cbshbalance/slackline-balacing1/work/학생보고서_공동집필_20260810/report_assets/fig20_robot_measurements.png

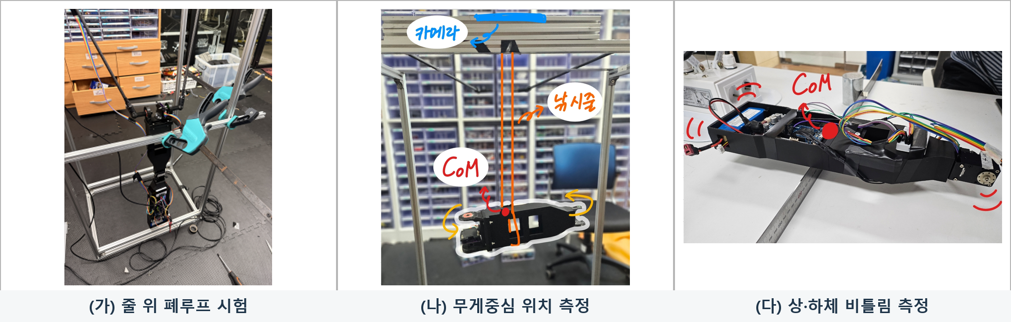
work/학생보고서_공동집필_20260810/report_assets/fig20_robot_measurements.png
