cbshbalance/slackline-balacing1/cad/발주목록_프레임v6_1.md

# 줄타기 로봇 프레임 v6 — 발주 목록

작성 2026-08-12 · 출처 `cad/frame_master_v6.scad` (OpenSCAD 2021.01, 경고 0)
모든 길이는 **5mm 단위 올림**, 소수점 없음. 올림은 항상 여유가 늘어나는 방향입니다.

---

## 1. 알루미늄 프로파일 — 전부 3060 한 종류

### 1-1. 기둥 (Z) — 로봇 크기별 교체용

| 부재 | 길이 | 수량 | A 빌드 (로봇 631) | B 빌드 (로봇 800) |
|---|---|---|---|---|
| **745** | 745 | 4 | 1단 다리 | 3단 갠트리 기둥 |
| **565** | 565 | 4 | 3단 갠트리 기둥 | — |
| **820** | 820 | 4 | — | 1단 다리 |
| **495** | 495 | 4 | 2단 중간 기둥 | 2단 중간 기둥 |

**745 한 종류가 두 역할을 겸합니다** — A 빌드에서는 다리, B 빌드에서는 갠트리 기둥.
동시에 두 빌드를 세우지 않으므로 4본이면 충분합니다.

기둥 소계 **16본**, 길이 합계 **10,500 mm**

### 1-2. 가로 부재 — 두 빌드 공용

| 부재 | 길이 | 수량 | 위치 |
|---|---|---|---|
| X보 (전폭 600) | 600 | 6 | 바닥 2 · 데크 2 · 피벗보 2 |
| X레일 (기둥 사이) | 540 | **2** | 갠트리 2 — 바닥은 전폭 X보로 대체됨 |
| Y레일 | 550 | **4** | 바닥(전시=데크) 2 · 갠트리 2 |

가로 부재 소계 **12본**, 길이 합계 **6,880 mm**

> 바닥은 짧은 X레일이 아니라 **전폭 600 X보 한 쌍**입니다 (다리가 그 위에 얹힘).
> Y레일은 바닥과 갠트리 **두 단** 모두에 들어갑니다.

### 1-3. 프로파일 합계

| 항목 | 값 |
|---|---|
| 규격 | **3060** (30×60, 30계열 T슬롯) 단일 |
| 절단 본수 | **28본** |
| 길이 합계 | **17,380 mm ≈ 17.4 m** |

> 4m 정척 기준 5본이면 절단 손실 포함해 충분합니다. 절단 의뢰 시 **±0.5mm 공차**로 지정하세요.
> **Y레일은 60mm 면을 Z(세로)로 세워 씁니다.** 발주는 같지만 조립 시 방향에 주의.

---

## 2. 다이캐스팅 브래킷

| 품목 | 규격 | 수량 |
|---|---|---|
| 다이캐스팅 앵글 브래킷 | **30계열** (약 30×30×30, 두께 7mm 내외, M6) | **64** |

3060용 대형 브래킷 대신 **30계열 두 개를 60mm 면에 나란히** 붙입니다.
빔 윗면 T슬롯 15 / 45 라인에 정확히 얹힙니다. 조달도 30계열이 훨씬 쉽습니다.

**배치 내역** (실험실 빌드, 갠트리 포함)

| 조인트 | 개수 |
|---|---|
| 다리 ↔ 바닥 X보 | 8 |
| 다리 ↔ 데크 (아래) | 8 |
| 중간 기둥 ↔ 데크 (위) | 8 |
| 중간 기둥 ↔ 피벗보 (아래) | 8 |
| 갠트리 기둥 ↔ 피벗보 (위) | 8 |
| 갠트리 기둥 ↔ 갠트리 X레일 | 8 |
| Y레일 끝 (상 4 + 하 4) × 2단 | 16 |
| **합계** | **64** |

> 전시 빌드는 1단이 빠져 **48개**만 사용합니다 (나머지 16개는 보관).

---

## 3. 볼트 · 너트

| 품목 | 규격 | 소요 | 여유 포함 발주 |
|---|---|---|---|
| 육각/렌치 볼트 | **M6 × 12** | 128 | **150** |
| T너트 (또는 스프링너트/사각너트) | **M6, 30계열 슬롯용** | 128 | **150** |
| 평와셔 | M6 | 128 | 150 |
| 볼트 (피벗 마운트 → 상단 X보) | **M5 × 12** | 4 | **10** |
| T너트 | **M5, 30계열 슬롯용** | 4 | **10** |

- 브래킷 1개당 볼트 2개 (다리마다 1개) → 64 × 2 = **128**
- 피벗 마운트는 전방 베어링 마운트 2개 + 후방 엔코더 브래킷 2개 = **M5 4개**
  (프레임 코드의 홀 지름 5.5mm, 볼트선은 레일 모서리에서 **45mm 안쪽 T슬롯**)

> **T너트 종류**: 조립 후 나중에 끼워야 하는 자리가 많으므로 **스프링너트(끼움식)** 를 권합니다.
> 사각너트는 프로파일 끝단으로만 삽입되어 재조립이 번거롭습니다.

---

## 4. 선택 품목

| 품목 | 규격 | 수량 | 비고 |
|---|---|---|---|
| 마감 캡 | 3060용 | 24 | 노출 단면 마감 |
| 레벨링 풋 / 고무발 | M8 | 4 | 바닥 X보 하단, 수평 조정 |
| 앵커볼트 (프로파일 끝단) | M8 | 8 | Y레일 끝 보강, 브래킷과 병행 시 |

---

## 5. 검증값 (참고)

| 항목 | A (로봇 631) | B (로봇 800) |
|---|---|---|
| 피벗축 높이 | 1355 | 1430 |
| 기둥 최상단 (갠트리 포함) | 1895 | 2150 |
| 쓰러졌을 때 바닥 여유 | 220.2 | 126.2 |
| Y레일 스윙 여유 | 158.5 | 62.9 |
| 전시 빌드, 서 있을 때 바닥 여유 | 54.2 | 54.2 |
| 베어링 센터 간격 (카본 파이프) | 580 | 580 |
| sag (R) | 503.825 | 503.825 |

> ⚠ **A 세트 다리(745)에 800mm 로봇을 올리면 Y레일 여유가 −10.5mm로 간섭합니다.**
> 로봇을 키울 때는 반드시 다리를 820으로 교체하세요.
