cbshbalance/slackline-balacing1/docs/cowork/45_헛트리거_늦은트리거_스윙원인_20260815.md

# 헛트리거 · 늦은 트리거 — 스윙의 원인 (2026-08-15)

> ## ⚠ 이 문서의 결론은 대부분 철회되었다 (같은 날 오후)
>
> 아래 "실기 펌웨어" 라고 적힌 조건은 **제어주기 500 Hz 에 25 ms 차분만 얹은 것**으로,
> 실기에도 시뮬에도 존재하지 않는 **잡종 조합**이었다.
> 실기 펌웨어는 200 Hz 이고, 200 Hz 에서는 여기 적힌 늦은트리거·과접기·95% 가동률이
> **나타나지 않는다.** 대책으로 제시한 디바운스도 제거했다.
>
> **정본은 문서 46.** 이 문서는 (a) 측정 주의사항, (b) 추정점 표시 도입,
> (c) "잡종 조합으로 실기를 흉내 내면 어떻게 되는가" 의 사례로만 읽을 것.

---

## 계기

v19_state 예측점 평면에 **추정점**(로봇이 실제로 보는 값)을 그리고 한 장씩 넘겨보다
나온 질문 — **접기가 실제로 위험해서 일어나는가, 아니면 추정점이 튀어서 일어나는가?**

## 측정 주의 (★이 부분은 유효)

A 는 반드시 **control_step 이전** 값을 봐야 한다.
접기가 시작되면 δ 가 곧바로 θ→β 를 바꾸므로 A 가 한 스텝만에 떨어진다.
스텝 이후 값으로 판정하면 **전부 헛트리거로 오판**된다 (실제로 1차 측정에서 이 실수를 했다).

## 결과 (조건 표기 정정)

30 s, γ=10, 실측 파라미터, 초기 0.5°.
'헛트리거' = 판정 순간 |A_참| < 문턱(0.6°) 인데 접은 경우.

| 설정 | 접기 | 헛트리거 | 판정시 \|A참\| 중앙 | \|Â\| 중앙 | φ스윙 rms | 힙 가동률 |
|---|---:|---:|---:|---:|---:|---:|
| 참값 추정기 (오차 0), 500 Hz | 107 | 0 (0%) | 0.60° | 0.60° | 0.90° | — |
| enc 2 ms, 500 Hz (시뮬 기본) | 181 | **103 (57%)** | 0.57° | 0.51° | 1.11° | 67% |
| ~~enc 25 ms (실기 펌웨어)~~ **잡종: 500 Hz + 25 ms** | 192 | 6 (3%) | 1.51° | 2.01° | 3.08° | 95% |

셋째 줄이 실기가 아니다. 실기 조건(200 Hz + 25 ms)은 문서 46 참조 —
같은 지표가 접기 92, |A참| 0.69°, φ스윙 1.11° 로 **1·2행과 비슷한 자리**에 온다.

⚠ '힙 가동률' 정의도 부정확했다. `phase != IDLE` 로 셌기 때문에 **REST 대기시간이 포함**된다.
모터가 실제로 움직인 시간이 아니다. 접기 횟수를 보는 편이 낫다.

## ~~대책: 트리거 디바운스~~ → **제거됨**

디바운스는 1샘플 스파이크는 막지만 이 문제(50 ms 짜리 추정 여행)는 못 막는다.
게다가 애초에 잡종 조건에서만 나타나는 문제였다. 코드에서 제거했다.

## ~~실기에 대한 예측~~ → **근거 상실**

"스윙 1.1 Hz / 접기 시점 Â 2° / 힙 가동률 90% 이상" 은 잡종 조건의 성질이므로
실기 예측으로 쓸 수 없다. 실물의 좌우 스윙은 **원인 미상**으로 되돌린다.

## 도구 상태 → 문서 46 참조

이 절에 적힌 체크박스 구성은 이후 변경되었다.
