cbshbalance/slackline-balacing1/docs/로컬작업_설정_작업기록_20260906.md

# 로컬 프로젝트 설정 및 작업 인계 — 2026-09-06

## 작업 기준

메인 경로: `C:\Users\user\.gemini\antigravity\scratch\slackline-balacing1`

Codex 앱에 이미 '줄타기' 로컬 프로젝트로 등록되어 있으며 현재 세션의 cwd와 일치한다. 프로젝트 파일 직접 읽기·쓰기와 저장 로그 읽기를 확인했다. 별도 복사본이나 ZIP 설치 방식 없이 이 폴더에서 작업한다. 기존 변경은 보존한다.

사용자 후속 정정(2026-09-06): Codex도 Git/GitHub 작업을 담당할 수 있다. 원하는 운영은 이 PC의 로컬 폴더를 주 작업본으로 삼고, GitHub를 백업·컴퓨터 간 전달 통로로 사용하는 것이다. 앞선 'GitHub는 다른 AI만 담당' 규칙은 이 정정으로 대체한다. 이번 정정에서 실제 동기화는 실행하지 않았다.

## 컴퓨터를 바꿀 때의 운영

1. 이 PC에서 작업·검증한 변경을 커밋하고 GitHub로 푸시한다.
2. 다른 PC에서 해당 변경을 받아 작업한다. 미커밋 변경은 자동 전송되지 않는다.
3. 다른 PC 작업을 끝내면 커밋·푸시하고, 이 PC로 돌아와 그 결과를 받아 메인 폴더에 통합한다.
4. 가능한 한 한 번에 한 PC에서 수정한다. 양쪽에 변경이 있으면 차이를 비교해 합친다. 로컬 기준이라는 말은 원격 변경의 강제 삭제를 뜻하지 않는다.

동기화 요청을 받으면 Codex가 상태 확인부터 필요한 Git 작업을 수행한다. Git에서 제외된 실험 로그·영상·외부 산출물은 GitHub 동기화만으로 전달되지 않으므로 작업에 필요한 자료를 별도로 전달한다.

이번 변경: AGENTS.md에 운영 기준과 작업기록 연결 추가, 이 설정 문서 작성, 이전 세션 인계 원본을 docs에 사본으로 보관. 앱 권한을 전역 완화하거나 원격 접속을 활성화한 것은 아니다.

## 확인한 현 상태

- 기존 수정: v22_logger/static/lab.html, logger.html, v22_logger/tests_v22.py.
- 기존 미추적: v22_logger/static/lg_twin_test.js 및 twin-test-backup 폴더 2개.
- 펌웨어 v22_logger/firmware/v22_raw/v22_raw.ino의 SPISettings는 여전히 1MHz 2곳. 앱 반복은 setInterval 사용. 이전 통합본 적용 완료로 취급하지 않는다.
- v22_logger/logs/20260906_151716_auto.raw.txt는 확인 시 약 93MB. events.csv 마지막 이벤트를 직접 읽었다. 기록 파일은 이후 커질 수 있다.
- 이전 인계에서 보고한 지연·영점 이동·500ms 주기 흔들림은 이번 설정 작업에서 재분석하지 않았다.
- 이론 정본 docx 4종의 존재를 확인했다. 이번에는 이론 변경이 없으며, 이론 작업 시 본문을 읽고 적용한다.
- 펌웨어 수정, 보드 빌드·업로드, 모터 구동, GitHub 동기화는 이번 작업에서 수행하지 않았다.

## 이전 자료

이 폴더의 `프로젝트_세션_인계_20260906.md`는 다음 원본의 보존 사본이다:

`C:\Users\user\Documents\Codex\2026-09-05\v23-v23-v22\outputs\프로젝트_세션_인계_20260906.md`

수정 후보 v22_zero_fix와 검증 스크립트 등은 여전히 이전 작업 폴더에 있다. 인계 사본만 복사했으며 통합 수정본을 설치하지 않았다. 다른 PC로 파일을 옮길 경우 이 외부 자료와 Git에서 제외된 로그는 별도 전달이 필요하다.

## 원격에서 같은 PC로 이어가기

2026-09-06에 확인한 [OpenAI 공식 Remote 안내](https://learn.chatgpt.com/docs/remote)에 따르면 휴대폰에서 연결된 Mac/Windows PC의 작업을 시작하거나 이어갈 수 있다. 제공 여부는 배포 상태와 워크스페이스 설정에 따른다.

1. 이 PC의 데스크톱 앱에서 Settings → Connections → Control this Mac or PC → Set up 또는 Add를 선택한다. 공식 문서는 앱을 ChatGPT desktop app으로 표기한다. 설치 버전에 따라 표시가 다를 수 있다.
2. 원격 접근 승인과 요청되는 인증을 진행한다.
3. 휴대폰으로 QR 코드를 스캔하고 같은 ChatGPT 계정·워크스페이스로 로그인하여 연결을 승인한다.
4. 휴대폰 ChatGPT 앱에서 Remote → 이 PC → 기존 작업을 연다. 새 작업이면 '줄타기' 프로젝트와 로컬 작업을 선택하고 이 메인 폴더를 사용하도록 지정한다.
5. PC가 켜져 있고 인터넷에 연결되어 있으며 절전 상태에 들어가지 않도록 유지한다.

이 방식은 연결된 PC에서 작업을 실행하므로 GitHub로 파일을 옮길 필요가 없다. 현재 세션에서 원격 페어링이나 휴대폰 접속 성공은 확인하지 않았다. 메뉴가 없으면 앱 업데이트 및 계정/워크스페이스의 기능 제공 여부를 확인한다.

## 새 세션 시작 문구

> 이 프로젝트의 로컬 폴더를 메인으로 사용해. AGENTS.md와 docs/로컬작업_설정_작업기록_20260906.md, docs/프로젝트_세션_인계_20260906.md를 읽고 현재 파일 상태를 확인해. 파일 수정과 로그 분석은 여기서 직접 해. GitHub는 백업과 다른 컴퓨터로 전달하는 통로로 사용하고, 동기화를 요청하면 네가 맡아 줘. 인계 문서의 미완료 작업은 내가 이번에 요청한 범위에 맞춰 진행해.
