cbshbalance/slackline-balacing1/v22_logger/README_v22.md

# v22_logger — 로거·측정 앱 (어름이 디지털 트윈 + 측정 과정 검토기) — 2026-09-02

`v21_pres` 를 통째로 복사해 얹었다. **v21 발표 시뮬레이터는 `/pres` 에 그대로 있다.** 물리(`sim_engine.py`)는 손대지 않았다.

```
cd v22_logger
pip install pyserial aiohttp numpy scipy        (mujoco 는 있으면 씀 — 없어도 앱은 돈다)
python server.py                                → http://localhost:8220/      (V22_PORT 로 변경)
python server.py --fake                         → 장치 없이 합성 신호로 (개발·리허설)
python server.py --fake "../lambda test/0822_lambda_test.csv" --speed 2
```

## 왜 만들었나 (사용자 의도, 9/2)

여러 사람이 펌웨어를 고쳐 오면서 **로봇이 무엇을 어떻게 재고, 무엇을 걸러서, 어떤 구간으로 어떤 적합을 해 값을 냈는지**
사람이 그래프로 확인한 적이 없다. 그래서 (1) 기본 기록·실시간 모니터링부터 세우고, (2) 측정값이 나오는 과정 전체를 화면에서
검토할 수 있게 하고, (3) 그 위에서 제어에 필요한 측정을 정확·체계·편리하게 하는 로거와 펌웨어를 새로 만든다. 이 앱은 그 (1)(2)다.

**설계 원칙 하나: 펌웨어 계산값을 믿고 그리지 않는다.** 원시 엔코더 열(phi, ank, del_now)에서 앱이 α·β·속도·Â·예측점을
**다시 계산**하고, 펌웨어 열(`_fw`)을 나란히 두어 Δ 를 보인다. 적합은 전부 **쓴 구간·쓴 점·식·잔차**를 되돌려준다.

## 화면

```
┌ 헤더: 서버 · 연결(포트/보드/Hz) · ●REC(파일·행·초) · 버퍼 · [포트▾ ↻ baud 연결 끊기 가짜:합성 가짜:파일 /pres H] ┐
│ 3D 디지털 트윈             │ 원위치 평면 (β, φ)        │ 데이터 | 명령 | 기록·파일 | 파이프라인 (탭)     │
│  자세 = 실기 엔코더        │ 예측점 평면 (β_pred,φ_pred)│  원본값(펌웨어 열 그대로) / 앱 파생값 + Δ      │
│  (φ, α=ank−φ, θ=α+δ)       │  금색=앱 인과 · 흰점선=평활│  시행표(R행)                                  │
│                            │  초록 모델선 · 주황 실측선 │  콘솔 (시리얼 모니터 대체) + 한 줄 입력        │
├ 스플리터(드래그) ──────────────────────────────────────────────────────────────────────────────────────┤
│ 트랜스포트: LIVE/REPLAY · 따라가기 · ⏮◀ ▶ ▶|⏭ · 속도 · 슬라이더 · t · 창 · 선택   │ 분석 패널            │
│ 스트립 차트 3레인(각도 / 속도·Â / phase·hold·err) + phase 음영 + 이벤트·마크 + 오버레이│  도구·구간·파라미터  │
│ 채널 체크박스                                                                          │  절차·숫자·표·곡선   │
└──────────────────────────────────────────────────────────────────────────────────────┴─────────────────────┘
```

- **라이브**: OpenCR 시리얼(115200)의 `D,…` 행을 30 Hz 프레임으로 브라우저에 보낸다. 3D·평면·표·차트가 같은 행을 본다.
- **재생**: 슬라이더·클릭·←→·Space. 차트 휠=줌, 드래그=이동, **Shift+드래그=분석 구간**, 더블클릭=라이브 복귀.
- **기록**: 연결하면 `logs/<시각>_auto` 로 자동 기록. 「새 파일」로 이름 지어 나눈다. hangcal_logger 와 같은 4파일 +
  `.folds.csv`. 마크(<kbd>M</kbd>, 콘솔에 `#메모`)는 E행으로 events.csv 와 차트에 남는다.
- **명령**: `commands.json` 의 프로파일(hangcal_fold / incremental_fold_min / p2r_test)이 버튼이 된다. δ 수동 이동, `이름 값`
  파라미터 설정/읽기, 자유 텍스트. 접속 직후 아무것도 보내지 않는다(문서 77 §6). 위험 명령(x, b)은 확인 창.
- **파일**: logs/ 와 기존 CSV(루트·lambda test·p2r test·r test)를 불러오거나(연결 끊은 뒤) 브라우저에서 업로드(+events.csv).
  p2r_logger 형식(`t_ms,phi_deg,…`)과 fold/hangcal 형식(`D,` 접두어, `# D,…` 헤더) 모두 읽는다.
- **파이프라인 탭**: P2R·r·c0·λ·wf·wb·vg·φ_eq·diff_ms·tau_ms·smooth_ms·alpha_mode·unwrap·snap·**phi_off/ank_off**(매달림 영점→직립 +180). 바꾸면 서버가
  파생열 전부를 다시 계산해 보낸다. 식은 탭 위에 그대로 적혀 있다.

## 앱 파생열 (dataset_v22.py)

| 열 | 식 | 비고 |
|---|---|---|
| `u_phi, u_ank` | ±180° 언랩 + 감김수 스냅 | 펌웨어 v8 규칙과 같다 (매달림 ±180 이 사는 자리) |
| `a_alpha` | `u_ank − u_phi` | 문서 70 §2 정정. `ank+phi`(옛), `fw`(펌웨어 열) 선택 가능 |
| `a_theta, a_beta` | `α+δ`, `α+P2R·δ` | |
| `a_dphi, a_dbeta` | diff_ms 기저차분 → EMA(tau_ms) | 실기 파이프라인 규약(25/28). ⚠펌웨어는 200 Hz 내부에서 계산하고 100 Hz 로 찍으므로 앱 재구성과 완전히 같을 수 없다 — 그 차이가 Δ 열이다 |
| `a_Ahat` | `(−1/r)φ + β + vg·wf·φ̇ + vg·wb·β̇ + c0/r` | finale8 방식 (문서 73) |
| `a_psi` | `φ − φ_eq` | |
| `a_fp, a_bp` | `q + P·q̇` | P 는 시뮬 (λI−D̂)⁻¹, MuJoCo 없으면 I/λ |
| `s_*` | 중심 이동평균(smooth_ms) + 중앙차분 | 비인과 준참값 (사후 분석용, 로봇은 못 본다) |

## 분석 도구 (analysis_v22.py) — 전부 "구간·점·식·잔차" 를 돌려준다

| 도구 | 하는 일 | 정본 |
|---|---|---|
| 구간 통계·잡음 | 평균·표준편차·드리프트·hp_rms(이동평균 뺀 잔차) | 문서 54 잡음 바닥 |
| 선형 적합 | 임의 두 열 y = a + b·x, SE, R², 원점강제 | |
| **P2R** | hold 평탄구간(또는 MOVE 이벤트)으로 나눠 구간 끝 avg_s 평균점 → α 대 δ. 상행/하행/원점/인접차분/히스테리시스 | 문서 64·70 §3 — 0822 데이터에서 **0.42855 ± 0.00105, R² 0.999958, 절편 +0.139°** (문서와 자릿수까지 일치) |
| **λ** | ψ = φ − φ_eq, 밴드 lo~hi 상승부만 ln\|ψ\| 직선적합 + 2/4/8° 통과시각(펌웨어 R행 방식 lam24·lam48) | 문서 70 §5 — 0822 데이터 12 유효시행 λ+ 5.42 / λ− 5.83 (문서 5.33/5.54) |
| 시행 나누기 | phase(4/5/6) 또는 \|ψ\| 문턱으로 놓기→발산→잡기 분할, 놓기점·방향·시행별 λ, 유효 판정(느림·진폭·R²) | 문서 70 §6-3 손 접촉 걸러내기 |
| **φ_eq 훑기** | φ_eq 격자마다 방향별 λ 곡선 → 만나는 점 | 문서 70 §5 (+낙하/−낙하 갈림 → 1.40°) |
| 감쇠 진동 | 영점교차→주기, 봉우리→대수감쇠율→ζ, 감쇠사인 비선형 정밀화, c_φ=2ζω_n·I_r | 문서 16 방식 |
| **놓기 경계 r·c₀** | 놓기점(φ₀,β₀)+낙하방향만 — r 고정 분리 문턱 c₀, r 격자 훑기 | 문서 70 §4-2 경로② |
| **★ 접기 성적표 (γ)** | 단일접기 시행마다 접기 직전 Â(A⁻)·실제 Δδ·관측창 뒤 Â(A⁺) → G=e^{λ·lock}, g=(G·A⁻−A⁺)/Δδ, γ=G/g (deadbeat 이득, ρ 없음). γ* 를 「펌웨어로 보내기」(gam). 합성 폐루프: γ=6/10 으로 접어도 γ* 동일, γ* 로 접으면 A⁺≈0 | 문서 46 접기-유지 맵 (9/3 정의 확정) |
| **★ 다음 놓기 추천** | 놓기마다 부호 있는 거리 s(발산 초기진폭 A', 놓기 순간은 진동 위상으로) → β 열별 영점(할선) → r̂·ĉ₀ → 다음 놓기점(관측 적은 열의 영점 ± 벗어남, 0.5°에서 추정 불확실성까지 자동 축소). 합성 폐루프: 8회에 r ±0.1 | 신규 (사용자 제안, 9/2) |
| 시스템 동정 | (φ̈,β̈)~(φ,β,φ̇,β̇,1) 회귀 → 4×4 고유값 λ, 좌고유벡터 → r, wf, wb, c₀ | 문서 70 §4-2 경로① — ⚠표본 적으면 흔들린다. R²·고유값을 같이 본다 |

결과 패널에는 **절차(번호 목록) → 숫자 → 표 → 보조 곡선**이 나오고, 차트에는 쓴 점·적합선·밴드·통과시각이, 평면에는
놓기점·경계선이 겹쳐진다. 「결과 기록」에 최근 30건이 남아 시행 간 비교가 된다 — 한 시행 보고 다음 시행 변인을 바꾸는 루프.

## 서버 (server.py)

- `/` 측정 앱, `/pres` v21 발표 시뮬(그대로), `/ws2` 앱 WS, `/ws` v21 WS, `/logs/` 기록 폴더, `/commands.json`.
- WS 명령: `hello ports connect fake disconnect send rec rec_stop autorec mark files load load_text clear pipe profile analyze sim`.
- 데이터는 바이너리 프레임 `[u32 헤더길이][JSON][float32 열우선]` — `ds_full`(교체) / `ds_append`(증분).
- `serial_bridge.py`: 포트 자동탐지·D/R/F/E/# 분류(`LineSink`)·4파일 기록기(`Recorder`)·`SerialSource`/`FakeSource`.

## 펌웨어 v22_raw v3 · 놓기 신호음 (2026-09-05, 실기 첫 연결에서)

- 실기 관찰: 트윈은 맞는데 `g` 직후 `E,FALL`(φ −0.59) → 펌웨어 α 가 180° 틀어짐(앱 ank_off 180 은 앱만 바꾼다) → **`fphi`/`fank` 직립 변환** 추가.
  `z` 에 "모터가 안 읽혔다", δ 0 고정 → DXL 읽기가 0 반환(버스). FOLD 는 찍히는데 로봇이 안 움직임 → v2 는 넘어진 뒤에만 토크를 켜서 **`g` 가 토크를 반드시 켜게** 고침(hangcal `torqueRestoreHere` 계승).
  hangcal 에서 "g 누르고 1 초 뒤 손 안에서 접힘" = 무장 유예(200 ms) 동안 `(유예) 문턱을 넘었지만…` 을 찍다가 유예 끝에 접은 것 — 손에 든 채 Â 가 이미 문턱 밖이었다.
- v3 는 **안전장치를 넣지 않았다**(사용자 방침): FALL 에 α 기록(`E,FALLA`), 5 s 마다 `# stat loop_max/dxl_max/dxl_fail/wr_fail` 계측만. 호스트 문법검사 `bash firmware/hostcheck/check.sh firmware/v22_raw/v22_raw.ino`.
- 앱 **놓기 신호음**(`lg_panels.js` cueTick, 로거·측정실): 목표 도달(십자선 ON) 또는 |Â| < A, 손 멎음(|φ̇|,|β̇| < v)이 0.3 s 유지되면 삐 두 번 + 「● 놓기!」, `E,GO` 뒤 한 번 더. 판단만, 로봇에 안 보낸다. 절차 `docs/v22_실물_브링업_절차_20260902.md` §4-5.

## 발표 창 셋 — 조종석 `/deck` · 무대 `/show` · 측정실 `/lab` (2026-09-03)

- **`/deck` 조종석** (노트북): 큐 8개(발표 시나리오 9/3 확정)·질의응답 버튼·옛 버전 갤러리(V1~V18, `/repo/` 마운트)·로봇 명령·상태 판독·트윈 미리보기.
  ←/→·PgUp/PgDn(발표 리모컨)·숫자키. 무대 좌우 반전, 1:1 축척(모니터 mm/px).
- **`/show` 무대** (큰 모니터, F 전체화면): 서버의 장면 상태(`{cmd:"scene", name, args}` → `type=scene` 방송)대로 한 창에서 전환.
  video(재생·휘청 반복+오버랩·정지·모델 변신) · twin(+pl1|pl2, HUD 유지시간·접기 횟수·접기량 번쩍) · plane(크게, `epsGeom` 라이브 ε* 기하) · frame(iframe) · card · black.
  **큐는 화면 선택일 뿐** — 로봇 조작(접기 시연·놓기·증분접기)은 발표자가 실기·마우스로 라이브로 한다.
  실사 영상은 **/pres 구도 그대로**(영상의 y 607~1407 띠를 레터박스 contain, 8/17 정합 카메라 az 140.61·el −5.42·dist 15.19·fov 30·roll −3.01) —
  바꾼 것은 둘뿐: 광대 추적 궤적(`static/media/jultagi_trace.json`, `tools/track_jultagi.py`)으로 휘청 구간을 반복하며 모델을 동기시키는 것,
  선·몸 굵기(thk 2.6 · body 1.35 · 줄 0.7·pr). 발 정렬·기둥 표류 보정 포함.
- **`/lab` 측정실** = **로거 앱 전체 기능(`lg_panels.js` 그대로: 명령 팔레트·측정 도구 11종·기록·파일·파이프라인·원본값·콘솔·트랜스포트·스트립 차트·트윈·평면·목표 십자선) + 엑셀식 표·차트**.
  오른쪽은 탭 없이 전부 펼쳐져 있다. 엑셀 영역: 원본 표(가상 스크롤, 열 고르기, 클릭 = 커서·Shift+클릭 = 구간) · 시간 차트(왼쪽 드래그 = 구간 선택 = 측정 도구의 분석 구간,
  우드래그 이동·휠 줌·더블클릭 따라가기, 스트립 차트와 같은 창 `LG.chart.win/view`, phase 띠·이벤트·도구 오버레이도 겹침) · XY 차트(현재점 마름모) ·
  추세선(선형 / 지수 ln|y−y₀|→λ / 감쇠사인→ω,ζ(서버 osc) / 놓기점→경계선 r·c₀ / 다음 놓기 추천 → 십자선) · 식·R²·n 표시 · 선택 구간 TSV 복사(엑셀 붙여넣기).
  리허설 영상 `video_lab_v22.py` → `video_out/v22_lab_rehearsal.mp4` (연결·영점 → λ: 드래그→지수 추세선 + 시행 나누기 → r 추천 루프 + XY 차트 → γ 성적표 → mode 2 → 복사).
- 운용 절차: `docs/v22_발표_무대_운용_20260903.md`. `lg_plane.js` 에 `LG.PLOPT.epsGeom`(무게중심 불변 직선과 안정모드선의 교점 = 접으면 가는 곳), `lg_3d.js` 에 `LG.cam.set/get`·좌우 반전.

## MuJoCo 가상 로봇 소스 · 리허설 영상 (2026-09-03)

- `mujoco_source.py` — v21 `SimEngine`(물리 무수정, 실측 프리셋)을 실시간 200 Hz 로 돌리고 그 위에 **v22_raw v2 펌웨어 로직을
  파이썬으로 그대로 얹은** 가상 로봇. D/F/E 행·Â·mode 0/1/2·파라미터 표·명령 문법이 펌웨어와 같다(엔진 자체 트리거는 잠그고
  위치 서보만 빌린다). 사람 동작은 `sim release β φ [T]` / `sim hold β φ` / `sim catch` / `sim free` 지시로 시킨다.
  연결: 헤더 「가짜: MuJoCo」 버튼, `python server.py --mujoco`, WS `{cmd:"mujoco"}` · `{cmd:"robot", text:"release 1 0"}`.
- `video_v22.py` — 리허설 영상 감독 스크립트. 서버를 띄우고 Playwright 로 앱을 **진짜 마우스로** 조작하며 녹화한다
  (커서·클릭 파문·자막·🤚 사람 동작 카드 오버레이). 시나리오 = 연결·영점 → λ 놓기 3회 → r 추천 루프 6회 → γ 단일접기 3회 +
  접기 성적표 + gam 보내기 → mode 2 증분접기. `python video_v22.py` → `video_out/v22_rehearsal.mp4` (+ `_small.mp4` 공유용 ~17 MB, webm 원본도 남김,
  H.264 변환은 `pip install imageio-ffmpeg`). 4차 녹화 결과: r̂ −1.63 ± 0.11 (9회, 모델 −1.645), γ* 9.11 (3회), 증분접기 유지.
- 추천 도구 정정(같은 날): **부호 규약** — 선 위(Â>0)에서 놓으면 φ 는 −로 넘어진다(s 는 φ 가 커질수록 줄어든다, k<0). 9/2 판의
  합성 세계(`sim_recommend.World`, r_u=+0.7)는 이 부호가 거꾸로였고 추천 도구도 같은 가정을 해 서로 맞아 보였다 → 둘 다 정정
  (r_u=−0.5). 열별 영점은 regula falsi(브래킷 안), 안정모드 진동수 ω 는 시행 전체 공통 적합(`_fit_omega`, 결과 `om_hat`).
  MuJoCo 폐루프(`python sim_recommend.py mujoco 10 2`): 12회 놓기로 r̂ −1.656 ± 0.024 (모델 −1.645), ω̂ 6.7 (7.03).
- 라이브 버퍼 위 분석의 경쟁 조건 수정(같은 날): `analysis_v22.run` 이 `_Snapshot` 으로 행 수를 고정한다 — 도구가 `ds.arr()` 를
  여러 번 부르는 사이 서버 루프가 행을 붙이면 배열 길이가 어긋나 IndexError 가 났다 (리허설 3차 「접기 성적표」에서 발생).
- 시행 나누기 개선(같은 날): 정지 판정을 φ **와 발목** 둘 다로(φ 는 두고 β 만 옮기는 손동작이 정지에 안 섞임), 놓기점은
  정지 구간 **꼬리 1 s** 의 중앙값, 손으로 옮기는 동작은 **끝속도**(잡히기 직전 100 ms 최대 φ̇ < 0.35·λ·|φ−φ_q|)로 방향 무효
  (`min_vend`, `quiet_ank` 인자). 0822 실측 18/18 시행 유지, 합성·가상 로봇 모두 손 이동 0건 오인.

## 시험

- `python tests_v22.py`(MuJoCo 가상 로봇 절 포함) — 행 분류·기록기 / Dataset(두 형식, 언랩, 라이브 append == rebuild 결정론) / 분석 정본 대조(P2R·λ·φ_eq·경계·진동) / FakeSource→허브→프레임. **ALL PASS (2026-09-02)**
- `python server.py --fake --port 8231 &  ;  python e2e_v22.py 8231` — Playwright: 로드·JS 오류 0·라이브·명령·마크·파일 로드·
  P2R/시행/λ/φ_eq/통계·스크럽·재생·구간 선택·파이프라인·숨김·재연결. 스크린샷 `e2e_shots/`. **ALL PASS**
- `python tests_v21.py` — v21 회귀 (물리 불변) **ALL PASS**

## 실물 브링업

순서는 `../docs/v22_실물_브링업_절차_20260902.md` — 가짜 소스로 화면 확인 → 기존 hangcal_fold 펌웨어로 연결(m 으로 CSV ON) →
손으로 움직여 부호·트윈 확인 → v22_raw 업로드 → 매달림 영점·자유흔들기·P2R·놓기 시행을 앱 버튼으로.

## 알아둘 것

- 시리얼 포트는 한 프로그램만 연다. 아두이노 시리얼 모니터·hangcal_logger 와 동시에 못 쓴다 → 업로드 때는 「끊기」.
- 실물 PC 는 pyserial 이 필요하다 (hangcal_logger 가 쓰므로 이미 있을 것). Windows 포트 이름(COM7)은 그대로 목록에 뜬다.
- 라이브 중 파일 불러오기는 막았다(버퍼 섞임 방지). 연결하면 파일 버퍼는 비운다. 기록 파일은 언제나 그대로.
- 헤더(열 구성)가 다른 D행이 오면 버퍼를 새로 시작한다 (다른 펌웨어). 같은 펌웨어 재시작(t_ms 되감김)은 `T_RESET` 이벤트로 이어 붙인다.
- 버퍼 상한 60만 행(200 Hz × 50 분). 넘으면 앞을 버린다 — 파일에는 남아 있다.
- USB 선의 장력이 균형에 주는 영향은 코드 밖 문제 (문서 60 §6). 벤치 측정용으로 자리매김.

## 다음 단계 — 새 펌웨어 요구사양 (이 앱이 기대하는 것)

`firmware/v22_raw/v22_raw.ino` **v2** (★미컴파일·실물검증 대기 — I/O 코드는 incremental_fold_min 에서 그대로): 원시값(+ 영점 전 14비트 원각·서보 tick)
200 Hz 읽기 → 100 Hz D행, `mode 0` 측정 / `mode 1` 단일접기(γ 실험: 첫 |Â|>trig 에서 한 번 접고 δ 고정, E행 FOLD·F행 요약) /
`mode 2` 증분접기(본 제어). **γ 하나, ρ 없음.** w 는 r·λ 닫힌형(kv 배율)이 기본, `wmode 1` 이면 수동 wf·wb.
명령: z u k <정수> m s p t w e swap hdr · mode N g h x y fold X · `이름 값`(gam trig rel vrel dead dstep dlim rest alim sgn fdeg lock r lam c0 kv wmode wf wb p2r loghz vel acc ilim).
명령 팔레트 프로파일 `v22_raw` 가 붙어 있다. 부호 확인은 `y`(dry-run) + `mode 2` + `g` 로 FOLD E행의 부호를 본다.

1. **원시값만 찍는다**: `D,t_ms,phi,ank,del_now,hold,phase,err[,cur_mA,volt]` — α·β·속도·Â 는 앱이 만든다.
   (있어도 된다 — `_fw` 열로 나란히 표시된다. 그러나 정본은 원시.) 열 이름은 `# D,…` 헤더 주석으로 알린다.
2. 고정 길이 한 줄, 블로킹 print 금지, 200 Hz 면 1 Mbps, 115200 이면 100 Hz(loghz).
3. 명령은 한 글자 + `이름 값`. 새 명령은 `commands.json` 프로파일 하나 추가로 버튼이 된다.
4. 시행 요약(R행)·이벤트(E행)는 지금처럼. 앱도 자동 분할하므로 없어도 된다.
5. 매달림 영점·직립 변환은 펌웨어가 하되 원각(zero 전 raw)도 찍으면 앱이 영점을 사후 검토할 수 있다 — 검토 대상.
