cbshbalance/slackline-balacing1/docs/v22_측정_조작_가이드_20260902.md

# v22 측정 앱 — 조작 가이드 (λ · r 중심, 2026-09-02 개정)

> 남은 측정은 넷: P2R(지난 값 0.4285 유지), **λ**, **r**, **γ**. 이 문서는 λ·r·γ 를 **어느 자세(φ, β)에서 놓고,
> 무엇을 누르고, 앱이 무엇을 계산해 어디에 보이는지**로 적는다. 펌웨어 `v22_raw`(제어 없음, δ 고정) 기준.
> 화면 읽는 법·기타 도구(자유흔들기·잡음·재분석)는 끝의 부록.

> ★ **리허설 영상 (2026-09-03)**: 이 가이드의 실험을 로봇만 MuJoCo 로 바꿔 앱을 실제로 조작하며 녹화한 영상이
> `v22_logger/video_out/v22_rehearsal.mp4` 다 (`python video_v22.py` 로 다시 만든다). 화면의 🤚 주황 카드가 사람이
> 로봇에 하는 동작, 파란 자막이 앱에서 보는 것. 장치 없이 연습하려면 헤더 「가짜: MuJoCo」 로 연결하고 콘솔에
> `sim release 1 0` (β=1°, φ=0° 로 잡았다 놓기) 를 친다.

## 공통 조건 (λ·r 둘 다)
- 매달림 영점을 마친 상태(부록 A). 세운 뒤 「파이프라인」탭 **phi_off = 180, phi_eq = 0, r = −1.506, c0 = 0** → 적용.
- 「명령」탭 **k 토크ON**: 힙을 곧게 편 자세에서 누른다 → δ = 0 으로 재정의. 이후 δ 는 고정이므로 **β = α = ank − φ**.
  즉 놓기 자세는 두 각으로 정해진다: 크랭크 각 **φ** 와 몸통 기울기 **ank = β + φ**.
- 「기록·파일」탭 → 이름 → **새 파일** (λ 는 `0903_lam`, r 은 `0903_r`).
- 평면 아래 옵션 **☑ 목표 β / φ** 에 목표를 넣으면 두 평면에 흰 십자선(반지름 0.3° 원)이 찍히고, 3D 판독 맨 아랫줄에
  `목표까지 Δβ Δφ` 와 두 값이 모두 ±0.2° 안이면 **● 놓아도 됨** 이 뜬다.

## 한 번 놓기 — 손과 클릭 (λ·r 공통)
| 순서 | 손 | 앱 |
|---|---|---|
| 1 | 두 손을 스토퍼처럼 **한쪽 면만** 댄다: 한 손은 크랭크(발 막대) 쪽, 한 손은 머리 쪽. 잡지 않는다 | 판독의 φ 와 β 를 본다 |
| 2 | 크랭크 쪽 손으로 **φ** 를 목표에, 머리 쪽 손으로 몸통을 기울여 **β** 를 목표에 맞춘다 | `Δφ`, `Δβ` 가 ±0.2 안 → **● 놓아도 됨** |
| 3 | 그 자세로 **1 초 정지** (앱은 0.5 s 동안 φ 가 0.35° 안에 머무는 것을 '정지' 로 본다) | 차트 φ 가 평평 |
| 4 | 두 손을 **y 축(줄 방향)으로** 동시에 뺀다. 머리쪽 손 먼저라도 된다 | φ 가 한쪽으로 지수적으로 커진다 |
| 5 | \|φ\| 가 8° 쯤 되면 잡는다 | 차트가 꺾인다 |
| 6 | 다시 세우는 동안 | <span></span>도구 **시행 나누기** → **실행** (또는 <kbd>Enter</kbd>) |
| 7 | | 표 **마지막 행**을 본다: `dir`(+/−), `dir_valid`, `phi0`·`beta0`(실제 놓기점 = 손 뗀 순간), `lam`, `lam_r2`, `why`. 원위치 평면에 그 점이 방향색으로 찍힌다 |

앱이 하는 일(시행 나누기): φ 가 0.5 s 동안 0.35° 안에 머문 구간을 "손에 잡혀 정지" 로 보고, 그 정지 평균 φ_q 에서 1° 벗어나는 순간을 놓기로 잡는다.
**놓기점은 문턱을 넘은 순간이 아니라 정지에서 벗어나기 시작한 표본**(손 뗀 순간)이다. φ_q 가 3° 여도 잡는다.
종료는 \|φ−φ_q\| ≥ 8.5° 또는 되돌아옴. `dir_valid` = 놓기 뒤 2 s 안에 4° 이상 벗어남(방향 확실), `valid` = 거기에 λ 적합 R² ≥ 0.9.

## λ 측정 — 평형 근처, 선에서 살짝 벗어나 놓기
목표점 (β, φ) 은 **선에서 A ≈ ±0.5° 만큼 벗어난 자리**. r = −1.5 면 A = φ/1.5 + β 이므로:

| 시행 | 목표 β | 목표 φ | ank = β+φ | 기대 |
|---|---|---|---|---|
| 1, 3, 5, 7, 9 | 0.0 | **+0.7** | +0.7 | 한쪽으로 발산 (앱 `dir` 이 알려준다) |
| 2, 4, 6, 8, 10 | 0.0 | **−0.7** | −0.7 | 반대쪽으로 발산 |

- 놓고 잡는 사이가 약 0.4~0.5 s (A₀ 0.47° → 8° 까지 ln(8/0.7)/5.5 ≈ 0.44 s). 손을 뗀 뒤 **아무것도 건드리지 않는다.**
- **첫 시행 뒤 바로 확인**: 「시행 나누기」 → 표 1행 `dir_valid` ✓, `why` 빈칸, `lam` 5 근처, `lam_r2` 0.99 근처면 제대로 된 것.
  그 다음 「시행…」에서 시행 1 선택 → 도구 **λ** → 실행: 보조 곡선 ln\|ψ\| vs t 의 점이 직선 위에 올라앉는지, 차트의 분홍 점(쓴 표본)이 2° 부터 봉우리 직전까지인지, 숫자 `lam`, `T2_ms`(≈125), `n`(≥15), `r2` 를 본다. <kbd>Space</kbd> 로 3D 재생.
  - `why` 에 "느림" → 손을 뗀 뒤 잡거나 스쳤다. "진폭" → 4° 전에 잡았다. `r2` 낮음 → 놓을 때 튕겼다(속도 0 이 아니었다).
- 10회 뒤 「시행 나누기」 결과의 `lam_plus`, `lam_minus`, **`dir_split_pct`**. 20 % 아래면 λ = 둘의 평균(정본 5.44 ± 0.59, 방향차 3.9 %).
  20 % 위면 φ_eq 가 0 이 아니다 → 도구 **φ_eq 훑기** → `phi_eq_best` 를 「파이프라인」phi_eq 에 넣고 적용 → 「시행 나누기」 다시. (정본 1.40°)
- 이 10 점은 그대로 r 실험의 **β = 0 열**이기도 하다.

## r 측정 — 앱이 다음 놓기점을 추천한다 (적응 탐색, 약 8~12회)
원리(문서 70 §4-2 경로②): 속도 0 으로 놓은 점이 안정모드선 **φ = r·β + c₀** 의 어느 쪽에 있느냐가 넘어지는 방향을 정하고,
**얼마나 멀리 있느냐**가 발산의 초기 진폭을 정한다. 앱은 놓기 한 번마다 이 부호 있는 거리 s 를 재고, β 열마다 s = 0 이 되는 φ(영점)를
할선법으로 추정한 뒤 열들의 영점을 직선으로 이어 r̂·ĉ₀ 를 낸다. 다음 놓기점은 **관측이 가장 적은 β 열의 영점에서 조금 벗어난 자리**다.
벗어남은 처음 0.5° 에서 시작해 추정선의 불확실성만큼(2·√((SE_r·β)²+SE_c0²), 최소 0.15°)으로 줄어든다 — 선 위에 정확히 놓아도 로봇은
결국 넘어지지만(비선형 씨딩, 1.5~2 s) 늦게 넘어질수록 s 가 작아 잡음에 묻히므로, 확실한 만큼만 선에 다가간다.
사람은 추천대로 놓고 실행만 누르면 된다. 이분법으로 훑을 때(약 20회)보다 절반이다.

### 루프 (놓기 한 번 = 4 클릭)
| 순서 | 앱 | 손 |
|---|---|---|
| 0 | 도구 **★ 다음 놓기 추천** 선택. 파라미터 기본값(처음 벗어남 0.5°, 최소 0.15°, β 열 2,−2,1,−1,0, 첫 시행 φ 0.7). **실행** | — |
| 1 | 분석 패널 맨 위 파란 상자: **다음 놓기 β ○ φ ○ (ank ○) 선 위쪽/아래쪽 ○°**(벗어남). 「추천→목표」가 켜져 있으면 평면 십자선에 자동 입력된다 | 판독 Δβ·Δφ 가 ±0.2 안에 오도록 잡는다 |
| 2 | — | 1 초 정지 → 줄 방향으로 손 빼기 → 8° 에서 잡기 |
| 3 | **실행**(<kbd>Enter</kbd>) — 시행을 다시 찾고 추천을 갱신 | 다시 세우는 동안 |
| 4 | 상자의 새 추천과 아래 숫자 `r`·`se_r`·`c0`·`n`·`n_cols`, 원위치 평면의 **하늘색 추정선**과 **하늘색 원(다음 점)**, 표의 `s` 열 | 1 로 |

- 앱이 하는 일(매 실행): ① 시행 나누기(정지→이탈, 놓기 자세 = 정지 구간 중앙값) ② 시행마다 φ−φ_q = A'(cosh λτ−1) + B'(cos ωτ−1) 적합 — 놓기 순간 τ=0 은 진동 위상으로 맞추고, **A' 이 s** ③ β 열마다 s(φ)=0 인 φ_c (관측 1개면 k̂ 로 한 걸음 ≤1°, 2개↑면 할선) ④ (β, φ_c) 직선 → r̂, ĉ₀, SE ⑤ 다음 점.
- 첫 4회는 β = 0, +2, −2, +1 순서로 한 점씩 깔리고(이때 r̂ 은 열들의 영점 회귀), 5회부터 열마다 두 번째 점이 들어가며 SE 가 내려간다.
- **멈추는 때**: 상자에 "충분 (SE_r < 0.05)" 이 뜨거나, 8~12회에서 `r` 이 안정되면. 정본 −1.506 ± 0.074 (문서 70).
- 보조 곡선 "s vs 추정선까지 거리" 의 점들이 원점을 지나는 직선 위에 있어야 한다. 크게 벗어난 점 = 튕겼거나 손이 스친 시행 → 「시행…」에서 열어 보고, 필요하면 그 시행을 무시하고 한 번 더.
- λ 시행 10회(β=0, φ±0.7)를 먼저 했다면 그 점들이 이미 β=0 열에 들어가 있어 시작이 빠르다.

### 수동 목표표 (추천 없이 할 때의 대안)
r = −1.5, c₀ = 0 가정, 선 위쪽 φ_L+1 과 아래쪽 φ_L−1 이 한 쌍. ank = β + φ.

| β | φ_L = −1.5β | 놓기 A: φ (ank) | 놓기 B: φ (ank) |
|---|---|---|---|
| +2 | −3.0 | −2.0 (0.0) | −4.0 (−2.0) |
| +1 | −1.5 | −0.5 (+0.5) | −2.5 (−1.5) |
| 0 | 0 | +1.0 (+1.0) | −1.0 (−1.0) |
| −1 | +1.5 | +2.5 (+1.5) | +0.5 (−0.5) |
| −2 | +3.0 | +4.0 (+2.0) | +2.0 (0.0) |

반대로 넘어지면 φ_L ± 0.5 로 한 쌍 더, 같은 방향이면 그 반대쪽으로 1° 더. 다섯 β 를 마치면 도구 **놓기 경계** 로 r·c₀.

### 확정·검증 (두 방법 공통)
「파이프라인」 r, c0 에 측정값 → 적용 → 주황 실측선이 옮겨진다. 십자선을 주황선 **위**에 두고 3회 놓는다: 2~3회 왕복하다 1.5 s 넘어서 넘어져야 한다.
선에서 ±1° 벗어난 점은 0.8 s 안에 넘어진다. 「시행 나누기」의 `dur` 열로 비교 (문서 46 실측② 합격: 3회 이상 진동). 30회를 넘으면 **시스템 동정** 으로 교차 확인.

> ★ **9/3 리허설에서 배운 것 (γ·증분접기 공통)**
> 1. **「g 시작」 직후 바로 놓는다.** 손에 든 채 무장 상태로 오래 있으면 손떨림으로 |Â| 가 문턱을 넘어 **손 안에서 접히고**,
>    손이 α 를 붙잡고 있으니 β = α + P2R·δ 가 접힌 만큼 같은 쪽으로 커져 **연쇄 접기 → 관절 한계** 까지 간다.
>    잡는 자세는 |Â| ≈ 0.3° (문턱 0.6° 의 절반) 로 여유를 두고, 성적표에 "무효 — 접기가 Â 를 키웠다" 가 뜨면 이 경우다.
> 2. **r 과 함께 c₀ 도 펌웨어에 넣는다** (`c0 값`). c₀ 를 빼면 Â 에 상수 편향이 남아 한쪽으로만 접고 hold 가 흘러가
>    결국 관절 한계에서 넘어진다 (가상 로봇: c₀ 없이 16 s, 넣으면 25 s+ 유지).
> 3. 「다음 놓기 추천」은 안정모드 진동수 ω 를 시행들에서 **함께 맞춘다** (결과의 ω̂). 파이프라인 om 이 틀려도 s 가
>    한쪽으로 치우치지 않는다 — 가상 로봇(ω 7.0)에서 12회 놓기로 r̂ = −1.66 ± 0.02 (모델 −1.645).

## γ 측정 — 접기 성적표 (단일접기, 약 5~8회)
정의(9/3 확정): γ 는 **위험도 Â 를 접기각으로 바꾸는 총이득** [°접기/°Â]. 접기-유지 맵 A⁺ = G·A⁻ − g·Δδ 에서 A⁺ = 0 이 되는
γ* = G/g. ρ 는 없다(접기량 = γ·Â). 펌웨어 `v22_raw v2` 가 직접 접고 기록한다.

준비: 파이프라인과 펌웨어 양쪽에 λ·r·c0 실측값. 펌웨어는 명령 탭 값 바꾸기로 `r -1.5`, `lam 5.4`, `c0 0.2` (w 는 닫힌형으로 자동, 상태 t 로 확인).
**부호 확인(한 번)**: `y`(dry-run) → `mode 2` → `g` → 손으로 기울여 콘솔의 `E,…,FOLD,Δδ` 부호가 기울인 반대쪽(복원 방향)인지 → 아니면 `sgn -1` → `h` → `y`.

| 순서 | 앱 | 손 |
|---|---|---|
| 0 | `mode 1` (단일접기), `gam 8`(초기 추정), `trig 0.6`, `lock 250`. 새 파일 `gamma` | — |
| 1 | <span class="btn acc">g 시작</span> (무장). 판독 phase 가 IDLE | 목표 (β 0, φ ±0.7) 로 잡고 1 초 정지 |
| 2 | — | 놓는다. |Â| 가 0.6 을 넘는 순간 로봇이 **한 번** 접고 δ 를 고정한다 (콘솔 `E,FOLD` → 250 ms 뒤 `F,…` 요약). 그 뒤 자유 발산 → 8° 에서 잡기 |
| 3 | 도구 **★ 접기 성적표** · 관측창 250 · <span class="btn acc">실행</span> | 다시 세우는 동안 |
| 4 | 표 마지막 행: `A_pre`, `dd_act`, `A_post`, **`ratio`**(A⁺/A⁻: 0 근처 = deadbeat, 같은 부호 = 부족, 반대 = 과대), `gamma`. 숫자 `gamma_star`. 분홍 상자 **펌웨어에 넣을 값 gam ○** → <span class="btn acc">펌웨어로 보내기</span> | — |
| 5 | `h` → 1 로 (5~8회). 회귀 절편 `G_fit` 이 e^{λ·0.25} 와 맞는지(검산), `gamma_se` 가 0.5 아래면 확정 | |
| 6 | `mode 2` → `g` → 놓기: 증분접기가 잡는지 (2 s 이상 생존, 접기 반복 횟수) | |

앱 계산: 접기 사건은 E행 FOLD(없으면 hold 계단). A⁻ = 접기 직전 40 ms 의 Â 평균, Δδ_act = 관측창 끝의 δ − 직전 δ, A⁺ = 접기 시작 250 ms 뒤 Â.
G = e^{λ·0.25}, g = (G·A⁻ − A⁺)/Δδ_act, γ = G/g. γ* = |A⁻| 가중 평균. 3회 이상이면 A⁺/A⁻ 대 Δδ/A⁻ 회귀(절편 G, 기울기 −g) 로 교차검산.
차트: 접기 세로선, 관측창 띠, Â 레인에 A⁻·A⁺ 점. 정본: 모델 7.385, 시뮬 7.06~8.4, 실기 캘리브 18.6 (문서 40·46).
고정 접기량으로 재고 싶으면 `fdeg 6` (Δδ = ±6° 고정) 또는 무장 중 콘솔에 `fold 6`.

## P2R 확인 (5분, 발목 엔코더 정상일 때)
발목축에 매달고 k 토크ON → δ 수동 이동 0→10→20→30→40→30→20→10→0 (각 2 s 정지) → 도구 **P2R** 실행 → `P2R` 0.4285 ± 0.002, `r2` > 0.9999, 절편 < 0.3°. 아니면 그때 다시 본다.

---
## 부록 A. 매달림 영점 (문서 66)
u 토크해제 → 늘어뜨림 → 왼쪽에서 멎으면 **z**(1차) → 오른쪽에서 멎으면 **z**(완성, 콘솔에 데드밴드) → 세움 → phi_off 180 적용 → 직립에서 u_phi·u_ank·α 가 ±1° 안.

## 부록 B. 화면 읽기
- 원위치 평면 (β, φ): 초록 점선 모델선 φ=r·β · 주황 점선 실측선 φ=r·β+c₀ · 회색 사선 무게중심 등고선 · 금색 = 앱 인과값 · 흰 점선 = 평활 · 흰 십자선 = 목표점.
- 예측점 평면: q + P·q̇. 초록 A=0, 노랑 트리거 띠 ±0.6°.
- 「데이터」탭: 원본값(펌웨어 열 그대로, 2 s 불변이면 빨강 ⚠고착) / 앱 파생값(Δ = 앱 − 펌웨어).
- 차트: 휠 줌 · 드래그 이동 · Shift+드래그 구간 · 클릭 커서 · 더블클릭 라이브 복귀. Space 재생, ←→ 한 칸, M 마크, Enter 분석 실행, H 패널 숨김.
- 분석 결과: 절차(번호) → 숫자 → 표 → 보조 곡선. 결과 기록에서 되살림.

## 부록 C. 그 밖의 도구 (연구 초중반용, 필요할 때만)
- **감쇠 진동**: 토크 해제 매달림 자유흔들기 구간 선택 → ω_n, ζ, c_φ (문서 16: 4.86 rad/s).
- **구간 통계**: 정지 20 s → hp_rms 로 Â 잡음 바닥 (문서 54).
- **재분석**: 끊기 → 파일 불러오기 → 같은 도구. 파이프라인 값을 바꾸면 파생열만 다시 계산.
