cbshbalance/slackline-balacing1/docs/65_부호브링업_정적체크_6단계_20260820.md

# 65. 부호 브링업 — 정적 체크 6단계 (2026-08-20)

> 원칙: 부호는 행동(접힘 방향)으로 추리하지 않는다. 정지 상태에서 채널 하나씩 손으로 돌려 확정한다.
> 행동 기반 −1 뒤집기는 금지 — 두 채널이 동시에 뒤집힌 경우와 하나만 뒤집힌 경우를 구별할 수 없다.
> 재조립·펌웨어 교체 때마다 이 표를 다시 통과시킨다 (5분).

## 0. 기준 고정
관찰자 위치를 정한다: 스윙 평면(x-z)을 정면에서, "로봇의 오른쪽 = 내 오른쪽".
프레임에 + 방향 화살표를 붙인다. 규약은 하나: **오른쪽 기울기 = +** (φ·α·θ 공통), δ = θ − α.

## 체크 표 (1~3, 5는 토크 OFF / 4는 지그에서 토크 ON)

| # | 채널 | 손 동작 | 기대 표시 | 틀리면 고칠 곳 (딱 한 곳) |
|---|---|---|---|---|
| 1 | φ 엔코더 | 줄(크랭크)을 발이 **오른쪽**으로 가게 천천히 | φ 증가(+) | φ 를 읽는 줄의 부호 상수만 |
| 2 | 발목 엔코더 | 크랭크 잡고 몸통을 머리가 **오른쪽**으로 | α 증가(+) | 발목을 읽는 줄만 |
| 3 | δ 엔코더 | 하체 잡고 상체만 머리가 **오른쪽**으로 | δ 증가(+) | δ 를 읽는 줄만 |
| 4 | 모터 방향 | δ 목표 +5° 명령 | 상체가 3번과 같은 방향으로 | MOTOR_DIR 만 |
| 5 | 속도 부호 | 3번 동작 중 δ̇ 표시 | δ 증가 중 δ̇ + | 속도를 읽는 줄만 |
| 6 | 종합 정합 | 로봇 통째로 오른쪽으로 기울이기 | φ·α·θ 전부 +, **A 도 +** | 어긋난 채널만 1~5 로 복귀 |

## 규칙

1. **부호 상수는 각 센서를 읽는 그 한 줄에만 존재한다.** 계산식 중간·A 계산·접기 로직에
   −1 이 흩어져 있으면 안 된다 (펌웨어 검토 1순위 항목).
2. **1~6 통과 후에는 어떤 상황에서도 행동을 보고 부호를 건드리지 않는다.** 접는 방향이 이상하면
   부호가 아니라 다른 곳(영점·문턱·γ 크기)이다. 부호를 다시 의심하려면 이 표 재통과 외에 방법이 없다.

## 펌웨어 검토 기준 (합의된 틀 — 이 밖의 코드는 삭제 후보)

- 루프: 엔코더 3개 읽기 → A 계산 → |A|>A_trig 면 접기 → 여유 조건에서 천천히 펴기
- 측정 3: 안정모드선 기울기 r (절편은 하드웨어 영점으로 0), P2R, λ
- 노브 4: γ(접는 양), T_rest(접기 후 대기), A_trig(문턱), 펴기 조건·속도
- w = [−1/r, 1, −1/(rλ), 1/λ] — r·λ 실측값만으로 계산 (감쇠는 실측 r·λ에 이미 포함, 문서 64·대화 8/20:
  감쇠 보정의 이론적 잔차는 속도 가중치에 O(감쇠/λ) — 실측 줄마찰 수준에서 1% 미만, 추가 측정 불요)
