cbshbalance/slackline-balacing1/docs/64_발목잡음_강건성_문턱_시뮬예측_20260820.md

# 64. 발목잡음 강건성 문턱 — 시뮬 예측 (2026-08-20)

> 사용자 질문: "실측 발목잡음을 주입해도 균형에 큰 차이가 없어 보이는데 잘 반영된 건가?"
> 답: 반영은 정상이고, **증분접기 모드에서는 차이가 커야 정상**이다(수 초 내 낙하).
> 차이가 없어 보였다면 그때 칼만(LQR·기본 부팅) 경로였을 것 — **칼만 측정 z=[θ_acc, θ̇_gyro, δ, δ̇]에는
> 발목 엔코더가 없어서** 발목잡음이 제어에 전혀 안 들어간다. 발목 엔코더는 enc 추정기(증분접기)만 쓴다.

## 1. 계측 (★★실측 프리셋, x0=0.5°, 8씨드 × 30 s, `enc_noise_ank_deg` 주입)

| σ_발목 [°] | 30 s 생존 | 접기수 중앙값 | 양상 |
|---|---|---|---|
| 0 | 생존 | 60 | 기준 |
| **0.05** (베어링 교체 목표) | **8/8** | 154 | 헛접기 ~3배지만 전부 자가수정 — 증분접기의 강건성 |
| **0.10** | **8/8** | 177 | 여전히 유계 |
| 0.15 | 2/8 | 66 | 경계 |
| 0.20 | 0/8 | 12 | 붕괴 |
| **0.223 (현재 실측, 문서 54)** | **0/8** (0.6~16 s) | 20 | 잡음이 문턱 0.6°를 상시 타격 → 헛접기 방향이 랜덤워크 → **유지각 ±55° 캡까지 표류 → 낙하**. |Â|<0.3° 저속복귀 조건이 잡음에 파묻혀 복귀도 죽는다 |

브라우저 경로(빨간 프리셋 → 잡음 체크)에서도 동일 재현: t=6.5 s 낙하. 전제: 이 주입 모델은
σ=0.223°에서 시뮬 Â 잡음 바닥 0.438° rms — 문서 54 실측 0.41~0.59° 재현 (README_v21 4단계).

## 2. 결론

1. **현재 잡음 바닥(0.223°)에서는 증분접기 장기 균형이 어렵다** — 문서 54의 "잡음이 문턱 자리를
   차지한다" 경고의 정량판. 실기에서 원인불명 낙하가 보이면 1순위 용의자.
2. **안전 문턱은 σ ≤ 0.10°, 베어링 교체 목표 0.05°는 여유 2배** — 문서 56의 교체 권고를 시뮬이 뒷받침.
   교체 후 재측정값을 UI 입력칸에 넣어 재검하면 된다.
3. 부수 관찰: 작은 잡음(0.05~0.10°)에서 접기 횟수가 ~3배로 늘어도 생존은 유지 — "매 사이클 다시
   재서 다시 잡는" 증분접기의 강건성이 그대로 보인다. 낙하 메커니즘은 접기 실패가 아니라
   **유지각(hold)의 잡음 랜덤워크 + 저속복귀 마비 → 관절한계 포화**다.

## 3. 모델 단서 (정직)

- 주입은 5 ms 샘플마다 독립 백색(=100 Hz까지 평탄). 실측 스펙트럼은 50 Hz까지 평탄(문서 54)이라
  속도 채널(25 ms 차분) 기여가 다소 과대(보수적) 방향일 수 있다. 문턱 숫자는 근사, 방향은 견고.
- 단일 초기조건(0.5°) 기준. 씨드는 8개( `e.rng` 교체 — 기본은 seed 0 고정이라 단발 재현엔 주의).
- 재현 코드: `analysis/spike_verify_20260819.py` 의 엔진 셋업 + `enc_noise_ank_deg` 스윕 (본 문서 §1 표).
