cbshbalance/slackline-balacing1/docs/63_발표시나리오_부스배치판_초안_20260820.md

# 63. 발표 시나리오 — 부스 배치판 초안 (2026-08-20) ⚠미확정 — 리허설·학생 토의로 수정

> 정본 관계: **문서 49(3단계 서사)가 서사의 정본**이고, 이 문서는 그 서사에 부스 실물
> (포스터 120×130 · 전시대 로봇 · 노트북+모니터(v21) · A4 보조차트 · 중간 산출물 · 탐구일지)의
> **배역을 나눠준 실행판**이다. v21 씬 체인(`v21_pres/scenes/chain.json`)이 이 문서 §1의 화면 큐를 구현한다.
> 씬 순서 교체 = chain.json 수정만 (코드 무변경) — 리허설하며 이 문서와 함께 고칠 것.

## 0. 매체 배역 원칙

| 매체 | 배역 | 원칙 |
|---|---|---|
| 포스터 (120×130) | 멈춰 있는 것 전부 — 서사 뼈대 + **낙차 카드(중앙 눈높이)** | 3분 내내 손가락이 가는 지도 |
| 전시대 로봇 | **증거** | 입장 순간부터 이미 균형 중 — 설명 없이 눈에 (49 §1-a) |
| 모니터 (v21) | **움직이는 것만** | 정지 그림은 화면에 안 띄움 (포스터 몫) |
| A4 보조차트 | 질의응답에서 **꺼내는 카드** | 3분엔 안 꺼냄 |
| 1차 로봇·중간 출력물·탐구일지 | 노력도의 **물증** | 말로 설명 안 함, Q16 때만 가리킴 |

## 1. 3분 (181s) — 씬 × 매체 × 조작 (화면 담당 큐 = 씬 체인 `[` `]`)

| # | s | 멘트 요지 (49 대본) | 매체·조작 | 체인 |
|---|---|---|---|---|
| 1-a | 15 | 역설: 장대 없이, 부채뿐, 줄은 일부러 느슨 | **▶영상 시퀀스 시작** + 손가락 로봇↔영상 왕복 | 씬① |
| 1-b | 12 | 얼음판: 내력으론 1mm도 못 옮긴다 | 포스터 좌상단 컷 | |
| 1-c | 13 | 선행연구도 장대의 몫, '어떻게'는 공백 | 포스터 논문 한 줄 | |
| 2-a | 15 | 역발상 — 발을 무게중심 **너머로** | 영상 시퀀스가 오버랩→60cm 모프 자동 진행 | (①이 커버) |
| 2-b | 22 | 허리의 발명 — 접으면 반작용으로 발이 밀린다 | **천천히 접기 시연**(CoM 등고선) + 포스터 1체→2체 | 씬② |
| 2-c | 18 | 균형의 재정의 — 후보 소거 | 포스터 소거 3컷 | |
| 2-d | 15 | 그게 안정모드 + 상태공간 | **원위치 평면 전체화면 + Shift 드래그**(왼쪽 로봇 미러가 엇갈림 자세) | 씬③ |
| 2-e | 18 | ★교점 ε\*=−h/(rR+h). 1차방정식 둘. 기운 크기가 식에 없다 | **포스터 낙차 카드, 3초 침묵** (화면 조작 없음) | 씬④(해제) |
| 2-f | 8 | 회수 — 흔들림 위에 몸을 올려놓는다 | 시선만 로봇으로 | |
| 3-a | 10 | 전물리 시뮬레이터를 직접 만들었다 | 표준 화면 복귀 | 씬⑤ |
| 3-b | 12 | 완전 사이클 붕괴 → 각주가 증분접기로 | **★★실측 프리셋 러닝** (예측점 평면 접기 반복) | 씬⑥ |
| 3-c | 13 | 잰 것은 세 개뿐 — 저울도 자도 없이 | 포스터 실측 카드 3장 | |
| 3-d | 10 | **저 직선이 저 로봇 안에 들어 있다** | 손가락: 화면 직선 → 전시대 로봇 | |

## 2. 10분 질의응답 — 질문 → 꺼내는 물건

| 질문 (49 카드) | 꺼내는 것 | 신규 재료 |
|---|---|---|
| 두 직선이 어떻게 나오나 (Q6) | A4① 메커니즘 그림 + 좌표 갈아타기 씬 | |
| 직선이 근사 아닌가 / 속도는 (Q7) | 예측점 평면: **선 위 클릭 → 실행** | **문서 62 활 시연** — "벗어난 수직거리가 A" |
| 왜 LQR 안 썼나 (Q2/Q14) | A4② LQR 카드 (게인 99% 상쇄·대조군) | |
| 실물 증거는 (Q15) | **실측선 오버레이** (초록 vs 주황 한 화면) + A4③ 실측 3종 | **잡음 재현**: σ_발목 0.223° → 시뮬 Â 바닥 0.438° = 실측 0.41~0.59° 안 |
| 이론 vs 실기 접기량 (Q4) | A4④ FWE 과접기 상태공간 ↔ A4⑤ 증분접기 실제 상태공간 나란히 | |
| 어디까지 직접 (Q16) | 1차 로봇·중간 출력물 가리키고 → **탐구일지 반전 목록** | |
| 얼마나 서나 (Q1) / 시연 요청 | 로봇 외란 회복 ("저 한 줄로 됩니다") + 분포 카드. 실패 시 49 §6 회수 멘트 | |
| (자유 시연) | **놓기 3단 대조**: Shift 클릭(선 위=오래 버팀) / 선 밖(즉시) / 제어 ON(다 잡음) | 통일 집기로 원클릭 |

**A4 보조차트 목록(안)**: ①메커니즘 인과 사슬 ②LQR 대조 ③실측 3종(P2R 0.417·λ 5.3·잡음 0.438)
④FWE 과접기 상태공간 ⑤증분접기 실제 상태공간 ⑥탐구일지 반전 목록 ⑦낙차 카드 A4 사본. 뒤판에 부호·색 규약 카드(49 §8-4).

**역할 3인**: 말(대본) / 화면(씬 체인 `[` `]` + 질의응답 자유 조작) / 손(로봇 놓기·받기 전담).

## 3. 씬 체인 사용법 (v21)

- `v21_pres/scenes/chain.json` 이 씬 배열. **`]` = 다음 씬, `[` = 이전 씬.** 좌하단 HUD 에 씬 번호·제목·발표자 노트 표시(5초 후 흐려짐).
- 액션 어휘: `click`(버튼) / `check`(체크박스) / `send`(서버 명령) / `dm`(키네마틱 시연) / `fs`(평면 전체화면/해제) / `presmode`(발표 모드).
- **순서 교체·씬 추가 = chain.json 수정 후 새로고침.** 코드는 건드리지 않는다 (문서 56 §3F 요구사항).
