cbshbalance/slackline-balacing1/docs/62_예측점평면_안정모드선_놓기의_실제궤적_20260820.md

# 62. 예측점 평면에서 "안정모드선 위 놓기"의 실제 궤적 — 미끄러짐·진폭배율·활 (2026-08-20)

> v21 집기 기능으로 놓기 시연을 하다 나온 사용자 질문 두 개를 전물리(MuJoCo, ★★실측 프리셋,
> 트리거 999°로 제어 봉쇄)로 계측해 답한 기록. 코드 `analysis/spike_verify_20260819.py` 의
> 엔진 셋업 재사용. 관련: 7/5 예측점평면 노트(직선이탈거리=2A/|u₂|), 문서 58 §2(놓기의 정직한 한계), 61.

## 1. 질문 ① — "선 위 놓기(속도 0)를 예측점 평면에서 보면 활처럼 휘나?"

**선형 이상화에서는 휘지 않는다 — 예측점도 정확히 그 직선 위를 미끄러진다.**
순수 안정모드는 q(t)=v₁·s(t) 로 위치·속도가 모두 모드선 방향 v₁이므로,
q_pred = q + q̇/λ = v₁·(s+ṡ/λ) 도 매 순간 v₁의 배수다. 속도항은 점을 직선 밖이 아니라
**직선을 따라** 밀어 놓는다. "A=0 ⟺ 예측점이 선 위"의 다른 표현.

단, 왕복의 **진폭과 위상은 다르다** (변위 cos + 속도 sin 의 합성):

> s_pred(t) = s₀√(1+(ω/λ)²)·cos(ωt+δ),  tanδ = ω/λ

실측 세트(ω_eff=7.03, λ=5.92): 진폭배율 1.55, 위상 앞섬 ≈50°.
전물리 실측(β₀=1° 선 위 놓기): 예측점 선따라 진폭 2.69° vs 원위치 1.93° → **배율 1.40**
(감쇠로 이론 1.55에서 약간 깎임). 원위치가 s≈0(중앙)을 지나는 순간 예측점은 선을 **따라**
−2.10° 지점에 가 있었고 선에서 수직 이탈은 0.06°뿐 — 활이 아니라 미끄러짐.

**따라서 마우스로 모드선 위를 드래그하는 시연은 '모양(경로·모드비율)' 면에서 물리적으로 옳다.**
실제와 다른 것은 박자(사인)와 예측점의 과주(×1.4~1.55, 위상 앞섬)뿐이다.
3D 로봇이 보여주는 엇갈림 자세 시퀀스도 매 순간 정확한 모드비율이다(Shift 스냅이 보장).

## 2. 질문 ② — "그런데 실제로 놓아 보니 살짝 벗어나 → 선 따라 가다 → 가로질러 발산한다 (활처럼)"

**관찰이 정확하다. 전물리에서는 §1의 미끄러짐 위에 '벗겨짐 = A(t)의 성장'이 얹힌다.**

| 놓기점 β₀ (선 위·속도 0) | 놓자마자 이탈 d₀ | 선 재교차 | 발산 방향 | 낙하 |
|---|---|---|---|---|
| ±0.5° | ∓0.001° | **0.36 s에 가로지름** | d₀ 반대쪽 | 1.98 s |
| ±1.0° | ±0.003° | 없음 | d₀ 쪽 | 1.70 s |
| ±2.0° | ±0.010° | 없음 | d₀ 쪽 | 1.49 s |
| ±3.0° | ±0.017° | 없음 | d₀ 쪽 | 1.39 s |

세 성분의 합성이다:

1. **초기 즉시 이탈 d₀ (진폭²에 비례)** — 화면의 초록 선은 선형(소각) 모델의 방향이고,
   유한 진폭에서 전물리의 실제 '흔들리기만 하는 방향'은 미세하게 다르다.
2. **선을 따라 가는 왕복** — §1의 안정모드 미끄러짐.
3. **이탈거리의 지수 성장 = A(t)** — 비선형 씨딩이 λ로 증폭 (β₀=1° 기준 0.05°(0.2s) →
   0.24°(0.6s) → 1.85°(0.95s)). 직선이탈거리=2A/|u₂| (7/5 노트) 이므로 **화면에서 선과의
   수직 거리가 곧 위험도 A 그 자체**다.

작은 진폭(±0.5°)에서는 씨딩의 성장 방향이 d₀와 **반대**라서 "벗어남 → 선에 도로 붙음 →
가로지름 → 반대편 발산"의 활 궤적이 되고, 1° 이상에서는 같은 방향이라 가로지르지 않고
같은 쪽으로 벗겨진다. 낙하 1.4~2.0 s 는 문서 58 §2의 "선 위 버팀 1.5~2.0 s"와 정합.

## 3. 시연·질의응답 활용

- **활은 결함이 아니라 판정선의 의미 그 자체다**: "직선에서 벗어난 수직 거리가 위험도 A이고,
  저 활이 휘어 나가는 것이 A가 자라는 것이다. 우리 제어는 저것이 0.6°가 되기 전에 접는다."
- 3단 대조의 자연스러운 연결: 선 위(활, 오래 버팀) / 선 밖(즉시 한쪽) / 제어 ON(전부 생존).
- 추정 링 주의: 부팅 직후 **칼만** 추정기는 v19 초기화 규약(β̂=0 시작, φ만 엔코더 즉시)이라
  링이 세로축 부근에서 시작한다 — 버그 아님. **enc 추정기(★★실측 프리셋)** 는 정지 놓기에서
  추정=참값으로 시작해 클릭 즉시 링이 점 위에 겹친다. **시연은 ★★프리셋 상태로.**
