cbshbalance/slackline-balacing1/docs/49_발표서사축_3단계_확정_20260816.md

# 발표 서사 — 3단계 확정본 (2026-08-16)

> **[8/19 사본 주의] 씬 순서·대본은 미확정 — 학생·AI 토의로 계속 수정 중이다 (사용자 확인 8/18).
> v21 씬 체인은 이 문서를 '참고 초안'으로만 쓰고, 순서 교체가 쉬운 배열 데이터로 만들 것.**

> **이 문서가 발표 서사의 정본이다.** 영상(문서 47·48), 학생 대본, 질의응답 카드는 전부 여기서 파생된다.
> 대상: 제72회 전국과학전람회 **2차 면담심사 (2026-09-15)** — 발표 3분 + 질의응답 10분, 총 13분.

---

## ★ 서술 방침 (이어받는 사람·AI가 먼저 읽을 것)

1. **로봇 '어름이'가 전시대 위에서 실제로 균형을 잡고 있는 것을 전제로 짠다.** 시연은 실시간이다.
2. **"아직 안 됐다 / 문서끼리 안 맞는다" 류의 서술을 발표 자료에 넣지 않는다.**
3. **【 】 는 실기 후 채워 넣을 자리.**
4. 연구의 성격(문서 46): 고등학생이 정성적 추론으로 역학 문제를 풀고 로봇을 제어한 연구다.
   대학원 수준의 제어이론·수식을 자랑하는 자리가 아니다.

---

## 0. 이 발표가 겨냥하는 것

### 심사 조건

| 항목 | 내용 |
|---|---|
| 형식 | 2차 면담심사. 심사위원 3인 — **물리 전공자·공학 전공자·변리사** 등 |
| 시간 | 발표 3분 + 질의 10분. **형식 자유, 총 13분 안이면 됨** |
| 참여 | **학생 3명 모두 입실.** 한 질문에 셋이 나눠 답하거나 서로 보충 가능 |
| 시연 | **전시대 위 실물 시연 포함.** 질의 중에도 가능 |
| 배점(70점) | 창의성·탐구성 **30** / 이론적 타당성 15 / 노력도 **15** / 실용성 10 |

### 목표 반응 — 컨설팅 교수 실제 반응을 재현한다

> "이게 **해석해**가 나왔다고요? 심지어 **1차방정식**으로?
>  **차원축소**도 했다고요?
>  듣고 보니 결과가 **동양철학과 서양철학의 차이**를 보여주는 것 같기도 하네요."

**문제: 컨설팅은 1시간이었고 우리는 13분이다.**

**그러나 진짜 차이는 시간이 아니라 화자다.** 컨설팅에서는 우리가 1시간을 끌고 갔지만,
심사에서는 **10분을 심사위원이 묻는다.** 남이 설명해 준 답은 "그렇군"이고, 자기가 캐물어서 나온 답은 "이야"다.

→ **3분은 설명이 아니라 낙차를 세우는 데 쓴다. 유도는 10분에 심사위원이 끌어내게 한다.**

### 감탄 포인트 4종 (정본)

**로봇이 선 것은 감탄이 아니라 증거다.** 비전공자에게는 "신기하다"로 작동하지만,
동역학·로봇공학 전공자에게 로봇이 서는 것 자체는 놀랍지 않다 (LQR도 세우고, 오히려 더 잘 돌아온다).
**전공자의 감탄은 아래 넷에서 나온다.**

| # | 감탄 포인트 | 무엇이 놀라운가 |
|---|---|---|
| **①** | **해석해** | 복잡하고 무질서해 보이는 현상을 단순화·모델링해서, **수치최적화도 시뮬레이션도 아닌 손으로 푼 닫힌형**으로 답을 냈다 |
| **②** | **1차방정식** | 그 해가 **직선 두 개의 연립**에서 나왔다. 분모 rR+h는 **두 직선이 평행해지는 조건** — 공식이 자기 유효범위를 품고 있다 |
| **③** | **차원축소** | 자유도 3·입력 1의 결합 비선형계가 평면 위 **직선 하나**, 다시 **숫자 하나**로 |
| **④** | **동서양 대비** | 서양의 장대 = **힘으로 무게중심을 밀어** 고정된 줄 위로 되돌린다.<br>한국 줄타기 = **줄이 이미 하고 있는 흔들림 위에, 몸을 올려놓는다.** |

⚠ **④의 취급:** 철학 어휘를 우리가 먼저 꺼내지 않는다. 물리적 사실만 정확히 말하면
**심사위원이 스스로 그 해석에 도달한다.** 교수님도 그렇게 도달하셨다.
우리가 말하면 유치해지고, 심사위원이 말하면 그 사람의 발견이 된다.

---

## 1. 압축의 원리 — 버리는 게 아니라 꿰는 것

7단계를 3단계로 **줄이려 하면** 막힌다. 버릴 것이 다 아깝기 때문이다.

**그런데 꿰면 줄일 필요가 없다.** 각 항목이 앞 항목이 낳은 질문의 답이 되면,
청중은 그것을 "단계"로 세지 않는다 — **질문은 단계로 느껴지지 않기 때문이다.**

아래 2단계 안에서 원래 7개 중 **네 개(가설·모델·균형정의·해석해)가 하나의 질문 사슬**로 이어진다.

---

# 2. 3단계 (181초)

| | 단계 | 담는 것 | 시간 |
|---|---|---|---:|
| **1** | **왜 이게 문제인가** | 역설 + 선행연구의 공백 | 40s |
| **2** | **답 하나** | 가설·모델·메커니즘·균형정의·해석해 — 전부 질문 사슬로 | 96s |
| **3** | **그리고 실제로 된다** | 현실 대응 → 증분 접기 → 실물 | 45s |

---

## 1단계 — 왜 이게 문제인가 (40s)

> **1-a.** *(어름이는 이미 줄 위에서 균형을 잡고 있다. 설명 없이 먼저 눈에 들어오게 둔다.)*
> "지금 저게 어떻게 서 있는 걸까요. 서양 줄타기는 **긴 장대**로 균형을 잡습니다.
> 한국 광대는 부채 하나뿐이고, 부채는 기운 몸을 세울 힘이 없습니다.
> 게다가 줄은 **일부러 느슨합니다.**"
>
> **1-b.** "마찰 없는 얼음판 위에서는 몸속에서 무엇을 해도 무게중심을 옮길 수 없습니다.
> 한 번 기울면 떨어져야 합니다. **그런데 광대는 떨어지지 않습니다.**"
>
> **1-c.** "이걸 다룬 연구가 딱 하나 있습니다. 하버드 연구진이 영국왕립학회지에 낸 논문인데 —
> **균형 토크를 팔이나 장대의 몫으로 두었습니다.** 그리고 '제어기로 잡을 수 있다'는 것까지만 보였지,
> **어떤 물리 과정으로 되돌아오는지는 답하지 않았습니다.**"

**설계 의도**
- 1-c가 1-a의 "장대"를 되받으며 역설이 두 번 강해진다. 권위 있는 연구도 장대를 썼다 = 장대 없이는 설명이 안 된다는 가장 강한 증거.
- "장대"는 **2-f에서 마지막으로 회수될 씨앗**이다.

---

## 2단계 — 답 하나 (96s) ★ 여기가 전부

**각 항목이 다음 질문을 낳는다. 화살표가 논리다.**

> ### 2-a. 역발상 — 발을 옮긴다 (15s)
> "저희는 거꾸로 봤습니다. 줄이 출렁이는 게 방해가 아니라 **자원** 아닐까.
> 얼음판에는 없고 처진 줄에는 있는 것 — **발이 움직이면 복원력이 생깁니다.**
> 무게중심을 못 옮기면 **발을 옮기면 됩니다.**
> 그것도 무게중심 바로 아래가 아니라 **너머로** 던져서, 반대로 쓰러지게 만드는 겁니다."
>
> ↓ **그런데 무엇으로 옮기나 — 외력도 없고 발목 토크도 없는데?**
>
> ### 2-b. 허리의 발명 — 1체에서 2체로 (22s)
> "선행연구의 모델은 **막대 하나**였습니다. 허리가 없어요.
> 그런데 저희에겐 발을 옮길 힘이 필요했습니다. 밖에서 미는 힘도 없고,
> 줄은 점접촉이라 발목으로 버틸 수도 없습니다.
> **몸 안에서 힘을 만들 수 있는 곳**을 찾다가 — **막대를 둘로 나누고 사이에 관절을 넣으면 되겠다.**
> 허리입니다. 허리를 접으면 **반작용으로 발이 밀립니다.** *(애니메이션 5초)*
> 선행연구는 자유도 2였는데 저희는 3이 됐습니다. **일부러 문제를 더 어렵게 만든 셈**입니다 —
> 그래야 힘이 **몸 안에서** 나오니까요."
>
> ↓ **그럼 얼마나 접나?**
>
> ### 2-c. 균형이 뭔지부터 — 스스로 정의 (18s)
> "얼마나 접을지 정하려면 **어디로 가야 하는지**를 먼저 알아야 했습니다.
> 그런데 줄 위의 균형이 뭔지부터가 분명하지 않았습니다. 가운데 멈춰 서는 걸까?
> 광대는 계속 흔들리는데요.
> 후보를 세우고 하나씩 따졌습니다 — 몸만 세우고 줄만 흔들리는 건 이 계에 존재하지 않고,
> 줄과 나란해지는 건 첫 순간만 버티고. 그렇게 좁혀 가니
> **줄과 몸이 일정한 비율로 엇갈려 흔들리며 되돌아오는 상태**가 남았습니다."
>
> ↓ **그런데 그건 이미 이름이 있는 것이었다**
>
> ### 2-d. 그게 안정 모드였다 + 상태공간 평면 (15s)
> "나중에 알았습니다. 저희가 추론으로 도달한 그 상태를 동역학에서는 **'안정 모드'**라고 부릅니다.
> **저희 추론이 멈춘 자리에, 물리학이 이미 이름을 붙여 둔 것이 서 있었던 겁니다.**
> 그리고 그걸 가장 간단하게 그릴 수 있는 게 **상태공간 평면**입니다 —
> 이 평면에서 안정 모드는 **직선 하나**가 됩니다.
> 그리고 접기는 **또 다른 직선을 따라서만** 미끄러집니다."
>
> ↓ **그럼 얼마나?**
>
> ### 2-e. 교점 (18s) — *낙차 카드로 전환, 3초 침묵*
> "**두 직선의 교점**입니다. 저희가 실제로 푼 건 **1차방정식 두 개**예요.
> **수치해석도 시뮬레이션도 쓰지 않았습니다.**
> 답이 이렇게 나옵니다 — ε\* = −h/(rR+h).
> 무게중심 높이, 줄 처짐, 엇갈림 비율. **기운 크기가 식에 없습니다.**
> 그래서 눈대중으로 탈 수 있습니다."
>
> ### 2-f. 회수 (8s)
> "서양의 장대는 **힘으로 무게중심을 밀어** 고정된 줄 위로 되돌립니다.
> 저희가 찾은 한국 줄타기는 다릅니다 —
> **줄이 이미 하고 있는 흔들림 위에, 몸을 올려놓는 것**이었습니다."

### 2단계 설계 노트

- **균형의 재정의(2-c)가 억지로 끼워넣은 게 아니라 논리 사슬의 필수 고리가 된다.**
  "얼마나?"에 답하려면 "어디로?"가 먼저이기 때문이다.
- **'모드'는 이름만 부르고 설명하지 않는다(0초).** 전공 심사위원은 한 단어로 다 알아듣고,
  동시에 **"모드분석은 표준 기법 아닌가"라는 지적을 우리가 먼저 인정하고 들어가는** 셈이 되어 방어선이 공짜로 생긴다.
- **대칭이 하나 생긴다** — 2-b는 선행연구에 **없던 허리를 만들었고**, 2-c/d는 교과서에 **있던 모드에 스스로 도달했다.**
  없던 걸 만든 것과 있는 걸 찾아낸 것. 창의성·탐구성을 보는 두 방식이 2단계 안에 다 들어간다.

---

## 3단계 — 그리고 실제로 된다 (45s)

> **3-a.** "여기까지는 이상적인 세계의 답입니다. 실물에는 마찰, 줄 자체의 관성, 신호 지연,
> 센서 눈금 한계가 있습니다. 그래서 그걸 전부 넣은 시뮬레이터를 **직접 만들었습니다.**"
>
> **3-b.** "돌려 보니 원래 메커니즘의 마지막 단계가 무너졌습니다. 그런데 이론 각주에
> '이론적 진기함'이라고 적어 뒀던 성질 하나 — **정확히 접으면 펴지 않아도 발산하지 않는다** —
> 만 살아남아서, **증분 접기**라는 최종형이 됐습니다."
>
> **3-c.** "그리고 로봇을 세우는 데 실제로 잰 것은 **세 개**입니다.
> 접으면 발목이 얼마나 도는지, 어디에 놓으면 안 흔들리는지, 얼마나 빨리 넘어지는지.
> **저울도 자도 쓰지 않았습니다.**"
>
> **3-d.** *(어름이를 가리킨다. 화면에는 예측점 평면이 실시간으로 돌고 있다.)*
> "**저 직선이 지금 저 로봇 안에 들어 있습니다 — 로봇은 매 순간 저 직선에서 얼마나 벗어났는지 재서, 벗어난 만큼만 접습니다.**"
>
> *(⚠ "저 식(ε\*)이 돌고 있다"고 말하지 말 것 — 펌웨어에 도는 것은 증분 접기와 A 계산이다.
> A = 안정모드선까지의 거리이므로 "직선이 안에 있다"는 문자 그대로 사실이고, 낙차 카드와 직결된다.)*

---

## 3. 원래 7단계가 어디로 갔는지

| 원래 | 어디로 | 형태 |
|---|---|---|
| 1 역설 | 1-a, 1-b | 그대로 |
| 2 선행연구 공백 | 1-c → **2-f에서 회수** | 두 번 씀 |
| 3 가설·역발상 | 2-a | 그대로 |
| 4 2체 모델·FWE | 2-b | **모델 제안 과정으로 승격** + 애니메이션 5초 |
| 5 균형의 재정의 | 2-c | **질문 사슬의 필수 고리로 승격** |
| 6 모드분석·해석해 | 2-d, 2-e | **과정은 빼고 결과만.** '모드'는 이름만 |
| 7 시뮬·로봇 | 3-a~d | 그대로 |

**버린 것은 없다.** 4번이 설명에서 그림으로 바뀌었고,
6번의 *과정*(좌표 갈아타기·고유벡터 계산)만 빠졌다.
→ 그건 심사위원이 **"그 두 직선이 어떻게 나옵니까?"**라고 물을 때 여는 카드다 (앱 씬 ④, 38초).

---

## 4. 낙차 카드 — 2-e에서 띄우는 한 장

**감탄 = 낙차.** 교수님이 1시간에 걸쳐 도달한 낙차를 심사위원은 **한 화면에서** 봐야 한다.

```
┌──────────────────────────┬──────────────────────────┐
│                          │                          │
│   M(q)q̈ + C(q,q̇)q̇       │        φ                 │
│      + G(q) = Bτ         │        │  ╲ 안정모드선    │
│                          │        │   ╲   (기울기 r) │
│   [3×3 결합 행렬 전체]    │   ─────┼────╳─────── β    │
│   [비선형 · 저구동]       │        │   ╱  ↖교점       │
│   [자유도 3, 입력 1]      │        │  ╱ 접기 등고선   │
│                          │        │ ╱  (기울기 −h/R) │
│                          │                          │
│                          │   ε* = −h / (rR + h)     │
│                          │    h: 무게중심 높이       │
│                          │    R: 줄 처짐            │
│                          │    r: 엇갈림 비율         │
└──────────────────────────┴──────────────────────────┘
              ⟶  이 사이에 수치해석은 없습니다  ⟵
```

- **왼쪽은 읽으라고 띄우는 게 아니라 벽으로 보이라고** 띄운다. 글씨는 작아도 된다.
- **오른쪽은 크게.** 직선 두 개가 교차하는 그림이 핵심 — "1차방정식"이 눈으로 보여야 한다.
- **기호마다 한글 라벨을 단다.** 속도도 힘도 질량도 기울기도 없고 **전부 몸 치수와 줄 모양뿐**이라는 것을 심사위원이 스스로 읽는다. 설명 한 문단보다 낫다.
- 이 한 장이 **3분의 절정이자 10분 내내 되돌아올 앵커**다. 질의 중 길을 잃으면 이 화면으로 돌아온다.

---

## 5. 시간 배분 — 러프컷 대비

|  | 러프컷(210s) | 3단계안(181s) |
|---|---:|---:|
| 문제 인식 | 16s (8%) | **40s (22%)** |
| 모델·메커니즘 | 34s | 37s |
| 모드분석·상태공간 | **114s (54%)** | **33s (18%)** |
| 실증 | 16s | 45s |

**러프컷이 길었던 건 단계가 8개라서가 아니라 모드분석 과정에 절반 이상을 썼기 때문이다.**
거기서 81초가 나오니 문제 인식과 실증을 둘 다 늘리고도 29초가 줄어든다.

---

## 6. 실물 시연 — 감탄이 아니라 증거

**프레이밍: "저 단순한 식 한 줄만으로 이게 됩니다."**
복원 성능 자랑으로 쓰지 않는다 — LQR이 더 잘 돌아오고, 전공 심사위원은 그것을 안다.

| 시점 | 쓰임 |
|---|---|
| **발표 전** | 이미 서 있다. 설명 없이 보이는 것이 1-a의 재료 |
| **2단계 중** | 화면을 보다가 실물로 눈이 갔다 오게 둔다. 식과 물체가 같은 것이라는 감각 |
| **3-d** | 명시적으로 가리킨다 |
| **질의 중** | 요청 시 외란 회복. **"저 한 줄로 됩니다"이지 "잘 돌아옵니다"가 아니다** |

### 안전과 역할 분담 (학생 3명)

| 역할 | 담당 | 하는 일 |
|---|---|---|
| **말하는 사람** | 【 】 | 3분 대본. 질의는 셋이 나눠 답함 |
| **화면** | 【 】 | 앱 조작 — 씬 점프·슬로우모션·자유 시점 |
| **손** | 【 】 | **넘어질 것 같으면 즉시 잡는다.** 전시대 위에는 하부 프레임이 없다 |

- 하부 프레임 없이 전시대 위에 올리므로 **낙하 대비 필수.** 안전 그물 또는 받침 【결정 필요】
- "손"은 숨기지 말고 서사에 넣는다: **"광대 옆에도 사람이 섭니다"** 한마디면 자연스럽다
- ⚠ 최악의 경우(꿈틀거리다 쓰러짐) 대비 한 줄:
  > "지금은 못 잡았네요. **버티는 시간이 분포라는 것 자체가 저희 결과 중 하나입니다** —
  > 위험도가 0.1초마다 두 배가 되는 계라서, 시작 조건이 조금만 달라도 결과가 갈립니다. 한 번 더 해보겠습니다."

  → 변명이 아니라 **결과로 회수**된다 (문서 11 발견③)

---

## 7. 10분 질의응답

3분이 낙차를 세워 놓으면 심사위원은 반드시 **"그게 어떻게 됩니까?"**를 묻는다.
그 순간부터가 본편이다. **묻는 대로 한 단계씩 열어 준다.**

### 7-1. 낙차가 부르는 질문 → 여는 것

| 질문 | 여는 것 | 도구 |
|---|---|---|
| "저 3×3에서 저 두 직선이 어떻게 나옵니까?" | **차원축소 전 과정** | 앱 씬 ④ (38s) |
| "왜 직선입니까? 근사 아닙니까?" | 정확한 모드 대수 | Q7 |
| "속도는 어디 갔습니까?" | 예측점 평면 | 앱 씬 ⑥ |
| "실제 로봇엔 뭐가 들어갑니까?" | δ_f\* = 6.144 β + 3.713 φ — **ε\*의 실기판, 이것도 1차식** | 앱 씬 ⑦ |
| "얼마나 섭니까?" | 분포로 답한다 | 실물 + Q1 |

### 7-2. ★ 탐구일지 「반전 목록」 한 장

**노력도 15점의 본체.** "시행착오가 있었습니까 / 가장 어려웠던 게 뭡니까"에
말로 답하면 시간만 간다. **목록 한 장을 펴서 보여준다.**

| 무엇을 믿었나 | 무엇이 틀렸나 | 무엇으로 바뀌었나 |
|---|---|---|
| 【 】 | 【 】 | 【 】 |

→ 열 줄 정도. 심사위원이 훑는 30초 동안 아무 말 안 해도 노력도가 전달되고,
그중 하나를 골라 물으면 그게 또 좋은 질문이 된다.

### 7-3. 답변 카드 — 심사위원 유형 3종

**카드마다 주답자를 미리 정한다.**

#### 유형 A — 물리 전공자

| # | 질문 | 답변 골자 |
|---|---|---|
| **Q6** | "모드 분석은 표준 기법 아닙니까?" | 맞습니다 — **저희 주장은 기법이 아니라 결과입니다.** 균형이 어떤 상태인지를 후보 소거로 좁혀 갔고, 도달한 뒤에 그게 안정 모드라는 걸 알았습니다. 그 앞의 추론도, 그 뒤에 r을 닫힌 형태로 구하고 ε\*를 유도하고 예측점 평면을 만든 것도 저희가 한 것입니다. → 씬 ④ |
| **Q7** | "예측점 평면이 근사입니까?" | 아닙니다. 정확한 모드 대수입니다 — `u₂ᵀq_pred = 2A`이고, 임의 4차원 상태 200개에서 접기 후 잔여 \|A\|가 **최대 7.8×10⁻¹⁷**입니다. |
| **Q3** | "기운 크기와 무관하다는 게 정말입니까?" | 유도에서 β₀가 양변에서 약분됩니다. MuJoCo 수치 최적과 **R ≥ 0.6 m에서 오차 2.4% 이하**. R=0.3 m에서 −10%로 벌어지는데 **소각 근사가 깨지기 때문**입니다 — 공식이 자기 유효 범위를 정직하게 보여 줍니다. |
| **Q18** | "공식이 안 되는 경우는 없습니까?" | 있습니다. **분모 rR+h가 0이 되면** 터집니다. **두 직선이 평행해진다**는 뜻이에요 — 접기가 아무리 미끄러져도 안정선에 닿지 못합니다. 유효 조건이 공식 안에 들어 있습니다. |
| **Q15** | "실물에서 이론이 맞은 증거는?" | 줄 자체의 물리를 따로 쟀습니다. 고유진동수 **4.86 rad/s** — 이론 4.76 대비 **+2%**. 등시성 깨짐까지 실측 1.10배 vs 이론 1.09배로 **1% 안에서** 맞았습니다. |

#### 유형 B — 공학 전공자

| # | 질문 | 답변 골자 |
|---|---|---|
| **Q2** | "왜 LQR을 안 썼습니까?" | **썼습니다 — 대조군으로.** PID가 발산해서 LQR로 갔고 균형은 잡혔습니다. **LQR이 더 잘 돌아오기도 합니다.** 그런데 게인 여섯 개는 **'왜' 균형이 잡히는지 말해 주지 않습니다.** 저희 목적은 성능이 아니라 원리 규명이었습니다. |
| **Q14** | "그래도 LQR로 충분한 것 아닙니까?" | **안 쓴 게 아니라 뜯어보고 한계까지 쟀습니다.** ① 게인 여섯 항의 기여도를 분해하니 **99.0%가 서로 상쇄**되고 **φ항이 가장 늦게 피크**를 칩니다 — "허리 → 발 → 중력토크"라는 저희 인과 사슬이 LQR 안에도 그대로 있었습니다. ② 중앙에서 설계한 고정 게인은 **걸어가다 처짐이 얕아지면 불안정해집니다.** ③ 게인 여섯 개를 운전 데이터로 온라인 조정하는 건 **원리적으로 불가능**합니다(공선성). |
| **Q8** | "실제로 뭘 재서 넣었습니까?" | 세 개입니다. 위험도의 가중치가 **r과 λ만으로 닫히기 때문**입니다: w = [−1/r, 1, −1/(rλ), 1/λ], 모델값과 **0.035% 일치**. 질량·관성·감쇠·기어효율·서보상수는 하나도 필요 없고, 남는 어긋남은 노브 하나가 흡수합니다. 그 노브 범위가 **γ = 4~12로 3배**라 줄 위에서 돌려 맞추면 됩니다. |
| **Q5** | "노브가 하나라는 건 편의 아닙니까?" | 수학적 필연입니다. 접기각을 항상 위험도에 비례해 처방하므로 학습 입력 둘이 **언제나 한 직선 위**에 놓입니다. 둘을 동시에 배우면 전 조건 3초 내 낙하, 하나만 배우게 하자 생존 중앙값 **32.6초 → 70.4초**. |
| **Q4** | "제목에서 '접고-기다리고-펴기'가 왜 빠졌습니까?" | 최종 제어기가 바뀌었습니다. 실측 마찰을 넣자 완전 사이클이 무너졌고, 각주의 성질 — **ε\*로 접으면 펴지 않아도 유계** — 만 살아남았습니다. 사이클이 절반 이하로 짧아지며 **허용 오차창이 ±6% → ±37%**. |

#### 유형 C — 변리사·비전공

| # | 질문 | 답변 골자 |
|---|---|---|
| **Q19** | "선행연구와 무엇이 다릅니까?" *(신규성)* | 그 논문은 몸을 **막대 하나**로 보고 균형 토크의 출처를 **팔이나 장대**로 두었습니다. **한국 광대에게는 장대가 없습니다.** 그리고 "제어기로 잡을 수 있다"까지만 보였고 **어떤 물리 과정으로 회복되는지**는 답하지 않았습니다. 저희는 **허리 관절을 넣은 2체 모델**을 새로 제안하고, 그 공백에 **닫힌 공식**으로 답했습니다. |
| **Q16** | "어디까지 직접 했습니까?" *(노력도)* | 이론·시뮬레이터·CAD·제작·펌웨어·실험 전부입니다. **전물리 시뮬레이터를 직접 만들었고**, 그것이 정해 준 설계 조건으로 로봇을 설계해 출력하고 조립했습니다. → **탐구일지 반전 목록을 편다** |
| **Q17** | "어디에 쓸 수 있습니까?" *(실용성)* | ① **저구동 균형** — 구동기를 최소로 줄여야 하는 재난·탐사 로봇. ② **교육** — 모드·혼돈·되먹임을 눈으로 보여 주는 교보재. ③ **전통 기예의 과학적 가설화**라는 접근 자체 — 널뛰기·그네로 확장 가능. |
| **Q1** | "얼마나 오래 섭니까?" | 【 】초까지 확인했습니다. 그리고 **한 판이 아니라 분포로** 봅니다 — 위험도가 0.1초마다 두 배가 되는 계라 시작 조건이 조금만 달라도 갈립니다. 【판수·중앙값·최장】 |
| **Q11** | "실제 광대도 이렇게 잡습니까?" | **모릅니다 — 그 점을 보고서에 명시했습니다.** 물리에서 유도된 가설이고, 광대 동작 측정으로 검증할 후속 과제로 남겼습니다. 다만 **"장대 없이 처진 줄 위에서 균형을 잡는, 물리적으로 가능하고 완결된 방법이 존재한다"**는 건 이제 사실입니다. |
| **Q12** | "AI를 썼습니까?" | **네, 처음부터 연구 조수로 썼고 역할 분담을 저희가 설계했습니다.** 질문·가설·기각·판단은 저희 몫이었습니다. AI가 준 것은 단 하나도 검증 없이 쓰지 않았습니다. |

---

## 8. 화면 운용 — mp4는 만들지 않는다

### 8-1. 완성 영상(mp4)이 필요 없어졌다

과정 설명을 뺐으므로 **연속 재생될 3분짜리 완성 영상이 필요 없다.**
문서 47의 작업 목록에서 아래가 통째로 빠진다 — 제작 난이도 1·2위가 사라진다.

- `render.mjs` (Playwright 프레임 캡처 → ffmpeg) · 4K 본렌더
- `scenario.json`의 프레임 단위 타이밍
- 씬 간 부드러운 전환 연출 (문서 47 §5가 "어려운 전환 2개"로 꼽은 S3·S6)

### 8-2. 대신 앱이 질의응답 도구로 승격된다

**면담에서는 재생되는 것보다 조작되는 것이 낫다.**
말이 늦어지면 영상은 안 기다려 주지만 앱은 기다리고, 심사위원이 끼어들어도 멈출 수 있으며,
질의로 넘어갈 때 도구가 이미 손에 있다.

- **3분:** 씬을 손으로 넘기며 말한다(슬라이드처럼). `[]` 씬 이동 · `Space` 정지
- **10분:** `4` 로 좌표 씬(38s) 열기 · `V` 자유 시점 · 슬로우모션으로 접기 순간 확대
- **필요한 변경:** `SCENES` 배열을 **3단계 순서**로 재배열하고 각 씬을 정지점으로. 타이밍 데이터는 버려도 된다

### 8-3. 실제로 필요한 시각 자산 — 아홉 개

| 단계 | 자산 | 상태 |
|---|---|---|
| 1-a | 실사 줄타기 (장대 vs 부채) | 영상 확보 + 라이선스 |
| 1-c | 논문 표지 | 쉬움 |
| 2-a | R 추출·축소 | **앱 씬② 있음** |
| 2-b | **1체 → 2체 애니메이션 5초** | ★신규 |
| 2-c | 후보 소거 3컷 | ★신규 (손그림) |
| 2-d | 상태공간 평면 + 직선 두 개 | **앱 씬③⑥ 있음** |
| 2-e | **낙차 카드** | ★신규 |
| 3-a·b | 시뮬레이터 화면 · 증분 접기 수렴 | **앱 씬⑦ 있음** |
| 3-c | 세 실측 카드 3장 | ★신규 (텍스트) |

**신규 넷 중 공들일 것은 낙차 카드와 1체→2체 둘뿐.** 나머지는 손그림과 텍스트다.
앱에 이미 있는 것은 **연출을 걷어내고 정지 상태로 띄우면** 된다.

### 8-4. 시각 규약 통일 — 별도 과제 【학생 회의 안건】

만든 사람과 시기가 달라 색감·부호 관례·로봇 모양이 화면마다 다르다.
**같은 내용을 보여 주는 화면인데 로봇 모양이 다르면 심사위원이 헷갈린다.**

**우선순위: 부호 > 로봇 모양 > 색.**
색·모양은 "다르네"지만 **부호는 "틀렸네"가 된다.** 전공 심사위원이 즉시 잡아낸다.
(AGENTS.md §9에 "MuJoCo φ 부호 반전(−Rφ), 엔코더↔δ 부호 펌웨어 불일치(미해결)"이 그대로 남아 있다.)

**순서: 규약 카드 한 장을 먼저 못 박고, 그다음 화면을 고친다.** 화면부터 고치면 또 갈린다.

**이미 절반은 되어 있다** — 문서 48의 presentation 앱이 `model_v19.py`를 하드코딩 없이 JS로 이식해
v19_state 평면 상수와 4자리까지 일치시켜 놓았다. **앱 안에서는 일관성이 보장된다.**
남은 문제는 질의응답에서 **앱 밖 화면**(v19_state, v20_pred_plane, 전시 체험용 시뮬)을 열 때다.

**규약 카드에 들어갈 항목**

- **부호**: φ, α, θ, β, δ의 + 방향(화면 기준 좌/우) · MuJoCo ↔ 해석모델 ↔ 펌웨어 대응표
- **색**: 각도 5색 / 구간 3색 / 평면 요소(안정선·등고선·예측점·트리거 띠)
  ⚠ **현재 충돌 1건** — 문서 47에서 **파랑**이 "줄 흔들림 φ"와 "대기 구간" 두 뜻으로 쓰인다.
  예측점 평면에서 φ가 세로축인데 그 위 궤적의 대기 구간도 파랑이면 겹친다
- **기하**: 로봇 비율 · 줄 V자 표현 · 카메라 기본 시점
- **평면**: 축 배치(β 가로 / φ 세로 고정) · 눈금 · 원점 표기
- **적용 대상**: 발표 앱 / v19_state / v20_pred_plane / **낙차 카드 / 1체→2체(신규도 반드시 따를 것)** / 보고서 그림

---

## 9. 실무 체크리스트 (면담 9/15, D-30)

| # | 항목 |
|---|---|
| ⓞ | **시각 규약 카드 한 장 확정** (§8-4) — 학생 회의에서. **이게 먼저여야 ①②가 두 번 일 안 된다** |
| ① | **낙차 카드 제작** — 이 발표의 심장. 규약 확정 직후 |
| ② | **1체→2체 애니메이션 5초** — 2-b의 유일한 시각 자산 |
| ③ | **새 프레임 + 증분 접기 → 균형 확보** 【이번 주】 |
| ④ | **전시대 시연 리허설** — 하부 프레임 없는 조건. 안전 그물/받침 결정, "손" 훈련 |
| ⑤ | **역할 분담 확정** (말하는 사람 / 화면 / 손) + 셋이 나눠 답하는 연습 |
| ⑥ | **탐구일지 「반전 목록」 한 장** 작성 (§7-2) |
| ⑦ | 3분 대본 낭독 — 2-b 22초, 2-c 18초가 가장 넘치기 쉽다. **2-e의 침묵 3초 포함해 재기** |
| ⑧ | 【 】 채우기 — 생존 시간·판수·중앙값 |
| ⑨ | 질의응답 카드 인쇄 + 유형별 주답자 지정 |
| ⑩ | 1차 서면심사(8/26~9/4) 작품설명서 30쪽·요약서 1매 — **3단계 구조와 용어·그림 통일** |
| ⑪ | 실사 줄타기 영상 라이선스 |
| ⑫ | 폰트 고정 (Malgun Gothic 의존 제거) |

---

## 10. 성공 판정

심사위원 입에서 아래 중 **하나라도** 나오면 성공이다.

- "이게 해석적으로 풀립니까?"
- "그 두 직선이 어떻게 나온 겁니까?"
- "차원을 어떻게 줄인 거죠?"
- "장대 쓰는 거랑 근본적으로 다른 거네요"

**질문이 나오면 이긴 것이다. 3분은 그 질문을 만들기 위해 존재한다.**
