cbshbalance/slackline-balacing1/docs/50_실기스타트_놓기프로토콜_v1_20260817.md

# 50. 실기 스타트 — 놓기 프로토콜 v1 (2026-08-17)

> 새 프레임 + 증분 접기 첫 주행 주간용. 로봇을 줄 위에서 출발시키는 표준 절차.
> 근거: 문서 46(실측 세 개·트리거·γ·펌웨어 방침) · 44(놓기 게이트·영점) · 40(회복 천장) · 16(줄 마찰) · 26(캡).

---

## 0. 문제의 재정의 — 0을 노리는 게 아니다

증분 접기는 매 사이클 다시 재서 다시 잡는 제어기다. 놓기의 요구조건은 완벽한 A=0이 아니라
**회복 천장 아래로 들어오는 것**이다.

| 구간 | \|Â\| | 그때 첫 접기 | 비고 |
|---|---|---|---|
| **목표** | ≤ 0.5° | ~5.7° | 선형영역 맨 윗줄(문서 46 g표), 가장 깨끗 |
| **허용** | ≤ 1.5° | ~14° | 캡 22° 아래, 오차창 ±37% 안 |
| **절벽** | ~3° | — | 회복 천장(문서 40: 현 설정 2.8°, 모터 풀사용 4.0°) — 어떤 접기로도 못 잡음 |

### 놓기 오차의 환율 (w = [0.61, 1, 0.103, 0.169], 실측정본)

| 놓기 오차 | A 기여 |
|---|---|
| 몸 기울기 β 1° | **1.00°** |
| 줄 각 φ 1° | 0.61° |
| 몸 각속도 β̇ 1°/s | 0.17° |
| 줄 각속도 φ̇ 1°/s | 0.10° |

**속도는 1/λ로 할인된다 — 각도 1° = 각속도 6°/s.** 손을 떼며 생기는 잔류 속도 1~2°/s는 A로 0.2~0.3°.
걱정의 순서: **① 영점 ② 각도 ③ 속도.**

⚠ 영점이 1순위인 이유: 줄 건마찰 데드밴드 0.34°(문서 16) 때문에 **"손 떼고 멈춘 자리"는 영점이 아니다**(문서 44).
눈대중 수직으로 놓으면 그 오염이 그대로 A에 들어간다.

---

## 1. 사전 준비 (세션당 1회)

| # | 항목 | 방법 |
|---|---|---|
| Z1 | **부호 확인** | 오른쪽으로 기울이면 φ·α·θ 전부 + / δ 명령 방향 / MOTOR_DIR (문서 44 실험3 S1~S3 축약판) |
| Z2 | **영점** | **자동트림(GO 순간 자세 기준)은 쓰지 않는다** — 문서 46 §8이 폐기 판정(측정 오프셋과 진짜 기울어짐을 구별 못함). 최소절차 = **좌우 양방향에서 접근해 멎은 두 자리의 중간**(데드밴드 상쇄). 정식절차 = **실측②의 절편**(여러 φ에서 흔들리는 β를 찾아 직선 적합 — 이 절편이 A 오프셋의 정본) |

---

## 2. 판당 절차 (목표 30초)

| # | 동작 | 왜 |
|---|---|---|
| 1 | **δ 확인 — 0일 필요는 없다.** 크게 접혀 있으면(\|δ\| > 15°, 특히 낙하 후 레일에서 받은 직후) 0 근처로 복귀 후 시작 (전원·토크온 상태로 줄에 올림) | **접힌 자세도 β·φ만 조용하면 평형이다** — 서보가 δ를 잡는 한, 발목 자유회전의 평형 조건은 "몸 CoM이 발 위" 하나뿐이고 δ 값과 무관. 0 근처를 권하는 건 평형이 아니라 ① **접기 여유**(캡 40°까지의 거리 대칭 — 레일에서 그대로 재시작하면 한쪽 여유 0) ② **저속 복귀 일감**(접힌 채 시작하면 배경 복귀가 초반에 돌며 불안정 성분을 주입 — 6°/s 상한 규칙) |
| 2 | **잡은 채 GO** — 제어를 먼저 살린다 | 놓고 나서 켜면 죽은 시간에 A가 e^{λt}로 큰다 (117 ms마다 2배). 손이 문턱(0.6°) 아래로 잡고 있는 한 **모터는 침묵한다** |
| 3 | 위쪽 한 점을 가볍게 잡고 **1초 정지** (문서 44 게이트) | **모터가 움찔하면 = 문턱을 넘었다는 신호** — 그 자체가 피드백. 움찔했으면 δ=0 재명령 → 줄이 멎게 **~2초 대기**(건마찰 0.34°/반주기가 잔진동을 먹음) → 재시도 |
| 4 | **로봇의 놓기 신호를 기다린다** (§3의 release cue) | 놓기 품질을 사람 눈이 아니라 **추정기가 판정** — 트리거를 판정하는 바로 그 숫자다 |
| 5 | **줄 축(y) 방향으로 미끄러뜨리며 뗀다** | 스윙 평면 밖으로 빠지는 접촉은 평면 안에 충격을 못 준다. 놓은 뒤 A가 0.3→0.6°까지 자라는 **~120 ms가 자연 유예** — 그 사이 손을 치운다 |

**실패 루프:** FALL 컷 → 손/받침으로 받음 → δ=0 복귀 → 2번으로. 연습장은 하부 프레임 있는 구성으로.

> ⚠ **문서 46 §9의 "접힌 자세 금지"를 여기에 규칙으로 옮기지 말 것 (2026-08-17 정정).**
> 그 경고는 시뮬에서 **몸(α)을 안 옮기고 δ만 던져 넣은 설정 실패**에 대한 것이다 —
> α를 매달림 평형으로 안 맞추면 β = P2R·δ가 딸려 들어온다 (δ=15°만 돼도 β 6.2°, 문서 46이 본 "A⁻ 5~9°"가 정확히 이것).
> 원문도 "설정 실패지 물리적 발견이 아니다"라고 적었다.
> **접힌 자세 + CoM 발 위 = 평형**이며, β̂의 접힘 비선형 오차도 δ=30°에서 ~0.06°(소각 세제곱)라
> **놓기 신호는 접힌 자세에서도 그대로 유효**하다.

### 놓기 기하 팁

- **잡는 위치 = 상체 꼭대기.** 발목에서 ~65 cm → **0.3°가 3.4 mm.** 맨손 허공이 아니라
  **팔꿈치·손목을 프레임에 괴면** 떨림이 한 자릿수 준다.
- **집는 면 = 몸통의 앞·뒤(줄 축 방향 양면).** 손가락 마찰도 법선력도 전부 평면 밖 →
  1차 근사에서 평면 내 충격 0.

---

## 3. 펌웨어 추가 1건 — 놓기 신호 (release cue)

```
|Â| < CUE_TH (0.3°) 가 CUE_MS (500 ms) 연속 유지 → 부저 짧게 / LED 점등. 벗어나면 해제.
```

- **GO는 트림을 잡지 않는다** (자동트림 폐기 — 문서 46 §8). 영점은 Z2에서 온다.
- 릴리즈 순간 Â를 로그에 남길 것. **A는 control_step 이전 값** (문서 46 §9).
- 같은 신호를 **실측 ②·③의 놓기 게이트로 겸용** — 별도 구현 불필요.
- ⚠ 정지 상태의 Â는 항상 깨끗하므로 이 신호가 **잡음 바닥 검증을 대신하지 못한다** (문서 46 §5 — 그건 가진 상태 로그로).

---

## 4. 발사대는? — 데이터로 정한다

**판정 절차:** 연습 세션에서 **20회 놓고 릴리즈 순간 Â 분포**를 뽑는다 (실측②③과 같은 로그라 공짜).

| 결과 | 판정 |
|---|---|
| 중앙값 ≤ 0.5° **그리고** 90% ≤ 1.5° | **손 + 놓기 신호로 충분.** 발사대 불필요 |
| 미달 | 1단계 대안 → **실 릴리즈** (아래) |
| 실 릴리즈도 미달 | 그때 강체 발사대 검토 |

**실 릴리즈 (0원짜리 발사대):** 프레임에서 실 한 가닥을 내려 로봇 머리에 걸고,
**일부러 실 쪽으로 살짝 기대게** 세운 뒤(실은 당길 수만 있으므로) 가위로 끊는다.
- 끊는 순간 충격 0. 물리실험실 고전 기법.
- **"정확히 0"이 아니라 "아는 작은 각"에서 시작** — 재현성은 오히려 더 좋다.
- 실측 ②③의 초기조건 부여 장치로도 그대로 쓸 수 있다.

**강체 발사대(로켓 스타일)가 최후 수단인 이유:**
접촉 해제 순간의 기구 접촉이 정확히 우리가 피하려는 충격원이고(손가락보다 지저분할 수 있음),
제작 시간이 들며, 전시대(120×90 cm) 자리를 차지한다.

---

## 5. δ₀(유지각) 의존성의 정체 — 가설 (2026-08-17, 검증 대상)

문서 46 §1이 미해결로 남긴 δ₀ 의존성을 채널별로 분해하면:

| 채널 | 물리 | 크기 (δ₀=15° / 30°) |
|---|---|---|
| h → λ → G | 접히면 CoM이 낮아져 λ가 살짝 커짐 | ~1% / ~2% — 조연 |
| **킥 커플링 cos δ** | 2링크 관성 커플링 m₂L₁ℓ₂**cos δ** — 접힌 자세에서 킥의 모멘트암이 깎임 | **−3% / −13% — 주범 후보** |
| 서보 정적 부하 | 유지각에서 힙이 중력토크(~0.2 N·m)를 지고 있어 접기/펴기 가속 비대칭 | 액추에이터 효과, γ에 흡수 |

**검산:** 순간 효력 ∝ cos δ이면 Δδ 스윕(0→Δ)의 평균은 sinΔ/Δ.
문서 46 실측과 대조 — Δ=55°: 예측 85.3% vs 실측 **84%** / 40°: 92.1% vs 90% (꼬리 일치).
12~22° 중간 구간은 cos만으로 부족 — 프로파일 포화(속도 상한 체류) 후보.

**함의:** Δδ 비선형(기측정)과 δ₀ 의존성(미측정)은 **같은 곡선의 적분과 미분**일 가능성.
맞다면 g(δ₀) ≈ g₀·cos δ₀가 공짜 예측이 되고, 문서 44 실험 4의 탐침 주입을
δ₀별로 돌리는 것(폐루프 안착 → 주입, 안착은 본 프로토콜이 지원)이 "측정"이 아니라 **"예측 검증"**이 된다.

**실용 결론:** 정상 운전(유지각 <10°)에서는 전 채널 합쳐 몇 % — γ 하나 결론 불변.
조심할 상황은 δ가 20~30°로 표류한 뒤 큰 외란이 올 때뿐(킥 효력 10%+ 깎인 상태).

---

## 6. 겸사겸사

- **이 절차 연습 = 실측②(안정모드선) 연습과 같은 동작이다.** 스타트 훈련이 곧 실험 훈련.
- 시연 서사로 승격 가능: **"로봇이 준비됐다고 알려줍니다" → (삑) → 놓기.** 절차 자체가 관객 순간이 된다.
- 첫 주행 주간의 판별 순서 제안: Z1·Z2 → 놓기 20회 분포 → (분포 합격 시) 증분 접기 본시험.
