cbshbalance/slackline-balacing1/docs/51_발표흐름_3분대본_v1_20260817.md

# 51. 발표 흐름 · 3분 대본 v1 — 걸어온 길 요약과 감탄·감동 최적화 (2026-08-17)

> **[8/19 사본 주의] 대본·씬 순서는 미확정 — 학생·AI 토의로 계속 수정 중 (사용자 확인 8/18). 참고 초안으로만 쓸 것.**

> **정본 관계**: 문서 49(발표 서사축 3단계 확정)가 서사의 정본이다. 이 문서는 그 정본을 ① 연구 전체 여정 요약, ② 문서 제목으로 읽는 유의미 포인트, ③ **낭독 가능한 3분 대본 완성본**, ④ 반전 목록 채움으로 실행 가능하게 만든 파생본이다.
> **내부 문서 주의**: "아직 안 됐다 / 미해결" 류 서술은 이 문서(내부)에만 있다. 발표 자료·화면에는 옮기지 않는다(문서 49 서술 방침 2). 【 】는 실기 후 채울 자리다.

---

## 0. 다시 못 박는 목표

제72회 전국과학전람회 **물리 부문**(출품번호 1167, 학생부). 제목은 "**한국 줄타기는 어떻게 장대 없이 균형을 잡는가? — 처진 줄 진자 위 이중 역진자가 허리 접기 하나로 서는 원리의 규명과 로봇 실증**". 1차 서면심사 8/26~9/4, **2차 면담심사 9/15 — 발표 3분 + 질의응답 10분**, 심사위원 3인(물리·공학·변리사), 배점 70 = 창의·탐구 **30** / 이론 15 / 노력 **15** / 실용 10.

목표 반응은 **이해 → 공감 → 감탄 → 감동**이고, 시간 구조상 역할이 갈린다.

- **3분은 설명이 아니라 낙차를 세우는 시간이다.** 이해와 공감을 3분 안에 끝내고, 감탄의 씨앗(낙차 카드)을 심고 멈춘다.
- **감탄과 감동의 본편은 10분에서 심사위원이 스스로 만든다.** 남이 설명해 준 답은 "그렇군"이고, 자기가 캐물어 얻은 답은 "이야"다(문서 49). 질문이 나오면 이긴 것이다.
- 성공 판정: "이게 해석적으로 풀립니까?" / "그 두 직선이 어떻게 나옵니까?" / "차원을 어떻게 줄인 거죠?" / "장대 쓰는 거랑 근본적으로 다르네요" 중 **하나라도** 나오면 성공.

---

# 1부 — 우리가 실제로 걸어온 길 (2026. 2.~8.)

발표에서 다 말할 수 없는 전체 여정이다. 질의응답에서 "어디까지 직접 했습니까 / 가장 어려웠던 게 뭡니까"가 나올 때 이 지도에서 꺼내 쓴다.

### 1장. 질문 (2~4월) — "떨어져야 하는데, 떨어지지 않는다"

한국 전통 줄타기 영상에서 시작했다. 서양 줄타기는 긴 장대(빌려온 평형추)로 균형을 잡는데, 한국 광대는 부채 하나뿐이고 줄은 일부러 느슨하다. 마찰 없는 얼음판 사고실험을 대입하자 사태가 심각해졌다 — 몸속 힘(내력)으로는 무게중심을 1mm도 못 옮기므로 한 번 기울면 떨어져야 한다. 그런데 광대는 수백 년째 떨어지지 않는다. **"불가능해 보이는 일이 실제로 일어나고 있다면, 그 안에 우리가 모르는 물리가 있다."** 문헌을 뒤졌지만 찾은 것은 답이 아니라 공백이었다 — 유일한 선행연구(Paoletti & Mahadevan 2012, 왕립학회지)조차 복원 토크를 팔·장대라는 외부 입력으로 두었고, "제어기로 잡을 수 있다"까지만 보였다. 초기 시뮬 v1(선행연구 재현)에서 이 한계를 직접 확인했고, 그것이 허리 관절을 단 2체 모델(v2)로 넘어간 계기가 됐다.

### 2장. 가설 (5월) — "줄은 받침이 아니라 변환기다" (`슬랙라인_균형제어_가설설정` 연작, `FWE_메커니즘_정교화`, `메인식_일반화`)

역발상: 출렁이는 줄이 방해가 아니라 자원이라면? 처진 줄은 발의 위치를 무게중심을 되돌리는 복원력으로 바꿔 주는 **변환기**였고, 무게중심의 수평 운동방정식이 한 줄로 떨어졌다(x_CoM = Rφ + hβ — "이 한 줄이 연구 전체의 뼈대"). 몸을 세우는 대신 발을 무게중심 **너머로** 던져 쓰러짐 방향을 뒤집는 **FWE(접기-기다리기-펴기) 메커니즘**을 제안했다.

### 3장. 이론 (6월) — 모드, ε\*, 일반화 (`모드분석_LQR게인구조`, `FWE_WaitPhase_모드분석_eps_star`, `FWE_일반화_eps_star_gen`, `형상최적화`)

"얼마나 접나"에 답하려면 "어디로 가야 하나(균형이 뭔가)"가 먼저였다. 후보 소거의 정성적 추론 끝에 도달한 상태가 알고 보니 동역학의 **안정 모드**였다. 상태공간에서 안정 모드는 직선 하나가 되고, 접기는 무게중심 등고선이라는 다른 직선을 따라서만 움직이므로, 필요한 접기량은 **두 직선의 교점** — 1차방정식 두 개로 닫힌형 **ε\* = −h/(rR+h)** 가 나왔다. 초기 기울기 β₀가 약분되어 사라지는 것(기운 크기와 무관)이 최대의 발견. MuJoCo 독립 검증으로 R≥0.6m 전 구간 오차 ±2%, R=0.3m에서 소각 근사가 깨지며 10% — 공식이 자기 유효범위를 스스로 알려줬다.

### 4장. 완결과 제작 (7월) — 예측점 평면, 어름이, 제목 (`예측점평면_FWE_상태공간_시나리오`, `08_시뮬레이션_전해설`, `09_수명분포_위치모드_노브하나`, `10_제목_결정`, `11_보고서_초안`, `16_예측점평면_인터랙티브시뮬`)

정지 상태의 ε\*를 움직이는 상태로 확장하며 속도를 위치로 환산해 더한 **예측점 평면**을 만들었다 — 4차원 상태 → 2차원 예측점 → 위험도 숫자 하나(A)로 줄이는 **차원축소**. 완전 FWE 사이클(과접기→대기→펴기)을 닫힌형으로 완성했고, 수명 분포·노브 하나(공선성) 같은 물리학자용 결과들이 쌓였다. 7/19 출품 부문(물리)과 제목을 확정, CAD·3D프린팅으로 로봇 **'어름이'**(하체 25.9cm + 상체 40cm, 허리 서보 하나, R=43.3cm)를 제작했다.

### 5장. 실측 주간 (7월말~8/1) — 실물이 이론을 고쳐 쓰다 (`23_M2_측정경과_진동발견`, `27_S1결과_실측줄마찰_생존재검`, `28_Sbc결과_펴기생략_신챔피언`, `29_펴기생략_검증과_해석정정`, `32_실물지저분함_흡수시험`)

질량·무게중심·관성모멘트·줄 마찰을 전부 실측해 되먹였다. 측정 중 결합부 탄성 진동을 발견했고(23), **실측 줄 마찰이 가정의 약 1/24**이라는 사실에 완전 사이클 계열의 성적이 반토막 났다(27). 그런데 해법은 가장 처음의 이론 각주에 있었다 — "정확히 접으면 펴지 않아도 유계". 펴기를 버린 **증분 접기**가 신챔피언이 됐고(28·29), 사이클이 절반으로 줄며 오차 허용폭이 ±6% → **±37%**로 여섯 배 넓어졌다. 실측 마찰 조건에서 20개 초기조건 전부 생존 상한 120초 도달, 이후 27,000초+ 균형 확인. 8/1 하루에 문서 25~33이 쏟아진, 연구 최대의 반전일.

### 6장. 브링업 (8/5~8/7) — "토크는 남고 속도가 병목" (`38_실험2_결과_람다u`, `39_FWE_실기브링업_1일차`, `40_토크속도수지_재계산`)

실물 로봇을 줄에 올렸다. 발산율 λ 실측(배가시간 ~0.1초), 토크·속도 수지 재계산으로 "더 센 모터는 소용없고 회복 천장을 정하는 건 속도"임을 확인. 최종 제어기가 바뀌었으므로 제목에서 "(접고-기다리고-펴기)"를 삭제(8/7) — **정확성이 구호보다 우선**.

### 7장. 지도와 자기 정정 (8/10~8/13) — 자기 오류를 스스로 잡다 (`41_최적접기지도_닫힌형`, `42_v20_시뮬신설과_이론정정`, `43_정정발견_4건`)

제어법칙 자체를 평면 위 지도로 그렸다 — 최적 접기는 예측점의 **1차식**(δ_f\* = c_β·β_pred + c_φ·φ_pred), 등고선은 안정모드선과 나란한 평행선. 8/12 작품설명서 제출. 같은 날 v20 시뮬을 새로 만들다 **우리 자신의 오류 4건**을 찾아 정정했다 — 특히 "이론 γ 28.9 vs 실측 18.6" 갭의 약 3/4이 장부(정의 구간) 오류였다는 발견은, 검증 시스템이 자기 자신에게도 작동한다는 증거.

### 8장. 수렴 (8/15~17) — 실측 세 개, 노브 하나, 놓기 프로토콜 (`45(철회)`, `46_실측_세개`, `47`·`48_발표앱`, `49_서사축_확정`, `50_놓기프로토콜`)

잘못된 조건(잡종 파이프라인)에서 나온 결론을 하루 만에 스스로 철회하고(45→46), 최종 원리에 도달했다: **로봇을 세우는 데 필요한 실측은 세 개뿐** — 접으면 발목이 얼마나 도는지(P2R), 어디에 놓으면 흔들리기만 하는지(안정모드선), 얼마나 빨리 넘어지는지(λ). 저울도 자도 필요 없다. 나머지 어긋남은 노브 하나(γ, 작동 고원 3배 폭)가 흡수한다. 발표 통합 앱(48)과 3단계 서사(49)를 확정하고, 오늘(8/17) 줄 위 출발 표준 절차(놓기 프로토콜, 50)까지. **이번 주가 새 프레임 + 증분 접기 첫 주행 주간이다.**

---

# 2부 — 유의미한 포인트: 문서 제목으로 읽는 연구

발표·질의에서 무기가 되는 순서로 골랐다. (괄호는 심사 목표와의 연결)

1. **`가설설정` 연작 → "처진 줄은 받침이 아니라 변환기다"** — 연구 전체의 첫 열쇠. 얼음판(불가능 증명)과 처진 줄(가능 조건)의 차이 하나로 문제가 물리 문제가 된다. (이해)
2. **"허리의 발명" — 1체 모델의 한계에서 2체 모델로** — 선행연구에 없던 것을 만든 창의. 자유도를 **일부러** 늘려 문제를 어렵게 만들어야 힘이 몸 안에서 나온다는 역설. (창의성 30점)
3. **"균형의 재정의" — 완전 정지가 아니라 유계 진동** — 도달 불가능한 목표(불안정 정적 평형)를 좇는 대신 균형 개념 자체를 시스템에 맞게 다시 정의. 질문 사슬("얼마나?→어디로?→균형이 뭔데?")의 필수 고리. (탐구성)
4. **`모드발견서사` — "저희 추론이 멈춘 자리에, 물리학이 이미 이름을 붙여 둔 것이 서 있었다"** — 정성적 추론으로 안정 모드에 도달한 뒤 교과서에서 이름을 발견. 없던 걸 만든 것(허리)과 있던 걸 찾아낸 것(모드)의 대칭. (공감+탐구성)
5. **ε\* = −h/(rR+h) — 해석해, 그것도 1차방정식** — 수치해석·시뮬레이션 없이 직선 두 개의 교점으로 얻은 닫힌형. β₀ 소거(기운 크기와 무관 → 눈대중으로 탈 수 있다), 분모 rR+h=0이 유효범위를 스스로 고지. **감탄 포인트 ①②의 본체.** (감탄)
6. **`예측점평면` — 4차원을 점 하나로 (차원축소)** — 위치+속도를 한 점에 담아 균형 판정을 "직선까지의 거리 하나"로. 감탄 포인트 ③이자 실기 펌웨어에 실제로 들어간 수학. (감탄)
7. **`27→28→29` (8/1) — "실측 줄마찰, 생존 재검 → 펴기 생략 신챔피언 → 해석정정"** — 실물이 이론을 이기고, 버려둔 각주가 최종 제어기로 승격되는 연구 최대의 반전. 실패가 아니라 발전 서사의 절정. (감동+노력도)
8. **`10_제목_결정` — 괄호 "(접고-기다리고-펴기)"를 스스로 삭제** — 최종 제어기와 어긋난 구호를 제목에서 뺀 결정. 과학적 정직성이 제목에까지 미친다는 증거. (감동)
9. **`40` — "토크는 남고 속도가 병목"** — 수지 재계산으로 "더 센 모터"라는 직관적 처방을 기각. 공학 심사위원용 정량 근거. (이론 타당성)
10. **`42·43` — 자기 정정 4건, "갭의 3/4은 장부 오류였다"** — 남의 오류가 아니라 **자신의** 서사("이론 무죄, 범인은 실행")를 데이터로 수정. 반전 목록의 백미. (감동+노력도)
11. **`46` — "증분접기에 필요한 실측은 세 개뿐"** — 복잡한 이론의 최종 출력이 "저울도 자도 없이 세 가지 관찰 + 노브 하나"라는 단순성. 이론→실기의 다리이자 3분 대본 3-c의 본체. (감탄)
12. **`50` — 놓기 프로토콜, "로봇이 준비됐다고 알려줍니다"** — |Â|<0.3°가 0.5초 유지되면 삑— 하고 놓는 절차. 시연 자체를 관객 순간으로 만드는 장치. (시연 서사)

---

# 3부 — 발표 흐름: 왜 이 순서인가

문서 49의 3단계(181초 목표)를 그대로 따르되, 감정 곡선을 명시해 둔다.

| 구간 | 시간 | 하는 일 | 심사위원의 상태 |
|---|---|---|---|
| **1단계 — 왜 이게 문제인가** | ~40s | 역설 두 번 세우기(부채·얼음판) + 선행연구의 공백 | **이해** — "정말 안 될 것 같은데?" |
| **2단계 — 답 하나 (전반)** | ~55s | 역발상→허리의 발명→균형의 재정의, 전부 질문 사슬로 | **공감** — 학생의 추론을 따라 걷는다 |
| **2단계 — 답 하나 (후반)** | ~45s | 안정 모드와의 조우 → **낙차 카드** → 3초 침묵 → 동서양 회수 | **감탄의 씨앗** — "저게 1차방정식으로?" |
| **3단계 — 그리고 실제로 된다** | ~45s | 시뮬레이터→증분 접기→실측 세 개→"저 직선이 저 로봇 안에 있다" | **감동의 예고** — 식과 실물이 같은 것 |
| **질의 10분** | 600s | 묻는 대로 한 단계씩 연다(앱 씬④·⑥·⑦, 반전 목록) | **감탄·감동의 완성** — 자기가 캐물어 얻은 답 |

**설계 원칙 (문서 49 요약 + 보강)**

1. **압축은 버리기가 아니라 꿰기다.** 각 항목이 앞 항목이 낳은 질문의 답이면 청중은 단계를 세지 않는다. 화살표(그런데 무엇으로? → 그럼 얼마나? → 균형이 뭔데?)가 논리다.
2. **감탄 4종은 전공자 기준이다** — 해석해 / 1차방정식 / 차원축소 / 동서양 대비. 로봇이 서는 것 자체는 전공자에게 감탄이 아니라 **증거**다("저 단순한 식 한 줄만으로 이게 됩니다"로 프레이밍, "잘 돌아옵니다" 금지 — LQR이 더 잘 돌아온다).
3. **철학(동서양)은 우리가 먼저 말하지 않는다.** 2-f에서 물리적 사실만 정확히 말하면 심사위원이 스스로 그 해석에 도달한다. 우리가 말하면 유치해지고, 심사위원이 말하면 그의 발견이 된다.
4. **감동은 두 곳에서 온다.** ① 3-d의 실물 회수(수식과 로봇이 같은 것임을 눈으로), ② 질의 중 반전 목록(6부) — 스스로 오류를 찾아 고쳐 온 기록. 노력도 15점의 본체이면서, "정직한 연구"라는 감동의 근거.
5. **어름이는 발표 시작 전부터 이미 줄 위에서 균형을 잡고 있다**(전제). 설명 없이 먼저 눈에 들어오게 두는 것이 1-a의 재료다. 낙하 시 대응 멘트는 4부 끝에.

---

# 4부 — 3분 대본 v1 (낭독 완성본)

- 기준 속도 **초당 5자 안팎**(또박또박하되 준비된 속도). 본문 약 950자 + 침묵 3초 + 전환 여유 ≈ **3분 10초 내외**. 리허설 실측 후 넘치면 §4-2 압축 규칙을 위에서부터 적용 — 그러면 3분 정각 안으로 들어온다.
- 역할: **말** 【 】 / **화면** 【 】 (앱 씬 조작: `[` `]` 씬 이동, `Space` 정지) / **손** 【 】 (전시대 옆, 낙하 대비).
- 표기: (지시문) / — 는 반 박자 쉼 / ⏸는 완전한 침묵.

### 1단계 — 왜 이게 문제인가 (약 40초)

**[1-a | ~15s | 화면: 실사 줄타기(장대 vs 부채) | 어름이는 이미 줄 위에서 균형 중]**

> (어름이 쪽을 한 번 바라보고, 청중으로 시선을 돌린다)
> 지금, 저 로봇이 어떻게 서 있는 걸까요.
> 서양 줄타기는 긴 장대로 균형을 잡습니다. 한국 광대는 부채 하나뿐인데 — 부채에는 기운 몸을 세울 힘이 없습니다. 게다가 줄은, 일부러 느슨합니다.

**[1-b | ~12s | 화면: 얼음판 사고실험 컷]**

> 마찰 없는 얼음판 위에서는 몸속에서 무엇을 해도 무게중심을 옮길 수 없습니다. 한 번 기울면, 떨어져야 합니다.
> 그런데 광대는 — 수백 년째 떨어지지 않습니다.

**[1-c | ~13s | 화면: 논문 표지]**

> 이걸 다룬 논문은 딱 하나였습니다. 하버드 팀이 왕립학회지에 낸 연구인데, 여기도 균형을 장대와 팔의 몫으로 두었습니다. 그리고 — 어떤 물리 과정으로 되돌아오는지는, 답하지 않았습니다.

### 2단계 — 답 하나 (약 100초) ★여기가 전부

**[2-a | ~17s | 화면: 앱 씬② (R 하나만 남기기)]**

> 저희는 거꾸로 봤습니다. 출렁이는 줄이 방해가 아니라 — 자원이라면?
> 처진 줄 위에서는, 발이 옆으로 가면 줄이 몸 전체를 가운데로 끌어당깁니다. 무게중심을 못 옮기면, 발을 옮기면 됩니다. 그것도 무게중심 **너머로** — 반대로 쓰러지게.

**[2-b | ~24s | 화면: 1체→2체 애니메이션 5초, 대사와 겹쳐 재생]**

> 그럼 무엇으로 발을 옮기나 — 미는 힘도 없고, 버틸 발목 힘도 없는데요.
> 선행연구의 모델은 막대 하나였습니다. 허리가 없어요. 그래서 저희는 막대를 둘로 나누고, 사이에 관절을 넣었습니다. 허리입니다.
> (애니메이션을 가리키며) 허리를 접으면, 반작용으로 발이 밀려납니다.
> 일부러 문제를 더 어렵게 만든 겁니다 — 힘이 몸 안에서 나오도록.

**[2-c | ~19s | 화면: 후보 소거 3컷(손그림)]**

> 얼마나 접어야 하나. 그 전에 — 어디로 가야 하는지, 균형이 뭔지부터 정해야 했습니다. 광대는 멈춰 서 있지 않으니까요.
> 후보를 세우고 하나씩 지웠습니다. 마지막까지 남은 것이 — 줄과 몸이 일정한 비율로 엇갈려 흔들리며, 되돌아오는 상태였습니다.

**[2-d | ~18s | 화면: 앱 씬⑥ 정지 — 상태공간 평면, 초록 직선]**

> 나중에 알았습니다. 그 상태에는 이미 이름이 있었습니다 — 동역학의 '안정 모드'.
> 저희 추론이 멈춘 자리에, 물리학이 서 있었던 겁니다.
> 이 평면에서 안정 모드는 직선 하나가 됩니다. 그리고 접기는 — 또 다른 직선을 따라서만 움직입니다.

**[2-e | ~19s + ⏸3s | 화면: ★낙차 카드(왼쪽 3×3 벽 / 오른쪽 교점 그림과 ε\*)]**

> 그럼, 얼마나 접나? — 두 직선의 **교점**입니다.
> 저희가 실제로 푼 것은 1차방정식 두 개입니다. 수치해석도, 시뮬레이션도 쓰지 않았습니다.
> ⏸ (3초 — 카드만 보이게 둔다. 움직이지 않는다)
> 이 식에는 처음에 얼마나 기울었는지가 — 없습니다. 그래서 광대는, 눈대중으로 탈 수 있습니다.

**[2-f | ~13s | 화면: 낙차 카드 유지]**

> 서양의 장대는 힘으로 무게중심을 밀어 세웁니다.
> 저희가 찾은 한국 줄타기는 다릅니다 — **줄이 이미 하고 있는 흔들림 위에, 몸을 올려놓는 것**이었습니다.

### 3단계 — 그리고 실제로 된다 (약 55초)

**[3-a | ~13s | 화면: 앱 씬⑦ 전반 — 전물리 시뮬]**

> 여기까지는, 이상적인 세계의 답입니다. 실물에는 마찰과 줄 자체의 관성, 신호 지연이 있습니다. 그래서 그걸 전부 넣은 시뮬레이터를 — 직접 만들었습니다.

**[3-b | ~15s | 화면: 증분 접기 수렴 나선]**

> 돌려 보니, 메커니즘의 마지막 단계가 무너졌습니다. 살아남은 건 이론 각주에 적어 뒀던 성질 하나 — "정확히 접으면, 펴지 않아도 발산하지 않는다."
> 그것이 '증분 접기'라는 최종형이 됐습니다.

**[3-c | ~13s | 화면: 세 실측 카드 3장]**

> 이 로봇을 세우는 데 실제로 잰 것은 세 개입니다. 접으면 발목이 얼마나 도는지. 어디에 놓으면 흔들리기만 하는지. 얼마나 빨리 넘어지는지. — 저울도, 자도 쓰지 않았습니다.

**[3-d | ~15s | 화면: 예측점 평면 실시간 | 동작: 어름이를 가리킨다]**

> 화면의 저 직선이, 지금 저 로봇 안에 들어 있습니다. 로봇은 매 순간 저 직선에서 얼마나 벗어났는지를 재서 — 벗어난 만큼만 접습니다.
> 【실기 후 한 문장: 생존 기록/판수·중앙값】
> 장대는 필요 없었습니다. **허리 접기 하나면 됩니다.** 감사합니다.

### 4-2. 3분 정각 압축 규칙 (넘칠 때 위에서부터 뺀다)

1. 2-b 마지막 문장 "일부러 문제를 더 어렵게 만든 겁니다 — 힘이 몸 안에서 나오도록." (−7s, 질의 Q19·Q16에서 회수)
2. 2-a 끝 "그것도 무게중심 너머로 — 반대로 쓰러지게." → "그것도, 무게중심 너머로." (−3s)
3. 2-c "광대는 멈춰 서 있지 않으니까요." (−3s)
4. 1-c "그리고 —" 이하를 "어떻게 되돌아오는지는 답하지 않았습니다."로 축약 (−2s)
5. 3-a "실물에는 …" 문장을 "실물에는 마찰도, 지연도 있습니다."로 축약 (−3s)

⚠ **절대 빼지 않는 것**: 2-e 침묵 3초, 2-f 전체(회수), 3-d의 "저 직선이 로봇 안에" 문장, 마지막 두 문장(제목 회수).

### 4-3. 대본의 금지선 (문서 49 준수 확인)

- "저 식(ε\*)이 로봇에서 돌고 있다"라고 말하지 않는다 — 펌웨어에 도는 것은 증분 접기와 A 계산이다. **"저 직선이 로봇 안에 들어 있다"는 문자 그대로 사실**이므로 이 표현만 쓴다.
- 동양철학·동서양 문명 비교 어휘를 먼저 꺼내지 않는다. 2-f는 물리 사실만.
- "실제 광대도 이렇게 잡는다"고 단정하지 않는다(Q11 — 후속 검증 과제로 명시했다고 답함). 구전 지혜 일치 주장은 대본에서 금지.
- 복원 성능 자랑("잘 돌아옵니다") 금지 — "저 한 줄로 됩니다"로만.
- 발표 자료에 "아직/미완/불일치" 서술 금지(내부 문서에만).

### 4-4. 낙하 시 대응 (그대로 암기)

> "지금은 못 잡았네요. 버티는 시간이 **분포**라는 것 자체가 저희 결과 중 하나입니다 — 위험도가 0.1초마다 두 배가 되는 계라서, 시작 조건이 조금만 달라도 결과가 갈립니다. 한 번 더 해보겠습니다."

(변명이 아니라 결과로 회수된다. "손" 담당은 서사에 미리 넣는다 — **"광대 옆에도 사람이 섭니다."**)

### 4-5. 시연 순간 하나 더 (질의 중 재시연 요청 시 — 문서 50)

> "로봇이 스스로 판정합니다. 준비가 되면 — 알려줍니다." (삑 소리) → 줄 축 방향으로 미끄러뜨리며 놓는다.

놓기 프로토콜 자체가 관객 순간이 된다. 릴리즈 신호(|Â|<0.3°, 0.5초 유지)가 "추정기가 이미 돌고 있다"는 증거이기도 하다.

---

# 5부 — 질의응답 10분 운용 요지 (상세는 문서 49 §7)

- **원칙**: 3분이 세운 낙차가 질문을 부른다. 묻는 대로 **한 단계씩만** 연다. 길을 잃으면 낙차 카드 화면으로 복귀.
- **도구**: 앱 씬④(3×3에서 두 직선이 나오는 과정, 38초) / 씬⑥(예측점 평면 — "속도는 어디 갔나") / 씬⑦(실기판 δ_f\* = 6.144β+3.713φ — "이것도 1차식") / `V` 자유 시점 / 슬로우모션.
- **역할**: 질문마다 주답자 미리 지정(물리형→【 】, 공학형→【 】, 변리사형→【 】), 나머지가 보충. 셋이 나눠 답하는 연습 필수.
- **노력도 질문**("가장 어려웠던 것/시행착오")이 오면 말 대신 **반전 목록 한 장(6부)을 편다.** 심사위원이 훑는 30초가 노력도 15점을 말없이 전달하고, 그중 하나를 고르면 그게 다음 질문이 된다.
- **AI 질문(Q12)**은 감동 포인트로 승격 가능: "질문·가설·기각·판단·검증은 양도하지 않았다"(작품설명서 Ⅳ장의 역할 분담 기록을 근거로).

---

# 6부 — 반전 목록 채움 v1 (문서 49 §7-2의 【 】 채우기 — 열두 줄)

| # | 무엇을 믿었나 | 무엇이 틀렸나 | 무엇으로 바뀌었나 (근거 문서) |
|---|---|---|---|
| 1 | 선행연구 모델(막대 하나)로 설명되겠지 | 복원 토크가 팔·장대라는 외부 입력이었다 | 허리 관절을 단 2체 모델을 신설 (v1→v2, 작품설명서 Ⅱ-9) |
| 2 | PID면 잡히겠지 | 다단계 인과의 지연을 못 기다리고 발산 | LQR을 대조군으로 채택 — 그러나 '왜'를 설명 못해 FWE 제안으로 (v4) |
| 3 | 균형 = 완전히 멈춰 서는 것 | 그 점은 불안정 정적 평형 — 도달해 머물 수 없다 | "유계 진동이면 균형"으로 재정의 (보고서 Ⅱ-4) |
| 4 | 몸만 세우면(β=0) 된다 | 발이 가속 중이라 관성력이 몸을 기울인다 | 후보 소거 끝에 엇갈림 비율 → 안정 모드 도달 (Ⅱ-5) |
| 5 | 접기량은 허리각으로 말하면 된다 | 같은 허리각도 초기 기울기 따라 효과가 다르다 | 과접기 비율 ε 정의 → ε\* 닫힌형, β₀ 소거 (Ⅱ-6) |
| 6 | 위치만 보면 균형을 판정할 수 있다 | 같은 위치라도 속도에 따라 운명이 갈린다 | 예측점 평면 — 4차원→2차원→숫자 하나 (Ⅱ-7) |
| 7 | 정확히 소거한 뒤 펴면 된다 | 펴기가 지웠던 발산 성분을 되살린다 | 안정선을 지나쳐 접는 과접기→대기→펴기 완전 사이클 (Ⅱ-8) |
| 8 | 완전 사이클이 최종형이다 | 실측 줄 마찰(가정의 1/24)에서 성적이 반토막 | 각주의 성질("펴지 않아도 유계")이 승격 → 증분 접기, 오차창 ±6%→±37% (문서 27·28·29) |
| 9 | 제목의 "(접고-기다리고-펴기)"를 유지한다 | 최종 제어기와 이름이 어긋난다 | 괄호 삭제 — 정확성 우선 (문서 10, 8/7) |
| 10 | 균형이 안 되면 모터가 약한 탓 | 토크는 스톨의 18%만 쓰는 중 — 병목은 속도, 그마저 우리 설정이 먼저 막고 있었다 | 프로파일 재설정, 회복 천장을 속도로 재정의 (문서 40) |
| 11 | "이론 γ 28.9 vs 실측 18.6"은 실행 오차 탓 | 갭의 약 3/4이 우리 장부(측정 구간 정의) 오류 | v20 제작 중 스스로 발견·정정 — 이론↔실측 갭 축소 (문서 42·43) |
| 12 | 실기 스윙 원인은 늦은 트리거 (+ 자동 영점 트림이면 충분) | 시뮬 조건이 실기에 없는 '잡종'이었다 / 정적 관측으론 오프셋과 진짜 기울기를 못 가른다 | 결론을 하루 만에 철회하고 원인 미상으로 되돌림 / 트림 폐기 → 동적 실측②의 절편으로 (문서 45→46, 50) |

> 이 표의 용도: 인쇄 한 장. "시행착오가 있었습니까"에 펼친다. **12줄 전부가 '남의 오류'가 아니라 '우리가 우리를 고친 기록'이라는 점**이 노력도이자 감동이다.

---

# 7부 — 대본 관점의 남은 일 (D-29, 문서 49 체크리스트와 연동)

1. **【 】 채우기** — 이번 주 첫 주행(문서 50 프로토콜)에서 생존 기록·판수·중앙값 확보 → 3-d 한 문장과 Q1 답 완성.
2. **낙차 카드 제작**(발표의 심장)과 **1체→2체 애니 5초** — 시각 규약 카드(부호>모양>색) 확정 후.
3. **낭독 리허설** — 블록별 스톱워치 실측(기준 초당 5자). 넘치면 §4-2 순서로 압축. 2-e 침묵 3초를 반드시 포함해서 잰다.
4. 역할 3인 확정(말/화면/손) + 질의 주답자 지정 + 반전 목록 인쇄.
5. 1차 서면(8/26~) 작품설명서·요약서를 3단계 구조·용어와 통일.

---

*근거: 작품설명서(1167, 8/12 제출본) · 프로젝트 문서 10, 27~29, 38~50 · docs/줄타기_연구_서사_초안_20260707 · docs/부호규약_한장정리_20260805. 서사 정본은 문서 49.*
