cbshbalance/slackline-balacing1/docs/53_람다실측_배가시간_4회_20260817.md

# 53. λ 실측 — 놓기 4회의 배가시간 (2026-08-17)

> 원본 로그: `0817_p2r_r2_3.csv` (100 Hz CSV 모드, `t_ms,phi,ank,alpha,del_cmd,del_now`,
> 5,154행 / 479.4 ~ 630.0 s, `del_cmd = 0` 고정).
> 문서 46 「실측 ③ — λ(발산율)」의 결과. 예측은 **λ = 5.92 /s, T₂ = 117 ms**.

---

## 1. 결론

| 회차 | 로그 시각 | λ [1/s] | **배가시간 T₂** | 창 바꿔본 범위 | R² | 받힌 최대 φ |
|---|---:|---:|---:|---:|---:|---:|
| **1회** | 518.1 s | 6.39 ± 0.09 | **108 ms** | 103–122 | 0.996 | 13.8° |
| **2회** | 615.2 s | 5.01 ± 0.03 | **138 ms** | 136–140 | 0.999 | 11.7° |
| **3회** | 621.2 s | 5.36 ± 0.03 | **129 ms** | 126–132 | 0.999 | 17.6° |
| **4회** | 628.5 s | 5.33 ± 0.02 | **130 ms** | 130–135 | 1.000 | 15.8° |

**평균 T₂ = 127 ± 13 ms (λ = 5.52 ± 0.60 /s).**
예측(117 ms / 5.92)보다 **T₂ 8% 길고 λ 7% 낮다.**
산포가 큰 1회를 빼면 T₂ = 132 ms (λ = 5.23) — **예측 대비 +13%.**

모델 없이 읽는 배가사다리(φ 가 2배 되는 데 걸린 실제 시간)도 같은 답이다:

| 회차 | 1→2° | 2→4° | 4→8° | 8→16° |
|---|---:|---:|---:|---:|
| 1회 | 131 | 108 | 128 | — |
| 2회 | 136 | 141 | 139 | — |
| 3회 | 98 | 128 | 126 | (156) |
| 4회 | (183) | 133 | 129 | — |

괄호는 오염된 칸 — 아래쪽은 **놓기 과도**(손이 아직 영향), 위쪽은 **받힘 감속**.
가운데 `2→4→8°` 칸들만 보면 **126~141 ms** 로 모두 모인다.

---

## 2. 방법

- **관측 채널은 φ(줄각) 하나.** β(= α + P2R·δ)는 같은 창에서 진폭이 2~3° 뿐인데
  α 잡음이 ±0.5° 라 λ 추정이 3.4~9.8 로 흩어진다 — **쓸 수 없다.**
  A(불안정모드)도 β 를 포함하므로 마찬가지. 발산 중에는 φ·β·A 가 모두 같은 율로 커지므로
  **가장 크고 깨끗한 φ 로 재는 것이 맞다.**
- **적합 구간 = |φ| 진폭 밴드 2~8°** (상승부만). ln|φ| 대 t 직선적합, 기울기 = λ.
  아래 1° 미만은 손·건마찰 잔류, 위 10° 이상은 받힘 감속이라 둘 다 잘라낸다.
- **창 민감도**를 밴드 5종((1.5,6)(2,8)(1.5,8)(2,6)(3,9))으로 돌려 표의 '범위' 칸에 적었다.
- 로그 끊김(>100 ms)으로 구간을 나누면 4덩어리(41.6 / 4.2 / 2.6 / 3.1 s)이고,
  놓기 이벤트는 각 덩어리에 하나씩 = **정확히 4회**. |φ|>4° 인 다른 덩어리 2개는
  ① 508.4 s 의 완만한 왕복 스윙(지수발산 아님, 손 흔들림) ② 617.1 s 의 받힌 뒤 반동이라 제외.

---

## 3. 읽을 거리

### λ 가 예측보다 낮게 나온 것은 **좋은 쪽 오차**다
발산이 느리면 회복 여유가 커진다. 문서 50 의 환율표에서 속도항은 1/λ 로 할인되므로,
**"각도 1° = 각속도 6°/s" 가 실측으로는 5.4~5.5°/s** 로 조금 더 후하다.
트리거 문턱 0.6° 에서 자연 유예(0.3→0.6°) 도 117 → **~127 ms** 로 늘어난다.

### 1회만 산포가 크다
1회는 밴드에 따라 103~122 ms 로 흔들린다(2·3·4회는 ±3 ms). 38 s 를 잡고 있다가 놓은
회차라 놓기 과도가 길게 남았고, 국소 기울기가 λ ≈ 6.8 까지 올랐다 4.8 로 내려온다 —
**감쇠 진동 성분이 지수 위에 얹힌 모양.** 2·3·4회는 국소 기울기가 평탄한 고원을 만든다.
**대표값으로는 2·3·4회의 129~138 ms 를 쓰는 편이 안전하다.**

### 불안정 고유벡터 방향 (덤)
발산 중 dβ/dφ = **−0.28 ~ −0.43** (φ/β ≈ −2.4 ~ −3.5). 안정모드선 r = −1.6445 와는
다른 방향이 맞다(전자는 발산방향, 후자는 A=0 선). 회차별 산포가 커서 이 값으로
r 을 검증하기엔 부족 — **실측 ②는 별도로 필요하다.**

### 이 로그로 못 잰 것
- **A 오프셋(문서 46 §5, 실측 ②의 절편)** — 여러 φ 에서 놓아야 나온다.
- **Â 잡음 바닥** — 로그에 Â 열이 없다. 다음 로그에 Â(control_step 이전 값)를 같이 남길 것.

---

## 4. 조치

1. 정본 λ 를 **5.3 /s (T₂ 130 ms)** 로 잠정 채택하고 시뮬 파라미터와 대조 —
   예측 5.92 와 −10% 차이가 어디서 오는지(h, I₂_cm, 줄 마찰 c_φ) 확인.
2. 다음 놓기 세션에서 **Â 열 추가** + 여러 φ 에서 놓아 실측 ② 동시 수행 (문서 46 §4: 같은 로그로 된다).
3. 놓기 과도를 줄이려면 문서 50 의 **실 릴리즈**(가위로 끊기) — 1회 같은 오염이 사라진다.
