cbshbalance/slackline-balacing1/docs/54_A와Ahat_차분EMA_잡음바닥_20260817.md

# 54. A와 Â — 그 사이에 있는 것 (차분·EMA), 그리고 Â 잡음 바닥 실측 (2026-08-17)

> 문서 46 §5가 "재는 게 아니라 확인할 것"으로 남긴 **Â 잡음 바닥**을, 문서 53과 같은 로그
> (`0817_p2r_r2_3.csv`)로 실제로 쟀다. 결론부터: **지금 상태면 로봇은 가만히 있어도 접는다.**
> 원인의 92%는 발목 엔코더이고, 기계가 아니라 센서/배선 쪽이다.

---

## 0. 한 문단 요약

**A는 참 위험도, Â는 로봇이 믿는 위험도.** 식은 같고 넣는 상태가 다르다.
그 사이를 벌리는 것은 세 층 — ① 엔코더 잡음 ② 속도 파이프라인(25 ms 차분 + 28 ms EMA)
③ 영점 오프셋. 이 문서는 특히 ②가 무엇인지 설명하고, ①②의 크기를 오늘 로그로 잰다.

| 잰 것 | 값 |
|---|---|
| 파이프라인이 보는 속도 | 참값의 **0.80~0.82배** (18~20% 과소, 등가지연 38 ms) — 4회 모두 확인 |
| 그래서 Â/A | **≈ 0.90** → 문턱 0.6°는 실제로 **참 A 0.66°**에서 걸린다 (늦게 접는다) |
| Â 잡음 바닥 | **0.41~0.59° rms** — 문턱 0.6°와 **같은 자리** |
| 그 중 발목 기여 | **92%** |
| 발목을 φ 수준으로 고치면 | **0.10°** (문턱의 17%) |

---

## 1. A — 참 위험도

4차원 상태 `x = (φ, β, φ̇, β̇)`를 **숫자 하나**로 접은 것이다.

$$A \;=\; w\cdot x \;=\; w_q\!\cdot\! q + w_v\!\cdot\!\dot q,
\qquad w = (0.6043,\; 1,\; 0.1040,\; 0.1686)$$

w는 불안정 고유값 λ_u의 **좌고유벡터**다. 왜 하필 이것인가 — 이 방향으로 사영하면
나머지 모드가 전부 죽고 **e^{λt}로 자라는 성분의 계수만** 남기 때문이다.
다른 세 모드는 진동하거나 잦아들 뿐 넘어뜨리지 못한다. **A는 "넘어지는 쪽 성분"의 크기**이고,
단위는 β환산 도(°) — β가 1° 기울어진 것과 같은 위험이라는 뜻이다.

**환율** (문서 50): β 1° → 1.00° / φ 1° → 0.60° / β̇ 1°/s → 0.17° / φ̇ 1°/s → 0.10°.
속도는 대략 **1/λ로 할인**된다 — 각도 1°가 각속도 5.5°/s와 맞먹는다.

동등한 형태 하나 (문서 42·43) — **예측점**:

$$A \;=\; w_q^{\mathsf T}\Big[\, q + (\lambda I - \hat D)^{-1}\dot q \,\Big]$$

즉 A는 "지금 상태를 **속도만큼 앞으로 밀어 본 자리**"를 불안정 방향으로 읽은 값이다.
감쇠가 없으면 `q + q̇/λ`로 환원된다. **A = 0인 자리가 안정선(초록선)**이고,
거기 있으면 흔들리다 잦아든다.

## 2. Â — 로봇이 믿는 값

$$\hat A \;=\; w\cdot \hat x$$

**w는 똑같다. 다른 것은 x̂ — 센서로 만든 상태다.** 그리고 실기에 존재하는 건 Â뿐이다.
A는 시뮬에만 있다(추정기를 '참값'으로 두면 볼 수 있다).

**트리거는 |Â| ≥ 0.6°로 걸린다.** A가 아니다. 그래서 Â − A가 그대로 오작동이 된다.

---

## 3. 그 사이 — 차분과 EMA

φ와 α는 엔코더가 직접 준다. **속도는 아무도 안 준다.** 만들어야 한다.

### 3-1. 차분 (finite difference)

```c
dphi_raw = (phi - phi_hist[old_i]) / (5*dt);   // dt = 0.005 s → 기저 25 ms
```

두 시점의 각도 차를 시간으로 나눈다. 끝. 문제는 **얼마나 떨어진 두 점을 쓰느냐**이고,
여기에 피할 수 없는 맞바꿈이 있다.

| | 짧은 차분 (5 ms) | 긴 차분 (25 ms) |
|---|---|---|
| 잡음 | **σ√2/Δt 로 폭발** | 1/Δt 로 줄어듦 |
| 지연 | Δt/2 = 2.5 ms | Δt/2 = **12.5 ms** |

각도 잡음 σ가 같아도 **Δt로 나누기 때문에** 짧을수록 잡음이 커진다.
반대로 길게 잡으면 그 값은 **구간 중앙의 속도**라서 Δt/2만큼 과거를 말한다.

양자화(0.022°, σ = 0.0064°)만 있을 때의 φ̇ 잡음:

| 기저차분 | σ(φ̇) | 지연 |
|---:|---:|---:|
| 5 ms | 1.80 °/s | 2.5 ms |
| **25 ms (현행)** | **0.36 °/s** | **12.5 ms** |
| 50 ms | 0.18 °/s | 25 ms |

⚠ 이건 **양자화만** 있을 때다. 실제 센서 잡음은 이보다 크고, 그게 5절의 이야기다.

### 3-2. EMA (지수이동평균, exponential moving average)

```c
dphi = 0.85*dphi + 0.15*dphi_raw;              // a = 0.15, 200 Hz
```

새 값을 15%만 섞고 과거를 85% 유지한다. **이름은 거창하지만 1차 저역통과 필터**이고,
과거 값을 지수적으로 잊는다 — 그래서 '지수'이동평균이다.

| | 값 |
|---|---|
| **시정수** τ = dt(1−a)/a | 0.005 × 0.85/0.15 = **28.3 ms** |
| **잡음 감소** √(a/(2−a)) (백색 입력) | 0.285배 (−71%) |
| **대가** | 출력이 τ만큼 늦다 |

**왜 이동평균(N점 평균)이 아니라 EMA인가** — 메모리가 **하나**면 된다.
N점 이동평균은 N개를 들고 있어야 하고 링버퍼가 필요하다. 임베디드에서 한 줄로
같은 효과를 내는 것이 EMA다. 대신 차단 특성이 완만해서(−20 dB/dec) 고주파가 조금 샌다.

### 3-3. 셋은 한 묶음이다 (★문서 45의 교훈)

| 항목 | 값 |
|---|---|
| 제어주기 | **200 Hz** (dt = 5 ms) |
| 기저차분 | **25 ms** = 5샘플 |
| EMA | **a = 0.15**, τ ≈ 28 ms |

**따로 바꾸면 안 된다.** 500 Hz에 25 ms 차분만 얹으면 13스텝 차분이라는 **잡종**이 되고,
거기서만 나타나는 늦은트리거·과접기를 실기 현상으로 오인한다. 문서 45가 그 사고의 기록이다.

---

## 4. 대가의 계산 — 발산에 이 파이프라인을 걸면

넘어지는 중에는 모든 신호가 e^{λt}로 자란다. 지수함수에 대한 두 단계의 이득은 닫힌형으로 나온다.

$$G_{\text{차분}}=\frac{1-e^{-\lambda \Delta}}{\lambda\Delta},
\qquad G_{\text{EMA}}=\frac{a}{1-(1-a)e^{-\lambda\,dt}}$$

| λ | 차분 이득 | EMA 이득 | 합 | 과소 | 등가지연 |
|---:|---:|---:|---:|---:|---:|
| 5.30 (오늘 실측) | 0.937 | 0.871 | **0.816** | 18.4% | 38.4 ms |
| 5.813 (모델 정본) | 0.931 | 0.860 | **0.801** | 19.9% | 38.2 ms |
| 5.92 (문서 46 예측) | 0.930 | 0.858 | **0.798** | 20.2% | 38.2 ms |

**오늘 로그로 확인** — 발산 구간(|φ| 2~8°)에서 파이프라인 φ̇를 참값 λφ와 나눈 값:

| 회차 | 1회 | 2회 | 3회 | 4회 |
|---|---:|---:|---:|---:|
| 파이프라인 / 참값 | 0.786 | 0.817 | 0.827 | 0.806 |

**17~21% 과소 — 계산과 일치한다.** (로그가 100 Hz라 30 ms 차분으로 근사)

### 그래서 Â는 A보다 작다

불안정 모드 위에서는 q̇ = λq이므로 A의 두 항 비중이 계산된다
(실측 방향 β/φ ≈ −0.30 기준):

| | 위치항 | 속도항 |
|---|---:|---:|
| A에서 차지하는 몫 | 49~52% | **48~51%** |

**속도가 A의 절반이다.** 그 절반이 18~20% 깎이므로

$$\hat A / A \;\approx\; 0.90$$

**문턱 0.6°는 실제로는 참 A ≈ 0.66°에서 걸린다.** 약 10% 늦게 접는다.
문서 45가 200 Hz에서 관측한 값(판정시 |A참| 0.69° vs |Â| 0.59°, 비 0.855)과
**방향이 같고 크기도 같은 자리**다.

> 늦게 접는 것 자체는 치명적이지 않다 — 회복 천장이 2.8~4.0°이므로 0.66°는 한참 아래다.
> 다만 **γ(접기량 노브)를 실측으로 맞출 때 이 10%가 노브 안에 흡수되어 있다**는 점은
> 기억해 둘 것. 파이프라인을 바꾸면 γ도 다시 잡아야 한다.

---

## 5. ★ Â 잡음 바닥 — 문서 46 §5의 답

### 방법

손으로 잡고 있는 25초 구간(로그 3~28 s)에서, 100 ms 이동평균을 뺀 **고주파 성분만**
남긴다 (= 실제 움직임을 빼고 센서 잡음만). 거기에 실기 파이프라인을 걸고 w로 사영한다.

### 결과 — 발목이 φ보다 6.5배 시끄럽다

| 채널 | 고주파 rms | 양자화(0.0064°) 대비 |
|---|---:|---:|
| φ (줄) | 0.034° | 5.3배 |
| **발목 (ank)** | **0.223°** | **35배** |
| δ (서보 내장) | 0.038° | 6.1배 |

**Â 잡음 분해** (β환산 °, rms):

| 항 | 기여 | 비고 |
|---|---:|---|
| 위치항 · φ | 0.020 | w_φ = 0.604 |
| **위치항 · 발목(β)** | **0.225** | w_β = 1 — 발목이 그대로 들어온다 |
| 속도항 · φ̇ | 0.051 | |
| **속도항 · 발목(β̇)** | **0.539** | 잡음 0.225°가 차분으로 3.2°/s가 되고 ×0.169 |
| **합계** | **0.587** | 실기 200 Hz 기준 0.41~0.59° |

**문턱 0.6°와 같은 자리다.** rms가 0.59°면 |Â| > 0.6°인 표본이 30%쯤 된다 —
**가만히 있어도 접는다.** 문서 46 §5가 걱정한 바로 그 상황이다.

**발목을 φ 수준(0.034°)까지 내리면 Â 잡음은 0.10° — 문턱의 17%로 떨어진다.**

### 발목 잡음의 정체 — 기계가 아니라 센서다

| 확인 | 결과 | 함의 |
|---|---|---|
| 25 s 내내 rms | 0.212~0.235° | **정상적**(stationary) — 특정 순간의 사고가 아님 |
| 주파수 분포 | 50 Hz까지 평탄 | **백색** — 공진·진동이 아님 |
| φ 고주파와 상관 | −0.004 | **줄 움직임과 무관** |
| 줄이 멎었을 때 vs 움직일 때 | 0.221° / 0.215° | **똑같다** → 기계적 흔들림 아님 |
| 3점 중앙값 필터 | 0.223 → 0.138° | **스파이크가 아니라 광대역** (SPI 오독이면 더 떨어졌을 것) |
| 원 카운트 연속차 | ±5 카운트에 고르게 | 비트 오류 패턴 없음 |

0.223°는 **±10카운트**에 해당한다. AS5047P가 정상이면 φ 채널처럼 ±1~2카운트여야 한다.
같은 칩·같은 SPI 버스에서 φ는 깨끗한데 발목만 시끄럽다면 후보는:

1. **자석 갭·정렬** — 발목축 자석이 멀거나 편심. 가장 흔하고 가장 먼저 볼 것.
2. **배선** — 발목 CS(D9) 라인이 길거나 모터 전력선과 나란히 감겨 있으면 유도.
3. **접지** — 발목 센서 GND가 모터 전류 경로를 공유.
4. **발목축 유격** — 다만 위 표의 '줄 움직임과 무관'이 이걸 약하게 반박한다.

### 한계 (정직하게)

- 로그가 **100 Hz**다. 실기는 200 Hz라 EMA 평활이 더 되어 속도항이 최대 √2배 작을 수 있다.
  그래서 합계를 0.41~0.59° 범위로 적었다. **어느 쪽이든 문턱과 같은 자리다.**
- **손으로 잡고 있는 상태**의 측정이다. 줄 위에서 자립 중일 때 발목 잡음이 같다는 보장은
  없지만, 위 표의 '움직임과 무관'이 같을 가능성을 높인다.
- **영점 오프셋(③)은 못 쟀다.** 이건 실측 ②의 절편에서만 나온다.

---

## 6. 세 번째 층 — 영점 오프셋

잡음은 흔들리지만 **오프셋은 계속 한쪽으로 민다.** 상수 오프셋은 속도항을 안 건드리고
위치항만 민다 (문서 46):

| 엔코더가 1° 틀어지면 | A가 |
|---|---:|
| **발목** | **+1.000°** |
| 힙 (δ) | +0.412° |
| φ | −0.392° |

여기서도 **발목이 지배적**이다. 그리고 이건 필터로 못 없앤다.

- **자동트림(GO 순간 자세 기준)은 폐기됐다** (문서 46 §8) — 정적 관측은 '측정 오프셋'과
  '진짜 기울어짐'을 구별하지 못한다.
- **정본은 실측 ②의 절편**이다. 여러 φ에서 놓아 보고 안정선을 그리면 절편이 곧 A 오프셋이고,
  거기에 엔코더 바이어스·장착 틀어짐·질량 비대칭이 **전부 합쳐서** 들어온다.

---

## 7. 실무 규칙 세 가지

1. **A는 control_step 이전 값을 본다.** 접기가 시작되면 δ가 곧바로 θ→β를 바꿔서 A가
   한 스텝 만에 떨어진다. 이후 값으로 판정하면 전부 헛트리거로 오판된다 (문서 45).
2. **로그에는 원시값만 남긴다.** A를 저장하면 그때 쓴 w에 갇힌다 (문서 34 블랙박스 원칙).
   — 단, **Â는 예외로 같이 남긴다.** 로봇이 그 순간 무엇을 믿었는지는 재구성이 안 된다.
3. **파이프라인 셋(200 Hz / 25 ms / 28 ms)은 함께 바꾼다.**

---

## 8. 조치

- [ ] **발목 센서 하드웨어 점검** — 자석 갭·정렬 → 배선 → 접지 순서. 목표: 고주파 rms
      0.223° → **0.05° 이하**. 이것 하나로 Â 잡음이 0.59 → 0.15° 아래로 간다.
- [ ] 하드웨어로 안 되면 **발목 채널만 별도 필터.** 단 대가가 있다 — EMA τ를 키우면
      지연이 늘어 4절의 "10% 늦게"가 더 커진다. **잡음 반으로 = 지연 두 배**가 대략의 환율.
- [ ] **다음 로그에 Â 열 추가** (control_step 이전). 그러면 이 문서의 추정이 직접 확인된다.
- [ ] **실측 ②** — 여러 φ에서 놓기. 안정선 기울기 r + 절편(A 오프셋)이 같이 나온다.
- [ ] λ = 5.3 실측(문서 53)을 반영하면 예측점의 (λI − D̂)⁻¹도 바뀐다. w 재계산 필요.

---

## 부록. 재현

`analysis` 스크립트 3개 (`pipeline.py`, `noise.py`, `noise2.py`, 그림 `fig_pipeline.py`).
입력은 `0817_p2r_r2_3.csv` 하나. 파이프라인 상수는 문서 46 §7의 실기 값을 그대로 썼다.
