cbshbalance/slackline-balacing1/docs/55_v21_개발인계_20260817.md

# v21 개발 인계 문서 (2026-08-17)

> **새 세션은 이 문서를 먼저 읽고, 아래 §2 의 파일만 읽는다.**
> 폴더 전체를 읽지 말 것 — 레포에 `tmp/`(1920 파일), `work/`(374 파일), `v1`~`v18`,
> `cad/`, `exp_data/` 가 있고 전부 v21 과 무관하다.

---

## 1. v21 이 무엇인가

**v19_state 를 확장한 종합 발표 시뮬레이터.** 세 가지를 더한다.

| # | 기능 | 왜 |
|---|---|---|
| **①** | **평면에서 마우스로 상태 집기** — 평면 위에서 마우스를 움직이면 로봇이 그 상태의 자세로 표시되고, **클릭하면 그 상태에서부터 v19 물리로 움직이기 시작** | 비전공자에게 안정모드/불안정모드를 **직접 보여주며** 설명. 실측 ②(안정모드선 찾기)를 화면에서 미리 시연 |
| **②** | **실사 영상/사진 오버랩** | 시뮬 자세와 실물 자세를 겹쳐 대조 |
| **③** | 발표용 화면 구성 정리 | 씬 이동, UI 숨김 등 |

**구조는 라이브 서버 유지** (v19_state 방식: Python + MuJoCo + WebSocket).
노브를 돌리면 즉시 반응하는 것이 이 도구의 값어치이므로, 미리 구운 궤적으로 가지 않는다.

> ⚠ **이름 충돌 주의.** 사용자가 말하는 "v20"은 **다른 컴퓨터에 있는 별개 시뮬**
> (평면 → 마우스 → 로봇 자세)이다. 레포의 `v20_sim/` 은 **전혀 다른 것**
> (2026-07-31 배치 비선형 시뮬)이고, 그 전략 판정은 이미 철회됐다(문서 26).
> **`v20_sim/` 은 읽을 필요 없다.**

---

## 2. 읽을 파일 — 이것만

### 반드시 (합계 약 75 KB)

| 파일 | 크기 | 무엇을 얻나 |
|---|---:|---|
| `v19_state/server.py` | 18 KB | WebSocket 명령 프로토콜, 프리셋, 프레임 송신 |
| `v19_state/static/index.html` | 39 KB | UI 전체, `drawPlane()`, 평면 좌표계 |
| `v19_state/README_v19_state.md` | 8 KB | 현재 상태 + **철회된 결론 목록** |
| `docs/46_증분접기에_필요한_실측_세개_20260815.md` | 12 KB | 제어의 뜻, 실측 세 개, 함정 목록 |

### 필요할 때만 (부분 읽기)

| 파일 | 읽을 범위 | 무엇 |
|---|---|---|
| `v19_state/sim_engine.py` (56 KB) | **138~330행** | 클래스·`build`·`reset`·`get_state`·`risk_A` |
| | **583~655행** | `_fwe_async` — **증분접기 제어 로직 전부** |
| | **944~968행** | `plane_pt`·`frame` — 평면 좌표 생성 |
| `presentation/match.html` | 전체 (27 KB) | **실사 오버랩 매칭 도구 — 이미 만들어져 있다.** ②의 출발점 |
| `presentation/README.md` | 전체 (7 KB) | 발표앱 설계(bake+scrub). 구조는 안 쓰지만 화면 구성·단축키 참고 |
| `v19_bringup/params_v19.py` | `MEASURED_SET` 부분 | 실측 파라미터 정본 |

### 절대 읽지 말 것

- `v19_state/static/three.min.js` (**603 KB**) — 순수 라이브러리
- `presentation/three.min.js` (603 KB), `presentation/media/*.mp4` (8 MB+)
- `tmp/`, `work/`, `cad/`, `exp_data/`, `v1_*`~`v18_*`, `v19_sim/`, `v20_sim/`
- `docs/` 의 나머지 116 파일 (46번만 읽으면 된다)

---

## 3. 읽지 않고도 알아야 할 것 — 여기 요약

### 3-1. 제어 로직 전체 (`_fwe_async`)

**상수** (빨간 버튼 `★★ 비동기 FWE — 실측 파라미터` 기준)

| | 값 |
|---|---|
| 제어주기 DT | **5 ms (200 Hz)** — 실기 펌웨어와 동일 |
| 트리거 문턱 A_TRIGGER | 0.6° |
| ρ | 0.95 |
| γ | 10 |
| T_REST | 60 ms |
| δ 한계 | ±55° |
| 힙 속도/가속 | 420 °/s, 8000 °/s² |
| 저속 복귀 | 3 °/s, 데드밴드 1.0° |

**매 5 ms 마다**: 엔코더 3개 → 추정 상태 x̂ → **Â** 계산 → 상태기계 → 사다리꼴 프로파일 → 서보 PD.
**판정은 언제나 추정값 Â.** 참값은 로봇이 볼 수 없다.

**상태기계**

```
IDLE ──|Â| > 0.6° ?──→ 예: hold += ρ·γ·Â  (누적, ±55° 클립) → FOLD
       │
       └─ 아니오 → |Â| < 0.3° 이고 |hold| > 1.0° 이면
                    hold 를 3°/s 로 중립쪽 감소 (= 천천히 펴기)

FOLD  ── 프로파일이 δ 를 hold 로 이동. |δ−hold| < 0.5° 도달 (또는 0.6 s) → REST
REST  ── 60 ms 대기, 아무 판정 없음 → IDLE (즉시 재판정 가능, 히스테리시스 없음)
```

**접는 양은 매번 같다** — 항상 |Â| = 0.6° 에서 발동하므로 ρ·γ·0.6 ≈ **5.7°**, 부호만 바뀐다.

### 3-2. 평면의 정의 — v21 의 핵심

| | |
|---|---|
| α | 하체 각 (연직 기준) |
| θ | 상체 각 = α + δ |
| δ | 힙 접힘각 (= θ − α) |
| φ | 줄(크랭크) 각 |
| **β** | **무게중심 각 = P1R·α + P2R·θ**, P1R = 0.5878, P2R = 0.4122 (합 1) |

**위험도** `A = w·[φ, β, φ̇, β̇]`, w = [0.6079, 1.0, 0.1027, 0.1689]

**예측점** = (β + β̇/λ, φ + φ̇/λ), λ = 5.9219 /s

두 평면:
- **원위치 평면** (β, φ) — 안정모드선 기울기 `r = −1.6445`
- **예측점 평면** (β_pred, φ_pred) — A=0 선 기울기 `slopeA0 = −1.6451`

**★ 둘은 같은 선이다** (0.04% 차이). 즉 **A = 0 ⟺ 예측점이 안정모드선 위에 있다.**
그리고 `w = [−1/r, 1, −1/(rλ), 1/λ]` — w 는 r 과 λ 만으로 결정된다 (0.035% 일치).

### 3-3. 실기 파이프라인은 한 묶음

| | 실기 펌웨어 | 시뮬 기본 |
|---|---|---|
| 제어주기 | **200 Hz** | 500 Hz |
| 속도 기저차분 | **25 ms (5샘플)** | 2 ms |
| 속도 EMA | **τ ≈ 28 ms** | τ = 10 ms |

**⚠ 셋을 따로 켜면 안 된다.** 500 Hz 에 25 ms 차분만 얹으면 **13스텝 차분**이라는
실기에도 시뮬에도 없는 잡종이 되고, 거기서만 나오는 늦은트리거·과접기를
실기 현상으로 오인한다. **이 실수로 하루를 썼다** (README 「철회된 결론」 참조).

UI 체크박스 **★ 실기 파이프라인** 이 셋을 함께 전환한다. 빨간 버튼은 켠 채로 시작.

### 3-4. 실측은 세 개뿐 (문서 46)

| # | 재는 것 | 방법 | 예측값 |
|---|---|---|---|
| ① | P2R | 매달고 δ 명령 → 발목각 직선 | 기울기 **−0.4122** |
| ② | 안정모드선 (r + 절편) | 여러 φ 에서 놓고 흔들리나 넘어지나 | **r = −1.6445** |
| ③ | λ | 선에서 벗어나게 놓고 배가시간 | **117 ms** |

\+ 노브 하나(접기량)를 줄 위에서 시행착오로. 질량·관성·감쇠는 **하나도 필요 없다.**

---

## 4. v21 신규 기능 — 설계 노트

### 4-1. 평면 → 상태 (마우스 집기)

**좌표 변환이 아주 간단하다.** 놓기 시험은 **속도 0, δ = 0** 이 자연스러운 설정이고,
δ = 0 이면 θ = α 이므로

```
β = P1R·α + P2R·θ = P1R·α + P2R·α = α        (P1R + P2R = 1)
```

**즉 β = α.** 평면 위의 점 (β, φ) 가 그대로 `alpha0 = theta0 = β`, `phi0 = φ` 가 된다.

**서버 명령이 이미 있다:**

```js
send({cmd:"x0", phi0: <φ>, alpha0: <β>, theta0: <β>});
send({cmd:"reset"});     // reset() 은 위치만 세팅, 속도는 0 — 놓기 시험 그대로
```

기존 슬라이더 `sA0`/`sP0` 가 이미 이 경로를 쓴다 (`index.html` 611~612행).

**구현 방향**
- `drawPlane()` 의 `X(b)`, `Y(f)` 가 상태→화면 변환. **역변환**을 만들면 마우스 좌표 → (β, φ)
- **hover**: `cmd:"x0"` + `cmd:"reset"` 을 보내고 3D 만 갱신 (물리 정지 상태)
- **click**: `cmd:"run"` 으로 물리 시작
- 마우스가 움직일 때마다 리셋을 보내면 트래픽이 많다 → **throttle**(예: 50 ms) 또는
  hover 전용 경량 명령(`cmd:"pose"` — 리셋 없이 qpos 만 세팅)을 새로 만드는 편이 낫다

**예측점 평면에서는 hover 가 부정확하다.** 예측점은 속도를 포함하는데 놓기 시험은 속도 0 이라
예측점 = 원위치가 된다. **원위치 평면에서만 hover 를 켜거나**, 예측점 평면에서는
"속도 0 가정" 을 화면에 명시할 것.

**교육적 시나리오** (이게 이 기능의 목적)
1. 초록 선(안정모드선) **위**를 따라 마우스를 움직이며 클릭 → 발산 없이 흔들리다 잦아든다
2. 선에서 **벗어난** 곳을 클릭 → 한쪽으로 넘어진다
3. → "이 선이 안정모드선이고, 실측 ②가 바로 이것을 실물에서 찾는 것"

### 4-2. 실사 오버랩

**`presentation/match.html` 이 이미 "실사 오버랩 매칭 도구" 다.**
비디오 위에 3D 를 겹치고 오른쪽 패널에서 카메라/스케일을 맞추는 구조.
**새로 만들지 말고 이걸 먼저 읽을 것.** v19_state 의 3D 뷰에 이식하는 것이 ②의 실체다.

### 4-3. 손대야 할 곳

| 파일 | 무엇 |
|---|---|
| `static/index.html` | `drawPlane()` 역변환, 마우스 핸들러, 오버랩 레이어 |
| `server.py` | (필요시) `cmd:"pose"` 신설 — 리셋 없이 자세만 |
| `sim_engine.py` | 대부분 손댈 필요 없음. 자세만 세팅하는 헬퍼 정도 |

---

## 5. 이미 있는 것 — 다시 만들지 말 것

| 기능 | 어디 |
|---|---|
| MuJoCo 전물리 + 증분접기 제어 | `v19_state/sim_engine.py` |
| 평면 2장 (원위치·예측점), 트리거 띠, CoM 등고선 | `index.html` `drawPlane()` |
| **추정점 표시** (참=점, 추정=하늘색 링) | 같은 곳. **판정은 링 기준**이라는 것을 보여주는 장치 |
| 실기 파이프라인 토글 (200 Hz + 25 ms + τ30 ms) | `index.html` `#cFwPipe` |
| 한 프레임 전진/뒤로 (스냅샷 되감기) | `cmd:"step"` / `cmd:"back"` |
| 교란 주입 (φ̇ 킥) | `cmd:"perturb"` |
| 초기조건 설정 | **`cmd:"x0"`** ← v21 ①의 기반 |
| 실사 오버랩 매칭 | `presentation/match.html` |
| 발표 씬 구성·단축키 | `presentation/index.html` + `README.md` |

**서버 명령 전체**: `hello reset run pause step back speed x0 perturb mode estimator pd gain
servo_aware real nominal mismatch fwe_preset fwe_async_preset fwe_async_preset_measured x`

---

## 6. 작업 규칙

1. **코드를 고치기 전에 반드시 묻는다.** 이해하지 못한 수정이 쌓이면 나중에 못 되돌린다.
2. **원본을 건드리지 않고 실험한다.** 파라미터 스윕은 `/tmp` 에 사본을 만들어 거기서.
3. **주장하기 전에 잰다.** 이 프로젝트는 "그럴듯한 설명"으로 여러 번 틀렸다.
4. **틀렸으면 문서에 철회를 남긴다.** README 「철회된 결론」 표가 그 형식이다.

### 이미 밟은 함정 (반복 금지)

- **A 는 `control_step` 이전 값으로 볼 것.** 접기가 시작되면 δ 가 곧바로 β 를 바꿔
  A 가 한 스텝만에 떨어진다. 이후 값으로 보면 전부 헛트리거로 오판된다.
- **실기 파이프라인 셋(200 Hz / 25 ms / τ30 ms)은 한 묶음.** 따로 켜면 잡종.
- **'힙 가동률'을 `phase != IDLE` 로 세지 말 것.** REST 대기가 포함된다.
- **단발 외란 시험으로 순위를 매기지 말 것.** 킥 위상에 좌우돼 비단조적 결과가 나온다.
- **σ_A 잡음 바닥은 가진이 있는 상태에서 잴 것.** 정지 상태에서는 항상 0 이 나온다.
- **접힌 자세를 초기조건으로 던지지 말 것.** 정적 평형이 아니라 놓자마자 가속한다.

### 연구의 성격

고등학생이 **정성적 추론**으로 AI 의 도움을 받아 역학 문제를 풀고 로봇을 제어하는 연구다.
대학원 수준의 제어이론·수식은 목표가 아니다. 모드분석까지는 필요해서 했고,
그 이후는 **상태공간과 예측점 평면**이라는 도구 위에서 정성적 추론으로 밀고 나간다.
**v21 은 그 도구를 남에게 보여줄 수 있게 만드는 작업이다.**

---

## 7. 현재 상태

- 레포: `github.com/cbshbalance/slackline-balacing1`, `main`, 최신 `23405a3`
- `v19_state` 는 200 Hz 실기 파이프라인 기본 ON, T_REST 60 ms 로 정리 완료
- 미해결: 실물의 좌우 스윙 원인, δ₀(유지각) 의존성, 펌웨어 w 의 출처
- 기존 펌웨어 `fwe_async_v19.ino` 는 **임시 테스트로 취급** — 거기에 맞추지 않는다

### ⚠ 실측은 이미 진행됐다 — 이 문서를 쓴 세션은 그것을 몰랐다

이 문서의 본문(특히 §3-4 의 예측값)은 **8/15 시점**의 것이다.
8/16~17 에 다른 세션에서 실측과 발표 준비가 진행됐고, **그 결과가 정본이다.**

| 문서 | 내용 |
|---|---|
| **52_P2R_실측_펌웨어_20260817** | 실측 ① — P2R (예측 −0.4122) |
| **53_람다실측_배가시간_4회_20260817** | 실측 ③ — λ (예측 배가 117 ms) |
| **54_A와Ahat_차분EMA_잡음바닥_20260817** | Â 잡음 바닥 (§5 의 '확인할 것') |
| 48_발표통합앱_v0.1_러프컷_20260815 | `presentation/` 앱 — v21 의 화면 구성 참고 |
| 49_발표서사축_3단계_확정_20260816 | 발표 서사 |
| 50_실기스타트_놓기프로토콜_v1_20260817 | 실측 ②(안정모드선) 관련 — **v21 ① 기능의 실물 대응** |
| 51_발표흐름_3분대본_v1_20260817 | 3분 대본 |

**새 세션은 §2 의 파일에 더해 52·53·54 를 먼저 읽고,
§3-4 의 예측값을 실측값으로 갈아끼운 뒤 시작할 것.**
특히 50번(놓기 프로토콜)은 v21 ①(평면에서 마우스로 상태 집기)이
화면에서 보여주려는 바로 그 절차이므로 반드시 읽는다.

---

> **[2026-08-19 추기 — Claude Code 사본]** 이 문서의 ①②③ 은 v21_pres/ 에 구현 완료 (문서 58·59).
> §3-4 예측값의 실측 정본: P2R 0.417 (57) · λ 5.3/s (53) · Â 잡음 0.41~0.59° (54).
> §4-1 교육 시나리오는 문서 58 §2 의 3단 대조로 정정됨. 최신 상태는 58→59 순으로 읽을 것.
