cbshbalance/slackline-balacing1/v22_logger/NIGHT_LOG.md

# 야간 자율 연구 로그 — "현실에서 로봇이 줄을 탈 수 있는가" (2026-07-17 밤)

전제: 전현실화(서보·마찰·센서) + 실센서 추정, 설계 추정치 파라미터. 코드 v19_sim.

## 확정된 발견 (시간순)

1. **발목 엔코더 구성(사용자 제안)이 LQR을 극적으로 강화** ★최대 성과
   - 절대각 3개(φ, α=φ+발목각, θ=α+δ)가 전부 엔코더 → IMU 가속도계(thAcc) 제거.
   - 순수 엔코더(자이로도 미사용) + 차분 LPF(10ms) 속도: 포획영역 0.5→**3° 이상**
     (칼만 0.5~1°), 스틱션 리밋사이클 ±13° → **~1° 수렴**, φ̇킥 내성 1.0 rad/s.
   - 자이로 혼합(α̇=θ̇−δ̇)은 오히려 해로움 — 빼기 연산이 서보 킥 스파이크 생성.
     절대각 직접 차분이 정답 (α는 느린 물리량이라 차분이 매끈).
   - 물리 대가: 발축 +15g → I_r +20% — 전부 파라미터로 흡수(재계산만 필요).
   - ⇒ **LQR 직립 기준으로는 "줄 탄다"에 도달한 구성.**

2. **FWE(반복 FEW)는 현 스케일에서 전 구성 실패** — 원인 규명의 연쇄:
   - 칼만: 접기 구간 오염이 다음 트리거 A에 잔류(±20~35% 오차). 정착대기·게인
     스케줄링·PD직접측정 모두 불충분.
   - enc 추정: 트리거 A 정확(±10%)해도 발산 → 추정 문제 아님.
   - γ 전물리 캘리브레이션(순수 성장상태 준비 후 사이클 실행):
     A=1~2°에서 γ_eff=30~32 = **이론값(30.0)과 일치!** 그러나 A≥4°에서 gc 붕괴
     (A=8°: γ_eff=67) — δf=55°를 80ms에 접으려면 1375°/s 필요 vs 서보 276°/s.
     회복 상한 A* = gc·δmax/(Gc−1) ≈ **2.3°**.
   - 반전: LQR(enc)은 A 점프 ~8°(킥 1.0rad/s)도 회복 → **FWE 권한(2.3°) < LQR
     흡인영역** — 사람 스케일에서의 FWE 우위가 로봇 스케일에서 역전.
   - 적응 접기시간(vmax 존중), 실제 W210 속도(462°/s), 가상 2000°/s, 형상목표
     80cm/3kg 로봇 — **전부 발산 지속** → 서보 속도만의 문제가 아님.
   - 잔여 용의자(이론 미완 과제와 일치): **잔여 안정모드 에너지** — γ 맵은 순수
     성장상태에서 이론과 맞지만, 엔진 트리거 상태는 안정모드(ω_eff=6.9) 진동이
     섞여 사이클별 실효 킥이 산포 → 얇은 수축 여유(ρ창)가 산포에 붕괴.
     (근거: ρ=0.9(이론 창 안)도 참상태에서 발산; ρ=0.7은 창 밖인데 유계 리밋사이클
      — 선형 맵으로 설명 불가한 비선형/모드혼합 거동)

3. 하이브리드(LQR+FWE사이클)는 현 눈금으로는 개악 — 접기 개입이 LQR이 회복할
   상황을 망침. FWE 트리거를 LQR 흡인영역 밖(>8°?)으로 올리면 의미가 생길 수
   있으나, 그 영역은 A*=2.3° 상한 때문에 접기로도 회복 불가 — **현 서보·현 스케일
   에서 FWE의 실용 창이 없다**는 잠정 결론.

## 추가 발견 (2회차)

4. **사이클 맵 오차의 원인 사슬 규명 (진행 중)**
   - 안정모드 η₁이 트리거 A의 3~14배로 섞여 있고 맵오차와 동행 — 그러나 선형계면
     중첩원리로 A 오염 불가 → 채널은 실행/비선형.
   - 서보 현실화는 무관(이상 토크원과 오차 동일). **PD 강성이 지배**: Kp 25→80 에서
     맵오차 14.4°→4.6°. 관성 피드포워드(τ_ff=I_δ·δ̈_ref) 추가로 절반 더 감소.
   - 적응 접기시간(자작 기능)이 γ 공칭 프로파일과 자기모순 → 정합 복구했으나
     맵오차 ~7-8° 잔존, 전 구성 낙하 지속.
   - **핵심 정량 결론(잠정)**: 접기 실행오차 바닥(~1-2°/사이클, A환산) ≥ FWE 운용창
     [트리거 0.4°, 회복상한 2.3°] → 현 스케일에서 신호가 오차에 잠긴다.
   - 미해결: 독립 γ 실험(순수 성장상태 준비)은 이론과 일치하는데 엔진 사이클은
     크게 어긋남 — 트리거 상태의 속도 성분/안정모드 위상이 유력.

## 추가 발견 (3회차) — ★결정 실험과 돌파구

5. **결정 실험 판정: 이론은 무죄, 범인은 '실행 프로파일 갭'**
   - 엔진 사이클의 실제 δ̈(t)를 선형 4D 모델에 그대로 입력 → MuJoCo와 A 궤적 차
     **0.16°**(사이클 전체). 비선형/모드결합 아님.
   - 공칭 삼각 프로파일 가정의 맵과는 1.03° 차 → 맵오차 전부가 "실제 δ(t) ≠ 공칭
     프로파일". PD+피드포워드로도 프로파일은 정확히 안 실린다(시작 스냅, 링잉).
6. **γ 실행 캘리브레이션 → FWE 참상태 완전 유계 달성**
   - 엔진 실행 45사이클 (A⁻,δf,A⁺) 최소제곱: Gc*=5.30, gc*=0.285(공칭+44%),
     γ*=18.6(공칭 28.9), 잔차 RMS 0.49°.
   - γ* 사용 시 참상태·실서보 FWE 모드3: **ρ 0.85~1.05 × 트리거 0.4~1.0° 전 구성
     15초 유계**(27~55사이클, |A|max 2.9~6.7°). ← 반복 FEW 전물리 성립 최초 확인.
   - 실센서(enc)에서는 20~31사이클(6~12초)까지 연장 후 낙하 — 센서 잡음+실행 잔차
     0.49°의 랜덤워크가 회복 천장(~3°)을 결국 넘음.
7. **하이브리드 무용 재확인**: LQR(enc) 흡인영역(A~8° 킥까지)이 접기 회복 천장(~3°)
   보다 훨씬 커서, 접기 개입이 유익한 영역이 존재하지 않음. 킥 회복은 LQR이 담당.
8. **LQR-enc 최종 강건성: 몬테카를로 8/8 생존** (m₂±10%, Kt±10%, f_hip×2, 복합
   최악 케이스 포함, 잔여 0.7~1.05°). 칼만의 m₂+5% 낙하 비대칭 소멸.
   마찰 피드포워드(f̂=0.045, tanh)로 잔여 0.84→0.65°.

## 다음 반복에서 할 일
- [x] 결정 실험 완료 (발견 5)
- [x] γ 실행 캘리브레이션 + FWE 재시험 완료 (발견 6)
- [x] LQR-enc 몬테카를로·마찰보상 완료 (발견 8)
- [ ] 아침 보고서: 종합 판정표 + 권고 → 프로젝트 문서(04)·README 반영, 커밋

## 최종 종합 (아침 보고서 골자)
1. **줄 탈 수 있는가?** — **발목 엔코더 구성이면 YES**(시뮬 기준): LQR만으로 직립
   유지(잔여 ~0.8°), 초기기울기 ~3°·φ̇킥 1.0 rad/s 회복, 파라미터 편차 8/8 강건.
   현 IMU 칼만 구성은 포획영역 ±0.5~1° + 스틱션 리밋사이클 ±13° — 실전 취약.
2. **FWE는?** — 이론 자체는 전물리에서 정확(결정 실험 0.16°). 실행 프로파일 갭을
   γ*로 재캘리브레이션하면 참상태 반복 FEW가 전물리 최초 성립(발견 6). 그러나
   이 스케일·이 서보에서는 (a)회복 천장 ~3° < LQR 흡인영역 ~8°, (b)실행+센서 잔차
   랜덤워크로 실센서 장기 유계 실패 → **실용 제어기가 아니라 이론 검증 시연**으로
   자리매김이 정직함. 사람 스케일(λ 작고 δ 실행이 상대적으로 빠름)에서 FWE가 왜
   성립하는지의 대비가 오히려 연구 서사를 강화.
3. **권고**: ①재설계에 발목 엔코더 추가(칩은 하체 쪽, 자석만 발축) ②펌웨어 추정기를
   '절대각 3-엔코더 + 각도 직접차분 LPF'로 교체(자이로 혼합 금지) ③compute_gains에
   armature 반영 ④FWE는 γ 실행 캘리브 절차(45사이클 적합)와 함께 시연 트랙으로.

## 추가 발견 (4회차, 2026-07-18) — ★서사 교정 + 줄 감쇠로 실센서 FWE 장기 성립

9. **판정 기준 교정(사용자 지적)**: 서사는 "FWE > LQR"이 아니라 "모델 오차 시 아마추어가
   노브 하나로 고칠 수 있는 제어 + 물리 직관"(docs/줄타기_연구_서사_초안_20260707.md).
   이 기준으로 재판정: LQR 성립에는 전문가 개입 3회(armature 모델수술·센서 교체·마찰FF),
   gain_scale 노브만으론 전패. FWE 성립에는 γ* 노브 하나(사이클 데이터 적합, 원인 불문).
   → **밤 실험 전체가 서사의 실험적 증명.** "FWE 시연 트랙" 권고는 철회.
10. **γ 공칭값의 이론 포함 범위 확인(사용자 질문)**: 밤새 쓴 ε*·γ·w는 전부 7/11 노트
    §3의 줄 관성 포함 확장식(model_v19: M[φφ]=MtR²+I_r, ε*=−s/(r+s), 4D w) 기준 —
    ι=0.107, ε*_damped=1.043(무질량 1.532, −32%) 매 빌드 출력으로 정합 확인.
    γ* 44% 갭은 줄 질량이 아니라 순수 실행 프로파일 갭. 단 c_φ 값은 실측 전 0이었음.
11. **★줄 감쇠 c_φ가 마지막 조각(노트 §3.2 '감쇠는 아군' 적중)**: c_φ를 공칭+플랜트에
    동일 반영(실측 후 시나리오)한 스윕 — c_φ=0: 6s 낙하 / 0.003: 16s / **0.008 이상:
    30초 98사이클 유계(|A|max 7.7°), 실센서·전현실화 반복 FEW 장기 성립 최초**.
    메커니즘: λ_u 거의 불변(6.45→6.42) — 잔여 안정모드 진동의 자동 소멸(이득②)이
    사이클 산포의 먹이를 제거. 3회차 미해결(잔여 안정모드 채널)의 답.
    실물 함의: c_φ 로그감쇠 실측 필수, 부족하면 미세 점성 댐퍼 추가도 설계 옵션.

## 완성된 서사 고리 (보고서용)
이론(줄 관성·감쇠를 행렬에 정확히) → 남는 실행 갭은 노브 하나(γ* 실행 캘리브, 원인
진단 불요) → 실센서 반복 FEW 장기 유계. LQR 대비: 성능 상한은 (전문가 튜닝) LQR이
높으나, 모델 오차 복구 비용이 근본적으로 다름(6게인 재설계 vs 노브 1개) — 아마추어·
극한환경 서사의 정량 증명.

## 추가 (5회차, 2026-07-18 새벽) — 사이클 시간표 스윕 (직관값 → 지도)

12. **타이밍 축스캔+격자 108점** (enc·전현실화·c_φ=0.008·점별 γ(T)×실행갭 보정+온라인 RLS):
    - 경향: T_fold 60ms 최적(40은 오히려 손해), **T_wait 짧을수록 단조 우세(20ms, 완주율
      72%)** — 감쇠가 잔여진동을 대신하므로 '기다림의 물리적 역할'이 소멸, 순수 비용만 남음
      (이론 후보 λT_w=ln2=107ms 는 이 조건에서 사망 — T_w 트레이드오프 미완과제의 답:
      감쇠 있는 소형에서는 최소 T_w 가 정답). T_extend 90ms(펴기 완료 가능한 최단),
      T_rest 60ms(δ 링잉 정착 시간 — 10ms 는 경계 오염으로 사망), 트리거 0.6°(SNR).
    - **권장 시간표 60/20/90/60ms, 트리거 0.6°** vs 직관값 80/60/80/50, 0.4°.
    - 장기 검증: 기본 56.5s/133사이클, a0=0.8° 59s, m2+10% 60s 완주. 단 Kt−10% 는 9.8s
      — 시간표·오차 유형 간 트레이드오프 존재. 순수 FWE = 유한 수명 확률과정(이제 ~1분
      스케일)이라는 본질 유지.
    - 축스캔에서 확인된 사망 기전 2종: 펴기 미완(te 부족 → δ 경계조건 붕괴), 휴지 부족
      (링잉 미정착 상태 트리거). ★δ 경계 가정(δ(0)=δ̇(0)=0)은 맵 성립의 숨은 전제 —
      마스터식 #7 경계항으로 보정 가능(미구현, 후보).
    - 코드: v19_sim/sweep_timing.py (axis/grid), 데이터 /tmp/sweep_grid.csv (108점).
