cbshbalance/slackline-balacing1/docs/실측_최종정리본_20260729.md

# 실측 최종 정리본 — "세우기까지" 필요한 모든 실측 (2026-07-29, v2)

> **이 문서 하나로**: 로봇을 실제로 줄 위에 세우기(LQR 브링업 → 반복 FEW)까지
> 필요한 실측이 ①물리적으로 왜 필요하고 ②무엇이며 ③어떻게 재고 ④어디에 입력하며
> ⑤어떤 순서·판정으로 진행하는지 총정리한다.
>
> 값의 단일 진실 소스는 여전히 **`v19_bringup/params_v19.py`** 다(값은 거기에만 입력,
> `MEASURED=True`로 바꿈). 이 문서는 그 지도를 겸한 실행 안내서다.
>
> 통합한 원본: `v19_bringup/README.md`(0~6단계) ·
> `docs/실측_캘리브레이션_절차_20260620.md`(측정 원리 상세) ·
> 프로젝트 문서 15(조립후 실험절차 v19, 자가측정 ①~④) · 문서 17(모터 프로파일 테스트).
> 원본과 어긋나면 **이 문서(최신)** 를 따르고, 세부 수식은 0620 문서를 본다.

---

## 0. 왜 이렇게 재는가 — 측정의 물리 (먼저 읽기)

제어기가 필요로 하는 것은 운동방정식의 계수들이다:
**"중력이 넘어뜨리는 세기(mgℓ)" · "돌기 싫어하는 정도(I)" · "운동을 잡아먹는 마찰(c)" ·
"모터가 실제로 내는 토크(Kt·i)"**. 이 중 직접 잴 수 있는 것은 얼마 없다.
그래서 원칙은 하나다 —

> **정지 상태에서 잴 수 있는 것(질량·길이·균형점)은 자·저울로 재고,
> 나머지는 전부 "알려진 조건에서 운동을 관찰해 방정식을 거꾸로 푼다."**

| 알고 싶은 물리량 | 그것이 지배하는 운동 | 그래서 측정하는 것 |
|---|---|---|
| 무게중심 위치 ℓ | 중력 토크가 0이 되는 점 | **균형이 잡히는 받침 위치** (칼날받침) |
| 관성모멘트 I | 매달아 흔들 때의 진동 주기: T = 2π√(I_pivot/mgd) | **미소진동 주기 T** (복합진자) |
| 줄 감쇠 c_φ | 자유진동에서 진폭이 주는 비율 (주기는 관성/복원력이, 감쇠는 진폭 감소가 정함) | **연속 피크의 진폭비** (로그감쇠) |
| 넘어짐 속도 λ_u | 직립 근처에서 기울기의 지수 성장 e^{λt} | **놓은 뒤 기울기 로그의 기울기** |
| 허리 유효관성 I_δ (armature 포함) | 회전 뉴턴 법칙 τ = I·α | **알려진 토크 대비 각가속도** (잔차 = 마찰) |
| 토크상수 Kt | τ = Kt·i | **알려진 토크(추×팔길이)에서의 전류** |
| 환산비율 γ (FWE 노브) | 접기각 δ_f 가 위험도 A를 줄이는 비례 | **(접기각, A 변화) 쌍들의 최소제곱 적합** |
| 부호·단위 (DIR 상수들) | 물리 방향과 센서 부호의 일치 | **알려진 방향으로 움직여 보고 부호 확인** |

같은 원리의 앞뒤 관계: 복합진자와 자유진동은 **주기→관성**, 기울여 놓기는 **성장률→불안정성**,
허리 흔들기는 **가속도→관성**, torque_cal은 **토크→전류(역방향)** 이다.
"덩어리로만 나타나는 양은 덩어리째 잰다"(자가측정 사상)의 이유도 여기 있다:
운동방정식에는 m·ℓ·I 가 따로가 아니라 조합(mgℓ, I_pivot, λ_u, γ)으로 들어가므로,
그 조합이 드러나는 운동을 재면 충분하다.

---

## 1. 전체 흐름 한눈에

```
[A] 저울·자·균형점 (조립 전·중)          → params BODY.*, ROPE.* 질량표
[B] 복합진자 (조립 후, 장비 매립 후)      → I1_cm, I2_cm
[C] 전장 방향·단위 확정 (스케치 4개)      → ENC_PHI_DIR / ENC_ANK_DIR / IMU_DIR / MOTOR_DIR / Kt
[D] 줄 시스템 자유진동 (로봇 없이)        → c_φ, ω 교차검증
[E] 게인 생성·검증 (PC)                  → params → compute_gains → sim_check 전부 PASS
[F] 조립 후 자가측정 실험 0·①~④ (로봇 스스로) → 백래시, ω_eff, λ_u·w, I_δ·가속도, γ(A)·σ_A·트리거
[G] LQR 브링업 → 반복 FEW → 버티기 분포
```

A~D는 부품·소조립 단계에서, F는 완전 조립 후 줄 위에서 한다. E는 A~D가 끝나면
언제든 PC에서. **F의 결과(λ_u, w, γ, 트리거, 가속도)는 펌웨어 상수/보간표로 반영**된다.

---

## 2. 실측 항목 총괄표 + 방법 상세

### A. 저울·자·균형점 — 중력 토크 mgℓ의 재료
(도구: 주방저울(1g), 줄자/철자, 칼날받침 또는 얇은 각재 모서리)

| # | 기호 | 무엇 | 입력 위치 |
|---|---|---|---|
| A1 | m₁ | 하체 질량(발축 베어링~힙, 발목 하우징 포함) | `BODY.m1` |
| A2 | m₂ | 상체 질량(힙~머리, **XM430+OpenCR+배터리 매립 후**) | `BODY.m2` |
| A3 | L₁ | 발축 중심 → 힙축 중심 (공칭 0.259 — v5.3 CAD +9mm 반영치) | `BODY.L1` |
| A4 | L₂ | 힙축 중심 → 상체 끝 (공칭 0.40 — ⚠상체 B +22mm(robot_l2 372) 이력, 실측으로 확정) | `BODY.L2` |
| A5 | ℓ₁ | 발축 → 하체 CoM | `BODY.ell1` |
| A6 | ℓ₂ | 힙축 → 상체 CoM (★기준점 주의: ℓ₁은 발축, ℓ₂는 힙축) | `BODY.ell2` |
| A7 | ELL_IMU | 힙축 → OpenCR IMU 칩 | `BODY.ELL_IMU` |
| A8~A11 | 줄 부품 | 빗변 1개 질량(20~25g 예상)·길이, 하단 하드웨어 합 질량, 상단 소켓 질량·CoM 거리 | `ROPE.*` |
| A12 | R | 상단 베어링축 → 발축 거리 (설계 예측 0.433) | `ROPE.R` |

**방법 상세**
- **질량**: 세그먼트를 완성 상태(볼트·배선 포함)로 통째 저울에. 상체는 반드시 장비 매립 후.
  ⚠v5.9~10에서 상단 소켓에 컵 클램프가 융합됨 — A11은 **신형 v5.2/v5.3 출력물 + M3 볼트·너트 포함**해 잴 것.
  ⚠**v5.11(7/29) 발목 L-브래킷 형상 결함 수정 → `encoder_ankle_bracket`(v5.2)·`lower_ankle_carrier`(v5.3) 둘 다 재출력 필요.**
  캐리어는 브리지 셀프탭 파일럿 위치가 이동해 기존 출력물은 나사가 안 맞음. **A1(하체 질량 m₁)은 이 신형 2점을
  장착한 상태로 잴 것** — 구형 출력물로 재면 질량표가 실물과 어긋난다.
- **길이**: "축 중심 ↔ 축 중심"이다. 축 중심은 베어링 구멍 중심 — 파트 면이 아니라
  샤프트/보어의 중앙을 자로 잡는다. 애매하면 샤프트 지름의 절반을 보정.
- **균형점(CoM)**: 세그먼트를 칼날받침(각재 모서리) 위에 가로로 얹고 좌우로 조금씩 옮겨
  **수평으로 정지하는 받침 위치**를 찾는다. 그 점이 CoM이다 — 균형 = 받침 양쪽 중력 토크가
  상쇄되는 유일한 점이기 때문. 기준축(발축/힙축)에서 그 점까지 거리가 ℓ. 3회 반복해 평균.
- R은 조립 후 실측이 정확하다(처짐 sag가 조립 공차에 민감).

### B. 복합진자법 — 주기를 재서 관성모멘트를 구한다
(도구: 스톱워치(또는 폰 영상 프레임), `calib/calib_analysis.py`)

**원리**: 물체를 축에 매달아 작은 각도로 흔들면 주기는
T = 2π√(I_pivot / m·g·d) (d = 축→CoM 거리). 주기가 길수록 "돌기 싫어하는 정도"가 크다.
따라서 **T를 재면 I_pivot = mgd(T/2π)² 이 나오고, 평행축 정리로 I_cm = I_pivot − md²**.
스크립트가 이 두 줄을 대신 계산한다.

**방법 상세**
1. 하체는 **발축**에, 상체는 **힙축**에 실제 베어링/축으로 매단다(마찰 최소인 실제 축이 최선).
2. **작게**(5~10° 이내) 기울였다 놓는다 — 공식이 미소진동 근사이기 때문.
3. **10회 왕복의 총 시간을 재서 10으로 나눈다**(한 주기 직접 측정은 반응시간 오차가 지배).
   3세트 반복해 평균.
4. `python calib/calib_analysis.py pendulum --m <질량> --d <ℓ> --T <주기>` → I_cm 을
   `BODY.I1_cm / I2_cm`에 입력.

| # | 대상 | 매다는 축 | 입력 |
|---|---|---|---|
| B1 | 하체 | 발축 | `BODY.I1_cm` |
| B2 | 상체(장비 매립 후) | 힙축 | `BODY.I2_cm` |

미입력(None)이면 균일막대 근사 mL²/12 가 자동 적용되지만, 모터·보드·배터리가 몰려 있는
실물은 근사가 크게 어긋난다 — 실측 필수.

### C. 전장 방향·단위 확정 — "알려진 방향으로 움직여 부호를 본다"
(1회성. 부호 규약은 사고 다발 구역 — 자이로 16.4배 오독 전례. 5분 투자로 하루를 아낀다.)

| # | 상수 | 알려진 입력 → 확인할 출력 | 도구 |
|---|---|---|---|
| C1 | ENC_PHI_DIR | 크랭크/로봇을 **+x로 밀 때** → φ 값이 **+** 인가 | `firmware/encoder_phi` |
| C2 | ENC_ANK_DIR + α식 | 스윙 +방향으로 살짝 기울일 때 → 분석 기준 **β>0** 이 되도록 펌웨어 부호와 `--alpha`(기본 `ank-phi`) 확정 | exp_selftest (→ 5장 갭) 또는 모터 테스트 스케치의 2엔코더 동시 스트리밍으로 대체 |
| C3 | IMU_DIR | 1초에 90° 돌릴 때 gy_dps≈**90**(단위 확인), 앞으로 기울일 때 thAcc **+** | `firmware/imu_axis_check` |
| C4 | MOTOR_DIR, Kt | +전류 명령 → δ가 **+(앞접기)** 로 움직이는가 / **추 매달기**: 팔길이 r에 질량 m 추 → 토크 mgr를 버티는 전류 i를 읽어 Kt = mgr/i (공칭 1.304와 대조) | `opencr_test/torque_cal` |
| C5 | W_NOLOAD | 무부하 자유회전 속도가 스펙 462°/s 근처인지 — FWE 시간표(스윕)가 이 값 전제 | 자유회전 + 로그 |

★확정한 방향 상수는 `lqr_balance_v19.ino`·`fwe_v19.ino` **양쪽에 동일하게** 반영.

### D. 줄 시스템 자유진동 — 주기로 질량표 검증, 진폭 감소로 감쇠
(로봇 없이 크랭크만. 도구: `firmware/free_swing_log` + `calib/serial_logger.py`)

**원리**: 자유진동에서 **주기(진동수 ω)는 복원력/관성의 비**(ω² ≈ S_r·g/I_r)가 정하고,
**진폭이 매 진동 몇 %씩 주는지**는 마찰이 정한다. 연속 피크비의 로그(로그감쇠)에서
감쇠비 ζ, 그리고 I_r을 알면 c_φ = 2ζωI_r 이 나온다. 즉 한 번의 진동 기록으로
**질량표 교차검증(주기)과 감쇠 실측(진폭)** 두 가지를 동시에 얻는다.

**방법 상세**
1. 로봇 없이 크랭크만 프레임에 건 상태에서, 살짝(5~15°) 밀었다 놓고 **10~20회 왕복**을
   기록한다. `python calib/serial_logger.py <포트> crank_free.csv`.
2. `python v19_bringup/params_v19.py` 출력에서 I_r 값을 읽어 둔다(질량표 기반 계산치).
3. `python calib/calib_analysis.py freeswing crank_free.csv --I_pivot <I_r>` → ω, ζ, **c_φ**.
4. 판정:

| 게이트 | 기준 | 미달 시 |
|---|---|---|
| ω²·I_r ≟ S_r·g | 10% 이내 | A8~A12 질량표 재점검 |
| c_φ | **≥ 0.008 N·m·s/rad** 면 확정 시간표(60/20/90/60ms) 유효 | **댐퍼 달지 말 것(연구 방침)** — 실측 c_φ로 `v19_sim/sweep_timing.py` 재실행해 시간표 갱신 |

(감쇠가 왜 중요한가: 잔여 안정모드 진동을 감쇠가 대신 지워 줘야 반복 FEW가 장기
유계가 된다 — c_φ≥0.008에서 실센서 30초 98사이클 성립, NIGHT_LOG 발견 11.)

### E. 게인 생성·검증 (PC, 실측값 입력 후)

1. `python v19_bringup/params_v19.py` — **미실측 항목 0개** 확인 (현재 18개 전부 미실측)
2. `python v19_bringup/compute_gains_v19.py` — `gains_v19.h` 자동 생성·복사 (직접 수정 금지)
3. `python v19_bringup/sim_check_v19.py` — **전부 PASS** (τ피크·서보속도 여유 포함)

### F. 조립 후 자가측정 실험 — 로봇 스스로 "덩어리"를 잰다
(줄 위. 문서 15 절차. 안전요원 1명 상시.)

| 실험 | 물리 원리 | 방법 요약 | 게이트 |
|---|---|---|---|
| 0 백래시 | 기어 유격 = 방향 반전 시 히스테리시스 폭 → **트리거 하한**을 정함 | δ 저속 스윕 0→+5→−5→+5→0° (`B`) | <0.10° 트리거 인하 검토 / 0.10~0.30° 유지 / >0.30° 체결부 재점검 |
| ① 자유 흔들기 | D와 동일 원리를 **조립 상태**에서 — 실측 ω vs 모델 ω_eff가 첫 실물-이론 대조 | 허리 잠금(`L`), 줄 밀었다 놓기; `calib_analysis.py verify` | **±5%** 이내면 진행 |
| ② 기울여 놓기 ★ | 직립 근처 불안정계는 기울기가 **e^{λt}로 성장** — 기울기 로그의 기울기가 λ_u. 좌고유벡터 적합으로 위험가중치 w도 동시 산출 (질량표 오차 중 γ가 못 흡수하는 유일한 부류 = w 회전을 정면 제거) | 직립 0.5° 이내 → `m`(마커) → 놓고 0.3~0.5s 뒤 잡고 `m`. 좌우 번갈아 **10회+** | λ_u vs 모델(~6.4/s) **±15%**, 시도 산포 ±10% |
| ③ 매달고 허리 흔들기 | τ = I·α: 발이 뜬 채(중력·줄 분리) 알려진 토크로 흔들면 **각가속도에서 I_δ** — 기어 너머 회전자 관성(armature ≈ ×45,200)이 자동 포함. 명령-응답 잔차가 마찰(점성 b, 쿨롱 c). **권장 Profile Acceleration = 가용토크 ÷ I_δ** | 몸통 지그 고정, `3`(계단 ±5/10/20° + 삼각 왕복 자동) | 권장 가속도 vs 설정 ±20% 밖이면 `a <새값>`; 적합 잔차 ≤ 토크의 ~10% |
| ④ 사이클 캘리브 ★ | γ = "접기각이 위험도 A를 줄이는 비율". (δ_f, ΔA) 쌍들의 **최소제곱 적합**. 진폭별 γ(A) 보간표로 잰다(소각 γ가 55° 포화에서 무너진 교훈). 부산물 σ_A(실행 산포) → **트리거 = 1.2~1.5×σ_A** | 다양하게 기울여 놓고 `f <접기각>` 1사이클. **접기각을 기울기와 무관하게 6/10/14° 섞기**(비례시키면 Gc·gc가 한 직선 위 = 공선성으로 분리 불가). 20사이클+ | 공선성 경고 시 재실험; Gc ≟ e^{λ_u·사이클시간} 구조 점검; γ(A) 구간차 5%+면 보간표 탑재 |

⚠ γ 관련: `fwe_preset`의 γ=22.7/Gc=15.8은 **L1=0.25 기준 캘리브 값** — 현행 L1=0.259에서
소폭 어긋남. 실험 ④가 어차피 γ를 재캘리브레이션하므로 **④를 생략하지 말 것**(1노브 RLS가
잔여를 흡수하지만 초기값은 ④ 결과로).

### G. 최종 (브링업·시연)

- LQR: 부팅 로그 1Mbps·RATE≈500Hz·GAINS_MEASURED 경고 없음 → 'd'→'z'→'c',
  gain 0.3→1.0 점진, CUR_SAFE 600→855
- FWE: 모드 3(반복 FEW)이 기본. 모드 1 조기 발산은 이론적으로 정상(대기가 오차를 e^{λT}배 증폭).
- **버티기 분포**: 시작 기울기 20개 × 시간 기록 — 한 판의 기록이 아니라 **분포**(중앙값·최장·
  아래꼬리)가 결과다. 보고서 Ⅳ-5 라의 【 】가 여기서 채워진다.

---

## 3. 권장 진행 순서 (하루 단위 예시)

| 시점 | 할 일 |
|---|---|
| 조립 전·중 | A8~A11(줄 부품 질량) → 소조립마다 A1~A7 (★상체는 장비 매립 완료 후) |
| 하체·상체 완성 직후 | B1·B2 복합진자 |
| 전장 연결 직후 | C1~C5 방향·단위 (30분) |
| 프레임에 크랭크만 | D 자유진동 (로봇 올리기 전) |
| PC | E 게인 생성·PASS |
| 로봇 장착 첫날 | ①(verify ±5% 게이트) → 0 → ② → ③ → ④ → 펌웨어 상수 반영 |
| 이후 | G. LQR → FEW → 버티기 분포 |

---

## 4. 주의 (전 원본 문서의 함정 모음)

1. **값은 params_v19.py 한 곳에만**, `gains_v19.h` 직접 수정 금지 (반드시 compute_gains 경로).
2. **CoM 기준점**: ℓ₁은 발축, ℓ₂는 힙축. 헷갈리면 K가 통째로 틀어진다.
3. **상체 실측은 장비 매립 후** (m₂·ℓ₂·I₂·ELL_IMU 전부).
4. 방향 상수(ENC_PHI_DIR/ENC_ANK_DIR/IMU_DIR/MOTOR_DIR)는 **두 제어 스케치에 동일하게**.
5. 실측 전 게인(GAINS_MEASURED=0 경고) 상태로 **로봇을 줄에 올리지 말 것**.
6. c_φ 미달 시 댐퍼가 아니라 **시간표 재스윕**이 연구 방침(문서 15).
7. 엔코더는 실물 AS5047P(14bit) — params의 "AS5048A 가정" 표기는 동일 14bit라 값 영향 없음.
   방향·영점은 C1·C2에서 어차피 실측 확정.
8. 실험 ④ 공선성: 접기각을 기울기에 비례시키면 Gc·gc가 분리 안 됨 — 반드시 3단 섞기.
9. L2 공칭 확인: params L2=0.40 vs CAD robot_l2=372mm 이력 — **실측으로 확정하고 시뮬/FW 동기**.
10. **v5.11 재출력 미반영 주의**: 발목 L-브래킷·캐리어를 구형 출력물로 둔 채 m₁·I1_cm을 재면
    그 값이 실물과 어긋난다. 신형(bracket v5.2 / carrier v5.3) 장착 후 측정할 것.
11. 복합진자·자유진동은 **작은 각도**에서만 공식이 성립 — 크게 흔들면 주기가 진폭에
    의존해(비선형) I·c가 왜곡된다.

---

## 5. 리포 현황과 갭 (2026-07-29 조사)

| 자산 | 상태 |
|---|---|
| `v19_bringup/params_v19.py` + calib 2종 + firmware 5종 + compute/sim_check | ✅ 리포에 있음 |
| `opencr_test/torque_cal` | ✅ 있음 (재사용) |
| **`exp_selftest_v19.ino` / `exp_analysis_v19.py`** (실험 0·②③④ 전용, 문서 15가 "배포"라 명시) | ❌ **리포에 없음** — 커밋 필요. 없으면 실험 ①·C1~C4만 기존 도구로 가능 |
| **`exp_logger.py`** (문서 15·17에서 참조) | ❌ 없음 — `calib/serial_logger.py`로 대체 가능(D행 프리픽스 처리 확인 필요) |
| **`motor_profile_test/` · `motor_triangle_test/`** (문서 17, 사다리꼴/삼각형) | ❌ 없음 — 문서 17 부록에 전문 수록, 리포 반영 필요 |
| `docs/실측_캘리브레이션_절차_20260620.md` | ✅ 있음 (원리 상세 — v11_small 기준이라 절차는 본 문서 우선) |

**다음 액션 제안**: 문서 15·17의 신규 코드 5종을 리포에 커밋(별 작업) →
그 전까지는 2장 C2의 대체 경로·serial_logger 대체를 사용.

---

## 6. 기록 시트 (측정하며 채우기)

| 항목 | 값 | 단위 | 날짜/서명 |
|---|---|---|---|
| m₁ / m₂ | 【 】/【 】 | kg | |
| L₁ / L₂ | 【 】/【 】 | m | |
| ℓ₁ / ℓ₂ | 【 】/【 】 | m | |
| I1_cm / I2_cm | 【 】/【 】 | kg·m² | |
| ELL_IMU | 【 】 | m | |
| R | 【 】 | m | |
| crank_m_each / crank_L | 【 】/【 】 | kg / m | |
| bottom_m / top_socket_m / top_socket_ell | 【 】/【 】/【 】 | kg / kg / m | |
| c_φ (크랭크 단독) | 【 】 | N·m·s/rad | |
| ENC_PHI_DIR / ENC_ANK_DIR / IMU_DIR / MOTOR_DIR | 【 】/【 】/【 】/【 】 | ± | |
| Kt (검증) / W_NOLOAD | 【 】/【 】 | N·m/A / °/s | |
| 백래시 | 【 】 | ° | |
| ω_eff (실측/모델) | 【 】/【 】 | rad/s | |
| λ_u (실측/모델) / w | 【 】±【 】/【 】 / 【 】 | 1/s | |
| I_δ / b / c / 권장가속도 | 【 】/【 】/【 】/【 】 | — | °/s² |
| Gc / gc / γ / γ(A) / σ_A / 새 트리거 | 【 】/【 】/【 】/【 / / 】/【 】/【 】 | — | |
| 버티기 분포 (중앙값/최장) | 【 】/【 】 | s | |
