cbshbalance/slackline-balacing1/docs/cowork/37_인수인계검토_오늘작업계획_20260805.md

# 인수인계 검토와 오늘 작업 계획 (2026-08-05)

> 전임자 인수인계(실험② 수행, 데이터 260805WED) 검토 결과와 확인사항·과제 정리.
> 근거: 문서 15·19·26·30·33·34, 리포 확인, 8/5 데이터 품질 검사·정합점검.

## 1. 현재 위치

- 실험①(자유 흔들기): 7/28 완료 (문서 16). 크랭크 단독 로그 `0729_crank_r1~r5.csv`.
- 실험③/M2(허리 관성): 7/31 진동 발견 → I_δ=0.045±0.008 **잠정**, 지그 보강 재측정 대기 (문서 23·33). 8/2 로그 `0802_exp3_r1~r4.csv`.
- 실험②(기울여 놓기): 8/5 1차 데이터 사용 불가(2절) → **배선 수리·점검 통과·정합점검 완료, 재실험(r4~) 직전 단계.**
- 실험④: 미실시 — 실험②의 λ_u·w가 입력.

## 2. 8/5 1차 실험② 데이터 — 전량 사용 불가 (wiring_check --selftest)

r1: 발목 고정(179.978°)+마커 1개 / r2: 0바이트 / r3(336s 본실험): φ·발목 전 구간 0, 마커 76개(절차는 완벽).
발목 배선 문제는 8/2 로그부터 지속. → 배선 수리 후 wiring_check 통과함(8/5 오후). 영상(mp4)은 보존.

## 3. ★부호 규약 — 정합점검 완료 (8/5 확정, 시각화: repo docs/부호규약_한장정리_20260805.html)

| 항목 | 확정값 | 근거 |
|---|---|---|
| φ+ 방향 | 정한 +방향으로 줄 밀면 화면 φ+ | (a) Δφ=+7.56°(1차)·+21.16°(2차) 일관 |
| 발목 부호 | s=+1, 즉 ank = α−φ 형 → **--alpha = ank+phi** | (b) 2차 Δank=+5.60° (일자 잠금·직립 영점). 1차 −178°는 영점 뒤집힘 폐기 |
| MOTOR_DIR | **+1 유지** | (c) 1차 Δδ=+58.10° + 펌웨어 torque_cal 확정값 일치. 2차 −81°는 동작 실수 폐기 |

⚠주의: exp_analysis 기본값은 ank-phi지만 **실측 확정은 ank+phi** — 분석 시 반드시 명시:
`python exp_analysis_v19.py exp2 <csv> --params v19_bringup --alpha ank+phi`
(b)는 φ≈0 조건이라 조합 구분 불가 — 조합은 기하(발목각=α−φ)+실측 부호로 결정했음. 선택 검증법:
몸 세운 채 줄만 +로 밀면 ank가 −로 가야 한다.

## 4. 오늘 과제 (갱신)

- A′. ~~배선 수리·점검~~ 완료 → **실험② 재실험 (0805_exp2_tilt_r4~)**: k·z·s → [m 놓기/잡고 m]×좌우 10회+ → s·quit.
- B. exp2 분석(--alpha ank+phi) → λ_u(모델 ~6.4/s ±15%, 산포 ±10%)·w → 완전판 절차서(docs/)·params 기입.
- C. 완료: params 줄감쇠 정정(`dfb62a8`) / exp_data 신설·인수(`7316df9`) / wiring_check(`7a49fe5`→`85edcab`) / phi_ank_monitor(`d2d6b73`) / 재실험 절차서(`bf6a082`) / 부호규약 문서·확정(`ff5ab74`→`a0b057c`).
- D. 남은 실험 (문서 33 순서): 엔코더-간극 판별 → 백래시 → 실험④ → M2 재측정(지그 보강) → Kt·무부하.
- 이후: params 전량 반영 → compute_gains → sim_check PASS → LQR → 비동기 FWE → 버티기 분포.

## 5. 메모

- push는 토큰 `http.extraheader`(Basic) 필요, author `Claude <noreply@anthropic.com>`.
- tilt_release_test 명령: k=허리잠금, u=토크해제, z=영점(★직립·정지에서만), s=스트리밍, m=마커, t=상태.
  D행=`D,t_ms,phi,ank,del,vel,cur`(vel·cur=0). 발목 간헐 드롭아웃(raw=0→±180°) 존재 — 분석에서 |점프|>90° 필터.
