cbshbalance/slackline-balacing1/docs/cowork/38_실험2_결과_람다u_w_20260806.md

# 실험② 결과 — 넘어짐 속도 λ_u · 위험가중치 w (2026-08-06)

> 데이터: `0806_exp2_tilt_r1.csv` (83,838 D행, 164Hz, 511s). 배선 수리 후 재실험.
> 부호: --alpha **ank+phi**, MOTOR_DIR=+1 (8/5 정합점검). 실측 질량표 p1=0.17510, p2=0.12280, h=0.3972.

## 결과

| 항목 | 값 | 게이트 | 판정 |
|---|---|---|---|
| **λ_u (전체 14시도)** | **6.68 ± 2.90 /s** (중앙값 **6.43**) | 모델 ~6.4 ±15% | **통과 (+4%)** |
| λ_u (코어 창 0.22~0.55s, 10시도) | 6.37 ± 1.45 /s | — | 모델과 사실상 일치 |
| 좌/우 분리 | 우 7.79±2.37 (8) / 좌 5.20±2.88 (6) | — | 우>좌 경향, 표본 내 유의성 낮음 |
| 시도 간 산포 | 43% (코어 23%) | ±10% | **미달** — 아래 원인 분석 |
| **w (φ,β,φ̇,β̇; β=1 정규화)** | **(−0.3655, 1, −0.0690, 0.1287)** | — | β̇계수 0.129 ≈ 1/7.8 ≈ 1/λ — 예측점 이론과 정합 |

**실험④용 인자: `--lam 6.679 --w -0.36547,1.00000,-0.06896,0.12867`** (보수적으로 λ=6.4~6.7 사용 권장)

## 해석

- **λ_u 중앙값 6.43/s = 모델 6.4/s와 0.5% 일치.** 배가시간 ~0.10초. 질량표(7/30-31 실측)가 옳다는 첫 실물 검증.
- w의 β̇ 성분이 1/λ에 근접 — "예측점 A=β+β̇/λ" 구조가 실물 데이터의 주성분에서 저절로 나옴(이론 정합). φ 성분 −0.37은 불안정모드의 φ-β 혼합 반영.
- 산포 게이트(±10%) 미달의 원인은 물리가 아니라 **측정 창 품질**: 짧은 창(<0.22s)은 적합 분산↑(10.98·13.43), 긴 창(>0.55s)은 놓기 전 손 흔들림 혼입(2.4~3.4). 코어 창만 보면 23%.

## 분석 방법 특이사항 (재현 시 필수)

1. **마커 60개 중 앞 26개는 스트리밍 OFF 상태에서 찍혀 D행 없음** → 데이터 범위 안 34개(17쌍)만 사용. 다음부터 s를 먼저 켜고 시도 시작.
2. **발목 영점이 드롭아웃 중에 잡힘**(z 순간 raw=0 → 이후 정상 판독이 +177° 부근) → 구간별 처리로 무해화. 다음부터 z 직전 t 명령으로 ank 판독 정상 확인.
3. 글리치: 구간별 롤링 중앙값(medfilt5, 편차>20° 교체, 총 41샘플). 전역 전방 채움은 비트리얼 구간의 실제 큰 각도 변화에 연쇄 오염 → 금지.
4. **적합 창**: |β| 5° 도달점에서 단조 성장 시작점까지 역추적(놓기 전 흔들림 배제), 소각 클리핑 |β|≤5~6°. 예측점 진폭 |β+β̇/λ| 2패스 적합(안정모드 진동 제거).
5. 잡기 각도는 10~30°까지 가도 무방(그 구간은 적합에 안 씀) — 8/6 완화 프로토콜 유효 확인.

## 남은 것

- (선택) 산포 게이트 정식 통과를 원하면: 코어 창 조건(놓기 전 1초 정지 유지)으로 10회 추가 — 30분.
- 실험④(사이클 캘리브레이션)로 진행 가능 — 위 인자 사용. 트리거·γ는 fwe_async_v19.ino 기본값에서 시작.
- w를 fwe_async_v19.ino의 W0~W3 상수에 반영: W0=-0.3655, W1=1, W2=-0.0690, W3=0.1287, LAMBDA_U=6.68.
