cbshbalance/slackline-balacing1/docs/cowork/39_FWE_실기브링업_1일차_로그_20260806.md

# 비동기 FWE 실기 브링업 1일차 로그 (2026-08-06)

> 줄태우기 첫날 r1~r11의 문제-수정 사슬. 펌웨어 `fwe_async_v19.ino` 커밋 이력과 1:1 대응.
> 다음 세션은 이 문서와 문서 38(실험② 결과)만 읽으면 이어받을 수 있음.

## 판별 이력 (각 판 로그로 확정)

| 판 | 증상 | 원인 | 수정 (커밋) |
|---|---|---|---|
| r1 | 첫 접기 후 모터 무력 | FALL 안전컷 후 재개(g) 안내 부재 + 손으로 잡은 채 폭주(정상) | 안내 출력·RAIL 경고·LOCK 150ms (`b12330b`) |
| r3 | "접는 동안 이미 넘어감" | 증분 12°/150ms 캐던스 → 유효 접기 80°/s (서보는 정상, 지연 0.1s) + 손 뗄 때 이미 A=−2.5 | STEP_CAP 22°·LOCK 120ms·프로파일↑·무장→자동 GO (`52facd4`) |
| r4 | 모터 정지(GO 불발) | 5ms 차분이 엔코더 양자화(0.022°) 증폭 → A 잡음 ±1~2°로 조용 판정 불가능 | 25ms 기저 미분+EMA·A 저역필터·게이트 완화 (`d915ab7`) — r4 재생 검증 |
| r5/r7 | GO 불발·r 무반응·가짜직립 추격 | A에 −5~−7° 상수 편향(z영점≠실균형+줄 데드밴드) + r이 무장 중 미전송(버그) | 자동 트림(GO 시 잡은 자세=기준)·정상범위 게이트·r 수정·실행완료 게이트 (`552c86d`) — r5 재생 GO+0.3s |
| r8 | A 무한 증가, g 재실행 불가 | ★발목 엔코더 재고장(30~90° 점프 744회/20s) — 하드웨어 | 각속도 물리클램프·A±60·SENSOR 자가진단 (`0fe82d4`) → **배선 수리 완료(r11 확인)** |
| r11 | 시소 운전(δ 상한↔반대상한) | 자세 되먹임: 접기→β가 δ 따라 증가(β 안에 θ=α+δ)→재트리거, 루프이득 K×P2R≈5 / 줄 정지마찰(0.34° 데드밴드)이 작은 킥 흡수 → 접기가 발을 못 던짐 | 접기방향 토글 `d` 추가 (`7291fcc`) — 아래 2레짐 시험 예정 |

## ★첫 폐루프 생존 기록 (r11, 8/6, 배선 수리 후)

| 판 | 생존 | 비고 | | 판 | 생존 | 비고 |
|---|---|---|---|---|---|---|
| 1 | **12.79s** | r 수동개입 포함 | | 5 | 0.54s | 센서 튐 낙하판정 |
| 2 | 0.66s | 자율 | | 6 | 0.97s | 자율 |
| 3 | **4.75s** | 자율 | | 7 | **9.79s** | r 수동개입 포함 |
| 4 | 2.52s | 자율 | | | | |

운전 형태는 시뮬과 다른 **δ±40° 시소(bang-bang)** — 그래도 버팀. 센서: 224초에 점프 27회(수리 전 20초에 744회).

## ★다음 시험 — 2레짐 비교 (각 5판+, 생존시간 기록)

**레짐 A (저이득 FWE):** `-` 연타로 K=2~3 (루프이득 K×0.41<1 → 시소 구조적으로 불가). 방향은 기본(FWE).
**레짐 B (역방향 가설):** `d`(역방향: CoM 되돌리기, 선 사람 방식) + K 6~8.
가설: 줄이 정지마찰로 붙어 있는 소진폭에서는 B가, 줄이 움직이는 대진폭에서는 A(FWE 방향)가 유리 —
"광대는 작은 기울기는 몸으로, 큰 기울기만 발던지기로"라는 서사와 연결될 수 있는 관찰(보고서감. 단 5판씩 데이터로 확정 후).

## 물리 메모

- 느린 접기는 킥이 아니라 자세 변화(§2.2). r11의 시소는 자세 되먹임의 필연 — 킥이 줄 정지마찰을 못 깨면
  측정 β가 δ를 따라가며 재트리거된다. 시뮬에 정지마찰 데드밴드가 없어서 이 레짐이 안 보였음(문서 27의
  건마찰 실측 0.34°/반주기가 바로 이 원인 — S1 재검 때 "위치모드는 둔감" 결론이었으나 트리거 상호작용은 남아 있었다).
- 시소 운전으로도 12.8s 버틴 것은 ±40° 대접기가 결국 줄을 움직인다는 뜻 — 대진폭에서는 FWE 킥이 실존.
