cbshbalance/slackline-balacing1/docs/cowork/43_v20제작중_정정발견_4건_조치목록_20260813.md

> 문서 42(v20 시뮬 신설 기록)에서 발견 부분만 뽑아 **검토·조치용으로 재정렬**한 판.
> 수치·근거는 42와 동일하고, ①에 v19 캘리브레이션 코드 근거와 서사 영향 정량이 추가됐다.

# v20 시뮬 제작 중 나온 정정·발견 4건 — 검토용 정리 (2026-08-13)

> 출처: `v20_pred_plane/` 를 만들며 `v19_bringup/model_v19.py` 를 이식·검증하는 과정.
> v19 폴더는 읽기만 했고 수정하지 않았다. 재현: `verify.py`(물리), `ref_calc.py`(기준값).

---

## 한눈에 보기

| # | 내용 | 판정 | 영향 받는 곳 | 급한 정도 |
|:--:|---|:--:|---|:--:|
| ① | `fwe_map_constants` 의 γ_cyc 이 e^{λT_rest} 배 과대 | **확정** | 보고서 Ⅹ-1 서사, `gains_v19.h`, `fwe_v19.ino` | 중 |
| ② | 감쇠 포함 예측점 일반형 — 문서 41 '남은 일 ②' 해소 | **확정** | 보고서 Ⅸ장, 문서 41 | 낮음 (긍정) |
| ③ | 실측정본 λ_u 가 문서 38과 10% 어긋남 | **미해결** | γ 전체, 실기 트리거·접기량 | **높음** |
| ④ | 실기 파라미터 δ_f\* 지도 산출 — 문서 41 '남은 일 ①' 해소 | **완료** | 펌웨어 상수 2개 | 중 (①③ 선행) |

**의존 관계: ③ → ① → ④.** λ_u 가 확정돼야 γ 가 확정되고, γ 가 확정돼야 펌웨어 상수를 박을 수 있다.

---

## ① γ_cyc 이 e^{λT_rest} 배 과대하다 — 확정

### 무엇이 문제인가

`model_v19.fwe_map_constants` 는 사이클 맵 `A⁺ = G_cyc·A⁻ − g_cyc·δ_f` 의 두 상수를
**서로 다른 구간에서** 잰다.

```python
A_end2, _ = _simulate_A(F, b, w, lu, sched, zero)   # sched = 접기+대기+펴기 (휴지 없음)
gc = -A_end2
Gc = float(np.exp(lu * (Tf + Tw + Te + Trest)))     # ★휴지 포함
```

휴지는 자유 전개이므로 그 사이 A 는 e^{λT_rest} 배가 된다. **g 에도 같은 배율이 붙어야**
짝이 맞는데 지금은 G 에만 붙어 있다. 따라서 γ = G/g 가 그만큼 부풀어 있다.

### 근거 — v19 자신의 캘리브레이션 코드

`v19_sim/sim_engine.py` 의 `fwe_autocal()`, 즉 실측 γ\*=18.6 을 만든 함수:

```python
if ph0 == PH_IDLE  and phase == PH_FOLD  and Ap is None:
    Ap, dfp = self.risk_A(xe), self.fwe["df"]     # A⁻ = 트리거 시점
if Ap is not None and ph0 == PH_REST and phase == PH_IDLE:
    rows.append((Ap, dfp, self.risk_A(xe)))        # A⁺ = ★휴지 끝
```

**실측 맵은 접기→대기→펴기→휴지 전체 구간**이고 G\*·g\* 짝이 같은 구간에서 나온다.
실측이 정합이고 이론이 부정합이다.

### 수치

| 세트 (시간표) | v19 γ_cyc | 정정 γ_cyc | 비 = e^{λT_rest} |
|---|---:|---:|---:|
| 로봇 · 설계추정 (60/20/90/**60**) | 39.382 | **26.875** | 1.465 |
| 로봇 · 실측정본 (150/20/90/**60**) | 24.693 | **17.423** | 1.417 |
| 문서 08 시간표 (80/60/80/**50**) | 30.03 | **21.86** | 1.372 |
| 사람 스케일 (T_rest = 0) | — | 동일 | 1.000 |

정정 후 δ_f = γ_cyc·A 가 사이클 끝에서 A 를 **1e-11°** 로 지운다(deadbeat 검증 통과).
정정 전 잔여는 −2.71° 였고, 이 알람이 문제를 드러낸 계기다.

### 서사에 미치는 영향

문서 08 시간표 기준, 실측 γ\* = 18.6 대비:

| | γ | 실측 대비 | g 로 보면 |
|---|---:|---:|---|
| v19 공칭 (부정합) | 30.0 | **1.61배** | 문서의 "실행 킥 +44%" |
| 정정 공칭 | **21.9** | **1.18배** | **약 +13%** |

**"이론 28.9 vs 실측 18.6" 갭의 대략 3/4 이 장부 오류이고, 실제 실행 갭은 나머지 1/4 정도**로 보인다.

### 왜 v19 때는 안 드러났나

1. **이론 γ 로는 원래 안 섰다.** NIGHT_LOG 기록대로 공칭 γ FWE 는 발산했고 γ\* 로 바꾼 뒤에야
   유계가 됐다. γ 가 1.46배 크면 과접기 → 유효 ρ 가 수축창 밖 → 발산. 증상이 정확히 그랬는데
   그 발산이 전부 "실행 프로파일 갭" 으로 해석됐다.
2. **가장 강한 검증(결정 실험)이 이 자리를 비껴간다.** "실제 δ(t) 를 이론식에 넣으면 0.16° 일치"는
   **마스터 전파법칙**을 한 궤적 위에서 검증한 것이다. 문제는 전파법칙이 아니라
   **(G, g) 를 어느 시점에서 재느냐**이므로 궤적 검증으로는 잡히지 않는다.
3. **model_v19 의 assert 3개가 전부 구조 검산이다** (φ행 δ열=0, G의 δ열=0, 무질량 극한 ε\* 복원).
   "δ_f = γ·A 를 넣고 실제로 돌리면 A⁺=0 인가" 라는 자기일관성 검사가 없다.

### 아직 확정 아닌 부분

문서 08 의 공칭 g = 0.197 과 v20 계산 0.184 가 **7% 어긋난다**(파라미터 세대 차로 추정).
45사이클 최소제곱을 재현한 것도 아니다. 위 "3/4" 는 **자릿수 추정**이다.

### 조치

- [ ] `v19_sim` 에서 `fwe_autocal()` 재실행 → (Gc\*, gc\*) 를 뽑아 정정 공칭과 대조 → 갭의 실제 분해 확정
- [ ] 보고서 **Ⅹ-1**("이론 무죄, 범인은 실행" / γ 28.9→18.6 / g +44%) 서술 재검토
- [ ] `compute_gains_v19.py` 가 `GAMMA_CYCLE` 을 `gains_v19.h` 로 내보내고 `fwe_v19.ino` 가
      `delta_target = RHO_GAIN * gamma * A` 로 그대로 쓴다 → **부팅 기본값이 1.46배 과접기**.
      (현행 브링업의 `fwe_async_v19.ino` 는 K 를 손으로 잡으므로 당장 위험은 없다.)

---

## ② 감쇠 포함 예측점 일반형 — 문서 41 '남은 일 ②' 해소 · 확정

### 문서 41 이 물었던 것

불안정 모드를 읽는 벡터가 프로젝트 안에 **두 개** 있다.

| | u₂ (문서 41 의 지도) | w (문서 16·38·실기) |
|---|---|---|
| 어디서 | **무감쇠** 2×2 `A₂ = M₂⁻¹G₂` | **감쇠 포함** 4×4 `F₄` |
| 차원 | 2 (위치만) | 4 (위치 2 + 속도 2) |

문서 41 의 닫힌형 `δ_f* = −u₂ᵀq_pred/(k·u₂ᵀe)` 는 u₂ 를 쓰는데 실기는 w 를 쓴다.
**바꿔 끼워도 형태가 살아남는가?** — 단순 계수 문제가 아닌 이유는, 무감쇠에서는
`u₂ᵀq_pred = 2A` 라는 **등식**이 성립해서 "예측점이 안정선 위 ⟺ A=0" 그림이 정확했기 때문이다.
이 등식이 깨지면 평면 위 직선이라는 그림 자체가 무너진다.

### 답 — 형태는 살아남는다, 단 예측점의 정의가 바뀐다

w = (w_q, w_v) 로 쪼개고 `wᵀF₄ = λwᵀ` 를 블록으로 쓰면

```
w_v A₂ = λ w_q
w_q + w_v D̂ = λ w_v      →   w_q = w_v (λI − D̂)
```

따라서

$$A \;=\; w_q\!\cdot\! q + w_v\!\cdot\!\dot q \;=\; w_q^{\mathsf T}\Big[\, q + (\lambda I - \hat D)^{-1}\dot q \,\Big]$$

D̂ = 0 이면 w_q = λw_v 이므로 **기존 q + q̇/λ 가 정확히 복원**된다.
u₂ 자리에 w_q(β성분=1 정규화)를 넣고 예측점을 위 형태로 일반화하면
`δ_f* = −A/(k·w_qᵀe)` 가 그대로 성립한다.

### 실제로 필요했다는 증거

로봇 실측정본의 w = (0.6043, 1, **0.1040**, **0.1686**), λ_u = 5.813:

| 성분 | 값 | w_q/λ | 일치? | 왜 |
|---|---:|---:|:--:|---|
| w_φ̇ | 0.1040 | 0.1040 | **일치** | c_φ ≈ 0 → φ행 감쇠 거의 없음 |
| w_β̇ | 0.1686 | 0.1720 | **불일치** | B_θ = 0.01 이 β행에 감쇠를 만듦 |

두 행이 다르게 어긋나는 것이 이 구조의 지문이다. 단순 `q + q̇/λ` 로 찍으면 A 와 어긋난다.

### 부수 효과

**안정선(A=0)의 기울기가 무감쇠 r 과 미묘하게 다르다.**
설계추정에서 r = −1.5347 인데 A=0 선은 φ = −1.5552·β 다.
판정선이 곧 그림이어야 하므로 v20 은 초록선으로 **A=0 선**을 그린다.

문서 41 의 예상("계수만 바뀔 것")은 **절반 맞았다** — 계수만이 아니라 예측점의 정의도 바뀐다.

### 조치

- [ ] 문서 41 §4-2 를 "해소" 로 기록
- [ ] 보고서 **Ⅸ-2** 의 예측점 정의에 감쇠 일반형 병기 (현재는 q + q̇/λ 만 적혀 있다)

---

## ③ 실측정본 λ_u 가 문서 38 과 10% 어긋난다 — 미해결 · 가장 급함

### 무엇이 어긋나나

| 출처 | λ_u | 배가시간 |
|---|---:|---:|
| v20 계산 (문서 40 §4-2 실측 정본 입력) | **5.813 /s** | 119 ms |
| 문서 26 (8/1) | 5.8 /s | 119 ms |
| **문서 38 (8/6) "모델 ~6.4"** | **6.4 /s** | 108 ms |
| 문서 38 실측 (실험②, 14시도) | 중앙값 **6.43** · 평균 6.68 | 108 ms |

문서 38 은 "λ_u 중앙값 6.43 = 모델 6.4 와 0.5% 일치 → 질량표가 옳다는 첫 실물 검증" 이라고
결론지었는데, 같은 질량표로 다시 계산하면 5.81 이 나온다.

### 질량표는 문제가 아니다

문서 38 이 명시한 파생값을 v20 이 **그대로 재현**한다:

```
p₁ = 0.17510   p₂ = 0.12280   h = 0.3972      ← 세 값 모두 일치
```

원인은 질량표가 아니라 **I_r(줄 관성) 또는 I₂_cm(상체 관성)의 세대**다.
v20 은 I_r = 4.50e-3(문서 21 정본), I₂_cm = 2.116e-2 를 썼다.

### 왜 급한가

**모델이 실측보다 10% 느리게 넘어진다**는 뜻이다. G = e^{λT} 가 작게 나오고
γ = G/g 를 낮게 잡아 **과소접기**가 된다. ①의 정정과 방향이 반대라 상쇄되지도 않는다 —
두 오차가 독립적으로 γ 를 흔든다.

### 조치

- [ ] 문서 38 의 "모델 6.4" 를 낸 계산에 쓰인 **I_r 과 I₂_cm 값** 확인
- [ ] 확정되면 v20 의 `robot_measured` 세트와 `params_v19.py` 양쪽에 반영
- [ ] 필요하면 실험①(줄만 흔들기, 로봇 장착 후 ω_eff)로 I_r 교차 검증

---

## ④ 실기 파라미터 δ_f\* 지도 — 문서 41 '남은 일 ①' 해소 · 완료

$$\delta_f^*[\deg] \;=\; c_\beta\,\beta_{\text{pred}} \;+\; c_\varphi\,\varphi_{\text{pred}}$$

| 세트 | c_β | c_φ | r (무감쇠) | k |
|---|---:|---:|---:|---:|
| 사람 스케일 R=0.7 (문서 41 재현) | 13.029 | 6.148 | −2.1194 | 0.21748 |
| 로봇 · 설계추정 | 9.533 | 6.130 | −1.5347 | 0.21424 |
| **로봇 · 실측정본** | **6.144** | **3.713** | −1.6344 | 0.35167 |

사람 스케일 값이 문서 41 과 **차이 ≤ 0.02%** 로 일치하는 것으로 이식이 검증됐다.

### 함께 나온 주의사항 — 문서 41 의 k 식을 로봇에 그대로 쓰면 안 된다

문서 41 은 `k = μ·M_t R²/det M₂` 로 적었는데 이는 **무질량 줄 전용**이다.
줄 관성이 있으면 M₂[φφ] = M_tR² + I_r 이므로 일반형은

```
Δq = k·δ_f·e ,   e = (s, −1),   s = M₂[φβ]/M₂[φφ] ,   k = μ·M₂[φφ]/det M₂
```

I_r = 0 이면 s = h/R, k = μM_tR²/detM₂ 로 문서 41 의 식이 정확히 복원된다.
**그대로 쓰면 설계추정 세트에서 10.7% 틀린다.**

### 조치

- [ ] 펌웨어 상수 2개로 박을 때 **실측 γ\*/이론 γ 비를 어디에 곱할지** 결정
      (k 를 실측 킥계수로 바꾸는 쪽이 물리적으로 정직하다)
- [ ] ⚠ 그 비를 계산하려면 **①의 정정과 ③의 λ_u 확정이 선행**돼야 한다 — 지금 박으면 틀린 눈금이 박힌다
- [ ] 보고서 Ⅸ장에 그림 9-5 로 삽입 검토 (문서 41 '남은 일 ③')

---

## 조치 우선순위

| 순서 | 할 일 | 걸리는 시간 | 왜 이 순서인가 |
|:--:|---|---|---|
| 1 | ③ 문서 38 의 I_r·I₂_cm 확인 | 짧음 (문서·코드 대조) | λ_u 는 γ 를 포함한 모든 것의 입력 |
| 2 | ① `fwe_autocal()` 재실행해 갭 분해 확정 | 중간 (시뮬 재실행) | 보고서 서사가 여기 걸려 있다 |
| 3 | ④ 펌웨어 상수 2개 확정 | 짧음 | 1·2 가 끝나야 눈금이 맞는다 |
| 4 | ② 보고서 Ⅸ-2·문서 41 에 반영 | 짧음 | 서술 정비 (수치 영향 없음) |

---

## 부록 — v20 안에서만 고친 것 (v19 와 무관)

| | 내용 |
|---|---|
| A | **적분 정확도**: 삼각 프로파일의 δ̈ 는 조각상수다. 좌단점 샘플 + `t<=0→0` 예외로 RK4 를 돌리면 접기 킥 g 가 최대 17% 깎인다(dt=0.5 ms). 스텝 수를 **짝수로 양자화하고 스텝 중점에서 샘플**하면 dt 를 2e-5~1e-3 로 바꿔도 g 가 소수점 8자리까지 같다. |
| B | **궤적 좌표 전치**: v20 초판에서 궤적만 (β,φ) 축이 뒤바뀌어 그려지고 있었다(현재 점 마커는 옳았다). 회귀 테스트 추가. |
| C | **줄 건마찰 미모델**: 문서 27 의 결론은 "감쇠는 건마찰 우세(반주기당 0.34°), 점성은 ζ=0.0076뿐" 인데 v19 모델에는 점성 c_φ 만 있다. v20 에 쿨롱 항 `τ = −τ_c·tanh(φ̇/ε)` 를 넣었다(γ 캘리브레이션에서는 끈다 — γ 는 선형 상수). v19 에 되먹일지는 별도 판단. |
| D | **B_θ 의 자리**: v19 모델은 힙 점성을 θ 절대회전의 감쇠로 두는데, 물리적으로는 δ̇ = θ̇ − α̇ 에 걸리는 게 맞다. v20 은 이식이라 그대로 뒀다 — 확인 대상. |
