cbshbalance/slackline-balacing1/docs/cowork/52_발표영상_광고컷_v1_20260817.md

# 52. 발표 영상 광고컷 — 러프컷 210 s → 87 s 재편집 (2026-08-17)

> 산출물: **`광고컷_v2_20260817.mp4`** (1280×720, 30 fps, **87.3 s**, 30컷, 무음)
> 소스: 문서 48의 `러프컷_v0.1.mp4` (210 s) + 실사 사진 1장. **발표 앱(`presentation/`) 소스 없이** 기존 mp4만 재편집·오버레이해서 만들었다.
> ⚠️ v1 은 **원호의 평면을 틀렸다**. §3-A 참조 — 정정본이 v2 다.

---

## 1. 왜 다시 잘랐나

러프컷은 설명 순서대로 흐르는 210 초짜리였다. 요구는 **"광고처럼 빠른 전환으로 사로잡을 것, 1분~1분30초"**.
바꾼 것은 세 가지다.

1. **속도와 컷** — 컷당 평균 2.9 초, 구간별 재생속도 1.2×~5.3× 가변. 자막이 긴 컷은 느리게, 움직임만 있는 컷은 빠르게.
2. **오프닝을 실사로** — 우리 모델이 아니라 **사람이 줄을 타는 사진**에서 시작해 3D 모델로 디졸브.
3. **R 이해 보강** — R이 무엇인지 모르는 심사위원/관객을 가정하고 **원의 중심을 찍고 반지름이 R임을 명시**.

## 2. 구조 (87.3 s)

| 구간 | 길이 | 내용 |
|---|---|---|
| 0.0–5.8 s | 5.8 | **실사 사진** 켄번즈 푸시인. 카드 ① "서양 줄타기는 긴 장대로 균형을 잡는다" ② "한국 광대는 — 부채 하나뿐이다" |
| 5.8–6.6 | 0.8 | 실사 → 3D 모델 **크로스디졸브** |
| 6.6–15.4 | 8.8 | 씬① 역설 + 씬② 처짐/R (원본 자막 유지) |
| **15.4–22.4** | **7.0** | ★ **R 설명 그래픽 (신규 제작, 시점 90° 회전)** |
| **22.4–25.8** | **3.4** | ★ 씬② V자 실사 화면에 **원 중심 · 반지름 R 오버레이** |
| 25.8–32.1 | 6.3 | "R 하나였다" + 씬③ 평면 |
| 32.1–47.1 | 15.0 | 씬④ 좌표 (φ·α·θ·x_CoM·β·δ) — ★ **CoM·허리 라벨** |
| 47.1–58.7 | 11.6 | 씬⑤ 접기·기다리기·펴기 (접기 컷에 라벨) |
| 58.7–67.2 | 8.5 | 씬⑥ 원위치 평면 → 예측점 → A = 0 |
| 67.2–81.2 | 14.0 | 씬⑦ δ_f\* · ε\* · 증분 접기 · 수렴 |
| 81.2–87.3 | 6.1 | 씬⑧ 제목 + **마무리 카드 "장대는 필요 없었다 / 허리 접기 하나면 된다"** |

## 3. R — 무엇을 틀렸고 어떻게 고쳤나

### 3-A. ★ v1 의 오류: **원호의 평면을 90° 틀리게 그렸다**

v1 의 설명 그래픽은 기둥 두 개를 좌우로 놓고 **발이 그 V 평면 안에서 좌우로** 흔들리게 그렸다. 실사 화면 오버레이의 점선 원호도 같은 평면이었다.

**이건 물리적으로 불가능하다.** 줄이 늘어나야만 가능한 운동이다. `AGENTS.md §2.0` 이 정확히 말하고 있다 —

> 기둥 사이 거리 D … **발은 이 V 꼭짓점에 고정되어 줄과 함께 반경 R로 흔들린다**(미끄러지지 않음).

즉 **D 는 두 기둥 사이 = 걷는 방향(줄 축)** 이고, V 전체가 **그 줄 축을 회전축으로** 통째로 돈다. 발이 그리는 원호는 **V 가 놓인 평면에 수직인 평면**(= 스윙 평면) 안에 있다. 회전축은 실물 어름이에서 문자 그대로 **베어링 축**(§6.2 의 "베어링축~발 거리 = R")이다.

이 오류가 위험한 이유: 그림만 보면 **D 와 R 이 같은 평면에 있는 두 길이**로 읽히고, 그러면 φ 가 무슨 각인지·스윙 평면이 왜 하나인지(씬③ "이 운동은 한 평면 안에서 끝난다")가 전부 어긋난다. 심사위원 앞에서 나오면 안 되는 종류의 그림이었다.

### 3-B. v2 의 해법: 시점을 90° 돌린다 (7 초, 1컷)

정지 2패널 대신 **카메라를 실제로 돌려서** 두 면을 하나의 컷으로 잇는다. 러프컷의 씬② → 씬③ 카메라 이동과 같은 동작이다.

| 시각 | 시점 | 보이는 것 |
|---|---|---|
| 0.0–3.1 s | **옆모습** (az 90°) | 기둥 2개 · D 점선 · 줄 L/2 두 토막 · **R = 처짐 길이**(직각 표시) · `R = √((L/2)²−(D/2)²)` |
| 2.6– | — | **회전축**(두 앵커를 잇는 선) 점선으로 등장 |
| 2.85– | — | 발이 흔들리기 시작 — 옆모습에서는 **거의 움직이지 않는다**(원호가 화면에 수직이므로) |
| 3.1–4.65 | **회전** az 90°→0° | 기둥이 흐려지며 두 앵커가 한 점으로 모이고, 납작하던 자취가 **원호로 열린다**. 캡션 "발은 이 평면 안이 아니라 — 줄 축을 회전축으로, 그 축에 수직인 평면에서 흔들린다" |
| 4.65–7.0 | **정면** (az 0°) | 반지름 R · 원호 · 라벨 **"원의 중심 = 회전축"** · 캡션 "중심은 줄 축, 원호는 줄 축에 수직" |

투영은 직교 orthographic (`sx = −X sin az + Y cos az`, `sy = −(X cos az + Y sin az) sin el + Z cos el`, el = 11°). 좌표는 **X = 줄 축, Y = 스윙 방향, Z = 위**, 발 = `(0, R sinφ, −R cosφ)`. 비율은 실측값 그대로 `D/2R = 0.600/(2×0.433) = 0.693`.

### 3-C. 실사 화면 오버레이 — 검산된 기하 위에만 그렸다

원 중심을 찍기 전에 러프컷 프레임에서 기하를 직접 재서 확인했다(t = 36 s).

| 확인 항목 | 화면 측정 | 환산 스케일 |
|---|---:|---:|
| D 점선 길이 (0.600 m) | 293 px | 488.3 px/m |
| 중점 → 발 거리 (R = 0.433 m) | 208.1 px | 480.6 px/m |

두 스케일이 **1.6 % 안에서 일치** → 그 프레임의 카메라는 **옆모습**(화면 좌우 = 줄 축)이고, **원의 중심 = D 점선의 중점**, **R = 그 중점에서 발까지**임이 확정됐다.

따라서 오버레이에는 **원의 중심 + 반지름 R("처짐 길이")만** 그린다. **원호는 그리지 않는다** — 그 시점에서 스윙 원호는 화면에 수직이라 보이지 않는 것이 맞다. (v1 이 여기에 좌우 원호를 그린 것이 3-A 오류의 두 번째 발현이었다.)

## 4. CoM · 허리 라벨

색 블롭 추적으로 매 프레임 위치를 잡아 라벨을 붙였다.

| 대상 | 화면 색 (BGR) | 판별식 | 라벨 |
|---|---|---|---|
| CoM | ≈ (167, 57, 249) 분홍 | `R>200 & G<150 & R−B>8 & R−G>90` | `CoM 무게중심` (분홍 박스, 왼쪽) |
| 허리 | ≈ (31, 252, 253) 노랑 | `R>200 & G>200 & B<130` | `허리` (노랑 박스, 오른쪽) |

`R−B>8` 이 **분홍 CoM 공과 보라 상체(B > R)를 가르는 판별선**이다. 흰 배경(씬④)·어두운 배경(씬⑤)·3분할 레이아웃(씬⑥⑦) 전 구간에서 검출 성공(30개 표본 100 %). 위치는 EMA로 평활해 떨림을 없앴다.

## 5. 부수적으로 정리한 것

- **제작 메모 박스 제거** — 씬①·⑧에 남아 있던 `🎬 실사 줄타기 영상이 들어갈 자리`, `🎬 실기 어름이 주행 영상이 들어갈 자리` 노란 박스를 지웠다. (자리 자체는 여전히 비어 있음 — 문서 48 §6-1 그대로 미해결)
- **HUD 제거** — 하단 `물리 시간 … · 재생 118× 느리게` 표시는 재생속도를 바꾼 이상 거짓이 되므로 전 구간 삭제(690–714 행).
- 시작 0.55 s 페이드인 / 끝 0.75 s 페이드아웃, 컷 도입부 3.5 % 푸시인.

## 6. 남은 일

1. **실사 영상 2개** — 오프닝은 지금 **정지 사진**이다. 움직이는 실사 줄타기 영상이 생기면 0–5.8 s를 교체한다(라이선스 확인 필수). 씬⑧ 어름이 주행도 마찬가지.
2. **음악·음향 없음** — 광고 리듬은 컷으로만 만들었다. BGM을 얹으면 컷 타이밍을 비트에 맞춰 재조정하는 편이 낫다.
3. **나머지 화면의 평면 표현 재점검** — 3-A 와 같은 오류가 러프컷 본체(씬②의 점선 호 등)에도 있는지 확인 필요. 앱 소스를 봐야 판정된다.
4. **마무리 카드 문구**는 문서 51 §4-1 의 3-d 대사를 그대로 썼다. 발표 대본과 어긋나면 여기부터 고친다.
5. 원본 앱(`presentation/`)이 GitHub에 없다 — 마지막 커밋이 문서 46 기준. **푸시해 두면** 다음부터는 3D를 다시 렌더해서 카메라·라벨을 근본적으로 손볼 수 있다(지금은 mp4 위 오버레이라 카메라·기하가 고정이고, 그래서 3-A 같은 오류를 그림으로 덮는 방식으로만 고칠 수 있었다).

---

*근거: `AGENTS.md §2.0`(D·L·R 피타고라스와 회전) · 문서 48(러프컷 v0.1) · 문서 51(3분 대본) · 러프컷 프레임 실측(D/R 스케일 교차검증) · 재편집 스크립트 `build.py` / `rdiagram2.py` / `gfx.py`*
