cbshbalance/slackline-balacing1/docs/cowork/60_증분접기_실기펌웨어_감마비례_20260820.md

# 60. 증분접기 실기 펌웨어 `incremental_fold.ino` — γ 비례판 (2026-08-20)

> 문서 46(실측 세 개)·53(λ)·54(Â 잡음)·57(P2R) 의 결과를 실기 코드로 옮긴 것.
> 문서 52 의 `p2r_test.ino` 와 **배선·부호 규약만 공유**하고 제어부는 새로 썼다.
> 산출물: `incremental_fold.ino` + g++ 스텁 단위시험 91개 + `sweep_v21.py`.
>
> ⚠ 이 문서는 같은 날의 초안 두 개(고정 증분판 / 축약모형판)를 대체한다.
> **제어법칙은 γ 비례** — 문서 46 정본 그대로. **검증은 레포의 v21 전물리로 했다.**

---

## 0. 제어의 한 문장

**예측점이 안정모드선에서 문턱 이상 벗어나면, 벗어난 만큼(γ배) 접어 다시 선 쪽으로 보낸다.
선 위에 있으면 아무것도 하지 않는다.**

(사용자가 처음 세운 알고리즘 서술에서 조건이 뒤집혀 있었다 — 선 **위**에서 접는 것이 아니라
선 위에서는 무개입이다. 그리고 제어변수는 비율 ε 가 아니라 각도다 — 문서 41 §3-2.)

---

## ⚠ 이 문서를 읽는 사람에게 — 폐기된 '축약모형'에 관하여

이 문서의 8/20 초안 두 판에는 **「스칼라 A 축약모형」** 이라는 것이 나왔다.
`Ȧ = λA − k_A·δ̇` 하나짜리 1차원 장난감 시뮬로, γ 고원·회복천장·잡음한계를
그것으로 뽑아 실었었다.

**그것은 우리 연구의 일부가 아니다.** 문서 어디에도 없고, 모델 위계
(문서 31 Ⅷ: ε\* ⊂ ε\*_gen ⊂ ε\*_ft ⊂ ε_FWE ⊂ 반복 FEW)에도 속하지 않는다.
펌웨어를 짠 세션이 v21 을 못 돌리는 줄 알고 그 자리에서 급조한 검산 도구였다.

**그리고 틀렸다.** 레포의 v21 전물리로 같은 스윕을 다시 돌린 결과:

| | 축약모형이 한 말 | **v21 전물리 (정본)** |
|---|---|---|
| γ 고원 | 8.9 ~ 15.7 | **5 ~ 12** |
| 회복 천장 (γ=10) | 4.9° | **6° 이상** |
| 발목 잡음 한계 | σ 0.15~0.20° | **σ 0.10°** |

**세 개 다 틀렸고, 방향도 일정하지 않다** (고원은 좁고 높게, 천장은 낮게, 잡음은 후하게).
안정 진동모드 2차원을 통째로 뺀 모형이었으니 당연한 일이다.

**교훈:** v21 은 이미 헤드리스로 돌아간다 (`tests_v21.py` ALL PASS 확인). 시뮬 단계는
끝났고 지금은 하드웨어로 내려오는 중이므로, **앞으로 새 시뮬을 만들지 말고 v21 을 돌린다.**
그 목적의 스크립트가 `sweep_v21.py` 이고, 이 문서 3절의 모든 숫자는 그것이 낸 것이다.

---

## 1. 실측값과 유도

| | 기본값 | 출처 |
|---|---|---|
| P2R | **0.417** | 문서 57 실측 |
| λ | **5.3 /s** (배가 131 ms) | 문서 53 실측 (2·3·4회 대표) |
| r | −1.6445 | ⚠ **모델 예측 — 실측 ② 미수행** |
| c₀ (절편) | 0 | ⚠ 같음 |

**유도는 코드가 한다** (하드코딩 없음):

```
w = [ −1/r , 1 , −1/(r·λ) , 1/λ ] = [0.60809, 1, 0.11473, 0.18868]
A = w·(φ, β, φ̇, β̇) + c₀/r
β = α + P2R·δ,   α = ank + phi
```

**실측값은 전부 시리얼에서 바꾼다** (§4-1). `lam 5.42` 나 `r -1.58` 한 줄이면
w 네 개와 A 오프셋이 그 자리에서 재계산되고 추정기가 리셋된다 — 재컴파일이 필요 없다.

파이프라인은 문서 46 §7 그대로 한 묶음: **200 Hz / 25 ms 기저차분 / τ≈28 ms EMA.**
⚠ 이 셋만은 일부러 런타임 대상에서 뺐다 — 따로 바꾸면 잡종이 되기 때문 (문서 45의 교훈).

---

## 2. 상태기계

```
IDLE ─ |Â| > trig(0.6°)  → hold += sgn · ρ·γ·Â   (ρ=0.95, γ=10, ±dlim 클립) → FOLD
     └ |Â| < rel(0.3°) 이고 |hold| > dead(1°) → hold 를 vrel(3°/s) 로 중립쪽 감소
FOLD ─ |δ−hold| < 0.5° (또는 0.6 s) → REST
REST ─ rest(60 ms), 판정 없음 → IDLE
```

`v21_pres/sim_engine.py` 의 `_fwe_async` 와 같은 법칙이다 — 그래서 v21 로 검증할 수 있다.

평시에는 늘 문턱에서 발동하므로 접기량은 `0.95·10·0.6 ≈ 5.7°` 로 거의 일정하고,
**큰 외란이 왔을 때만 한 번에 크게 접는다.** 그것이 γ 를 쓰는 이유다.

**Â 는 `control_step` 이전 값**이고 로그에 남는 것도 그 값이다 (문서 46 §9 / 54 §7-1).

---

## 3. ★ v21 전물리 스윕 결과 (`sweep_v21.py`)

엔진: `v21_pres/sim_engine.py`, 구성은 `tests_v21.make_engine` 그대로
(MEASURED_SET + ρ=0.95 + 실기 파이프라인 200 Hz/25 ms/τ30 ms + 위치모드 420 °/s·8000 °/s²).
놓기 4점 `(β,φ) = (1,0) (−1,0) (0.5,1.64) (2,−3.29)`, 20 s.

### 3-1. γ 고원 = **5 ~ 12**

| γ | 생존 | 접기/s | \|φ\|max | \|hold\|max |
|---:|---|---:|---:|---:|
| 4 | **0/4** (2.0 s) | | | |
| 5 | 4/4 | 4.3 | 3.78° | 40.2° |
| 6 | 4/4 | 3.4 | 4.10° | 37.0° |
| 7 | 4/4 | 2.4 | 4.89° | 28.9° |
| 8 | 4/4 | 1.9 | 6.34° | 23.0° |
| 9 | 4/4 | 2.2 | 6.36° | 19.7° |
| **10** | 4/4 | 3.1 | 5.14° | **16.1°** |
| 12 | 4/4 | 5.8 | 9.14° | 20.9° |
| 14 | **0/4** (2.0 s) | | | |
| 16~24 | 0/4 | | | |

- **문서 46 의 "작동 고원 γ=4~12" 와 거의 일치.** 하한만 4→5 로 한 칸 올라간다.
- 관절 포화(`n_sat`)는 전 구간 0 — 고원 안에서는 ±55° 에 안 붙는다.
- **γ 가 작을수록 유지각이 커진다** (γ=5 에서 40°). 작은 접기를 여러 번 하니 δ 가 쌓인다.
  γ=10 이 유지각 최소(16°)이고 접기 횟수도 3.1회/s 로 문서 46 의 실측(≈3회/s)과 같다.
- **기본 γ=10 은 고원의 위쪽 중앙**이고, 아래위로 각각 2배·1.2배의 여유가 있다.

### 3-2. 회복 천장 — γ=10 에서 A₀ **6° 이상**

φ=0, 속도 0 으로 놓으면 A₀ = β 다 (w_β = 1).

| β = A₀ | γ=8 | γ=10 | γ=12 | γ=15 |
|---:|---|---|---|---|
| 0.5 ~ 3.0 | O | O | O | X |
| 3.5 ~ 5.0 | O | O | **X** | X |
| 6.0 | **X** | O | **O** | X |

- **γ=10 은 시험한 전 범위(6°)에서 생존.** 천장을 못 찾았다 — 더 키워서 재야 한다.
- γ=12 가 5.0 에서 죽고 6.0 에서 사는 **비단조**가 나온다.
  이것은 물리가 아니라 **킥 위상 효과**다 — 문서 46 §9 가 "단발 외란 시험으로
  순위를 매기지 말 것" 이라고 한 그대로다. 순위를 매기려면 위상을 흩어 여러 번 돌려야 한다.

### 3-3. ★★ 발목 엔코더 잡음 — 하드웨어를 고치는 것 외에 길이 없다

`sim_engine` 의 `enc_noise_ank_deg` (백색잡음 σ). 문서 54 실측 = **0.223°**.
γ=10, 놓기 (1,0), 6 시드:

| σ [°] | 생존 | 접기/s | \|φ\|max | \|hold\|max |
|---:|---|---:|---:|---:|
| 0.00 | 6/6 | 3.2 | 3.24° | 10.6° |
| 0.05 | 6/6 | 5.2 | 5.03° | 17.1° |
| **0.10** | **6/6** | 6.2 | 5.99° | 25.1° |
| 0.15 | **0/6** (16.7 s) | | | |
| **0.223** (실측) | **0/6** (7.7 s) | | | |
| 0.30 | 0/6 (3.2 s) | | | |
| 0.45 | 0/6 (1.7 s) | | | |

**한계는 σ(발목) ≈ 0.10°.** 문서 54 가 잰 0.223° 는 그 두 배가 넘는다.

**γ 나 문턱으로 구제할 수 없다** (σ=0.223, 놓기 4점 × 4시드 = 16회):

| γ \ 문턱 | 0.6 | 1.0 | 1.2 | 1.4 | 1.6 |
|---:|---:|---:|---:|---:|---:|
| 7 | 0/16 | 0/16 | 0/16 | 0/16 | — |
| 8 | 0/16 | 0/16 | **4/16** | 0/16 | 0/16 |
| 9 | 0/16 | 0/16 | 0/16 | 0/16 | — |
| 10 | 0/16 | 0/16 | 0/16 | 0/16 | 0/16 |
| 12 | 0/16 | 0/16 | 0/16 | 0/16 | 0/16 |

> **(γ=8, 문턱 1.2) 가 처음에 6/6 으로 나왔던 것은 놓기 1점만 썼기 때문이다.**
> 4점으로 늘리니 4/16 으로 떨어졌고, 이웃 칸(γ 7·9, 문턱 1.0·1.4)은 전부 0/16 —
> **영역이 아니라 섬**이다. 문서 46 §9 의 경고를 그대로 밟았다가 잡아낸 사례.

**결론: 발목 센서 수리(자석 갭 → 배선 → 접지)가 줄 위 시험의 절대적 선행조건이다.**
목표는 문서 54 가 이미 적어 둔 그대로 — 고주파 rms **0.223 → 0.05° 이하**.
그러면 Â 잡음이 0.59 → 0.15° 아래로 가고, 위 표의 첫 세 줄 영역으로 들어온다.

### 3-4. 펴기의 자기주입

펴기가 스스로 A 에 넣는 양 = `W_βdot · P2R · vrel` = 0.189 × 0.417 × 3 =
**0.236° = 펴기게이트 0.3° 의 79%.** 게이트가 좁은 것이 아니라
**펴기 자체가 게이트를 거의 다 먹는다.** 문서 46 §7 의 정량값이고,
`sim_engine._fwe_async` 의 주석("복귀가 만든 위험도로 자기교란이 된다")과 같은 이야기다.

---

## 4. 코드에 들어간 실무 장치

### 4-1. ★ 값은 전부 이름으로 바꾼다 — 재컴파일 없이

실측이 나올 때마다 스케치를 고쳐 올리는 것은 줄 위에서 못 할 일이다.
그래서 **조정 대상을 전부 `float` 변수 + 이름표로** 만들었다.

```
lam 5.42      실측③ λ        → w 자동 재계산 + 추정기 리셋 + 배가시간 출력
r -1.58       실측② 기울기    → w 자동 재계산
c0 0.4        실측② 절편      → A 오프셋 = c0/r  (영점 자세의 A 가 그만큼 밀린다)
p2r 0.417     실측①
sgn -1        접기 방향 뒤집기 ← 부호가 틀렸을 때 재컴파일 불필요
trig 0.8      트리거 문턱
gam 11        ★줄 위 노브     → 문턱에서의 접기량·프로파일 시간을 즉시 되계산해 보여준다
```

| | |
|---|---|
| 전체 이름 (19개) | `p2r lam r c0 sgn` / `gam rho trig rel vrel dead dlim rest alim cue cuems` / `loghz vel acc` |
| 한 글자 별칭 | `f=gam c=trig e=rel o=rho l=loghz v=vel a=acc` |
| 값을 빼고 이름만 | 현재 값을 읽는다 |
| `w` | 전체 목록을 정렬해 출력 |
| `d` | **현재 값을 `.ino` 에 붙여넣을 수 있는 C 블록으로 출력** |

**세 가지 안전장치:**

1. **잠금** — 실측 상수(`p2r lam r c0 sgn`)와 `dlim` 은 **제어 정지 중에만** 바뀐다.
   달리는 중에 w 가 바뀌면 그 순간 판정이 튄다. `gam` 같은 노브는 달리면서도 된다.
2. **범위 클립 + 경고** — 값을 막지는 않고 잘라내고 말해 준다.
   `r` 이 양수면 "이론상 φ 와 β 는 반대부호" 라고 경고하되 **받아는 준다** —
   실측이 예측과 다를 수 있으므로 코드가 관측을 거부하면 안 된다.
3. **영속성은 `d` 로** — 전원을 끄면 파일의 기본값으로 돌아간다.
   확정된 값은 `d` 출력을 상수 블록에 붙여넣어 못 박는다.
   (EEPROM 저장은 넣지 않았다 — 보드별 지원이 불확실하고, 검증할 수 없는 것은 안 넣는다.)

### 4-2. 나머지

| | 무엇 | 왜 |
|---|---|---|
| **`y` dry-run** | 판정·로그는 다 하고 모터 명령만 안 나감 | **접기 방향 확인용.** 부호가 반대면 로봇이 넘어지는 쪽으로 스스로 접는다 |
| **`n` 잡음 측정** | 20 s, 채널별 고주파 rms + Â 잡음 바닥 + 판정문 | 문서 54 방법의 온보드판. **판정선은 3-3 의 v21 스윕값**(0.10 합격 / 0.15 경계) |
| **`j` 발목 중앙값** | 3점 중앙값 필터 (기본 OFF) | 문서 54 실측 0.223 → 0.138°. 임시방편이지 해법이 아님을 출력에 명시 |
| **놓기 신호** | \|Â\|<`cue` 가 `cuems` 유지 → D8 LED/부저 + 로그 열 | 문서 50 의 릴리즈 큐. 실측 ②③ 의 놓기 게이트로 겸용 |
| **로그 버리기** | `availableForWrite()` 부족하면 그 줄을 버린다 | 시리얼이 밀려 200 Hz 제어루프가 멈추는 것을 막는다 |
| **자동트림 없음** | | 문서 46 §8 — 정적 관측은 (가)측정오프셋과 (나)진짜기울어짐을 못 가른다 |
| 안전 정지 | \|φ\| 또는 \|α\| > `alim` → 토크 OFF | |

**A 자체 LPF 는 넣지 않았다** (기존 펌웨어의 `A_f = 0.85·A_f + 0.15·A`).
속도 파이프라인에 이미 EMA 가 있고, 그 위에 또 걸면 문서 54 의 "10% 늦게"가 커진다.

---

## 5. 검증 — 두 층

| | 무엇을 확인하나 | 도구 |
|---|---|---|
| **펌웨어 논리** | 식·상태기계·파서가 의도대로인가 | Arduino API 스텁 + g++, **91개 전부 통과** |
| **제어법칙** | 그 법칙이 물리에서 서는가 | **레포 v21 전물리**, `sweep_v21.py` (3절) |

단위시험 91개의 내역:

- **이론** — 유도상수(문서 55 w 재현), A=0 이 안정모드선, 환율 φ 1°=0.608°,
  파이프라인 이득 0.817 (문서 54 예측 0.816).
- **제어** — Δδ = ρ·γ·Â 비례성 (γ 2배 → 접기량 정확히 2배), 트리거 순간 Â ≈ 문턱,
  부호 반전, T_REST 간격, ±dlim 클립, 펴기 3°/s, 놓기신호 500 ms, 안전정지.
- **파라미터 층** — `lam` 을 바꾸면 `W_PHIDOT`·`W_BETADOT` 만 바뀌고 `W_PHI` 는 안 바뀐다,
  `c0` 를 넣으면 영점 자세의 Â 가 정확히 `c0/r` 만큼 밀린다, `sgn -1` 이 접기 방향을 뒤집는다,
  범위 클립, `r` 양수 경고, 제어 중 잠금(실측은 거부·`gam` 은 허용), 모르는 이름 안내,
  `rest`·`alim` 이 실제 동작에 반영, `w`·`d` 출력, 표 19개·별칭 7개 정합.
- **입출력** — 명령파서(줄바꿈 유/무·`x` 즉시성·제어중 수동이동 거부), dry-run,
  잡음모드, CSV 13열·버림, 중앙값 필터.

> **시험 설계 함정 (기록):** β 를 직접 지정하는 구동 헬퍼(`tickBeta`)와 완만한 램프를 써야 한다.
> α 에 계단을 넣으면 속도 과도 때문에 **트리거 순간 Â 가 문턱의 2~3배**가 된다.
> 실기 로그를 읽을 때도 같은 함정이 있다 — 손으로 툭 친 직후의 Â 는 문턱 근처가 아니다.

**실기 검증 미실시.** 배선·부호는 문서 17·37·52 확정값을 그대로 따랐다.

---

## 6. 다음

1. **발목 센서 하드웨어 — 절대적 1순위.** v21 이 σ 0.10° 를 한계로 못 박았고
   실측은 0.223° 다. γ·문턱 어느 조합으로도 안 살아난다 (3-3). 목표 0.05° 이하.
2. **실측 ②** — 나오면 `r`·`c0` 두 줄을 시리얼에 치면 끝난다. 확정되면 `d` 로 소스에 못 박는다.
   놓기당 관측창은 **~2 s** (문서 58 §2).
3. **접기 방향 바닥 확인** — 줄 위에 올리기 전, dry-run 으로. 틀렸으면 `sgn -1`.
4. **γ 노브** — 10 에서 시작 (v21 고원 5~12 의 위쪽 중앙, 유지각 최소).
   로그의 `hold` 가 단조증가하면 γ 부족, φ 스윙 rms 가 커지면 γ 과다.
5. **회복 천장을 다시 재기** — γ=10 이 6° 에서도 살아서 천장을 못 찾았다.
   `sweep_v21.py` 의 β 목록을 8·10·12° 까지 늘리고, **위상을 흩어 여러 번** 돌릴 것 (3-2).
6. 실측 ② 가 나오면 `sweep_v21.py` 를 그 r·c₀ 로 다시 돌려 3절 표를 갱신한다.
