cbshbalance/slackline-balacing1/docs/cowork/61_발표흐름_파트1_확정_20260821.md

# 61. 발표 흐름 — 파트1 확정본 (2026-08-21)

> **이 문서의 위치**: 3분 발표를 **백지에서 다시 짠** 흐름이다. 기존 발표 설계 문서들의 서사 구조·단계 구분·용어를 이어받지 않는다. 참고한 것은 **전람회 심사 형식**과 **발표 자료 금지선** 둘뿐이다.
> 파트1만 확정되었다. 파트2·3은 미확정이므로 이 문서에서 다루지 않는다.
> §8의 미결 항목은 **내부용**이며 화면·대본에 옮기지 않는다(§9 금지선).

---

## 1. 심사 형식 — 이 발표가 놓이는 조건

| 항목 | 내용 |
|---|---|
| 대상 | 제72회 전국과학전람회 **2차 면담심사 (2026-09-15)** |
| 부문 | 물리, 학생부 (출품번호 1167) |
| 시간 | **발표 3분 + 질의응답 10분**, 총 13분. 형식은 자유 |
| 심사위원 | **3인 — 물리 전공자 · 공학 전공자 · 변리사** |
| 참여 | 학생 3명 전원 입실. 한 질문에 나눠 답하거나 서로 보충 가능 |
| 시연 | **전시대 위 실물 시연 포함.** 질의 중에도 가능 |
| 배점 (70) | 창의성·탐구성 **30** / 이론적 타당성 15 / 노력도 **15** / 실용성 10 |

**설계에 직접 영향을 주는 조건 셋**

1. **3분은 짧고 10분은 길다.** 3분에 다 넣으려 하면 아무것도 남지 않는다. 3분은 **질문이 나오게 만드는 시간**이고, 본편은 10분이다.
2. **심사위원 셋 중 하나는 비전공자다.** 수식·기호·전문용어를 말로 소개하면 그 한 사람을 잃는다. → §3 원칙 ③.
3. **실물이 옆에 서 있다.** 화면과 실물이 같은 것을 말하고 있다는 감각이 발표 내내 유지되어야 한다.

---

## 2. 3파트 구조와 시간

| 파트 | 담는 것 | 시간 | 상태 |
|---|---|---:|---|
| **파트1** | 문제 인식 · 선행연구 · 모델링 | **46초** | **확정 (이 문서)** |
| **파트2** | 균형의 정의 · 좌표 · 해석해 ε\* | 미정 | 미확정 |
| **파트3** | 최종 메커니즘 · 현실 구현 · 결론 및 제언 | 미정 | 미확정 |

**당초 1분 균등 배분으로 출발했으나, 파트1이 47초로 굳으면서 균등 전제는 사실상 해제되었다.** 파트2가 내용 밀도상 더 요구할 가능성이 높다. 최종 배분은 파트2 확정 시 결정한다. 총합 상한은 **180초**.

---

## 3. 파트1 설계 원칙 — 파트2·3에도 계승할 것

### 원칙 ①. 질문은 한 번에 하나만 연다

**여러 질문을 쌓아 놓고 나중에 답하면 청중이 앞 질문을 잊는다.** 하나를 열고, 실마리를 주고, 그 하나를 닫는다. 다음 질문은 그 뒤에 연다.

초안이 이 원칙을 어겼던 지점: 모델링 비트 끝에서 *"얼마나 접나? 그 전에 어디로 가야 하나?"* 로 **두 질문을 동시에 열고** 두 번째부터 답하는 구조였다. 청중은 첫 질문을 들고 30초를 기다려야 했다.

### 원칙 ②. 파트는 질문으로 끝내고, 다음 파트가 그 답으로 연다

파트1은 *"안 떨어진다는 게, 뭘까요?"* 로 끝나고 파트2 첫 비트가 균형을 정의한다. 파트 경계가 단절이 아니라 이음매가 된다. 파트2→3도 같은 패턴으로 간다.

### 원칙 ③. 기호는 말하지 않고 화면 라벨로만 놓는다

**안 읽고 온 심사위원이 최우선 대상이다.** 좌표를 말로 소개하면 벽이 되고, 화면 라벨로 놓으면 전공자만 읽는다. 같은 화면이 두 청중에게 다르게 작동한다.

- **파트1**: φ(줄 각도) 라벨만 5번 비트 화면에 놓는다 — 말로 부르지 않는다
- **α·θ**: 파트2의 낙차 카드 왼쪽(벽)에서만 나타난다. **설명 대상이 아니라 벽의 재료다.** 가리키며 "셋이 얽혀 있습니다" 정도로 지나가고 다시 돌아오지 않는다
- 이렇게 하면 카드가 말 없이 차원축소를 보여준다: **좌표 셋(α, θ, φ) → 좌표 둘(β, φ) → 직선 하나 → 숫자 하나.** φ가 양쪽에 다 있어 다리 역할을 한다

### 원칙 ④. FWE 메커니즘은 파트1에 넣지 않는다

1. **FWE는 최종형이 아니다.** 실측 마찰 조건에서 완전 사이클이 무너졌고 최종 제어기는 증분 접기다. 제목에서도 "(접고-기다리고-펴기)"를 뺐다. 파트1에서 크게 세우면 **파트3에서 철회해야 하고**, 3분 발표에서 세웠다 무너뜨리는 것은 비싸다.
2. **층위가 다르다.** 역발상("발을 옮긴다")은 원리, FWE("접고-기다리고-펴기")는 시퀀스다. 시퀀스는 "얼마나"에 답한 뒤에 자리가 있다.
3. 부수 효과: 전공 심사위원의 *"왜 FWE가 맞다고 보는가"* 라는 질문은 **파트1에서 FWE를 세우지 않으면 발생하지 않는다.** 파트2의 "순간 접기 가정"에는 "허리를 접으면 발이 밀린다"만 있으면 충분하다.

### 원칙 ⑤. 서양 장대는 말에서 빼고 화면에 남긴다

대사로 동서양을 비교하면 청중이 두 대상을 동시에 머리에 올려야 해서 느려진다. 그러나 화면에서까지 빼면 파트3에서 장대를 다시 쓸 여지가 사라진다.

→ **한국 영상을 크게, 장대 사진을 구석에 작게.** 파트3에서 그 사진을 다시 크게 띄우면 회수가 성립한다.

---

## 4. 파트1 비트표 — 확정 (46초 / 232자)

기준 속도 **초당 5자**. "자"는 공백 제외 글자 수.

| # | 비트 | 초 | 자 | 대사 | 화면 · 동작 |
|---|---|---:|---:|---|---|
| **1** | **장대가 없다** | 8 | 37 | "한국 줄타기입니다. 장대는 토크를 만듭니다. 부채는 못 만듭니다. 그런데 — 떨어지지 않습니다." | 한국 줄타기 영상 크게 / 장대 사진 구석에 작게 |
| **2** | **얼음판 — 불가능** | 6 | 32 | "얼음판 위라면, 몸속에서 뭘 해도 무게중심은 안 움직입니다. 기울면 끝입니다." | ★**불가능 카드 왼쪽 칸** |
| **3** | **실마리 — 줄은 처져 있다** | 5 | 24 | "그런데 얼음판과 다른 게 하나 있습니다. 줄은 — **처져 있습니다.**" | 처진 줄 형태가 보이는 컷 (원호는 아직 아님) |
| **4** | **역발상 — 발을 옮긴다** | 10 | 51 | "무게중심을 못 옮기면, 발을 옮기면 됩니다. 처진 줄에서는, 발이 옆으로 가면 줄이 몸을 끌어옵니다. 발 위치가 힘으로 바뀌는 겁니다." | ★**추 시연** + 불가능 카드 **오른쪽 칸 채워짐** |
| **5** | **파올레티** | 10 | 52 | "이걸 다룬 논문 하나가, 줄의 처짐을 **원호**로 봤습니다. 위치가 **각도 하나**로 정리되죠. 그런데 균형은 — **장대와 팔의 몫**이었습니다." | 논문 표지 → 원호 R + φ 라벨 |
| **6** | **허리 + 넘기는 질문** | 7 | 36 | "우리에겐 둘 다 없습니다. 막대를 둘로 나누고, 허리를 넣었습니다. — 안 떨어진다는 게, 뭘까요?" | 1체→2체 애니 5초 |

**어름이 눈길 3초는 46초 밖에 둔다.** 입장·인사 구간에서 심사위원이 자연스럽게 보게 되므로 대사 예산에 포함하지 않는다. 로봇은 발표 시작 전부터 이미 줄 위에서 균형을 잡고 있는 것을 전제로 한다.

### 비트별 주석

**1번.** "부채는 힘이 없다"가 아니라 **"토크를 못 만든다"**로 간다. 물리적으로 정확하고 전공자에게 즉시 꽂힌다.

> ⚠ **여기서 "줄은 느슨하다"를 말하지 않는다.** 줄이 처져 있다는 것은 **3번의 재료**이고, 1번에서 흘리면 실마리를 답보다 먼저 줘 버리는 셈이 된다. 1번은 순수하게 **"토크를 낼 수단이 없다 — 그런데 안 떨어진다"** 하나만 세운다.
>
> "**일부러** 느슨하다"는 더 강한 금지다. 광대가 왜 줄을 느슨하게 매는지는 **우리 연구가 설명해 내는 결과**이지 전제로 던질 사실이 아니다. 전제로 던지면 답할 수 없는 질문("왜 일부러?")이 파트1 내내 떠 있게 된다. → §7 회수 후보.

**2번.** "얼음판"·"무게중심"·"기울면 끝" 셋만 남긴다. 나머지는 화면이 말한다.

**3번.** **실마리는 구체적인 사실이어야 한다.** "차이가 하나 있습니다"까지만 하면 그건 실마리가 아니라 티저이고, 원칙 ①의 "질문 → 실마리 → 답"에서 가운데가 비게 된다. → **"줄은 처져 있습니다"까지 말한다.** 화면도 처짐을 뒷받침하되, **원호는 아직 그리지 않는다** — 원호는 5번에서 논문이 주는 것이다.

**4번.** 추 시연이 이 비트의 본체다. **관절 없는 추는 저절로 돌아오는데 사람은 안 돌아온다** — 이 대비가 그대로 6번(허리)의 동기가 된다. 로봇을 쓰지 않으므로 낙하 위험이 없다.

**5번.** 논문이 **도구 제공자**로 위치한다 — 원호 처짐 모델과 좌표계를 빌려 왔고, 답(장대·팔)은 버렸다. "장대와 팔의 몫"으로 끝내면 **1번을 회수하면서 6번의 첫 문장을 부른다.** 신규성 근거가 이 한 문장에 선다.

**6번.** "접으면 반작용으로 발이 밀린다"는 **대사에서 뺀다.** 5초짜리 애니메이션이 정확히 그것을 보여주므로 중복이고, 7초에 허리 도입 + 작동 + 넘기는 질문 셋을 넣으면 55자가 되어 초과한다.

---

## 5. 질문 사슬 — 하나씩 열고 닫힌다

```
Q1  장대 없이 어떻게 서 있나?              [비트 1]
      ↓ 얼음판 — 몸속 힘으로는 불가능       [비트 2]
      ↓ 실마리 — 줄은 처져 있다             [비트 3]
A1  발을 옮기면 된다                       [비트 4]  ✔ 닫힘
      ↓
    (논문: 원호·좌표는 빌렸다 / 답은 장대와 팔이었다)   [비트 5]
      ↓
Q2  우리에겐 장대도 팔도 없는데?
A2  허리를 만들었다                         [비트 6]  ✔ 닫힘
      ↓
Q3  안 떨어진다는 게 뭔가?                  [비트 6 끝] → 파트2가 답한다
```

**처짐이 3층으로 쌓인다** — 3번 **사실**(줄은 처져 있다) → 4번 **의미**(그래서 발이 옆으로 가면 줄이 끌어온다) → 5번 **수학**(그 처짐을 원호로 보면 각도 하나로 정리된다). 중복이 아니라 해상도가 한 단계씩 올라가는 구조라 같은 소재를 세 번 써도 지루하지 않다.

**그래서 세 층 중 어느 것도 앞당겨 쓰면 안 된다.** 1번에서 "느슨하다"를 말하면 1층이 새고, 3번에서 원호를 그리면 3층이 샌다.

---

## 6. 시각 자산 — 파트1

| 비트 | 자산 | 상태 |
|---|---|---|
| 1 | 한국 줄타기 실사 영상 | 확보 + **라이선스 필요** |
| 1 | 서양 장대 사진 (구석용, 파트3에서 재사용) | 확보 필요 |
| 2·4 | ★**불가능 카드** — 2칸 (얼음판 \| 처진 줄) | **신규** |
| 3 | 처진 줄 형태 컷 — **원호는 그리지 않는다** | 신규 또는 실사 |
| 4 | ★**추 시연** — 줄 위 추, 손으로 밀면 복귀 | **신규 (실물)** |
| 5 | 논문 표지 | 쉬움 |
| 5 | 원호 R + φ 라벨 도해 | 신규 (손그림 가능) |
| 6 | 1체→2체 애니메이션 5초 | **신규** |

### 불가능 카드 — 파트1의 시각 앵커

**1번에서 왼쪽 칸만 띄우고, 4번에서 오른쪽 칸이 채워진다.** 파트1 전체가 카드 한 장이 완성되는 과정이 되어, 6비트가 시각적으로 하나로 읽힌다. 질의 중 *"왜 처진 줄이어야 하나"* 가 나오면 이 카드로 돌아온다.

```
┌────────────────────────┬────────────────────────┐
│   얼음판               │   처진 줄              │
│                        │                        │
│   내력으로는           │   발이 옆으로 가면     │
│   무게중심 불변        │   줄이 몸을 끌어온다   │
│                        │                        │
│   → 기울면 끝          │   → 발 위치가 힘이 된다│
└────────────────────────┴────────────────────────┘
     [비트 1에서 등장]         [비트 4에서 채워짐]
```

**파트2도 같은 문법을 쓸 것** — 카드 한쪽이 먼저 떠서 상주하고, 다른 쪽이 한 겹씩 채워진다. 청중이 파트1에서 이미 이 리듬을 익힌 상태로 들어간다.

---

## 7. 파트2로 넘긴 것

| 항목 | 이유 |
|---|---|
| **균형의 정의** | 파트1이 던진 Q3의 답. 파트 경계를 질문—답으로 물린다 |
| **β·φ 좌표 도입** | β는 허리가 생겨서 새로 필요해진 변수이므로 6번 뒤가 자리다 |
| **x_CoM = Rφ + hβ** | β·φ를 따라간다. **ε\*보다 앞이기만 하면 h·R 사전 소개 효과는 유지된다** |
| **"얼음판은 R = 0인 세계"** | 위 식의 정량판. 파트1 전체를 한 줄로 회수하는 문장이므로 파트2 초반에 배치 |
| **허리 접기의 작동 원리** | 파트1은 애니메이션에 맡기고, 말로 하는 설명은 "순간 접기 가정" 직전에 |

### 회수 후보 — "광대는 왜 줄을 느슨하게 매는가"

파트1에서 **의도적으로 던지지 않은** 사실이다(§4 1번 주석). 이건 전제가 아니라 **우리 결과가 설명해 내는 것**이므로, 파트3이나 질의응답에서 *"이제 광대가 왜 줄을 느슨하게 매는지 설명이 됩니다"* 로 꺼내면 회수가 성립한다. 파트1에서 미리 말해 버리면 이 카드가 사라진다.

---

## 8. 미결 사항 — 내부용 (화면·대본에 옮기지 않는다)

1. **5번의 "이상한 점"을 (a)"허리가 없다"로 되돌릴지.** 현재는 (b)"장대와 팔의 몫"이다. (b)는 1번을 회수하고 6번 첫 문장("우리에겐 둘 다 없습니다")을 부른다. (a)로 바꾸려면 6번 첫 문장을 함께 고쳐야 한다. 2체 모델의 신규성은 현재 6번의 "막대를 **둘로** 나누고"에 함축되어 있고, 정면 서술은 질의응답에서 한다.
2. **5번 화면의 φ 라벨을 실제로 달지.** 달면 파트2에서 β만 새로 도입하면 된다.
3. **시간 배분 최종 확정** — 파트2 확정 후. 총합 180초.
4. **부호·색·기하 규약을 자산 제작보다 먼저 못 박을 것.** 불가능 카드·추 시연 도해·1체→2체 애니를 만들기 전에 정한다. 순서가 뒤집히면 두 번 일한다. 우선순위는 **부호 > 로봇 모양 > 색** — 색과 모양이 다르면 "다르네"지만 부호가 다르면 "틀렸네"가 되고, 전공 심사위원이 즉시 잡아낸다.
5. **추 시연 실물 준비** — 추 사양, 줄 위 배치, 전시대에서의 안전.
6. **한국 줄타기 영상 라이선스.**

---

## 9. 발표 자료 금지선 — 준수 확인

발표 자료·화면·대본에 다음을 넣지 않는다. (§8 미결 항목은 내부 문서에만 존재한다.)

| 금지 | 파트1 확인 |
|---|---|
| "아직 안 됐다 / 미완 / 문서끼리 안 맞는다" 류 서술 | ✔ 없음 |
| "저 식(ε\*)이 로봇 안에서 돌고 있다"는 표현 | ✔ 해당 없음 (파트3 주의) |
| 동양철학·동서양 문명 비교 어휘를 **우리가 먼저** 꺼내기 | ✔ 장대는 화면에만, 대사는 물리 사실만 |
| "실제 광대도 이렇게 균형을 잡는다"는 단정 | ✔ 없음 |
| 복원 성능 자랑("잘 돌아옵니다") | ✔ 해당 없음 |

**실물 시연은 감탄이 아니라 증거로 쓴다.** 로봇이 서 있다는 사실 자체는 동역학·로봇공학 전공자에게 놀라운 일이 아니다. 프레이밍은 언제나 "이 단순한 결과만으로 이게 됩니다"이지 "잘 돌아옵니다"가 아니다.

---

*파트1 확정 시점의 기록. 파트2 확정 시 이 문서에 §2 시간 배분과 §7 인계 항목의 실제 반영 여부를 갱신할 것.*
