cbshbalance/slackline-balacing1/docs/cowork/62_발표흐름_파트2_구상_20260821.md

# 62. 발표 흐름 — 파트2 구상안 (2026-08-21)

> **문서 61(파트1 확정본)의 후속.** 파트1과 같은 방식으로, 기존 발표 설계 문서의 서사 구조·용어를 이어받지 않고 백지에서 짠다. 참고한 것은 **전람회 심사 형식**과 **발표 자료 금지선**뿐이다.
> **상태: 구상 단계.** 비트 구성과 시간 배분은 잡혔고, 대사는 일부만 초안이 있다. §7의 미결 항목이 남아 있다.
> §7·§8은 **내부용**이며 화면·대본에 옮기지 않는다.

---

## 1. 파트 경계와 시간 배분 — 확정

| 파트 | 담는 것 | 초 |
|---|---|---:|
| 파트1 | 문제 · 선행연구 · 모델링 | 46 |
| **파트2** | 상태공간 → 균형정의 → 접기 → 두 직선 → **ε\*** → 시뮬의 이상함 → 예측점·차원축소 | **72** |
| 파트3 | **증분 접기**(최종 메커니즘) · 현실 구현 · 결론 및 제언 | 62 |

**1분 균등 배분은 해제되었다.** 총합 180초.

**경계는 질문이자 반전이다.** 파트2 마지막 비트가 *"그럼 이걸, 진짜 로봇에 넣으면 될까요?"* 로 끝나고, **파트3 첫 비트(현실을 넣은 시뮬)가 "안 됩니다"로 답한다.** 질문에 답하면서 동시에 반전이 된다. (2026-08-21 파트3 설계 시 변경 — 문서 64 §3)

> **완전 사이클(FWE)은 발표에서 들어냈다** (2026-08-21 결정). ε\* → 완전 사이클은 논리적으로 자연스럽지만, 그 뒤에 다시 증분 접기로 갈아타야 해서 **3분 안에 전환이 두 번** 생긴다. 세웠다 무너뜨리는 비용이 얻는 것보다 크다 — 원칙 ④를 파트2까지 확장한 결과다. → §8.

---

## 2. 파트2 설계 원칙

### 원칙 ⑥. 말은 1분이면 잊힌다. 그림은 안 잊힌다

**파트2는 72초다. 1번 비트의 내용은 7번 비트에서 이미 청중의 머리에 없다.** 정보량이 많아서 기억이 아니라 소실이 일어난다.

그런데 **잊히는 것은 말이지 화면이 아니다.** 계속 떠 있는 것은 잊을 수가 없다. 그래서:

> **β·φ 평면은 파트2 내내 화면에서 사라지지 않는다. 하나의 평면이 계속 자란다.**
>
> 점 하나 → 궤적 → 안 커지는 직선 → 접기 직선 → 교점 → 곡선 → 예측점

**비트가 넘어갈 때 화면을 갈아끼우지 않는다. 한 겹씩 덧그린다.** 그러면 8번에서 1번을 되돌아볼 필요가 없다 — 아직 거기 있으니까. 파트1의 불가능 카드(왼쪽 → 오른쪽)와 같은 문법인데, 파트2는 두 배 길어서 이것이 선택이 아니라 **필수**가 된다.

**이 원칙의 직접적 귀결**: 정의를 말로 하지 않는다. 균형의 정의(2번)를 *"커지지 않으면 균형"*이라는 명제로 말하면 명제 하나가 남고 곧 사라진다. 평면 위에서 하면 **커지는 궤적 / 안 커지는 궤적**이라는 광경이 남는다.

### 원칙 ⑦. 이름은 늘리지 말고 정교하게 만든다

접기 계열의 이름을 셋 쓰되 **한 방향으로만** 간다.

**발표에 나오는 접기 계열의 이름은 딱 둘이다.**

| 순서 | 이름 | 위치 |
|---|---|---|
| ① | **접기** | 파트2 3번 — 허리를 접으면 발이 밀린다는 사실만 |
| ② | **증분 접기** | 파트3 — 최종형 |

**"FWE"도 "완전 사이클"도 발표 어디에서도 쓰지 않는다.**

**왜 셋에서 둘로 줄였나** (2026-08-21 결정)

처음에는 **접기 → 완전 사이클 → 증분 접기** 세 단계였다. ε\* 다음에 완전 사이클이 오는 것은 논리적으로 자연스럽다 — 접었으면 펴야 하고, 접기와 펴기가 크기는 같고 방향만 반대이므로 기다림이 강제된다. 그런데 그 뒤에 **다시 증분 접기로 갈아타야** 한다.

**3분 안에 전환이 두 번이면 청중은 세 이름의 차이를 찾느라 흐름을 놓친다.** 완전 사이클은 우리가 지나온 경로일 뿐 최종형이 아니므로, 세웠다 무너뜨리는 비용이 얻는 것보다 크다. **원칙 ④("최종형이 아닌 것을 크게 세우지 않는다")를 파트2까지 확장한 결과다.**

**"비동기 FWE"도 쓰지 않는다.** FWE는 발표에서 한 번도 정의되지 않으므로, 정의 없는 약어를 파트3에서 처음 꺼내면 "저게 뭐지"에 시간이 샌다. 그리고 **"증분"은 스스로 설명하지만**("한 번에 다"가 아니라 "조금씩") **"비동기"는 무엇과 무엇이 동기가 아닌지 추가 설명을 요구한다.**

**발표용 이름과 보고서용 이름은 달라도 된다.** 보고서·질의응답에서는 정확한 기술명(비동기 FWE)을 쓰고, 심사위원이 물으면 *"보고서에서는 비동기 FWE라고 부릅니다"* 로 답하면 정확성도 지켜진다.

### 원칙 ③(파트1에서 계승). 기호는 말하지 않고 화면 라벨로

파트1에서 φ를 화면 라벨로만 두고 말하지 않았다. **그때 아낀 시간을 파트2 1번에서 쓴다** — 여기서 β·φ를 처음으로 말로 소개한다. "상태공간"이라는 용어는 화면 제목으로만 놓는다.

---

## 3. 채택 경위 — 왜 상태공간이 앞인가

두 안을 놓고 비교했다.

- **1안**: 균형정의 → 접기 → (도구가 필요하다는 실마리) → 상태공간 → 두 직선 → ε\* → ε\*_gen → …
- **2안**: 상태공간 → 균형정의 → 접기 → 두 직선 → ε\* → …

**2안 채택.** 결정적인 이유는 **균형의 정의를 상태공간 위에서 할 수 있다**는 것이다.

1. 정의가 명제가 아니라 **광경**이 된다 (원칙 ⑥).
2. 그 광경이 그대로 두 직선의 실마리가 된다 — "안 커지는 상태들"을 평면에 찍으면 **직선 위에 놓인다.** 성분 분해를 한 마디도 하지 않고 직선이 나온다. 1안은 균형정의를 말로 끝내 버려서 이 연결이 생기지 않는다.

**2안의 우려("도구가 동기 없이 툭 나와 감탄 1개가 사라진다")는 대체로 상쇄된다.** 파트1이 *"안 떨어진다는 게 뭘까요?"* 로 끝나므로, 그 질문에 답하려면 상태를 봐야 하고 상태가 둘이면 평면이 필요하다. 파트1이 이미 동기를 만들어 두었다. 그리고 낙차 카드가 계속 떠 있어 이 화면은 잊힐 수 없다.

**ε\*_gen은 제거한다.** 절정 직후에 일반화를 붙이면 청중은 *"아까 그건 특수한 경우였나?"* 로 되돌아간다. 각주를 다는 셈이다. 일반화는 질의응답에서 *"이 조건에서만 되는 것 아닙니까?"* 가 나올 때 꺼내면 그 사람의 질문에 대한 답이 된다.

---

## 4. 파트2 비트표 (72초 / 7비트)

기준 속도 **초당 5자**. 대사는 초안이 있는 것만 적었다.

| # | 비트 | 초 | 대사 / 내용 | 평면에 더해지는 것 |
|---|---|---:|---|---|
| **1** | **상태공간** | 9 | "로봇의 상태는 두 좌표로 정해집니다 — 몸이 기운 각 β, 줄이 흔들린 각 φ. 둘을 축으로 잡으면, 점 하나가 됩니다." (45자) | 축 + 점. **"상태공간"은 화면 제목** |
| **2** | **균형의 정의** | 9 | 궤적이 커지나, 안 커지나 | 궤적 2개 (발산 / 유계) |
| **3** | **접기 + 질문** | 7 | "허리를 접으면, 반작용으로 발이 밀립니다. 점이 움직이죠. — **그럼, 얼마나 접어야 할까요?**" (37자) | 점의 이동 |
| **4** | **두 직선** | 11 | 안 커지는 상태들은 직선 위에 놓인다 / 접기는 다른 직선을 따라 미끄러진다 | ★**낙차 카드** + ★**시뮬레이션** — **둘 다 필수** |
| **5** | **ε\*** | 15 | 교점. 1차방정식 두 개. 기운 크기가 식에 없다. ⏸**3초** | 교점 + 식 |
| **6** | **시뮬의 이상함** | 4 | "그런데 — 돌려 보면, 뭔가 이상합니다." (15자) | 시뮬 재생 — **접기 경로가 직선이 아니라 곡선으로 휜다** |
| **7** | **예측점 · 차원축소 + 넘기는 질문** | 17 | 발은 줄에 붙어 있다 → 접는 **동안** 외력이 작용할 시간이 생긴다 → **무게중심 위치가 바뀐다** → **접기가 끝날 때**의 상태를 봐야 한다. ⏸**2초** — *"그럼 이걸, 진짜 로봇에 넣으면 될까요?"* | 예측점 |

### 비트별 의도 (원안의 괄호 주석을 옮긴 것)

| # | 의도 |
|---|---|
| 1 | 상태공간을 맨 앞에 두면 *"로봇 상태를 이렇게 나타낼 수도 있네!"* 라는 감탄 1개가 빠진다. 그러나 **낙차 카드가 계속 떠 있어 이 화면은 잊힐 수 없으므로** 그 손실을 감수한다. 파트1에서 φ를 말로 하지 않고 아낀 3초를 여기서 쓴다 |
| 2 | **모드에 대한 실마리.** 상태공간 위에서 정의함으로써 4번의 직선이 공짜로 나온다 |
| 3 | **접기만**(원칙 ⑦). 그리고 **비트 끝에서 "얼마나 접어야 하나"를 연다** — 4·5번이 그 하나에만 답한다 (원칙 ①) |
| 4 | 모드지만 **두 직선으로만** 말한다. "모드"라는 단어를 쓰지 않는다. 2번의 실마리와 연결된다 |
| 5 | 상태공간이 앞에 있으므로 1안보다 놀라움이 크다. **ε\*_gen은 과감히 제거** |
| 6 | **이유를 말하지 않는다.** 이상하다는 것만. 4초 동안 청중이 스스로 "왜지?"를 만든다 |
| 7 | **발이 줄에 붙어 있다는 것을 암시.** 2초 침묵으로 큰 흐름을 한 번 더 끊는다. 그리고 **파트3을 부르는 질문으로 닫는다** — 파트3 1번이 "안 됩니다"로 답하면서 반전이 열린다 |

---

## 5. 6→7번의 물리 — 파트2에서 유일한 예측-위반 장치

**5번까지 청중은 "ε\*대로 접으면 된다"고 믿게 된다. 6번이 그 믿음을 깬다.**

ε\*는 **순간 접기 가정**에서 나온 값이다. 접는 데 걸리는 시간이 0이면 **줄이 발에 주는 외력이 작용할 시간도 없다.** 무게중심은 제자리에 있고, 상태는 무게중심 등고선이라는 **직선**을 따라 미끄러져 교점에 정확히 닿는다.

그런데 실제 접기에는 시간이 걸린다. 그 시간 동안:

1. **외력이 작용할 시간이 생긴다** — 줄이 발을 통해 힘을 주고, 그만큼 **무게중심의 위치가 바뀐다.** 무게중심이 바뀌면 애초에 등고선 위에 있지 않게 된다
2. **관성** 때문에 몸도 계속 움직인다

그래서 **실제 경로는 직선이 아니라 곡선으로 휜다.** 교점을 겨냥해도 다른 데 도착한다.

> ⚠ **"상태가 흘러간다"는 식으로 뭉뚱그리지 않는다.** 원인은 **외력의 작용 시간**이고 결과는 **무게중심 위치 변화**다. 이걸 뭉개면 6번의 곡선이 왜 생기는지 설명할 수 없다.

**이것이 파트1의 회수다.** 파트1은 *"내력으로는 무게중심을 못 옮긴다 / 처진 줄이 외력을 준다"* 로 문제를 세웠다. 파트2 7번은 그 외력이 **시간을 두고** 작용한다는 사실로 되돌아온다. 같은 물리가 두 번, 다른 해상도로 쓰인다.

→ 해법은 **"지금 상태"가 아니라 "접기가 끝날 때의 상태"를 보는 것** = 예측점. 그리고 위치와 속도를 한 점에 담으면 균형 판정이 **직선까지의 거리 하나**로 줄어든다 = 차원축소.

**6번의 화면이 이 비트의 전부다.** 직선이어야 할 경로가 곡선으로 휘는 그림 하나면 말이 필요 없다. 6번을 4초로 줄일 수 있는 이유도 여기 있다 — **화면이 이미 말하고 있으므로 이유를 설명할 필요가 없다.**

---

## 6. 낙차 카드 한 장

**완전 사이클을 들어내면서 낙차 카드도 한 장이 됐다** — 4·5번(벽 ↔ 두 직선 ↔ ε\*)뿐이다.

이로써 **절정이 5번으로 확정된다.** 두 장이었을 때는 8번(19초)이 5번(15초)보다 길어 절정이 어디인지 흐려졌고, 두 번째 카드가 첫 번째의 충격을 나눠 가질 위험도 있었다. 둘 다 해소됐다. **T_w · F_fwe 식을 확정해야 하는 부담도 사라진다.**

**α·θ의 자리**: 카드 왼쪽(벽)에서만 나타난다. 설명 대상이 아니라 벽의 재료다. 가리키며 "셋이 얽혀 있습니다" 정도로 지나가고 다시 돌아오지 않는다. 이렇게 하면 카드가 말 없이 차원축소를 보여준다 — **좌표 셋(α, θ, φ) → 좌표 둘(β, φ) → 직선 하나 → 숫자 하나.** φ가 양쪽에 다 있어 다리 역할을 한다.

---

## 7. 미결 사항 — 내부용

1. **파트2에서 남은 시간(72초)과 파트3(62초)의 배분 확정** — 파트3 설계 시.
2. **4번의 낙차 카드와 시뮬레이션을 11초에 둘 다 소화할 수 있는지.** 시각 요소 둘이 한 비트에 들어간다. 리허설로 실측.
3. **2번의 대사 초안** 미작성.
4. **6번 시뮬 영상** — 곡선으로 휘는 것이 눈에 보이게 렌더링 조건을 잡아야 한다. 이 비트는 화면이 전부다.
5. **파트1 대사의 소소한 수정 사항**이 남아 있다(별건).
6. **완전 사이클을 뺀 대가 관리** — "실물이 이론을 고쳐 썼다"는 반전 서사가 3분에서 사라진다. 노력도(15점)의 재료였으므로 **질의응답에서 반드시 회수해야 한다**(§8).

> **해소된 미결**: 8번 낙차 카드의 T_w · F_fwe 식(비트 삭제로 불필요) / 절정이 5번인가 8번인가(5번으로 확정) / "완전 사이클"이라는 이름의 재검토(이름 자체가 사라짐).

---

## 8. 파트3으로 넘긴 것

| 항목 | 이유 |
|---|---|
| **증분 접기** | 최종 메커니즘. 파트3의 첫 비트이며, 파트2 7번의 질문에 직접 답한다 — *"매 순간 예측점을 재서, 벗어난 만큼만 접습니다"* |
| **현실 구현 · 로봇 시연** | |
| **결론 및 제언** | |

## 질의응답으로 넘긴 것

| 항목 | 언제 꺼내나 |
|---|---|
| **완전 사이클 · 실측 마찰 · 펴기 생략** | *"시행착오가 있었습니까 / 가장 어려웠던 게 뭡니까"* — **"실물이 이론을 고쳐 썼다"는 반전 서사 전체.** 3분에서 뺀 대신 여기서 반드시 회수한다. 노력도 15점의 재료다 |
| **ε\*_gen (일반화)** | *"이 조건에서만 되는 것 아닙니까?"* — 그 사람의 질문에 대한 답이 된다 |
| **"비동기 FWE"라는 기술명** | 명칭을 물을 때. 보고서에서는 계속 쓴다 |

---

## 9. 발표 자료 금지선 — 계승

문서 61 §9와 동일하게 적용한다. 파트2에서 특히 주의할 항목:

- **"저 식(ε\*)이 로봇 안에서 돌고 있다"고 말하지 않는다.** 실기 펌웨어에서 도는 것은 ε\* 자체가 아니다. 파트3에서도 같다
- **"아직 / 미완 / 불일치" 서술 금지** — §7 미결 항목은 이 문서에만 존재한다
- 복원 성능 자랑 금지. 실물은 감탄이 아니라 증거로 쓴다

---

*파트2 구상 시점의 기록. 대사 확정과 §7 미결 해소 후 "확정본"으로 갱신할 것.*
