cbshbalance/slackline-balacing1/docs/cowork/63_발표흐름_통합본_20260821.md

> ⚠ **이 문서는 문서 65(세 파트 통합 최종본)로 대체되었다.** 파트1·2만 있던 시점의 기록으로 남겨 둔다. 파트2 7번의 마무리 질문은 이후 변경되었다(문서 64 §3).

# 63. 발표 흐름 — 통합본 (파트1 확정 + 파트2 구상) · 2026-08-21

> **문서 61(파트1 확정본)과 62(파트2 구상안)를 합친 것.** 두 문서의 설계 원칙·자산·미결을 한 자리에 모아 중복을 없앴다. 개별 논의 경위는 61·62에 남아 있고, **이 문서가 작업용 정본이다.**
> 3분 발표를 **백지에서 짠** 흐름이다. 기존 발표 설계 문서의 서사 구조·단계 구분·용어를 이어받지 않는다. 참고한 것은 **전람회 심사 형식**과 **발표 자료 금지선**뿐이다.
> **상태**: 파트1 확정 / 파트2 구상 / 파트3 미착수.
> §11·§12는 **내부용**이며 화면·대본에 옮기지 않는다.

---

# Ⅰ. 조건과 구조

## 1. 심사 형식

| 항목 | 내용 |
|---|---|
| 대상 | 제72회 전국과학전람회 **2차 면담심사 (2026-09-15)** |
| 부문 | 물리, 학생부 (출품번호 1167) |
| 시간 | **발표 3분 + 질의응답 10분**, 총 13분. 형식은 자유 |
| 심사위원 | **3인 — 물리 전공자 · 공학 전공자 · 변리사** |
| 참여 | 학생 3명 전원 입실. 한 질문에 나눠 답하거나 서로 보충 가능 |
| 시연 | **전시대 위 실물 시연 포함.** 질의 중에도 가능 |
| 배점 (70) | 창의성·탐구성 **30** / 이론적 타당성 15 / 노력도 **15** / 실용성 10 |

**설계에 직접 영향을 주는 조건 셋**

1. **3분은 짧고 10분은 길다.** 3분에 다 넣으려 하면 아무것도 남지 않는다. 3분은 **질문이 나오게 만드는 시간**이고, 본편은 10분이다.
2. **심사위원 셋 중 하나는 비전공자다.** 수식·기호·전문용어를 말로 소개하면 그 한 사람을 잃는다. → 원칙 ③.
3. **실물이 옆에 서 있다.** 화면과 실물이 같은 것을 말하고 있다는 감각이 발표 내내 유지되어야 한다.

## 2. 전체 구조와 시간

| 파트 | 담는 것 | 초 | 상태 |
|---|---|---:|---|
| **파트1** | 문제 인식 · 선행연구 · 모델링 | **46** | **확정** |
| **파트2** | 상태공간 → 균형정의 → 접기 → 두 직선 → **ε\*** → 시뮬의 이상함 → 예측점·차원축소 | **72** | **구상** |
| **파트3** | **증분 접기**(최종 메커니즘) · 현실 구현 · 결론 및 제언 | **62** | 미착수 |

**당초 1분 균등 배분으로 출발했으나 해제되었다.** 46 / 72 / 62, 총합 **180초**. 파트3 배분은 착수 시 확정한다.

## 3. 파트 경계

| 경계 | 방식 | 문장 |
|---|---|---|
| **파트1 → 2** | **질문** | *"안 떨어진다는 게, 뭘까요?"* → 파트2 1·2번이 답한다 |
| **파트2 내부 (5→6)** | **예측 위반** | *"그런데 — 돌려 보면, 뭔가 이상합니다."* |
| **파트2 → 3** | **질문** | *"그럼, 로봇은 지금 뭘 하고 있을까요?"* → 파트3 증분 접기가 답한다 |

세 경계가 **모두 청중을 앞으로 당긴다** — 정리하고 넘어가는 경계가 하나도 없다.

파트2→3은 특히 **예측점이 곧 증분 접기가 재는 것**이라 두 파트가 물리적으로 직접 물린다. 중간에 다른 메커니즘을 거치지 않는다(원칙 ⑦).

---

# Ⅱ. 설계 원칙 (①~⑦)

### 원칙 ①. 질문은 한 번에 하나만 연다

**여러 질문을 쌓아 놓고 나중에 답하면 청중이 앞 질문을 잊는다.** 하나를 열고, 실마리를 주고, 그 하나를 닫는다. 다음 질문은 그 뒤에 연다.

초안이 이 원칙을 어겼던 지점: 모델링 비트 끝에서 *"얼마나 접나? 그 전에 어디로 가야 하나?"* 로 **두 질문을 동시에 열고** 두 번째부터 답하는 구조였다.

**실마리는 구체적인 사실이어야 한다.** "차이가 하나 있습니다"까지만 하면 그건 실마리가 아니라 티저이고, "질문 → 실마리 → 답"에서 가운데가 빈다.

### 원칙 ②. 파트는 질문으로 끝내고, 다음이 그 답으로 연다

→ §3.

### 원칙 ③. 기호는 말하지 않고 화면 라벨로만 놓는다

**안 읽고 온 심사위원이 최우선 대상이다.** 좌표를 말로 소개하면 벽이 되고, 화면 라벨로 놓으면 전공자만 읽는다. **같은 화면이 두 청중에게 다르게 작동한다.**

| 기호 | 취급 |
|---|---|
| **φ** | 파트1 5번 화면에 라벨만. 말하지 않는다. **파트2 1번에서 처음 말로 소개** — 파트1에서 아낀 3초를 여기서 쓴다 |
| **β** | 파트2 1번에서 φ와 함께 |
| **α · θ** | **낙차 카드 왼쪽(벽)에서만.** 설명 대상이 아니라 **벽의 재료**다. "셋이 얽혀 있습니다" 정도로 지나가고 다시 돌아오지 않는다 |
| **"상태공간"** | 용어는 화면 제목으로만 |

이렇게 하면 카드가 말 없이 차원축소를 보여준다 — **좌표 셋(α, θ, φ) → 좌표 둘(β, φ) → 직선 하나 → 숫자 하나.** φ가 양쪽에 다 있어 다리 역할을 한다.

### 원칙 ④. FWE 메커니즘을 파트1에 넣지 않는다

1. **최종형이 아니다.** 실측 마찰 조건에서 완전 사이클이 무너졌고 최종 제어기는 증분 접기다. 크게 세우면 **나중에 철회해야 한다.** (→ 이 논리를 끝까지 밀어 **파트2에서도 완전 사이클 비트를 들어냈다.** 원칙 ⑦)
2. **층위가 다르다.** 역발상("발을 옮긴다")은 원리, 접기 시퀀스는 실행이다. 시퀀스는 "얼마나"에 답한 뒤에 자리가 있다.
3. 부수 효과: 전공 심사위원의 *"왜 FWE가 맞다고 보는가"* 는 **파트1에서 세우지 않으면 발생하지 않는다.**

### 원칙 ⑤. 서양 장대는 말에서 빼고 화면에 남긴다

대사로 동서양을 비교하면 청중이 두 대상을 동시에 머리에 올려야 해서 느려진다. 그러나 화면에서까지 빼면 파트3에서 장대를 다시 쓸 여지가 사라진다.

→ **한국 영상을 크게, 장대 사진을 구석에 작게.** 파트3에서 다시 크게 띄우면 회수가 성립한다.

### 원칙 ⑥. 말은 1분이면 잊힌다. 그림은 안 잊힌다

**파트2는 72초다. 1번 비트의 내용은 7번 비트에서 이미 청중의 머리에 없다.** 정보량이 많아서 기억이 아니라 소실이 일어난다. 그런데 **잊히는 것은 말이지 화면이 아니다.**

> **β·φ 평면은 파트2 내내 화면에서 사라지지 않는다. 하나의 평면이 계속 자란다.**
>
> 점 하나 → 궤적 → 안 커지는 직선 → 접기 직선 → 교점 → 곡선 → 예측점

**비트가 넘어갈 때 화면을 갈아끼우지 않는다. 한 겹씩 덧그린다.** 그러면 8번에서 1번을 되돌아볼 필요가 없다 — 아직 거기 있으니까.

**파트1도 같은 문법이다** — 불가능 카드가 1번에서 왼쪽만 뜨고 4번에서 오른쪽이 채워진다. 파트1에서는 선택이지만 **파트2에서는 필수**다.

**직접적 귀결: 정의를 말로 하지 않는다.** 균형의 정의를 *"커지지 않으면 균형"* 이라는 명제로 말하면 명제 하나가 남고 곧 사라진다. 평면 위에서 하면 **커지는 궤적 / 안 커지는 궤적**이라는 광경이 남는다.

### 원칙 ⑦. 이름은 늘리지 말고 정교하게 만든다

**발표에 나오는 접기 계열의 이름은 딱 둘이다.**

| 순서 | 이름 | 위치 |
|---|---|---|
| ① | **접기** | 파트2 3번 — 허리를 접으면 발이 밀린다는 사실만 |
| ② | **증분 접기** | 파트3 — 최종형 |

**"FWE"도 "완전 사이클"도 발표 어디에서도 쓰지 않는다.**

### 왜 셋에서 둘로 줄였나 (2026-08-21 결정)

처음에는 **접기 → 완전 사이클 → 증분 접기** 세 단계였다. ε\* 다음에 완전 사이클이 오는 것은 논리적으로 자연스럽다 — 접었으면 펴야 하고, **접기와 펴기가 크기는 같고 방향만 반대**이므로 즉시 펴면 정확히 상쇄되어 기다림이 강제된다. 깔끔한 귀결이다.

**그런데 그 뒤에 다시 증분 접기로 갈아타야 한다. 3분 안에 전환이 두 번이면 청중은 세 이름의 차이를 찾느라 흐름을 놓친다.** 완전 사이클은 우리가 지나온 경로일 뿐 최종형이 아니므로, 세웠다 무너뜨리는 비용이 얻는 것보다 크다. **원칙 ④를 파트2까지 확장한 결과다.**

**"비동기 FWE"도 쓰지 않는다.** FWE는 발표에서 한 번도 정의되지 않으므로, 정의 없는 약어를 파트3에서 처음 꺼내면 "저게 뭐지"에 시간이 샌다. 그리고 **"증분"은 스스로 설명하지만**("한 번에 다"가 아니라 "조금씩") **"비동기"는 무엇과 무엇이 동기가 아닌지 추가 설명을 요구한다.**

**발표용 이름과 보고서용 이름은 달라도 된다.** 보고서·질의응답에서는 정확한 기술명(비동기 FWE)을 쓰고, 심사위원이 물으면 *"보고서에서는 비동기 FWE라고 부릅니다"* 로 답하면 정확성도 지켜진다.

**대가**: "실물이 이론을 고쳐 썼다"는 반전 서사가 3분에서 사라진다. 노력도(15점)의 재료였으므로 **질의응답에서 반드시 회수한다** → §10.

**같이 해소된 것 셋**: 낙차 카드가 한 장이 되어 **절정이 5번(ε\*)으로 확정**된다 / T_w · F_fwe 식을 확정할 부담이 사라진다 / "완전 사이클"이라는 이름의 계열 이탈 문제가 없어진다.

---

# Ⅲ. 파트1 — 확정 (46초 / 232자)

기준 속도 **초당 5자**. "자"는 공백 제외.

| # | 비트 | 초 | 자 | 대사 | 화면 · 동작 |
|---|---|---:|---:|---|---|
| **1** | **장대가 없다** | 8 | 37 | "한국 줄타기입니다. 장대는 토크를 만듭니다. 부채는 못 만듭니다. 그런데 — 떨어지지 않습니다." | 한국 줄타기 영상 크게 / 장대 사진 구석에 작게 |
| **2** | **얼음판 — 불가능** | 6 | 32 | "얼음판 위라면, 몸속에서 뭘 해도 무게중심은 안 움직입니다. 기울면 끝입니다." | ★**불가능 카드 왼쪽 칸** |
| **3** | **실마리 — 줄은 처져 있다** | 5 | 24 | "그런데 얼음판과 다른 게 하나 있습니다. 줄은 — **처져 있습니다.**" | 처진 줄 형태 (원호는 아직 아님) |
| **4** | **역발상 — 발을 옮긴다** | 10 | 51 | "무게중심을 못 옮기면, 발을 옮기면 됩니다. 처진 줄에서는, 발이 옆으로 가면 줄이 몸을 끌어옵니다. 발 위치가 힘으로 바뀌는 겁니다." | ★**추 시연** + 불가능 카드 **오른쪽 칸 채워짐** |
| **5** | **파올레티** | 10 | 52 | "이걸 다룬 논문 하나가, 줄의 처짐을 **원호**로 봤습니다. 위치가 **각도 하나**로 정리되죠. 그런데 균형은 — **장대와 팔의 몫**이었습니다." | 논문 표지 → 원호 R + φ 라벨 |
| **6** | **허리 + 넘기는 질문** | 7 | 36 | "우리에겐 둘 다 없습니다. 막대를 둘로 나누고, 허리를 넣었습니다. — **안 떨어진다는 게, 뭘까요?**" | 1체→2체 애니 5초 |

**어름이 눈길 3초는 46초 밖에 둔다.** 입장·인사 구간에서 심사위원이 자연스럽게 보게 된다. 로봇은 발표 시작 전부터 이미 줄 위에서 균형을 잡고 있는 것을 전제로 한다.

## 비트별 주석

**1번.** "부채는 힘이 없다"가 아니라 **"토크를 못 만든다"**로 간다. 물리적으로 정확하고 전공자에게 즉시 꽂힌다.

> ⚠ **여기서 "줄은 느슨하다"를 말하지 않는다.** 줄이 처져 있다는 것은 **3번의 재료**이고, 1번에서 흘리면 실마리를 답보다 먼저 줘 버린다. 1번은 순수하게 **"토크를 낼 수단이 없다 — 그런데 안 떨어진다"** 하나만 세운다.
>
> **"일부러 느슨하다"는 더 강한 금지다.** 광대가 왜 줄을 느슨하게 매는지는 **우리 연구가 설명해 내는 결과**이지 전제로 던질 사실이 아니다. 전제로 던지면 답할 수 없는 질문("왜 일부러?")이 파트1 내내 떠 있게 된다. → §10 회수 후보.

**2번.** "얼음판"·"무게중심"·"기울면 끝" 셋만 남긴다. 나머지는 화면이 말한다.

**3번.** **실마리는 구체적인 사실이어야 한다**(원칙 ①). 화면도 처짐을 뒷받침하되 **원호는 아직 그리지 않는다** — 원호는 5번에서 논문이 주는 것이다.

**4번.** 추 시연이 이 비트의 본체다. **관절 없는 추는 저절로 돌아오는데 사람은 안 돌아온다** — 이 대비가 그대로 6번(허리)의 동기가 된다. 로봇을 쓰지 않으므로 낙하 위험이 없다.

**5번.** 논문이 **도구 제공자**로 위치한다 — 원호 처짐 모델과 좌표계를 빌려 왔고, 답(장대·팔)은 버렸다. "장대와 팔의 몫"으로 끝내면 **1번을 회수하면서 6번의 첫 문장을 부른다.** 신규성 근거가 이 한 문장에 선다.

**6번.** "접으면 반작용으로 발이 밀린다"는 **대사에서 뺀다.** 애니메이션이 정확히 그것을 보여주므로 중복이고, 7초에 셋을 넣으면 초과한다.

## 파트1 질문 사슬

```
Q1  장대 없이 어떻게 서 있나?              [비트 1]
      ↓ 얼음판 — 몸속 힘으로는 불가능       [비트 2]
      ↓ 실마리 — 줄은 처져 있다             [비트 3]
A1  발을 옮기면 된다                       [비트 4]  ✔ 닫힘
      ↓
    (논문: 원호·좌표는 빌렸다 / 답은 장대와 팔이었다)   [비트 5]
      ↓
Q2  우리에겐 장대도 팔도 없는데?
A2  허리를 만들었다                         [비트 6]  ✔ 닫힘
      ↓
Q3  안 떨어진다는 게 뭔가?                  [비트 6 끝] → 파트2
```

---

# Ⅳ. 파트2 — 구상 (72초 / 7비트)

| # | 비트 | 초 | 대사 / 내용 | 평면에 더해지는 것 |
|---|---|---:|---|---|
| **1** | **상태공간** | 9 | "로봇의 상태는 두 좌표로 정해집니다 — 몸이 기운 각 β, 줄이 흔들린 각 φ. 둘을 축으로 잡으면, 점 하나가 됩니다." (45자) | 축 + 점. **"상태공간"은 화면 제목** |
| **2** | **균형의 정의** | 9 | 궤적이 커지나, 안 커지나 | 궤적 2개 (발산 / 유계) |
| **3** | **접기 + 질문** | 7 | "허리를 접으면, 반작용으로 발이 밀립니다. 점이 움직이죠. — **그럼, 얼마나 접어야 할까요?**" (37자) | 점의 이동 |
| **4** | **두 직선** | 11 | 안 커지는 상태들은 직선 위에 놓인다 / 접기는 다른 직선을 따라 미끄러진다 | ★**낙차 카드** + ★**시뮬레이션** — **둘 다 필수** |
| **5** | **ε\*** | 15 | 교점. 1차방정식 두 개. 기운 크기가 식에 없다. ⏸**3초** | 교점 + 식 |
| **6** | **시뮬의 이상함** | 4 | "그런데 — 돌려 보면, 뭔가 이상합니다." (15자) | 시뮬 재생 — **접기 경로가 직선이 아니라 곡선으로 휜다** |
| **7** | **예측점 · 차원축소 + 넘기는 질문** | 17 | 발은 줄에 붙어 있다 → 접는 **동안** 외력이 작용할 시간이 생긴다 → **무게중심 위치가 바뀐다** → **접기가 끝날 때**의 상태를 봐야 한다. ⏸**2초** — *"그럼, 로봇은 지금 뭘 하고 있을까요?"* | 예측점 |

## 비트별 의도

| # | 의도 |
|---|---|
| 1 | 상태공간을 맨 앞에 두면 *"로봇 상태를 이렇게 나타낼 수도 있네!"* 라는 감탄 1개가 빠진다. 그러나 **낙차 카드가 계속 떠 있어 이 화면은 잊힐 수 없으므로** 그 손실을 감수한다 |
| 2 | **모드에 대한 실마리.** 상태공간 위에서 정의함으로써 4번의 직선이 공짜로 나온다 |
| 3 | **접기만**(원칙 ⑦). 그리고 비트 끝에서 **"얼마나 접어야 하나"를 연다** — 4·5번이 그 하나에만 답한다(원칙 ①) |
| 4 | 모드지만 **두 직선으로만** 말한다. "모드"라는 단어를 쓰지 않는다. 2번의 실마리와 연결된다 |
| 5 | 상태공간이 앞에 있으므로 놀라움이 크다. **ε\*_gen은 과감히 제거** |
| 6 | **이유를 말하지 않는다.** 이상하다는 것만. 4초 동안 청중이 스스로 "왜지?"를 만든다 |
| 7 | **발이 줄에 붙어 있다는 것을 암시.** 2초 침묵으로 큰 흐름을 한 번 더 끊는다. 그리고 **파트3을 부르는 질문으로 닫는다** — 예측점이 곧 증분 접기가 재는 것이므로 두 파트가 직접 물린다 |

## 왜 상태공간이 앞인가 — 채택 경위

- **1안**: 균형정의 → 접기 → (도구가 필요하다는 실마리) → 상태공간 → 두 직선 → ε\* → ε\*_gen → …
- **2안 (채택)**: 상태공간 → 균형정의 → 접기 → 두 직선 → ε\* → …

결정적 이유는 **균형의 정의를 상태공간 위에서 할 수 있다**는 것이다.

1. 정의가 명제가 아니라 **광경**이 된다 (원칙 ⑥).
2. 그 광경이 그대로 두 직선의 실마리가 된다 — "안 커지는 상태들"을 평면에 찍으면 **직선 위에 놓인다.** 성분 분해를 한 마디도 하지 않고 직선이 나온다.

**2안의 우려("도구가 동기 없이 툭 나온다")는 대체로 상쇄된다.** 파트1이 Q3로 끝나므로, 답하려면 상태를 봐야 하고 상태가 둘이면 평면이 필요하다. **파트1이 이미 동기를 만들어 두었다.**

**ε\*_gen 제거**: 절정 직후에 일반화를 붙이면 청중은 *"아까 그건 특수한 경우였나?"* 로 되돌아간다. 일반화는 질의응답에서 *"이 조건에서만 되는 것 아닙니까?"* 가 나올 때 꺼내면 그 사람의 질문에 대한 답이 된다.

---

# Ⅴ. 물리 — 두 번 쓰이는 것들

## 6. 처짐이 3층으로 쌓인다 (파트1)

| 층 | 위치 | 내용 |
|---|---|---|
| **사실** | 파트1 3번 | 줄은 처져 있다 |
| **의미** | 파트1 4번 | 그래서 발이 옆으로 가면 줄이 끌어온다 |
| **수학** | 파트1 5번 | 그 처짐을 원호로 보면 각도 하나로 정리된다 |

중복이 아니라 **해상도가 한 단계씩 올라가는** 구조다. **어느 층도 앞당겨 쓰면 안 된다** — 1번에서 "느슨하다"를 말하면 1층이 새고, 3번에서 원호를 그리면 3층이 샌다.

## 7. 외력이 두 번 쓰인다 (파트1 → 파트2 7번)

**파트2 6→7번은 파트2에서 유일한 예측-위반 장치다.** 5번까지 청중은 "ε\*대로 접으면 된다"고 믿게 되고, 6번이 그 믿음을 깬다.

ε\*는 **순간 접기 가정**에서 나온 값이다. 접는 데 걸리는 시간이 0이면 **줄이 발에 주는 외력이 작용할 시간도 없다.** 무게중심은 제자리에 있고, 상태는 무게중심 등고선이라는 **직선**을 따라 미끄러져 교점에 정확히 닿는다.

그런데 실제 접기에는 시간이 걸린다. 그 시간 동안:

1. **외력이 작용할 시간이 생긴다** — 줄이 발을 통해 힘을 주고, 그만큼 **무게중심의 위치가 바뀐다.** 무게중심이 바뀌면 애초에 등고선 위에 있지 않게 된다
2. **관성** 때문에 몸도 계속 움직인다

그래서 **실제 경로는 직선이 아니라 곡선으로 휜다.** 교점을 겨냥해도 다른 데 도착한다.

> ⚠ **"상태가 흘러간다"는 식으로 뭉뚱그리지 않는다.** 원인은 **외력의 작용 시간**이고 결과는 **무게중심 위치 변화**다. 뭉개면 6번의 곡선이 왜 생기는지 설명할 수 없다.

**이것이 파트1의 회수다.** 파트1은 *"내력으로는 무게중심을 못 옮긴다 / 처진 줄이 외력을 준다"* 로 문제를 세웠다. 파트2 7번은 그 외력이 **시간을 두고** 작용한다는 사실로 되돌아온다. 같은 물리가 두 번, 다른 해상도로 쓰인다.

→ 해법은 **"지금 상태"가 아니라 "접기가 끝날 때의 상태"를 보는 것** = 예측점. 위치와 속도를 한 점에 담으면 균형 판정이 **직선까지의 거리 하나**로 줄어든다 = 차원축소.

**6번의 화면이 이 비트의 전부다.** 직선이어야 할 경로가 곡선으로 휘는 그림 하나면 말이 필요 없다. 6번을 4초로 줄일 수 있는 이유도 여기 있다.

---

# Ⅵ. 시각 자산

## 8. 파트1

| 비트 | 자산 | 상태 |
|---|---|---|
| 1 | 한국 줄타기 실사 영상 | 확보 + **라이선스 필요** |
| 1 | 서양 장대 사진 (구석용, 파트3 재사용) | 확보 필요 |
| 2·4 | ★**불가능 카드** — 2칸 (얼음판 \| 처진 줄) | **신규** |
| 3 | 처진 줄 형태 컷 — **원호는 그리지 않는다** | 신규 또는 실사 |
| 4 | ★**추 시연** — 줄 위 추, 손으로 밀면 복귀 | **신규 (실물)** |
| 5 | 논문 표지 | 쉬움 |
| 5 | 원호 R + φ 라벨 도해 | 신규 (손그림 가능) |
| 6 | 1체→2체 애니메이션 5초 | **신규** |

### 불가능 카드 — 파트1의 시각 앵커

```
┌────────────────────────┬────────────────────────┐
│   얼음판               │   처진 줄              │
│                        │                        │
│   내력으로는           │   발이 옆으로 가면     │
│   무게중심 불변        │   줄이 몸을 끌어온다   │
│                        │                        │
│   → 기울면 끝          │   → 발 위치가 힘이 된다│
└────────────────────────┴────────────────────────┘
     [비트 1에서 등장]         [비트 4에서 채워짐]
```

질의 중 *"왜 처진 줄이어야 하나"* 가 나오면 이 카드로 돌아온다.

## 9. 파트2

| 비트 | 자산 | 상태 |
|---|---|---|
| 1~7 | **β·φ 평면 — 한 장이 계속 자란다** (원칙 ⑥) | **신규, 최우선** |
| 2 | 발산 궤적 / 유계 궤적 | 신규 |
| 4 | ★**낙차 카드** (벽 ↔ 두 직선) | **신규** |
| 4 | 시뮬레이션 — 궤적이 직선을 드러냄 | 기존 시뮬 활용 |
| 5 | 교점 + ε\* 식 | 신규 |
| 6 | **곡선으로 휘는 시뮬** — 이 비트는 화면이 전부 | **신규, 렌더 조건 설계 필요** |
| 7 | 예측점 | 신규 |

### 낙차 카드는 한 장이다

완전 사이클을 들어내면서 두 번째 카드(T_w · F_fwe)가 사라졌다. 남은 한 장은 4·5번에서 **벽 ↔ 두 직선 ↔ ε\*** 를 담는다.

이로써 **절정이 5번으로 확정된다.** 두 장이었을 때는 두 번째 카드가 첫 번째의 충격을 나눠 가질 위험이 있었고, 8번(19초)이 5번(15초)보다 길어 절정이 어디인지도 흐려졌다. 둘 다 해소됐다.

---

# Ⅶ. 파트3과 미결

## 10. 파트3으로 넘긴 것

| 항목 | 이유 |
|---|---|
| **증분 접기** | 최종 메커니즘. 파트3의 첫 비트이며, 파트2 7번의 질문에 직접 답한다 — *"매 순간 예측점을 재서, 벗어난 만큼만 접습니다"* |
| **현실 구현 · 로봇 시연** | |
| **결론 및 제언** | |
| **서양 장대 사진 재등장** | 원칙 ⑤의 회수 |

## 10-1. 질의응답으로 넘긴 것

| 항목 | 언제 꺼내나 |
|---|---|
| **완전 사이클 · 실측 마찰 · 펴기 생략** | *"시행착오가 있었습니까 / 가장 어려웠던 게 뭡니까"* — **"실물이 이론을 고쳐 썼다"는 반전 서사 전체.** 3분에서 뺀 대신 여기서 반드시 회수한다. **노력도 15점의 재료다** |
| **ε\*_gen (일반화)** | *"이 조건에서만 되는 것 아닙니까?"* — 그 사람의 질문에 대한 답이 된다 |
| **"비동기 FWE"라는 기술명** | 명칭을 물을 때. 보고서에서는 계속 쓴다 |
| **T_w · F_fwe 식** | 완전 사이클을 물을 때 |

### 회수 후보 — "광대는 왜 줄을 느슨하게 매는가"

파트1에서 **의도적으로 던지지 않은** 사실이다. 전제가 아니라 **우리 결과가 설명해 내는 것**이므로, 파트3이나 질의응답에서 *"이제 광대가 왜 줄을 느슨하게 매는지 설명이 됩니다"* 로 꺼내면 회수가 성립한다. 파트1에서 미리 말해 버리면 이 카드가 사라진다.

## 11. 미결 사항 — 내부용

| # | 항목 | 관련 |
|---|---|---|
| 1 | **파트3 미착수.** 62초 배분도 함께 확정 | 파트3 |
| 2 | **완전 사이클을 뺀 대가 관리** — "실물이 이론을 고쳐 썼다"는 반전 서사가 3분에서 사라졌다. **질의응답에서 반드시 회수**(§10-1). 답변 카드로 준비할 것 | 전체 |
| 3 | **4번에 낙차 카드와 시뮬레이션을 11초에 둘 다 소화할 수 있는지** — 리허설 실측 | 파트2 4 |
| 4 | **파트2 2번 대사 초안** 미작성 | 파트2 2 |
| 5 | **6번 시뮬 렌더 조건** — 곡선으로 휘는 것이 눈에 보이게. 이 비트는 화면이 전부다 | 파트2 6 |
| 6 | **파트1 5번의 "이상한 점"을 (a)"허리가 없다"로 되돌릴지.** 현재는 (b)"장대와 팔의 몫". (a)로 바꾸면 6번 첫 문장도 함께 고쳐야 한다 | 파트1 5·6 |
| 7 | **파트1 5번 화면의 φ 라벨을 실제로 달지** | 파트1 5 |
| 8 | **부호·색·기하 규약을 자산 제작보다 먼저 못 박을 것.** 우선순위 **부호 > 로봇 모양 > 색** — 색·모양이 다르면 "다르네"지만 부호가 다르면 "틀렸네"가 되고 전공 심사위원이 즉시 잡아낸다 | 전체 |
| 9 | **추 시연 실물 준비** — 추 사양, 줄 위 배치, 전시대 안전 | 파트1 4 |
| 10 | **한국 줄타기 영상 라이선스** | 파트1 1 |
| 11 | **파트1 대사의 소소한 수정 사항** | 파트1 |

> **완전 사이클 삭제로 해소된 미결 넷**: T_w · F_fwe 식 확정 / 절정이 5번인가 8번인가 / "완전 사이클" 이름의 계열 이탈 / 파트3 최종형 명칭. **미결이 14건에서 11건으로 줄었다.**

## 12. 발표 자료 금지선

발표 자료·화면·대본에 다음을 넣지 않는다. **§11 미결 항목은 내부 문서에만 존재한다.**

| 금지 | 확인 |
|---|---|
| "아직 안 됐다 / 미완 / 문서끼리 안 맞는다" 류 서술 | ✔ 파트1·2 없음 |
| **"저 식(ε\*)이 로봇 안에서 돌고 있다"는 표현** | ✔ 파트1·2 해당 없음. **파트3 주의** |
| 동양철학·동서양 문명 비교 어휘를 **우리가 먼저** 꺼내기 | ✔ 장대는 화면에만, 대사는 물리 사실만 |
| "실제 광대도 이렇게 균형을 잡는다"는 단정 | ✔ 없음 |
| 복원 성능 자랑("잘 돌아옵니다") | ✔ 해당 없음 |

**실물 시연은 감탄이 아니라 증거로 쓴다.** 로봇이 서 있다는 사실 자체는 동역학·로봇공학 전공자에게 놀라운 일이 아니다. 프레이밍은 언제나 *"이 단순한 결과만으로 이게 됩니다"* 이지 *"잘 돌아옵니다"* 가 아니다.

---

*작업용 정본. 파트3 착수 시 Ⅳ와 같은 형식으로 Ⅴ장을 추가하고, §2 시간 배분과 §11 미결을 갱신할 것. 개별 논의 경위는 문서 61·62 참조.*
