cbshbalance/slackline-balacing1/docs/cowork/64_발표흐름_파트3_구상_20260821.md

# 64. 발표 흐름 — 파트3 구상안 (2026-08-21)

> 문서 61(파트1 확정) · 62(파트2 구상)의 후속. 같은 방식으로 백지에서 짠다. 참고한 것은 **전람회 심사 형식**과 **발표 자료 금지선**뿐이다.
> **상태: 구상 단계.** 비트 구성과 시간은 잡혔고 대사는 일부만 초안이 있다.
> 세 파트를 합친 정본은 **문서 65**다.
> §6은 **내부용**이며 화면·대본에 옮기지 않는다.

---

## 1. 파트3의 방향은 하나다 — 화면에서 실물로

파트1은 실물(추 시연)로 시작했고 파트2는 전부 화면이었다. **파트3은 화면을 실물에 갖다 붙이며 끝나야 한다.** 이 방향이 순서를 강제하므로, 파트3은 구성 선택지가 거의 없다.

| 파트 | 시간 | 종료 지점 |
|---|---:|---|
| 파트1 | 46 | 질문 |
| 파트2 | 72 | 질문 + 반전 예고 |
| **파트3** | **62** | **실물** |

---

## 2. 세 파트가 같은 리듬을 갖는다 — 벽 → 답

**파트3에서 답(증분 접기)을 먼저 보여주면 벽(시뮬)이 필요 없어진다.** 벽을 먼저 세워야 답이 감탄이 된다. 이 원칙이 세 파트에 모두 적용되면서 발표 전체가 하나의 리듬을 갖는다.

| 파트 | 벽 | 답 |
|---|---|---|
| **1** | 얼음판 — 기울면 끝이다 | 발을 옮긴다 |
| **2** | 돌려 보니 경로가 휜다 | 예측점 |
| **3** | 현실을 넣으니 안 된다 | 증분 접기 |

### 두 벽이 연속이어도 되는 이유 — 층이 다르다

파트2 6번과 파트3 1번이 연달아 "안 된다"를 말한다. 반복으로 들리지 않으려면 **층위 차이가 대사에 드러나야 한다.**

- **파트2의 벽은 우리 가정의 문제다** — 순간 접기라고 놓은 것이 우리 선택이었다
- **파트3의 벽은 세상의 문제다** — 마찰·감쇠는 우리가 놓은 것이 아니다

이 구분이 서면 반복이 아니라 **계단**이 된다.

### 되찾은 것

완전 사이클을 빼면서 **"실물이 이론을 고쳐 썼다"는 반전 서사를 통째로 질의응답에 넘겼다**(문서 62 §8). 시행착오 시뮬을 파트3 맨 앞에 두면 **그 서사가 3분에 절반쯤 돌아온다.** 노력도(15점) 재료가 다시 생긴다.

---

## 3. 파트2 마무리 질문 변경 — 필수

파트3 1번이 벽(시뮬)이 되면서, **파트2의 마무리 질문을 바꿔야 한다.**

| | 문장 | 파트3 1번이 |
|---|---|---|
| 이전 | *"그럼, 로봇은 지금 뭘 하고 있을까요?"* | 즉답하지 않는다 → 원칙 ② 위반 |
| **변경** | *"— 그럼 이걸, 진짜 로봇에 넣으면 될까요?"* (15자) | **"안 됩니다"로 답하면서 동시에 반전이 된다** |

시간은 그대로 3초. 파트2 7번은 17초 유지. **질문 경계와 반전 경계를 겸하게 된다.**

---

## 4. 파트3 비트표 (62초 / 4비트)

기준 속도 **초당 5자**.

| # | 비트 | 초 | 대사 / 내용 | 화면 · 동작 |
|---|---|---:|---|---|
| **1** | **현실을 넣은 시뮬 — 벽** | 20 | 마찰·감쇠·지연을 전부 넣은 시뮬레이터를 **직접 만들었다.** 넣어 보니 **안 된다.** 시행착오 | 시뮬 재생 (수준 미정 → §6) |
| **2** | **증분 접기 — 답** | 12 | "한 번에 정확히 접는 걸 **포기했습니다.** 대신 매 순간 다시 재서, 벗어난 만큼만 조금씩 접습니다. — 그것만으로 섭니다." (49자) | 수렴하는 궤적 |
| **3** | **어름이** | 20 | "이 로봇 안에서 도는 건 그것뿐입니다 — **매 순간 저 직선에서 얼마나 벗어났는지 재고, 그만큼 접는 것.**" ⏸**3초** | **평면 실시간 + 실물 나란히** |
| **4** | **결론 · 제언** | 10 | 마지막 두 문장 | **장대 사진 재등장 (크게)** |

### 비트별 주석

**1번 — "직접 만들었다"가 이 비트의 두 번째 일이다.** 벽을 세우는 것이 첫 번째지만, 전물리 시뮬레이터를 직접 만들었다는 사실 자체가 노력도 재료다. 두 가지를 한 비트에서 처리한다.

**2번 — 핵심 단어는 "포기했습니다"다.** 정확히 푼 것을 포기하고 조금씩 가는 쪽을 택했다는 게 정직하고, 앞의 벽과 정확히 맞물린다. 성능 자랑이 아니라 선택의 서술이다.

**3번 — 소프트웨어 설명이 곧 회수 문장이다.** 소프트웨어 얘기와 "화면과 실물이 같은 것"을 따로 하면 20초에 들어가지 않는다. 그런데 **한 문장이 둘 다 한다** — 로봇 안에서 도는 것을 말하는 순간, 그것이 파트2 내내 자란 평면을 가리키게 되기 때문이다.

> ⚠ **금지선**: *"저 식(ε\*)이 로봇 안에서 돌고 있다"* 고 말하지 않는다. *"저 직선에서 얼마나 벗어났는지 재고, 그만큼 접는다"* 는 **문자 그대로 사실**이므로 이 표현만 쓴다.

**침묵 3초는 여기다.** 화면에 평면이 실시간으로 돌고 옆에 실물이 서 있으면 말이 더 필요 없다. 발표 전체의 종점이다.

**4번 — 장대 사진 재등장.** 파트1 1번에서 구석에 작게 뒀던 그 사진을 크게 띄운다. 발표가 시작점으로 돌아오며 닫힌다(원칙 ⑤ 회수).

---

## 5. 발표에서 뺀 것과 그 이유

| 항목 | 왜 뺐나 | 어디서 회수하나 |
|---|---|---|
| **노브(γ)** | 2번을 단순하게 유지. "맞춘 건 접기량을 환산하는 비율 하나뿐"이면 충분하고, 이름을 붙이면 설명이 붙는다 | 질의응답 |
| **실측 세 개** | 노브를 빼면 겹친다. *"비율 **하나**만 조절하면 됩니다"* 와 *"실제로 잰 건 **세 개**입니다"* 가 나란히 오면 청중은 **"재는 게 셋이야, 조절이 하나야?"** 로 간다. 실제로는 실측 셋으로 계수를 정하고 남는 어긋남을 비율 하나가 흡수하는 2단계인데, 그 구분은 3분에서 너무 비싸다 | 질의응답 — **노브와 한 세트로.** *"실제로 뭘 재서 넣었습니까?"* 에 대한 답이 된다 |
| **로봇 사양** (키·무게·서보 수) | 심사위원이 눈으로 보고 있다. 말해야 하는 건 **"저게 지금 뭘 하고 있는가"**다 | 물으면 답한다 |
| **결론의 활용처·후속 과제 상술** | 10초에 안 들어간다 | 질의응답 (실용성 10점) |

---

## 6. 미결 사항 — 내부용

1. **1번의 "시행착오"를 어느 수준까지 보여줄지.** 여러 번 실패하는 장면인가, 한 장면인가. **20초의 대부분이 여기 걸린다.** 대사도 이게 정해져야 잡힌다.
2. **1번 대사 초안** 미작성.
3. **4번 결론 두 문장** 미작성.
4. **3번 실물 시연의 안전** — 전시대 위에서 화면과 나란히 두는 배치, 낙하 대비.
5. **평면 실시간 화면과 실물을 한 시야에 넣는 물리적 배치** — 심사위원이 고개를 돌리지 않고 둘 다 볼 수 있어야 한다. 리허설로 확인.

---

## 7. 발표 자료 금지선 — 계승

문서 61 §9 · 62 §9와 동일. **파트3에서 특히 주의할 항목:**

| 금지 | 파트3 확인 |
|---|---|
| **"저 식(ε\*)이 로봇 안에서 돌고 있다"** | ⚠ **3번에서 가장 위험하다.** §4 주석의 표현만 쓴다 |
| "아직 / 미완 / 불일치" 서술 | 1번의 시행착오는 **끝난 이야기**로만 서술한다 — 해결된 과거이지 진행 중인 문제가 아니다 |
| 복원 성능 자랑("잘 돌아옵니다") | 3번의 프레이밍은 *"이것만으로 이게 됩니다"* 이지 *"잘 돌아옵니다"* 가 아니다 |
| 동양철학·동서양 비교를 우리가 먼저 | 4번 장대 사진은 **화면으로만.** 대사는 물리 사실만 |
| "실제 광대도 이렇게 잡는다"는 단정 | 4번 결론에서 특히 주의 |

---

*파트3 구상 시점의 기록. 대사 확정과 §6 미결 해소 후 확정본으로 갱신할 것. 세 파트 통합 정본은 문서 65.*
