cbshbalance/slackline-balacing1/docs/cowork/66_3분대본_초안_v1_20260821.md

# 66. 3분 대본 — 초안 v1 (2026-08-21)

> 문서 65(발표 흐름 최종 통합본)의 비트 구성을 **낭독 가능한 대본**으로 채운 것. 구성·시간·의도는 65가 정본이고, 이 문서는 그 위의 대사층이다.
> **기준 속도 초당 5자**(공백 제외). 총 **847자 / 말 169초 + 침묵 8초 ≈ 177초**.
> 【 】는 실기 후 채울 자리. §5·§6은 내부용이며 화면·대본 자막에 옮기지 않는다.

---

## 0. 표기와 준비

| 기호 | 뜻 |
|---|---|
| — | 반 박자 쉼 |
| ⏸ | 완전한 침묵 (초 수 표기) |
| ( ) | 지시문 — 읽지 않는다 |
| 【 】 | 실기 후 채울 자리 |

**침묵은 세 곳뿐이다. 이 셋은 절대 빼지 않는다.**

| 위치 | 길이 | 왜 |
|---|---:|---|
| 파트2 5번 (ε\*) | 3초 | 낙차 카드가 완성된 순간. 청중이 스스로 읽게 둔다 |
| 파트2 7번 (예측점) | 2초 | 큰 흐름을 한 번 끊는다 |
| 파트3 3번 (어름이) | 3초 | 발표 전체의 종점. 화면과 실물을 번갈아 보게 둔다 |

**역할 3인** — 말 【 】 / 화면 【 】 / 손 【 】(전시대 옆, 낙하 대비)

**시작 전**: 어름이는 이미 줄 위에서 균형을 잡고 있다. 입장·인사 구간에서 심사위원이 자연스럽게 보게 두고, 3분 예산에는 넣지 않는다.

---

# 파트 1 — 46초 / 232자

### [1-1 | 8초 | 37자 | 화면: 한국 줄타기 영상 크게, 장대 사진 구석에 작게]

> 한국 줄타기입니다. 장대는 토크를 만듭니다. 부채는 못 만듭니다. 그런데 — 떨어지지 않습니다.

### [1-2 | 6초 | 32자 | 화면: **불가능 카드 왼쪽 칸**]

> 얼음판 위라면, 몸속에서 뭘 해도 무게중심은 안 움직입니다. 기울면 끝입니다.

### [1-3 | 5초 | 24자 | 화면: 처진 줄 형태 — 원호는 아직 그리지 않는다]

> 그런데 얼음판과 다른 게 하나 있습니다. 줄은 — 처져 있습니다.

### [1-4 | 10초 | 51자 | 화면: 불가능 카드 **오른쪽 칸 채워짐** | 동작: **추 시연**]

> 무게중심을 못 옮기면, 발을 옮기면 됩니다. 처진 줄에서는, 발이 옆으로 가면 줄이 몸을 끌어옵니다. 발 위치가 힘으로 바뀌는 겁니다.

*(추를 줄 위에 놓고 옆으로 민다. 저절로 돌아온다.)*

### [1-5 | 10초 | 52자 | 화면: 논문 표지 → 원호 R + φ 라벨]

> 이걸 다룬 논문 하나가, 줄의 처짐을 원호로 봤습니다. 위치가 각도 하나로 정리되죠. 그런데 균형은 — 장대와 팔의 몫이었습니다.

### [1-6 | 7초 | 36자 | 화면: 1체→2체 애니 5초]

> 우리에겐 둘 다 없습니다. 막대를 둘로 나누고, 허리를 넣었습니다. — 안 떨어진다는 게, 뭘까요?

---

# 파트 2 — 72초 / 335자

*(이 파트 내내 β·φ 평면은 화면에서 사라지지 않는다. 비트마다 한 겹씩 덧그린다.)*

### [2-1 | 9초 | 45자 | 평면: 축 + 점 | 화면 제목: "상태공간"]

> 로봇의 상태는 두 좌표로 정해집니다 — 몸이 기운 각 β, 줄이 흔들린 각 φ. 둘을 축으로 잡으면, 점 하나가 됩니다.

### [2-2 | 9초 | 47자 | 평면: 궤적 2개 — 발산 / 유계]

> 시간이 지나면 점이 궤적을 그립니다. 이렇게 커지면 떨어집니다. 안 커지면 — 균형입니다. 멈춰 설 필요는 없습니다.

### [2-3 | 7초 | 37자 | 평면: 점의 이동]

> 허리를 접으면, 반작용으로 발이 밀립니다. 점이 움직이죠. — 그럼, 얼마나 접어야 할까요?

### [2-4 | 11초 | 55자 | 화면: **낙차 카드** 등장(왼쪽 벽) + 시뮬레이션 궤적]

> 이게 이 로봇의 운동방정식입니다. 자유도 셋, 모터는 하나. — 안 커지는 상태만 모으면 직선 하나가 됩니다. 접기도 직선을 따라 갑니다.

*(왼쪽 벽을 가리키며 "셋이 얽혀 있습니다" 정도로 지나간다. α·θ는 설명하지 않는다.)*

### [2-5 | 15초 | 59자 + ⏸3초 | 평면: 교점 + ε\* 식]

> 두 직선의 교점입니다. 푼 건 1차방정식 두 개예요. 수치해석도 시뮬레이션도 쓰지 않았습니다.
>
> ⏸ **(3초 — 카드만 보이게 둔다. 움직이지 않는다.)**
>
> 이 식에는 — 처음에 얼마나 기울었는지가 없습니다.

### [2-6 | 4초 | 15자 | 화면: 시뮬 재생 — **경로가 직선이 아니라 곡선으로 휜다**]

> 그런데 — 돌려 보면, 뭔가 이상합니다.

*(이유를 말하지 않는다. 화면이 말한다.)*

### [2-7 | 17초 | 77자 + ⏸2초 | 평면: 예측점]

> 발은 줄에 붙어 있습니다. 접는 데 시간이 걸리니, 그동안 줄이 발을 밀어 무게중심이 움직입니다. 그래서 지금이 아니라, 접기가 끝날 때를 봐야 합니다.
>
> ⏸ **(2초)**
>
> 이걸 진짜 로봇에 넣으면, 될까요?

---

# 파트 3 — 62초 / 280자

### [3-1 | 20초 | 102자 | 화면: 현실 반영 시뮬 — 안 되는 장면]

> 이론은 마찰도 지연도 없는 세계의 답입니다. 그래서 마찰과 감쇠, 신호 지연까지 전부 넣은 시뮬레이터를 직접 만들었습니다. 넣어 봤더니 — 안 됐습니다. 접는 동안 조건이 바뀌어서, 정확히 계산한 값이 도착할 때쯤엔 이미 틀린 값이었습니다.

### [3-2 | 12초 | 63자 | 화면: 수렴하는 궤적]

> 그래서 한 번에 정확히 접는 걸 포기했습니다. 대신 매 순간 다시 재서, 벗어난 만큼만 조금씩 접습니다. 맞춘 건 접기량을 환산하는 비율 하나뿐입니다.

### [3-3 | 20초 | 61자 + ⏸3초 + 【4초】 | 화면: **평면 실시간 + 실물 어름이 나란히**]

> 이게 어름이입니다. 이 안에서 도는 건 그것 하나예요 — 매 순간 저 직선에서 얼마나 벗어났는지 재고, 그만큼 접는 것.
>
> ⏸ **(3초 — 화면과 실물을 번갈아 보게 둔다.)**
>
> 화면의 저 점이, 지금 저 로봇입니다.
>
> 【실기 후 한 문장 — 생존 기록·판수 등, 약 4초】

### [3-4 | 10초 | 54자 | 화면: **장대 사진 재등장, 크게**]

> 장대는 필요 없었습니다. 처진 줄 위에서는, 허리 하나면 됩니다. 줄이 왜 느슨해야 하는지도 — 이제 설명이 됩니다. 감사합니다.

---

## 5. 넘칠 때 빼는 순서 — 내부용

리허설에서 초과하면 **위에서부터** 뺀다.

| 순서 | 무엇 | 절약 |
|---:|---|---:|
| 1 | 2-2 "멈춰 설 필요는 없습니다." | −2초 |
| 2 | 3-1 "이론은 마찰도 지연도 없는 세계의 답입니다." → 삭제 (3-1 둘째 문장이 대신함) | −4초 |
| 3 | 2-4 "자유도 셋, 모터는 하나." → 화면 라벨로만 | −2초 |
| 4 | 3-2 "맞춘 건 접기량을 환산하는 비율 하나뿐입니다." | −4초 |
| 5 | 1-4 "발 위치가 힘으로 바뀌는 겁니다." | −3초 |

**절대 빼지 않는 것**

- 침묵 세 곳 (2-5의 3초 / 2-7의 2초 / 3-3의 3초)
- 1-3 "줄은 — 처져 있습니다" (실마리가 사라지면 1-4가 공중에 뜬다)
- 1-5 "장대와 팔의 몫이었습니다" (1-1 회수 + 1-6 발문)
- 2-5 "처음에 얼마나 기울었는지가 없습니다" (파트2 절정)
- 3-2 "포기했습니다"
- 3-3 "화면의 저 점이, 지금 저 로봇입니다"
- 3-4 마지막 세 문장

## 6. 금지선 확인 — 내부용

| 금지 | 이 대본에서 |
|---|---|
| "저 식(ε\*)이 로봇 안에서 돌고 있다" | ✔ 3-3은 *"저 직선에서 얼마나 벗어났는지 재고, 그만큼 접는 것"* — 문자 그대로 사실만 |
| "아직 / 미완 / 불일치" | ✔ 3-1은 **과거형**("안 됐습니다")으로 끝난 이야기. 진행 중인 문제로 들리지 않게 |
| 동양철학·동서양 비교를 우리가 먼저 | ✔ 3-4는 *"장대는 필요 없었습니다"* 까지만. 문명 대비 어휘 없음 |
| **"실제 광대도 이렇게 잡는다"는 단정** | ⚠ 3-4를 *"광대가 왜 줄을 느슨하게 매는지"* 가 아니라 **"줄이 왜 느슨해야 하는지"** 로 썼다. 물리적 필요를 말할 뿐 광대의 의도를 단정하지 않는다. **이 문장은 이 형태를 유지할 것** |
| 복원 성능 자랑 | ✔ "잘 돌아옵니다" 없음. 3-2는 선택의 서술 |
| 발표에서 쓰지 않는 이름 | ✔ FWE · 완전 사이클 · 모드 · 노브 — 한 번도 안 나옴 |

## 7. 남은 것

1. **3-1의 시뮬 화면 수준** — 여러 번 실패하는 장면인지 한 장면인지. 대사는 "조건이 바뀌어서 도착할 때쯤엔 틀린 값"이라는 **한 가지 원인**으로 썼다. 화면이 여러 실패를 보여줄 거라면 대사도 바꿔야 한다.
2. **3-3의 【 】** — 실기 후 생존 기록 한 문장(약 4초).
3. **낭독 리허설 실측** — 블록별 스톱워치. 침묵 8초를 포함해서 잰다.
4. 파트1 대사의 소소한 수정 사항(미반영).

---

*문서 65의 비트 구성 위에 얹은 대사층. 구성이 바뀌면 65를 먼저 고치고 이 문서를 따라 고친다.*
