cbshbalance/slackline-balacing1/docs/cowork/68_r_실측_첫결과_20260822.md

# 68. 실측 ② 첫 결과 — r ≈ +0.8 (모델과 부호 반대), 그리고 USB 케이블이 로그를 흔들었다 (2026-08-22)

> 원 파일: `0817_p2r_r2.raw.txt`, `0817_p2r_r2.csv` (**12,015행 / 447.6~721.2 s / 놓기 64회**).
> **측정일 2026-08-22 (사용자 확인). 노트북 USB 케이블을 로봇에 단 채로 측정.**
> 재현: `r_fit_0817.py`.
>
> ⚠ **파일명 주의** — 이름이 `0817_` 인데 실제 8/22 다. 문서 53·54 가 인용한 `0817_p2r_r2_3.csv`,
> 문서 67 의 로그와 이름이 겹친다. **파일명에 실제 측정일을 넣을 것.**
>
> **참고 범위:** 문서 46 「실측 세 개」 이후 문서만 근거로 쓴다.

---

## 0. ★ 이 문서의 정정 이력

이 문서의 첫 판(같은 날 오전)에서 두 가지를 잘못 적었다. **USB 케이블 제보를 받고
시행을 시간 블록으로 쪼개 다시 돌리자 둘 다 뒤집혔다.**

| 첫 판의 주장 | 정정 |
|---|---|
| "감쇠가 무시 못 할 크기다 — 모델의 `w = [−1/r, 1, −1/(rλ), 1/λ]` 형태가 안 맞는다" | **철회.** 가장 깨끗한 블록에서 그 형태가 **오차 4 % 로 성립**한다 (§5-2) |
| "R²(β̈) = 0.61 — 발목 마찰이 유력" | **철회.** 마찰이 아니라 **세션 중 시스템이 변한 것**이다. 40 초 블록으로 자르면 R² 가 0.95~0.98 로 오른다 (§5-1) |
| λ = 4.57 (문서 65 의 5.44 와 16 % 차) | **평균 artifact.** 블록별로는 5.08~5.70, 첫 블록은 **정확히 5.44** (§5-1) |

**살아남은 것: r 이 양수라는 것.** 어떻게 잘라도 +0.67 ~ +1.03 이고 −1.6445 근처는 없다.

---

## 1. 선형 영역은 \|φ\| < 5° — 앞선 세 번의 실패 원인

자유비행 구간에서 (φ̈, β̈) 를 (φ, β, φ̇, β̇, 1) 로 회귀해 4×4 시스템행렬을 만들고,
**\|φ\| 상한만 바꿔가며** 고유값을 본다:

| \|φ\| < | n | R²(φ̈) | 고유값 |
|---:|---:|---:|---|
| **3°** | 1682 | 0.85 | **+4.78**, −0.02±5.94j, −2.90 |
| **4°** | 2273 | 0.83 | **+4.57**, −0.02±5.84j, −2.29 |
| **5°** | 2954 | 0.77 | **+4.27**, ±5.38j, −1.71 |
| 8° | 4769 | 0.63 | +2.99, 0.00, ±4.93j |
| 전체 | 8820 | 0.48 | +0.74±3.13j, ±4.67j — **실수 불안정 고유값 없음** |

\|φ\| < 5° 에서만 아는 구조가 나온다 — 실수 불안정 1 + 안정 진동 2 + 안정 실수 1.
그 밖에서는 줄의 복원 토크가 이겨서 **로봇이 넘어지는 대신 흔들린다.**

> 문서 66 은 편위 50~78°, 문서 67 은 20~46°, 이 로그도 대부분 8~30°.
> **전부 선형 영역 밖에서 놀았다.** 문서 67 §5 가 "다른 모드" 라고 적은 것의 정체.

---

## 2. ★ USB 케이블이 데이터에 남긴 자국

시행 62 개를 **시간 순 6 블록**(블록당 약 10 시행 / 40 초)으로 잘라 각각 동정하면:

| 블록 | 시행 | 시각[s] | n | R²(φ̈) | R²(β̈) | λ | **r** | **φ̈ 상수항** | **β̈ 상수항** |
|---|---|---|---:|---:|---:|---:|---:|---:|---:|
| 0 | 0–10 | 449–497 | 288 | **0.981** | 0.857 | **5.44** | +0.674 | −2.1 | **+4.2** |
| 1 | 11–20 | 501–537 | 270 | **0.973** | 0.737 | 5.08 | +1.025 | **−54.7** | **−25.6** |
| 2 | 21–30 | 540–580 | 379 | **0.958** | 0.775 | 5.70 | +0.761 | −15.2 | **−38.4** |
| 3 | 31–40 | 584–622 | 347 | **0.954** | 0.828 | 5.61 | +0.724 | +2.3 | **−16.2** |
| 5 | 51–63 | 669–721 | 649 | 0.836 | 0.555 | 4.84 | +0.848 | +0.1 | **+3.4** |
| **전체** | 0–63 | 449–721 | 2273 | **0.831** | **0.608** | 4.57 | +0.871 | −9.3 | −16.3 |

**세 가지가 한꺼번에 보인다.**

**(1) 시스템이 세션 중에 변했다.**
40 초 블록으로 자르면 R²(φ̈) 가 0.95~0.98 로 오른다. 전체를 한 번에 맞추면 0.83.
**변하지 않는 계수 하나로 274 초를 설명하려 한 것이 무리였다.**
→ 첫 판이 "발목 마찰"로 의심했던 미설명 분산은 **마찰이 아니라 표류**다.

**(2) 가속도 방정식의 상수항이 요동친다.**
φ̈ 상수항 −54.7 ~ +2.3, β̈ 상수항 −38.4 ~ +4.2.
**가속도 식의 상수항 = 자세와 무관하게 걸리는 외력·외토크**다.
크기를 보면: β̈ 의 강성계수가 −11.7 (β 1° 당) 인데 상수항이 −38 이다 —
**몸이 3° 기울어진 것과 맞먹는 토크가 상시로 걸려 있고, 그 값이 블록마다 바뀐다.**

**케이블이 하는 일이 정확히 이것이다.** 로봇 상체에 매달린 선은
① 자세와 무관한 당김(상수 토크)을 걸고 ② 늘어진 모양이 조금씩 바뀌면 그 값이 변한다.

**(3) λ 는 원래 맞았다.**
블록별 λ = 5.08 / 5.44 / 5.61 / 5.70 / 4.84. **첫 블록이 정확히 5.44** — 문서 65 실측값이다.
전체 적합의 4.57 은 표류하는 시스템을 하나로 평균낸 결과였다.

---

## 3. 결과 — r 은 양수다

| 갈라보기 | λ | **r** |
|---|---:|---:|
| 시간 블록 0 / 1 / 2 / 3 / 5 | 5.44 / 5.08 / 5.70 / 5.61 / 4.84 | **+0.674 / +1.025 / +0.761 / +0.724 / +0.848** |
| 평활창 ±40 / ±70 / ±130 ms | 4.52 / 4.57 / 4.57 | +0.851 / +0.871 / +0.866 |
| \|φ\| < 3° / 4° / 5° | 4.78 / 4.57 / 4.27 | +0.856 / +0.871 / +0.888 |
| 홀수 / 짝수 시행 | 4.94 / 4.45 | +0.920 / +0.845 |
| 시행 62 잭나이프 | 4.57 ± 0.58 | **+0.871 ± 0.073** |

**모든 조합에서 +0.67 ~ +1.03. 모델 예측 −1.6445 는 어디에도 없다.**

**c₀ 는 여전히 미결정** — 블록별로 +15.9, +1.1, −0.4, −0.9, +0.2. 케이블 상수토크가
그대로 절편으로 들어가므로, **케이블을 떼기 전에는 c₀ 를 잴 수 없다.**

### 3-1. 독립 검증 — 발산 방향은 앞선 실측과 맞는다

불안정 **우**고유벡터의 dβ/dφ = **−0.587 / −0.591 / −0.507** (\|φ\|<3/4/5).
문서 53 실측 −0.28~−0.43, 문서 65 −0.37. **부호도 자릿수도 같다.**
→ φ 부호 규약이 뒤집혀서 생긴 착시가 아니다.

### 3-2. 파이프라인이 부호를 만들어내지 않는다

**모델이 맞다고 가정한 가짜 시스템**(λ = 5.44, r = −1.6445 를 정확히 갖는 4×4)을 만들어
이 로그와 같은 시행 길이·잡음으로 궤적을 생성하고 **똑같은 파이프라인**에 넣었다:

| 넣은 잡음 | 복원 λ | **복원 r** (진짜 −1.6445) |
|---|---:|---:|
| 0 | 5.40 | **−1.644** |
| 0.066° (실측) | 5.40 | **−1.601** |
| 0.150° (2 배) | 5.38 | **−1.341** |

**진짜가 −1.64 면 −1.6 을 돌려준다. +0.87 을 만들어낼 수 없다.**

---

## 4. 발목은 수리된 상태가 맞다 (확인)

시행 46 개의 홀드 구간(3,017 샘플) 고주파 rms, 문서 54·64 와 같은 방법:

| | 발목 | φ |
|---|---|---|
| 문서 54 (수리 전) | 0.223 | 0.034 |
| 문서 64 (수리 후, 매달림 정지) | 0.035 | 0.031 |
| **이 로그 (홀드 구간)** | **0.066** | **0.052** |

수리 전의 **1/3.4**. 두 채널이 비슷한 비율로 올라간 것은 줄 위에서 손으로 잡은
조건(잔떨림)의 차이지 센서 결함이 아니다.

---

## 5. 모델 w 식에 관하여 — 첫 판 철회

### 5-1. 무엇을 잘못 봤나

첫 판은 **전체 적합**의 w = [−1.148, 1, −0.535, +0.421] 을 무감쇠 형태
[−1.148, 1, −0.251, +0.219] 와 비교해 **"속도 성분이 2 배 = 감쇠가 크다"** 고 적었다.
그런데 그 전체 적합은 §2 가 보인 대로 **표류하는 시스템을 평균낸 것**이다.

### 5-2. 블록별로 보면 모델 형태가 성립한다

| 블록 | λ | w = [w_φ, 1, w_φ̇, w_β̇] | 무감쇠형 [w_φ, 1, w_φ/λ, 1/λ] | 속도성분 비 |
|---|---:|---|---|---|
| **2** | 5.70 | [−1.314, 1, **−0.230**, **+0.168**] | [−1.314, 1, −0.231, +0.175] | **1.00 / 0.96** |
| 3 | 5.61 | [−1.381, 1, −0.464, +0.347] | [−1.381, 1, −0.246, +0.178] | 1.88 / 1.95 |
| 5 | 4.84 | [−1.179, 1, −0.349, +0.283] | [−1.179, 1, −0.243, +0.206] | 1.43 / 1.37 |
| 0, 1 | — | (6~11 배 — 상수항이 가장 크게 튄 블록) | | |

**블록 2 에서 모델 형태가 오차 4 % 로 성립한다.**
`w = [−1/r, 1, −1/(rλ), 1/λ]` 라는 형태 자체는 **맞다** — 다만 그 안의 **r 값이 다르다.**

> 참고로 그 형태는 **감쇠 C = 0 일 때 정확히 성립**하는 식이다
> (§3-2 의 가짜 시스템을 만들 때 확인했다). 블록 2 가 그 형태를 만족한다는 것은
> **실기의 감쇠가 실제로 작다**는 뜻이고, 모델의 무감쇠 가정이 옳았다는 뜻이다.

---

## 6. 이게 사실이면 무엇이 바뀌나

r 이 −1.6445 → +0.8 이면 `w_φ = −1/r` 가 **+0.604 → −1.25** 로 **부호까지** 바뀐다.
문서 50 §0 의 환율표가 뒤집힌다:

| 놓기 오차 | 문서 50 (모델) | **이 로그 (r = +0.8 기준)** |
|---|---|---|
| 몸 기울기 β 1° | +1.00° | +1.00° (정규화 기준) |
| **줄 각 φ 1°** | **+0.61°** | **−1.25°** |

**φ 가 A 에 기여하는 방향이 반대다.** γ·트리거 문턱·놓기 게이트가 전부 이 w 위에 서 있다.

**그래도 아직 못 바꾼다** — 케이블이 걸린 채로 잰 값이기 때문이다.
케이블은 상수 토크만 거는 게 아니라 **자세에 따라 달라지는 당김(스프링 성분)** 도 걸 수 있고,
그건 강성 행렬 K 에 섞여 **r 을 직접 밀 수 있다.**
상수항이 블록마다 40 이나 흔들렸는데 r 은 +0.67~+1.03 에 머문 것은 좋은 징조지만, 증명은 아니다.

---

## 7. 다음 회차 — 두 줄

> ## ① **케이블을 로봇에서 떼거나, 힘이 안 걸리게 한다.**
> ## ② **놓기 편위를 \|φ\| < 4° 안으로.**

**케이블 처리 (좋은 순서대로)**

1. **온보드 로깅(SD 카드) 후 회수** — 케이블이 아예 없어진다. 가장 확실
2. **위에서 수직으로 늘어뜨리기** — 프레임에서 케이블을 매달아 로봇까지 **여유 있게 늘어뜨린다.**
   수직으로 처지면 수평 힘이 거의 0 이 된다. 오늘 당장 할 수 있는 방법
3. **발목축을 지나가게 배선** — 당겨도 회전축을 통과하면 토크가 0
4. 그래도 달아야 하면 **세션 내내 절대 건드리지 않는다** — 최소한 상수 편향으로 고정된다

**측정**

- 편위 **\|φ\| < 4°**, 실 릴리즈 (문서 50 §4)
- **세션을 10 시행 / 40 초 단위로 짧게 끊는다** — §2 가 보였듯 그 길이에서는 모델이 R² 0.95+ 로 맞는다
- 블록마다 상수항을 같이 보고, **상수항이 안정되면 케이블이 잡힌 것**

---

## 8. 조치

| # | 할 일 | 상태 |
|---|---|---|
| 1 | **케이블 처리** (§7) — 실측 ② 의 선행조건 | **최우선** |
| 2 | 로그 파일명에 실제 측정일 넣기 | **바로** |
| 3 | 실측 ② 재수행 — \|φ\| < 4°, 실 릴리즈, 40 초 블록 | 1번 이후 |
| 4 | ~~w 를 감쇠 포함해 재유도~~ → **불필요.** 무감쇠 형태가 블록 2 에서 확인됨 (§5-2) | **철회** |
| 5 | r 이 재현되면 모델의 r = −1.6445 폐기 + 환율표(문서 50 §0) 갱신 | 3번 이후 |
| 6 | 그때까지 펌웨어는 예측값 **r = −1.6445 유지** | 유지 |
| 7 | 문서 66·67 의 "±8~10° 이내" 권고를 **"±4° 이내"** 로 강화 | **완료** |
