cbshbalance/slackline-balacing1/docs/cowork/69_실측2_완료_r0.761_c0_0.435_20260822.md

# 69. (폐기) 실측 ② 1차 — α 공식 오류로 무효

> ## ✕ 이 문서는 폐기되었다. **`69_실측2_완료_r_최종_20260822.md` 를 볼 것.**
>
> **폐기 사유 (2026-08-22):** 이 문서의 모든 r·c₀·w·환율표 계산이
> **`α = ank + phi` (문서 52 규약)** 위에서 이루어졌다. 그 공식이 틀렸다 —
> 올바른 것은 **`α = ank − phi`** 다.
>
> | | 이 문서 (틀림) | 최종 문서 |
> |---|---|---|
> | r | +0.761 | **−1.506** |
> | w_φ | −1.314 | **+0.664** |
> | R²(β̈) | 0.571 | **0.804** |
>
> 부호가 반대이므로 **이 문서의 어떤 수치도 인용하면 안 된다.**
>
> ### 이 문서에서 살아남은 것 (α 정의와 무관한 사실)
>
> - **케이블을 발목 소켓에 고정하니 세션 표류가 사라졌다** — 재현 조건으로 확정
> - 로그 품질: 100 Hz, 10,538 행, 놓기 64 회, φ·발목 정상, δ ≈ 0
> - 발목 잡음 0.064° — 수리 상태 유지
> - **선형 영역은 \|φ\| < 5°** — α 정의와 무관하게 성립
> - λ = 5.6 — 좌표 정의에 불변
>
> ### 남긴 이유
>
> 이틀에 걸친 오진(발목 마찰 → 세션 표류 → 손 접촉 → 부호 규약)의 기록이고,
> 마지막에 사용자의 "φ=+4 에서 β≈−2 에서 놓았다" 는 기억이 원인을 짚었다.
> **문서에 적힌 규약을 검산 없이 받아쓰면 어떻게 되는지의 사례로 남긴다.**
