cbshbalance/slackline-balacing1/docs/cowork/71_증분접기펌웨어_실측반영_α정정_센서감시_20260822.md

# 71. 증분접기 펌웨어 개정 — 실측 3종 반영 · α 정정 · 센서 감시 (2026-08-22)

> 대상: `incremental_fold.ino` (문서 60 의 감마비례 펌웨어).
> 이 문서는 **무엇을 왜 바꿨고 무엇이 아직 안 닫혔는지**의 기록이다.
> 코드 자체의 설명은 파일 헤더 주석이 정본.

---

## 1. 바뀐 것 세 묶음

### 1-1. 실측 상수 (문서 64·65·69)

| 상수 | 이전 | **지금** | 출처 |
|---|---|---|---|
| P2R | 0.417 | **0.433** | 문서 64 재실측 (0.417 은 발목 센서 수리 **전** 값 — 폐기) |
| λ | 5.3 | **5.66** | 문서 69 교차검증 (문서 65 의 5.44 와 4 %) |
| r | −1.6445 *(모델 예측)* | **−1.506** | **문서 69 실측** ±0.074 |
| c₀ | 0 *(모델 예측)* | **−1.11** | 문서 69 §6 — ⚠ **±0.86, 미확정** |

유도값: `w = [+0.6640, 1, +0.11732, +0.17668]`, **A_offset = c₀/r = +0.737°**
배가시간 T₂ = 693.1/λ = **122 ms** (펌웨어가 자동 계산, 저장 상수 아님)

### 1-2. ★ α = ank − phi (문서 69 §2 조치 1)

**사용자가 8/22 육안으로 확정.** 문서 37·52 의 `α = ank + phi` 는 틀렸다.

r = −1.506 은 **− 규약에서 나온 값**이므로 둘은 반드시 함께 간다.
`+` 규약인 채로 r 만 −1.506 을 넣으면 w_φ 의 부호가 어긋난 상태로 돈다.
(같은 로그를 `+` 로 적합하면 r = +0.749, w_φ = −1.336 — 부호가 반대다.)

→ **문서 69 §7 조치 1 완료.** `p2r_test.ino` 등 다른 스케치에도 같은 정정이 필요하다.

### 1-3. 센서·통신 이상 감시 (문서 66 §6 · 문서 67 §6)

문서 67 이 "펌웨어 보강 1건 추가 제안" 으로 남긴 **부저 경보**까지 포함.

| 감시 대상 | 판정 |
|---|---|
| 엔코더 φ·발목 | raw 가 `ewarn`(300 ms) 동안 한 카운트도 안 바뀌면 `!`, `efail`(1.5 s) 이면 고장.<br>raw 가 0/16383 에 **멈춰** 있으면 300 ms 에 바로 고장 |
| 모터 | 응답이 20 ms 넘게 없으면 실패로 세고, **3 연속이면 폴링을 끊는다** (문서 66 §6 보강 1) |

알림 네 갈래:

```
화면:  값 뒤의 !            예:  f=+10.81!  k=-3.20  d=+0.00!
       << phi 고장 raw=16383 정지 7420 ms >>     1 Hz, 원 카운트까지
소리:  CUE 핀(D8)  READY = 계속 켜짐 / ★고장 = 5 Hz 점멸
로그:  err 열 (D 행 맨 뒤 신설) = phi등급 + 4·ank등급 + 16·dxl  (0/1/2)
```

**고장이면 제어를 멈춘다** — 토크 OFF, `g` 로 재시작 거부.
센서가 죽으면 Â 가 틀린 것이 아니라 **접을 근거가 없어진다.**

부수 변경 두 가지: 모니터 줄에 `k=`(발목각) 신설, CSV D 행에 `err` 열 추가(맨 뒤).

---

## 2. 컴파일 이슈 2 건 (OpenCR)

기록해 둔다 — 다시 밟기 쉬운 함정이다.

| 증상 | 원인 | 조치 |
|---|---|---|
| `'class USBSerial' has no member named 'availableForWrite'` | OpenCR 의 USBSerial 에는 그 함수가 없다 | 송신버퍼 여유 검사 **제거**. 대신 `loghz ≤ 50` 유지가 방어책 |
| `'s' was not declared in this scope` | 위를 템플릿 SFINAE 로 우회했더니, **Arduino IDE 의 자동 프로토타입 생성이 `template` 줄을 빠뜨린다** | 템플릿 사용 포기 |

⇒ **이 펌웨어에서 `t` 의 '로그버림' 은 항상 0(미지원)** 이다. 안 버린 것이 아니라 기능이 없는 것.

---

## 3. ⚠ 아직 안 닫힌 것 세 개

### 3-1. A_offset = +0.737° 가 트리거 문턱(0.6°)보다 크다

`z` 직후 똑바로 선 자세에서 Â = +0.737 이므로 **가만히 있어도 트리거가 걸리고**,
놓기신호(READY, `|Â|<0.3` 조건)는 **영원히 안 뜬다.**

문서 69 §6 이 c₀ 를 "미확정(±0.86)" 으로 남긴 것이 정확히 이 자릿수 문제다.

> **당면 권고: `c0 0` 으로 두고 브링업을 진행할 것.**
> 실측 c₀ 는 보완 측정(같은 φ 에서 발목 ±3° 흩어 30~40 회) 뒤에 넣는다.

### 3-2. FOLD_SIGN 미확인

8/22 매달기에서 **`+δ → 하체 − 방향 회전`** 을 육안 확인했다 (헤더의 [교차검산] 항목이
예측에서 측정으로 승격). **다만 이는 사슬의 절반이다.**

```
Â 부호  →  FOLD_SIGN  →  δ 명령  →  하체 회전  →  넘어짐이 되돌려지나
└─── 미확인 ───┘        └── 확인됨 ──┘   └─ 미확인 ─┘
```

확인된 것은 **모터→하체** 구간이고, dry-run 이 보는 것은 **센서→Â** 구간이다.
후자는 φ·발목 엔코더 방향, α 공식, r 의 부호가 곱해져 정해진다.
→ **`c0 0` → `z` → `y` → `g` → 손으로 기울여 A 부호 확인** 이 남아 있다.

### 3-3. w 의 속도항 — 감쇠 재유도 (문서 69 §5)

동정된 w 의 속도항이 무감쇠형의 **1.7 배**다 (β̇ 1°/s 가 0.18 이 아니라 0.30).
안정 실수 고유값이 −3.25 로 −λ 와 다르다 = 감쇠가 실재한다.
지금 펌웨어는 무감쇠형 `w = [−1/r, 1, −1/(rλ), 1/λ]` 를 쓰므로 **속도를 실제보다 가볍게 본다** —
어긋나는 방향은 스윙이 커지는 쪽. 재측정 없이 이론 쪽에서 할 수 있는 작업이다.

---

## 4. 브링업 현황

| 단계 | 상태 |
|---|---|
| `z` 영점 | 완료 |
| `n` Â 잡음 20 s | **수행함 — 수치 미기록** (0.15° 이하가 합격선) |
| `y`+`g` FOLD_SIGN 확인 | **다음 차례** — §3-2, `c0 0` 먼저 |
| `h`,`y` dry-run 해제 → `m` 로그 → `z`→`g` 줄 위 | 대기 |

---

## 5. 조치

| # | 할 일 | 상태 |
|---|---|---|
| 1 | `p2r_test.ino` 등 다른 스케치에도 **α = ank − phi** 반영 | 대기 |
| 2 | 문서 52 의 부호 규약 항목에 정정 주석 (문서 69 §7-2) | 대기 |
| 3 | **c₀ 보완 측정** — 같은 φ 에서 발목 ±3° 흩어 30~40 회 | 대기 |
| 4 | **w 감쇠 포함 재유도** (§3-3) — 이론 작업 | 착수 가능 |
| 5 | FOLD_SIGN dry-run 확인 (§3-2) | **다음 차례** |
| 6 | `n` 잡음 수치 기록 (문서 64 §4-4 의 0.106° 와 대조) | 대기 |
