cbshbalance/slackline-balacing1/docs/cowork/75_이론공부_제어기호사전_실측연계_20260823.md

# 75. 이론 공부 ② — 제어 기호 사전: λ, κ, w는 어떤 개념에서 나오는가 (2026-08-23)

> 전람회 질의응답 대비 학습 문서. 짝꿍 문서: 74(모드 해석의 기원).
> 이 문서의 수치 정본은 문서 70(실측 3종 최종정리)과 73(finale8)이다.
> 값이 여기와 다르게 기억되면 **항상 70·73이 이긴다.**

---

## 0. 한 장 지도 — 기호는 다섯 층에서 나온다

우리 연구의 기호들은 아무렇게나 붙인 게 아니라, 이론이 쌓인 **층**마다 태어났다.
어떤 기호가 낯설면 "몇 층 기호인가"부터 찾으면 된다.

```
[1층: 모델링]    φ α θ δ β ψ q / R h p₁ p₂ M_t μ / M G E        ← 라그랑주 역학
[2층: 모드]      ω_eff λ T₂ r c₀ v u₂ w / 안정모드선            ← 고유값 문제 (문서 74)
[3층: 판정]      A Â q_pred(예측점) / e(등고선 방향) / 잡음바닥   ← 좌고유벡터 사영
[4층: 제어]      ε* ε*_gen δ_f* k γ ρ / trig rel T_REST sgn vg   ← 임펄스 제어 + 비례 제어
[5층: 실측]      P2R P1R κ φ_eq / α = ank − φ                    ← 시스템 동정
```

핵심 줄기 한 문장: **라그랑주로 방정식을 세우고(1층), 고유값 문제로 불안정
방향을 찾고(2층), 그 방향 성분 하나(A)만 감시해서(3층), 문턱을 넘으면 비례해서
접는다(4층). 그 계산에 들어가는 상수는 전부 실측 세 개에서 온다(5층).**

---

## 1. 1층 — 상태와 모델 기호 (라그랑주 역학에서)

### 1-1. 상태 변수

| 기호 | 이름 | 정의 | 어디서 오나 |
|---|---|---|---|
| φ | 줄 각 | 줄+발이 함께 흔들리는 각 (발 위치 x_foot = R·φ) | 일반좌표 (라그랑주) |
| α | 하체 각 | 하체의 절대 연직 기울기 | 일반좌표 |
| θ | 상체 각 | 상체의 절대 연직 기울기 | 일반좌표 |
| δ | 접힘각 | θ − α. **유일한 제어 입력이 작용하는 좌표** | 좌표 변환 |
| β | 무게중심 각 | (p₁α + p₂θ)/(M_t h) = "쓰러짐"을 대표하는 가중 평균 | 좌표 변환 |
| ψ | 평형 편차 | φ − φ_eq. 실측 ③에서 실제로 발산하는 양 | 실측(문서 70 §5) |
| q | 위치 묶음 | (φ, β) — Wait 단계의 2자유도 상태 | 벡터 표기 |
| x | 전체 상태 | (φ, β, φ̇, β̇) — 속도까지 4차원 | 상태공간 이론 |

왜 (φ, α, θ)를 (φ, β, δ)로 바꾸는가 — **물리가 단순해지는 축**이기 때문이다.
β는 쓰러짐만, δ는 자세만 담당하고, 토크는 δ에만 작용한다. 이 좌표 선택 자체가
"문제가 단순해지는 축으로 갈아타라"는 모드 분석의 정신이다(문서 05 §6.2).

### 1-2. 모델 상수 (사람 스케일 정본, 문서 01 표 1)

| 기호 | 값(사람 스케일) | 뜻 |
|---|---|---|
| R | 0.3~2.0 m (기준 0.7) | 줄 처짐 반경 = 발이 그리는 원호의 반지름 |
| h | 0.96 m | 직립 무게중심 높이 |
| M_t | 75 kg | 총 질량 (M₁=30 하체, m₂=45 상체) |
| p₁, p₂ | 51.0, 21.0 kg·m | 하체·상체의 정적 모멘트 (질량×팔길이) |
| μ | 4.33 kg·m² | 접기 가속이 β로 들어오는 유일한 문 (관성 커플링) |
| M, G, E | 행렬 | M q̈ = G q + E τ의 질량·중력·입력 분포 행렬 |

**로봇 실물에서는 이 상수들을 하나도 직접 재지 않았다**는 것이 이 연구의 자랑이다.
전부 P2R·λ·r 세 실측값 안에 뭉쳐 들어가고(문서 46 §6), 남는 어긋남은 노브
하나(γ)가 흡수한다.

### 1-3. 보존법칙과 등고선 방향 e

접는 도중에도 정확히 성립하는 식(기호 검증 완료): **ẍ_CoM = −g·φ**, 여기서
x_CoM = R·φ + h·β. 순간 접기는 무게중심을 못 옮기므로 상태 점프는 기울기
−h/R의 **등고선 방향 e = (h/R, −1)ᵀ** 을 따라서만 미끄러진다. ε*·δ_f* 공식의
분모가 전부 이 e에서 나온다.

---

## 2. 2층 — 모드 기호: λ, r, w는 전부 한 고유값 문제의 조각들

Wait 중(δ 고정) 방정식 q̈ = A₂q, A₂ = M₂₂⁻¹G₂₂의 고유분해에서 태어난 기호들.
**λ, r, w를 따로 외우지 말 것 — 셋은 같은 불안정 모드의 세 단면이다.**

| 기호 | 이름 | 개념적 출처 | 사람 스케일 (R=0.7) | 로봇 실측 (정본) |
|---|---|---|---|---|
| ω_eff | 안정모드 진동수 | 음의 고유값 √(−λ₁) | 6.30 rad/s (주기 1.0 s) | 동정 고유값 −0.19±5.32j |
| λ (λ_eff, λ_u) | 불안정모드 발산율 | 양의 고유값 √(+λ₂) | 3.54 /s | **5.44±0.59 (배가시간) / 5.66±0.09 (동정)** |
| T₂ | 배가시간 | ln2/λ = 0.693/λ | ≈0.20 s | **122~127 ms** |
| r | 안정모드선 기울기 | 안정 우고유벡터의 φ/β 비 | −2.12 | **−1.506±0.074** (모델 −1.6445) |
| c₀ | 안정모드선 절편 | 실물의 오프셋 합 (엔코더 바이어스+비대칭) | 0 (이론) | −1.11±0.86 ⚠미확정 |
| v | 우고유벡터 | A₂v = λv — 모드의 "모양" | | |
| u₂, w | 좌고유벡터 | wA = λw — 모드 좌표를 재는 "잣대" | | w = [0.664, 1, 0.1945, 0.3049] |

### 2-1. λ — "얼마나 빨리 넘어지는가"

**개념의 족보:** 선형계 ẋ = Ax에서 양수 고유값. 해에 e^{λt}가 들어가므로
λ는 **지수 성장률**이고, 시간상수 1/λ, 배가시간 ln2/λ로 환산된다. 동역학계
이론의 랴푸노프 지수(Lyapunov exponent), 제어이론의 우반평면 극점과 같은 자리의
개념이다. 원자핵의 반감기와 정확히 같은 수학(부호만 반대)이라는 것도 발표에서
쓰기 좋은 비유다.

**실측 경험:** 놓기 18회, ln|ψ| 대 t 직선적합(밴드 2~9°, 상승부만)으로
λ = 5.44 ± 0.59. 이때의 발견 두 가지 — ① 실제로 발산하는 것은 φ가 아니라
ψ = φ − φ_eq (평형이 φ = +1.40°에 있었다), ② 회차를 늘리는 것보다 **놓는
방향을 섞는 것**이 더 중요했다(문서 53은 4회를 같은 방향으로 놓아 이걸 못 봤다).
동정(실측 ②)에서는 5.66 ± 0.09 — 4% 차이로 서로를 확인해 준다.

**λ가 5.44와 5.66 두 개인 이유(질문 대비):** 서로 다른 두 방법이 준 값이다.
5.44는 모델 없이 배가시간만 잰 것, 5.66은 4×4 시스템 동정의 고유값. finale8부터
A 계산에는 λ가 아예 안 들어가므로(§4-4) 이 선택은 배가시간 표시에만 영향 있고,
펌웨어는 w와 같은 동정에서 나온 5.66을 쓴다(한 묶음 원칙).

### 2-2. r — "안전한 자세들의 직선"

**개념의 족보:** 안정 모드 우고유벡터의 성분비. (β, φ) 평면에서 φ = r·β 직선이
**안정 부분공간의 단면** — 이 위의 상태는 불안정 성분이 0이라 흔들리기만 하고
넘어지지 않는다. 균형 제어의 목표 지점 그 자체.

**실측 경험:** 독립 3경로가 같은 답 — ① 4×4 동정의 좌고유벡터(−1.506),
② 놓기점의 넘어짐/흔들림 경계 직선(−1.494, 미분도 모델도 안 씀),
③ Ȧ = λA 직접 검사(−1.5~−2.0에서 R² 최대). 모델 예측 −1.6445와 8.4% 차이.
**위치항 r은 세 경로가 서로 받쳐 줘서 "단단한" 값이다**(문서 73 §4) —
속도항(w_v)이 동정 하나뿐인 "무른" 값인 것과 대비된다.

### 2-3. w — "위험만 골라 재는 잣대" (좌고유벡터)

**개념의 족보:** wA = λw를 만족하는 행벡터. 우고유벡터 v가 모드의 **모양**이라면
좌고유벡터 w는 상태에서 그 모드의 **좌표를 뽑아내는 사영**이다(문서 05 §6.3의
V⁻¹의 행). w 방향으로 사영하면 다른 모든 모드가 죽고 e^{λt}로 자라는 성분의
계수만 남는다 — 그래서 A = w·x가 "넘어지는 쪽 성분의 크기"가 된다.

**구조 (외우지 말고 유도할 것):**

```
무감쇠:  w = [ −1/r,  1,  −1/(rλ),  1/λ ]        ← 속도는 1/λ로 할인
감쇠 일반형:  w_q 는 그대로, w_v = w_q(λI − C)⁻¹   ← 문서 70 §7
finale8:  w = [ −1/r, 1, wf, wb ] = [0.664, 1, 0.1945, 0.3049]  ← 동정값 직접
```

검산 포인트: 동정된 w_φ = +0.6641과 −1/r = 0.66401이 일치 — **r과 w가 같은
고유벡터의 성분이라는 증거**다(문서 73 §3).

---

## 3. 3층 — 판정 기호: A, Â, 예측점

### 3-1. A — 참 위험도

**A = w·x.** 4차원 상태를 숫자 하나로 접은 것. 단위는 β환산 도(°) — "몸이
β 1° 기울어진 것과 같은 위험"이라는 뜻. A = 0인 상태 집합이 안정모드선이다.

**동등한 두 표현** (같은 식의 두 얼굴, 문서 46 §1):

```
A = w_q·q + w_v·q̇                    (좌고유벡터 사영)
A = w_q·[ q + q̇/λ ]  (무감쇠)        (예측점을 안정선에서 읽기)
```

**예측점 q_pred = q + q̇/λ** — "지금 속도가 밀고 가는 만큼을 미리 위치로 환산해
더한 점". 속도를 발산 시정수 1/λ로 할인해 위치에 얹는다.

**개념의 족보(질문 대비 강력 카드):** 이 구조는 휴머노이드 보행 제어의
**캡처 포인트(capture point) / 발산성분 DCM(Divergent Component of Motion)**
과 수학적으로 같은 아이디어다. 걷는 로봇들은 x + ẋ/ω (ω = √(g/z))라는 점이
발 디딤 범위를 벗어나면 넘어진다고 판정하는데, 그것이 바로 "불안정 모드
성분만 보라"는 좌고유벡터 사영이다. 우리는 같은 원리를 2모드 결합계(줄+몸)에
유도해서 썼다 — "저희 A는 줄타기 판 캡처 포인트입니다"라고 말할 수 있다.

**환율표(실측, 문서 70 §7-3):** A에 1을 넣으려면 — β 1° / φ 1.5° /
β̇ 3.1°/s / φ̇ 4.6°/s. **속도가 A의 65%를 차지한다** — 놓을 때 잔류 속도
1~2°/s가 이미 문턱(0.6°)의 절반을 먹는다는 실전 감각.

### 3-2. Â — 로봇이 믿는 위험도

**Â = w·x̂.** 식은 A와 같고 들어가는 상태가 다르다 — 센서와 속도 파이프라인
(25 ms 차분 + τ28 ms EMA)이 만든 추정 상태 x̂. 실기에 존재하는 것은 Â뿐이고
트리거도 Â로 걸린다.

**실측 경험 3종 세트(문서 54):** ① 파이프라인은 발산 신호를 18~20% 과소평가
→ Â/A ≈ 0.90, 문턱 0.6°는 실제로는 참 A 0.66°에서 걸린다(10% 늦게 접는다).
② Â 잡음 바닥 0.59° rms — 문턱과 같은 자리, 원인의 92%가 발목 엔코더(0.223°).
③ 발목 센서 수리 후 0.035°로 개선(문서 70 §6-1), Â 잡음 0.106° = 문턱의 18%.
"γ나 문턱으로는 잡음을 구제할 수 없고 하드웨어를 고쳐야 한다"(문서 60 §3-3)는
v21 스윕이 이 서사의 결론이다.

---

## 4. 4층 — 제어 기호: ε*, γ, ρ, 그리고 κ의 은퇴

### 4-1. ε* 와 ε*_gen — 해설용 정답 (역사적 층위)

```
ε* = −h/(rR + h)              정지 출발 최적 접기 비율 (β₀에 무관!)
ε*_gen = −u₂ᵀq_pred / (β_i·u₂ᵀe)   속도 있는 일반화 (정지 대입 시 ε*로 환원)
```

접기 점프(등고선 방향)로 착지점을 안정모드선 위에 올려놓는 조건에서 나오는
닫힌형. β₀가 약분되어 사라지는 것이 "비율 제어 가능"의 근거다. MuJoCo 검증
±2%(R≥0.6). **단, 실기 제어변수는 ε가 아니다** — β_pred → 0에서 발산하는
비선형 량이라(문서 41 §3-2) "정지·단발을 설명하는 해설용"으로 남고, 실기는
각도 δ_f*로 간다.

### 4-2. δ_f* 와 k — 접기의 효력

```
δ_f* = −2A / (k·u₂ᵀe)     k = μM_tR²/det M₂₂ = 0.2175 (접기 1°당 β 되돌림량)
```

최적 접기각은 **예측점 평면 위의 1차식**(평면)이고, δ_f* = 0 등고선이
안정모드선 자신이다. 여기서 "접기량 ∝ A"라는 증분접기의 뼈대가 나온다.

### 4-3. γ, ρ — 증분접기의 노브

```
IDLE: |Â| > trig(0.6°) → hold += sgn·ρ·γ·Â → FOLD → REST(60ms) → IDLE
```

- **γ (감마):** 접기 게인. "벗어난 만큼의 몇 배를 접는가". 이론 유도값
  GAMMA_FOLD ≈ 7.4, 시뮬 측정 7~8, **작동 고원 5~12 (v21 전물리)**, 기본값 10
  (고원 위쪽 중앙, 유지각 최소). 유한시간 접기·서보 지연·비선형이 전부 이 안에
  뭉쳐 있는 **"줄 위에서 돌리는 노브 하나"**다(문서 46의 철학).
- **ρ (로):** 부분 보정 계수 0.95 — 100%를 다 접지 않고 5%를 남긴다(과보정 방지).
- **trig/rel/dead/vrel/rest:** 트리거 문턱 0.6° / 펴기 게이트 0.3° / 펴기
  데드밴드 1° / 펴기 속도 3°/s / 접기 후 휴지 60 ms. "펴기 자체가 불안정 성분을
  주입"(자기주입 0.236° = 게이트의 79%)하므로 안전할 때만 편다는 것이 검증 결론.
- **sgn, vg:** 접기 방향 부호(±1, 바닥 dry-run으로 확정 예정 — 미결),
  속도항 배율(1.0 = 실측 그대로, 0.88~1.45 밖은 실측이 아니라 튜닝).

### 4-4. κ (카파) — 태어나고, 일하고, 은퇴한 기호

전람회에서 κ를 물어보면 이 서사 그대로 답하면 된다. **κ의 일생:**

1. **탄생 (문서 70 §7):** 무감쇠 이론은 w의 속도항을 w_q/λ로 예측하는데, 동정된
   속도항이 그보다 컸다. 그 배수가 κ = w_v ÷ (w_q/λ) = **1.83 ± 0.35**.
   "속도가 이론보다 1.8배 위험하다"는 실측 보정 계수.
2. **정체 논쟁:** κ > 1을 감쇠로 해석하면 C ≈ +2.5·I — 속도가 가속을 **키우는**
   에너지 유입이라 수동 감쇠로는 설명 불가(동정 C의 고유값 −0.42, **+2.45**).
   후보는 측정 안 하는 자유도(줄 자체의 동역학)가 4상태 사영에 속도항으로 새어
   나온다는 것. **보정값은 단단하지만 "감쇠"라는 이름은 틀렸다** — 미해결로 명시.
3. **은퇴 (문서 73, finale8):** κ의 정의 자체에 w_v가 들어 있으므로
   (κ를 알려면 w_v를 알아야 한다), κ를 거쳐 되돌아오는 대신 **동정된 w_v를
   직접 대입**하는 것이 정확하다(두 성분 1.66/1.73을 스칼라 하나로 뭉개던
   3.9% 손해도 사라진다). 덤으로 λ가 A 계산에서 완전히 빠져 5.44 vs 5.66
   선택 문제도 소멸했다.

**교훈 문장(발표용):** "κ는 이론과 실측의 틈을 재는 온도계였습니다. 틈의 크기는
확정했지만 원인은 확정하지 못했고, 최종 제어기는 κ라는 중간 표현을 걷어내고
실측값을 직접 씁니다. 다만 위치항은 3경로 교차검증으로 단단하고 속도항은 동정
하나뿐이라 무르다는 사실은 표현을 바꿔도 남습니다 — 그래서 속도항에만 배율
노브(vg)를 달았습니다."

### 4-5. ★ FWE와 증분접기 — 메커니즘인가 알고리즘인가

전람회에서 나올 법한 정의 질문이다. 답은 "둘 다"이지만, **서로 다른 것을 가리키는
'둘 다'** 라서 층위를 나눠야 정확하다.

#### 두 낱말의 차이 (일반론)

| | 메커니즘 (mechanism) | 알고리즘 (algorithm) |
|---|---|---|
| 무엇에 대한 것인가 | **자연에서 실제로 일어나는 인과 사슬**에 대한 주장 | **목표 달성을 위해 설계된 절차** |
| 발견/설계 | **발견**된다 (이미 거기 있다) | **설계**된다 (여러 대안 중 하나를 고른다) |
| 검증 방법 | 참/거짓 — 관측과 대조 | 성능 — 잘 되는가/안 되는가 |
| 예 | "왜 넘어지면 원래대로 돌아오는가" | "그 원리를 컴퓨터로 어떻게 매 5 ms마다 실행할 것인가" |

#### 우리 연구에 대응시키면 — 메커니즘은 FWE가 아니라 **그 아래**에 있다

★ 초안에서는 "FWE = 메커니즘"이라고 적었으나 한 단계 더 내려가는 것이 정확하다.
**메커니즘은 물리적 인과 사슬이고, FWE는 그 사슬을 작동시키는 절차의 이름이다.**

```
[메커니즘]  처진 줄이 발에 원호 자유도를 준다              ← 자원 (얼음판엔 없다)
              ↓
            허리를 접으면 그 반작용으로 발이 던져진다      ← 수단 (장대가 없으니까)
              ↓
            발을 넘어지는 쪽으로 더 던져 중력 토크의 부호를 뒤집는다  ← 반전
              ↓
            뒤집힌 중력이 몸을 되돌린다                    ← 회복
              ↓  "그래서 정확히 얼마나 더 던져야 하는가?"
[법칙]      불안정 모드 성분을 0으로 → 안정모드선 → ε*, ε*_gen, δ_f*
              ↓  "잡음 있는 실기에서 매 5 ms 어떻게 실행하는가?"
[알고리즘]  ① FWE 완전사이클   ② 반복 FEW   ③ 증분접기
            — 서로 다른 절차, 같은 메커니즘
```

#### ★ 왜 FWE가 메커니즘이 아닌가 — 결정적 증거는 'E'다

문서 02 §4가 못 박았다. ε*로 접으면 불안정 모드가 사라져 **발산이 없고 기다림의
상한도 없다.** 한 번 접으면 **펴지 않아도** 반진동이 영원히 유지된다 —
> **"펴기는 균형 유지가 아니라 직립 자세 회복을 위한 동작일 뿐이다."**

즉 **E는 균형의 인과 사슬에 아예 들어 있지 않다.** 인과에 필요 없는 단계를 포함한
3단계 묶음은 정의상 **절차**이지 메커니즘이 아니다.

증분접기가 이를 확인해 준다 — 거기엔 FWE의 W도 E도 없다. IDLE/FOLD/**REST**가 있는데
REST(60 ms)는 물리적 기다림이 아니라 **재판정 잠금**이고, 펴기는 안전할 때만
(|Â|<0.3°) 도는 별도 동작이다. **같은 메커니즘, 완전히 다른 절차.**

#### 세 층이 각각 어떻게 검증되었나 (검증 방식이 신분을 드러낸다)

| 층 | 검증 질문 | 우리가 한 것 |
|---|---|---|
| **메커니즘** | **참인가?** | MuJoCo 전물리와 교차시간 **±1% 일치** — 성능 튜닝이 아니라 **가설 검증** |
| **법칙** | 수식이 맞는가? | ε* 공식 vs MuJoCo 수치최적 **오차 2.4% 이하**(R≥0.6), 정지 대입 시 자기환원 10⁻¹⁵ |
| **알고리즘** | **잘 되는가?** | γ 고원 5~12, 생존율, φ스윙 rms — 참/거짓이 아니라 **성능 스윕** |

메커니즘을 찾아낸 도구가 모드 분석(문서 74)이다 — 고유값 문제를 풀어
"상태를 안정 모드에 올려놓는 것이 균형이다"라는 인과 구조 **자체를 발견**했다.
법칙(ε* = −h/(rR+h))은 알고리즘이라기보다 **법칙(law)**에 가깝다 — 대입하면 답이
나오는 대수식이지 조건문·루프·상태를 가진 절차가 아니다.

#### ⚠ 정밀화 두 가지 (심사위원이 파고들 지점)

**(1) "발이 무게중심을 넘어간다"와 "안정모드선 위"는 서로 다른 직선이다.**

| 직선 | 기울기 (사람 스케일, R=0.7) |
|---|---|
| 무게중심이 발 바로 위 (Rφ + hβ = 0) | −h/R = **−1.37** |
| **안정모드선** (φ = r·β) | r = **−2.12** |

두 선은 평행하지 않다. 정성적 설명은 "발을 CoM 너머로"이지만 **정확한 목표는
안정모드선**이다. 그리고 **ε* = 1.83이라는 값 자체가 '더'의 정량**이다 — 발을 CoM
바로 아래에 세우는 데서(ε=0) 멈추지 않고, 접기 후 β가 **반대쪽으로 원래의 1.83배**가
되도록 던진다. 광대의 말 "기운 만큼보다 조금 더 접어 반대로 살짝 넘어지게 해 놓고"가
이 초과분이다.

두 선이 **다르다는 사실 자체**가 결정적이다 — 평행했다면 무게중심 등고선을 따라
아무리 점프해도 안정선에 영영 닿지 못한다. 실제로 두 기울기가 같아지는 조건
rR + h = 0이 정확히 **ε* 공식의 분모가 0이 되는(공식이 터지는) 조건**이다.

**(2) 정확히 접으면 '반전'이 아니라 '소거'다.**
ε*로 접으면 반대쪽으로 넘어가는 것이 아니라 **불안정 성분이 0이 되고 안정 진동만
남는다.** 눈에 보이는 "되돌아옴"은 그 안정 진동(진폭 hβ₀ ≈ 33.5 mm)이다.
과하게 접으면 그때는 진짜로 반대 방향 불안정 성분이 생긴다 — ε 축에서 안정의 띠
폭이 **±0.1로 좁은** 이유다. "너무 많이 접으면 반대로 넘어지지 않나요?"의 답이 이것.

#### 용어 정합 — 기존 문서와 충돌하지 않게

문서 02 §1은 "FWE 3단계 **메커니즘**의 제안"이라고 쓴다. 이 구분을 채택하면 FWE가
두 뜻으로 쓰이는 셈이므로, **발표에서만** 규약을 지키면 된다 (문서는 안 고쳐도 된다):

- **메커니즘을 부를 때** — "접기 반작용으로 발을 던져 중력 토크를 반전시키는 메커니즘".
  짧은 이름이 필요하면 **'발 던지기 반전'** 또는 **'접기-반전 메커니즘'**
- **알고리즘을 부를 때** — "FWE 사이클", "반복 FEW", "증분접기"

#### 이 구분이 왜 이 연구의 핵심 서사인가

문서 01의 LQR 대 FWE 비교가 정확히 이 구분이다. **LQR은 순수 알고리즘이다** —
2차 비용을 최소화하는 게인을 DARE로 풀어내는 절차이고, "왜 작동하는가"는
알고리즘 자체가 답하지 않는다(가제어성은 "가능하다"만 말해 줄 뿐). **FWE는 메커니즘을
먼저 세우고, 그 위에 알고리즘을 얹었다** — 그래서 "어떻게"에 답할 수 있다. 흥미롭게도
LQR 게인을 모드 좌표로 분해해 보면 LQR도 결국 같은 메커니즘(두 모드를 같은 방식으로
누르기)을 하고 있었다는 것이 드러난다(문서 01 Ⅱ-3) — **다른 알고리즘이 같은
메커니즘으로 수렴한 사례**다.

**한 줄 답변(발표용):** "저희 **메커니즘**은 — 처진 줄이 발에 원호 자유도를 주고,
장대가 없으니 허리 접기의 반작용으로 그 발을 넘어지는 쪽으로 **더** 던져서, 중력
토크의 부호를 뒤집어 몸이 되돌아오게 하는 것입니다. '정확히 얼마나 더 던지나'의
답이 모드 분석이 준 ε*이고, 그것을 잡음 있는 실기에서 매 5 ms 실행하는 절차가
FWE 사이클과 증분접기라는 **알고리즘**들입니다. 메커니즘은 발견해서 참인지
검증했고, 알고리즘은 설계해서 성능으로 튜닝했습니다."

---

## 5. 5층 — 실측 기호와 세 실측의 서사

### 5-1. P2R, P1R — 질량 배분비

**정의:** β = P1R·α + P2R·θ = α + P2R·δ. 상체가 무게중심에 기여하는 비율.
**어디서 오나:** p₂/(p₁+p₂) — 정적 모멘트의 비. 엔코더 값(α, δ)에서 β를
합성하는 데 필요한 **유일한 체형 상수**다. 이것이 없으면 A를 계산할 수 없다.

**측정의 아이디어(발표에서 빛나는 부분):** 로봇을 발목축에 매달면 평형에서
무게중심이 축 바로 아래 = **β = 0**. 그러면 β = 0 = α + P2R·δ에서
**α = −P2R·δ** — δ를 명령하고 발목각을 읽으면 기울기가 −P2R이다.
저울도 자도 없이 비율이 나온다. 실측: **P2R = 0.4285 ± 0.0011** (R² 0.999958,
히스테리시스 0.021° — 발목 마찰 사실상 0). 주의: 서보 처짐 때문에 명령각이
아니라 **실제 δ**로 적합해야 한다(명령각이면 −6.8% 틀린다).

### 5-2. 왜 세 개면 되는가 — 깔때기 논증 (★전람회 단골 질문)

| 실측 | 값 (정본) | 주는 것 |
|---|---|---|
| ① P2R | 0.4285 | β를 만드는 법 (관측식) |
| ② r, w_v (+c₀) | −1.506, [0.1945, 0.3049] | 위험 방향 = 목표 |
| ③ λ | 5.44 (T₂ 127 ms) | 시간 예산 + 교차검증 |

#### (1) 제어법칙이 요구하는 것은 딱 세 종류다

```
Â = w_q·q̂ + w_v·q̂̇ + A_offset        ← 판정
Δhold = sgn · ρ·γ · Â                  ← 동작
```

이 두 줄이 제어의 전부다. 물리 상수가 들어올 수 있는 자리는 셋뿐이다:

| 필요한 것 | 무엇이 채우나 |
|---|---|
| **① 상태를 만드는 법** (센서 → x̂) | **P2R** — β = α + P2R·δ |
| **② 위험 방향** (w) | **r** (위치항 −1/r) + **w_v** (속도항) — 둘 다 실측 ② |
| **③ 접기 효력의 크기** (γ) | **노브 하나** — 줄 위에서 돌린다 |

이 바깥에 상수가 들어올 자리가 **구조적으로 없다.** 그래서 세 개면 되는 것이다.

#### (2) 상류를 안 재는 이유 — 모든 물리 상수는 한 개의 병목을 지난다

```
질량 M₁ m₂ M_t · 관성 J μ · 기하 R h p₁ p₂ · 줄 장력 · 감쇠
                         ↓         A₂ = M₂₂⁻¹ G₂₂
                    시스템 행렬 A₂
                         ↓         고유분해
                    ★ λ  와  w  ★   ← 제어기가 만지는 것은 여기서부터
                         ↓
                    Â = w·x̂
```

**제어기는 M도 G도 한 번도 만지지 않는다.** 오직 (λ, w)만 쓴다. 그러므로
**하류에서 (λ, w)를 직접 재면 상류의 모든 상수가 자동으로 포함된다** — 우리가
값을 틀리게 알고 있던 것까지, 애초에 모델에 없던 것(줄 자체의 질량·처짐 형상·
베어링 마찰)까지 전부. 이것이 시스템 동정(system identification)의 핵심 발상이다.

**구체적 예 — R을 왜 안 재는가.** R(줄 처짐 반경)의 유일한 역할은 λ와 r을 바꾸는
것이다(문서 02 표 2: R 0.3→2.0에서 r이 −4.39→−1.23으로 이동). 그러니 **실제 줄 위에서
λ와 r을 재면 그 줄의 R이 이미 답 안에 들어와 있다.** 게다가 이상화된 R이 표현하지
못하는 것(줄의 질량, 실제 처짐 곡선, 매듭)까지 함께 들어온다 — 재는 쪽이 **더 정확하다.**

같은 논리로: p₁·p₂는 비율 P2R로만 들어오고, μ·M_t·det M₂₂는 접기 효력
k = μM_tR²/det M₂₂ 하나로 뭉쳐 γ 안에 들어간다.

#### (3) ★ 핵심 비대칭 — 방향은 재야 하고, 크기는 돌리면 된다

"왜 γ만 노브로 두는가"에 대한 답이자, 이 설계의 급소다.

| | r (방향) | γ (크기) |
|---|---|---|
| 틀리면 | **엉뚱한 목표를 겨눈다** | 너무 세게/약하게 접는다 |
| 게인으로 고칠 수 있나 | **불가능** — 어떤 γ도 잘못된 조준을 못 고친다 | 그 자체가 게인이다 |
| 허용 폭 | 좁다 (안정의 띠 폭 ±0.1) | **넓다 — 고원 5~12(3배)** |
| 그래서 | **반드시 실측** | 줄 위에서 돌려 찾음 |

γ가 흡수하는 것들을 세어 보면 왜 노브로 충분한지 보인다 — 접기 효력 k, 서보 지연,
유한시간 접기(γ_ft), 기어 효율, 마찰, 큰 접기의 비선형(84~100%), 파이프라인 감쇠
(Â/A≈0.90). **전부 접기량에 곱해지는 인자**라서, 모르는 수의 곱은 결국 모르는 수
하나다. 그것 하나를 돌려서 맞추면 된다.

#### (4) 세 실측이 주는 상수는 실제로 여섯 개

"세 개"는 **실험의 개수**이지 상수의 개수가 아니다. 펌웨어가 받는 것은:

| 상수 | 어느 실측에서 | 검증 경로 |
|---|---|---|
| P2R = 0.4285 | ① | R² 0.999958 |
| r = −1.506 | ② | **3경로** (동정·경계·Ȧ=λA) |
| w_φ̇ = 0.1945 | ② | 1경로 (동정) ⚠ |
| w_β̇ = 0.3049 | ② | 1경로 (동정) ⚠ |
| c₀ | ② | ⚠ **미확정** |
| λ = 5.44 / 5.66 | ③ + ② | **2경로** (4% 일치) |

교차검증 하나가 특히 예쁘다 — 동정된 w_φ = +0.6641과 −1/r = 0.66401이 일치한다.
**r과 w가 같은 고유벡터의 성분이라는 직접 증거**다(문서 73 §3).

⚠ **finale8 이후 λ의 신분이 바뀌었다.** A 계산에서 λ가 빠졌으므로(문서 73 §2),
실측 ③은 이제 **제어 상수 공급자가 아니라 ① 시간 예산 판정자 ② 실측 ②의 교차검증자**다.
"세 실측" 중 제어를 실제로 굴리는 무게는 실측 ②에 몰려 있다.

### 5-2b. ⚠ 세 실측이 커버하지 **못하는** 것 — 넷

세 실측은 **"무엇을 향해 얼마나"** 를 준다. 주지 못하는 것은 넷이고,
**전부 γ로도 흡수되지 않는다.**

| # | 밖에 있는 것 | 왜 세 실측에 없나 | 상태 |
|---|---|---|---|
| **부호** | `sgn` (접기 방향) | γ는 k의 **크기**를 흡수하지만 **부호는 못 흡수한다.** 틀리면 넘어지는 쪽으로 접는다 | ❌ **미결** — 논증 A(+1)/B(−1) 상충. 바닥 dry-run으로 확정 |
| **원점** | `c₀` → A_offset | 실측 ②가 줘야 하는데 같은 φ에서 ank가 0.6°밖에 안 흩어져 절편이 안 잡혔다 | ❌ **미확정** — +0.73±0.6°, **문턱 0.6°와 동급** |
| **잡음** | σ(발목) | 상수가 아니라 하드웨어 품질. 세 실측이 다 맞아도 σ>0.10°면 못 선다 | ✅ 해결 — 0.223→**0.035°** |
| **시간** | 사이클 vs T₂ | 상수가 아니라 예산. 접기가 배가시간보다 느리면 어떤 상수도 못 구한다 | ⚠ **빠듯** — 146 ms = **1.19·T₂**. `rest 30`으로 0.95배 |

여기에 유효 범위 단서 하나: **세 실측은 |φ| < 5°에서만 성립한다.** 6°로 넓히면
λ가 0.58로 무너진다 — 그 밖에서는 줄의 복원이 이겨서 넘어지는 대신 흔들린다.
즉 세 실측이 커버하는 것은 **"작은 기울기에서 서 있기"** 이고, 큰 외란 회복은
회복 천장(γ=10에서 6° 이상, 천장 미탐색)의 문제로 따로 다룬다.

**한 문장 정리:** 세 실측은 **조준(어디를 향해)과 눈금(얼마나)** 을 준다.
밖에 남는 것은 **어느 쪽으로 트는가(부호), 어디가 0인가(원점), 신호가 보이는가(잡음),
늦지 않는가(시간)** 다.

### 5-3. 실측이 가르쳐 준 사건들 (질문받으면 자랑할 것)

- **α = ank − φ 정정(문서 70 §2):** 문서에 적힌 부호 규약을 검산 없이 받아쓴
  것이 원인. 사용자의 물리적 기억("φ=+4에서 β≈−2로 놓았다")과 로그(+5.3)의
  충돌에서 발견. 정정하자 r의 부호가 뒤집혀 모델과 8.4%로 들어왔고 P2R
  히스테리시스가 0.139→0.021°로 줄었다 — "마찰"이라 해석했던 것의 대부분이
  부호 오류였다. **교훈: 이론값과의 비교가 버그 검출기다.**
- **φ_eq = +1.40°:** 발산의 기준점이 φ = 0이 아니었다. 놓는 방향을 섞자
  드러났다. 엔코더 영점인지 실제 기울어짐인지는 미해결(반대로 매달아 재현 예정).
- **케이블 표류(문서 70 §6-2):** USB 케이블을 상체에 매달면 65 cm 모멘트암으로
  토크가 걸려 세션 중 동정값이 흘렀다(λ 5.72→3.64). 발목 회전축을 지나게
  배선하면 모멘트암 = 0. **측정 조건도 이론의 일부다.**
- **선형 영역 |φ| < 5°:** 상한을 6°로 넓히면 λ가 0.58로 무너진다 — 줄의 복원이
  이겨서 로봇이 넘어지는 대신 흔들리기 때문. 모델의 유효 범위를 데이터가 그었다.

---

## 6. 개념 연결 지도 — "이 기호는 어느 이론에서 왔나요?"에 대한 즉답표

| 기호 | 한 줄 답 |
|---|---|
| φ, α, θ | 라그랑주 역학의 일반좌표입니다 |
| β, δ | 물리가 단순해지도록 고른 좌표 변환입니다 (쓰러짐/자세의 분리) |
| M, G | 라그랑주 방정식을 소각 선형화한 질량·중력 행렬입니다 |
| ω_eff, λ | 결합계 고유값 문제의 두 근입니다 — 진동수와 발산율 |
| T₂ | 반감기와 같은 수학입니다 — ln2/λ |
| r, 안정모드선 | 안정 모드 고유벡터의 방향 = 안정 부분공간의 단면입니다 |
| v / u₂(w) | 우고유벡터(모드의 모양) / 좌고유벡터(모드 좌표를 재는 사영)입니다 |
| A | 불안정 모드 좌표입니다 — 보행 로봇의 캡처 포인트와 같은 아이디어 |
| q_pred | 속도를 1/λ로 할인해 위치에 얹은 예측 상태입니다 |
| ε* | 접기 점프를 안정모드선에 착지시키는 닫힌형 해입니다 |
| δ_f*, k | 임펄스 제어의 선형 지도입니다 — 접기 1°의 효력이 k |
| γ, ρ | 비례 제어 게인과 부분 보정 계수입니다 — 현실의 뭉침을 흡수하는 노브 |
| κ | 무감쇠 이론 대비 속도항의 실측 배율이었고, 최종판에서는 동정값 직접 대입으로 대체했습니다 |
| P2R | 정적 모멘트 비 — 매달기 평형(β=0)으로 잰 체형 상수입니다 |
| LQR | 2차 비용 최소화의 최적 제어입니다 — 균형은 잡지만 '어떻게'는 설명하지 않아 FWE를 만들었습니다 |

---

## 7. 전람회 예상 질문 & 모범 답변

**Q1. "λ가 뭔가요?"**
A. 불안정 모드의 지수 성장률입니다. 저희 로봇은 λ ≈ 5.4/s로, 기울기가 약
0.13초마다 두 배가 됩니다. 놓기 실험 18회에서 기울기의 로그를 시간에 대해
직선적합해 쟀고, 독립적인 시스템 동정값 5.66과 4% 안에서 일치합니다.

**Q2. "w는 왜 필요한가요? 그냥 기울기 β를 보면 안 되나요?"**
A. β가 커도 속도가 되돌아오는 중이면 안전하고, β가 0이어도 속도가 밖으로
향하면 위험합니다. 넘어짐을 정확히 예고하는 조합은 불안정 고유값의
좌고유벡터 w로 사영한 A = w·x 하나뿐입니다 — 이 방향으로 보면 진동 성분이
전부 사라지고 e^{λt}로 자라는 성분만 남기 때문입니다.

**Q3. "속도를 왜 λ로 나눠서 더하나요?"**
A. 발산의 시간 단위가 1/λ이기 때문입니다. 지금 속도로 1/λ초쯤 가면 도달할
위치를 미리 반영하는 것이고, 휴머노이드 보행 제어의 캡처 포인트(x + ẋ/ω)와
같은 구조입니다.

**Q4. "κ는 뭔가요?" (핵심 질문 — §4-4의 서사로)**
A. 무감쇠 이론은 속도항을 위치항의 1/λ배로 예측하는데, 실측은 1.8배 더
컸습니다. 그 배율이 κ입니다. 수동 감쇠로는 설명이 안 되고(동정된 계수 행렬에
에너지 유입 방향 고유값이 있습니다), 측정하지 않는 줄 자체의 자유도가 새어
나오는 것으로 추정합니다. 최종 제어기에서는 κ라는 중간 단계를 없애고 동정된
속도항을 직접 씁니다 — 다만 속도항은 검증 경로가 하나뿐인 무른 값이라 별도
배율 노브를 달아 두었습니다.

**Q5. "r이 왜 음수인가요?"**
A. 안정한 흔들림에서는 줄과 몸이 서로 **반대쪽**으로 엇갈리기 때문입니다
(광대가 엇박으로 타는 그 리듬입니다). 같은 쪽으로 기울면 협력해서 넘어지는
불안정 모드가 됩니다. 실측 −1.506, 모델 −1.6445로 8% 일치합니다.

**Q6. "P2R을 왜 매달아서 재나요?"**
A. 매달린 평형은 무게중심이 축 바로 아래, 즉 정확히 β = 0인 상태라서입니다.
그 조건에서 허리를 δ만큼 접으면 발목이 −P2R·δ만큼 반대로 돌아가므로, 저울
없이 각도 두 개만으로 질량 배분비가 나옵니다. R² 0.99996으로 잡혔습니다.

**Q6-1. "실측 세 개로 정말 충분한가요?"** (★ §5-2)
A. 제어법칙이 상수를 요구하는 자리가 구조적으로 셋뿐입니다 — 상태를 만드는 법,
위험 방향, 접기 크기. 앞의 둘을 실측 ①②가 주고, 셋째는 노브입니다. 질량이나 관성,
줄 처짐 R을 따로 재지 않는 이유는 그것들이 **오직 시스템 행렬을 거쳐서만** 제어에
들어오기 때문입니다. 그 행렬의 고유값과 고유벡터를 실물에서 직접 재면 상류 상수가
전부 포함됩니다 — 저희가 잘못 알고 있던 값이나 애초에 모델에 없던 줄의 질량까지요.
다만 정직하게 덧붙이면, 세 실측 밖에 네 가지가 남습니다: 접기 **부호**,
안정선의 **절편**, 센서 **잡음**, 그리고 사이클이 배가시간 안에 드는가 하는 **시간 예산**입니다.
앞의 둘은 현재 미결이고, 잡음은 발목 센서 수리로 해결했습니다.

**Q6-2. "왜 γ만 튜닝으로 두나요? 그것도 재야 하지 않나요?"**
A. 방향과 크기의 성격이 다르기 때문입니다. r이 틀리면 엉뚱한 목표를 겨누는 것이라
어떤 게인으로도 고칠 수 없습니다 — 그래서 반드시 재야 합니다. 반면 γ는 게인 자체라
안정한 구간이 5~12로 3배나 넓고, 서보 지연·기어 효율·마찰처럼 접기량에 곱해지는
미지수들이 전부 그 하나로 뭉쳐집니다. 모르는 수의 곱은 결국 모르는 수 하나라서,
그것 하나를 줄 위에서 돌려 맞추는 것이 정확하고 정직한 방법입니다.

**Q7. "γ = 10은 어떻게 정했나요?"**
A. 이론 유도값이 약 7.4이고, 전물리 시뮬레이션 스윕에서 생존하는 구간이
5~12로 나왔습니다. 10은 그 고원의 위쪽 중앙이면서 유지각이 최소가 되는
값입니다. γ 하나에 유한시간 접기·서보 지연·비선형이 전부 뭉쳐 있어서, 최종
미세조정은 줄 위에서 노브로 합니다.

**Q8. "LQR이 있는데 왜 FWE를 만들었나요?"**
A. LQR은 균형을 잡지만 '어떻게'를 설명하지 않습니다. FWE는 같은 기하 —
상태를 안정 모드에 정렬 — 를 닫힌형 공식으로 드러내서, 광대의 "기운 만큼보다
조금 더 접고 줄 박자에 편다"는 몸의 지혜를 물리 법칙으로 번역합니다. 실제로
LQR 게인을 모드 좌표로 분해하면 FWE와 같은 사영을 하고 있음이 확인됩니다.

**Q9. "ε*가 초기 기울기와 무관하다는 게 왜 중요한가요?"**
A. 기울기를 정확히 재지 않아도 '비율'만 지키면 되므로 비례 제어가 가능해지고,
그것이 증분접기(벗어난 만큼 γ배 접기)라는 실기 제어법칙의 근거가 됩니다.

**Q10. "감쇠를 무시했는데 괜찮나요?"**
A. 이론은 무감쇠로 세웠지만, 실물 상수는 전부 실측(동정)에서 가져오므로
감쇠의 효과가 λ·r·w 안에 이미 반영되어 있습니다. 명시적 감쇠 행렬이 필요한
속도항은 일반형 w_v = w_q(λI − C)⁻¹로 처리했고, 수치로 1e-16까지 검증했습니다.

**Q11. "측정의 가장 큰 교훈은요?"**
A. 부호 하나였습니다. α = ank + φ로 적힌 규약을 검산 없이 썼다가 r의 부호가
모델과 반대로 나왔고, 물리적 기억과 로그가 충돌하는 지점에서 잘못을 찾아
α = ank − φ로 고치자 두 실측이 동시에 좋아졌습니다. 이론 예측값이 있었기에
버그를 잡을 수 있었습니다 — 이론과 실측은 서로의 검산기라는 것을 배웠습니다.

**Q11-1. "FWE나 증분접기는 알고리즘인가요, 메커니즘인가요?"** (★ §4-5)
A. **둘 다 알고리즘이고, 메커니즘은 그 아래에 따로 있습니다.** 저희 메커니즘은
"처진 줄이 발에 원호 자유도를 주고, 장대가 없으니 허리 접기의 반작용으로 그 발을
넘어지는 쪽으로 더 던져서 중력 토크를 뒤집는다"는 물리적 인과 사슬입니다. FWE
사이클과 증분접기는 그 메커니즘을 실기에서 실행하는 **서로 다른 절차**고요.
FWE가 메커니즘이 아니라는 증거는 'E'입니다 — 최적으로 접으면 펴지 않아도 균형이
유지되므로, 펴기는 자세 회복용이지 균형의 인과에 들어 있지 않습니다. 실제로
증분접기에는 FWE의 W도 E도 없습니다.

**Q11-2. "그럼 무게중심 바로 위에 발을 두면 되는 것 아닌가요?"**
A. 아닙니다. 그 조건(무게중심이 발 바로 위)과 저희 목표(안정모드선 위)는 기울기가
−1.37과 −2.12로 **다른 직선**입니다. 발을 CoM 아래에 세우는 데서 멈추면 아직 불안정
성분이 남아 다시 넘어집니다. 최적 접기 비율이 1.83이라는 것은 거기서 멈추지 않고
반대쪽으로 원래 기울기의 1.8배만큼 넘어가게 던진다는 뜻입니다. 재미있는 건 두 직선이
평행하지 않다는 사실 자체가 이 방법을 가능하게 한다는 점입니다 — 평행했다면 아무리
접어도 안정선에 닿지 못하고, 실제로 두 기울기가 같아지는 조건이 ε* 공식의 분모가
0이 되는 조건입니다.

**Q11-3. "너무 많이 접으면 반대로 넘어지지 않나요?"**
A. 넘어집니다. 그래서 최적값이 있습니다. 정확히 ε*로 접으면 반대로 넘어가는 게
아니라 **불안정 성분이 0이 되고 안정 진동만 남습니다** — 되돌아오는 것처럼 보이는
움직임이 그 진동입니다. 그보다 더 접으면 반대 방향 불안정 성분이 생기고, ε 축에서
안정한 구간의 폭은 ±0.1로 좁습니다. 그 좁은 길을 공식이 정확히 짚는다는 것이
저희 검증의 핵심이었습니다.

---

## 8. 자기 점검 문제 (연필로)

1. w = [0.664, 1, 0.1945, 0.3049]일 때, 상태 (φ, β, φ̇, β̇) = (1°, −1°, 0, 3°/s)의
   A를 계산하라. 트리거(0.6°)가 걸리는가? (답: A = 0.664 − 1 + 0.915 = +0.579° → 아직 안 걸린다)
2. λ = 5.66일 때 배가시간을 구하라. 접기+휴지 사이클 146 ms는 배가시간의 몇 배인가?
   (답: T₂ = 693.1/5.66 ≈ 122 ms, 1.19배 — 그래서 rest 30 ms 단축이 검토 목록에 있다)
3. r = −1.506일 때 β = 2°인 로봇이 안정모드선 위에 있으려면 φ는 몇 도여야 하는가?
   (답: φ = r·β ≈ −3.0° — 몸과 반대쪽)
4. P2R = 0.4285, δ = 20°를 접으면 매달린 로봇의 발목각은? (답: α = −8.57°)
5. ε* = −h/(rR+h)에 사람 스케일 h=0.96, R=0.7, r=−2.12를 넣어 1.83을 재현하라.
6. Â/A ≈ 0.90인 이유를 두 단어로 답하라. (답: 차분·EMA의 지연이 발산 신호를 18~20% 깎고, 속도가 A의 절반 이상이므로)

---

## 9. 값 정본 요약 (2026-08-23 기준 — 문서 70·73)

| 상수 | 값 | 단단함 |
|---|---|---|
| P2R | 0.4285 ± 0.0011 | ●●● (R² 0.99996) |
| λ | 5.44 ± 0.59 (배가) / 5.66 ± 0.09 (동정) | ●●● (2경로 일치) |
| r | −1.506 ± 0.074 | ●●● (3경로 일치) |
| w_v (wf, wb) | 0.1945, 0.3049 | ● (동정 1경로 — vg 노브로 감쌈) |
| c₀ | −1.11 ± 0.86 | ○ 미확정 (보완 측정 계획 있음) |
| γ | 10 (고원 5~12) | 줄 위 노브 |
| trig / rel / rest | 0.6° / 0.3° / 60 ms | 시뮬 검증 |
| 미결 | FOLD_SIGN(sgn), κ의 물리적 정체, φ_eq의 정체 | 발표 때 "열린 문제"로 정직하게 |
