cbshbalance/slackline-balacing1/docs/cowork/64_P2R_재실측_0.433_20260822.md

# 64. P2R 재실측 — 0.433 (2026-08-22)

> 문서 52 `p2r_test.ino` 절차를 그대로 수행한 **원 로그 기반 정식 측정**.
> 문서 57(8/17, 0.417)이 남기지 못했던 원 로그·적합표·절편·히스테리시스를 이 문서가 채운다.
> 원 파일: `0822_p2r_test.raw.txt` (3085줄), `0822_p2r_test.csv` (3013행, 100 Hz D행),
> `0822_p2r_test.events.csv` (MOVE 10건).
>
> **참고 범위 (8/22 방침):** 문서 46 「실측 세 개」 **이후** 문서만 근거로 쓴다.
> 그 이전 문서에서는 **측정 방법만** 가져오고, 거기서 유도된 예측값(질량표 계열)은
> 실측의 비교 기준으로 쓰지 않는다. 이 문서에 예측 −0.4122 가 없는 이유다.

---

## 1. 결과 한 줄

**P2R = 0.4328 ± 0.0027**  (α–δ 직선 기울기 −0.4328, R² = 0.99972, 9점)
→ **P1R = 0.5672**

| P2R 실측 | 값 | 지위 |
|---|---|---|
| 8/17 (문서 57) | 0.417 | ✕ **폐기** — 발목 센서 수리 **이전**에 잰 값 (§7) |
| **8/22 (이 문서)** | **0.4328** | **★ 실기 정본 — 믿을 수 있는 P2R 실측은 이것 하나뿐** |

8/17 값은 발목 센서 수리 전에 측정됐고(사용자 확인, 8/22), P2R 은 **발목각 α 의 기울기**이므로
그 채널의 결함이 답에 그대로 실린다. 두 값의 차 3.8 % 는 이번 측정의 불확실도(0.003)의 5 배다.

---

## 2. 측정 조건

- 발목축 매달기, δ=0 정지 후 `z` (→ **참영점 절차**, 문서 52 §4 표의 위쪽 경로).
- 명령열: `0 → 10 → 20 → 30 → 40 → 30 → 20 → 10 → 0` (상행·하행 각 1회).
- 각 점에서 살짝 흔든 뒤 멎는 자리를, `m` 으로 전환한 **100 Hz CSV** 로 통째 기록.
  → 8/17 의 "화면 한 줄 받아적기" 와 달리 **각 점 200 샘플 평균**을 쓴다.
- 유효 표본: 각 구간 **마지막 2 s = 201 샘플**의 평균 (창 0.5~3 s 로 바꿔도 기울기 변화 ≤0.001, §5).

---

## 3. 실측 표

| 점 | 명령 δ | **실제 δ** | α | α 표준편차 | 잔차 |
|---|---|---|---|---|---|
| 시작 | 0 | −0.178 | −0.069 | 0.057 | −0.052 |
| 상행 | 10 | 8.877 | −4.060 | 0.240 | −0.125 |
| 상행 | 20 | 18.264 | −8.072 | 0.074 | −0.075 |
| 상행 | 30 | 27.487 | −12.069 | 0.056 | −0.080 |
| 정점 | 40 | 36.643 | −15.999 | 0.047 | −0.048 |
| 하행 | 30 | 28.821 | −12.449 | 0.046 | **+0.118** |
| 하행 | 20 | 19.161 | −8.272 | 0.055 | **+0.114** |
| 하행 | 10 | 9.491 | −4.109 | 0.049 | **+0.092** |
| 복귀 | 0 | −0.182 | +0.042 | 0.059 | +0.057 |

(단위 °. 잔차는 전체 9점 적합 기준.)

### 적합 변형 — 어떻게 잘라도 0.432~0.435

| 방법 | P2R | 절편 | R² |
|---|---|---|---|
| 전체 9점 | **0.4328** | −0.093 | 0.99972 |
| δ≠0 인 7점 | 0.4326 | −0.097 | 0.99945 |
| 상행 5점만 | 0.4322 | −0.180 | 0.99998 |
| 하행 5점만 | 0.4346 | +0.007 | 0.99990 |
| 상·하행 평균 5점 (문서 52 권장) | 0.4334 | −0.086 | 0.99998 |
| 원점 강제 | 0.4364 | 0 (강제) | — |
| 인접차분 Δα/Δδ 평균 (오프셋 면역) | 0.4318~0.4346 | — | — |

---

## 4. 읽히는 것 네 가지

### 4-1. 절편 −0.093° → 참영점 절차가 제대로 먹었다
매달아 `z` 를 눌렀으므로 절편은 **구조적으로 0** 이어야 하고, 실제로 0.09° 이내다
(α 잡음 표준편차 0.057° 의 1.6배). 문서 57 의 미결 항목 "어느 영점 절차였나" 는
이 측정에 한해 **참영점 취득 경로**로 확정. 따라서 이 로그로는 발목 엔코더의
기존 영점 오차는 잴 수 없다 — 그것을 원하면 별도 회차(기계 기준면 `z` → 매단 뒤 `z` 금지)가 필요.

### 4-2. 잔차는 곡률이 아니라 **히스테리시스**다
잔차 부호가 상행 전부 −, 하행 전부 + 로 깨끗이 갈린다. 2차항이 아니라 마찰 데드밴드다.

- 상행선 − 하행선 = **0.139°** (δ=20 기준, α 환산)
- 기울기 차는 0.4322 vs 0.4346 = **0.6 %** — 기울기에는 거의 안 실린다.
- → 문서 52 가 권한 **상·하행 평균(0.4334)** 이 데드밴드를 상쇄한 값이고,
  전체 적합 0.4328 과 0.0006 밖에 안 난다. 어느 쪽을 써도 같다.

### 4-3. 처짐(droop) — 명령각으로 나누면 6.8 % 틀린다
| 명령 δ | 10↑ | 20↑ | 30↑ | 40 | 30↓ | 20↓ | 10↓ |
|---|---|---|---|---|---|---|---|
| 명령−실제 | +1.12 | +1.74 | +2.51 | **+3.36** | +1.18 | +0.84 | +0.51 |

상체 무게가 허리를 처지게 하고, 그 양이 상행·하행에서 다르다(서보 데드밴드).
**명령각 기준으로 적합하면 기울기 −0.4034 — 실제각 기준 대비 −6.8 %.**
문서 52 가 굵게 써 둔 경고("dcmd 가 아니라 d 로 나눠라")가 실측으로 확인됐다.
40° 에서 3.36° 처지므로, **증분접기 펌웨어의 접기량도 명령이 아니라 실제 δ 로 확인해야 한다.**

### 4-4. ★ 정적 매달림에서 발목 잡음이 **깨끗하다** — 0.035°

정지 구간 4곳(δ=0 시작 / δ=40 / δ=20↓ / δ=0 복귀)의 마지막 2 s, 100 Hz 201샘플:

| 구간 | φ sd | 발목 sd | α sd | **발목 고주파 rms** | α 고주파 rms |
|---|---|---|---|---|---|
| δ=0 시작 | 0.046 | 0.037 | 0.057 | **0.035** | 0.045 |
| δ=40 | 0.032 | 0.037 | 0.047 | **0.037** | 0.046 |
| δ=20↓ | 0.047 | 0.033 | 0.055 | **0.033** | 0.047 |
| δ=0 복귀 | 0.049 | 0.039 | 0.059 | **0.037** | 0.044 |

(고주파 rms = ±50 ms 이동평균을 뺀 잔차의 rms. 양자화 0.022°/LSB.)

- 네 구간이 서로 0.004° 안에 들어온다 — 접힘 각도와 무관한 **진짜 잡음 바닥**.

### 문서 54 와의 대조 — 방법·조건이 맞물린다

| | 문서 54 (8/17, `0817_p2r_r2_3.csv`) | **이 로그 (8/22)** |
|---|---|---|
| 로그 속도 | 100 Hz | 100 Hz |
| 고주파 추출 | 100 ms 이동평균 제거 | 동일 (±50 ms) |
| **φ 고주파 rms** | **0.034°** | **0.030~0.033°** ← 일치 |
| δ (서보) | 0.038° | 0.009~0.022° |
| **발목 고주파 rms** | **0.223°** | **0.033~0.040°** ← **1/6** |

**φ 채널이 두 로그에서 같은 값**이라는 것이 대조의 근거다 — 방법도 표본율도 같고,
같은 SPI 버스·같은 스케치 계열이다. 그런데 **발목만** 6배 떨어졌다.

**★ 필터는 전혀 안 걸린 값이다.** `p2r_test.ino` 는 `rawToDeg()` 가 SPI 원값을 바로
도로 바꿀 뿐 EMA 도 중앙값도 없다 (중앙값 `j` 는 문서 60 `incremental_fold.ino` 에만 있다).
0.035° 는 **날것**이다.

### ★ 원인 확정 — 발목 센서를 실제로 수리했다 (사용자 확인, 8/22)

문서 54 §5 는 **"줄이 멎었을 때 0.221 / 움직일 때 0.215 — 똑같다"** 고 이미 확인했으므로
정지·운동 차이로는 6배가 설명되지 않는다. 원인은 **8/17 이후 수행된 발목 센서 수리**다.

**문서 54 의 진단이 맞았고, 처방이 들었다.** 문서 54 §5 는 잡음이 정상적·백색·줄 움직임과
무관하다는 네 가지 근거로 "기계가 아니라 센서다" 라고 짚었고, 수리 후 그 채널만 6배 떨어졌다.
목표였던 **"0.223 → 0.05° 이하"** 를 실제로 달성했다 (0.035°).

남은 확인은 하나뿐 — 이 측정이 **줄에서 내려 매달린** 상태였으므로, 줄 위에서도
0.035° 가 유지되는지. 수리로 주원인이 제거됐으니 유지될 공산이 크지만,
케이블 배치·접지 경로가 다르므로 §8 조치 5 로 한 번 확인한다.

### Â 잡음으로 환산하면

문서 54 §5 의 분해를 발목 잡음에 선형 스케일하면 (발목 0.035° 기준):

| 항 | 문서 54 (발목 0.223) | **이 로그 (발목 0.035)** |
|---|---:|---:|
| 위치항 · φ | 0.020 | 0.020 |
| 위치항 · 발목 | 0.225 | **0.035** |
| 속도항 · φ̇ | 0.051 | 0.051 |
| 속도항 · 발목 β̇ | 0.539 | **0.084** |
| **합계** | **0.587°** | **0.106°** |

문턱 0.6° 대비 98 % → **18 %.** 문서 54 가 예측한 "발목을 φ 수준으로 고치면 0.10°" 와 일치하고,
문서 60 의 v21 판정선 **0.10 합격 / 0.15 경계** 에서 **합격 쪽**이다.

→ **수리로 해결됐으므로 발목 채널 별도 필터(문서 54 조치 2)는 넣지 않는다** (줄 위 확인 후 확정).
필터는 대가가 있다 — "잡음 반으로 = 지연 두 배", 그리고 그 지연은 문서 54 §4 의
"10 % 늦게 접는다" 를 키운다. **넣지 않아도 되면 넣지 않는 것이 낫다.**

(참고: 각 점 정착시간 2~3 s. 상행 10° 점만 스윙 잔여로 sd 0.240 — 잔차 최대 −0.125° 의 원인이며,
이 점을 빼도 기울기는 0.4336 으로 사실상 불변.)

---

## 5. 강건성 확인

| 평균창 | P2R | 절편 | R² |
|---|---|---|---|
| 0.5 s | 0.4337 | −0.073 | 0.99974 |
| 1.0 s | 0.4329 | −0.085 | 0.99975 |
| 2.0 s | 0.4328 | −0.093 | 0.99972 |
| 3.0 s | 0.4327 | −0.090 | 0.99974 |

창 선택 민감도 ±0.001, 방법 간 산포 ±0.002, 적합 SE 0.0027.
→ **불확실도는 0.003 수준** (0.7 %). 8/17 값과의 3.8 % 차이는 이것으로 설명되지 않는다.

(원 로그 앞머리의 4 Hz 예열 구간 2회 이동은 스윙이 남아 α/δ 가 −0.36~−0.57 로 산포가 커
본 적합에서 제외했다. 한 점 비율이 얼마나 못 믿을 값인지 보여주는 사례.)

---

## 6. 아래로 미치는 영향

P2R 은 **w 재계산과 무관**하다 — w = [−1/r, 1, −1/(r·λ), 1/λ] 에 P2R 이 들어가지 않는다.
들어가는 곳은 β 합성 한 군데뿐:

```
β = α + P2R·δ      →      Δβ = δ · ΔP2R
```

즉 **A(β환산 °) 오차 = 접힌 각도 × P2R 오차.** 정본을 0.417 로 두었을 때의 오차:

| 상황 | δ | Δβ = δ·0.0158 | 문턱 0.6° 대비 |
|---|---|---|---|
| 평시 접기량 (0.95·10·0.6) | 5.7° | 0.09° | 15 % |
| 중간 | 20° | 0.32° | 53 % |
| 큰 외란 | 38° | **0.60°** | **100 %** |

- **평시(δ≈6°)는 무차별**, 큰 접기에서만 문제.
- 문서 60 §3-4 **펴기 자기주입** 재계산: `W_βdot·P2R·vrel` = 0.189×0.4328×3 = **0.245°**
  (0.417 기준 0.236° → 펴기게이트 0.3° 의 79 % → **82 %**). 결론은 그대로 — 게이트를 펴기가 다 먹는다.
- 실기 반영은 재컴파일 불필요: 시리얼에서 **`p2r 0.433`** 한 줄 (문서 60 §4-1, 제어 정지 중).

---

## 7. ★ 0.417 은 폐기한다 — 고장난 발목 센서로 잰 값이다

**사용자 확인 (8/22): 8/17 이후 발목 센서를 실제로 수리했다.**
이것으로 0.417 과 0.433 의 차이가 설명된다.

**8/17 의 P2R 측정은 발목 채널이 고장난 상태에서 이루어졌다.**
그리고 P2R 은 **발목각 α 를 δ 로 나눈 기울기**이므로, 발목 채널의 오차가 그대로 답에 실린다.
문서 57 이 그때 예측값과의 일치를 근거로 판정을 내릴 수 있었던 것은 우연이다.

한 가지 구분이 필요하다:

| 고장의 성분 | 기울기에 미치는 영향 |
|---|---|
| **백색 잡음** (문서 54 가 잰 0.223°) | 평균이 0 이라 **기울기를 체계적으로 밀지 않는다.** 산포만 키운다 |
| **각도의존 오차** (자석 갭·편심·기울기가 만드는 1차 고조파) | **기울기를 그대로 민다.** 그리고 이건 문서 54 의 고주파 분석에 **안 잡힌다** |

문서 54 가 지목한 원인 후보 1번이 "자석 갭·정렬" 이었고 수리가 그것을 고쳤다면,
**같은 결함이 잡음과 각도의존 오차를 동시에 만들고 있었다**고 보는 것이 자연스럽다.
잡음만으로 3.8 % 를 설명하려면 δ=20 에서 0.33° 의 **한쪽으로 치우친** 오차가 필요한데,
백색 잡음은 그런 일을 하지 않는다.

**지금 채널이 깨끗하다는 증거** — 이번 적합의 잔차에 **곡률이 없다**.
자석 편심이 남아 있으면 α 가 0→−16° 로 도는 동안 사인꼴 잔차가 나타나야 하는데,
잔차는 상행 −/하행 + 로 깨끗이 갈리는 **순수 히스테리시스**다 (§4-2). R² = 0.99972.

### 그래서 바뀌는 것

| | 이전 | **지금** |
|---|---|---|
| 실기 정본 P2R | 0.417 (문서 57) | **0.4328** |
| 0.417 의 지위 | 실측 정본 | **폐기** — 수리 전 센서로 잰 값 |
| 문서 57 의 판정문 | "예측과 1.2 % 일치 → 교차검증됨" | **무효** — 근거가 된 실측이 폐기됐다 |

문서 57 이 남긴 "보강할 것" 세 줄(원 로그·적합표 / 절편 / 영점 절차)은 이 문서가 전부 채웠고,
그 결론은 뒤집혔다. **문서 57 은 이 문서로 대체된다.**

### 남은 자체검증 하나 — 배선 복원 토크

매달림 측정의 전제는 "평형에서 무게중심이 발목축 바로 아래" 다.
발목축을 **케이블이 가로지르면** δ 에 따라 복원 토크가 생겨 평형점을 밀 수 있고,
그건 기울기에 그대로 실린다. 이번 로그로는 못 가른다 (히스테리시스 0.139° 는 쟀지만
그 안의 배선 성분은 분리 안 됨).

**확인 방법:** 매단 상태에서 **발목 배선을 느슨하게 늘어뜨리고 같은 측정을 반복.**
기울기가 안 움직이면 0.4328 이 확정되고, 움직이면 그 차이가 배선 토크의 크기다.
10 분이면 되는 측정이고, 정본을 못 박기 전에 한 번 해 두면 이 값은 더 건드릴 일이 없다.

---

## 8. 조치

| # | 할 일 | 상태 |
|---|---|---|
| # | 할 일 | 상태 |
|---|---|---|
| 1 | 실기 정본 **P2R = 0.433** 으로 교체 (`p2r 0.433`, 제어 정지 중) | **바로 가능** |
| 2 | 문서 57 에 "**0.417 폐기 — 수리 전 센서로 잰 값. 문서 64 로 대체**" 주석 | 대기 |
| 3 | 문서 54 §8 "발목 센서 하드웨어 점검" 체크박스 **완료 표시** (0.223 → 0.035, 목표 0.05 달성) | 대기 |
| 4 | **배선 늘어뜨리고 재측정** — 0.4328 자체검증 (§7). 10 분 | 권장, 정본 확정 전 |
| 5 | 줄 위(또는 손으로 잡은) 조건에서 발목 잡음 확인 — 문서 60 펌웨어의 `n` 20 s 측정.<br>수리로 주원인은 제거됐고, 케이블 배치·접지가 다른 조건에서 0.035° 가 유지되는지만 본다 | 권장 |
| 6 | **발목 채널 필터(문서 54 조치 2) 폐기** — 지연 대가를 안 치른다 | 5번 확인 후 확정 |
| 7 | 발목 엔코더 영점 오차 별도 측정 (기계 기준면 `z` → 매단 뒤 `z` 금지) | 미수행 |
| 8 | 최종보고서 이론부에 α–δ 산점도 + 히스테리시스 잔차 그림 삽입 | 대기 |

**남은 실측:** 실측 ②(여러 φ 에서 놓기 → 안정선 기울기 r + 절편 c₀)가 아직 미수행이다.
문서 60 펌웨어는 r 을 **모델 예측 −1.6445** 로 쓰고 있다 — 이제 그것이 유일하게 남은
미실측 상수다 (λ 는 문서 53, P2R 은 이 문서, 잡음은 §4-4 로 닫혔다).

---

## 부록. 재현 절차 — `p2r_fit_0822.py`

```
python3 p2r_fit_0822.py 0822_p2r_test.csv 0822_p2r_test.events.csv
```

1. **구간 자르기** — `events.csv` 의 MOVE 시각을 경계로 100 Hz D행을 9구간으로 나눈다.
   로그 시작(313684 ms) 이전의 MOVE 2건은 4 Hz 예열 구간이라 CSV 에 없으므로 버린다.
2. **점 만들기** — 각 구간 **마지막 2 s = 201 샘플**의 `del_now_deg`·`alpha_deg` 평균.
   ★나누는 것은 **명령각이 아니라 실제 δ** (문서 52 의 경고, §4-3 에서 6.8% 로 확인).
3. **최소제곱** — α = a₀ + b·δ, `b = Sxy/Sxx`, `a₀ = ȳ − b·x̄`, **P2R = −b**.
   기울기 표준오차 `SE = √(SSE/(n−2)/Sxx)`.
4. **교차검산** — 상행만/하행만/상하행평균/원점강제/인접차분/평균창 0.5~3 s (§3, §5).

표준 라이브러리만 쓴다 (numpy 없음) — 수식이 코드에 그대로 보이도록.
