cbshbalance/slackline-balacing1/work/학생보고서_공동집필_20260810/그림_배치_판단표.md

# 그림 배치 판단표

이 표는 `학생보고서_직선서술판.md`의 문장은 유지하면서, 최신 학생 HWPX와 기존 정본 DOCX의 그림을 배치하기 위한 작업 기준이다.

| 번호 | 배치 위치 | 그림 내용 | 출처·수정 판단 |
| --- | --- | --- | --- |
| 1 | Ⅰ-1-가 서양·한국 줄타기 비교 뒤 | 서양 장대 줄타기와 한국 부채 줄타기 | 최신 학생 HWPX image1·2를 나란히 배치 |
| 2 | Ⅱ-1 Paoletti 선행연구 설명 뒤 | 원호 카트–단일 역진자 모델과 제어입력 관계 | 최신 학생 HWPX image3·4 |
| 3 | Ⅱ-2-1 발의 원호 궤적 설명 뒤 | V자 줄의 꼭짓점에 발이 고정되어 줄과 함께 움직이는 실제 기하 | 최신 학생 HWPX image6. ‘줄을 따라 미끄러짐’으로 읽히지 않도록 본문 직후 배치 |
| 4 | Ⅱ-2-4 좌표·행렬 설명 뒤 | 처진 줄 위 상·하체 2링크 모델과 결합 질량·중력 행렬 | 기존 좌표 부호 오류가 있던 image7 대신 새 모식도 작성. φ·α·θ는 모두 연직 기준 오른쪽 +, 발은 줄 꼭짓점에 고정임을 표시. 행렬은 image8 재사용 |
| 5 | Ⅱ-3 FWE 메커니즘 설명 뒤 | 접기–발 넘겨 보내기–기다리기–펴기의 인과 사슬 | 최신 학생 HWPX image9~12를 4단 배열 |
| 6 | Ⅱ-4 후보 소거 사고실험 뒤 | β=0, β=−φ, 그 사이의 일정한 비율 후보 | 최신 학생 HWPX image17~19를 3단 배열 |
| 7 | Ⅱ-5 모드 설명 뒤 | 안정모드와 불안정모드의 시간 변화 | 최신 학생 HWPX image20 |
| 8 | Ⅱ-5 모드 설명 뒤 | 정진자와 역진자의 안정성 대조 | 최신 학생 HWPX image22. 모드 개념의 직관 보조 |
| 9 | Ⅱ-6 ε* 닫힌해 설명 뒤 | 무게중심 등고선과 안정모드선의 교점으로 보는 ε* | 최신 학생 HWPX image29 |
| 10 | Ⅱ-6 ε* 설명 뒤 | 초기 기울기–접기 계산–안정모드 착지–이동의 시뮬레이터 화면 | 최신 학생 HWPX image25~28을 2×2 배열 |
| 11 | Ⅱ-7 예측점 평면 정의 뒤 | 원위치 평면과 예측점 평면 비교 | 종합 41 DOCX rId35 고해상도 원본 |
| 12 | Ⅱ-7 S1 설명 뒤 | 순간 단일접기 뒤 펴지 않아도 유계인 시나리오 | 종합 41 DOCX rId39 고해상도 원본 |
| 13 | Ⅱ-8 완전 사이클 설명 뒤 | S2 순간 완전 사이클 예측점 평면 | `docs/예측점평면_S2_순간완전사이클.png` 원본 |
| 14 | Ⅱ-9-가 유한시간 접기 뒤 | S3 유한시간 접기의 곡선 궤적 | `docs/예측점평면_S3_유한시간접기.png` 원본 |
| 15 | Ⅱ-9-나 실행오차 설명 뒤 | S5 반복에서 짧은 대기와 한 주기 대기의 오차 증폭 비교 | `docs/예측점평면_S5_반복.png` 원본 |
| 16 | Ⅱ-9-라 시뮬레이션 진화 설명 뒤 | LQR–MuJoCo–유한시간 FWE–증분 접기 진화 | 최신 학생 HWPX image37~40을 2×2 배열 |
| 17 | Ⅱ-9-라 생존 결과 뒤 | 기존 FWE와 증분 접기의 전물리 시뮬레이션 생존 결과 | 수치가 서로 다른 층위임을 한 그림에 구분해 새로 제작 |
| 18 | Ⅱ-10 실물 로봇 설명 뒤 | CAD 설계와 실물 로봇 | 최신 학생 HWPX image41·42 |
| 19 | Ⅱ-10 실물 로봇 설명 뒤 | 상·하체·연결부 구성 | 최신 학생 HWPX image43~45 |
| 20 | Ⅱ-10 실물 로봇 설명 뒤 | 질량중심·관성 등 실측 과정 | 최신 학생 HWPX image46~48 |

## 제외 판단

- image5: 초창기 발목토크 모델이어서 현재 1입력 허리 모델의 설명을 흐린다.
- image7: 상체 각도 부호가 현재 좌표 규약과 달라 새 모식도로 대체한다.
- image13~16: 폐기된 분리가정과 옛 메인식을 현재 이론처럼 보이게 하므로 제외한다.
- image21: 예측점 축 단위에 물음표가 남아 있고 고해상도 정본 그림이 따로 있어 제외한다.
- image23·24: 같은 시뮬레이터 화면의 도입 장면이며 image25~28과 중복되어 제외한다.
- image30~36: 더 높은 해상도의 정본 그림 또는 새 배치 그림으로 대체한다.
- image49~52: 현재 본문에서 직접 설명하지 않는 타 연구 그림이므로 참고문헌의 해당 서술이 보강되기 전에는 넣지 않는다.
- 종합 41의 rId43 `(s,n)` 회전좌표 그림: 현재 직선 서술판에서 이 우회 좌표를 제거했으므로 넣지 않는다.
