cbshbalance/slackline-balacing1/work/학생보고서_공동집필_20260810/학생보고서_1-7쪽_출처지도.md

# 학생보고서 공동 집필 1차 원고 — 출처 지도

## 원고 파일

- `학생보고서_공동집필_마스터.md`
- 현재 작성 범위: 본문 1–7쪽

## 정본의 우선순위

1. 수식·좌표·기하·모드 관련 사실: `줄타기연구_종합_41_균형재정의_모드_예측점평면_FWE진화_20260806.docx` 및 프로젝트 `AGENTS.md`
2. 서사와 핵심 표현: `줄타기_이론부_초안_v3_20260801.docx`
3. 보고서의 압축 구조: `보고서_3차수정안.docx`
4. 학생의 문제의식과 실제 탐구 목적: `균형의대가_보고서_0810_혜원(2).hwpx`, `KakaoTalk_Longtxt_20260810_2129_46_507_Group.txt`
5. Paoletti 모델의 입력 정의: 프로젝트에 보존된 논문 원문 `docs/slackline_biomech_refs/Paoletti_Mahadevan_2012_본문.txt`

## 쪽별 출처와 편집 내용

| 쪽 | 중심 내용 | 주로 보존한 원문 | 이번에 한 편집 |
|---|---|---|---|
| 1 | 서양과 한국 줄타기의 대비, 역동적 동작에 대한 역발상 | 학생 최신본 문단 122–132, 이론부 초안 12–15, 보고서 3차안 15 | ‘줄타기 장면 → 방해가 아니라 자원인가?’의 질문 순서로 재배열. 부채의 역할을 ‘주 복원 토크에는 부족’으로 제한 |
| 2 | 얼음판 사고실험, 몸 대신 줄–발을 옮긴다는 가설 | 이론부 초안 17–22, 사용자 동기 메모, 보고서 3차안 45 | ‘줄을 끌어온다’가 발의 미끄러짐이 아님을 즉시 명시. 허리 내력과 줄 장력 외력의 역할을 분리 |
| 3 | 탐구 목적과 범위 | 학생 최신본 133–139, 보고서 3차안 16 | 이론 규명을 최우선으로 배치. 시뮬레이션과 로봇은 성립 범위와 한계를 확인하는 검증 도구로 낮춤 |
| 4 | 선행연구와 공백 | 이론부 초안 23–30, 학생 최신본 155–174, Paoletti 논문 §2.1–2.2 | Paoletti 원문을 다시 확인하여 `Fα`는 팔·장대를 이용한 역진자 토크, `Fφ=0`은 카트 좌표를 직접 제어하지 않음으로 정확히 기술. 발목토크라는 표현 삭제 |
| 5 | V자 줄과 원호, 처진 줄의 복원력 | 이론부 초안 33–43, 학생 최신본 175–184, AGENTS.md §2.0·§3.2 | 발이 V 꼭짓점에 고정되어 줄과 함께 움직인다고 고정. `x_foot=R sinφ≈Rφ`로 정확화. `ẍ_CoM=-gφ`에 소각·무질량 줄 조건 명시 |
| 6 | 허리관절이 있는 2링크 모델과 인과 경로 | 이론부 초안 44–54, 학생 최신본 185–206, 보고서 3차안 53 | 모델 명칭을 ‘처진 줄 정진자 위 이중 역진자’로 통일. `φ,α,θ` 모두 연직 기준 오른쪽 양으로 통일. 내력 → 형상·φ 변화 → 줄 장력 외력의 순서를 명시 |
| 7 | 라그랑주 운동방정식, 관성 커플링, β·δ 좌표 | 이론부 초안 51–69, 학생 최신본 204–217, AGENTS.md §3.1–3.3 | 질량행렬의 비대각 구조를 본문에 복원. `β=(p₁α+p₂θ)/(M_th)`, `δ=θ−α`, `x_CoM=Rφ+hβ`를 권위 규약대로 정정 |

## 원문에서 의도적으로 고친 표현

### 1. 장대와 부채

- 삭제·완화: “부채는 아무 역할도 하지 못한다.”
- 채택: “부채는 몸을 되세우는 주 복원 토크를 만들 정도의 관성은 없다.”
- 이유: 부채와 팔이 자세 조절에 보조적으로 기여할 가능성까지 부정하지 않기 위함.

### 2. ‘줄을 끌어온다’

- 삭제: 발이 정지한 줄을 따라 이동하거나 줄을 손으로 끌어오는 듯한 표현.
- 채택: “발은 V자 꼭짓점에 고정되어 줄과 함께 움직이며, 허리 반작용이 줄–발 각 `φ`를 바꾼다.”
- 이유: 프로젝트의 핵심 기하 규약.

### 3. Paoletti 모델의 입력

- 삭제: “발목토크를 가정했다.”
- 채택: “논문은 팔이나 장대를 사용해 만드는 단일 역진자 토크 `Fα`를 두고, 카트 좌표는 `Fφ=0`으로 직접 제어하지 않았다.”
- 이유: Paoletti 논문 원문의 일반화 힘 정의와 일치.

### 4. 모델 명칭

- 삭제: 맥락 없이 쓰인 “단일 진자 위 이중 역진자”.
- 채택: “처진 줄 정진자 위 이중 역진자”.
- 이유: 타이트로프나 발이 원호 레일을 미끄러지는 모델로 오해하지 않게 하기 위함.

### 5. 이론과 실증의 위계

- 이론적 규명과 닫힌형 해의 도출을 연구의 중심 성과로 둠.
- 시뮬레이션은 가설 기각과 이론 검증, 로봇은 부분 실증과 모델–실물 간격 확인으로 한정.

## 다음 집필 구간에서 이어질 질문

7쪽은 다음 질문으로 끝난다.

> 허리를 어떻게 접어야 발을 무게중심 너머로 보내고, 상태를 떨어지지 않는 운동에 올려놓을 수 있는가?

8–11쪽에서는 이 질문에 대해 다음 순서로 이어 간다.

1. 접기의 직접 효과와 물리적 효과
2. FWE 가설: 발을 무게중심 아래에서 멈추지 않고 너머로 보내기
3. “얼마나 접을까, 얼마나 기다릴까?”라는 정량 질문
4. 분리가정과 옛 메인식의 기각
5. 결합을 정면으로 보면서 균형 자체를 다시 정의해야 했던 이유
