cbshbalance/slackline-balacing1/work/학생보고서_공동집필_20260810/학생보고서_공동집필_마스터.md

# 한국 줄타기는 어떻게 장대 없이 균형을 잡는가?

## 처진 줄 진자 위 이중 역진자가 허리 접기 하나로 서는 원리의 규명과 로봇 실증

> 공동 집필 1차 원고: 본문 1–7쪽
>
> 이 파일은 문장과 논리의 검토를 위한 원고이다. 쪽 구분은 최종 30쪽 배분을 위한 임시 기준이며, 그림의 크기와 표 배치에 따라 Word 편집 단계에서 미세 조정한다.

---

## Ⅰ. 탐구 동기 및 목적

### 1. 탐구 동기

#### 가. 더 어려워 보이는 줄타기가 더 자유로운 까닭은 무엇일까?

서양의 줄타기 곡예사는 팽팽한 줄 위에서 긴 장대를 들고 천천히 걷는다. 장대의 큰 관성모멘트는 몸의 회전을 느리게 하고, 몸과 장대 사이의 각운동량 교환을 통해 자세를 고칠 시간을 준다. 장대는 말하자면 빌려온 평형추다. 물리적으로 정직한 장치이고, 원리도 비교적 분명하다.

그런데 한국의 줄타기 광대에게는 그 장대가 없다. 손에는 가벼운 부채 한 자루뿐이고, 줄마저 일부러 느슨하게 맨다. 사람이 올라서면 줄은 V자로 깊이 처진다. 더 불안정해 보이는 조건인데도 광대는 조심스럽게 서 있기만 하지 않는다. 걷고, 뛰고, 앉았다 일어서며, 몸을 크게 접고 펴는 역동적인 동작을 이어 간다.

처음에는 그 요란한 몸동작을 균형을 방해하는 묘기라고 생각했다. 그러나 영상을 반복해서 볼수록 반대의 의문이 생겼다.

> 저 역동적인 동작과 크게 흔들리는 줄은 정말 극복해야 할 방해 요소일까? 오히려 그것들이 장대 없이 균형을 되찾게 하는 방법은 아닐까?

부채는 몸을 되세우는 주 복원 토크를 만들 만큼 무겁거나 길지 않다. 그렇다면 광대는 대체 무엇으로 균형을 되찾는가? 너무도 자유롭고 활기찬 한국 줄타기의 모습은 단순한 감탄의 대상에서, 물리적으로 설명해야 할 역설로 바뀌었다.

> **그림 배치 예정:** 서양 줄타기와 한국 전통 줄타기의 대비. 학생 보고서의 기존 사진만 사용하고 새 설명 그림은 만들지 않는다.

<!-- PAGE 1 END -->

#### 나. 몸을 줄 위로 되돌릴 수 없다면

이 질문을 더 분명히 하기 위해 마찰이 전혀 없는 얼음판 위에 사람이 서 있는 상황을 생각했다. 외부의 수평력이 없다면 사람이 팔을 휘두르고 몸을 비틀고 허리를 접더라도, 사람 전체의 무게중심은 수평 방향으로 이동하지 않는다. 몸속에서 만들어지는 힘은 내력이며, 내력은 몸의 각 부분을 재배치할 수는 있어도 계 전체의 무게중심을 직접 옆으로 밀 수 없기 때문이다.

좁은 줄 위에서도 몸 안의 동작만으로 이미 벗어난 무게중심을 다시 줄 위로 옮길 수 없다면, 한 번 기운 몸은 돌아오지 못하고 떨어져야 한다. 그런데 광대는 떨어지지 않는다.

수백 년째 눈앞에서 벌어지는 일이 물리와 충돌한다면 답은 둘 중 하나다. 물리가 틀렸거나, 우리가 문제를 바라보는 전제를 빠뜨렸거나. 물리가 틀린 것이 아니라면, 우리가 놓친 힘의 경로가 있어야 했다.

여기서 질문을 뒤집었다. 균형을 잡으려면 반드시 **몸을 줄 위로 되돌려야 하는가?** 몸의 무게중심을 직접 옮길 수 없다면, 반대로 **줄과 발을 몸 아래로 가져오면 되지 않을까?** 발을 무게중심 바로 아래에서 멈추지 않고 그 너머까지 보내면, 중력 토크의 방향까지 반대로 바꿀 수 있지 않을까?

이때 ‘줄을 가져온다’는 말은 발이 줄을 따라 미끄러지거나 손으로 줄을 당긴다는 뜻이 아니다. 발은 처진 줄의 V자 꼭짓점에 고정되어 있고, 줄과 발이 한 몸처럼 좌우로 흔들린다. 우리가 움직이고자 한 것은 줄 위에서의 발 위치가 아니라, **줄–발 전체가 흔들리는 각도와 그에 따른 공간 속 발의 위치**였다.

그러자 처음의 관찰이 다시 살아났다. 발과 줄을 옮겨야 한다면 줄은 팽팽해서는 안 된다. 처진 줄이어야 발이 줄과 함께 크게 흔들릴 수 있다. 광대의 큰 몸동작도 방해가 아니라, 그 줄–발 운동을 만들어 내는 수단일 수 있다.

> **첫 가설:** 한국 줄타기는 몸을 억지로 세우는 대신, 허리 동작의 반작용으로 줄과 발을 무게중심 아래로 옮기고, 처진 줄의 복원력을 이용해 균형을 되찾는 것일 수 있다.

이 가설은 아직 설명에 불과했다. 이제 세 가지 질문에 답해야 했다. 허리만으로 줄과 발을 어떻게 움직이는가? 발을 무게중심 너머로 보내려면 얼마나 접어야 하는가? 그리고 언제까지 기다렸다가 다시 펴야 하는가?

<!-- PAGE 2 END -->

### 2. 탐구 목적

이 탐구의 중심은 로봇을 오래 세우는 것이 아니라, 장대 없는 한국 줄타기가 가능해지는 물리적 경로를 설명하는 데 있다. 이를 위해 다음과 같이 탐구 목적을 정하였다.

#### 가. 장대 없는 한국 줄타기의 균형 회복 원리를 물리 법칙으로 규명한다

처진 줄과 허리관절만을 사용하여 `허리 접기 → 하체의 반작용 → 줄–발의 이동 → 중력 토크의 반전 → 균형 회복`으로 이어지는 인과 사슬을 밝힌다. 이를 위해 선행연구의 단일 강체 모델을 허리관절이 있는 상·하체 2링크 모델로 확장하고, 한국 줄타기에 맞는 ‘균형’의 뜻부터 다시 정의한다.

#### 나. 필요한 접기량과 동작 시점을 해석적으로 구한다

가설이 설명에 머물지 않으려면 “얼마나 접는가”와 “얼마나 기다렸다 펴는가”가 수식으로 결정되어야 한다. 라그랑주 역학으로 결합 운동방정식을 세우고, 줄과 몸의 모드 운동을 분석하여 필요한 접기 비율을 닫힌형 해로 유도한다. 정지 상태에서 출발한 결과를 속도가 있는 상태, 유한시간 접기, 펴기까지 포함한 완전 사이클로 차례로 확장한다.

#### 다. 이론의 성립 범위와 현실에서의 한계를 검증한다

유도한 결과를 독립적인 물리 엔진과 전물리 시뮬레이션에서 검증하고, 모델과 같은 3자유도·1입력 구조를 가진 로봇을 제작하여 실물에서 가능한 범위를 확인한다. 시뮬레이션과 로봇은 연구의 주인공이 아니라, 이론이 어디까지 맞고 어디서부터 현실과 달라지는지를 확인하는 검증 도구로 사용한다.

본 탐구가 답하고자 하는 질문은 다음과 같이 정리된다.

1. 처진 줄은 왜 균형을 어렵게 만드는 방해물이 아니라 복원력을 만드는 자원이 될 수 있는가?
2. 몸속의 허리 토크 하나가 어떤 관성 경로를 거쳐 줄–발의 운동까지 만들어 내는가?
3. 발을 무게중심 너머로 보내기 위해 얼마나 접어야 하며, 그 양은 초기 기울기에 따라 달라지는가?
4. 움직이는 상태와 실제로 시간이 걸리는 동작에서도 같은 원리를 사용할 수 있는가?

실제 광대가 이 연구에서 유도한 공식을 의식적으로 사용한다고 주장하는 것은 본 탐구의 범위를 벗어난다. 본 탐구의 목표는 한국 줄타기를 설명할 수 있는 물리적 메커니즘을 제안하고, 그 메커니즘의 성립 조건을 수식과 검증을 통해 밝히는 것이다.

<!-- PAGE 3 END -->

## Ⅱ. 탐구 과정

### 1. 역설을 선행연구에 묻다 — 찾은 것은 답이 아니라 공백이었다

한국 줄타기의 역사와 공연 구성, 기술의 이름과 형태를 정리한 자료는 풍부했다. 그러나 기울어진 몸이 어떤 힘의 경로를 거쳐 다시 균형으로 돌아오는지는 설명하지 않았다. 부채와 팔을 펼쳐 관성모멘트를 키우면 넘어지는 속도를 늦추고 대응할 시간을 벌 수 있다는 설명도 찾을 수 있었다. 하지만 그것은 **천천히 넘어지는 법**이지, 이미 기울어진 몸이 **되돌아오는 법**은 아니었다.

슬랙라인 생체역학 연구에서는 숙련자가 초보자보다 몸의 각운동량과 무게중심 가속도를 작게 유지하며, 숙련될수록 균형 협응에서 엉덩관절과 몸통의 역할이 커진다는 측정 결과를 얻었다. 이는 사람이 허리와 몸통을 균형에 사용한다는 중요한 단서였지만, 허리 동작이 줄–발의 운동을 거쳐 복원력을 만드는 인과 과정까지 설명하지는 않았다.

가장 중요한 출발점은 Paoletti와 Mahadevan의 연구였다. 이들은 줄과 사람을 `반지름 R인 원호 위를 움직이는 카트(줄–발) + 그 위에 선 단일 강체 역진자`로 단순화하였다. 그리고 LQG 최적제어를 적용하여 제어기가 있으면 균형이 가능하며, 균형에 필요한 노력이 최소가 되는 적절한 줄 처짐이 존재함을 보였다. 처진 줄의 횡방향 운동을 원호 위 카트로 나타내는 기하학적 뼈대는 우리 연구가 이 논문에서 배운 것이다.

그러나 두 모델이 묻는 질문은 달랐다. Paoletti 모델의 일반화 힘은 카트 좌표 `φ`에 작용하는 `Fφ`와 단일 역진자에 작용하는 토크 `Fα`로 나뉜다. 논문에서는 사람이 팔이나 장대를 사용해 만드는 토크를 `Fα`로 두고, 카트의 각도는 직접 제어하지 않는다고 하여 `Fφ=0`으로 놓았다. 즉 제어입력은 단일 강체인 몸을 세우는 토크로 작용하며, 실제 허리관절이 어떻게 하체와 발을 움직이는지는 모델에 들어 있지 않다.

| 비교 항목 | Paoletti와 Mahadevan의 모델 | 본 탐구의 모델 |
|---|---|---|
| 몸 | 단일 강체 역진자 | 허리로 연결된 상·하체 2링크 |
| 직접 입력 | 단일 역진자에 가하는 제한 토크 `Fα` | 상·하체에 반대 방향으로 작용하는 허리 토크 `τ` |
| 줄–발 좌표 | 원호 위 카트, `Fφ=0` | 직접 구동하지 않지만 허리 반작용과 관성 커플링으로 `φ`가 변함 |
| 중심 질문 | 제어기로 균형을 잡을 수 있는가, 최적 처짐은 무엇인가 | 허리 하나가 어떤 물리 과정으로 발과 줄을 움직여 균형을 회복하는가 |

선행연구는 처진 줄 위에서도 균형이 **가능하다**는 사실과 원호 모델을 주었다. 그러나 장대 없는 한국 광대가 실제로 가진 허리관절 하나가 어떤 경로로 줄–발을 움직이고, 그 뒤 어떤 힘이 몸을 되돌리는지는 여전히 비어 있었다.

> 문헌에서 찾은 것은 답이 아니라 공백이었다. 천천히 넘어지는 법과 제어 가능성은 알려져 있었지만, 허리에서 시작해 발과 줄을 거쳐 몸이 되돌아오는 과정은 설명되지 않았다.

<!-- PAGE 4 END -->

### 2. 첫 번째 열쇠 — 처진 줄은 받침이 아니라 변환기다

#### 가. 발이 줄과 함께 그리는 원호

사람이 줄의 가운데에 올라서면 줄은 발 위치에서 꺾여 두 개의 직선 토막으로 이루어진 V자가 된다. 발은 이 V자의 꼭짓점에 고정되어 줄과 함께 좌우로 흔들린다. 발이 정지한 줄 위를 미끄러지는 것이 아니다.

기둥 사이 거리를 `D`, 줄 전체 길이를 `L`이라 하자. 사람이 정확히 가운데에 서 있고 줄을 무질량인 두 직선 토막으로 근사하면, 반쪽 줄 `L/2`가 빗변, 기둥 사이 거리의 절반 `D/2`가 수평변이 된다. 이때 중앙의 처짐 깊이 `R`은

$$
R=\sqrt{\left(\frac{L}{2}\right)^2-\left(\frac{D}{2}\right)^2}
=\frac{1}{2}\sqrt{L^2-D^2}
$$

로 정해진다. 발이 줄과 함께 횡방향으로 흔들리면 V자 꼭짓점의 자취는 반지름 `R`인 원호가 된다. 원호인 것은 **줄의 모양**이 아니라 **줄과 함께 움직이는 발의 궤적**이다. 실물 장치에서는 변형을 고려하여 `R`을 회전축에서 발까지의 거리로 직접 측정하지만, 위 식은 처진 줄이 왜 원호 운동을 만드는지를 보여 주는 기하학적 출발점이다.

줄–발이 연직 아래에서 오른쪽으로 기운 각을 `φ`라 하면 발의 수평 위치는 정확히는 `x_foot=R sinφ`이고, 작은 각도에서는

$$
x_{foot}\simeq R\phi
$$

로 쓸 수 있다. 원호 위에서 중력은 발을 중앙으로 되돌리려 하므로, 처진 줄–발은 불안정한 요소가 아니라 가운데로 돌아오는 **안정한 정진자**다.

> **그림 배치 예정:** V자 줄과 발의 원호 궤적. 발이 줄을 따라 움직이는 그림은 사용하지 않고, 기존 DOCX의 권위 그림만 사용한다.

#### 나. 얼음판에는 없고 처진 줄에는 있는 것

얼음판 사고실험에서 몸 안의 힘은 전체 무게중심을 직접 옆으로 밀지 못했다. 이 사실은 줄 위에서도 바뀌지 않는다. 달라지는 것은 발이 놓인 공간적 위치에 따라 줄 장력의 방향이 달라진다는 점이다. 허리 동작으로 줄–발의 각 `φ`를 바꾸어 놓으면, 줄 장력의 수평성분이 외력으로 작용하여 몸 전체의 무게중심 운동을 바꾼다.

소각·무질량 줄 모델에서는 이 관계가 다음 한 줄로 정리된다.

$$
\ddot{x}_{CoM}=-g\phi
$$

허리를 어떻게 접든 몸 안의 힘이 무게중심을 직접 미는 것은 아니다. 그러나 허리 접기의 반작용으로 발의 위치를 바꾸면, 줄이 그 위치를 몸 전체에 작용하는 복원력으로 바꾸어 준다.

> 처진 줄은 단순한 받침이 아니라, 발의 위치를 무게중심을 되돌리는 힘으로 바꾸어 주는 변환기였다.

<!-- PAGE 5 END -->

### 3. 그렇다면 발은 무엇으로 움직이는가 — 허리관절이 있는 2체 모델

#### 가. 단일 강체에서 상·하체 2링크로

처진 줄이 발의 위치를 복원력으로 바꾸어 준다는 사실만으로는 균형을 설명할 수 없다. 여전히 “발을 무엇으로 움직이는가?”라는 문제가 남는다. 선행연구의 몸은 하나의 강체이므로, 몸 안에서 일어나는 접기 동작 자체가 존재하지 않는다.

사람 몸에서 실제로 크게 움직일 수 있는 관절을 생각하다가 몸을 허리에서 두 부분으로 나누었다. 막대 두 개를 가운데 관절로 연결하고 접으면 상체와 하체는 서로 반대 방향으로 회전한다. 이때 하체의 회전반작용은 발에 전달되고, 발은 줄의 V자 꼭짓점에 고정되어 있으므로 줄–발 전체의 각 `φ`가 변한다.

따라서 우리 모델은 다음 세 부분으로 이루어진다.

1. V자 줄의 꼭짓점에 고정되어 줄과 함께 원호 운동하는 발
2. 발에서 허리까지 이어지는 하체 링크
3. 허리관절로 하체와 연결된 상체 링크

발목은 자유롭게 회전하며 별도의 발목토크를 가하지 않는다. 직접 구동하는 것은 허리관절 하나뿐이다. 이 구조는 **처진 줄 정진자 위에 선 이중 역진자**이며, 세 개의 일반화 좌표를 갖는다.

| 기호 | 정의 |
|---|---|
| `φ` | 줄과 발이 함께 흔들리는 각도. 연직 기준 오른쪽이 양(+) |
| `α` | 하체의 절대 기울기. 연직 기준 오른쪽이 양(+) |
| `θ` | 상체의 절대 기울기. 연직 기준 오른쪽이 양(+) |
| `δ=θ−α` | 허리 접힘각 |
| `τ` | 상체와 하체에 크기가 같고 방향이 반대인 허리 토크 |

자유도는 `φ, α, θ` 세 개지만 입력은 허리 토크 `τ` 하나다. 따라서 이 모델은 3자유도·1입력의 저구동계다. 허리 토크는 줄 좌표 `φ`에 직접 작용하지 않는다. 그런데도 허리로 줄까지 움직일 수 있다면, 그 연결은 운동방정식 안의 관성 커플링에서 나타나야 한다.

#### 나. 허리 토크가 줄의 복원력으로 이어지는 경로

허리를 접으면 상체와 하체가 반대 방향으로 회전한다. 이것이 허리 토크의 직접적인 효과다. 그러나 균형에서 더 중요한 효과는 하체의 반작용이 발을 움직인다는 데 있다.

$$
\text{허리 토크}
\rightarrow \text{상·하체의 반대 회전}
\rightarrow \text{발과 줄의 }\phi\text{ 변화}
\rightarrow \text{줄 장력의 수평성분 변화}
\rightarrow \text{무게중심 운동의 변화}
$$

이 과정은 내력만으로 전체 무게중심을 직접 옮긴다는 뜻이 아니다. 허리의 내력은 먼저 몸의 형상과 줄–발의 위치를 바꾸고, 그 결과 방향이 달라진 줄 장력이 외력으로 작용한다.

> 허리 토크의 직접 효과는 몸을 접는 것이지만, 물리적으로 중요한 효과는 발을 옮기는 것이다.

> **그림 배치 예정:** 기존 DOCX의 V자 줄–발–하체–상체 좌표 그림. `φ, α, θ`를 모두 연직 기준 같은 부호로 표시한 그림만 사용한다.

<!-- PAGE 6 END -->

#### 다. 라그랑주 운동방정식과 관성 커플링

세 좌표로 각 물체의 운동에너지와 위치에너지를 구하고 라그랑주 방정식을 적용한 뒤, 직립점 부근에서 소각 선형화하였다. 일반화 좌표를

$$
q=(\phi,\alpha,\theta)^T
$$

로 두면 운동방정식은

$$
M\ddot q=Gq+E\tau, \qquad E=(0,-1,+1)^T
$$

의 형태가 된다. 질량행렬과 중력행렬은 다음과 같다.

$$
M=
\begin{bmatrix}
M_tR^2 & Rp_1 & Rp_2\\
Rp_1 & J_{\alpha\alpha} & J_{\alpha\theta}\\
Rp_2 & J_{\alpha\theta} & J_{\theta\theta}
\end{bmatrix},
\qquad
G=\operatorname{diag}(-M_tgR,\ p_1g,\ p_2g).
$$

여기서 `M_t`는 전체 질량이고, `p₁`과 `p₂`는 하체와 상체 질량분포에서 정해지는 중력의 정적 모멘트다. `Jαα`, `Jθθ`, `Jαθ`는 두 링크의 관성모멘트와 상호 관성항을 모은 값이다. 세부 정의와 실측값은 뒤의 파라미터 표에서 제시한다.

중력행렬 `G`는 대각행렬이다. 반면 질량행렬 `M`에는 `Rp₁`, `Rp₂`, `Jαθ`와 같은 큰 비대각 성분이 있다. 즉 `φ`, `α`, `θ`는 서로 독립적으로 움직이지 않는다. 하체를 가속하면 그 반작용이 발과 줄의 가속에 영향을 주고, 발의 가속은 다시 몸에 관성력으로 작용한다.

> 이 시스템에서 변수들을 얽는 것은 힘이 아니라 관성이다.

원래 좌표 `(φ,α,θ)`는 각 부분의 움직임을 나타내기에는 좋지만, 몸 전체가 얼마나 쓰러졌는지와 허리를 얼마나 접었는지를 바로 읽기 어렵다. 그래서 다음 두 좌표를 정의하였다.

$$
\beta=\frac{p_1\alpha+p_2\theta}{M_th},
\qquad
\delta=\theta-\alpha,
\qquad
h=\frac{p_1+p_2}{M_t}.
$$

`β`는 상·하체 기울기를 중력에 기여하는 정도로 가중평균한 쓰러짐 각이고, `δ`는 우리가 직접 명령하는 접힘각이다. 이 좌표를 사용하면 무게중심의 수평 위치가

$$
x_{CoM}=R\phi+h\beta
$$

로 정리된다. 첫째 항은 줄–발이 움직인 효과이고, 둘째 항은 몸이 기운 효과다. 이 식을 운동방정식과 결합하면 소각·무질량 줄 조건에서 앞서 얻은 `\ddot{x}_{CoM}=-g\phi`가 다시 나온다.

이 좌표변환에서 중요한 사실은 허리 토크가 직접 구동하는 변수가 `δ`라는 점이다. 균형을 나타내는 `(φ,β)`에는 허리 토크가 직접 들어오지 않고, 접는 동안의 `\ddot\delta`가 관성 커플링을 통해 영향을 준다. 따라서 허리는 상태를 다른 곳으로 옮기는 역할을 하고, 그 뒤의 복원은 줄과 중력의 자연운동이 담당할 가능성이 생긴다.

균형의 첫 번째 열쇠는 찾았다. 처진 줄은 발의 위치를 복원력으로 바꾸는 변환기이며, 허리는 관성 커플링을 통해 그 발을 움직일 수 있다. 이제 남은 질문은 하나다.

> **허리를 어떻게 접어야 발을 무게중심 너머로 보내고, 상태를 떨어지지 않는 운동에 올려놓을 수 있는가?**

<!-- PAGE 7 END -->
