cbshbalance/slackline-balacing1/work/학생보고서_공동집필_20260810/학생보고서_문단병합표.md

# 학생보고서 문단 병합표

## 편집 원칙

- 세 DOCX의 문장은 고쳐 쓰지 않고 그대로 사용한다.
- 같은 내용을 설명하는 문단이 여러 문서에 있으면 표현이 가장 좋은 한 문서의 문단만 선택한다.
- 최종 목차에 맞게 문단의 위치와 제목만 바꾼다.
- 탐구 동기는 학생 최신본과 이론부 초안의 얼음판 사고실험을 이어 붙인다.
- 시뮬레이션은 발전 과정을 한 문단으로, 로봇은 실물 검증 경과 한 문단으로 줄인다.
- 줄어든 분량에는 모드·ε*·공식의 위계·예측점 평면·FWE 진화 원문을 넣는다.

## 최종 단원별 원문 배치

| 최종 단원 | 원문 문서 | 가져올 문단 | 처리 |
|---|---|---:|---|
| Ⅰ-1가 문제 의식 | 학생 최신 보고서 | 122–128 | 원문 유지 |
| Ⅰ-1나 얼음판 사고실험 | 이론부 초안 v3 | 17–22 | 원문 유지 |
| Ⅰ-1다 역발상 | 학생 최신 보고서 | 130–132 | 원문 유지 |
| Ⅰ-1다 가설의 착지 | 선생님 동기 메모 | “몸을 세우는 대신 줄을 끌어오면 된다” | 빠져 있던 연결 한 단락만 보충 |
| Ⅰ-2 탐구 목적 | 학생 최신 보고서 | 134–139 | 원문 유지 |
| Ⅱ-1 문헌 조사 | 이론부 초안 v3 | 24–30 | 학생 보고서의 같은 설명은 제외 |
| Ⅱ-2 처진 줄과 모델 | 이론부 초안 v3 | 33–69 | 원호·변환기·2체 모델·좌표변환을 한 덩어리로 유지 |
| Ⅱ-3 이론 도구 | 이론부 초안 v3 | 73–83 | 정진자·저구동·모드 설명 유지 |
| Ⅱ-4 FWE 제안 | 이론부 초안 v3 | 88–116 | 접기의 직접 효과, 자기 기각, 반대쪽으로 쓰러뜨리기 유지 |
| Ⅱ-5 균형 재정의·후보 소거 | 이론부 초안 v3 | 118–135 | 후보 소거와 LQR 우회까지 유지 |
| Ⅱ-5 모드의 발견·정식화 | 종합 41 | 38–58 | 이론부 초안의 중복 모드 설명 대신 최신 종합 문단 사용 |
| Ⅱ-6 분리가정 기각·ε* | 이론부 초안 v3 | 153–216 | 이론의 핵심이므로 축약하지 않음 |
| Ⅱ-7 ε 공식의 위계 | 이론부 초안 v3 | 220–285 | ε*gen·γ·완전 사이클·반복 확장을 유지 |
| Ⅱ-8 예측점 평면 | 종합 41 | 89–126 | 원위치 평면, 예측점, 회전 좌표, 다섯 장면 유지 |
| Ⅱ-9 FWE 진화 | 종합 41 | 130–197 | FWE→FWEW→FEFE→FFFF의 원문 유지 |
| Ⅱ-10 시뮬레이션 | 보고서 3차수정안 | 128–129 | 한 문단과 그림 자리만 유지 |
| Ⅱ-11 로봇 | 보고서 3차수정안 | 137 | 실물 검증 경과 한 문단만 유지 |
| Ⅲ 결론·향후 계획 | 보고서 3차수정안 | 144–150 | 원문 유지 |
| Ⅳ 참고문헌 | 보고서 3차수정안 | 155–158 | 원문 유지, 서지사항은 추후 확정 |

## 중복으로 제외한 주요 문단

| 제외 문서·문단 | 제외 이유 | 대신 사용한 문단 |
|---|---|---|
| 학생 최신본의 선행연구 설명 | 이론부 초안과 내용 중복 | 이론부 초안 v3 24–30 |
| 학생 최신본의 처진 줄·2체 모델 설명 | 수식과 문장이 빠지거나 중복됨 | 이론부 초안 v3 34–69 |
| 이론부 초안 v3 136–150의 모드 후반부 | 종합 41에 더 완성된 같은 설명이 있음 | 종합 41 38–58 |
| 보고서 3차수정안의 균형·ε*·예측점 요약 | 이론부 초안과 종합 41의 상세 설명과 중복 | 이론부 초안 153–285, 종합 41 89–126 |
| 이론부 초안의 긴 전물리·하드웨어 장 | 보고서 분량에서 이론의 흐름을 끊음 | 보고서 3차수정안 128–129, 137 |
| 학생 최신본의 로봇 설계·제원 여러 쪽 | 로봇 비중을 줄이기 위함 | 보고서 3차수정안 137 한 문단 |

## 새로 써야 하는 부분

현재 병합본에서는 별도의 새 설명을 쓰지 않았다. 다음 항목만 최종 편집 때 최소한으로 보충하면 된다.

1. 탐구 동기에서 ‘몸을 줄 위로 옮기는 대신 줄과 발을 몸 아래로 가져온다’는 선생님의 질문 한 단락
2. 서로 다른 DOCX 문단 사이에서 시제가 끊기는 곳의 연결문장
3. 그림 번호와 표 번호
4. 참고문헌의 미확정 서지사항
5. 30쪽 편집 후 단원 사이의 짧은 요약문
