cbshbalance/slackline-balacing1/work/학생보고서_공동집필_20260810/학생보고서_원문병합본.md

# 한국 줄타기는 어떻게 장대 없이 균형을 잡는가?

## 처진 줄 진자 위 이중 역진자가 허리 접기 하나로 서는 원리의 규명과 로봇 실증

> 세 DOCX와 학생 최신본의 원문 문단을 새 목차에 맞춰 배열한 병합 초안이다. 문장 재작성 없이 중복되는 설명만 선택하여 제외하였다.

## Ⅰ. 탐구 동기 및 목적

### 1. 탐구 동기

#### 가. 문제 의식 — 서양 줄타기와 한국 줄타기

한국의 전통 줄타기 영상을 관찰하면서 가장 먼저 직관적인 의문이 들었다.

“장대도 없이 느슨한 줄 위에서 어찌 저렇게 이리저리 움직이며 균형을 잘 잡을 수 있을까?”

서양의 줄타기와 한국의 전통 줄타기는 겉보기에서부터 역학적 차이가 뚜렷하다. 서양 줄타기는 양끝을 팽팽하게 당긴 줄 위에서 길고 무거운 장대를 들고 천천히 이동한다. 몸이 기울어질 때 장대를 반대 방향으로 기울이거나 회전시켜 발생하는 외부 토크를 이용해 균형을 유지한다. 반면 한국 줄타기는 줄을 느슨하게 매어 V자로 크게 처지도록 만든다. 광대는 줄 위에서 걷고, 뛰며, 온갖 역동적인 장기와 묘기를 선보인다. 그들의 손에는 기다란 장대는커녕, 부채 한 자루가 전부이다. 서양의 줄타기는 장대를 기울여 토크를 만들고 무게중심을 정렬하지만, 부채는 그 역할을 할 수 없다.

역학적으로 부채는 가벼운 종이와 대나무 구조물에 불과하므로, 기울어진 광대의 몸을 바로 세울 만큼의 회전관성이나 복원 토크를 만들어 낼 수 없다. 그렇다면 외부에서 토크를 가할 도구가 전혀 없는 상황에서, 광대는 어떻게 넘어지지 않고 지속해서 균형을 잡을 수 있는가에 대한 본질적인 문제 의식이 형성되었다.

그림  서양 줄타기: 긴 장대를 활용하여 외력을 생성하고 무게중심을 제어하는 구조

그림  한국 전통 줄타기: 장대 없이 부채만을 들고 느슨한 줄 위에서 역동적인 동작을 수행하는 모습

#### 나. 얼음판 위의 사고실험 — 이건 불가능한 일이다

질문이 소박한 데 비해, 물리 수업에서 배운 것을 대입하자 사태는 훨씬 심각해졌다.

마찰이 전혀 없는 얼음판 위에 사람이 서 있다고 하자. 이 사람이 팔을 휘두르든 몸을 비틀든 허리를 접든, 자기 무게중심의 수평 위치는 단 1 mm도 옮기지 못한다. 몸속에서 만들어지는 힘은 전부 내력이고, 내력은 무게중심을 움직이지 못하기 때문이다(운동량 보존). 몸속 동작으로 할 수 있는 일은 무게중심을 중심으로 부분들을 재배치하는 것뿐이다.

줄 위의 광대도 마찬가지 아닌가? 줄은 점처럼 좁아서 발목으로 바닥을 밀 수도 없다. 그렇다면 한 번 기운 몸은 영영 돌아오지 못하고 떨어져야 한다.

그런데 광대는 떨어지지 않는다.

수백 년째 눈앞에서 벌어지고 있는 이 일이 우리가 아는 물리와 충돌한다면, 답은 둘 중 하나다. 물리가 틀렸거나, 우리가 무언가를 빠뜨렸거나. 물리는 틀리지 않았을 것이다. 그러니 우리가 빠뜨린 것이 있다.

> “불가능해 보이는 일이 실제로 일어나고 있다면, 그 안에 우리가 아직 모르는 물리가 있다는 뜻이다.”

#### 다. 역발상

그러나 우리는 이 관점을 완전히 뒤집는 역발상에서 탐구를 시작하였다.

“어려워 보이는 한국 줄타기의 요란한 몸동작들이, 방해 요소가 아니라 오히려 균형잡기를 더욱 쉽게 만드는 움직임이 아닐까?”

위와 같은 질문을 시작으로, 한국 줄타기가 장대 없이 균형을 잡는 메커니즘 규명을 위한 탐구를 시작하였다.

무게중심을 줄 위에 있게 하는 것이 균형이라면, 꼭 무게중심을 움직여야 할까? 몸을 세우는 대신 느슨한 줄을 내 밑으로 끌어오면 되지 않을까? 그렇다면 한국 줄타기의 줄은 균형을 어렵게 하면서도, 동시에 줄과 발을 움직일 수 있게 하려고 느슨해야 했던 것은 아닐까?

> “몸을 세우는 대신 줄을 끌어오면 된다.”

### 2. 탐구 목적

#### 가. 장대 없는 한국 줄타기의 균형 회복 원리를 물리 법칙으로 규명

선행 연구는 균형에 필요한 복원 토크를 장대나 팔의 회전이라는 외부 입력으로 다루었으나, 장대가 없는 한국 줄타기에는 이를 적용할 수 없다. 따라서 본 탐구는 광대가 실제로 가진 수단만으로 — 즉 처진 줄과 허리 관절만으로 — 기울어진 몸이 어떻게 균형을 되찾는지를 설명하는 인과 사슬을 세우는 것을 첫 번째 목적으로 한다. 여기에는 "균형이란 무엇인가"를 이 시스템에 맞게 다시 정의하는 일이 함께 포함된다.

#### 나. 원리를 수학적으로 유도하고 물리 엔진 시뮬레이션으로 검증

원리가 설명에 그치지 않으려면, 얼마나 접어야 하는지가 수식으로 결정되어야 한다. 따라서 라그랑주 역학으로 운동방정식을 세우고 모드 해석을 거쳐 최적 접기량을 닫힌 형태의 해로 유도하는 것, 그리고 그 결과를 로봇 물리 엔진(MuJoCo) 기반의 독립적인 시뮬레이션에서 수치적으로 대조하여 오차를 정량화하는 것을 두 번째 목적으로 한다.

#### 다. 자체 제작한 줄타기 로봇으로 실물 실증

후술로 다루겠지만, 시뮬레이션은 우리가 세운 가정 안에서 옳다. 그러므로 이론이 실제 물체에서도 성립하는지를 확인하기 위해, 모델과 같은 구조(허리 관절 하나로 구동되는 이중 역진자)의 로봇을 직접 설계·제작하여 실제 줄 위에 올린다. 로봇의 무게중심·관성모멘트·줄 마찰을 실측하여 시뮬레이션에 되먹임하고, 센서로 기울기를 측정해 스스로 접는 폐루프 균형을 실증하는 것을 세 번째 목적으로 한다.

## Ⅱ. 탐구 과정

### 1. 문헌 조사 — 찾은 것은 답이 아니라 공백이었다

답을 찾으러 자료부터 뒤졌다. 조사할수록 이상했다.

한국 줄타기 자료(국가무형문화재 제58호 기록물, 기술 분류 연구, 명인 인터뷰와 방송)는 풍부했다. 줄타기의 역사, 공연의 구성, 43가지【기술 가짓수 확정 필요 — 35 vs 43】 기술의 이름과 형태까지 상세히 기록되어 있었다. 그러나 ‘기울어진 몸이 어떻게 균형으로 돌아오는가’를 설명한 대목은 어디에도 없었다. 대중적 과학 기사(서울신문, 2006)의 설명도 “부채와 팔을 펼쳐 회전관성을 키워 넘어지는 것을 느리게 하고 시간을 번다”까지였다. 그것은 천천히 넘어지는 법이지, 되돌아오는 법이 아니다.

역학 논문으로 넘어가자 사정이 조금 나았다. Paoletti & Mahadevan(2012, J. R. Soc. Interface)이 줄 위 균형을 정면으로 다룬 사실상 유일한 연구였다. 이들은 줄 위의 사람을 “원호 트랙 위를 움직이는 카트(각 φ) + 그 위에 선 단일 강체 역진자(각 α)”로 모델링하고, LQG 제어기로 안정화에 성공했다. 두 가지 결과가 중요하다. (i) 제어기가 있으면 균형이 가능하다. (ii) 제어 노력이 최소가 되는 최적의 줄 처짐(sag)이 존재한다.

그러나 이 모델은 몸을 막대 하나로 보았고, 몸을 되세우는 복원 토크가 발목에서 나온다고 가정했다. 좁은 줄 위에서 발목은 그런 토크를 낼 수 없다. 그리고 결정적으로, 이 논문은 “제어기가 잡을 수 있다”는 가능성까지만 보였을 뿐 “어떤 물리 과정을 거쳐 몸이 되돌아오는가”라는 인과는 다루지 않았다.

슬랙라인 생체역학 연구들(Kimmerle 2022, Serrien 2017, Mombaur 2020 등)은 측정 결과를 준다. 숙련자는 초보자보다 각운동량과 무게중심 가속도를 낮게 유지하고, 훈련될수록 균형 협응이 엉덩관절 쪽으로 이동한다. “사람이 몸통과 엉덩이를 균형에 쓴다”는 정황 증거는 되지만, 대부분 발을 고정한 조건의 실험이라 회복의 인과 과정 자체는 비어 있다.

> “우리가 문헌 조사에서 찾은 것은 답이 아니라 공백이었다. 천천히 넘어지는 법은 알려져 있어도, 되돌아오는 법은 아무도 설명하지 않았다. 광대는 몸으로 알지만 말로 알려주지 않는다 — 그렇다면 우리가 물리로 지어내는 수밖에 없다.”

Ⅰ장의 결론: 우리가 풀어야 할 것은 제어 문제가 아니라 역설의 해명이다. 그리고 그 해명은 인용할 곳이 없으므로 직접 지어내야 한다.

### 2. 첫 번째 열쇠 — 처진 줄은 받침이 아니라 변환기다

#### 1. 결정적 관찰 — 발이 줄과 함께 흔들린다

줄타기 영상을 느린 속도로 반복 재생하며 우리가 들여다본 것은 발 밑의 줄이었다. 사람이 올라서면 줄은 발 위치에서 꺾여 V자가 되고, 그 꼭짓점이 발과 함께 좌우로 오간다.

여기서 발이 지나가는 자취의 모양이 정해진다. V자의 두 토막은 길이가 각각 L/2로 고정되어 있으므로, 꼭짓점이 놓일 수 있는 자리는 두 기둥을 잇는 선의 한가운데에서 일정한 거리만큼 떨어진 점들뿐이다. 즉 발은 그 한가운데를 중심으로 하는 원호 위를 움직인다 — 줄이 곧아도 그네가 원호를 그리는 것과 같다(원호를 그리는 것은 발의 자취이지 줄의 모양이 아니다). 반지름은 처짐의 깊이 R이고, 무질량 줄(직선 두 토막) 가정에서는 기둥 간격 D와 줄 길이 L로부터 피타고라스로 곧장 나온다.

R=L/22−D/22

원호 위를 흔들리는 물체 — 그것은 정진자다. 가운데로 되돌아오려는, 안정한 진자.

#### 2. 얼음판과 줄의 차이

여기서 Ⅰ-2의 역설이 풀리기 시작한다. 얼음판에는 무게중심을 옆으로 밀어 줄 바깥 힘이 없다. 그런데 처진 줄에는 있다. 줄은 발을 통해 몸 전체를 가운데로 끌어당기고, 그 힘의 방향과 크기는 오직 발의 위치가 정한다.

이것을 무게중심에 대한 운동방정식으로 쓰면 놀랍도록 깨끗한 한 줄이 된다. 무질량 줄은 줄 방향의 힘만 전달하므로,

xCoM=−g φt  (무게중심 보존법칙)

무게중심은 “발이 놓인 각 φ에 비례한 옆밀침을 받는 자유입자”다. 이 식의 무서운 점은, 허리를 어떻게 접든 토크를 얼마나 주든 정확히 성립한다는 것이다(기호 연산으로 검증 완료). 몸속에서 무슨 짓을 하든 무게중심을 직접 밀 수는 없다 — 얼음판의 교훈은 여전히 유효하다. 그러나 발의 위치는 바꿀 수 있고, 발의 위치만 바꿔 놓으면 나머지는 줄이 해 준다.

> “처진 줄은 단순한 받침이 아니라, 발의 위치를 무게중심을 되돌리는 힘으로 바꿔 주는 변환기였다. 무게중심을 직접 밀 수는 없어도 발의 위치는 바꿀 수 있다 — 여기에 균형의 열쇠가 있을 것이다.”

#### 3. 그렇다면 발은 무엇으로 옮기는가 — 모델의 정의

열쇠를 찾았지만 아직 쓸 수가 없었다. 선행연구의 ‘막대 하나’ 모델에는 발을 옮길 몸속 동작이 없기 때문이다. 몸을 하나의 강체로 보면 몸속에서 아무리 움직여도 그 강체 안에서 끝난다.

사람 몸에서 힘을 만들 수 있는 곳을 찾다가, 막대 중간에 관절을 달아 접었다 펴면 두 토막이 서로 반대로 회전한다는 데 생각이 닿았다 — 허리다. 그래서 모델을 이렇게 세웠다.

원호 위의 발(발목은 자유 회전) + 하체 막대 + 허리 관절(모터 1개) + 상체 막대

각도는 셋: φ(줄+발이 함께 흔들리는 각, 발 위치 xfoot=Rφ), α(하체 절대 기울기), θ(상체 절대 기울기)

우리가 직접 명령할 수 있는 것은 하나: 허리 접힘각 δ = θ − α, 입력은 힙 토크 τ

자유도 3, 입력 1. 제어가 어렵기로 유명한 저구동(underactuated) 시스템이다.

소각 선형화한 운동방정식은 다음과 같다(라그랑주 역학, 기호 검증 완료).

Mq=Gq+Eτ,  q=φ,α,θT, E=0, −1, +1T

M=MtR2Rp1Rp2Rp1JααJαθRp2JαθJθθ,  G=diag−MtgR, p1g, p2g

여기서 이 연구 전체를 지배하는 구조 하나를 지목해 둔다. 중력 행렬 G는 대각인데, 질량 행렬 M은 비대각 항(Rp₁, Rp₂, J_αθ)을 갖는다. 즉 이 시스템에서 변수들을 얽는 것은 힘이 아니라 관성이다. 앞으로 벌어지는 모든 흥미로운 일 — 3배 틀린 공식도, 두 개의 모드도, 허리 하나로 줄까지 제어되는 신비도 — 전부 이 비대각 관성항에서 나온다.

#### 4. 좌표를 물리가 단순해지는 축으로 갈아타기

(φ, α, θ)는 측정하기는 좋지만 의미를 읽기에는 나쁘다. 그래서 물리적 의미가 분명한 좌표로 바꿨다.

쓰러짐 각 β=p1α+p2θ/Mth — 상·하체 기울기를 질량 배분으로 가중평균한 것. “몸 전체가 실질적으로 얼마나 기울었나”

접힘각 δ=θ−α — 우리가 명령하는 자세 변수

이 좌표에서 무게중심의 수평 위치가 한 줄로 정리된다.

xCoM=Rφ+hβ  (h=직립 무게중심 높이)

줄이 발을 옮긴 거리 + 몸이 기운 효과. 이 한 줄이 이 연구 전체의 뼈대다.

이 좌표는 세 가지 좋은 성질을 갖는다(전부 기호 검증 완료).

① 토크는 δ에만 작용한다 — 서보가 δ를 추종하는 한, τ의 세부는 (φ, β) 동역학에 들어오지 않는다.

② 접기 각가속도 δ̈가 (φ, β)로 들어오는 문은 단 하나 — β행의 관성항 μ 하나뿐이다.

③ 접힌 자세의 중력 효과는 φ, β에 전혀 들어오지 않는다 — β를 중력 가중평균으로 정의한 대가로 얻은 선물이다.

[그림] 그림 2-1. 시스템 모식도 — V자 줄, 원호 위의 발, 상·하체 막대와 각도 정의 (손그림 자유물체도 스타일) 《도대회 그림 10·11 재사용 + 보완》

표 2-1. 사람 스케일 형상 파라미터 (이론·MuJoCo 검증 기준)

| 기호 | 값 | 설명 |
| --- | --- | --- |
| M₁ / m₂ / M_t | 30 / 45 / 75 kg | 하체 / 상체(유효) / 총 질량 |
| L₁, LC₁, LC₂ | 0.85, 0.30, ≈0.40~0.467 m | 하체 길이, 하체·상체 질량중심 위치 |
| p₁ / p₂ (유효값) | 51.0 / 21.0 kg·m | 정적 모멘트 |
| h | 0.96 m | 직립 무게중심 높이 |
| J_β / μ / J_δ | 89.03 / 4.33 / 2.03 kg·m² | 모드 좌표 관성 상수 |
| R | 0.3~2.0 m (가변) | 줄 처짐 반경 |

Ⅱ장의 결론: 균형의 열쇠는 발의 위치이고, 발을 옮기는 유일한 수단은 허리다. 이제 허리를 어떻게 써야 하는가만 남았다.

### 3. 이야기에 필요한 세 개의 도구

#### 1. 정진자와 역진자 — 그리고 두 개의 시계

정진자는 매달린 추가 기울면 중력이 가운데로 되돌리는, 기울수록 되돌아오려는 안정한 진자다. 역진자는 그 반대 — 손바닥 위에 세운 막대처럼, 기울수록 더 기우는 불안정한 진자다.

두 진자는 각자의 시계를 갖는다.

정진자의 시계는 주기다. 그리고 갈릴레오가 발견한 성질이 있다: 작은 진폭에서 주기는 진폭과 무관하다(등시성). 이 성질이 나중에 “기다리는 박자”를 진폭과 무관하게 일정하게 만들어 준다.

역진자의 시계는 배가시간이다. 기울기가 지수함수로 자라므로, “2배가 되는 데 걸리는 시간”이 그 시스템의 급한 정도를 나타낸다. 사람 스케일에서 이 값은 0.2~0.3초다.

줄 위의 모든 균형 동작은 이 0.2초 안에서 승부를 봐야 한다. 이 문장은 앞으로 여러 번 돌아온다.

#### 2. 저구동 — 문이 하나뿐인 방

자유도가 입력보다 많은 시스템을 저구동이라 한다. 우리 시스템은 자유도 3에 입력 1이다. 직관적으로는 절망적으로 보인다. 허리 토크는 α와 θ에만 직접 작용하고 줄(φ)에는 닿지도 않는데, 어떻게 줄까지 제어하는가?

답은 Ⅱ-3에서 지목한 비대각 관성항이다. 하체가 회전하면 그 반작용이 발을 옆으로 밀고, 발이 밀리면 줄이 흔들린다. 즉 입력은 관성 커플링을 통해 간접적으로 줄에 도달한다. Spong(1995)의 아크로봇이 같은 계열이고, Tedrake의 Underactuated Robotics가 이 분야의 표준 교재다.

#### 3. 연립 진동과 모드 — 씨앗 하나

추 두 개를 용수철로 이으면 둘은 서로 밀고 당기며 복잡하게 움직이는 듯 보인다. 그런데 이 운동은 언제나 두 가지 기본 패턴의 합으로 나뉜다 — 함께 흔들리는 패턴과 엇갈려 흔들리는 패턴. 이런 기본 패턴을 모드라 부른다. 각 모드는 자기만의 시간 규칙(진동수 또는 성장률)을 갖기 때문에, 복잡한 연립 운동도 모드로 나누면 한 개짜리 문제 여러 개가 된다.

### 4. 답을 지어내다 — FWE 메커니즘의 제안

#### 1. 접기의 직접 효과와 진짜 효과 (5월 8일)

허리 토크의 구조를 뜯어 보다가 첫 통찰이 나왔다.

허리를 접으면 상체와 하체가 서로 반대로 회전한다 — 이것이 접기의 직접 효과다. 그런데 하체가 회전하면 그 반작용이 발을 옆으로 민다. 발은 줄 위 원호에 올라앉아 있으므로, 발이 밀리면 줄이 흔들리고(φ가 변하고) 무게중심 보존법칙 xCoM=−gφ의 우변이 바뀐다.

> “허리 토크의 직접적 효과는 ’몸을 접는 것’이지만, 물리적으로 의미 있는 효과는 ’발을 옮기는 것’이다.”

간접 경로의 정체가 드러났다: 허리 → 하체 반작용 → 발 이동 → 줄의 복원력 변화 → 몸 전체.

이 경로를 쓰는 동작 규칙을, 광대의 동작 관찰(기울면 접고, 잠시 멈췄다가, 편다)에 맞춰 세 단계로 이름 붙였다. 접기(Fold) — 기다리기(Wait) — 펴기(Extend), 줄여서 FWE.

#### 2. 첫 가설 — 접어서 세운다

첫 가설은 소박했다. 접어서 발을 무게중심 바로 아래로 가져다 놓으면, 중력이 기운 몸을 부드럽게 세워 줄 것이다. 용수철이 원래 자리로 돌아오는 그림이었다. 직관적이고, 안전해 보이고, 그림도 예뻤다.

#### 3. 자기 기각 — 세우는 게 아니라 반대로 쓰러뜨린다 (5월 11일) ★

사흘 뒤 토론에서 우리는 이 그림을 우리 손으로 뒤집었다.

발을 무게중심 바로 아래로 보내면 중력 토크가 0이 될 뿐이다. 토크가 0이라는 것은 “더 이상 나빠지지 않는다”는 뜻이지 “좋아진다”는 뜻이 아니다. 이미 기울어 움직이고 있는 몸을 되돌릴 힘은 어디에도 없다. 그 상태로 두면 몸은 기운 채로 계속 나아간다.

되돌리려면 중력 토크의 방향을 반전시켜야 하고, 그러려면 발을 무게중심 너머까지 보내야 한다. 그 순간 몸은 ‘세워지는’ 것이 아니라 반대 방향으로 쓰러지기 시작한다.

역진자의 “빨리 쓰러지려는” 성질 — Ⅲ-1에서 시스템의 적으로 소개했던 바로 그 성질 — 을 역이용해서, 쓰러짐으로 쓰러짐을 지우는 것이다.

> “복원은 부드러운 되돌아옴이 아니다. 기울어진 몸을 ‘세우는’ 것이 아니라, 발을 너머로 던져 ‘반대로 쓰러지게’ 만드는 것이다 — 넘어지려는 성질 그 자체가 복원의 엔진이 된다.”

일부러 반대로 넘어지게 만들어 놓고 기다리는 이 그림은 처음엔 불안해 보였다. 그러나 수식은 이쪽이 옳다고 말했다.

[그림] 그림 4-1. 메커니즘 발명의 두 그림 — (좌) 기각된 첫 가설: 발을 아래로, 부드러운 복원 (우) 채택된 가설: 발을 너머로, 반대로 쓰러뜨리기. 연구 노트의 손그림 재현 《손그림 제작》

#### 4. 뒤집기에서 따라 나온 세 가지

이 전환 하나에서 세 가지가 자동으로 따라 나왔다.

① 접기량에는 ‘넘어야 하는 양’(과접기)이 반드시 있다. 정확히 아래까지만 보내는 접기는 아무 일도 하지 않는 빈 동작이다. 그러므로 “얼마나 접나”는 취향이 아니라 답이 정해진 물리량이다.

② 기다림은 게으름이 아니라 반전된 중력이 일하는 시간이다. FWE의 W는 아무것도 안 하는 구간이 아니라, 중력에게 일을 맡기고 손을 떼는 구간이다.

③ 펴는 박자는 줄의 진동 주기가 정한다. 그리고 정진자의 등시성(Ⅲ-1) 덕분에 그 박자는 기울기의 크기와 무관하게 일정하다.

접기량·기다림·펴기 박자가 모두 물리량으로 정의되는, 검증 가능한 가설이 완성되었다.

#### 5. 이 가설의 신분 — 약점이자 강점

분명히 해 둘 것이 있다. 이 메커니즘은 광대에게 배운 것이 아니다.

광대는 수년의 수련으로 몸이 익힌 균형을 본능적으로 잡을 뿐이며, 우리의 설명을 들려드리면 “아닌데, 난 그렇게 안 잡는데”라고 하실 가능성도 충분하다. 그래서 이것은 실제 광대의 동작에 대한 설명으로서는 틀릴 수도 있는 가설이다 — 이것이 약점이다.

그러나 거꾸로, 물리 법칙만으로 지어낸 이 가설이 수식으로 닫히고(Ⅶ장), 시뮬레이션에서 작동하고(Ⅹ장), 로봇에서 재현된다면, ’장대 없이 처진 줄 위에서 균형을 잡는, 물리적으로 가능한 방법’을 최초로 보인 것이 된다 — 이것이 강점이다.

사람이 정말 이렇게 타는지는 광대의 동작 측정으로 확인해야 할 후속 과제로 정직하게 남긴다. 생체역학 연구들이 보고한 “숙련자일수록 균형 협응이 엉덩관절로 이동한다”는 결과는 이 가설에 유리한 정황 증거다.

Ⅳ장의 결론: 답을 지어냈다. 이제 그 답을 숫자로 만들어야 한다 — 얼마나 접고, 얼마나 기다리는가.

### 5. 균형이란 무엇인가 — 후보 소거와 모드의 발견

#### 1. 수식화 이전의 질문

접기량을 계산하려면 그보다 먼저 답해야 할 것이 있었다. 줄 위에서 ’균형이 잡혔다’는 것은 정확히 어떤 상태를 말하는가?

처음에는 당연히 완전 정지라고 생각했다 — 줄도 멈추고(φ=0) 몸도 수직인(β=0) 상태. 그러나 곧 이 목표가 필요 이상으로 강하다는 것을 깨달았다. 광대는 정지해 있지 않다. 줄과 함께 끊임없이 흔들리면서도 떨어지지 않는다. 균형의 목표는 ’멈춤’이 아니라 ’떨어지지 않음’이다.

그렇다면 흔들리면서도 떨어지지 않는 운동이란 어떤 것인가? 후보를 세우고 하나씩 검토했다.

#### 2. 후보 소거

후보 ① — 몸은 수직으로 세운 채(β=0) 줄만 흔들리는 상태. 기각했다. 흔들리는 발은 가속하고 있고, 가속하는 받침 위에서 몸이 수직으로 남아 있으려면 발목에서 몸을 붙잡아 줄 힘이 필요하다. 점접촉인 줄 위에 그런 힘은 없다. 발의 가속은 관성력이 되어 반드시 몸을 기울인다 — 발만 흔들리고 몸은 가만히 있는 운동은 이 시스템에 존재하지 않는다. 【기각 당시의 실제 논거·날짜를 연구 노트와 대조하여 확정】

후보 ② — 줄과 몸이 나란해지는 상태(β = −φ). 몸이 줄의 연장선과 한 직선을 이루며 통째로 흔들리는 그림이다. 이때 무게중심은 발보다 안쪽에 놓인다. 발을 회전축으로 하는 돌림힘으로 분석해 보았다. 접기 직후의 정지 상태(진폭 최대)라면 발의 가속도도 최대이므로, 무게중심을 안쪽으로 당기는 중력 토크와 바깥으로 미는 관성력 토크가 맞설 수 있다. 그러나 시간이 조금 지나면 문제가 생긴다. 진자의 가속도는 진폭이 최대일 때 최대이므로, 발이 중앙으로 돌아갈수록 가속도가 줄고 관성력이 약해진다. 그러면 평형이 깨지고 몸은 중력 쪽으로 쓰러지기 시작한다. 나란한 상태는 첫 순간에만 평형이고, 유지되지 않는다.

후보 ③ — 나란함보다 조금 덜 기운 어딘가. 접은 직후에도, 시간이 지난 뒤에도 돌림힘 평형이 유지되려면 몸의 기울기가 나란한 상태보다 조금 작아야 한다 — 계산은 β ≈ −0.9φ 부근까지 갔다. 【0.9 산출 과정·날짜를 연구 노트와 대조】

방향(줄과 엇갈리는 쪽)도 옳았고, ’1보다 조금 작은 비율’이라는 형태도 여기서 나왔다.

#### 3. 물러섬 — 그리고 우회로

그런데 우리는 그 문 앞에서 물러섰다.

0.9라는 계수가 늘 일정하리라고는 전혀 생각하지 못했기 때문이다. 상황마다 달라질 것 같았고, 정확한 값을 찾아내는 것도 쉽지 않아 보였다. 일정한 비율이 없다면, 상황마다 비율을 실시간으로 바꿔 가며 제어하는 수밖에 없다 — 그래서 이 시기에 우리는 현대 제어이론을 공부했고, 그 표준 도구인 LQR(선형 2차 조절기)을 시뮬레이션에 붙여 균형이 잡히는지부터 확인했다. (분명히 해 두면, LQR은 이 탐구의 연구 대상이라기보다 공부해서 빌려 쓴 도구였다. FWE가 완성된 뒤로는 비교 기준의 역할로 남는다.)

이 우회로에서 확인한 세 가지는 값졌다.

① 가제어성. 토크가 줄(φ)에 직접 닿지 않는데도 가제어성 행렬의 rank는 6(전체 상태 수)이었다. 허리 토크 하나로 6차원 상태 전체가 제어 가능하다 — 관성 커플링이 단일 입력을 φ까지 전달한다는 Ⅲ-2의 직관이 수학적으로 확인된 셈이다.

② 단일 오차 기반 PID는 발산했다. 슬랙라인 균형은 “허리 토크 → 발 이동 → 중력 토크 반전 → 기울기 복원”의 다단계 인과로 작동하고 각 단계에 시간 지연이 있는데, PID는 이 지연을 기다리지 못하고 과조작한다. 6개 상태를 동시에 되먹이는 LQR은 성공했다 — 속도 항이 자동으로 ’기다림의 지혜’를 만든다.

③ 게인의 구조. LQR 게인을 모드 좌표로 변환하면 접힘 게인은 줄 처짐과 무관한 상수(R=0.3~3.0에서 변동 0.1%)였고, 두 모드에 거의 같은 감쇠비가 적용되고 있었다. 즉 LQR은 두 모드를 같은 방식으로 동시에 누르고 있었다.

그러나 LQR은 끝내 답하지 않았다. “몸이 기울었을 때 광대가 무엇을 어떤 순서로 하는가.” 게인 숫자들은 균형을 만들어 내지만 인과를 말해 주지 않는다.

> “LQR은 균형을 잡는다. 그러나 균형을 설명하지 않는다. 우리가 원한 것은 잡는 법이 아니라 설명이었다.”

#### 1. 추론이 멈춘 자리에 정리(定理)가 서 있었다

나중에 배웠다. 선형 연립 진동계에는 두 변수가 정확히 일정한 비율을 유지한 채 함께 움직이는 특별한 해가 언제나 존재한다. 물리학이 이미 이름까지 붙여 둔 개념 — 모드(mode)였다.

발견의 경위는 정직하게 기록한다. 모드에 대한 지식 없이 사고실험과 추론으로 “일정 비율의 엇갈린 진동”까지 갔고, 그 후보를 AI에 검토시키자 “그것이 모드”라는 이름이 돌아왔다. 우리가 놓친 것은 한 가지였다 — 관성력이 약해질 때 중력 토크도 정확히 같은 박자로 약해지고 있었다. 안정 모드에서는 φ와 β가 같은 cos(ωt)를 공유하므로 관성력 토크(∝ φ)와 중력 토크(∝ β)가 함께 작아진다. 평형은 깨지지 않고, 비율은 처음부터 끝까지 상수다.

#### 2. 두 개의 모드

결합된 (φ, β) 연립계 M₂₂q̈ = G₂₂q 의 고유값 문제를 풀면 부호가 반대인 두 모드가 나온다.

안정 모드 (고유값 −ω² < 0): 줄과 몸이 일정 비율 r = φ/β 로 엇갈려 흔들리며 가운데로 되돌아오는 반진동. R = 0.7에서 r = −2.12.

불안정 모드 (고유값 +λ² > 0): 줄과 몸이 같은 쪽으로 협력하며 지수적으로 발산하는 운동. 배가시간 0.2~0.3초.

주의할 점 하나 — 불안정 모드도 비율은 일정하다. 그러므로 “비율이 일정한 상태”만으로는 균형이 정의되지 않는다. 균형이란 불안정 모드 성분이 0인 상태다.

#### 3. 안정모드선 — eigenspace, 그리고 컨설팅의 명명

(β, φ) 평면에 상태를 찍으면 안정 모드는 하나의 직선(안정모드선 φ = r·β)이 된다. 되돌아오는 운동은 전부 이 직선 위에 있고, 이 직선 위의 초기조건에서 출발한 상태는 영원히 직선 위에 머문다.

컨설팅에서 이 직선의 수학적 신분이 명명되었다. 이 직선은 안정 고유벡터가 펼치는 고유공간(eigenspace)이며, 동역학이 그 안에 상태를 가두는 선형 불변 다양체(linearly invariant manifold)다. 우리가 “안정모드선”이라 부르며 사용해 온 대상이 표준 용어로는 불변 부분공간이라는 확인 — 보고서 이론부에서 이 대응을 한 문장으로 밝혀 두면 전공 독자에게 좌표가 잡힌다.

#### 4. 균형의 한 문장 정의

Ⅰ장의 재정의와 Ⅱ장의 언어가 만나 균형이 마침내 한 문장이 된다.

> “균형 잡기란, 상태를 불안정 모드 성분 없이 안정 모드 위에만 올려놓는 일이다. 그리고 FWE란, 그 일을 접기 한 번으로 해내는 방법이다.”

경계선 선언(정직의 원칙). 우리 것: 균형의 정의를 물은 것, 후보 소거, 엇갈림 비율까지의 추론. 배운 것: 그런 해가 존재한다는 정리의 이름(모드). 다시 우리 것: 이 시스템의 r를 닫힌 형태로 구한 것, 거기서 ε*를 유도한 것, 안정모드선을 속도까지 포함하도록 확장한 것(Ⅳ장). 교과서는 그 직선이 존재한다는 것까지 안다 — 허리 접기 하나로 그 직선 위에 올라서는 방법은 이 탐구가 처음 썼다.

### 6. 분리가정의 실패와 닫힌 공식 ε*

#### 1. 손으로 풀기 위한 가정

모드라는 언어를 얻었지만, 처음에는 그 언어를 쓰지 않고 손으로 풀려고 했다. 그래서 가정을 하나 세웠다.

분리 가정: 줄의 흔들림(정진자)과 몸의 쓰러짐(역진자)은 서로 영향을 주지 않는다.

이 위에서 ’한 사이클로 완전 복원’의 조건식을 유도했다. 좌변은 정진자가 줄을 되돌리는 양, 우변은 역진자가 반대로 쓰러진 양, 등호가 복원 완료다.

1+εcosωT=ε⋅coshλT

이 식에는 백미가 있었다. 초기 기울기가 양변에서 소거된다 — 최적의 접기는 기운 크기와 무관한 비율이라는 뜻이다. 충북과학전람회(5월)에서는 이 식까지 발표했다.

#### 2. MuJoCo의 판정 — 충격

전국대회를 준비하며 물리 엔진 MuJoCo로 정밀 검증했다. 결과는 충격이었다.

복원 시간을 3~4배나 과대예측했다. 그리고 줄이 길수록 오차가 커졌다.

#### 3. 범인 — 비대각 관성항 81%

원인을 행렬에서 추적했다. (φ, β) 2자유도 부분계를 행렬 그대로 풀면 다음 구조가 나온다.

φ=−ωdiag2φ+cφβ,  β=cβφ+λdiag2β

커플링 계수 cφ가 대각항의 81%에 달했다. 그리고 이 비율은 줄 길이와 무관한 체형 상수였다.

생각해 보면 당연했다. 접기로 발을 보내는 행위 자체가 발의 가속이고, 그 가속이 몸에 관성력을 만든다. 분리 가정은 FWE의 작동 원리 그 자체와 모순되는 가정이었던 것이다. 우리는 “발을 던져서 균형을 잡는다”고 주장하면서 동시에 “발을 던져도 몸에는 영향이 없다”고 가정하고 있었다.

#### 4. 폐기, 그리고 살아남은 것

분리 모델과 그 위에서 유도한 옛 메인식은 폐기했다.

다만 하나가 살아남았다. “β₀가 약분되어 최적 접기가 진폭과 무관하다”는 정성적 통찰은 결합 모델에서도 그대로 성립했고, 이것이 나중에 “비례제어가 가능하다”는 결론의 물리적 근거가 된다.

> “분리 모델은 축척이 틀린 지도였다. 방향은 맞았지만 거리가 틀렸다. 그리고 지도가 틀렸다는 것을 알려준 것은 우리의 직관이 아니라 독립적인 검증 수단이었다.”

Ⅵ장의 결론: 손으로 풀기 위한 편의는 물리를 이길 수 없다. 결합계를 정면으로 다뤄야 한다 — 그리고 그 도구는 이미 Ⅴ장에서 손에 들어와 있었다.

#### 1. 결합 모드 분석 — 시스템의 진짜 얼굴

기다리기(Wait) 중에는 δ가 고정되어 있으므로 시스템은 (φ, β) 2자유도 결합계로 줄어든다.

M22q=G22q,  A2=M22−1G22

A2를 고유분해하면 부호가 반대인 두 실모드가 나온다 — Ⅴ-4에서 소개한 그 둘이다. 사람 스케일의 수치는 다음과 같다.

표 7-1. 결합 모델의 모드 수치 (사람 스케일)

| R [m] | ω_eff [rad/s] | λ_eff [rad/s] | 안정주기 2π/ω [s] | r = v₁φ/v₁β | ε* |
| --- | --- | --- | --- | --- | --- |
| 0.3 | 10.97 | 3.10 | 0.57 | −4.39 | 2.68 |
| 0.5 | 7.95 | 3.32 | 0.79 | −2.78 | 2.22 |
| 0.7 | 6.30 | 3.54 | 1.00 | −2.12 | 1.83 |
| 1.0 | 4.83 | 3.86 | 1.30 | −1.66 | 1.38 |
| 2.0 | 2.84 | 4.65 | 2.21 | −1.23 | 0.64 |

수정한 결합 모델을 MuJoCo와 비교하자, x_CoM의 첫 영점 교차 시간 T_cross가 모든 (R, ε) 조합에서 ±1% 이내로 일치했다. Ⅵ장에서 3~4배 틀렸던 그 양이다.

> “모델이 마침내 현실을 붙잡았다.”

[그림] 그림 7-1. 결합 모델(해석) vs MuJoCo의 Wait 단계 x_CoM 궤적 비교 — 6개 (R, ε) 조합 모두 초기 시간 구조 ±1% 일치.

#### 2. 접기는 등고선 위의 점프다

이제 접기량을 풀 수 있다. 먼저 접기라는 동작의 기하를 정확히 이해해야 한다.

순간 접기는 무게중심의 위치와 속도를 보존하고, 발의 위치만 옮긴다. 무게중심 보존법칙 xCoM=Rφ+hβ에서, 접기 전후로 xCoM이 변하지 않으므로 상태 점프는 아무 방향으로나 갈 수 없다.

RΔφ+hΔβ=0  ⇒  기울기 −h/R인 등고선을 따라서만 미끄러진다

접기란 (φ, β) 평면에서 정해진 방향의 직선을 따라 상태를 미끄러뜨리는 동작이다. 방향은 물리가 정해 놓았고, 우리가 고를 수 있는 것은 얼마나 미끄러뜨릴 것인가 하나뿐이다.

#### 3. 유도 — 안정모드선 위에 착지시켜라

접기량을 무차원 비율 ε로 정의한다. 접기 직후의 쓰러짐 각이 βnew=−εβ0가 되도록 접는다고 하자.

ε = 0 → 발이 무게중심 바로 아래까지만 (Ⅳ-3에서 기각한 첫 가설)

ε > 0 → 발이 무게중심을 지나쳐 감 (과접기)

무게중심 보존으로부터 φnew=φi+h1+εβ0/R.

최적의 접기란 무엇인가? Ⅴ-5에서 이미 정의했다 — 착지점이 안정모드선 위여야 한다. 즉 접기 직후 상태가 안정 모드 고유벡터에 정확히 나란해야 한다(불안정 성분 소거).

φi+h1+εβ0/R−εβ0=r

정지 출발(φi=0)이면 이것은 ε에 대한 1차방정식일 뿐이다. 정리하면 h1+ε=−εrR, 즉 h=−εrR+h이므로:

ε*=−hr R+h

【손계산 확인】R = 0.7, h = 0.96, r = −2.12 → ε* = −0.96/(−2.12×0.7 + 0.96) = −0.96/(−0.524) = 1.83 — 표 7-1의 값과 일치한다.

#### 4. β₀가 사라졌다 — 눈대중의 물리적 근거

이 공식에서 가장 중요한 것은 거기에 없는 것이다.

필요한 것은 체형(h), 줄 처짐(R), 모드 구조(r)뿐 — 초기 기울기 β₀가 식에 없다. 분리 모델에서 얻었다가 폐기 위기를 넘긴 그 통찰(Ⅵ-4)이 결합 모델에서 정확한 형태로 부활한 것이다.

이것이 뜻하는 바는 크다. 기울기가 크든 작든 같은 비율로 접으면 된다. 광대는 자신이 몇 도 기울었는지 잴 필요가 없다 — 눈대중으로 “기운 만큼보다 조금 더” 접으면 된다. 로봇 제어의 언어로 옮기면 비례제어가 가능하다는 뜻이고, 이것이 나중에 반복 FEW(Ⅷ-5)의 구조적 근거가 된다.

> 광대의 말로 옮기면: “기운 만큼보다 조금만 더 접어 반대로 살짝 넘어지게 해 놓고, 줄이 한 번 갔다 오는 박자에 편다.” 우리가 수식에서 찾아낸 최적의 접기 비율이 이 오래된 몸의 지혜와 똑같은 말을 하고 있었다.

#### 5. 검증 — 그리고 공식이 스스로 밝히는 유효 범위

표 7-2. ε*: 해석 공식 vs MuJoCo 수치 최적

| R [m] | 0.3 | 0.5 | 0.6 | 0.7 | 0.8 | 0.9 | 1.0 |
| --- | --- | --- | --- | --- | --- | --- | --- |
| 공식 | 2.679 | 2.222 | 2.019 | 1.832 | 1.663 | 1.511 | 1.376 |
| MuJoCo | 2.410 | 2.150 | 1.970 | 1.810 | 1.650 | 1.490 | 1.370 |
| 오차 | −10.0% | −3.3% | −2.4% | −1.2% | −0.8% | −1.4% | −0.4% |

R ≥ 0.6에서 오차 2.4% 이하다. 그리고 R = 0.3의 10% 오차는 결함이 아니라 정보다. 이 조건에서는 진동 진폭이 φ_max = 23.5°까지 커져 소각 근사가 깨진다 — 공식이 자기 유효 범위를 정직하게 알려주고 있는 것이다.

여기서 예상하지 못한 일치가 하나 나왔다. 이 결과가 가리키는 적정 R은 0.6~0.8 m(사람 스케일)인데, 이는 실제 줄타기 줄의 처짐 스케일과 맞고, Paoletti가 보인 “최적 sag가 존재한다”는 결과와도 서로를 보강한다. 전혀 다른 경로로 접근한 두 연구가 같은 곳을 가리켰다.

[그림] 그림 7-2. ε 격자 스캔(행: R=0.3~1.0 m, 열: ε*와 ε=0.5~3.0, 2초). 첫 열(해석 ε*)만 전 구간 생존, 나머지는 발산.

#### 6. 뜻밖의 함의 — 펴지 않아도 된다

공식을 얻고 나서 그 뜻을 따져보다가, 우리 스스로도 놀란 결론에 도달했다.

ε*로 접으면 불안정 모드 성분이 사라진다. 불안정 성분이 0이면 발산하는 항이 없다. 발산하는 항이 없으면 기다림의 상한도 없다.

즉, 한 번 ε*로 접으면 펴지 않아도 영원히 떨어지지 않는다. 줄과 무게중심이 엇갈려 흔들리는 반진동(진폭 hβ₀ ≈ 33.5 mm)이 그대로 유지될 뿐이다.

그렇다면 FWE의 E(펴기)는 무엇인가? 균형 유지를 위한 동작이 아니라, 직립 자세를 회복하기 위한 동작이다. 광대가 접은 채로 계속 있어도 떨어지지는 않는다. 다만 그러면 공연이 안 될 뿐이다.

이 시점의 우리에게 이것은 흥미로운 여담이었다. 이 성질이 무엇으로 자라는지는 Ⅻ장에서 보게 된다.

Ⅶ장의 결론: “얼마나 접나”에 대한 답이 닫힌 공식 한 줄로 나왔고, 물리 엔진이 ±2%로 확인했다. 그러나 이 공식은 정지 상태에서, 순간적으로, 한 번만 접는 이상적인 세계의 답이다. 현실은 그 셋 모두를 허락하지 않는다.

### 7. 공식의 위계 — 현실을 향한 네 번의 확장

#### 1. 확장 ① — 움직이는 중이라면 (ε*_gen)

정지 공식은 접기 직전이 완전 정지일 때만 성립한다. 속도가 있는 상태에 정지 공식을 쓰면 MuJoCo에서 1.1~1.6초 만에 낙하했다.

왜인가? 속도가 있으면 불안정 모드의 해가 Ae+λt+Be−λt 꼴이 되고, 이 중 발산을 일으키는 것은 성장계수 A뿐이다.

A=12η2+η2/λ

그러므로 소거해야 할 조건은 “모드 정렬”이 아니라 A = 0이다. 이것을 상태로 쓰면 놀랍도록 해석하기 좋은 형태가 된다.

u2T q0+q0/λeff ≡u2Tqpred=0

εgen*=−u2Tqpred,baseβi⋅u2Te,  e=h/R, −1T

qpred=q+q/λeff는 “현재 속도를 불안정 모드의 시정수로 나눠 유효 거리로 환산해 더한 점” — 예측 상태다.

> “일반화의 본질은 위치를 정렬시키는 것이 아니라, 예측 상태를 정렬시키는 것이었다.”

이 공식은 스스로를 검사한다. 정지 조건을 대입하면 ε*로 정확히 환원되고(차이 10⁻¹⁵), 이미 순수 안정 모드로 진동 중인 상태를 넣으면 어느 시점에서든 εgen*=−1, 즉 “아무것도 하지 말라”가 나온다. 이미 균형 잡힌 광대에게 공식이 “가만히 있으라”고 답하는 자기일관성이다.

수치 스캔 대비 공식 오차는 ±2% 이내다(예: R=0.7, φ̇=2°/s, β̇=1°/s에서 공식 2.869 vs MuJoCo 2.819).

*[그림] 그림 8-1. 비정지 초기조건 6케이스 MuJoCo 검증 — ε*_gen(빨강)은 전 케이스 생존, 정지 ε*(파랑 파선)는 모두 발산.*

*[그림] 그림 8-2. x_CoM(t) 히트맵(세로 ε, 가로 시간). 안정 거동은 폭 ±0.1의 좁은 흰 띠이며 ε*_gen 선이 그 정중앙을 관통한다.*

ε 축 위에서 안정의 띠는 폭 ±0.1밖에 되지 않는다. 균형이 얼마나 좁은 길인지, 그리고 공식이 그 길을 얼마나 정확히 짚는지를 이 그림 한 장이 보여 준다.

#### 2. 확장 ② — 접는 데 시간이 걸린다면 (γ)

실제 서보는 순간 접기를 하지 못한다. 접는 시간 T_f 동안에도 불안정 모드는 자란다. 그러므로 항상 더 접어야 한다.

εft*=1+εgen*⋅γx−1,  x=λeffTf,  γ=exBx>1

삼각 가감속 프로파일에서 Bx=4ex/2−12/x2이고, 근사식은 γ≈1+x/2+5x2/48이다.

사람 스케일의 T_f ≈ 0.25초에서 +53%의 과접기가 필요하다. 이것이 “빠른 서보가 필수”라는 요구의 정량적 근거다. 그리고 T_f → 0이면 γ → 1이 되어 순간접기 정리를 정확히 복원한다.

여기서 실물 설계에 결정적인 성질 하나가 나온다. 요구 관절각은 δf*=1+εft*βiJβ−Mth2/μ인데, 관성 상수 μ의 불확실성은 δ_f*에만 들어가고 ε*·γ에는 약분되어 들어가지 않는다. 즉 관성을 정확히 몰라도 접기 비율은 정확하다.

#### 3. 확장 ③ — 펴기를 붙이면 (ε_FWE), 그리고 함정

여기서 우리는 함정을 하나 만났다.

펴기는 접기의 정확한 역벡터다. 그러므로 ε*로 불안정 성분을 정확히 0으로 만든 뒤 펴면, 펴기의 고정 킥이 지웠던 발산 성분을 원래 크기로 되살린다. “정확히 소거하고 나서 편다”는 가장 자연스러운 전략이 정확히 그 이유로 실패한다.

올바른 순서는 과접기 – 대기 – 펴기다. ε*보다 더 접어 불안정 성분을 반대 부호의 잔여로 남기고, 대기 동안 자란 그 잔여가 펴기 킥과 정확히 상쇄되도록 만든다. 조건을 정리하면:

1+εFWE=1+εgen*1−e−λeffTw

이 식에서 대기 시간 Tw는 자유 변수다. 어떤 Tw를 골라도 이 비율로 접으면 불안정 성분은 사이클 끝에서 정확히 0이 된다 — 얼마나 기다릴지를 먼저 정하면, 얼마나 접을지가 따라 나온다. 수치 감각 하나: R = 0.7, Tw=1⋅Tosc면 과접기 잔여는 A0의 겨우 −3%다. “조금 넘어가게 접는다”의 ’조금’이 정량적으로 3%라는 뜻이다.

> “기다림은 빈 시간이 아니라, 일부러 만들어 둔 빚을 갚을 만큼 키우는 시간이었다.”

그렇다면 남은 자유도 Tw는 무엇에 쓰는가 — 안정 성분이다. 접기 킥은 불안정 성분만 심는 것이 아니라 안정 모드 성분도 함께 심는다. 안정 성분은 대기 동안 위상 공간을 회전만 하므로, 한 바퀴 돌아 제자리에 온 순간(Tw=nTosc)에 펴면 펴기 킥이 그것까지 정확히 지운다. 접기·펴기 킥 쌍은 이 대기에서 안정 모드에 대해 ’투명’해진다 — 지수 성장(eλTw≠1)과 원회전(한 바퀴 = 제자리)의 차이를 이용한 모드 선택적 임펄스 쌍이다. 수치로도 사이클 후 진폭의 최솟값이 정확히 Tw=0.995, 1.995 s(Tosc=0.997 s)에서 나타났고, 그때 잔여 진폭은 8 mm — 단일 ε* 접기의 33.5 mm보다도 작다.

FWE의 세 질문에 대한 답이 여기서 모두 닫힌다.

| 질문 | 답 |
| --- | --- |
| 얼마나 접나 | 1+εgen*⋅γλTf / 1−e−λTw |
| 얼마나 기다리나 | 설계자의 선택 — 잔여 진동 최소는 nTosc, 오차 강건성은 짧은 대기 (Ⅸ-4) |
| 어떻게 펴나 | 빠르게 (같은 프로파일의 역재생이면 충분) |

[그림] 그림 8-3. 사이클 장부. 할인 좌표 Ã = A·e^{−λt}로 보면 접기·펴기는 명목이 같고 부호가 반대인 두 지불 — 순현재가치 마진 (1−e^{−λT_w})이 초기 부채 −A₀를 갚는다.

[그림] 그림 8-4. T_w에 따른 사이클 후 x_CoM 진폭(파랑)과 요구 접기각 δ_f(빨강 파선). 진폭 최솟값이 안정주기의 정수배에서 나타난다.

#### 4. 통일 — 마스터 전파법칙

확장 ②와 ③을 각각 따로 다루다 보니 접기와 펴기를 서로 다른 식으로 취급하고 있었다. 이를 하나로 묶었다. 순간동작 가정을 완전히 걷어내고, 접기와 펴기를 모두 임의 상태·유한시간으로 다루는 단일 법칙이다.

AT=eλTA0−12κ2μδT+δTλ+λ0TeλT−sδs ds−eλTδ0+δ0λ

접기(δ: 0→δ_f)와 펴기(δ: δ_f→0)는 이 한 식의 두 사례다.

이 통일에서 접기/펴기의 비대칭이 깨끗이 분해된다. 동작 킥은 부호가 반대(−B vs +B, 역학적 대칭)이지만, 시간 이자 eλT와 B(x) > 1의 성장은 둘 다 같은 방향이다. 즉 “시간이 걸리는 손해”는 접기와 펴기가 공유한다 — 그래서 펴기는 접기의 단순한 역(−γ)이 아니다. “펴기는 빠르게”라는 처방이 여기서 정량적으로 정당화된다.

유한시간 완전 사이클의 요구 접기각도 닫힌형으로 나온다.

δf*=exf+xw+xeA0kexe+xwBxf−Bxe

검증: 단일모드 ODE 정밀적분과 ~10⁻⁸ 일치, 결합 (φ, β) 수치적분의 root-find와 0.000% 일치(R=0.7, T_f=T_e=0.15 s, T_w=1·T_osc에서 δ_f* = 34.37°).

[그림] 그림 8-5. (β, φ) 상태공간의 유한시간 완전 사이클: 접기(빨강)–대기(파랑)–펴기(주황), 순간접기 텔레포트(회색 화살표), 사이클 후 유계 진동(보라).

#### 5. 확장 ④ — 오차가 있다면 (반복 FEW)

여기까지의 이론은 한 번의 완벽한 동작을 전제한다. 그런데 단발 FWE에는 치명적 취약점이 있다.

대기 구간이 접기 오차를 eλTw배로 증폭한다. 사람 스케일에서 대기가 안정주기 한 박자면 최대 34배, R = 1.0이면 151배다. 접기가 1% 틀리면 사이클 끝에서 34% 틀린다.

해법은 구조를 바꾸는 것이었다. 대기를 접기–펴기 사이(증폭 구간)에서 빼서 사이클 바깥(재측정 구간)으로 옮기고, 매 사이클 끝에서 위험도를 다시 재서 비례로 접는다. 한 번에 완벽하게 하려 하지 말고, 매번 다시 재고 다시 접는 것이다.

한 사이클의 A 변환은 마스터 전파법칙에서 아핀 맵으로 닫힌다(ODE와 0.00% 일치).

A+=G A−−g δf,  G=e2λTh, g=k BλTheλTh−1

처방은 δf=ρ γ A, γ≡G/g이고, 그 결과 A+=G1−ρA−가 된다. 수렴 조건은 G1−ρ<1이다.

> ⚠표기 통일 규약(보고서 전체). 원자료 문서들이 γ를 두 가지로 쓰고 있다(03번 문서는 γ=ρG/g, 09번 문서는 γ=G/g). 이 보고서는 후자로 통일한다 — γ는 시스템이 정하는 순수 환율이고, ρ는 그 위에 곱하는 설계자의 선택이다(Ⅹ-7). 그래야 “γ는 측정, ρ는 튜닝”이라는 구분이 성립한다.

여기서 두 항의 물리적 의미가 분명하다.

G = “기다림의 비용” — 사이클을 도는 동안 위험이 불어나는 배수

g = “접기의 효력” — 1라디안 접을 때 위험이 깎이는 양

γ = G/g = “환율” — 위험 1도를 지우려면 몇 도를 접어야 하는가

ρ = “공격성” — 매 사이클 위험의 몇 %를 지우려 시도하는가

로버스트니스 분석은 흥미로운 갈림을 보여 준다. 계통 오차(모터 상수·질량 편향)에는 정확 deadbeat ρ = 1이 최적이고(대칭 ±37% 마진), 랜덤 오차(서보 노이즈)에는 ρ ≈ 0.8이 최적이다. 결론은 ρ ∈ [0.8, 1.0]이며, 과대접기(ρ > 1.1)는 두 기준 모두에서 손해다.

그리고 이 구조는 이전 이론을 버리지 않는다. deadbeat 게인 γdead=G/g는 곧 유한시간 완전 사이클의 εFWE다.

> “반복 FEW는 ε* 이론의 대체가 아니라 폐루프적 완성이다.”

포획영역도 계산된다. 유한한 접기량으로 회복 가능한 범위는 gδf,max/G−1이며, 사람 스케일·δ_max 55°에서 β ≈ 3°다. 그보다 큰 외란은 큰 단발 캐치가 먼저 필요하다(하이브리드 전략 — 미완 과제).

덧붙여 둘 것이 하나 있다. 큰 외란을 나눠 잡을 때 ’조금씩 여러 번’은 선택지가 아니다 — 수렴 조건 ρ>1−1/G가 매 사이클의 최소 소거량을 강제하기 때문이다. 올바른 분할은 접기량에 캡을 걸고 매번 거의-완전소거로 반복하는 것이고, 그 캡의 기준은 관절 한계가 아니라 γ의 유효범위(캘리브레이션한 접기량 근처)다. 범위 밖의 큰 접기는 γ가 틀린 줄 모르고 내는 큰 명령이 된다.

[그림] 그림 8-6. 반복 FEW의 (β, φ) 궤적·시계열·강건성 비교. 접기 +20% 오차에도 반복은 수렴, 단발 FWE는 발산.

[그림] 그림 8-7. 로버스트니스 vs ρ. (좌) 계통 오차 견딤 — ρ=1 최대. (우) 랜덤 오차 생존율 — ρ≈0.8 최대.

#### 6. 위계는 스스로를 검사한다

이 다섯 층의 공식은 서로 독립된 다섯 개가 아니다. 각 단계가 상위 단계의 극한으로 정확히 환원된다.

| 극한 | 환원 결과 | 확인 |
| --- | --- | --- |
| T_f → 0 | γ → 1, ε*_ft → ε*_gen | 기계정밀도 |
| 속도 → 0 | ε*_gen → ε* | 차이 10⁻¹⁵ |
| T_w → ∞ | ε_FWE → ε*_ft | 수치 확인 |
| ρ = 1 | 반복 FEW의 deadbeat = ε_FWE | 해석적 일치 |
| 순수 안정모드 입력 | ε*_gen = −1 (“무개입”) | 자기일관성 |

> “우리가 공식을 믿게 된 것은 그것이 맞아떨어져서가 아니라, 틀릴 기회를 여러 번 주었는데도 틀리지 않았기 때문이다.”

Ⅷ장의 결론: 이상적인 조건 넷을 모두 걷어냈다. 이제 이론은 움직이는 상태에서, 유한한 시간에, 펴기까지 포함해서, 오차가 있어도 작동한다. 선형·무질량 줄 가정 안에서 이론은 완결이다.

### 8. 그림자와 실체 — 예측점 평면

#### 1. (β, φ) 평면은 4차원의 그림자다

(β, φ) 평면 위의 점이 안정모드선 위에 있다고 해서 균형인 것은 아니다. 진짜 상태는 4차원 — 위치 (φ, β)와 속도 (φ̇, β̇) — 이고, (β, φ) 평면은 그 사영(그림자)이라 속도가 숨는다. 원위치 점이 직선 위에 있어도 속도가 어긋나 있으면 곧 발산한다. 실제로 속도를 무시한 대조군은 MuJoCo에서 0.7~1.1초 만에 낙하했다.

#### 2. 예측점 — 속도를 위치로 환산해 더한다

해법은 같은 평면에 원위치 대신 예측점을 찍는 것이다.

> q_pred = q + q̇ / λ_eff

속도를 불안정 모드의 시정수 λ로 나눠 “유효 거리”로 환산해 더한 점이다. 처음의 직관은 “속도가 있으면 일정 시간 뒤 위치를 예측해 그만큼 더 접자”였는데, 모드 대수로 정리하면 이 직관이 근사가 아니라 정확해진다. 불안정 좌고유벡터 u₂에 대해

> u₂ᵀ · q_pred = 2A ⟹ 「예측점이 안정선 위 ⇔ A = 0」

이고, 직선에서 벗어난 수직 거리가 곧 2A/‖u₂‖ — “지금 얼마나 넘어지는 중인가”가 그림 위의 길이가 된다. 임의의 4차원 상태에서 ε*_gen 접기 후 |A| ~ 10⁻¹⁷ 이 확인되어, 이것이 근사가 아닌 정확한 모드 대수임이 증명되었다.

그림 4-1. 원위치 평면(왼쪽)과 예측점 평면(오른쪽) — 같은 유한시간 완전 사이클. 왼쪽에서는 궤적이 직선을 넘나들어도 안정 판정이 아니지만, 오른쪽에서는 Extend(금색)가 직선 위에 착지하고 post-cycle(보라)이 직선을 따라 미끄러진다. 회색 사선이 무게중심 등고선.

#### 3. S1 — 접기 한 번으로 영원히 유계 (뒤에 올 이야기의 복선)

예측점 평면 위에서 가장 단순한 장면이 S1이다. 정지 상태(β = 2°)에서 ε* = 1.834 만큼 한 번 접고 그대로 두면, 상태는 등고선을 따라 점프해 안정모드선 위에 착지하고(|A| = 7×10⁻¹⁸), 이후 펴지 않아도 그 직선을 따라 영원히 유계 진동한다.

이 정리는 유도 당시에는 “펴기는 균형이 아니라 자세 회복용”이라는 각주 취급이었다. 그러나 Ⅴ장에서 이 정리가 실전 제어기의 이론적 뿌리로 승격된다 — 접기만으로 균형이 닫힌다면, 펴기를 생략한 제어가 가능하다는 뜻이기 때문이다.

그림 4-2. S1 순간 단일접기 — (좌) 예측점 평면에서 접기 한 번(빨강, 등고선을 따라)으로 안정모드선에 착지, 이후 직선 위를 영원히 미끄러진다(보라). (우) 시계열 — δ는 접힌 채 유지(파선), β·φ는 유계 진동.

#### 4. 회전 좌표 (s, n) — 이탈거리를 축으로 만들기

예측점 평면의 궤적은 안정모드선 방향으로 눌려 겹쳐 보이는 약점이 있다. 그래서 좌표를 안정모드선 기준으로 회전하고 수직 방향을 확대한 (s, n) 좌표를 도입했다.

n축 (수직·불안정): 안정선과의 수직 이탈거리 2A/‖u₂‖. n = 0이면 포획. 4상태의 선형결합 n = +0.427φ +0.904β +0.121φ̇ +0.256β̇ (deg, deg/s 단위).

s축 (수평·안정): 안정모드선 방향 좌표 — 유계 진동의 진폭.

이 좌표에서 완전 사이클이 문자 그대로 읽힌다. Fold(빨강)가 라인을 넘어가고(과접기), Wait(파랑) 동안 n = 2A·e^(λt) 로 라인에서 이탈하고, Extend(금색)가 라인으로 복귀시키고, post-cycle(보라)은 n ≈ 0 위에 머문다.

그림 4-3. (좌) 기존 예측점 평면 — 곡선들이 안정라인 방향으로 눌려 겹쳐 보임. (우) 안정라인 기준 회전 + 수직 확대(약 7배) — Fold의 과접기, Wait의 지수 이탈, Extend의 복귀, 점선(단발 ε* 접기)의 ’항상 라인 위’가 분리되어 보인다.

#### 5. 다섯 장면 — 이론 전체가 한 평면 위에

이 평면 위에 FWE의 다섯 시나리오를 그리면 공식 위계 전체가 그림으로 읽힌다. Ⅴ장의 진화사가 참조할 기준표다.

표 4-1. 예측점 평면 시나리오 수치 요약 (R = 0.7, β_i = 2°)

| 시나리오 | 접기각 δ_f | 접기비율 | 착지 |A| | 비고 |
| --- | --- | --- | --- | --- |
| S1 순간 단일접기 | 26.1° | ε* = 1.834 | 7×10⁻¹⁸ | 펴지 않아도 유계 (그림 4-2) |
| S2 순간 완전사이클 | 26.8° | ε_FWE = 1.919 | 7×10⁻¹⁵ | 닫힌형과 0.00% 일치 |
| S3 유한시간 접기 | 39.9° | γ = 1.531 | 9×10⁻¹¹ | T_f = 0.25 s, 순간 대비 +53% |
| S4 유한시간 완전사이클 | 34.4° | — | 6×10⁻⁸ | T_f = T_e = 0.15 s, T_w = 1·T_osc |
| S5 반복 (+5% 오차) | 사이클마다 재계산 | — | 재포획 | 루프이득 0.24 유계 vs 58 발산 |

### 9. 메커니즘의 진화 — FWE에서 FFFF까지

#### 0. 한눈 연표

| 세대 | 박자 | 시기 | 전환을 강제한 문제 | 핵심 산출물 |
| --- | --- | --- | --- | --- |
| v1 FWE | 접–대기–펴 | ~6/12 | “정확소거 후 펴기”의 실패 | 과접기 공식 ε_FWE, T_w = nT_osc |
| v1.5 FWEW | 접–대기–펴–대기₂ | 6/21 | 유한시간에서 T_f 고정 시 자유도 부족 | 마스터 전파법칙, δ_f* 닫힌형 |
| v2 FEFE (반복 FEW) | (접–펴)–재측정–(접–펴)–… | 7/01 | 대기가 오차를 최대 34배 증폭 | 사이클 지도 A⁺ = G·A⁻ − g·δf |
| v3 FFFF (비동기 FWE) | 접–접–접–접 (+배경 복귀) | 8/01 | 실측 줄 마찰에서 완전 사이클 계열 붕괴 | 증분 접기 + 저속 복귀, 120초 만점 |

#### 1. v1 FWE — 완전 사이클과 첫 번째 함정

메커니즘의 출발형은 접고–기다리고–편다였다. 그런데 사이클을 수식으로 닫는 과정에서 함정을 만났다.

펴기는 접기의 정확한 역벡터다. 그러므로 ε*로 불안정 성분을 정확히 0으로 만든 뒤 펴면, 펴기의 고정 킥이 지웠던 발산 성분을 원래 크기로 되살린다. “정확히 소거하고 나서 편다”는 가장 자연스러운 전략이 정확히 그 이유로 실패한다.

올바른 순서는 과접기–대기–펴기다. ① ε*보다 더 접어 A를 반대 부호의 잔여로 남기고, ② 그 잔여가 e^(λT_w)로 자라기를 기다렸다가, ③ 잔여가 펴기 킥과 정확히 같아지는 순간 편다. 닫힌형은

> **1 + ε_FWE = (1 + ε*_gen) / (1 − e^(−λT_w))**

이고, 대기 T_w를 안정주기의 정수배(nT_osc)로 두면 접기 킥이 심은 안정 모드 성분까지 펴기가 함께 지운다(수치로도 사이클 후 진폭 최솟값이 정확히 T_w = 0.995, 1.995 s에서 나타남 — 잔여 8 mm, 단일 접기의 33.5 mm보다 작다). 예측점 평면의 S2가 이 장면이다.

주의 — 인과의 방향(8/1 정정). “잔여가 킥과 같아지는 순간 편다”는 서술은 인과가 뒤집혀 있다. 불안정 소거 조건은 어떤 T_w에서도 성립한다 — T_w는 자유 변수이고, 정하면 접기량이 따라온다. nT_osc는 그 자유도를 안정 성분 소거에 쓰는 선택일 뿐이다. 이 자유도의 재해석이 뒤의 진화를 예고한다.

#### 2. v1.5 FWEW — 유한시간이 요구한 네 번째 박자

실제 서보는 순간 동작을 못 한다. 접는 시간 T_f 동안에도 불안정 모드가 자라므로 항상 더 접어야 하고(γ 보정, T_f = 0.25 s에서 +53%), 접기·펴기를 임의 상태·유한시간으로 통일하는 마스터 전파법칙이 세워졌다(수치적분과 0.000% 일치, S4의 δ_f* = 34.37°).

이 유한시간 세계에서 하드웨어 사정상 T_f를 상수로 고정하면 수학적 자유도가 하나 부족해진다. 이를 보완한 것이 네 번째 박자 Wait₂를 추가한 4단계 확장 — 접고–기다리고–펴고–다시 기다리는 FWEW다. 컨설팅에서 언급된 “접고 기다리고 펴고 기다리고”가 이 세대다. FWEW는 독립 세대라기보다 유한시간 완전 사이클의 자유도 보완형이며, 마스터 전파법칙 안에서 한 사례로 흡수된다.

#### 3. v2 FEFE — 대기의 배신과 반복 피드백

여기까지의 이론은 한 번의 완벽한 동작을 전제한다. 그런데 단발 완전 사이클에는 치명적 약점이 있었다.

대기 구간이 접기 오차를 e^(λT_w)배로 증폭한다. 사람 스케일에서 대기가 안정주기 한 박자면 최대 34배(R = 1.0이면 151배). 접기가 1% 틀리면 사이클 끝에서 34% 틀린다. T_w = nT_osc의 아름다움(잔여 진동 최소)과 오차 강건성(짧은 대기 요구)이 서로 다른 답을 가리킨 것이다 — S5의 두 스케줄 비교(루프이득 0.24 유계 vs 58 발산)가 이 긴장의 실증이다.

해법은 박자의 재배열이었다. 대기를 접기–펴기 사이(증폭 구간)에서 빼서 사이클 바깥(재측정 구간)으로 옮긴다. 그러면 동작은 접고–펴고, 밖에서 기다리며 위험도 A를 다시 재고, 다시 접고–펴고 — 즉 F–E–F–E의 반복이 된다. 컨설팅의 “접고 펴고 기다린다”가 이 세대다. 한 사이클의 A 변환은 아핀 맵으로 닫히고(ODE와 0.00% 일치),

> A⁺ = G·A⁻ − g·δf, δf = ρ·γ·A, γ = G/g ⇒ A⁺ = G(1−ρ)·A⁻

수렴 조건은 |G(1−ρ)| < 1이다. G는 기다림의 비용, g는 접기의 효력, γ는 환율(위험 1도당 접기 몇 도), ρ는 공격성(매 사이클 몇 %를 지울 것인가). 로버스트니스 분석의 결론은 ρ ∈ [0.8, 1.0] — 계통 오차에는 deadbeat ρ = 1(±37% 마진), 랜덤 오차에는 ρ ≈ 0.8이 최적이고 과대접기(ρ > 1.1)는 양쪽 모두 손해다. 그리고 deadbeat 게인 γ_dead = G/g는 곧 완전 사이클의 ε_FWE — 반복 FEW는 ε* 이론의 대체가 아니라 폐루프적 완성이다. 접기 +20% 오차에도 반복은 수렴하고 단발은 발산한다.

#### 4. v3 FFFF — 실측이 부수고, 여담이 답이 되다

##### 4.1 전환을 강제한 실측 (8/1)

실물 조립 후 줄 마찰을 실측해(점성 3.3×10⁻⁴, 쿨롱 3.1×10⁻⁴ N·m·s/rad) 시뮬레이션에 반영하자, 전류모드 계열의 생존 중앙값이 26.8 → 10.4초로 붕괴했다. 옛 가정의 줄 소산이 “사이클 후 잔여 진동의 청소부” 역할을 맡고 있었는데 실제 줄은 그만큼 소산하지 않았던 것이다. (위치모드 챔피언은 둔감했다 — 49.3 vs 44.7초. 뻣뻣한 유지 강성이 청소를 대신한다.)

동시에 산술 하나가 눈에 들어왔다. 사이클이 길수록 기다림의 비용 G가 지수로 커지고, ρ의 허용창 (1−1/G, 1+1/G)이 좁아진다. 위치모드 완전 사이클의 G ≈ 15.8은 허용창 ±6% — 환산비가 6%만 어긋나도 발산하는 좁은 길이다. 사이클을 줄이는 것 자체가 오차 관대함을 넓힌다.

##### 4.2 펴기를 생략하다 — 증분 접기 + 저속 복귀

그래서 펴기 자체를 제거한 제어를 시험했다. 규칙은 두 줄뿐이다.

위험도가 문턱(0.6°)을 넘으면, 현재 유지각에서 증분 접기 Δδ = ρ·γ_h·A 만 수행한다. 펴지 않는다.

위험도가 문턱의 절반 아래이고 유지각이 1° 이상이면, 3°/s로 천천히 0을 향해 복귀한다.

동작만 보면 접고–접고–접고–접고 — 컨설팅의 FFFF다. 사이클(이동+휴지 ≈ 0.17초)이 절반 이하로 줄어 기다림 비용이 G ≈ 15.8 → 2.7로 떨어지고, 허용창이 ±6% → ±37%로 6배 넓어진다. 그래서 노브 학습 없이 고정 환산비로도 산다.

결과 (v19_sim, 초기 0.5°±0.03° 20케이스, 상한 120초):

| 조건 | 제어 | 중앙값 | 최소 | 10초 미만 |
| --- | --- | --- | --- | --- |
| 위치모드 챔피언 (완전 사이클, 노브 학습) | 접–대기–펴 | 49.3 s | 34.6 | 0/20 |
| 펴기 생략, γ_h = 8 | 증분 접기 + 복귀 3°/s | 120 s (상한) | 80.1 | 0/20 |
| 펴기 생략, γ_h = 15 | 〃 | 120 s (상한) | 120 | 0/20 (전 케이스 만점) |
| 펴기 생략, γ_h = 22 | 〃 | 55.2 s | 5.7 | 1/20 |

γ_h = 15에서 20케이스 전원 만점, γ_h = 8도 최악 케이스가 완전 사이클 챔피언의 최고 기록(77.5초)보다 길다. γ_h가 2배 가까이 어긋나도(고원 8~15) 산다. 상한을 올린 후속 실험에서는 2400초 균형까지 확인되었다(8/4 컨설팅 보고 기준).

##### 4.3 이론적 뿌리 — S1의 승격

이 설계는 임기응변이 아니다. 뿌리는 Ⅳ-3의 S1 정리 — “ε*로 접으면 펴지 않아도 영원히 유계” — 다. 유도 당시 관상용 각주였던 이 정리가 실전 제어기의 이론적 근거로 승격되었다. “펴기(E)는 균형이 아니라 자세 회복용”이라는 문장이 제어 구조 그 자체가 된 것이다.

##### 4.4 새 설계 규칙 — 복귀에는 속도 상한이 있다

저속 복귀는 아주 느린 펴기이므로 그 자체가 불안정 성분을 연속 주입한다. 주입이 트리거 재발동을 일으키지 않을 상한이 물리로 정해진다.

> v_복귀 < λ·A_여유 / 킥계수 ≈ 6°/s (이 로봇 눈금)

실제로 45°/s로 되돌리면 복귀가 만든 위험도만으로 초당 수 회 재트리거되는 자기교란이 되었고(실측), 3°/s에서는 유지각이 33~41° 안에 머물며 포화가 없었다. 광대가 큰 회복 뒤 벌떡 일어서지 않고 천천히 몸을 세우는 것이 미학이 아니라 물리적 강제일 가능성 — 광대 영상에서 회복 각속도를 측정하면 검증할 수 있는 예측으로 남긴다.

##### 4.5 검증과 지위 — “이론 검증”이 아니라 “시뮬 발견”

세 가지 대조 검증을 수행했다. ① 접기를 끄면 0.84초 낙하(제어가 실제로 일하고 있음), ② 120초 동안 581회 연속 발동(문턱 사건 구동임의 확인), ③ ρ 3단의 수축률 실측 0.23·0.52·0.92가 수렴 조건과 대응.

다만 정직하게 기록할 것 — 이 레짐의 실체는 소각 근사 밖이다(몸 기울기가 시간의 49%에서 5° 초과, 최대 18.8°, 유지각 ±33°). 전물리 엔진 안의 정당한 물리이지만, 선형 이론의 검증이 아니라 시뮬레이션 발견으로 분류한다. 실물 관문은 셋 — 결합부 7 Hz 탄성 × 초당 5회 듀티, 기구 가동범위, 트리거 문턱 대 추정 잡음.

#### 5. 최종 해석 — 순서가 사라지고 세 역할이 남았다

이 제어에는 접기와 펴기의 구분이 없다. 증분의 부호가 그때그때 위험도를 따를 뿐이다. 그러면 FWE는 폐기되었는가? 아니다 — 순차가 사라지고 세 역할이 남았다.

|  | 원래 (순차) | 지금 (동시) |
| --- | --- | --- |
| F 접기 | 사이클의 1단계, 크게 한 번 | 사건 — 문턱을 넘을 때마다 증분으로 |
| W 기다리기 | 접은 채 정해진 시간 대기 | 기본 상태 — 문턱 아래에서는 개입하지 않음 |
| E 펴기 | 사이클의 3단계, 빠르게 | 배경 과정 — 한가할 때 저속 복귀 (속도 상한은 물리가 결정) |

이것을 비동기 FWE라 부른다. 이 관점은 FWE와 LQR의 관계도 다시 정리한다 — 둘은 별개 제어기가 아니라 ‘개입 간격’ 축의 양 끝이다. 간격을 늘리면 이산적인 접기–대기–펴기가 되고, 줄이면 연속 상태 피드백(LQR)에 수렴한다. 비동기 FWE의 간격 ~0.2초는 공교롭게도 사람의 반응 지연 눈금이다.

마지막으로, 관찰과의 수렴. 외란을 맞은 광대는 크게 한 번 접고, 미세조정을 거듭하며, 천천히 몸을 세운다 — 큰 첫 캐치(문턱 밖), 증분 재포획(문턱 사건), 저속 복귀(배경 과정).

> “물리로 지어낸 가설이 몸의 지혜를 두 번째로 재발견했다 — 이번에는 접기량이 아니라, 회복의 방식에서.”

### 10. 시뮬레이션의 발전

파올레티 논문을 재현한 모델(v1), LQR 적용 모델(v10), 물리 엔진(MuJoCo) 검증(v14), 초기 FWE 구현(v15)부터 실측 기반 전물리 시뮬레이션(v19)까지 순차적으로 제작하며 각 단계의 이론을 검증하였다. v19는 실제 로봇의 무게중심·관성모멘트·줄 마찰과 서보·센서의 한계까지 반영한 전물리 시뮬레이션으로, 그 실측 반영이 Ⅳ-7의 최종 진화를 이끌었다.

시각자료 (4.8 시뮬레이션 발전 과정 — v1, v10, v14, v15, v19 화면 / 생존 시간 분포 그래프)

### 11. 줄타기 로봇 ‘어름이’ — 실물 부분 검증

실물 검증 경과 (2026. 8. 7 기준) 세 엔코더로 넘어짐의 방향과 각도를 인지하고 접기 반응이 정상적으로 나오는 것을 확인한 뒤, 증분 접기 제어기를 이식하여 줄 위 폐루프 시험에 들어갔다. 첫날의 시험은 문제의 판별과 수정의 연속이었다 — 센서 잡음으로 인한 판정 불가, 엔코더 영점 편향, 발목 엔코더 배선 고장 등을 판마다 하나씩 잡아냈고, 배선 수리 후 첫 폐루프 생존 기록을 얻었다: 최고 12.8초(수동 개입 포함), 자율 최고 4.75초. 아직 시뮬레이션과는 다른 운전 형태(큰 각도의 시소 운전)가 나타나는 등 개선할 지점이 남아 있으며, 균형 시작 시 로봇을 수직으로 잡아 줄 거치 장치의 필요성도 확인하였다. 실물 검증은 현재 진행 중이다.

## Ⅲ. 결론 및 향후 탐구 계획

우리 연구의 핵심은 다음 두 가지로 정리할 수 있다.

한국 줄타기의 균형 원리를 검증 가능한 물리 가설로 최초 제시하였다. 광대를 처진 줄 진자 위의 이중 역진자로 모델링하고, 처진 줄이 발의 위치를 무게중심을 되돌리는 복원력으로 바꿔 주는 변환기임을 밝혔다. 이로부터 “허리 접기의 반작용으로 발을 무게중심 너머로 던져 중력 토크를 반전시킨다”는 균형의 인과 사슬을 규명하고, 필요한 접기량을 미적분 없는 1차식의 해석해 ε* = −h/(r·R + h)로 유도하였다. 이 공식이 초기 기울기와 무관하다는 사실은 광대가 눈대중으로 줄을 탈 수 있는 이유를, “접으면 펴지 않아도 유계”라는 함의는 최종 제어기인 증분 접기를 설명한다. 서양의 줄타기가 외부 토크(장대)로 몸을 세운다면, 한국의 줄타기는 시스템의 안정 모드로 상태를 찾아 들어가게 한다 — 모터는 상태를 옮길 뿐, 복원은 자연의 진동에 맡기는 것이다. 기존 연구가 “제어기로 잡을 수 있다”는 가능성까지만 보였다면, 본 탐구는 어떤 물리 과정으로 균형이 회복되는지를 처음으로 답하였다.

가설의 수립과 기각, 층위를 구분한 검증으로 탐구의 전 과정을 스스로 수행하였다. 선행 연구가 없는 문제에서 분리 가설을 스스로 세우고, 질량 행렬의 비대각 성분을 근거로 스스로 기각하며 결합 모델에 도달하였다. LQR로 균형을 잡고도 “이것은 설명이 아니다”라며 스스로 기각하고 우리만의 메커니즘을 세웠으며, 균형의 정의를 후보 소거로 직접 재정의하는 과정에서 모드 해석이라는 도구의 필요성을 추론으로부터 이끌어냈다. 메커니즘은 네 번 모습을 바꾸었지만 매 전환은 문제가 강제한 것이었다. 유도한 공식은 수식과 전물리 시뮬레이션으로 ±2% 이내까지 검증하였고, 실물 로봇으로는 폐루프 접기 반응과 초 단위 생존까지의 부분 실증을 확인하였으며, 이론 검증과 시뮬레이션 발견, 실물 실증의 층위를 구분하여 정직하게 서술하였다. 답뿐 아니라 질문과 판단과 검증의 책임까지 스스로 감당한 것에 이 탐구의 방법론적 의의가 있다.

#### 2. 한계 및 향후 계획

본 탐구의 이론은 선형·소각 근사 안에서 완결되었으나, 실측 마찰 세계의 균형은 그 근사 밖의 거친 형태로 나타났고, 실물 로봇의 폐루프 생존은 아직 초 단위이다. 향후 과제는 다음과 같다. 첫째, 실물 로봇의 증분 접기 제어를 개선하여 시뮬레이션 수준의 생존을 재현한다. 둘째, 본 탐구의 메커니즘은 광대에게 배운 것이 아니라 물리에서 유도된 것이므로, 실제 광대의 동작 영상을 분석하여 검증하는 일이 남아 있다 — 특히 “회복 후 몸을 세우는 속도에는 물리적 상한이 있다”는 본 이론의 예측은 영상 측정으로 확인 가능하다.

## Ⅳ. 참고 문헌

Paoletti, P. & Mahadevan, L. (2012). Balancing on tightropes and slacklines. Journal of the Royal Society Interface, 【권·호·쪽 확정】.

【고려대 한국 줄타기 동작 35가지 분류 연구 — 저자·연도·서지 확정】

【국가무형문화재 제58호 줄타기 기록물 — 서지 확정】

【그 외 인용 자료 — 확정 후 기입】
