cbshbalance/slackline-balacing1/work/학생보고서_공동집필_20260810/학생보고서_원문병합본_출처표시.md

# 한국 줄타기는 어떻게 장대 없이 균형을 잡는가?

## 처진 줄 진자 위 이중 역진자가 허리 접기 하나로 서는 원리의 규명과 로봇 실증

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

## Ⅰ. 탐구 동기 및 목적

### 1. 탐구 동기

#### 가. 문제 의식 — 서양 줄타기와 한국 줄타기

<!-- 원문 출처: 학생 최신 보고서, 문단 122–128 -->

한국의 전통 줄타기 영상을 관찰하면서 가장 먼저 직관적인 의문이 들었다.

“장대도 없이 느슨한 줄 위에서 어찌 저렇게 이리저리 움직이며 균형을 잘 잡을 수 있을까?”

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

그림  서양 줄타기: 긴 장대를 활용하여 외력을 생성하고 무게중심을 제어하는 구조

그림  한국 전통 줄타기: 장대 없이 부채만을 들고 느슨한 줄 위에서 역동적인 동작을 수행하는 모습

#### 나. 얼음판 위의 사고실험 — 이건 불가능한 일이다

<!-- 원문 출처: 이론부 초안 v3, 문단 17–22 -->

질문이 소박한 데 비해, 물리 수업에서 배운 것을 대입하자 사태는 훨씬 심각해졌다.

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

그런데 광대는 떨어지지 않는다.

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

> “불가능해 보이는 일이 실제로 일어나고 있다면, 그 안에 우리가 아직 모르는 물리가 있다는 뜻이다.”

#### 다. 역발상

<!-- 원문 출처: 학생 최신 보고서, 문단 130–132 -->

그러나 우리는 이 관점을 완전히 뒤집는 역발상에서 탐구를 시작하였다.

“어려워 보이는 한국 줄타기의 요란한 몸동작들이, 방해 요소가 아니라 오히려 균형잡기를 더욱 쉽게 만드는 움직임이 아닐까?”

위와 같은 질문을 시작으로, 한국 줄타기가 장대 없이 균형을 잡는 메커니즘 규명을 위한 탐구를 시작하였다.

<!-- 원문 출처: 선생님 동기 메모, ‘몸을 세우는 대신 줄을 끌어오면 된다’ -->

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

> “몸을 세우는 대신 줄을 끌어오면 된다.”

### 2. 탐구 목적

#### 가. 장대 없는 한국 줄타기의 균형 회복 원리를 물리 법칙으로 규명

<!-- 원문 출처: 학생 최신 보고서, 문단 135 -->

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

#### 나. 원리를 수학적으로 유도하고 물리 엔진 시뮬레이션으로 검증

<!-- 원문 출처: 학생 최신 보고서, 문단 137 -->

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

#### 다. 자체 제작한 줄타기 로봇으로 실물 실증

<!-- 원문 출처: 학생 최신 보고서, 문단 139 -->

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

## Ⅱ. 탐구 과정

### 1. 문헌 조사 — 찾은 것은 답이 아니라 공백이었다

<!-- 원문 출처: 이론부 초안 v3, 문단 24–30 -->

답을 찾으러 자료부터 뒤졌다. 조사할수록 이상했다.

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

### 2. 첫 번째 열쇠 — 처진 줄은 받침이 아니라 변환기다

<!-- 원문 출처: 이론부 초안 v3, 문단 33–69 -->

#### 1. 결정적 관찰 — 발이 줄과 함께 흔들린다

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

R=L/22−D/22

원호 위를 흔들리는 물체 — 그것은 정진자다. 가운데로 되돌아오려는, 안정한 진자.

#### 2. 얼음판과 줄의 차이

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

이것을 무게중심에 대한 운동방정식으로 쓰면 놀랍도록 깨끗한 한 줄이 된다. 무질량 줄은 줄 방향의 힘만 전달하므로,

xCoM=−g φt  (무게중심 보존법칙)

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

#### 3. 그렇다면 발은 무엇으로 옮기는가 — 모델의 정의

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

원호 위의 발(발목은 자유 회전) + 하체 막대 + 허리 관절(모터 1개) + 상체 막대

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

우리가 직접 명령할 수 있는 것은 하나: 허리 접힘각 δ = θ − α, 입력은 힙 토크 τ

자유도 3, 입력 1. 제어가 어렵기로 유명한 저구동(underactuated) 시스템이다.

소각 선형화한 운동방정식은 다음과 같다(라그랑주 역학, 기호 검증 완료).

Mq=Gq+Eτ,  q=φ,α,θT, E=0, −1, +1T

M=MtR2Rp1Rp2Rp1JααJαθRp2JαθJθθ,  G=diag−MtgR, p1g, p2g

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

#### 4. 좌표를 물리가 단순해지는 축으로 갈아타기

(φ, α, θ)는 측정하기는 좋지만 의미를 읽기에는 나쁘다. 그래서 물리적 의미가 분명한 좌표로 바꿨다.

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

접힘각 δ=θ−α — 우리가 명령하는 자세 변수

이 좌표에서 무게중심의 수평 위치가 한 줄로 정리된다.

xCoM=Rφ+hβ  (h=직립 무게중심 높이)

줄이 발을 옮긴 거리 + 몸이 기운 효과. 이 한 줄이 이 연구 전체의 뼈대다.

이 좌표는 세 가지 좋은 성질을 갖는다(전부 기호 검증 완료).

① 토크는 δ에만 작용한다 — 서보가 δ를 추종하는 한, τ의 세부는 (φ, β) 동역학에 들어오지 않는다.

② 접기 각가속도 δ̈가 (φ, β)로 들어오는 문은 단 하나 — β행의 관성항 μ 하나뿐이다.

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

표 2-1. 사람 스케일 형상 파라미터 (이론·MuJoCo 검증 기준)

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

### 3. 이야기에 필요한 세 개의 도구

<!-- 원문 출처: 이론부 초안 v3, 문단 73–83 -->

#### 1. 정진자와 역진자 — 그리고 두 개의 시계

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

두 진자는 각자의 시계를 갖는다.

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

#### 2. 저구동 — 문이 하나뿐인 방

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

#### 3. 연립 진동과 모드 — 씨앗 하나

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

### 4. 답을 지어내다 — FWE 메커니즘의 제안

<!-- 원문 출처: 이론부 초안 v3, 문단 88–116 -->

#### 1. 접기의 직접 효과와 진짜 효과 (5월 8일)

허리 토크의 구조를 뜯어 보다가 첫 통찰이 나왔다.

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

> “허리 토크의 직접적 효과는 ’몸을 접는 것’이지만, 물리적으로 의미 있는 효과는 ’발을 옮기는 것’이다.”

간접 경로의 정체가 드러났다: 허리 → 하체 반작용 → 발 이동 → 줄의 복원력 변화 → 몸 전체.

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

#### 2. 첫 가설 — 접어서 세운다

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

#### 3. 자기 기각 — 세우는 게 아니라 반대로 쓰러뜨린다 (5월 11일) ★

사흘 뒤 토론에서 우리는 이 그림을 우리 손으로 뒤집었다.

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

일부러 반대로 넘어지게 만들어 놓고 기다리는 이 그림은 처음엔 불안해 보였다. 그러나 수식은 이쪽이 옳다고 말했다.

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

#### 4. 뒤집기에서 따라 나온 세 가지

이 전환 하나에서 세 가지가 자동으로 따라 나왔다.

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

접기량·기다림·펴기 박자가 모두 물리량으로 정의되는, 검증 가능한 가설이 완성되었다.

#### 5. 이 가설의 신분 — 약점이자 강점

분명히 해 둘 것이 있다. 이 메커니즘은 광대에게 배운 것이 아니다.

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

Ⅳ장의 결론: 답을 지어냈다. 이제 그 답을 숫자로 만들어야 한다 — 얼마나 접고, 얼마나 기다리는가.

### 5. 균형이란 무엇인가 — 후보 소거와 모드의 발견

<!-- 원문 출처: 이론부 초안 v3, 문단 118–135 -->

#### 1. 수식화 이전의 질문

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

그렇다면 흔들리면서도 떨어지지 않는 운동이란 어떤 것인가? 후보를 세우고 하나씩 검토했다.

#### 2. 후보 소거

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

방향(줄과 엇갈리는 쪽)도 옳았고, ’1보다 조금 작은 비율’이라는 형태도 여기서 나왔다.

#### 3. 물러섬 — 그리고 우회로

그런데 우리는 그 문 앞에서 물러섰다.

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

이 우회로에서 확인한 세 가지는 값졌다.

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

> “LQR은 균형을 잡는다. 그러나 균형을 설명하지 않는다. 우리가 원한 것은 잡는 법이 아니라 설명이었다.”

<!-- 원문 출처: 종합 41, 문단 38–58 -->

#### 1. 추론이 멈춘 자리에 정리(定理)가 서 있었다

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

#### 2. 두 개의 모드

결합된 (φ, β) 연립계 M₂₂q̈ = G₂₂q 의 고유값 문제를 풀면 부호가 반대인 두 모드가 나온다.

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

#### 3. 안정모드선 — eigenspace, 그리고 컨설팅의 명명

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

#### 4. 균형의 한 문장 정의

Ⅰ장의 재정의와 Ⅱ장의 언어가 만나 균형이 마침내 한 문장이 된다.

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

### 6. 분리가정의 실패와 닫힌 공식 ε*

<!-- 원문 출처: 이론부 초안 v3, 문단 153–216 -->

#### 1. 손으로 풀기 위한 가정

모드라는 언어를 얻었지만, 처음에는 그 언어를 쓰지 않고 손으로 풀려고 했다. 그래서 가정을 하나 세웠다.

분리 가정: 줄의 흔들림(정진자)과 몸의 쓰러짐(역진자)은 서로 영향을 주지 않는다.

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

1+εcosωT=ε⋅coshλT

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

#### 2. MuJoCo의 판정 — 충격

전국대회를 준비하며 물리 엔진 MuJoCo로 정밀 검증했다. 결과는 충격이었다.

복원 시간을 3~4배나 과대예측했다. 그리고 줄이 길수록 오차가 커졌다.

#### 3. 범인 — 비대각 관성항 81%

원인을 행렬에서 추적했다. (φ, β) 2자유도 부분계를 행렬 그대로 풀면 다음 구조가 나온다.

φ=−ωdiag2φ+cφβ,  β=cβφ+λdiag2β

커플링 계수 cφ가 대각항의 81%에 달했다. 그리고 이 비율은 줄 길이와 무관한 체형 상수였다.

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

#### 4. 폐기, 그리고 살아남은 것

분리 모델과 그 위에서 유도한 옛 메인식은 폐기했다.

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

#### 1. 결합 모드 분석 — 시스템의 진짜 얼굴

기다리기(Wait) 중에는 δ가 고정되어 있으므로 시스템은 (φ, β) 2자유도 결합계로 줄어든다.

M22q=G22q,  A2=M22−1G22

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

표 7-1. 결합 모델의 모드 수치 (사람 스케일)

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

> “모델이 마침내 현실을 붙잡았다.”

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

#### 2. 접기는 등고선 위의 점프다

이제 접기량을 풀 수 있다. 먼저 접기라는 동작의 기하를 정확히 이해해야 한다.

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

RΔφ+hΔβ=0  ⇒  기울기 −h/R인 등고선을 따라서만 미끄러진다

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

#### 3. 유도 — 안정모드선 위에 착지시켜라

접기량을 무차원 비율 ε로 정의한다. 접기 직후의 쓰러짐 각이 βnew=−εβ0가 되도록 접는다고 하자.

ε = 0 → 발이 무게중심 바로 아래까지만 (Ⅳ-3에서 기각한 첫 가설)

ε > 0 → 발이 무게중심을 지나쳐 감 (과접기)

무게중심 보존으로부터 φnew=φi+h1+εβ0/R.

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

φi+h1+εβ0/R−εβ0=r

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

ε*=−hr R+h

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

#### 4. β₀가 사라졌다 — 눈대중의 물리적 근거

이 공식에서 가장 중요한 것은 거기에 없는 것이다.

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

#### 5. 검증 — 그리고 공식이 스스로 밝히는 유효 범위

표 7-2. ε*: 해석 공식 vs MuJoCo 수치 최적

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

#### 6. 뜻밖의 함의 — 펴지 않아도 된다

공식을 얻고 나서 그 뜻을 따져보다가, 우리 스스로도 놀란 결론에 도달했다.

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

이 시점의 우리에게 이것은 흥미로운 여담이었다. 이 성질이 무엇으로 자라는지는 Ⅻ장에서 보게 된다.

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

### 7. 공식의 위계 — 현실을 향한 네 번의 확장

<!-- 원문 출처: 이론부 초안 v3, 문단 220–285 -->

#### 1. 확장 ① — 움직이는 중이라면 (ε*_gen)

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

A=12η2+η2/λ

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

u2T q0+q0/λeff ≡u2Tqpred=0

εgen*=−u2Tqpred,baseβi⋅u2Te,  e=h/R, −1T

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

> “일반화의 본질은 위치를 정렬시키는 것이 아니라, 예측 상태를 정렬시키는 것이었다.”

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

#### 2. 확장 ② — 접는 데 시간이 걸린다면 (γ)

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

εft*=1+εgen*⋅γx−1,  x=λeffTf,  γ=exBx>1

삼각 가감속 프로파일에서 Bx=4ex/2−12/x2이고, 근사식은 γ≈1+x/2+5x2/48이다.

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

#### 3. 확장 ③ — 펴기를 붙이면 (ε_FWE), 그리고 함정

여기서 우리는 함정을 하나 만났다.

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

1+εFWE=1+εgen*1−e−λeffTw

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

> “기다림은 빈 시간이 아니라, 일부러 만들어 둔 빚을 갚을 만큼 키우는 시간이었다.”

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

FWE의 세 질문에 대한 답이 여기서 모두 닫힌다.

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

#### 4. 통일 — 마스터 전파법칙

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

AT=eλTA0−12κ2μδT+δTλ+λ0TeλT−sδs ds−eλTδ0+δ0λ

접기(δ: 0→δ_f)와 펴기(δ: δ_f→0)는 이 한 식의 두 사례다.

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

유한시간 완전 사이클의 요구 접기각도 닫힌형으로 나온다.

δf*=exf+xw+xeA0kexe+xwBxf−Bxe

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

#### 5. 확장 ④ — 오차가 있다면 (반복 FEW)

여기까지의 이론은 한 번의 완벽한 동작을 전제한다. 그런데 단발 FWE에는 치명적 취약점이 있다.

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

한 사이클의 A 변환은 마스터 전파법칙에서 아핀 맵으로 닫힌다(ODE와 0.00% 일치).

A+=G A−−g δf,  G=e2λTh, g=k BλTheλTh−1

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

여기서 두 항의 물리적 의미가 분명하다.

G = “기다림의 비용” — 사이클을 도는 동안 위험이 불어나는 배수

g = “접기의 효력” — 1라디안 접을 때 위험이 깎이는 양

γ = G/g = “환율” — 위험 1도를 지우려면 몇 도를 접어야 하는가

ρ = “공격성” — 매 사이클 위험의 몇 %를 지우려 시도하는가

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

> “반복 FEW는 ε* 이론의 대체가 아니라 폐루프적 완성이다.”

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

#### 6. 위계는 스스로를 검사한다

이 다섯 층의 공식은 서로 독립된 다섯 개가 아니다. 각 단계가 상위 단계의 극한으로 정확히 환원된다.

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

> “우리가 공식을 믿게 된 것은 그것이 맞아떨어져서가 아니라, 틀릴 기회를 여러 번 주었는데도 틀리지 않았기 때문이다.”

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

### 8. 그림자와 실체 — 예측점 평면

<!-- 원문 출처: 종합 41, 문단 89–126 -->

#### 1. (β, φ) 평면은 4차원의 그림자다

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

#### 2. 예측점 — 속도를 위치로 환산해 더한다

해법은 같은 평면에 원위치 대신 예측점을 찍는 것이다.

> q_pred = q + q̇ / λ_eff

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

> u₂ᵀ · q_pred = 2A ⟹ 「예측점이 안정선 위 ⇔ A = 0」

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

#### 3. S1 — 접기 한 번으로 영원히 유계 (뒤에 올 이야기의 복선)

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

#### 4. 회전 좌표 (s, n) — 이탈거리를 축으로 만들기

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

s축 (수평·안정): 안정모드선 방향 좌표 — 유계 진동의 진폭.

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

#### 5. 다섯 장면 — 이론 전체가 한 평면 위에

이 평면 위에 FWE의 다섯 시나리오를 그리면 공식 위계 전체가 그림으로 읽힌다. Ⅴ장의 진화사가 참조할 기준표다.

표 4-1. 예측점 평면 시나리오 수치 요약 (R = 0.7, β_i = 2°)

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

### 9. 메커니즘의 진화 — FWE에서 FFFF까지

<!-- 원문 출처: 종합 41, 문단 130–197 -->

#### 0. 한눈 연표

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

#### 1. v1 FWE — 완전 사이클과 첫 번째 함정

메커니즘의 출발형은 접고–기다리고–편다였다. 그런데 사이클을 수식으로 닫는 과정에서 함정을 만났다.

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

> **1 + ε_FWE = (1 + ε*_gen) / (1 − e^(−λT_w))**

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

#### 2. v1.5 FWEW — 유한시간이 요구한 네 번째 박자

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

#### 3. v2 FEFE — 대기의 배신과 반복 피드백

여기까지의 이론은 한 번의 완벽한 동작을 전제한다. 그런데 단발 완전 사이클에는 치명적 약점이 있었다.

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

#### 4. v3 FFFF — 실측이 부수고, 여담이 답이 되다

##### 4.1 전환을 강제한 실측 (8/1)

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

##### 4.2 펴기를 생략하다 — 증분 접기 + 저속 복귀

그래서 펴기 자체를 제거한 제어를 시험했다. 규칙은 두 줄뿐이다.

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

위험도가 문턱의 절반 아래이고 유지각이 1° 이상이면, 3°/s로 천천히 0을 향해 복귀한다.

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

결과 (v19_sim, 초기 0.5°±0.03° 20케이스, 상한 120초):

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

##### 4.3 이론적 뿌리 — S1의 승격

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

##### 4.4 새 설계 규칙 — 복귀에는 속도 상한이 있다

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

> v_복귀 < λ·A_여유 / 킥계수 ≈ 6°/s (이 로봇 눈금)

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

##### 4.5 검증과 지위 — “이론 검증”이 아니라 “시뮬 발견”

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

#### 5. 최종 해석 — 순서가 사라지고 세 역할이 남았다

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

> “물리로 지어낸 가설이 몸의 지혜를 두 번째로 재발견했다 — 이번에는 접기량이 아니라, 회복의 방식에서.”

### 10. 시뮬레이션의 발전

<!-- 원문 출처: 보고서 3차수정안, 문단 128–129 -->

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

시각자료 (4.8 시뮬레이션 발전 과정 — v1, v10, v14, v15, v19 화면 / 생존 시간 분포 그래프)

### 11. 줄타기 로봇 ‘어름이’ — 실물 부분 검증

<!-- 원문 출처: 보고서 3차수정안, 문단 137–137 -->

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

## Ⅲ. 결론 및 향후 탐구 계획

<!-- 원문 출처: 보고서 3차수정안, 문단 144–150 -->

우리 연구의 핵심은 다음 두 가지로 정리할 수 있다.

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

#### 2. 한계 및 향후 계획

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

## Ⅳ. 참고 문헌

<!-- 원문 출처: 보고서 3차수정안, 문단 155–158 -->

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

【고려대 한국 줄타기 동작 35가지 분류 연구 — 저자·연도·서지 확정】

【국가무형문화재 제58호 줄타기 기록물 — 서지 확정】

【그 외 인용 자료 — 확정 후 기입】
