cbshbalance/slackline-balacing1/work/학생보고서_공동집필_20260810/학생보고서_직선서술판_출처표시.md

# 한국 줄타기는 어떻게 장대 없이 균형을 잡는가?

## 처진 줄 진자 위 이중 역진자가 허리 접기 하나로 서는 원리의 규명과 로봇 실증

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

## Ⅰ. 탐구 동기 및 목적

### 1. 탐구 동기

#### 가. 문제 의식 — 서양 줄타기와 한국 줄타기

한국의 전통 줄타기 영상을 관찰하면서 가장 먼저 직관적인 의문이 들었다.

“장대도 없이 느슨한 줄 위에서 어찌 저렇게 이리저리 움직이며 균형을 잘 잡을 수 있을까?”

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

그림  서양 줄타기: 긴 장대를 활용하여 외력을 생성하고 무게중심을 제어하는 구조

그림  한국 전통 줄타기: 장대 없이 부채만을 들고 느슨한 줄 위에서 역동적인 동작을 수행하는 모습

#### 나. 얼음판 위의 사고실험 — 이건 불가능한 일이다

질문이 소박한 데 비해, 물리 수업에서 배운 것을 대입하자 사태는 훨씬 심각해졌다.

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

그런데 광대는 떨어지지 않는다.

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

> “불가능해 보이는 일이 실제로 일어나고 있다면, 그 안에 우리가 아직 모르는 물리가 있다는 뜻이다.”

#### 다. 역발상

그러나 우리는 이 관점을 완전히 뒤집는 역발상에서 탐구를 시작하였다.

“어려워 보이는 한국 줄타기의 요란한 몸동작들이, 방해 요소가 아니라 오히려 균형잡기를 더욱 쉽게 만드는 움직임이 아닐까?”

위와 같은 질문을 시작으로, 한국 줄타기가 장대 없이 균형을 잡는 메커니즘 규명을 위한 탐구를 시작하였다.

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

> “몸을 세우는 대신 줄을 끌어오면 된다.”

### 2. 탐구 목적

#### 가. 장대 없는 한국 줄타기의 균형 회복 원리를 물리 법칙으로 규명

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

#### 나. 원리를 수학적으로 유도하고 물리 엔진 시뮬레이션으로 검증

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

#### 다. 자체 제작한 줄타기 로봇으로 실물 실증

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

## Ⅱ. 탐구 과정

### 1. 문헌 조사 — 찾은 것은 답이 아니라 공백이었다

답을 찾으러 자료부터 뒤졌다. 조사할수록 이상했다.

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

### 2. 첫 번째 열쇠 — 처진 줄은 받침이 아니라 변환기다

#### 1. 결정적 관찰 — 발이 줄과 함께 흔들린다

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

R=L/22−D/22

원호 위를 흔들리는 물체 — 그것은 정진자다. 가운데로 되돌아오려는, 안정한 진자.

#### 2. 얼음판과 줄의 차이

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

이것을 무게중심에 대한 운동방정식으로 쓰면 놀랍도록 깨끗한 한 줄이 된다. 무질량 줄은 줄 방향의 힘만 전달하므로,

xCoM=−g φt  (무게중심 보존법칙)

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

#### 3. 그렇다면 발은 무엇으로 옮기는가 — 모델의 정의

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

원호 위의 발(발목은 자유 회전) + 하체 막대 + 허리 관절(모터 1개) + 상체 막대

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

우리가 직접 명령할 수 있는 것은 하나: 허리 접힘각 δ = θ − α, 입력은 힙 토크 τ

자유도 3, 입력 1. 제어가 어렵기로 유명한 저구동(underactuated) 시스템이다.

소각 선형화한 운동방정식은 다음과 같다(라그랑주 역학, 기호 검증 완료).

Mq=Gq+Eτ,  q=φ,α,θT, E=0, −1, +1T

M=MtR2Rp1Rp2Rp1JααJαθRp2JαθJθθ,  G=diag−MtgR, p1g, p2g

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

#### 4. 좌표를 물리가 단순해지는 축으로 갈아타기

(φ, α, θ)는 측정하기는 좋지만 의미를 읽기에는 나쁘다. 그래서 물리적 의미가 분명한 좌표로 바꿨다.

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

접힘각 δ=θ−α — 우리가 명령하는 자세 변수

이 좌표에서 무게중심의 수평 위치가 한 줄로 정리된다.

xCoM=Rφ+hβ  (h=직립 무게중심 높이)

줄이 발을 옮긴 거리 + 몸이 기운 효과. 이 한 줄이 이 연구 전체의 뼈대다.

이 좌표는 세 가지 좋은 성질을 갖는다(전부 기호 검증 완료).

① 토크는 δ에만 작용한다 — 서보가 δ를 추종하는 한, τ의 세부는 (φ, β) 동역학에 들어오지 않는다.

② 접기 각가속도 δ̈가 (φ, β)로 들어오는 문은 단 하나 — β행의 관성항 μ 하나뿐이다.

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

표 2-1. 사람 스케일 형상 파라미터 (이론·MuJoCo 검증 기준)

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

### 3. 발을 무게중심 너머로 보내 쓰러짐 방향을 바꾼다 — FWE 메커니즘

<!-- 원문 출처: 보고서 3차수정안, 문단 60–60 -->

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

### 4. 완전히 정지할 필요 없이 떨어지지만 않으면 된다 — 한국 줄타기에 맞는 균형의 정의

<!-- 원문 출처: 종합 41, 문단 14–23 -->

우리 시스템에는 성질이 반대인 두 진자가 겹쳐 있다.

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

#### 가. 입력 없이도 떨어지지 않고 흔들리는 상태가 가능한가

<!-- 원문 출처: 종합 41, 문단 27–30 -->

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

### 5. 흔들림 속에서 균형의 길을 찾다 — 결합 모드와 안정모드선

<!-- 원문 출처: 종합 41, 문단 39–39 -->

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

<!-- 원문 출처: 종합 41, 문단 44–57 -->

결합된 (φ, β) 연립계 M₂₂q̈ = G₂₂q 의 고유값 문제를 풀면 부호가 반대인 두 모드가 나온다.

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

### 6. 기운 크기가 달라도 같은 비율로 — 상태공간의 기하와 최적 접기 비율 ε*

<!-- 원문 출처: 종합 41, 문단 66–82 -->

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

> R·Δφ + h·Δβ = 0

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

여기서 기하가 닫힌다. R = 0.7 기준으로

안정모드선의 기울기: r = −2.12

무게중심 등고선의 기울기: −h/R = −1.37

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

> ε* = −h / (rR + h) (R = 0.7에서 ε* = 1.834, δ_f = 26.1°)

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

<!-- 원문 출처: 보고서 3차수정안, 문단 94–96 -->

표 4-1. ε*: 해석 공식 vs 물리 엔진 수치 최적

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

### 7. 위치와 속도를 하나의 점에 담다 — 예측점 평면과 차원 축소

<!-- 원문 출처: 종합 41, 문단 90–104 -->

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

해법은 같은 평면에 원위치 대신 예측점을 찍는 것이다.

> q_pred = q + q̇ / λ_eff

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

> u₂ᵀ · q_pred = 2A ⟹ 「예측점이 안정선 위 ⇔ A = 0」

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

<!-- 원문 출처: 종합 41, 문단 120–122 -->

이 평면 위에 FWE의 다섯 시나리오를 그리면 공식 위계 전체가 그림으로 읽힌다. Ⅴ장의 진화사가 참조할 기준표다.

표 4-1. 예측점 평면 시나리오 수치 요약 (R = 0.7, β_i = 2°)

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

### 8. 접고, 기다리고, 펴는 박자를 닫다 — 순간동작 가정의 완전 FWE 사이클

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

<!-- 원문 출처: 종합 41, 문단 137–139 -->

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

> **1 + ε_FWE = (1 + ε*_gen) / (1 − e^(−λT_w))**

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

### 9. 완벽한 한 번보다 불완전한 여러 번 — 유한시간 접기와 증분 접기의 시뮬레이션

#### 가. 실제 동작은 순간적이지 않다 — 유한시간 접기

<!-- 원문 출처: 최신 학생 보고서, 문단 356을 간결하게 정리 -->

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

#### 나. 완전 사이클의 약점 — 기다리는 동안 오차도 자란다

<!-- 원문 출처: 종합 41, 문단 149–150 -->

여기까지의 이론은 한 번의 완벽한 동작을 전제한다. 그런데 단발 완전 사이클에는 치명적 약점이 있었다.

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

#### 다. 펴기를 균형의 필수 동작에서 제외하다 — 증분 접기

<!-- 원문 출처: 최신 학생 보고서, 문단 363·365와 종합 41 문단 190–193을 정리 -->

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

#### 라. 물리 엔진 시뮬레이션을 통한 적용 가능성 검증

<!-- 원문 출처: 보고서 3차수정안, 문단 128–129 -->

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

시각자료 (4.8 시뮬레이션 발전 과정 — v1, v10, v14, v15, v19 화면 / 생존 시간 분포 그래프)

<!-- 원문 출처: 최신 학생 보고서, 문단 367 — 시뮬레이션 결과의 층위를 명시 -->

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

### 10. 이론을 현실의 줄 위에 세우다 — 줄타기 로봇 ‘어름이’

<!-- 원문 출처: 보고서 3차수정안, 문단 137–137 -->

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

## Ⅲ. 탐구 결론 및 의의

### 1. 탐구 결론

#### 가. 처진 줄과 허리 접기가 만드는 균형 회복 원리

<!-- 원문 출처: 최신 학생 보고서 결론, 문단 400–401 -->

서양의 줄타기는 균형을 만들고, 한국의 줄타기는 균형을 찾아 들어간다.

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

#### 나. 자연이 가진 균형의 리듬을 찾아 들어가는 기술

<!-- 원문 출처: 최신 학생 보고서 결론, 문단 402–402 -->

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

### 2. 탐구 의의

#### 가. 한국 줄타기의 균형 원리를 검증 가능한 물리 가설로 제시하였다

<!-- 원문 출처: 최신 학생 보고서 결론, 문단 405–405 -->

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

#### 나. 답뿐 아니라 질문과 판단과 검증의 책임까지 감당하였다

<!-- 원문 출처: 최신 학생 보고서 결론, 문단 407 — 검증 수치 표현은 본문과 일치하도록 정리 -->

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

### 3. 한계 및 향후 탐구 계획

<!-- 원문 출처: 보고서 3차수정안, 문단 150–150 -->

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

## Ⅳ. 참고 문헌

<!-- 원문 출처: 보고서 3차수정안, 문단 155–158 -->

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

【고려대 한국 줄타기 동작 35가지 분류 연구 — 저자·연도·서지 확정】

【국가무형문화재 제58호 줄타기 기록물 — 서지 확정】

【그 외 인용 자료 — 확정 후 기입】
