cbshbalance/slackline-balacing1/work/학생보고서_공동집필_20260810/줄타기_작품설명서_그림포함_초안.docx

제72회 전국과학전람회 작품설명서

한국 줄타기는 어떻게
장대 없이 균형을 잡는가?

처진 줄 진자 위 이중 역진자가 허리 접기 하나로 서는 원리의 규명과 로봇 실증

출품 부문 | 학생부 · 물리
출품 학생 | 김지훈 · 송주호 · 이혜원
지도 교사 | 정도일
작성 시점 | 2026년 8월

# 차례

Ⅰ. 탐구 동기 및 목적

Ⅱ. 탐구 과정

1. 문헌 조사 — 찾은 것은 답이 아니라 공백이었다

2. 첫 번째 열쇠 — 처진 줄은 받침이 아니라 변환기다

3. 발을 무게중심 너머로 보내 쓰러짐 방향을 바꾼다 — FWE 메커니즘

4. 완전히 정지할 필요 없이 떨어지지만 않으면 된다 — 한국 줄타기에 맞는 균형의 정의

5. 흔들림 속에서 균형의 길을 찾다 — 결합 모드와 안정모드선

6. 기운 크기가 달라도 같은 비율로 — 상태공간의 기하와 최적 접기 비율 ε*

7. 위치와 속도를 하나의 점에 담다 — 예측점 평면과 차원 축소
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
