cbshbalance/slackline-balacing1/v22_logger/e2e_shots/deck1.png

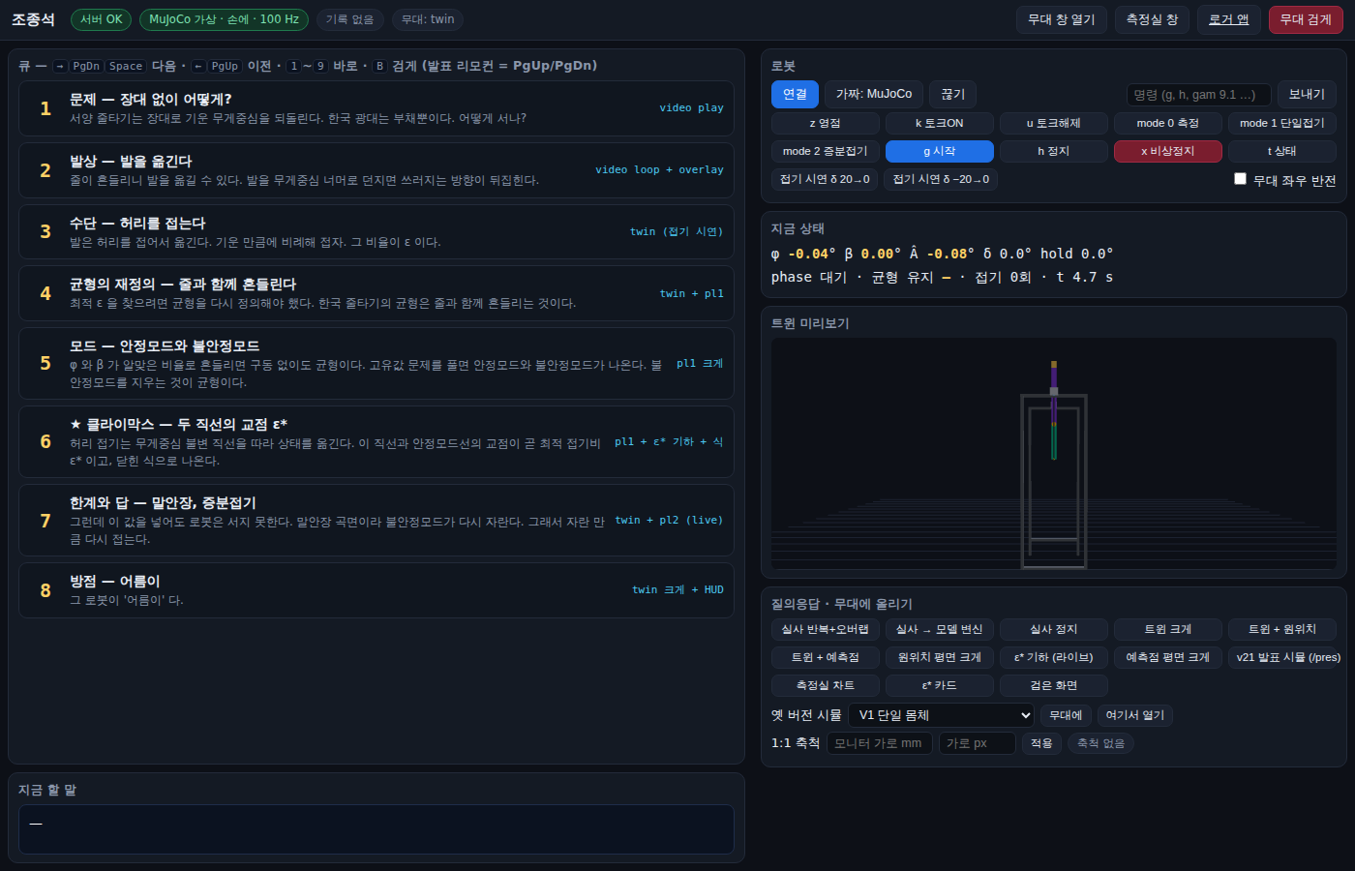
v22_logger/e2e_shots/deck1.png
