cbshbalance/slackline-balacing1/v22_logger/e2e_shots/loop_strip.png

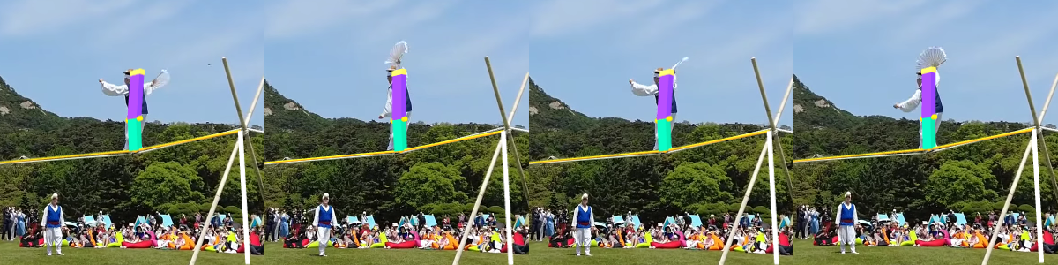
v22_logger/e2e_shots/loop_strip.png
