cbshbalance/slackline-balacing1/v22_logger/e2e_shots/s1_live.png

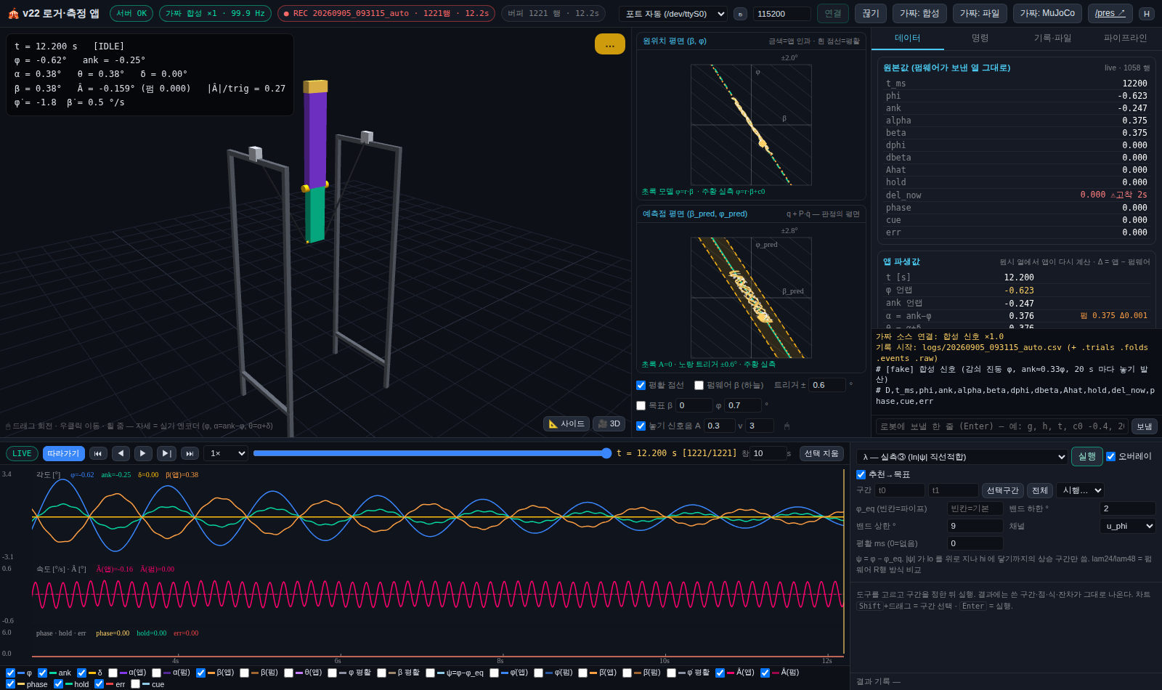
v22_logger/e2e_shots/s1_live.png
