cbshbalance/slackline-balacing1/v22_logger/e2e_shots/s3_p2r.png

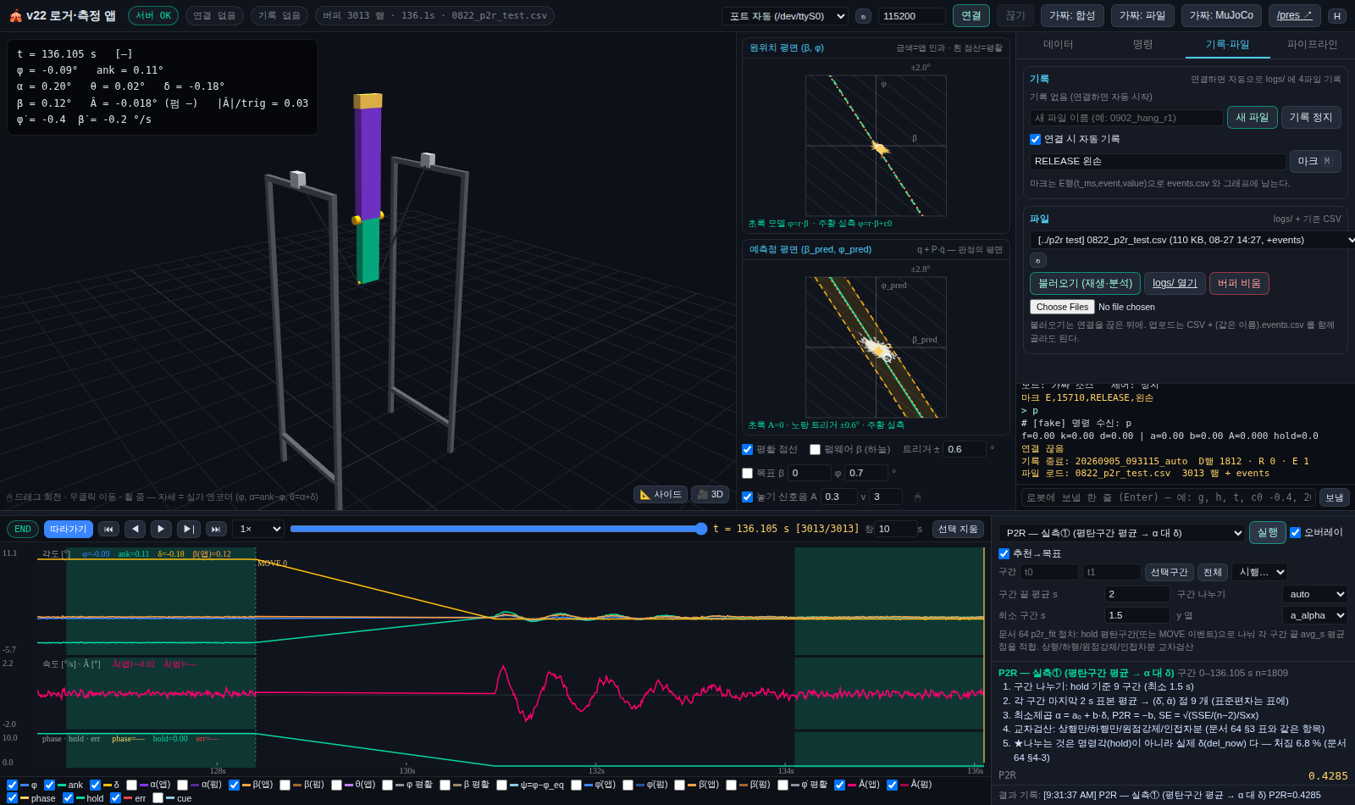
v22_logger/e2e_shots/s3_p2r.png
