cbshbalance/slackline-balacing1/v22_logger/e2e_shots/s4_lambda.png

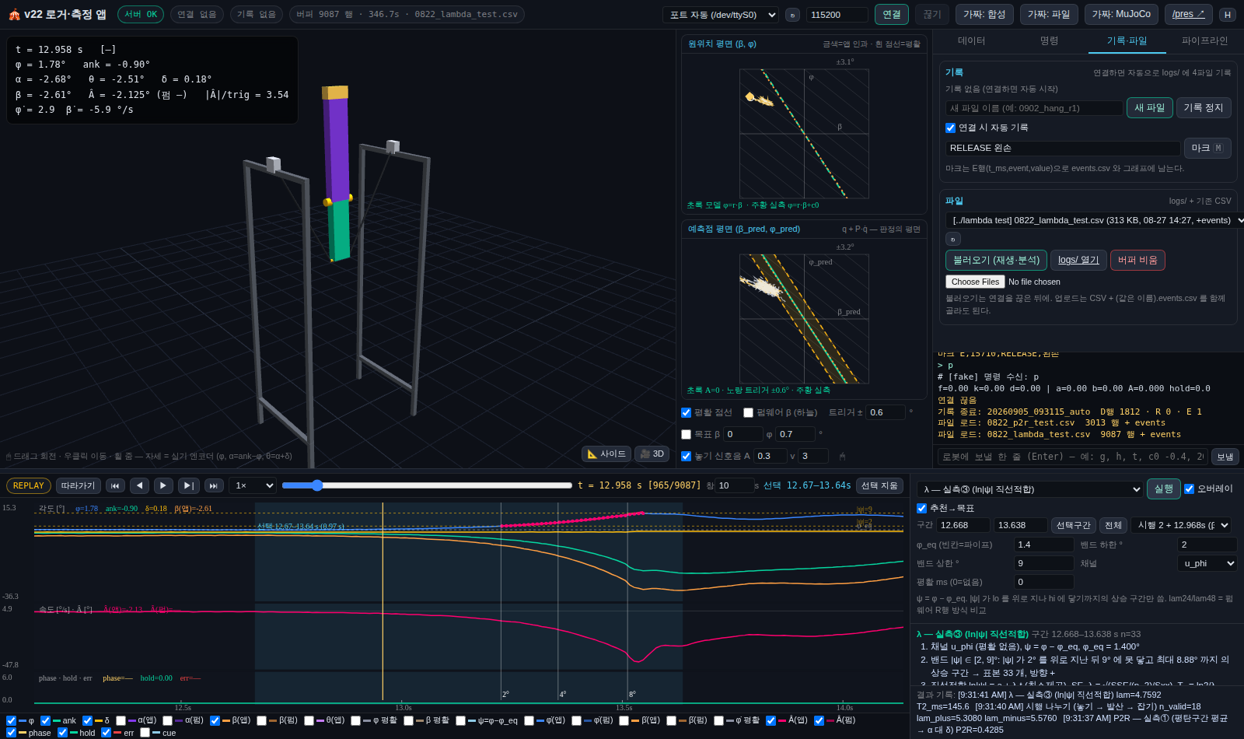
v22_logger/e2e_shots/s4_lambda.png
