cbshbalance/slackline-balacing1/v22_logger/e2e_shots/s7_mujoco.png

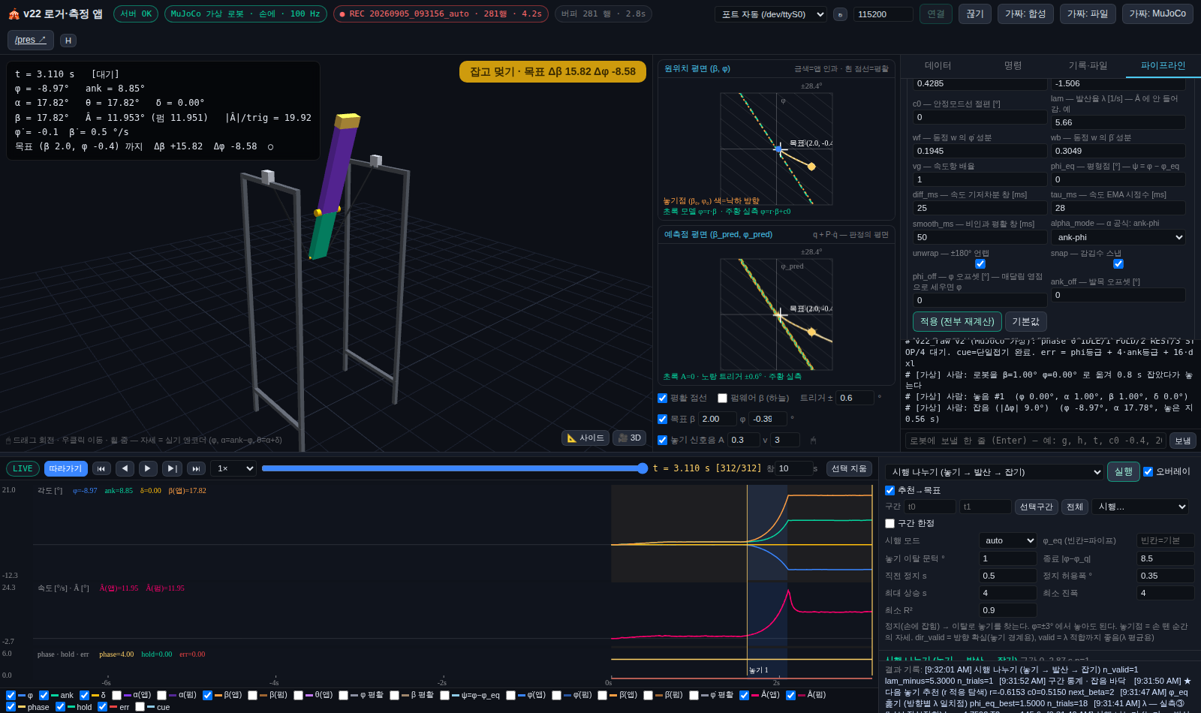
v22_logger/e2e_shots/s7_mujoco.png
