cbshbalance/slackline-balacing1/v22_logger/e2e_shots/s8_lab.png

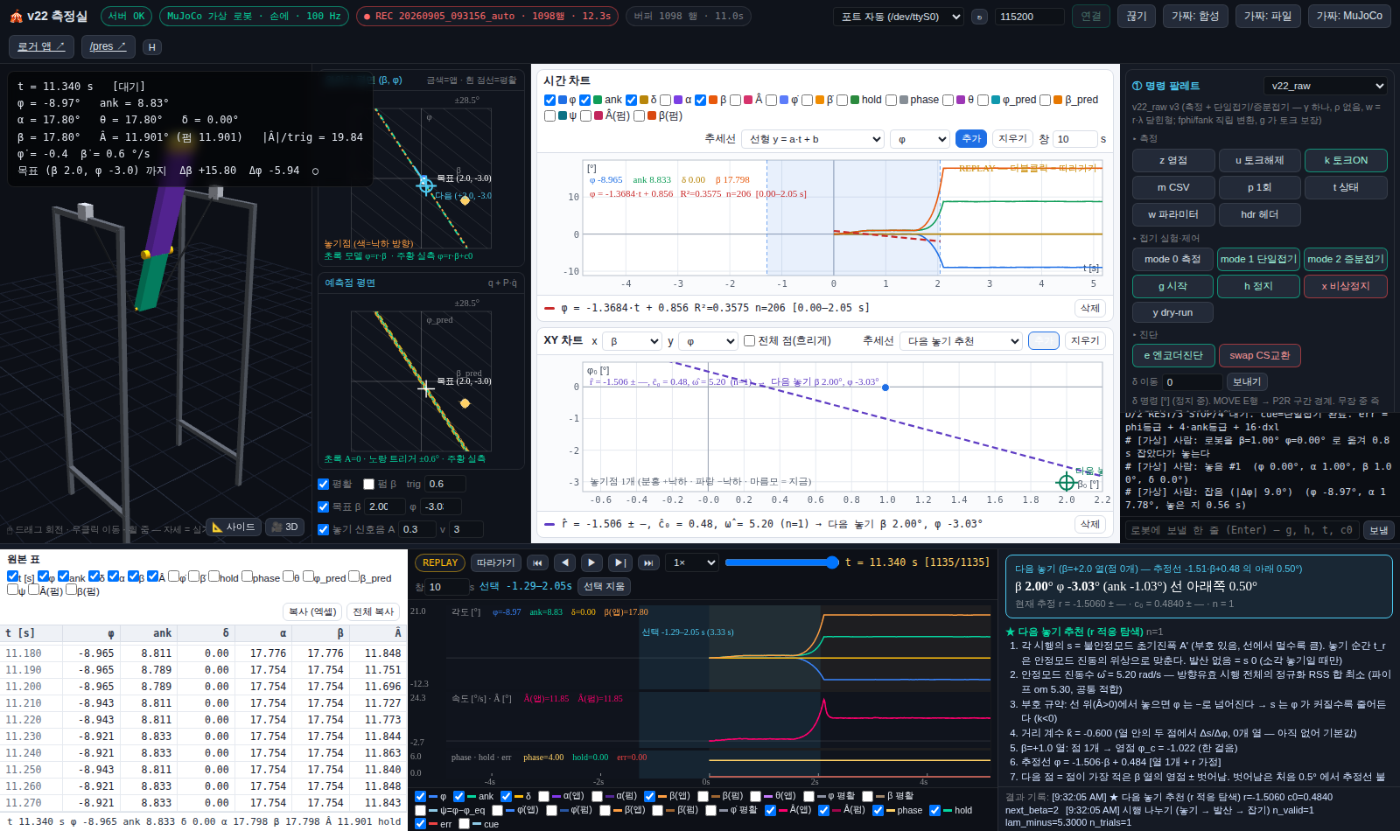
v22_logger/e2e_shots/s8_lab.png
