cbshbalance/slackline-balacing1/v22_logger/e2e_shots/s9_show.png

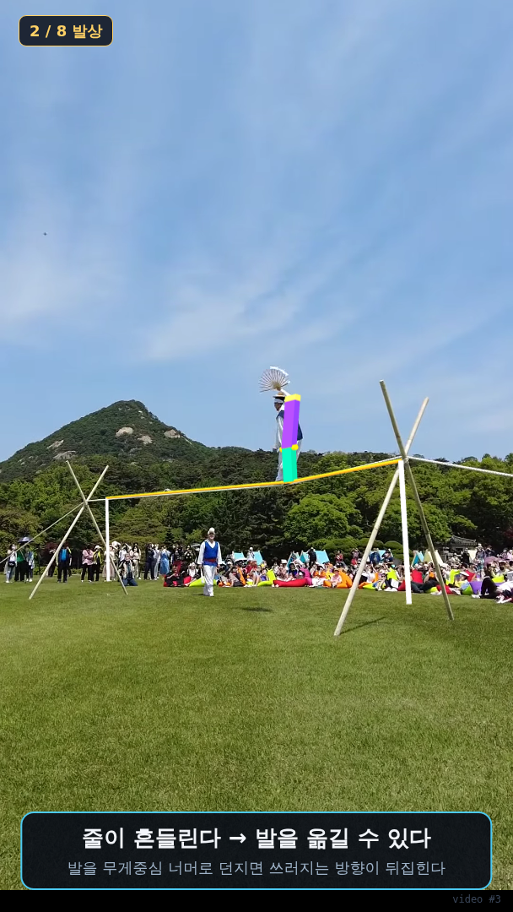
v22_logger/e2e_shots/s9_show.png
