cbshbalance/slackline-balacing1/v22_logger/e2e_shots/s10_deck.png

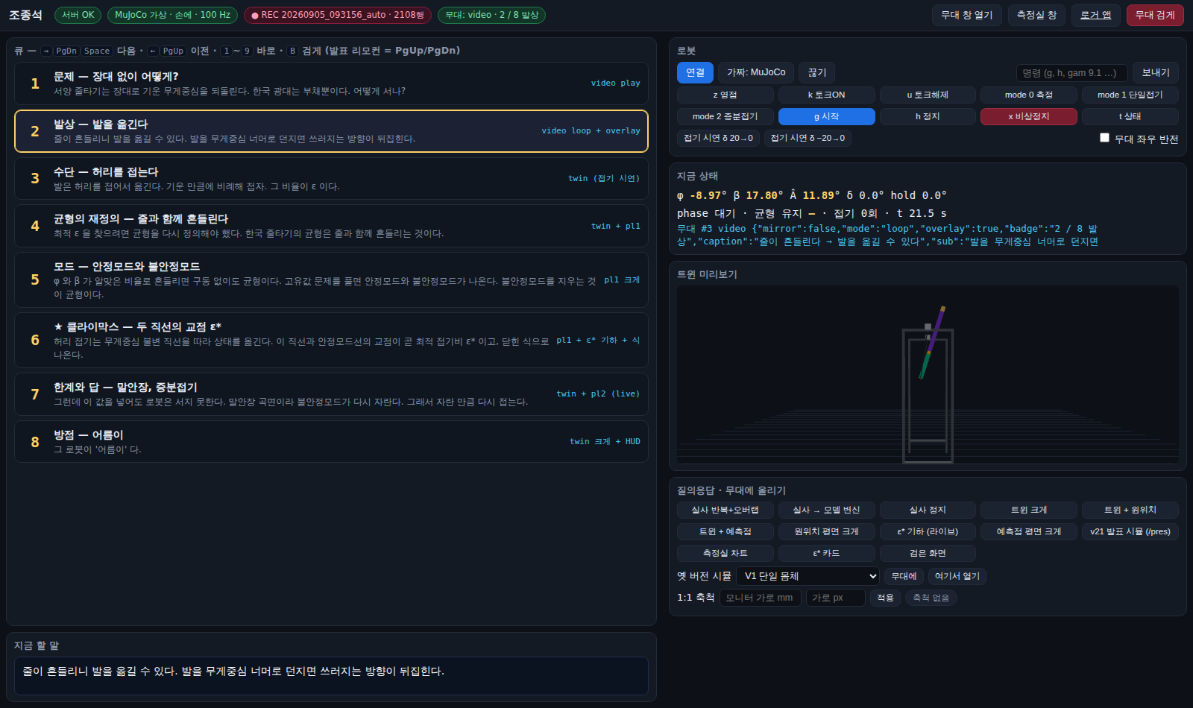
v22_logger/e2e_shots/s10_deck.png
