cbshbalance/slackline-balacing1/v22_logger/e2e_shots/show_c4.png

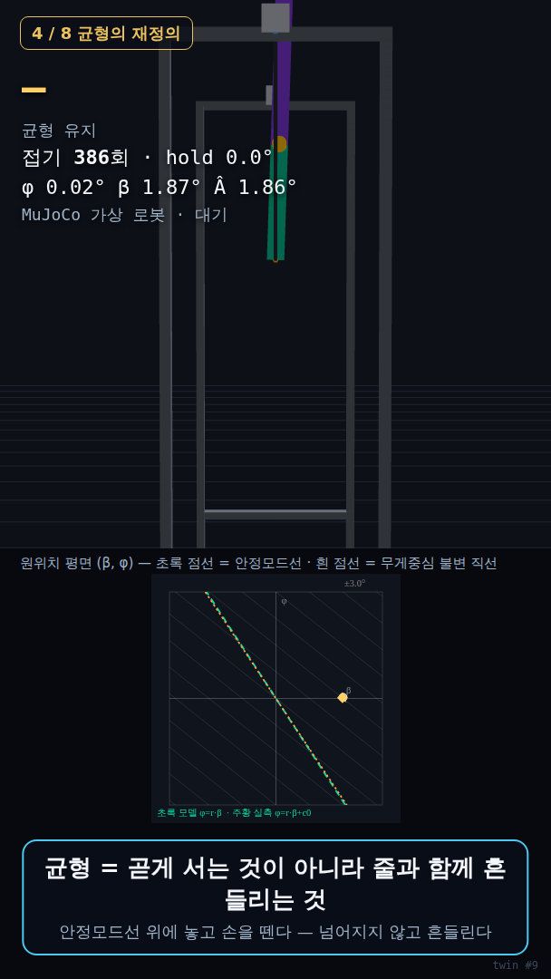
v22_logger/e2e_shots/show_c4.png
