cbshbalance/slackline-balacing1/work/hwp_caption_1167_20260811/final_page_sheets/pages_09_12.jpg

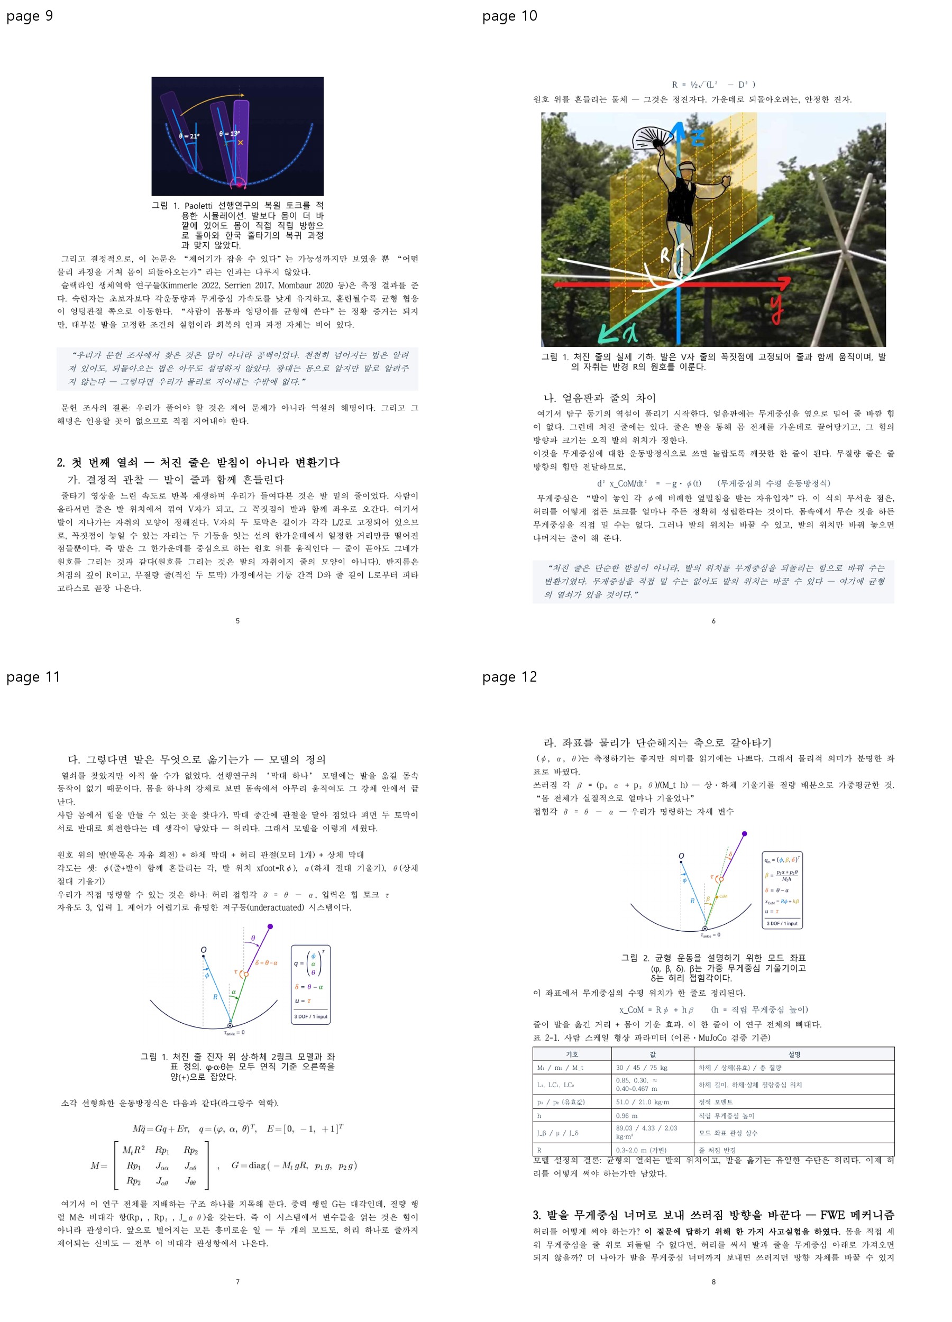
work/hwp_caption_1167_20260811/final_page_sheets/pages_09_12.jpg
