cbshbalance/slackline-balacing1/work/hwp_caption_1167_20260811/final_page_sheets/pages_25_28.jpg

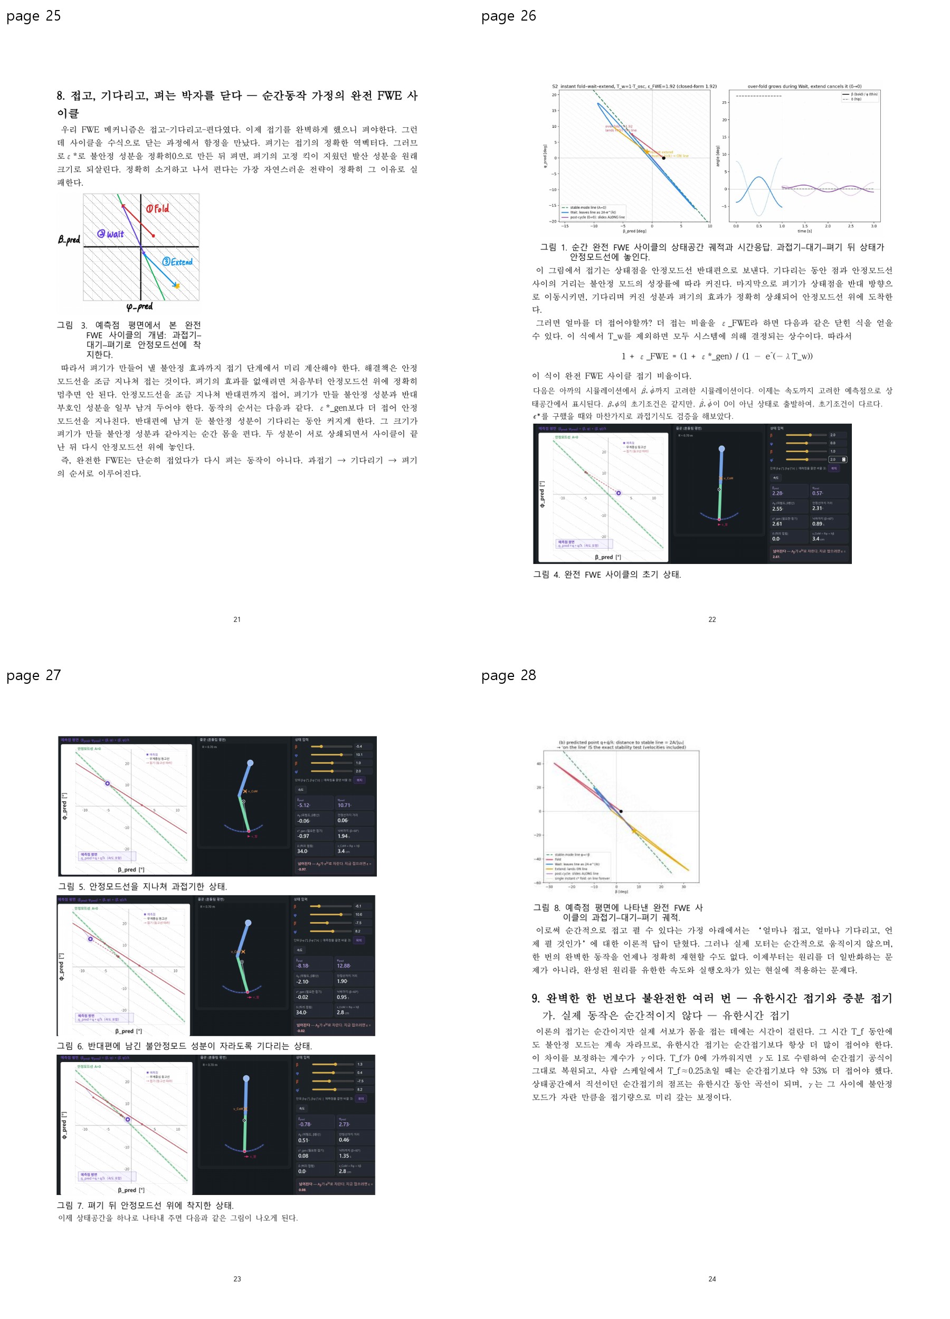
work/hwp_caption_1167_20260811/final_page_sheets/pages_25_28.jpg
