cbshbalance/slackline-balacing1/work/hwp_caption_1167_20260811/hwpx_unpacked/BinData/image10.PNG

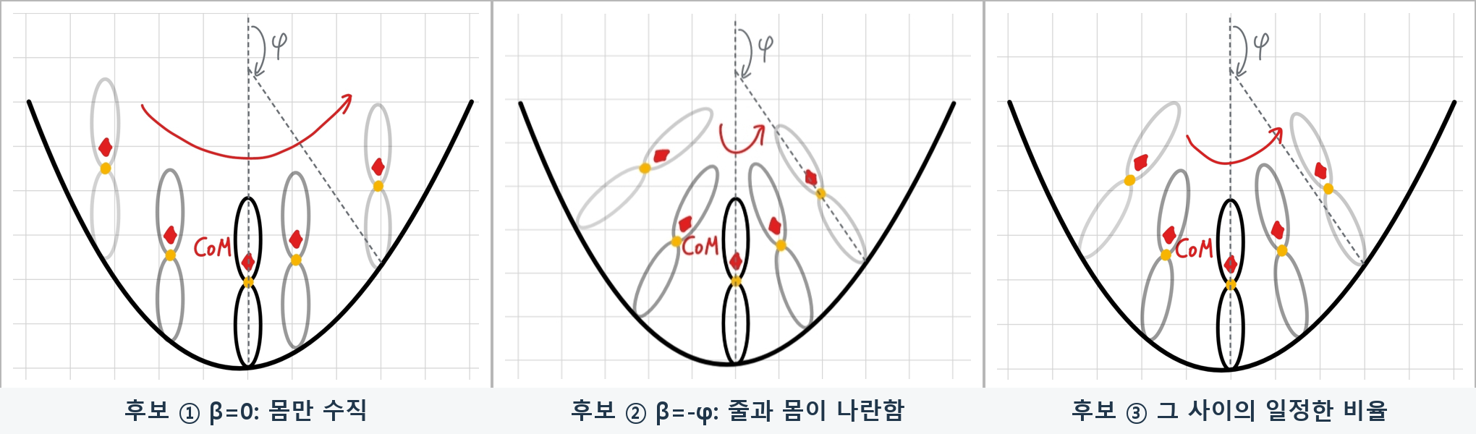
work/hwp_caption_1167_20260811/hwpx_unpacked/BinData/image10.PNG
