cbshbalance/slackline-balacing1/work/hwp_caption_1167_20260811/hwpx_unpacked/Preview/PrvImage.png

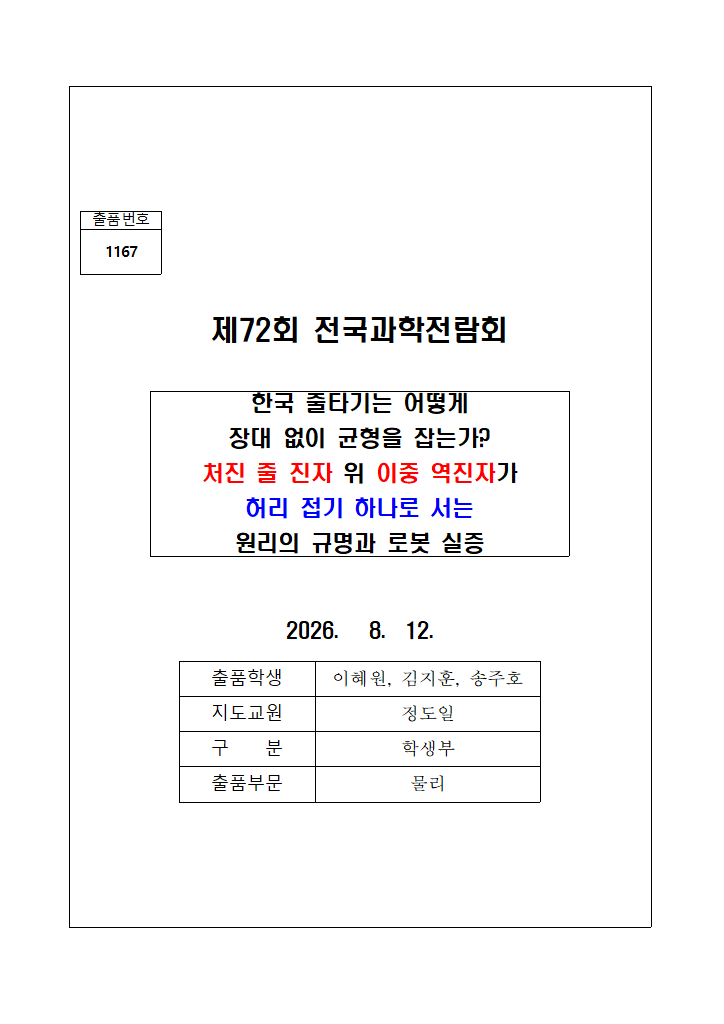
work/hwp_caption_1167_20260811/hwpx_unpacked/Preview/PrvImage.png
