cbshbalance/slackline-balacing1/work/hwp_caption_1167_20260811/hwpxcheck-05.png

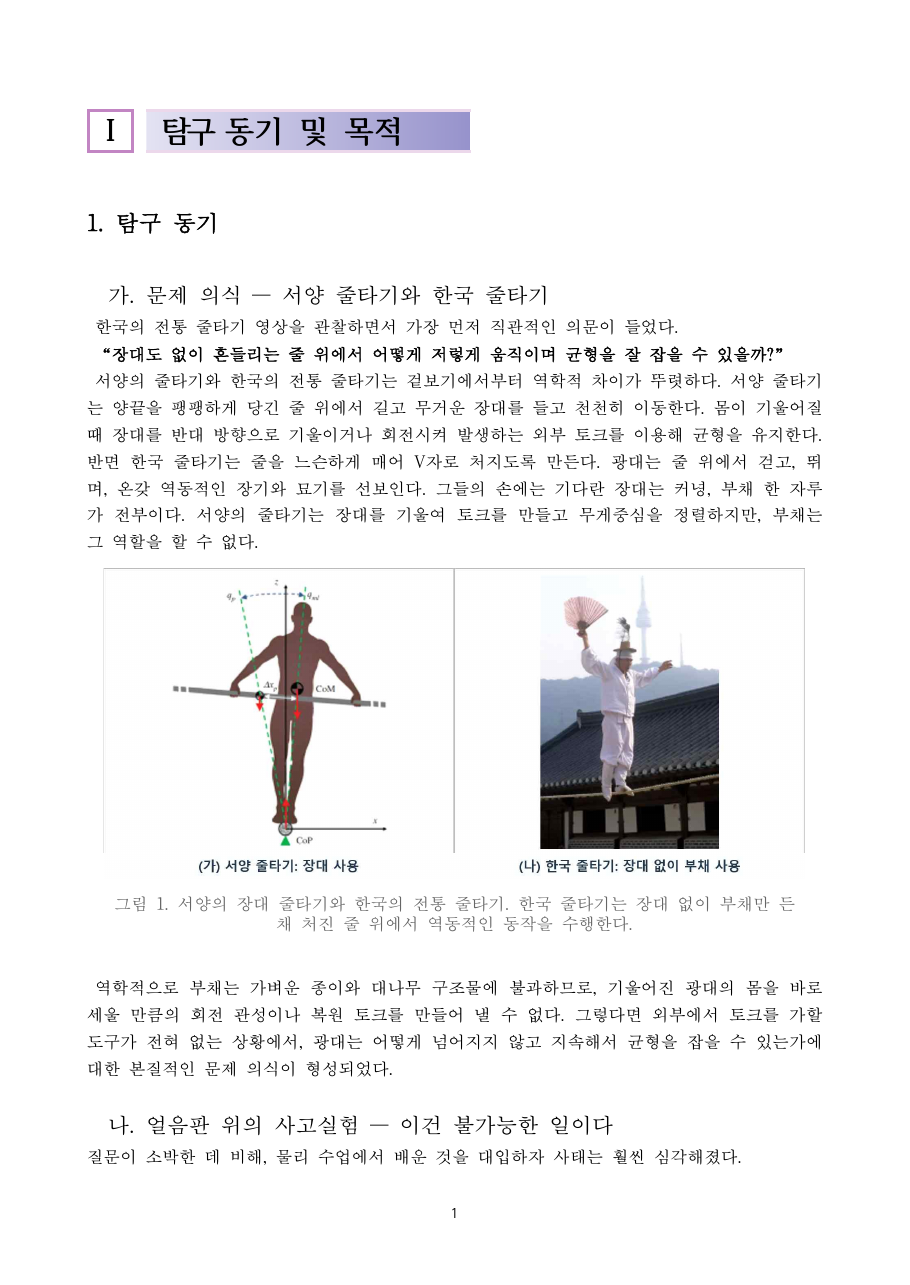
work/hwp_caption_1167_20260811/hwpxcheck-05.png
