cbshbalance/slackline-balacing1/work/hwp_caption_1167_20260811/media_sheets/media_01.jpg

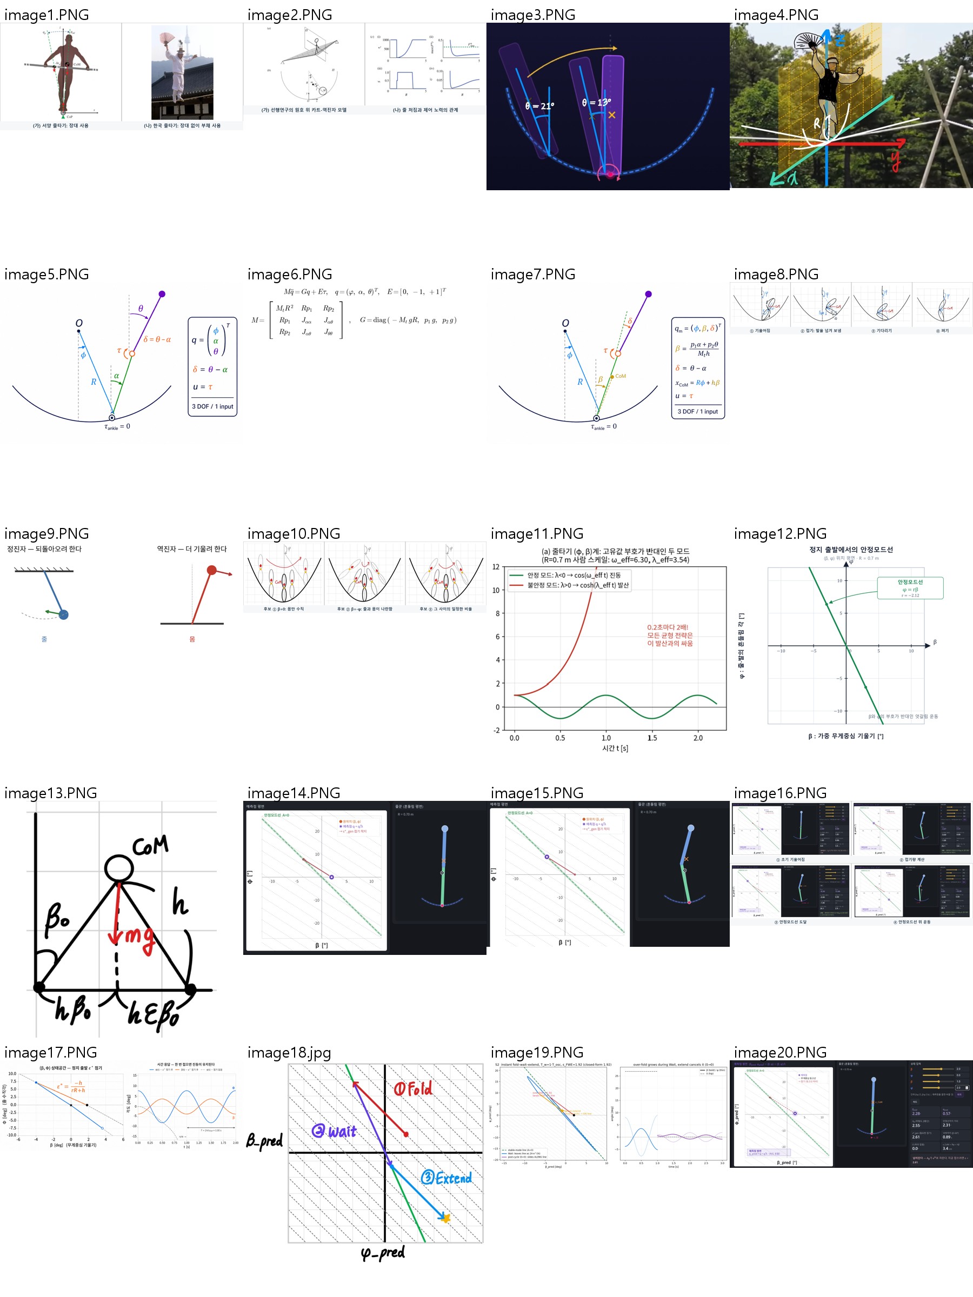
work/hwp_caption_1167_20260811/media_sheets/media_01.jpg
