cbshbalance/slackline-balacing1/work/hwp_caption_1167_20260811/normalized_unpacked/BinData/image9.PNG

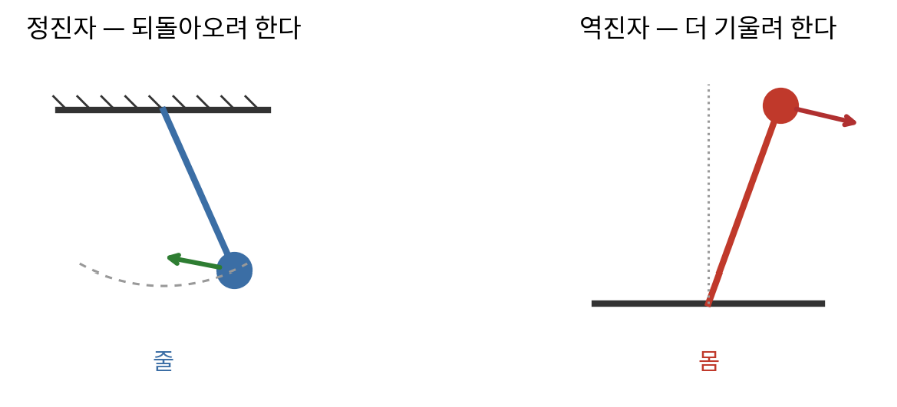
work/hwp_caption_1167_20260811/normalized_unpacked/BinData/image9.PNG
