cbshbalance/slackline-balacing1/work/hwp_caption_1167_20260811/normalized_unpacked/BinData/image24.BMP

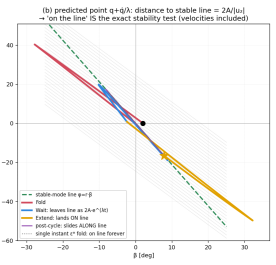
work/hwp_caption_1167_20260811/normalized_unpacked/BinData/image24.BMP
