cbshbalance/slackline-balacing1/work/hwp_caption_1167_20260811/page_sheets/pages_21_24.jpg

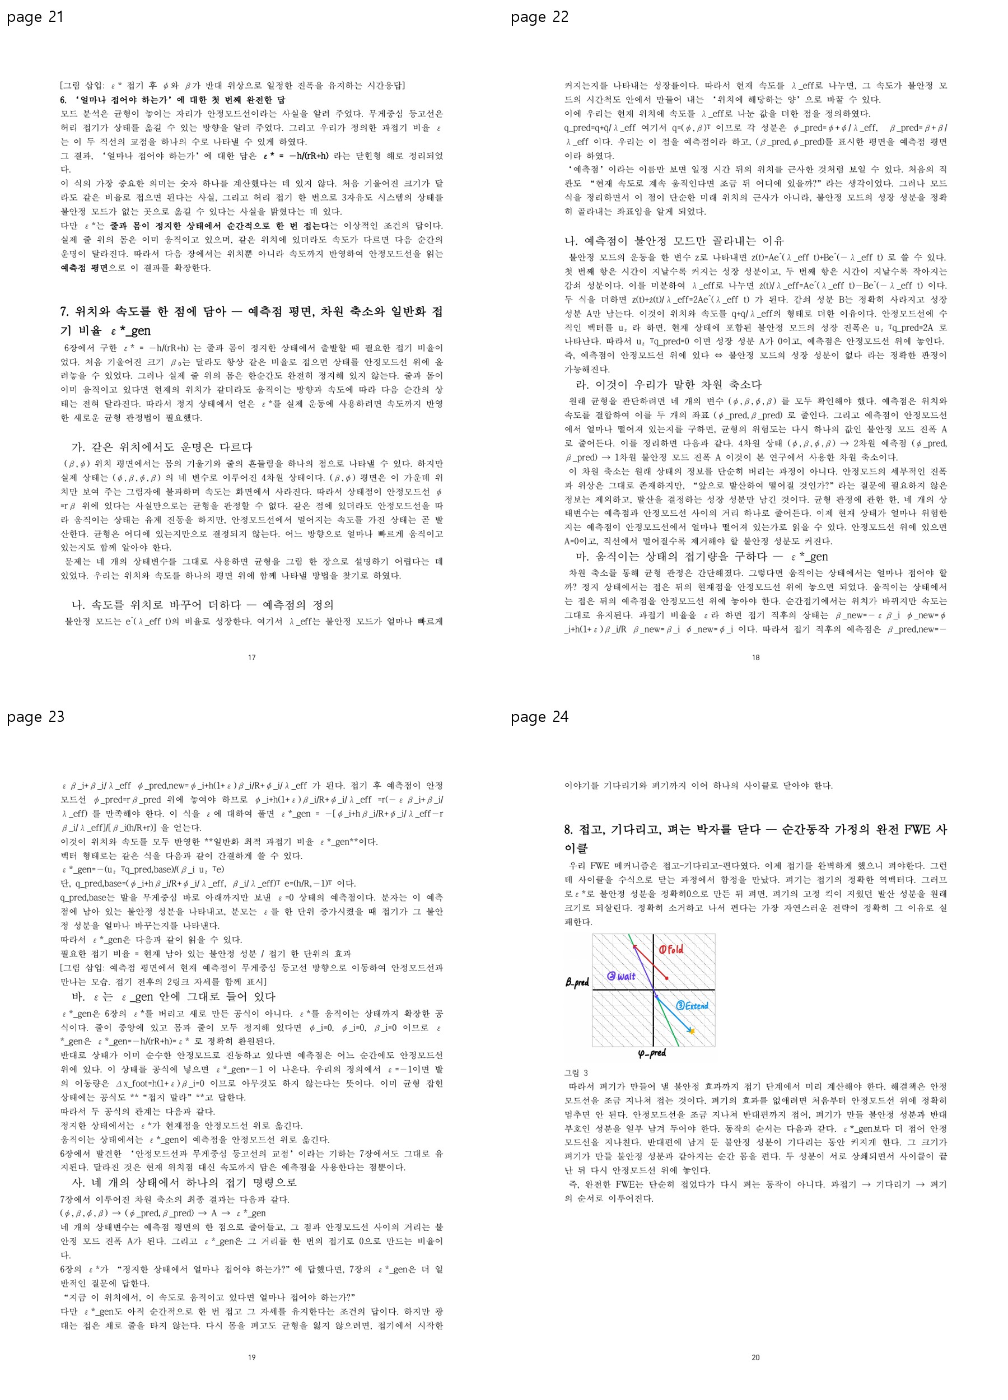
work/hwp_caption_1167_20260811/page_sheets/pages_21_24.jpg
