cbshbalance/slackline-balacing1/work/hwp_caption_1167_20260811/page_sheets/pages_37_39.jpg

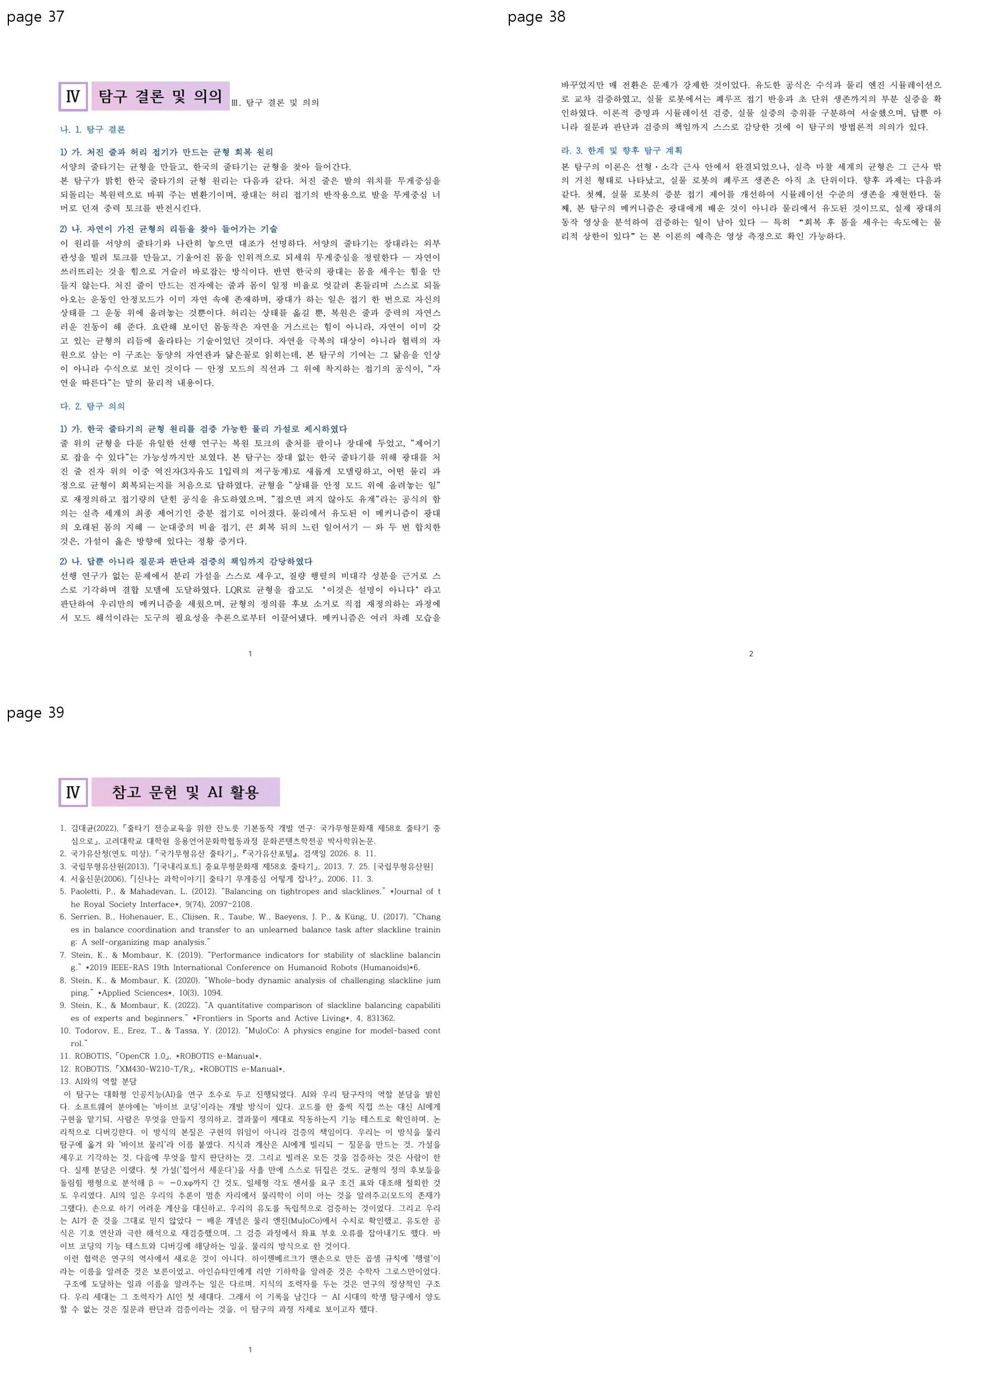
work/hwp_caption_1167_20260811/page_sheets/pages_37_39.jpg
