cbshbalance/slackline-balacing1/work/hwp_caption_1167_20260811/render_final/page-34.png

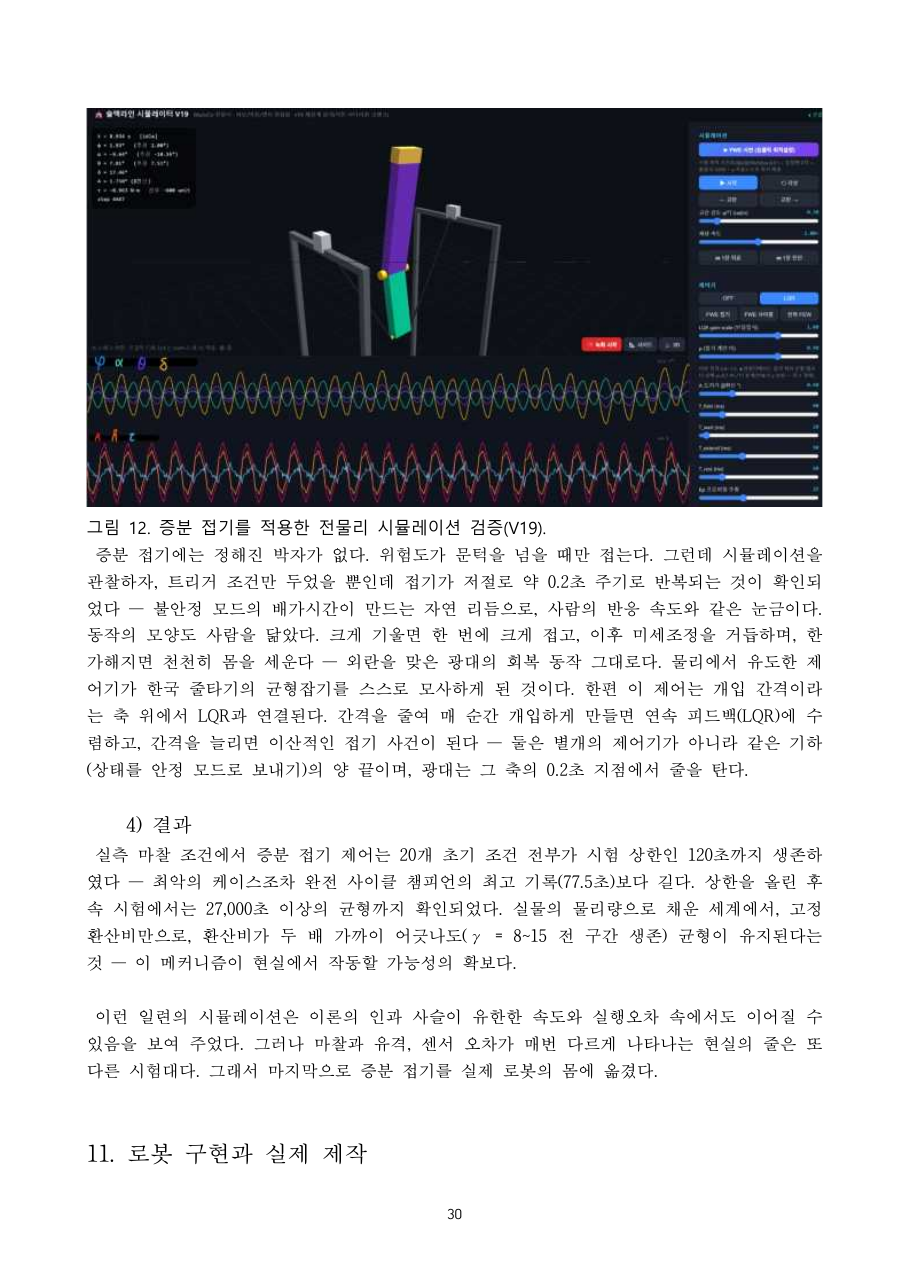
work/hwp_caption_1167_20260811/render_final/page-34.png
