cbshbalance/slackline-balacing1/work/hwp_caption_1167_20260811/render_original/page-17.png

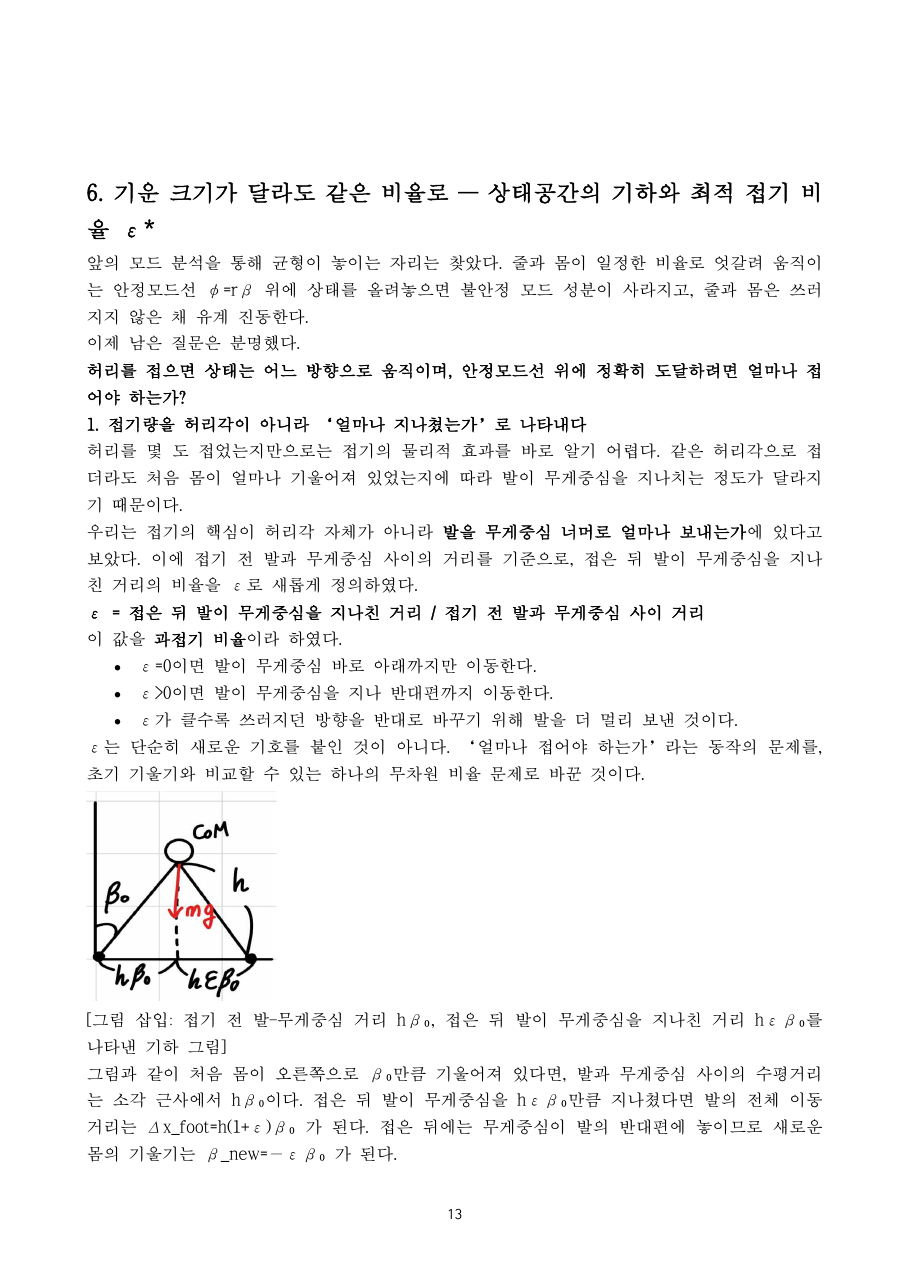
work/hwp_caption_1167_20260811/render_original/page-17.png
