cbshbalance/slackline-balacing1/work/학생보고서_공동집필_20260810/docx_source_figures/word/media/rId43.png

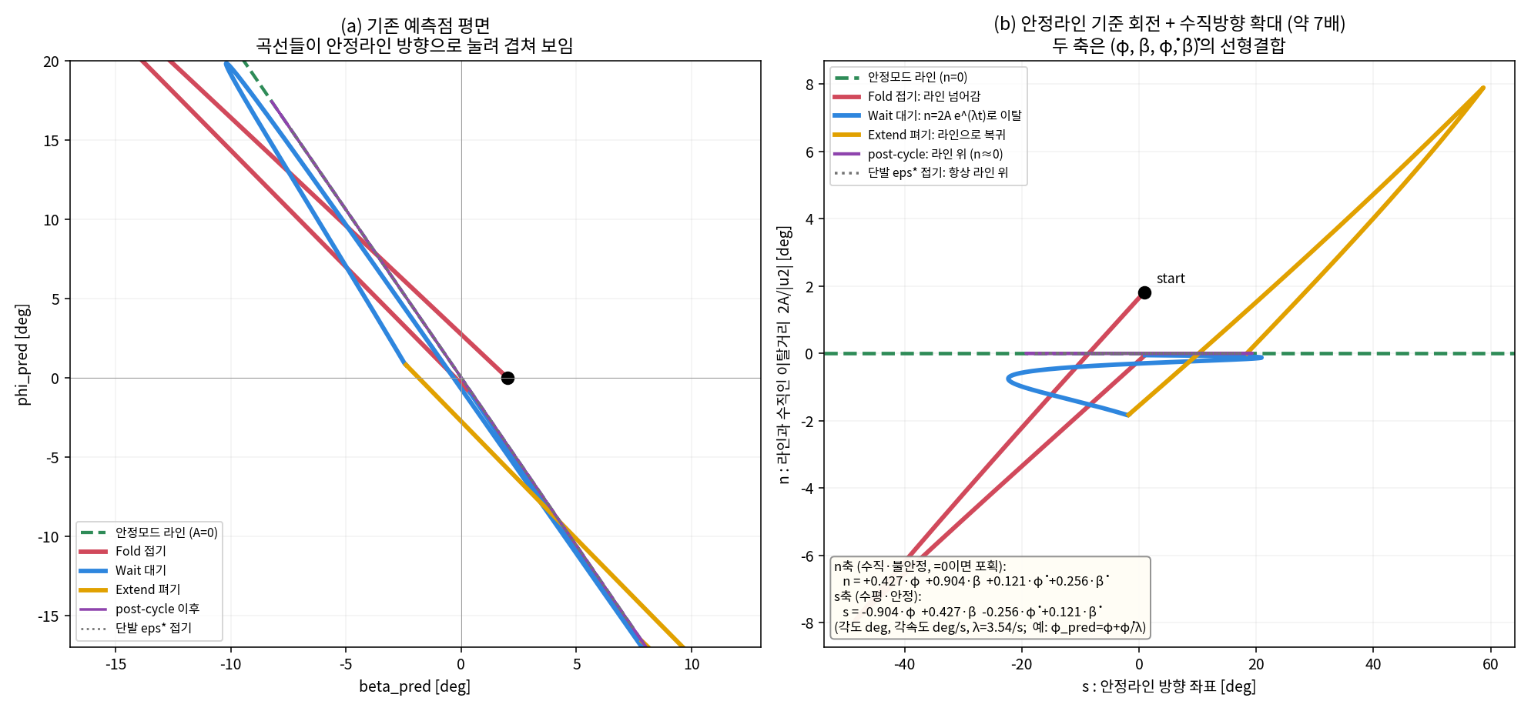
work/학생보고서_공동집필_20260810/docx_source_figures/word/media/rId43.png
