cbshbalance/slackline-balacing1/work/학생보고서_공동집필_20260810/latest_hwpx_0810_modified/extracted/BinData/image7.BMP

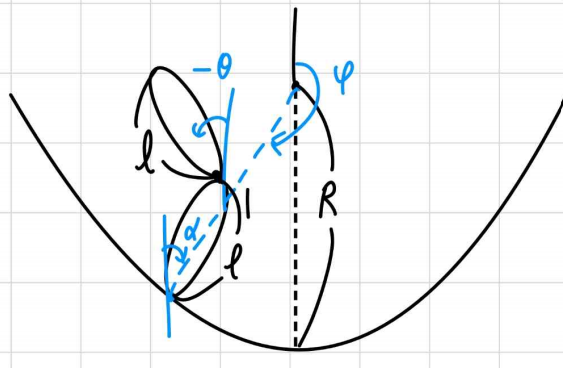
work/학생보고서_공동집필_20260810/latest_hwpx_0810_modified/extracted/BinData/image7.BMP
