cbshbalance/slackline-balacing1/work/학생보고서_공동집필_20260810/rendered_report/contacts/contact-005-008.jpg

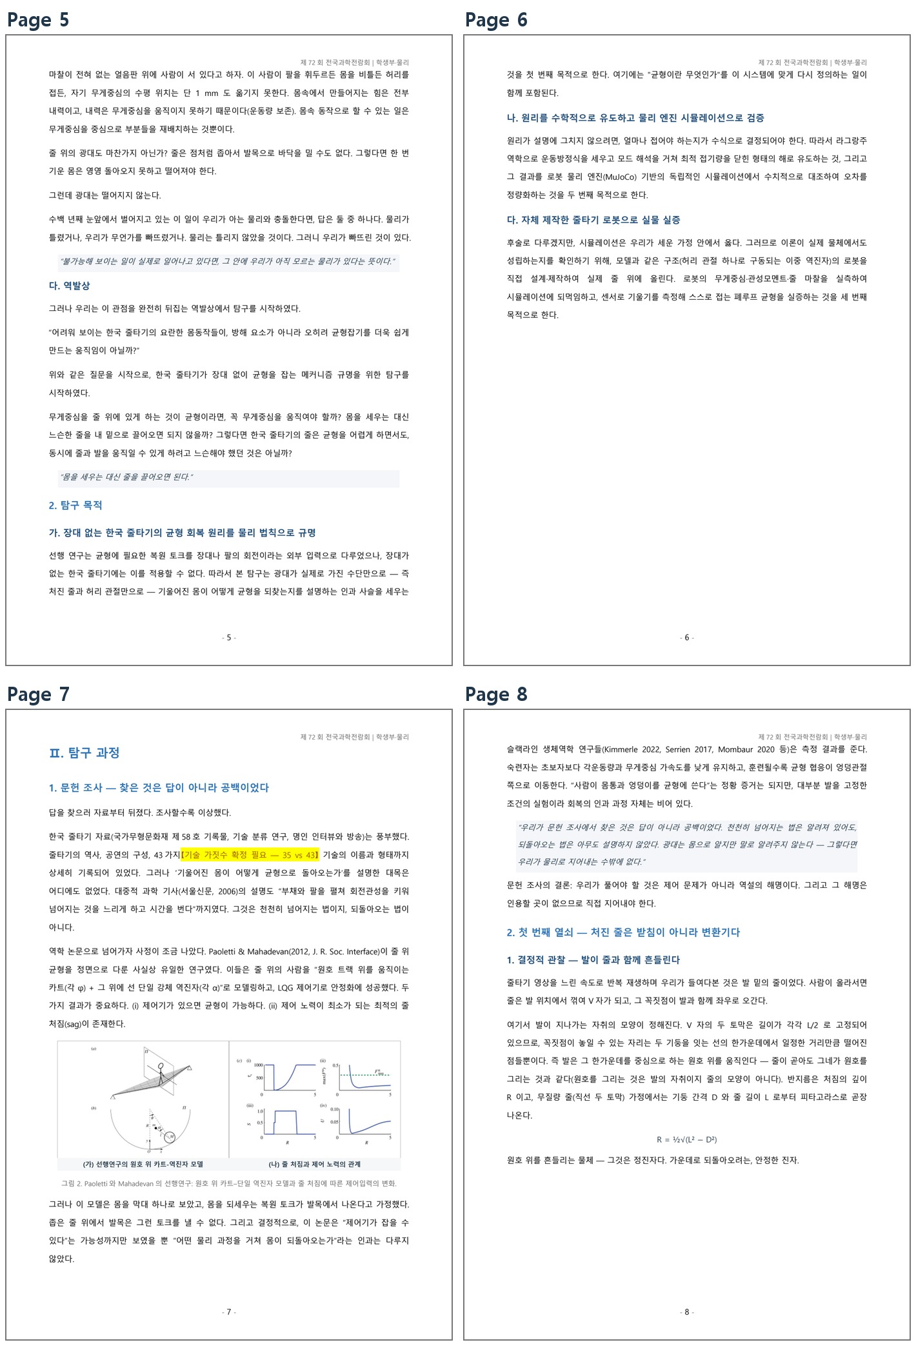
work/학생보고서_공동집필_20260810/rendered_report/contacts/contact-005-008.jpg
