cbshbalance/slackline-balacing1/work/학생보고서_공동집필_20260810/rendered_report/pages/page-011.png

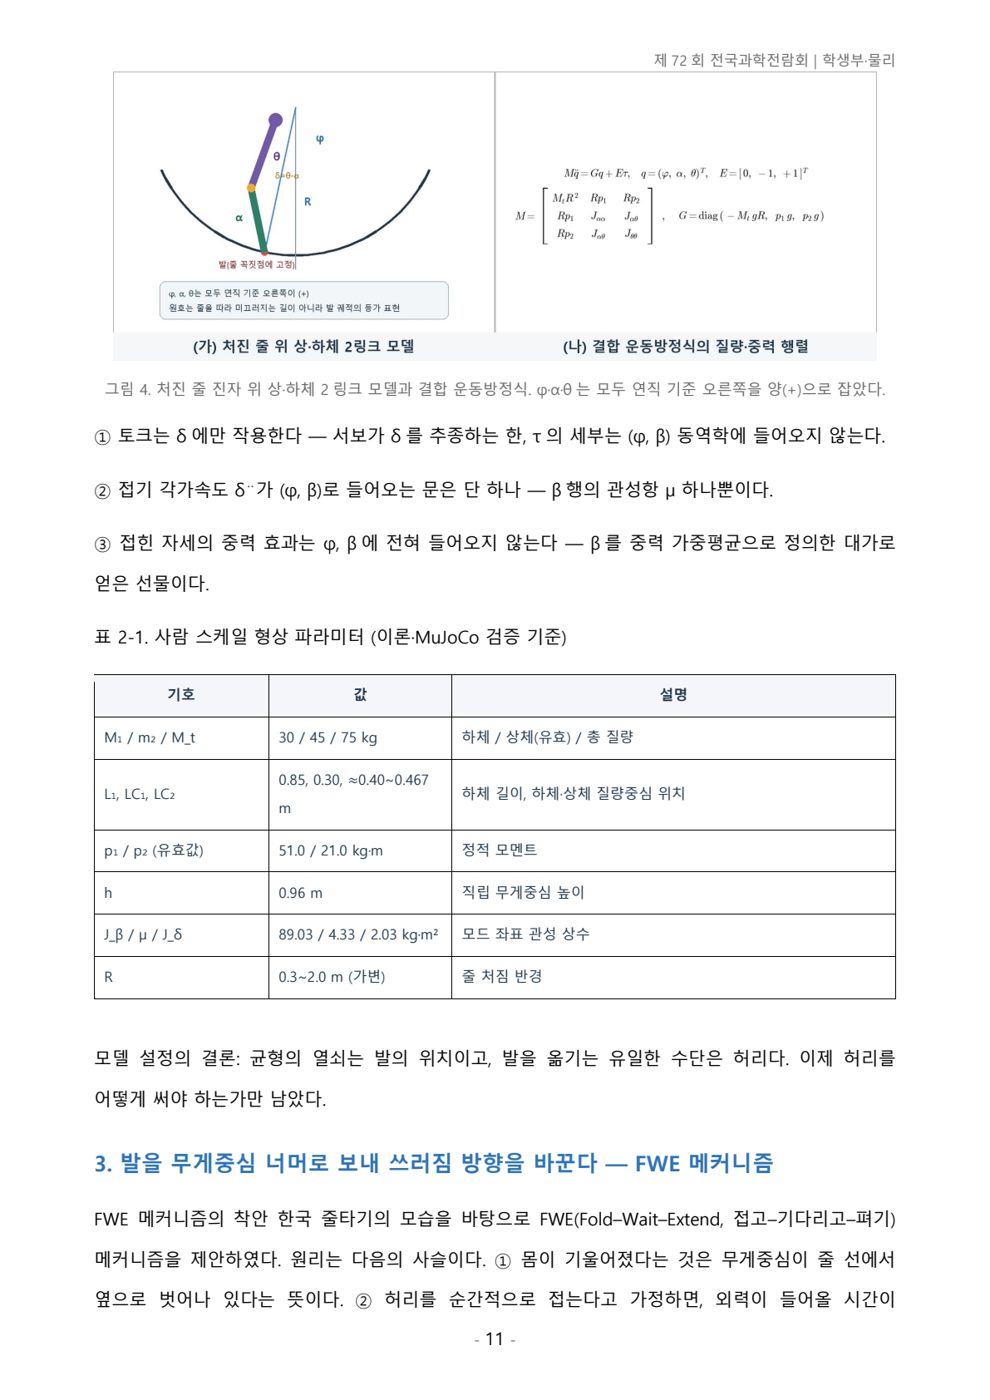
work/학생보고서_공동집필_20260810/rendered_report/pages/page-011.png
