cbshbalance/slackline-balacing1/work/학생보고서_공동집필_20260810/report_assets/fig03b_sagging_rope_pendulum_3d.png

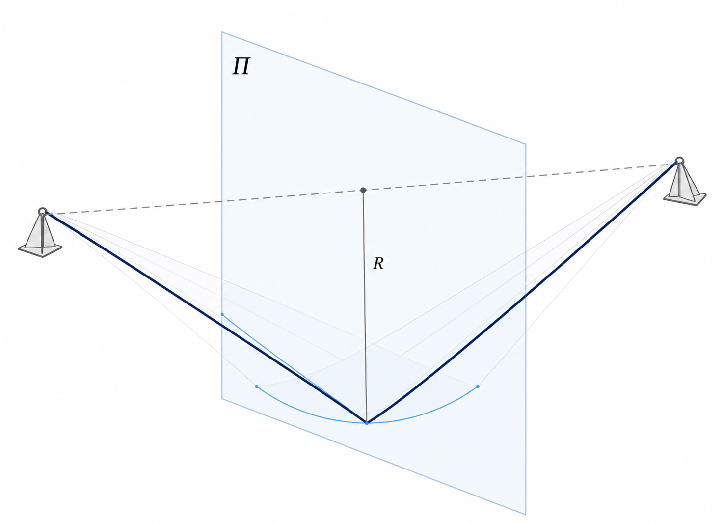
work/학생보고서_공동집필_20260810/report_assets/fig03b_sagging_rope_pendulum_3d.png
