cbshbalance/slackline-balacing1/work/학생보고서_공동집필_20260810/report_assets/fig17_survival_comparison.png

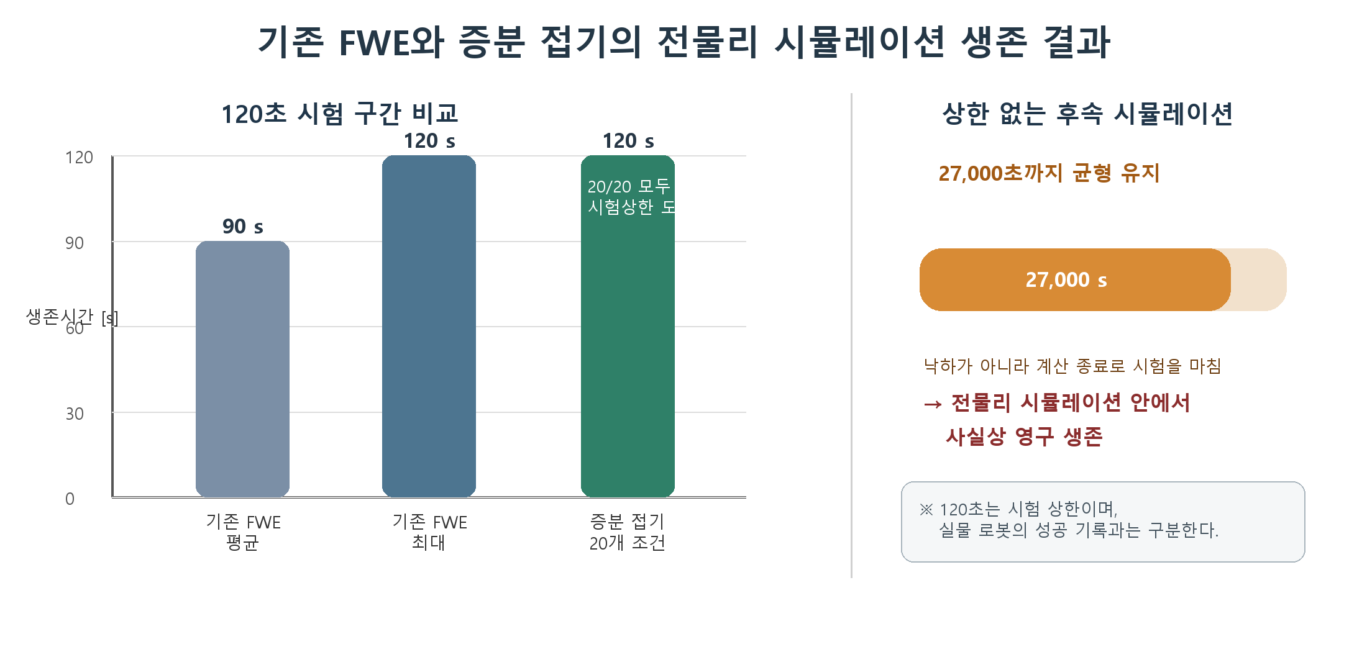
work/학생보고서_공동집필_20260810/report_assets/fig17_survival_comparison.png
