cbshbalance/slackline-balacing1/cad/exports/bearing_mount_part.3mf

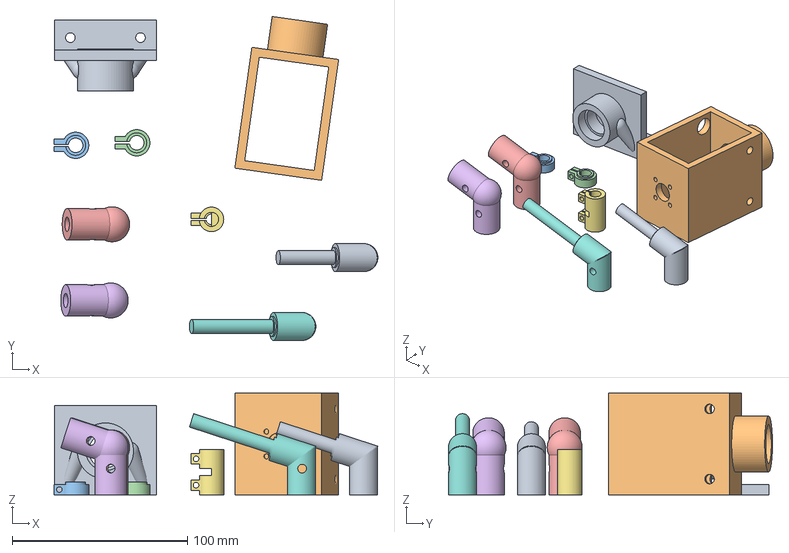
[picture p204: CAD file, 2026-07-24]
cad/exports/bearing_mount_part.3mf
184.7 x 184.8 x 58.0 mm
bearing_mount_part.stl
encoder_bracket_part.stl
lock_collar_part.stl x 2
lower_socket_part.stl x 2
solid_coupler_part.stl
upper_socket_encoder_part.stl
upper_socket_part.stl
