cbshbalance/slackline-balacing1/cad/exports/stl_v5.5_20260823/axle_ankle_socket_v5.5_front.stl

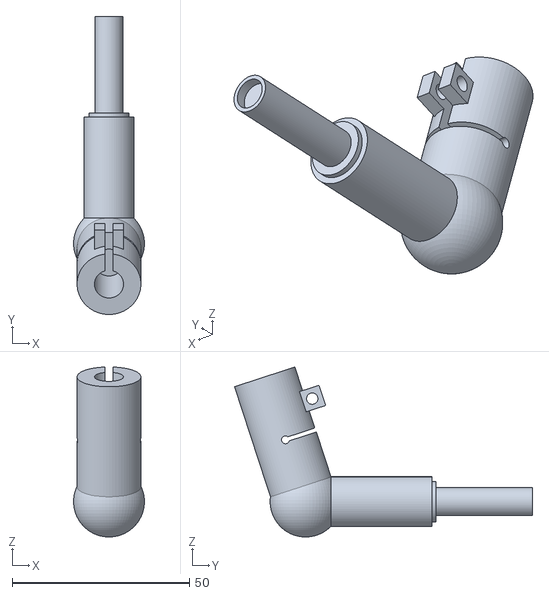
[picture p205: CAD file, 2026-09-04]
cad/exports/stl_v5.5_20260823/axle_ankle_socket_v5.5_front.stl
20.0 x 84.0 x 47.9
