cbshbalance/slackline-balacing1/cad/exports/ankle_carrier_part.3mf

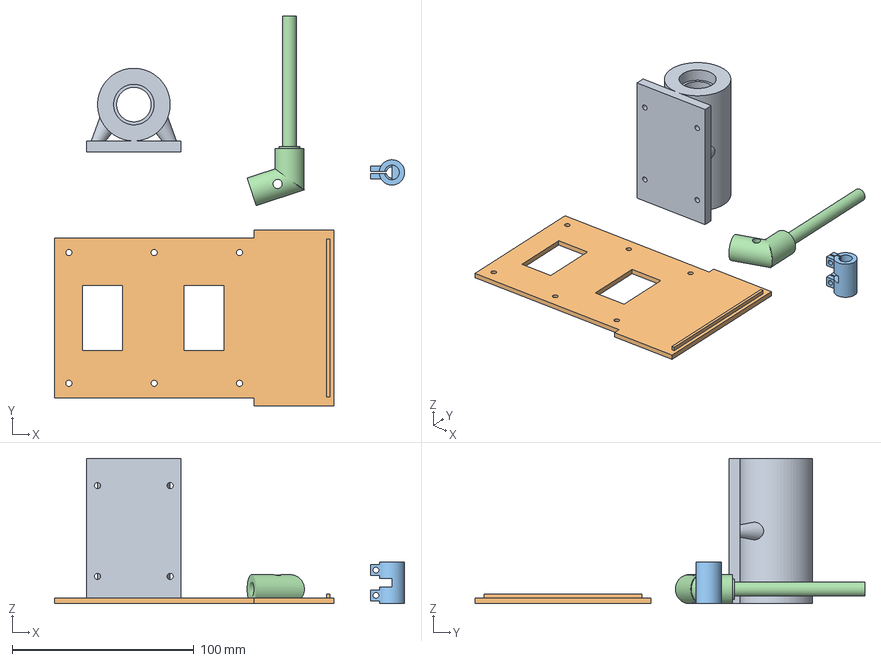
[picture p206: CAD file, 2026-07-24]
cad/exports/ankle_carrier_part.3mf
192.9 x 214.8 x 80.0 mm
ankle_carrier_part.stl
upper_body_door_part.stl
solid_coupler_part.stl
upper_socket_encoder_part.stl
