cbshbalance/slackline-balacing1/cad/exports/stl_v5.5_20260823/axle_pivot_rear_v5.6.stl

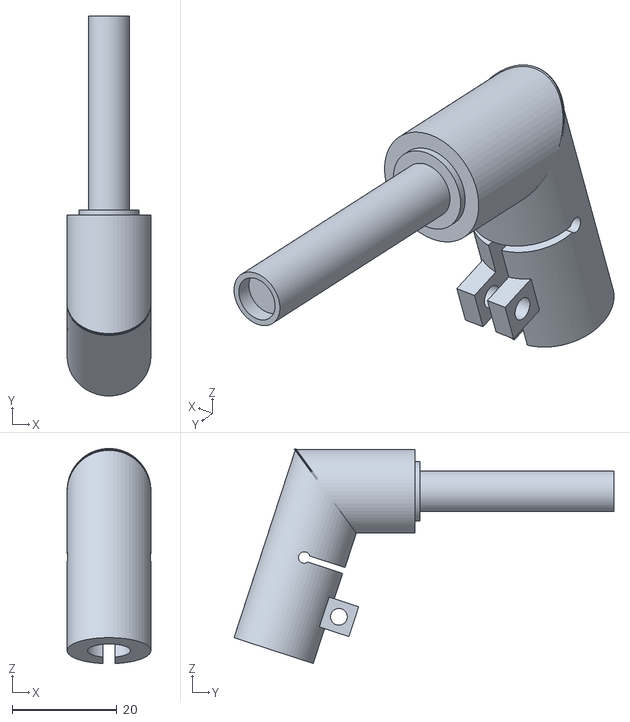
[picture p207: CAD file, 2026-09-04]
cad/exports/stl_v5.5_20260823/axle_pivot_rear_v5.6.stl
16.0 x 72.5 x 41.1
