cbshbalance/slackline-balacing1/cad/exports/stl_v5.5_20260823/axle_pivot_front_v5.5.stl

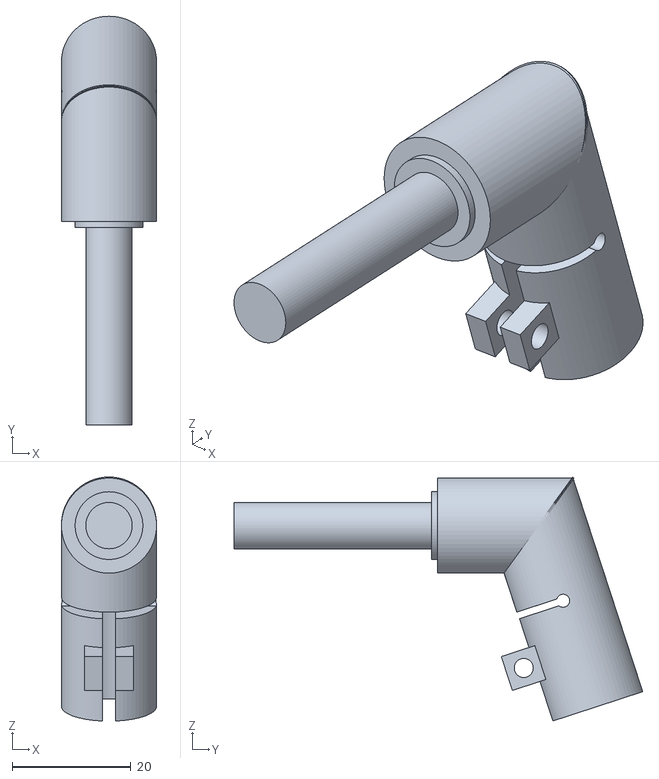
[picture p208: CAD file, 2026-09-04]
cad/exports/stl_v5.5_20260823/axle_pivot_front_v5.5.stl
16.0 x 68.7 x 41.1
