cbshbalance/slackline-balacing1/cad/exports/upper_body_a_part.3mf

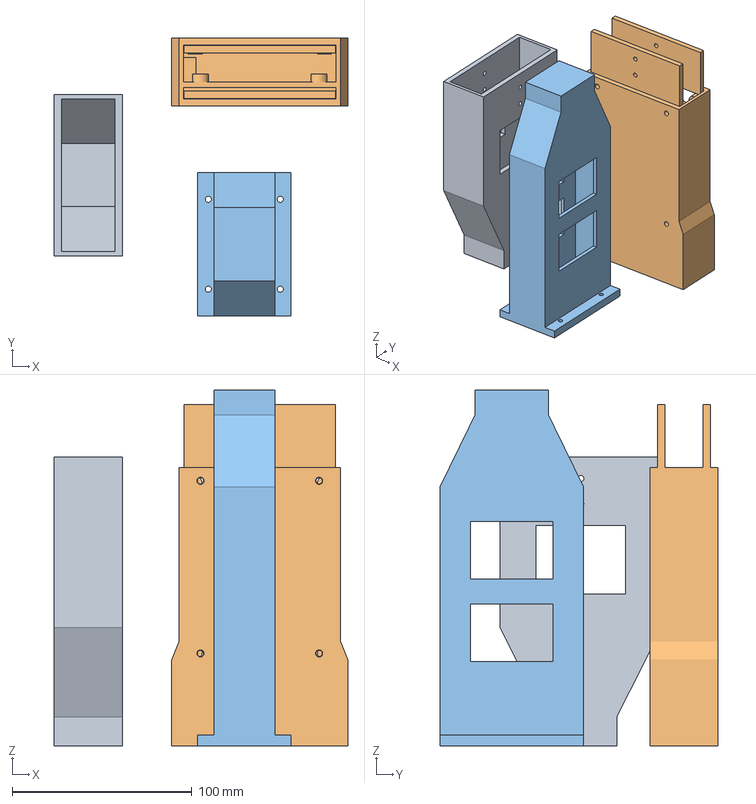
[picture p209: CAD file, 2026-07-24]
cad/exports/upper_body_a_part.3mf
163.4 x 154.8 x 198.0 mm
upper_body_a_part.stl
upper_body_b_part.stl
lower_spine_part.stl
