cbshbalance/slackline-balacing1/cad/encoder_pivot_bearing_v5.1.scad

// Standalone front bearing mount part.
// Edit shared dimensions in frame_master.scad so the assembly and this part stay linked.

part_mode = "bearing_mount";
part_cutaway = false;     // true shows the two 608 pockets and center land
print_export = true;      // use high quality $fn for STL export

include <frame_master.scad>
