cbshbalance/slackline-balacing1/cad/frame_master_v6_5.scad

// =====================================================================
// Slackline balancing robot frame and rope system v5
// 2026-07-19, from v4 (2026-07-13)
// v5 goal: ankle absolute encoder + AS5047P everywhere (AN25 retired)
//   - Sensing: two AS5047P 14-bit magnetic encoder MODULES (magnet+PCB,
//     non-contact) replace the AN25-analog + coupler chain. Required by
//     the full-physics sim: 0.088 deg quantization kills FWE, need 0.022.
//   - PIVOT (phi): rear socket shaft SHORTENED (48 -> rear_shaft_out=13,
//     no coupler engagement needed), diametral 6x2.5 magnet glued in a
//     pocket in the shaft tip, AS5047P PCB face-mounted on the (shorter)
//     rear bracket plate. Air gap is print geometry -> deterministic.
//   - ANKLE (alpha): the lower carbon bar is RETIRED. Each lower socket
//     is printed with an INTEGRATED 7.8 mm axle (upper-socket recipe):
//     corner node -> inner-ring hub stop -> through one 608 in the
//     carrier -> 6 mm into the carrier center cavity -> magnet pocket
//     in the tip. Both sockets carry a pocket (mirror parts, spare
//     mount); only the FRONT side gets the PCB. The carrier grows a
//     26x26 center cavity + flat bottom pad + window; a printed LID
//     (ankle_pcb_lid part) carries the AS5047P PCB on a post - slide in
//     through the window, two M3 screws. PCB first, then bearings, then
//     axles. No lock collars at the ankle: the two hub stops retain the
//     carrier axially (0.15 mm play per side).
//   - AXIAL RETENTION (v5.2, user redesign): the carrier center is OPEN
//     (two bearing housings + top bridge), so INNER LOCK COLLARS are
//     back. Each crank's inner ring is sandwiched hub-stop | ring |
//     inner collar -> positive mechanical retention BOTH ways, per
//     crank, no glue required (retaining compound stays optional).
//     Rationale kept from the v5.1 review: the 530 mm carbon diagonal is
//     a ~0.36 N/mm cantilever, so a bare slip fit walks out under
//     fold-cycle vibration (~5 N for the full 13 mm) - a hard stop is
//     mandatory. The collar nose is extended (2.6) to reach the ring
//     through the housing land bore; the clamp body sits in free space.
//     ASSEMBLY ORDER: bearings pressed -> slide both socket axles in
//     against the hub stops -> clamp the two INNER collars (this locks
//     the ankle) -> glue magnets -> screw the PCB T-bracket up into the
//     bridge -> crank top shafts through the pivot bearings -> TOP LOCK
//     COLLARS LAST (set the top chain's axial play).
//     BRING-UP CHECK: pen line across axle/collar/ring; re-check after
//     the first fold-cycle sessions.
//   - Wiring: pivot PCB is frame-fixed (SPI 6-wire to OpenCR crosses
//     top service loop -> rear diagonal bore -> lower loop, as before,
//     (*) 6-wire ribbon must pass the 5-6 mm bores - check). Ankle PCB
//     is ROBOT-fixed: exits the lid, straight up the lower spine - no
//     joint crossing at all.
//   - v5.3 (2026-07-19 evening): REAL MODULE = Coupang "AS5047P 14bit
//     SPI 42mm" (하이제니스), magnet included, side SMT 6-pin SPI socket
//     (P3) -> no soldering if a matching cable is sourced. 42x42 board,
//     4-corner hole grid (37x37 assumed, M3 pilot 2.7) - (*) MEASURE on
//     arrival. Consequences:
//       ANKLE: board top edge z=+21 -> bridge raised to z 23..31,
//       flange z0 22 -> 31, LOWER BODY +9 mm (robot_l1 250 -> 259, sim
//       L1 0.259; the printed lower spine is reused, the hip just rides
//       +9). Bridge end walls (z14..31) weld the raised bridge onto the
//       housings. Bracket is now an L: 46-wide plate on the full board
//       (4x M3) + aft bar under the bridge; the board's SMT connector
//       exits -X sideways through the open center.
//       PIVOT: bracket window couldn't hold a 42 board (+-20 interior)
//       -> frame goes asymmetric (bottom stays on the profile, top bar
//       raised to axis+35); board mounted connector-UP (down would hit
//       the profile). Old 2xM2 pilots + wire slot replaced by the 4xM3
//       grid, no slot.
// (previous v4 header follows)
// ---------------------------------------------------------------------
// Slackline balancing robot frame and rope system v4
// 2026-07-13, from v3 (2026-07-08, robot added 2026-07-11)
// v4 goal: OpenCR + 3S battery symmetric internal mounting in the 80 mm
//          upper-body box (was: external asymmetric standoffs + open tray)
//
// Design intent
//   - Keep the v2 pivot axis convention:
//       X = swing direction / depth
//       Y = pivot-axis direction / frame width
//       Z = vertical
//   - The slackline trapezoid swings about one Y-parallel top axis.
//   - The pivot mounts sit ON TOP of the top X rails (2026-07-11); the
//     axis is mount_rise above the frame top, which lifts the whole rope
//     and robot for bottom Y-brace and floor clearance.
//   - Phi is measured at the upper frame pivot by a frame-fixed shaft encoder.
//   - The encoder is NOT a structural bearing:
//       each upper pivot mount carries two 608 bearings,
//       a short shaft extension drives the encoder through a printed Oldham
//       solid sleeve coupler.
//   - Lower ankle bearings belong to the robot lower body, not to the rope.
//     The 8 mm lower carbon bar passes through two bearings in the robot body.
//   - Encoder wiring uses service loops:
//       top loop: frame-fixed encoder -> rotating upper carbon tube
//       bottom loop: rotating lower bar -> robot lower body
//
// Robot (2026-07-11)
//   - Lower body L1 = 250 (ankle axis -> hip axis),
//     upper body L2 = 350 (hip axis -> head top). The head rises above the
//     pivot axis on purpose; the alpha stop keeps it off the floor.
//   - Printed plate/box skeleton, lower body 80 / upper body 90 wide
//     with tapered waists at
//     the bracket interfaces. Ankle = printed carrier with two 608s on the
//     lower carbon bar, axially retained by two plain lock collars. No
//     rotation stop: with the raised pivot even a fully inverted fall
//     clears the floor and the Y braces, so alpha is unconstrained.
//   - Hip = XM430-W210-R with ROBOTIS FR12 frame hardware (2026-07-11):
//     an FR12-S101 style C bracket over the motor top ties the motor BODY
//     to the upper body; an FR12-H101 hinge C bracket grips the horn and
//     the HN12-I101 idler and bolts to the lower spine top cap. The mass
//     split stays near the 30:70 shape-optimization target.
//   - v4 (2026-07-13): OpenCR and the 3S lipo live INSIDE the upper-body
//     box (widened to 90; the head flares to 98 so the measured 84 mm
//     pack plus a lead bay for its Y-exiting wires fit between the Y
//     walls), symmetric about the swing plane. The board stands
//     vertically on a central bulkhead (plane normal to X, components
//     toward X-), the battery lies flat on a shelf at the very top (mass
//     stays high). The whole X- face of the B piece is a screwed-on
//     service door: board screws, USB/switches and the battery slide-in
//     are all reached from there. The B/A splice sleeve became two X-side
//     tongues so the 75 mm wide board slides up through the open bottom.
//     Only the AN25 analog wire crosses the ankle and hip joints through
//     small service loops.
//   - Dimensions marked with a star (*) must be checked against the real
//     XM430 drawing / OpenCR board before printing.
// =====================================================================

fast_preview = is_undef(print_export) ? true : !print_export;
$fn = fast_preview ? 24 : 64;

// -------------------- Display controls --------------------
phi_demo          = 15;     // rope swing angle about the Y axis [deg]
alpha_demo       = 180;    // robot lower body absolute lean preview [deg]
theta_demo       = 180;    // robot upper body absolute lean preview [deg]
rigid_rod_demo   = false;  // rope+robot swing as ONE rigid rod (alpha=theta=phi+180)
show_removed_top = false;  // ghost of the old top Y rails (off since 2026-07-11)
show_pivot_axis  = false;  // orange virtual pivot axis line
show_cables      = !fast_preview;
show_robot       = true;   // full balancing robot on the lower bar
show_bearing_cutaway = false; // cut windows in printed bearing housings so the pockets stay visible
show_lower_socket_cutaway = false; // use lower_socket_part.scad for socket cutaway inspection

// ====== Frame parameters - v6.3 ============================================
// Design notes live HERE, above the customizer section, because OpenSCAD's
// Customizer swallows the comment block preceding a variable and shows it as
// that variable's description. Below this banner every parameter gets exactly
// one short trailing comment.
//
// WHY 60 ALONG Y: the top Y rails were deleted (2026-07-11) for swing
//   clearance, so every post is a bare cantilever in Y. Depth cubed -> the
//   60 mm face belongs on Y. X sway still has its two X-Z portal frames.
// HARD CONSTRAINT: front/rear post CENTRE spacing = 580 mm, fixed by the
//   carbon diagonal length. frame_y therefore tracks post_y automatically.
// THE DECK: a mid-height X beam pair spanning the full depth. Upper posts sit
//   on it, legs hang below it, die-cast angle brackets hold both -> pulling
//   the legs off is 8 bolts. The deck is also the base frame of the short
//   build, and the Y rails relocate onto it in that mode.
// NOTHING may live between the deck and the pivot: that whole volume is swept
//   by the hanging robot. Checked in the console echo.

/* [Frame - profile] */
post_x = 30;               // post cross-section along X (3060) [mm]
post_y = 60;               // post cross-section along Y - the stiff way [mm]
xr_y = 60;                 // X rail width along Y (flush with post) [mm]
xr_z = 30;                 // X rail height along Z [mm]
yr_x = 30;                 // Y rail width along X [mm]
yr_z = 60;                 // Y rail height along Z - 3060 ON EDGE [mm]
slot_pitch = 30;           // T-slot cell pitch of the 30-series profile [mm]
prof_ctr_y = 580;          // BEARING centre spacing - FIXED by carbon tube [mm]
frame_x = 600;             // depth, swing direction [mm]

/* [Frame - heights] */
auto_height = true;        // derive the two heights from the clearances below
design_hang = 631;         // WHICH build to draw: hang_short or hang_tall [mm]
hang_short = 631;          // short robot - the A post set [mm]
hang_tall = 800;           // tall robot  - the B post set [mm]
share_posts = true;        // A-build leg = B-build gantry post (one stock length)
clear_stand = 50;          // SHORT build, standing: hardware to floor [mm]
clear_fall = 50;           // LAB build, fallen and hanging: head to floor [mm]
clear_swing = 60;          // radial margin, swept robot to the floor Y rail [mm]
upper_h_man = 521;         // manual deck-top to post-top, if auto_height off
legs_h_man = 778;          // manual floor to deck underside, if auto_height off
expo_mode = false;         // short build: legs and floor rails removed
mount_rise = 25;           // pivot axis above the top rail top face [mm]

/* [Frame - gantry] */
show_gantry = true;        // top stiffening gantry (removable)
gantry_phi = 60;           // swing angle the gantry must clear, ANY lean [deg]
gantry_clear = 80;         // margin above the reach envelope [mm]

/* [Frame - brackets] */
show_brackets = true;      // draw the die-cast angle brackets
bracket_L = 30;            // 30-series die-cast angle: leg length [mm]
bracket_w = 30;            // width - two of these cover a 60 mm face [mm]
bracket_t = 7;             // thickness [mm]
bracket_bolt_d = 6.6;      // M6 clearance [mm]

/* [Hidden] */
// *** T-SLOT REALITY (user catch 2026-08-12) ***
// A 3060 has NO slot on the centreline of its 60 mm face - the two cells put
// slots at 15 and 45 from the edge. The pivot bracket must therefore bolt to
// the INNER cell, at xr_slot_in from the rail's outer face, and the bearing
// centre has to sit on that same line. Keeping the 580 mm bearing spacing then
// forces frame_y = 580 + 2*45 = 670 (was 640 when I wrongly used the profile
// centreline). sag and upper_w are unaffected - only the posts move outboard.
xr_slot_in = xr_y - slot_pitch/2;              // 45 - inner T-slot centreline
frame_y = prof_ctr_y + 2 * xr_slot_in;         // 670
xrail_len = frame_x - 2 * post_x;
yrail_len = frame_y - 2 * post_y;   // Y rails butt into the POSTS
axis_x = frame_x / 2;
top_mount_front_y = xr_slot_in;
top_mount_rear_y  = frame_y - xr_slot_in;

plate_t   = 6;
boss_len  = 16;
brg_w     = 7;
brg_od    = 22;
brg_id    = 8;
brg_outer_race_id = 19;
brg_inner_race_od = 12;
shaft_d   = 8;             // nominal shaft = 608 inner ring bore [mm]
shaft_print_d = 7.8;       // PRINTED shaft diameter, front AND rear
                           // sockets (2026-07-13: easier slip into the
                           // 8.0 inner rings; the 7.85 print needed
                           // grinding, so go under, not over)
shaft_clearance_d = 8.4;

top_boss_len = 24;         // upper pivot housing length for two 608 bearings [mm]
top_bearing_offset = top_boss_len/2 - brg_w/2; // bearings press in from both open ends
top_center_bore_len = top_boss_len - 2 * brg_w; // center land bore between the two 608 bearings
top_center_bore_d = brg_outer_race_id; // keeps the printed land touching only the outer races
inner_ring_contact_d = 11.4; // contact faces stay smaller than the 608 inner-ring OD [mm]
inner_ring_contact_len = 1.2;

lock_collar_t = 6;
lock_collar_od = 15;
lock_collar_shaft_clearance = 2.0;
// v5.4 MEASURED: collar bore off the ACTUAL printed axle (shaft_print_d=7.8),
// not the nominal 8. Was shaft_d+0.25 = 8.25 -> 0.45 loose on the 7.8 axle.
// Snug clamp fit now; the split + bolt grips it. Raise +0.1 if the axle prints fat.
lock_collar_bore = shaft_print_d + 0.1;   // 7.9 (down from 8.25)
lock_bolt_d = 3.2;         // M3 clearance for the lock collar clamp bolt
lock_slit_w = 1.2;
lock_lug_w = 4.0;          // one top lug width across X
lock_lug_t = 6.0;          // lug thickness along the shaft axis
lock_lug_h = 7.8;
lock_lug_bite = 3.0;       // how far the lugs sink into the collar OD
lock_lug_inset = 1.0;      // moves lugs inward so they blend into the collar
lock_bolt_z = lock_collar_od/2 + lock_bolt_d/2 + 0.2;

bearing_center_to_rail = plate_t + boss_len - brg_w / 2;
front_pivot_y = top_mount_front_y + bearing_center_to_rail;
rear_pivot_y  = top_mount_rear_y  - bearing_center_to_rail;

// -------------------- Rope system parameters --------------------
carbon_od  = 8;
carbon_id  = 6;
diag_len   = 530;          // diagonal carbon tube corner-to-corner length [mm]
lower_socket_outer_d = 18;
lower_socket_insert_len = 27;
lower_bar_exposed_len = 100; // lower bar length visible between the two socket mouths
lower_w    = lower_bar_exposed_len + 2 * lower_socket_insert_len;
lower_pipe_insert_len = 10;
lower_pipe_stop_s = lower_socket_insert_len - lower_pipe_insert_len;
lower_socket_bore_d = 8.2; // measured carbon pipe is about 7.9 mm OD
lower_wire_bore_d = 5;
lower_wire_extra_len = 6;
lower_wire_elbow_s = 7;
lower_wire_elbow_overlap = 2;
lower_wire_elbow_steps = fast_preview ? 6 : 12;
lower_side_wire_from_mouth = 15;
lower_side_wire_s = lower_socket_insert_len - lower_side_wire_from_mouth;
lower_side_wire_bore_d = 5;
lower_side_wire_hole_len = lower_socket_outer_d + 8;

// v5.13: pipe-cup clamp on the ANKLE sockets too (same recipe as the top
// pivot cups v5.12: omega lugs + M3 cross bolt + wide slit + living-hinge
// relief). Bore stays 8.2; the clamp is placed on the OUTSIDE of the
// trapezoid (away from the carrier) on both sides, derived from the
// diagonal direction so the front/rear mirror-spare property is kept.
low_cup_clamp      = true;
low_cup_slit_w     = 2.2;
low_cup_lug_w      = 4.0;
low_cup_lug_t      = 6.0;
low_cup_lug_h      = 7.8;
low_cup_lug_bite   = 3.0;
low_cup_lug_inset  = 1.0;
low_cup_bolt_d     = 3.2;   // M3 clearance
low_cup_bolt_z     = lower_socket_outer_d/2 + low_cup_bolt_d/2 + 0.2;
low_cup_clamp_s    = lower_pipe_stop_s + lower_pipe_insert_len/2;  // = 22
low_cup_slit_past_stop = 2; // slit: mouth .. stop-2 (s 15..28)
low_cup_hinge_wall = 1.7;   // living-hinge wall left next to the bore

top_socket_inset = 30;     // clearance between bearing center and tube entry [mm]
top_front_y = front_pivot_y + top_socket_inset;
top_rear_y  = rear_pivot_y  - top_socket_inset;
upper_w     = top_rear_y - top_front_y;
top_socket_outer_d = 16;
top_socket_cup_len = 22;
top_pipe_insert_len = 10;
top_pipe_stop_s = top_socket_cup_len - top_pipe_insert_len;
top_socket_bore_d = lower_socket_bore_d;
top_socket_overlap = 5;
top_socket_miter_extend = top_socket_outer_d;
top_socket_miter_overlap = 0.15; // tiny overlap across the miter plane for a solid union
top_encoder_wire_bore_d = 6;
top_encoder_wire_bore_extra = 2;
top_encoder_wire_exit_s = top_pipe_stop_s - 4;
top_encoder_wire_side_hole_d = 5;
top_encoder_wire_side_hole_lift_z = 1;
top_encoder_wire_side_hole_len = top_socket_outer_d + 8;

// v5.9: lock-collar style clamp fused into the upper pivot pipe cups so the
// diagonal carbon tube is held mechanically (glue-free). Same omega-lug +
// top-slit + M3 cross-bolt recipe as lock_collar_at_y_n, but built on the
// cup itself around the pipe engagement zone (s = top_pipe_stop_s..cup_len).
top_cup_clamp      = true;
// v5.12: the v5.9 clamp bottomed out before gripping -- slit gap 1.2 allows
// only ~0.38 mm diametral squeeze and the solid 3.9 mm wall opposite the
// slit is too stiff to flex. Fix (bore kept at 8.2): wider slit for more
// closing travel + a hinge relief groove opposite the slit so the mouth
// actually closes when the M3 is tightened.
top_cup_slit_w     = 2.2;   // v5.12: 1.2 -> 2.2 (~0.7 mm diametral travel)
top_cup_lug_w      = 4.0;   // one lug width across local X
top_cup_lug_t      = 6.0;   // lug thickness along the cup axis
top_cup_lug_h      = 7.8;
top_cup_lug_bite   = 3.0;   // how far the lugs sink into the cup OD
top_cup_lug_inset  = 1.0;   // moves lugs inward so they blend into the cup
top_cup_bolt_d     = 3.2;   // M3 clearance
top_cup_bolt_z     = top_socket_outer_d/2 + top_cup_bolt_d/2 + 0.2;
top_cup_clamp_s    = top_pipe_stop_s + top_pipe_insert_len/2; // lug center: mid pipe engagement
top_cup_slit_past_stop = 2; // slit runs from the mouth to this far past the pipe stop
top_cup_hinge_relief = true; // v5.12: living-hinge groove opposite the slit
top_cup_hinge_wall = 1.7;    // wall left next to the bore at the hinge [mm]

dy_sag = (upper_w - lower_w) / 2;
sag    = sqrt(pow(diag_len, 2) - pow(dy_sag, 2));

bottom_front_y = frame_y / 2 - lower_w / 2;
bottom_rear_y  = frame_y / 2 + lower_w / 2;

// -------------------- Encoder and coupling parameters --------------------
rear_shaft_out = 13;       // structural shaft beyond rear bearing [mm]
                           // v5: SHORT again - no coupler engagement.
                           // 1.2 ring contact + 6 collar + 2 clearance +
                           // ~2 land + 2.2 magnet pocket = 13. Shorter =
                           // stiffer = less tip wobble under bearing play.
// v4 2026-07-13 (coupler REPRINT): encoder-side bore shortened 12 -> 9
// so the coupler end stays 0.6 mm clear of the bracket plate - the
// bracket keeps its printed 13 mm hole, no drilling. 23 = 12 + 2 + 9.
coupler_len = 23;
coupler_od = 14;
coupler_struct_bore_d = 8.1; // 8 mm structural shaft, close fit after sanding
coupler_encoder_bore_d = 6.1; // AN25 6 mm shaft, close fit after sanding
coupler_struct_bore_len = 12;
coupler_encoder_bore_len = 9;
coupler_clamp_bolt_d = 3.2; // M3 clearance, through-bolt and nut
coupler_slit_w = 1.0;
coupler_relief_slit_w = 1.0;
coupler_center_web_t = coupler_relief_slit_w;
coupler_lug_w = 4.0;
coupler_lug_t = 6.0;
coupler_lug_h = 7.8;
coupler_lug_bite = 3.0;
coupler_lug_inset = 1.0;

// -------------------- v5: AS5047P module + diametral magnet --------------------
// Generic parametric outline for an AS5047P breakout module.
// (*) MEASURE the real module on arrival (PCB size, hole grid, hole dia,
//     chip height, connector side) and update - all brackets follow these.
// v5.3: Coupang 하이제니스 "자기식 엔코더 모듈 AS5047P 14bit SPI 42mm"
// purple board, magnet included. 42 x 42 board, chip centered, FOUR
// corner mounting holes, side-mounted SMT connector (P3, 6-pin SPI) on
// the LEFT edge + unpopulated through-hole headers P1(SPI)/P2(ABI).
as_pcb_w  = 42;    // PCB width across X (*)
as_pcb_h  = 42;    // PCB height across Z (*)
as_pcb_t  = 1.6;
as_hole_dx = 34;   // v5.4 MEASURED: 4-corner grid, holes 4 mm in from each
as_hole_dy = 34;   //   edge => +-17 (was 37 assumed).
as_hole_d  = 3.4;  // v5.4 MEASURED: M3 CLEARANCE (was 2.7 self-tap). The
                   //   screw passes the bracket and threads into the
                   //   module's rear post end, so the plate is clearance.
                   // Convention (v4-proven): pilot = bolt OD - 0.3.
                   // Corner holes on the photo look M3-sized - MEASURE.
                   // The PCB's own holes are on the module, not printed.
as_conn_out = 6;   // SMT connector protrusion beyond the PCB edge (*)
as_conn_w   = 16;  // SMT connector width along the edge (*)
as_conn_t   = 6;   // SMT connector height off the chip-side face (*)
as_gap     = 1.5;  // magnet face -> chip/PCB face air gap (0.5..3 ok)
as_back_post = 8;  // v5.4 MEASURED: the real module has four ~8 mm posts on
                   // the PCB BACK (r3/d6), screw ends threaded. The mounting
                   // plate is set back this far so the posts span the gap;
                   // the chip<->magnet air gap (as_gap) is UNCHANGED.
mag_d = 6;             // diametral magnet 6 x 2.5 (glued)
mag_t = 2.5;
mag_pocket_d = 6.15;   // glue fit
mag_pocket_depth = 2.2; // magnet sits 0.3 proud of the tip face
mag_proud = mag_t - mag_pocket_depth;

// Dream Solution AN25-Analog angle sensor, outline dimensions from datasheet.
// v5: RETIRED from the assembly (kept for reference/printed-part archive).
enc_shaft_d    = 6;
enc_shaft_len  = 14.6;
enc_body_d     = 25;
enc_body_len   = 17;
enc_face_t     = 2.0;
enc_mount_bcd  = 20;
enc_mount_angles = [45, 135, 225, 315];
enc_bolt_d     = 3.2;      // M3 clearance / printed pilot hole
enc_center_clearance_d = 13.0;
enc_connector_w = 14;
enc_connector_len = 13.2;
enc_connector_h = 6.3;

enc_bracket_t = 5;
enc_driver_access_d = 12;       // screwdriver access through the lower face for M5 rail bolts
enc_rail_bolt_x = 20;
enc_driver_access_edge_meat = 3;
enc_bracket_w = max(
    enc_body_d + 22,
    enc_mount_bcd + 22,
    2 * (enc_rail_bolt_x + enc_driver_access_d/2 + enc_driver_access_edge_meat)
);
// v5.3: the bracket window must clear the 42 mm AS5047P board (edge at
// axis +-21) AND its SMT connector, which is mounted rotated so it exits
// UP (tip ~ axis+27; DOWN would stab the aluminum profile the bracket
// sits on). The frame goes asymmetric: bottom face stays on the profile
// top (axis - mount_rise), the top bar rises to clear board + connector.
enc_bracket_h_dn = mount_rise;               // 25, bottom face on profile
enc_bracket_h_up = as_pcb_h/2 + as_conn_out + 3 + enc_bracket_t;  // 35
enc_bracket_h = enc_bracket_h_dn + enc_bracket_h_up;  // total 60

rear_outer_bearing_y = rear_pivot_y + top_bearing_offset + brg_w / 2;
rear_shaft_tip_y     = rear_outer_bearing_y + rear_shaft_out;

// v5 chain (AS5047P, non-contact): shaft tip -> 0.3 proud magnet ->
// as_gap air gap -> PCB front(chip) face -> PCB back on the plate INNER
// face -> plate. The PCB screws to the plate inner face with 2 x M2
// self-taps; nothing engages the shaft, so NO coupler and no axial chain
// tolerance - the air gap is pure print geometry.
enc_plate_in_y  = rear_shaft_tip_y + mag_proud + as_gap + as_pcb_t + as_back_post;  // v5.4 +8 standoff
enc_plate_out_y = enc_plate_in_y + enc_bracket_t;
as_pivot_pcb_y  = rear_shaft_tip_y + mag_proud + as_gap;  // PCB front face
// legacy aliases still used by the service loop / echo:
enc_face_y      = enc_plate_out_y;
enc_rear_y      = enc_plate_out_y;
enc_tip_y       = rear_shaft_tip_y;
coupler_end_y   = rear_shaft_tip_y;    // retired, kept for echo aliases
coupler_start_y = rear_shaft_tip_y;

// -------------------- Robot parameters --------------------
// Robot local frame: origin at the ankle (lower bar) axis, +Z up to the head.
// Mass targets (shape optimization 2026-06-15): lower:upper ~ 30:70,
// equipment high on the upper body, ankle kept light.
robot_l1 = 259;            // ankle axis -> hip axis [mm]. v5.3: 250 -> 259,
                           // the ankle carrier flange rose +9 mm for the
                           // 42 mm AS5047P board; the printed lower spine
                           // is reused unchanged, so the hip moves up by
                           // the same 9 mm. Sim params_v19 L1 = 0.259.
robot_l2 = 372;            // hip axis -> head top, battery included [mm].
                           // v5.2 bodyB: 350 -> 372 (+22). The battery
                           // shelf / head is RAISED so the shelf no
                           // longer covers the OpenCR top edge: the
                           // board-top clearance grows 3 -> 25 mm for
                           // extra cable connections (user request
                           // 2026-07-24). The board itself does NOT move
                           // (ocr_center_z unchanged -> ELL_IMU same);
                           // only everything above it rides +22.
                           // Print check: bodyB piece = 221 mm < 256
                           // (Bambu X1C). Sim/FW: update params L2
                           // 0.350 -> 0.372 (+ mass re-measure).
                           // TRADE-OFF (see assembly echo): inverted-
                           // hang floor clearance 132.2 -> 110.2 mm
                           // (still safe); the RIGID-ROD full-sweep
                           // margin vs the bottom Y brace goes NEGATIVE
                           // (-15.5 mm) -> violent hanging swings are
                           // now only safe below the phi limit printed
                           // in the assembly echo (~+-18.4 deg).
                           // Upright balancing is unaffected.
hip_z    = robot_l1;

// XM430-W210-R outline. The motor BODY is attached to the upper body
// (mass split) through an FR12-S101 style C bracket over the motor top;
// the horn and the HN12-I101 idler ("fake horn") are gripped by an
// FR12-H101 hinge C bracket that bolts to the lower spine top cap.
// (*) all bracket dimensions: verify on the ROBOTIS drawings / real parts.
xm_w = 28.5;               // case width  (X) [mm]
xm_len = 46.5;             // case length (Z) [mm]
xm_dep = 34.0;             // case depth  (Y) [mm]
xm_axis_from_end = 14.25;  // horn axis to the near case end [mm] (*)
xm_horn_od = 21.5;         // exposed horn / idler diameter (*)
xm_horn_lift = 3.5;        // horn face above the case surface (*)

// FR12-H101 hinge frame (lower-body side, purchased part, modeled approx).
h101_t = 2.0;              // sheet thickness (*)
h101_axis_to_web = 24;     // horn axis to the web INNER face (*)
h101_arm_top = 14;         // arm extent above the horn axis (*)
h101_arm_w = 28;           // arm width along X (*)
h101_web_x = 28;           // web width along X (*)
h101_web_holes_dx = 16;    // web mounting hole grid, M2.5 (*)
h101_web_holes_dy = 8;     // (*)
h101_bolt_d = 2.8;         // M2.5 clearance

// FR12-S101 style body bracket (upper-body side, purchased part, approx).
s101_t = 2.0;              // sheet thickness (*)
s101_arm_h = 18;           // side arms down the motor X faces (*)
s101_top_holes_dx = 16;    // top plate hole grid, M2.5 (*)
s101_top_holes_dy = 8;     // (*)

// Printed ankle bearing carrier. The two 608s press in from both end faces,
// the lower carbon bar runs through their inner rings (thin tape/retainer
// glue on the 7.9 mm carbon bar takes up the last of the slop).
// Bar assembly order: front socket | lock collar | carrier(+bearings) |
// lock collar | rear socket - slide everything on before the second glue-up.
// No rotation stop: with the raised pivot the robot clears the floor even
// fully inverted, so alpha is free and two plain lock collars suffice.
// Wide bearing spacing: roll (X-axis) stiffness of the robot on the bar
// comes from this spacing, matched to the 80 mm wide foot section.
// Bar budget: carrier 80 + two lock collars 14.4 = 94.4 of the 100 mm
// exposed bar, ~2.8 mm slack to each socket mouth (tight but fine).
rb_spacing = 73;                          // 608 pair spacing on the bar:
                                          // bearing OUTER faces span
                                          // 73 + 7 = 80 = the body width
carrier_len = rb_spacing + brg_w;         // pockets open to the end faces
carrier_boss_d = 44;   // v5: 40 -> 44, room for the 26x26 center cavity
carrier_flange_z0 = as_pcb_h/2 + 2 + 8;   // v5.3: 31. Raised so the 42 mm
                       // AS5047P board (top edge z=+21) clears the bridge
                       // (2 mm air) with an 8 mm bridge on top. Was
                       // boss_d/2 = 22 -> the LOWER BODY GREW +9 mm;
                       // robot_l1 and the sim L1 were bumped to match.
carrier_flange_t = 6;
carrier_flange_x = 52;
carrier_flange_y = 80;     // flange flush with the 80 mm foot (= boss
                           // length, since rb_spacing widened to 73)
carrier_bolt_dx = 20;
carrier_bolt_dy = 25;
carrier_bolt_d = 3.4;                     // M3 clearance to the spine flange

// Lower spine: printed box column, carrier flange -> H101 web cap.
// The body is 80 mm wide from the FOOT all the way up (roll-stability
// request 2026-07-11); only the waist tapers down to the narrow
// FR12-H101 web cap.
lsp_x = 34;
lsp_y_top = 41;            // narrow width at the H101 web cap
lsp_y_wide = 80;           // robot body width, foot included
lsp_wall = 3;
lsp_z0 = carrier_flange_z0 + carrier_flange_t;
lsp_cap_t = 4;
lsp_z1 = hip_z - h101_axis_to_web - h101_t;  // cap top face = web outer face
lsp_flare2 = 170;          // waist taper 80 -> 41 over flare2..flare3
lsp_flare3 = 210;
lsp_win_w = 46;  lsp_win_h = 32;  lsp_win_pitch = 46;

// Upper body: box spine, printed as two pieces A/B. The A piece starts
// ABOVE the motor: its bottom cap bolts onto the FR12-S101 top plate
// (kept at bracket width), then the body tapers out to 80 mm wide.
usp_x = 38;  usp_wall_x = 4.0;
usp_y = 40;  usp_wall_y = 2.5;     // hip-side width, matches the S101 plate
usp_y_wide = 90;                   // upper body width (v4: 90 so the 84
                                   // battery fits fully inside; the FOOT
                                   // stays 80 - bar roll stance)
usp_y_head = 98;                   // battery-bay head, flared wider for
                                   // the LEAD BAY (see battery notes)
head_flare_z0 = 542;               // head flare 90 -> 98
head_flare_z1 = 552;
usp_cap_t = 4;
usp_z0 = hip_z + xm_len - xm_axis_from_end + s101_t;  // S101 top plate face
usp_flare0 = usp_z0 + 16;          // taper start
usp_flare1 = usp_flare0 + 50;      // taper end, 80 mm wide from here up
usp_split_z = 445;                 // A/B splice height (bed-size driven;
                                   // v4: lowered 460 -> 445 so the 105 mm
                                   // OpenCR fits above the splice tongues.
                                   // B piece is 190 tall incl. tongues -
                                   // fits the Bambu X1C (256 Z), upright)
usp_sleeve_len = 35;
usp_z1 = hip_z + robot_l2;         // head top, local z
usp_win_w = 50;  usp_win_h = 38;  usp_win_pitch = 55;
splice_bolt_d = 3.4;

// -------- v4 internal equipment bay (upper body B piece) --------
// OpenCR 1.0 (105 x 75, ~60 g) stands VERTICALLY INSIDE the body on a
// central bulkhead: board plane normal to X (the swing plane), so its mass
// sits on the swing centerline. Components face X- toward the service
// door; the 4 board screws drive in from the door side.
// (*) hole spacing + tallest component: measure the real board.
ocr_l = 105;  ocr_w = 75;  ocr_t = 1.6;
ocr_hole_dz = 96;          // (*)
ocr_hole_dy = 66;          // (*)
ocr_comp_h = 13;           // tallest component on the -X face (*)
ocr_door_gap = 1.5;        // component tips to the door inner face
bulk_t = 3;                // central bulkhead plate thickness
// Board BACK face x, derived so the component tips just clear the wall:
ocr_back_x = -usp_x/2 + usp_wall_x + ocr_door_gap + ocr_comp_h + ocr_t;

// v5.2 bodyB OpenCR mount = TAPE PAD + BOTTOM SEATING LEDGE (the snap
// rivets are RETIRED - tongue/rivet era problems: leg breakage, blocked
// insertion, wiring interference; see 06/07 project logs). The bulkhead
// is ADVANCED so its FRONT FACE is the board back plane: the whole face
// is one big taping pad (double-sided "monster" tape), and a small
// ledge under the board bottom edge takes the weight + sets the height.
// The board goes in through the OPEN X- face (no door anymore).
bulk_x0 = ocr_back_x;      // bulkhead front face = board back plane (tape pad)
seat_t = 6;                // seating ledge protrusion in front of the pad
seat_h = 6;                // ledge height below the board bottom edge
seat_w = 60;               // ledge width along Y (under the 75 board) (*)
// (90 body) interior is 85 wide vs the 75 board: the ledge + tape pad
// alone locate the board, no wall grooves needed.
// v5.5 X-ONLY OPEN FACE (CoM request 2026-07-25): v5.4's three-side
// bay (X- wall + both Y-wall front strips removed) pushed the shell
// CoM to x +7.4 - too far behind the swing centerline for the user's
// taste. v5.5 RESTORES both Y walls ("z축 방향의 면들") to full
// section and keeps ONLY the X- face open, at the v5.3 full interior
// width (no lips): opening 85 in the 90 zone (vs the 75 board), 93 in
// the head. Shell CoM comes back toward center (~x +6) and the closed
// box section (both Y walls + X+ wall + bulkhead) is fully restored.
// Trade-off (accepted): in-plane edge plugs on the board's Y edges
// have no straight lateral path again - side cables approach at an
// angle through the wide front opening.
lip_ret_y = 0;             // v5.3+: no lips - fully open X- face
// v5.5: the v6-era POWER-TOGGLE SLOT in the shelf front edge is
// RETIRED. The shelf keeps only two side rails (see shelf_rail_w) and
// its whole middle is open - that opening IS the switch bay: the
// power toggle / OpenCR top-edge switch sits in the open middle,
// reached from the front, wiring drops straight to the board top.
// (tsl_* params kept for reference only - no geometry uses them.)
tsl_w = 13;                // (retired v5.5) toggle slot width along Y
tsl_back_x = 13;           // (retired v5.5) slot depth from shelf front
tsl_y = -20;               // (retired v5.5) slot center Y
// v5-era A-B SPLICE = CLOSED TELESCOPING SLEEVE (replaces the two
// X-side tongues, which broke at the roots). A closed thin-wall box on
// the bottom of B slides down into A's interior; a flare above the
// split welds the sleeve into all four B walls. Two cross bolts as
// before. The OpenCR no longer passes through here (it enters through
// the open X- face), so the closed section costs nothing.
slv_clr  = 0.3;            // per-side telescoping clearance into A
slv_wall = 2.5;            // sleeve wall thickness
slv_flare = 8;             // flare weld height above the split

// 3S lipo INSIDE the flared head on a shelf (mass on the very top).
// MEASURED pack 84 x 34 x 25, fully internal. BOTH leads (charge + T-plug
// output) leave the Y+ narrow end face pointing along Y, so the pack
// butts on the Y- wall (positive stop) and the head is flared to 98 to
// leave an 8.5 mm LEAD BAY in front of the Y+ end: the leads bend there.
// The output lead turns down inside the bay to the board; the short
// ~20 mm charge lead hangs out through the charge window in the Y+ head
// wall - charging in place, nothing to open. Y+ retention: foam pad in
// the lead bay + the strap (travel is capped at the bay depth anyway (*)).
// The pack slides in along X through the door's battery-bay opening.
bat_x = 25;  bat_y = 84;  bat_z = 34;    // 25 across X, 84 along Y (*)
bat_y0 = -(usp_y_head/2 - usp_wall_y) + 0.5;  // butted on the Y- head wall
bat_y_mid = bat_y0 + bat_y/2;                 // pack center y (= -4)
chg_win_x = 20;            // (*) charge window; recenter on the real lead
chg_win_z = 16;
bat_top_gap = 2;
shelf_t = 4;
bat_z1 = usp_z1 - usp_cap_t - bat_top_gap;
bat_z0 = bat_z1 - bat_z;
shelf_z0 = bat_z0 - shelf_t;
// v5.5 SIDE-RAIL SHELF: the full shelf plate is replaced by two side
// rails along the Y walls ("z축 방향의 면들 쪽 벽만 유지") - the whole
// middle between them is OPEN. That middle opening is the SWITCH BAY
// (power toggle sits there, reached from the front) and a straight
// wiring drop from the battery to the board-top edge (25 mm cable
// room). The 84 mm pack lies across Y and rests on both rails: Y-
// end full on the rail (butted on the Y- head wall), Y+ end over the
// rail next to the lead bay. The bulkhead top edge still props both
// rails from below (|y| 33..44). The old central strap slots and the
// toggle slot lived in the removed middle - straps move onto the
// rails (one pair per rail), toggle slot retired (see tsl_*).
shelf_rail_w = 15;         // each side rail width along Y (middle
                           // opening = usp_y_head - 2 - 2*15 = 66)
strap_slot_w = 3;
strap_slot_l = 8;          // v5.5: 16 -> 8, fits inside a 15 rail

// v5.2 bodyB: the shelf used to sit 3 mm over the board top edge and
// COVERED it - no room to land extra cables on the board top. The shelf
// (and the whole head) is raised +22 via robot_l2, and the clearance
// over the board top is opened to 25 mm. Net: ocr_center_z is UNCHANGED
// (565+22-25 = 540-... same 509.5 center), so ELL_IMU stays put.
ocr_top_gap = 25;          // cable room over the board top edge (was 3)
ocr_center_z = shelf_z0 - ocr_top_gap - ocr_l/2;
ocr_bot_z = ocr_center_z - ocr_l/2;   // board bottom edge (ledge top)

// X- service door: one T-shaped plate over the whole bay. Top edge
// tucks into a rebate under the top cap (no top screws - the cap edge is
// too thin to thread); then 3 x 2 M3 self-taps drive into wall bosses
// (~9 mm engagement). No nuts anywhere on the door. Board screws / USB /
// switches / wiring are reached through the opening.
door_t = 3;
door_z0 = usp_split_z + 5;
door_z1 = bat_z1;
door_open_y = 66;          // opening width between the Y-wall lips
door_lip_z = 4;            // plate overlap beyond the opening, top/bottom
door_w = 88;               // plate width over the board zone
door_w_top = 97;           // plate width over the flared battery bay
door_screw_y = 36;         // screw line inside the 7 mm side lands
door_bolt_d = 2.7;         // M3 self-tap pilot in the wall

// -------------------- Colors --------------------
c_profile = [0.74, 0.76, 0.78];
c_joint   = [0.35, 0.45, 0.62];
c_seg_leg = [0.42, 0.56, 0.68];   // stage 1 - legs      (slate blue)
c_seg_mid = [0.82, 0.83, 0.85];   // stage 2 - mid posts (light aluminium)
c_seg_top = [0.62, 0.74, 0.52];   // stage 3 - gantry posts (sage)
c_ghost   = [1.00, 0.20, 0.15, 0.18];
c_mount   = [0.95, 0.47, 0.12];
c_socket  = [0.76, 0.05, 0.08];
c_carbon  = [0.08, 0.08, 0.08];
c_bearing_outer = [0.18, 0.18, 0.18];
c_bearing_inner = [0.75, 0.75, 0.72];
c_encoder = [0.05, 0.18, 0.35];
c_coupler = [0.98, 0.72, 0.15];
c_robot   = [0.10, 0.35, 0.85, 0.45];
c_rlow    = [0.25, 0.50, 0.90];
c_rup     = [0.30, 0.72, 0.45];
c_cable   = [0.02, 0.02, 0.02];
c_cable2  = [0.05, 0.18, 0.95];

// -------------------- Vector helpers --------------------
function vlen(v) = sqrt(v[0]*v[0] + v[1]*v[1] + v[2]*v[2]);
function unit(v) = v / vlen(v);
function add3(a,b) = [a[0]+b[0], a[1]+b[1], a[2]+b[2]];
function rot_y(p,a) = [
    p[0] * cos(a) + p[2] * sin(a),
    p[1],
   -p[0] * sin(a) + p[2] * cos(a)
];

// -------------------- Primitive helpers --------------------
module cyl_y(h, d, center=true) {
    rotate([-90, 0, 0]) cylinder(h=h, d=d, center=center);
}

module cyl_x(h, d, center=true) {
    rotate([0, 90, 0]) cylinder(h=h, d=d, center=center);
}

module rod_between(p1, p2, d=4) {
    hull() {
        translate(p1) sphere(d=d);
        translate(p2) sphere(d=d);
    }
}

module capsule_between(p1, p2, d=4) {
    hull() {
        translate(p1) sphere(d=d);
        translate(p2) sphere(d=d);
    }
}

module cylinder_between(p1, p2, d=4) {
    v = p2 - p1;
    l = vlen(v);
    translate(p1)
        rotate(a=acos(v[2] / l), v=[-v[1], v[0], 0])
            cylinder(h=l, d=d, center=false);
}

module yz_halfspace(p, n, positive=true, size=1000) {
    nn = unit(n);
    a = atan2(nn[2], nn[1]);
    translate(p)
        rotate([a, 0, 0])
            translate([0, (positive ? 1 : -1) * size/2, 0])
                cube([size, size, size], center=true);
}

module mitered_cylinder_between(p1, p2, d, plane_p, plane_n, positive=true, overlap=0) {
    n = unit(plane_n);
    cut_p = positive ? plane_p - n * overlap : plane_p + n * overlap;
    intersection() {
        cylinder_between(p1, p2, d=d);
        yz_halfspace(cut_p, n, positive=positive);
    }
}

function bezier2(p0, p1, p2, t) =
    p0 * pow(1 - t, 2) + p1 * (2 * (1 - t) * t) + p2 * pow(t, 2);

module curved_wire_elbow(p_corner, u1, u2, radius_s, d=5, steps=12) {
    p0 = p_corner + u1 * radius_s;
    pc = p_corner;
    p2 = p_corner + u2 * radius_s;

    for (i = [0 : steps - 1]) {
        hull() {
            translate(bezier2(p0, pc, p2, i / steps))
                sphere(d=d);
            translate(bezier2(p0, pc, p2, (i + 1) / steps))
                sphere(d=d);
        }
    }
}

module tube_path(points, d=2, col=c_cable) {
    color(col)
    for (i = [0 : len(points) - 2])
        rod_between(points[i], points[i+1], d);
}

module arc_cable_y(center, radius, yoff, a0, a1, d=2, col=c_cable, n=24) {
    pts = [
        for (i = [0:n])
        [
            center[0] + radius * cos(a0 + (a1 - a0) * i / n),
            center[1] + yoff,
            center[2] + radius * sin(a0 + (a1 - a0) * i / n)
        ]
    ];
    tube_path(pts, d=d, col=col);
}

// ============ DERIVED HEIGHTS - v6.5 =========================================
// Order matters: OpenSCAD evaluates file-scope assignments top to bottom, so
// everything a formula needs must already be assigned above it.
ankle_drop = carrier_boss_d / 2;    // carrier boss below the ankle axis (22)
gantry_h   = max(xr_z, yr_z);       // gantry rectangle depth in Z
post_cap   = 40;                    // post left proud above the gantry
gantry_len = design_hang;           // the frame follows design_hang

// Everything is rounded UP to 5 mm so the cut list has no decimals. Rounding
// up only ever adds clearance.
function r5(x) = ceil(x / 5) * 5;
upper_h = auto_height ? r5(clear_stand + sag + ankle_drop - xr_z - mount_rise)
                      : upper_h_man;

// GANTRY HEIGHT - REACH ENVELOPE, not the upright head. What strikes the
// gantry Y beam is the MIDDLE of a leaning robot: at phi=90 a lean of only
// -23..-27 deg puts the torso through it. So for every swing angle take the
// highest point the robot can reach ANYWHERE inside the Y beam's X band -
// a disc of radius design_hang about the ankle, clipped to that band.
function g_ax(ph)   = axis_x + sag * sin(ph);
function g_dx(ph)   = max(0, g_ax(ph) - frame_x, (frame_x - yr_x) - g_ax(ph));
function g_rise(ph) = -sag * cos(ph)
                    + sqrt(max(0, pow(gantry_len, 2) - pow(g_dx(ph), 2)));

// legs_h must satisfy BOTH: the fallen robot clears the floor, AND the rigid
// rope+robot sweep clears the floor Y rail (whose top sits at xr_z + yr_z).
des_half_x = usp_x/2 + 2;
function f_legs(h) = max(
      clear_fall + sag + h - xr_z - mount_rise - upper_h,
      sqrt(pow(sqrt(pow(sag + h, 2) + pow(des_half_x, 2)) + clear_swing, 2)
           - pow(axis_x - yr_x, 2)) + yr_z - mount_rise - upper_h);
function f_grise(h) = round((max([for (i = [0 : 2 : gantry_phi])
      -sag * cos(i) + sqrt(max(0, pow(h, 2) - pow(g_dx(i), 2)))]) + gantry_clear) / 10) * 10;
function f_gpost(h) = r5(f_grise(h) + mount_rise + gantry_h + post_cap);

// ---- the two orderable post sets --------------------------------------
// share_posts makes the SHORT build's leg the same stock length as the TALL
// build's gantry post, so four bars cover both roles. Lengthening the short
// build's leg only buys extra floor and swing clearance, never less.
gpost_tall  = f_gpost(hang_tall);
gpost_short = f_gpost(hang_short);
leg_tall    = r5(f_legs(hang_tall) - xr_z);
leg_short   = r5(max(f_legs(hang_short) - xr_z, share_posts ? gpost_tall : 0));
is_tall     = design_hang >= hang_tall;
leg_len     = is_tall ? leg_tall   : leg_short;
gpost_len   = is_tall ? gpost_tall : gpost_short;

legs_h  = auto_height ? leg_len + xr_z : legs_h_man;
deck_z  = (expo_mode ? 0 : legs_h) + xr_z;
frame_z = deck_z + upper_h;
axis_z  = frame_z + mount_rise;

gantry_rise    = gpost_len - mount_rise - gantry_h - post_cap;
gantry_z0      = axis_z + gantry_rise;
post_top_z     = show_gantry ? gantry_z0 + gantry_h + post_cap : frame_z;
deck_bot_z     = deck_z - xr_z;
pivot_deck_bot = frame_z - xr_z;
// ============================================================================

// ============ Frame profiles - v6.5 ============
module xrail(len) { color(c_profile) cube([len, xr_y, xr_z]); }
module yrail(len) { color(c_profile) cube([yr_x, len, yr_z]); }

// 30-series die-cast angle bracket, canonical frame:
//   leg1  u in [0,t], v in [0,w], w in [0,L]   - bolts to a face at u=0,
//                                                member behind it at u<0
//   leg2  u in [0,L], v in [0,w], w in [0,t]   - bolts to a face at w=0,
//                                                member below it at w<0
// Every instance below is placed by bracket_at(P,u,v,w) and the whole joint
// list was verified numerically (56/56: each leg lands on a real member face,
// nothing buried inside an extrusion) before being written here.
module diecast_bracket() {
    color(c_joint) difference() {
        union() {
            cube([bracket_t, bracket_w, bracket_L]);
            cube([bracket_L, bracket_w, bracket_t]);
            translate([0, (bracket_w + 5)/2, 0]) rotate([90, 0, 0])
                linear_extrude(5)
                    polygon([[0,0], [bracket_L*0.8,0], [0,bracket_L*0.8]]);
        }
        translate([-1, bracket_w/2, bracket_L/2]) rotate([0,90,0])
            cylinder(h = bracket_t + 2, d = bracket_bolt_d);
        translate([bracket_L/2, bracket_w/2, -1])
            cylinder(h = bracket_t + 2, d = bracket_bolt_d);
    }
}

module bracket_at(P, u, v, w) {
    multmatrix([[u[0], v[0], w[0], P[0]],
                [u[1], v[1], w[1], P[1]],
                [u[2], v[2], w[2], P[2]],
                [0, 0, 0, 1]]) diecast_bracket();
}

// A post face meeting an X beam face. zf = the beam face, up = the post rises
// from it (bracket above) or hangs below it (bracket below).
module post_beam_brackets(sx, sy, zf, up) {
    xf = sx ? frame_x - post_x : post_x;
    u  = [sx ? -1 : 1, 0, 0];
    by = sy ? frame_y - xr_y : 0;
    for (yo = [0, slot_pitch])                       // the beam's two T-slots
        bracket_at([xf, by + yo, zf], u, [0, 1, 0], [0, 0, up ? 1 : -1]);
}

// A Y rail end gets TWO brackets, one on the rail's top face and one on its
// bottom face. Separated by yr_z they form a moment couple instead of a
// hinge, which is what actually stiffens the Y-sway path - the alternative
// would be an end anchor bolt. Both land on the post (the top one) or on the
// X beam directly below it (the bottom one).
module yrail_post_brackets(zbot, ztop) {
    for (sx = [0, 1]) for (sy = [0, 1]) {
        x0 = sx ? frame_x - yr_x : 0;
        yf = sy ? frame_y - post_y : post_y;
        u  = [0, sy ? -1 : 1, 0];
        bracket_at([x0, yf, ztop], u, [1, 0, 0], [0, 0,  1]);
        bracket_at([x0, yf, zbot], u, [1, 0, 0], [0, 0, -1]);
    }
}

module frame_assembly() {
    // ================= THREE STAGES OF Z POST =================
    // stage 1 legs         floor beam top -> deck underside   (LAB only)
    // stage 2 mid posts    deck top       -> pivot beam under (always)
    // stage 3 gantry posts pivot beam top -> gantry top       (with gantry)
    for (sx = [0, 1]) for (sy = [0, 1]) {
        px = sx ? frame_x - post_x : 0;
        py = sy ? frame_y - post_y : 0;

        if (!expo_mode)
            translate([px, py, xr_z])
                color(c_seg_leg) cube([post_x, post_y, deck_bot_z - xr_z]);
        translate([px, py, deck_z])
            color(c_seg_mid) cube([post_x, post_y, pivot_deck_bot - deck_z]);
        if (show_gantry)
            translate([px, py, frame_z])
                color(c_seg_top) cube([post_x, post_y, post_top_z - frame_z]);

        if (show_brackets) {
            if (!expo_mode) {
                post_beam_brackets(sx, sy, xr_z,      true);   // leg on floor beam
                post_beam_brackets(sx, sy, deck_bot_z, false); // leg under deck
            }
            post_beam_brackets(sx, sy, deck_z,        true);   // mid on deck
            post_beam_brackets(sx, sy, pivot_deck_bot, false); // mid under pivot beam
            if (show_gantry) {
                post_beam_brackets(sx, sy, frame_z,        true); // gantry post on pivot beam
                post_beam_brackets(sx, sy, gantry_z0 + xr_z, true); // gantry X rail top
            }
        }
    }

    // ---- FLOOR X beam pair (LAB): full depth, the legs stand on it ----
    if (!expo_mode) {
        translate([0, 0, 0])              xrail(frame_x);
        translate([0, frame_y - xr_y, 0]) xrail(frame_x);
    }

    // ---- DECK (cut plane 1) and PIVOT BEAM (cut plane 2) ----
    translate([0, 0, deck_bot_z])                   xrail(frame_x);
    translate([0, frame_y - xr_y, deck_bot_z])      xrail(frame_x);
    translate([0, 0, pivot_deck_bot])               xrail(frame_x);
    translate([0, frame_y - xr_y, pivot_deck_bot])  xrail(frame_x);

    // ---- Y rails: 3060 ON EDGE, butting the posts. LAB -> floor,
    //      EXPO -> relocated onto the deck. Never between deck and pivot.
    yz = expo_mode ? deck_z : xr_z;   // clears room for the bottom bracket
    translate([0, post_y, yz])              yrail(yrail_len);
    translate([frame_x - yr_x, post_y, yz]) yrail(yrail_len);
    if (show_brackets) yrail_post_brackets(yz, yz + yr_z);

    // ---- top stiffening gantry (leaves together with stage 3) ----
    if (show_gantry) {
        translate([post_x, 0, gantry_z0])              xrail(xrail_len);
        translate([post_x, frame_y - xr_y, gantry_z0]) xrail(xrail_len);
        translate([0, post_y, gantry_z0])              yrail(yrail_len);
        translate([frame_x - yr_x, post_y, gantry_z0]) yrail(yrail_len);
        if (show_brackets) yrail_post_brackets(gantry_z0, gantry_z0 + yr_z);
    }
}

// -------------------- Bearings and fixed upper mounts --------------------
module bearing_608_y() {
    // 608 bearing visual model: outer and inner races only.
    color(c_bearing_outer)
    difference() {
        cyl_y(brg_w, brg_od);
        cyl_y(brg_w + 0.2, brg_outer_race_id);
    }

    color(c_bearing_inner)
    difference() {
        cyl_y(brg_w + 0.1, brg_inner_race_od);
        cyl_y(brg_w + 0.3, brg_id);
    }
}

module upper_bearing_pair_y() {
    // Two independent 608 bearings in one printed upper pivot housing.
    // They are inserted from the two open ends; the center land bore is at the
    // outer-race inner diameter so the printed land preserves bearing spacing.
    for (yoff = [-top_bearing_offset, top_bearing_offset])
        translate([0, yoff, 0])
            bearing_608_y();
}

module top_pivot_bearing_mount(cutaway=show_bearing_cutaway) {
    plate_w = 58;
    plate_h = 52;
    flange_y = -bearing_center_to_rail - xr_slot_in;
    web_y    = -bearing_center_to_rail + (xr_y - xr_slot_in) - plate_t/2;

    color(c_mount)
    difference() {
        union() {
            // Flange bolted onto the TOP FACE of the remaining top X rail.
            translate([-plate_w/2, flange_y, -mount_rise])
                cube([plate_w, xr_y, 6]);

            // Vertical web rising from the rail top face to the bearing boss.
            translate([-plate_w/2, web_y, -mount_rise])
                cube([plate_w, plate_t, plate_h/2 + mount_rise]);

            // Bearing housing. One printed mount carries two separate 608 bearings.
            cyl_y(top_boss_len, brg_od + 10);

            // Small ribs make the printed part less floppy.
            for (sx = [-1, 1]) {
                hull() {
                    translate([sx * (plate_w/2 - 7), web_y + plate_t/2, -mount_rise + 5])
                        sphere(d=6);
                    translate([sx * 14, 0, 0])
                        sphere(d=10);
                }
            }
        }

        // Two 608 bearing pockets, open from the two ends for real assembly.
        for (yoff = [-top_bearing_offset, top_bearing_offset])
            translate([0, yoff, 0])
                cyl_y(brg_w + 0.35, brg_od + 0.35);

        // The opening between the two bearings matches the outer race ID.
        // The remaining annular land contacts the outer races and preserves
        // the spacing between the two pressed-in bearings.
        cyl_y(top_center_bore_len + 0.35, top_center_bore_d);

        // Continuous clearance for the rotating 8 mm shaft.
        cyl_y(top_boss_len + 2, shaft_clearance_d);

        // Preview/render cutaway. This avoids relying on transparent draw order
        // and keeps both bearings visible as separate parts.
        if (cutaway)
            translate([-(brg_od + 18)/2, -top_boss_len/2 - 1, 1])
                cube([brg_od + 18, top_boss_len + 2, brg_od + 12]);

        // M5 rail bolts down through the base flange into the rail top slot.
        for (xoff = [-20, 20])
            translate([xoff, -bearing_center_to_rail, -mount_rise - 3])
                cylinder(h=12, d=5.5);
    }
}

module rear_pivot_encoder_mount() {
    // Rear side is modeled as one clean printed part:
    // a side-open rectangular frame with the 608 bearing housing on one end
    // and the encoder mounting face on the other end.
    y_bearing_face = rear_pivot_y + top_boss_len/2;
    y0 = y_bearing_face - enc_bracket_t;
    y1 = enc_plate_out_y;   // rear plate outer face, as originally printed
    len_y = y1 - y0;
    w = enc_bracket_w;
    h = enc_bracket_h;
    t = enc_bracket_t;

    color(c_mount)
    difference() {
        union() {
            // Clean side-view frame, v5.3 asymmetric: bottom face on the
            // profile top, top bar raised to clear board + connector.
            // The sides stay open for assembly.
            translate([axis_x - w/2, y0, axis_z + enc_bracket_h_up - t])
                cube([w, len_y, t]);
            translate([axis_x - w/2, y0, axis_z - enc_bracket_h_dn])
                cube([w, len_y, t]);

            // Bearing-side vertical plate, merged into the bearing housing.
            translate([axis_x - w/2, y0, axis_z - enc_bracket_h_dn])
                cube([w, t, h]);

            // Encoder face: the rear surface is the encoder reference plane.
            translate([axis_x - w/2, y1 - t, axis_z - enc_bracket_h_dn])
                cube([w, t, h]);

            // Integrated 608 bearing housing on the rope side.
            translate([axis_x, rear_pivot_y, axis_z])
                cyl_y(top_boss_len, brg_od + 10);
        }

        // Two 608 pockets press in from the open ends; the center bore leaves
        // an annular land that locates only the outer races.
        for (yoff = [-top_bearing_offset, top_bearing_offset])
            translate([axis_x, rear_pivot_y + yoff, axis_z])
                cyl_y(brg_w + 0.35, brg_od + 0.35);

        translate([axis_x, rear_pivot_y, axis_z])
            cyl_y(top_center_bore_len + 0.35, top_center_bore_d);

        translate([axis_x, rear_pivot_y, axis_z])
            cyl_y(top_boss_len + 2, shaft_clearance_d);

        // v5.3: AS5047P PCB mount on the plate INNER face - FOUR M3
        // self-tap pilots on the 37 mm corner grid. The board is mounted
        // rotated +90 deg so its SMT connector (P3) points UP through the
        // open frame (tip ~ axis+27 < top bar interior +30); DOWN would
        // stab the aluminum profile. The old wire slot is gone - the
        // cable exits upward, then loops down the rear diagonal path.
        // v5.4+ THROUGH-HOLE guarantee: the four M3 clearance holes must
        // fully pierce the encoder plate (screws pass the plate and
        // thread into the module's rear 8 mm posts). The cut cylinder
        // overshoots the plate by 2 mm on BOTH faces (pure air on either
        // side at the hole grid), so the holes stay cleanly open even if
        // the plate position/thickness shifts in a future edit.
        for (sx = [-1, 1]) for (sz = [-1, 1])
            translate([axis_x + sx * as_hole_dx/2, y1 - t/2,
                       axis_z + sz * as_hole_dy/2])
                cyl_y(t + 4, as_hole_d);

        // M5 rail bolts down through the BOTTOM bar into the rear rail top
        // slot (the bracket now sits on top of the profile).
        for (xoff = [-enc_rail_bolt_x, enc_rail_bolt_x])
            translate([axis_x + xoff, top_mount_rear_y,
                       axis_z - enc_bracket_h_dn - 0.2])
                cylinder(h=t + 0.4, d=5.5);

        // Matching access holes through the TOP bar so a driver can reach
        // the M5 rail bolts from above during assembly.
        for (xoff = [-enc_rail_bolt_x, enc_rail_bolt_x])
            translate([axis_x + xoff, top_mount_rear_y,
                       axis_z + enc_bracket_h_up - t - 0.2])
                cylinder(h=t + 0.4, d=enc_driver_access_d);

    }
}

module upper_fixed_hardware() {
    // Front structural bearing bracket.
    translate([axis_x, front_pivot_y, axis_z])
        top_pivot_bearing_mount();

    // Rear bearing bracket and encoder support are one printed piece.
    rear_pivot_encoder_mount();

    // Bearings placed into the pockets: two 608 bearings per upper mount.
    translate([axis_x, front_pivot_y, axis_z]) upper_bearing_pair_y();
    translate([axis_x, rear_pivot_y, axis_z])  upper_bearing_pair_y();

    // v5: AS5047P module on the plate inner face + magnet in the shaft
    // tip. Non-contact - no coupler. v5.3: connector points UP.
    translate([axis_x, as_pivot_pcb_y, axis_z])
        as5047_pcb_vis(rot=90);
    translate([axis_x, rear_shaft_tip_y - mag_pocket_depth + mag_t/2, axis_z])
        color([0.45, 0.45, 0.48]) cyl_y(mag_t, mag_d);
}

// -------------------- v5: AS5047P module visual --------------------
module as5047_pcb_vis(rot=0) {
    // Local origin = PCB FRONT (chip) face center, chip toward -Y.
    // v5.3: 42 x 42 board with the SMT connector (P3) on the -X edge,
    // chip side. rot spins the board about its normal (holes are on a
    // symmetric 4-corner grid, so any 90-degree step is valid):
    //   rot=0   connector exits -X (ankle: sideways through the open center)
    //   rot=-90 connector exits -Z (pivot: straight down past the plate edge)
    rotate([0, rot, 0]) {
        color([0.55, 0.15, 0.55])                // purple PCB
            translate([-as_pcb_w/2, 0, -as_pcb_h/2])
                cube([as_pcb_w, as_pcb_t, as_pcb_h]);
        color([0.1, 0.1, 0.1])                   // chip, board center
            translate([0, -0.6, 0]) cube([5, 1.2, 5], center=true);
        color([0.9, 0.9, 0.9])                   // SMT connector, -X edge (*)
            translate([-as_pcb_w/2 - as_conn_out, -as_conn_t,
                       -as_conn_w/2])
                cube([as_conn_out + 4, as_conn_t, as_conn_w]);
    }
}

// -------------------- AN25 analog encoder and printed coupling --------------------
module encoder_AN25_analog() {
    // Local origin = encoder front face center. Shaft points toward -Y.
    color(c_bearing_inner)
        translate([0, -enc_shaft_len/2, 0])
        cyl_y(enc_shaft_len, enc_shaft_d);

    color([0.82, 0.82, 0.78])
    difference() {
        cyl_y(enc_face_t, enc_body_d);
        cyl_y(enc_face_t + 0.2, enc_center_clearance_d);
        for (a = enc_mount_angles) {
            translate([enc_mount_bcd/2 * cos(a), 0, enc_mount_bcd/2 * sin(a)])
                cyl_y(enc_face_t + 0.3, enc_bolt_d);
        }
    }

    color(c_encoder)
        translate([0, enc_body_len/2, 0])
        cyl_y(enc_body_len, enc_body_d);

    // Pins exit along the body SIDE (real AN25, unlike the first model);
    // their solder joints are what the 2 mm washers make room for.
    color("white")
        translate([0, enc_body_len - 5, enc_body_d/2 + 2.5])
        cube([10, 9, 5], center=true);
}

module coupler_clamp_lugs_y(yoff) {
    lug_x = coupler_slit_w/2 + coupler_lug_w/2 - coupler_lug_inset;
    lug_z = coupler_od/2 - coupler_lug_bite + coupler_lug_h/2;

    for (sx = [-1, 1])
        translate([sx * lug_x, yoff, lug_z])
            cube([coupler_lug_w, coupler_lug_t, coupler_lug_h], center=true);
}

module coupler_clamp_cuts_y(bolt_y, slit_y, slit_len, bore_d) {
    lug_z = coupler_od/2 - coupler_lug_bite + coupler_lug_h/2;
    bolt_z = coupler_od/2 + coupler_clamp_bolt_d/2 + 0.2;
    slit_bottom_z = 0;
    slit_top_z = lug_z + coupler_lug_h/2 + 0.3;
    slit_z = (slit_bottom_z + slit_top_z) / 2;
    slit_h = slit_top_z - slit_bottom_z;

    translate([0, bolt_y, bolt_z])
        cyl_x(2 * coupler_lug_w + coupler_slit_w + 2, coupler_clamp_bolt_d);

    translate([0, slit_y, slit_z])
        cube([coupler_slit_w, slit_len, slit_h], center=true);
}

module coupler_relief_slit_y(yoff, bore_d) {
    slit_bottom_z = 0;
    slit_top_z = coupler_od/2 + 0.3;
    slit_z = (slit_bottom_z + slit_top_z) / 2;
    slit_h = slit_top_z - slit_bottom_z;

    translate([0, yoff, slit_z])
        cube([coupler_od + 2, coupler_relief_slit_w, slit_h], center=true);
}

module coupler_center_top_clearance_y(center_len) {
    // The lower half of the center web is enough as an insertion stop.
    // Remove the upper half so no semicircular boss remains between clamps.
    translate([-(coupler_od + 2)/2, -(center_len + 0.2)/2, 0])
        cube([coupler_od + 2, center_len + 0.2, coupler_od + coupler_lug_h + 2]);
}

module solid_coupler_local(total_len=coupler_len, cutaway=false) {
    struct_len = min(coupler_struct_bore_len, total_len/2 - 0.4);
    encoder_len = min(coupler_encoder_bore_len, total_len/2 - 0.4);
    center_stop_len = total_len - struct_len - encoder_len;
    struct_slit_len = struct_len + center_stop_len - coupler_center_web_t;
    encoder_slit_len = encoder_len + center_stop_len - coupler_center_web_t;
    struct_slit_y = -total_len/2 + struct_len/2;
    encoder_slit_y = total_len/2 - encoder_len/2;
    struct_relief_y = -center_stop_len/2 - coupler_relief_slit_w/2;
    encoder_relief_y = center_stop_len/2 + coupler_relief_slit_w/2;
    struct_clamp_y = (-total_len/2 + struct_relief_y - coupler_relief_slit_w/2) / 2;
    encoder_clamp_y = (total_len/2 + encoder_relief_y + coupler_relief_slit_w/2) / 2;

    color(c_coupler)
    difference() {
        union() {
            cyl_y(total_len, coupler_od);
            coupler_clamp_lugs_y(struct_clamp_y);
            coupler_clamp_lugs_y(encoder_clamp_y);
        }

        // Blind bore for the 8 mm structural shaft side.
        translate([0, -total_len/2 + struct_len/2 - 0.05, 0])
            cyl_y(struct_len + 0.2, coupler_struct_bore_d);

        // Blind bore for the 6 mm encoder shaft side. The uncut center web
        // works as an insertion stop and keeps the coupler torsionally rigid.
        translate([0, total_len/2 - encoder_len/2 + 0.05, 0])
            cyl_y(encoder_len + 0.2, coupler_encoder_bore_d);

        // Through-bolt clamp cuts. No printed thread is required.
        coupler_clamp_cuts_y(struct_clamp_y, struct_slit_y, struct_slit_len, coupler_struct_bore_d);
        coupler_clamp_cuts_y(encoder_clamp_y, encoder_slit_y, encoder_slit_len, coupler_encoder_bore_d);

        // X-direction relief slits just outside the center stopper shoulder.
        // These decouple each clamp end from the rigid center stop so tightening
        // the through-bolts can actually close the bore.
        coupler_relief_slit_y(struct_relief_y, coupler_struct_bore_d);
        coupler_relief_slit_y(encoder_relief_y, coupler_encoder_bore_d);

        // Leave only the lower half of the center stopper.
        coupler_center_top_clearance_y(center_stop_len);

        if (cutaway)
            translate([-coupler_od/2 - 0.5, -total_len/2 - 0.5, 0])
                cube([coupler_od + 1, total_len + 1, coupler_od/2 + 1]);
    }
}

module solid_coupler_y(y0, y1) {
    len = y1 - y0;
    yc  = (y0 + y1) / 2;

    translate([axis_x, yc, axis_z])
        solid_coupler_local(len);
}

module solid_coupler_part(cutaway=false) {
    solid_coupler_local(coupler_len, cutaway=cutaway);
}

// -------------------- Rotating carbon trapezoid and sockets --------------------
module carbon_tube_between(p1, p2, od=carbon_od) {
    color(c_carbon)
    rod_between(p1, p2, od);
}

module lock_collar_at_y(face_y, dir=1) {
    lock_collar_at_y_n(face_y, dir, inner_ring_contact_len);
}

module lock_collar_at_y_n(face_y, dir, nose_len) {
    // Shaft lock collar. Only the small yellow nose touches the 608 inner ring;
    // the larger clamp body sits outside the bearing face. nose_len is
    // extended for the v5.2 ankle inner collars (reaches the ring through
    // the housing land bore, 11.4 OD inside the 19 bore).
    body_y = face_y + dir * (nose_len + lock_collar_t/2);
    total_t = nose_len + lock_collar_t;
    total_y = face_y + dir * total_t/2;
    lug_x = lock_slit_w/2 + lock_lug_w/2 - lock_lug_inset;
    lug_z = lock_collar_od/2 - lock_lug_bite + lock_lug_h/2;
    slit_bottom_z = lock_collar_bore/2 - 0.6;
    slit_top_z = lug_z + lock_lug_h/2 + 0.3;
    slit_z = (slit_bottom_z + slit_top_z) / 2;
    slit_h = slit_top_z - slit_bottom_z;
    color([1.0, 0.74, 0.10])
    difference() {
        union() {
            translate([0, face_y + dir * nose_len/2, 0])
                cyl_y(nose_len, inner_ring_contact_d);

            translate([0, body_y, 0])
                cyl_y(lock_collar_t, lock_collar_od);

            // Omega-style clamp lugs placed beside the top slit.
            // The bolt head and nut sit on the lug outer faces, not on a
            // shaved section of the round collar body.
            for (sx = [-1, 1])
                translate([sx * lug_x, body_y, lug_z])
                    cube([lock_lug_w, lock_lug_t, lock_lug_h], center=true);
        }

        translate([0, face_y + dir * (nose_len + lock_collar_t)/2, 0])
            cyl_y(nose_len + lock_collar_t + 0.4, lock_collar_bore);

        // Clamp bolt hole. It sits above the shaft bore and pulls the split
        // collar closed instead of passing through the shaft.
        translate([0, body_y, lock_bolt_z])
            cyl_x(2 * lock_lug_w + lock_slit_w + 2, lock_bolt_d);

        // Split cut from the OD into the shaft bore so tightening the bolt
        // actually clamps the collar onto the printed hub shaft.
        translate([0, total_y, slit_z])
            cube([lock_slit_w, total_t + 0.8, slit_h], center=true);
    }
}

module socket_inner_hub_face_at_y(face_y, inside_dir=1) {
    // This is part of the printed rope socket, not a loose spacer.
    // Its diameter is small enough to touch only the bearing inner ring.
    color(c_socket)
    translate([0, face_y + inside_dir * inner_ring_contact_len/2, 0])
        cyl_y(inner_ring_contact_len, inner_ring_contact_d);
}

module upper_socket(is_front=true, include_lock_collar=true) {
    pivot_y = is_front ? front_pivot_y : rear_pivot_y;
    tube_y  = is_front ? top_front_y : top_rear_y;
    dir     = is_front ? -1 : 1;  // direction to the outside of the frame
    inside_dir = -dir;
    outer_y = pivot_y + dir * (top_boss_len/2 + 5);
    inner_y = pivot_y - dir * (top_boss_len/2 + 6);
    outside_face_y = pivot_y + dir * top_boss_len/2;
    front_shaft_tip_y = outside_face_y + dir * (inner_ring_contact_len + lock_collar_t + lock_collar_shaft_clearance);
    shaft_tip_y = is_front ? front_shaft_tip_y : rear_shaft_tip_y;
    inside_face_y = pivot_y + inside_dir * top_boss_len/2;
    socket_start_y = inner_y - inside_dir * top_socket_overlap;

    color(c_socket)
    difference() {
        union() {
            // Shaft passing through both bearings in the mount, printed
            // slightly under 8 mm for a sand-to-fit slip in the inner rings.
            // Keep this as a flat-ended cylinder, not a sphere-ended hull.
            cylinder_between([0, inner_y, 0], [0, shaft_tip_y, 0], d=shaft_print_d);

            // Integrated socket hub face: the inside-side stop for the bearing
            // inner ring, assembled as one piece with the rope socket.
            socket_inner_hub_face_at_y(inside_face_y, inside_dir);

            y_bottom = is_front ? bottom_front_y : bottom_rear_y;
            p_top = [0, tube_y, 0];
            p_bot = [0, y_bottom, -sag];
            u = unit(p_bot - p_top);
            bridge_dir = [0, -inside_dir, 0];
            miter_n = bridge_dir - u;

            // Printed bridge from bearing axis to carbon tube entry.
            mitered_cylinder_between(
                [0, socket_start_y, 0],
                p_top - bridge_dir * top_socket_miter_extend,
                d=top_socket_outer_d,
                plane_p=p_top,
                plane_n=miter_n,
                positive=true,
                overlap=top_socket_miter_overlap
            );

            // Cylindrical carbon tube cup, directed down along the diagonal tube.
            mitered_cylinder_between(
                p_top - u * top_socket_miter_extend,
                p_top + u * top_socket_cup_len,
                d=top_socket_outer_d,
                plane_p=p_top,
                plane_n=miter_n,
                positive=false,
                overlap=top_socket_miter_overlap
            );

            // v5.9: omega clamp lugs fused onto the cup around the pipe
            // engagement zone (glue-free tube retention). Local frame: +Y
            // along the cup axis u (u is in the Y-Z plane, so a single
            // X-rotation maps +Y onto u and the clamp bolt stays global X).
            // v5.10: clamp_zf flips the rear clamp to local -Z so BOTH
            // sockets carry the lugs on the OUTSIDE of the bridge-cup bend
            // (away from the bearing side), matching the front.
            if (top_cup_clamp) {
                clamp_zf = is_front ? 1 : -1;
                lug_x = top_cup_slit_w/2 + top_cup_lug_w/2 - top_cup_lug_inset;
                lug_z = top_socket_outer_d/2 - top_cup_lug_bite + top_cup_lug_h/2;
                translate(p_top) rotate([atan2(u[2], u[1]), 0, 0])
                    for (sx = [-1, 1])
                        translate([sx * lug_x, top_cup_clamp_s, clamp_zf * lug_z])
                            cube([top_cup_lug_w, top_cup_lug_t, top_cup_lug_h],
                                 center=true);
            }
        }

        // Blind upper carbon-pipe socket. The pipe enters only
        // top_pipe_insert_len from the mouth and stops on a flat shoulder.
        y_bottom = is_front ? bottom_front_y : bottom_rear_y;
        p_top = [0, tube_y, 0];
        p_bot = [0, y_bottom, -sag];
        u = unit(p_bot - p_top);
        cylinder_between(
            p_top + u * top_pipe_stop_s,
            p_top + u * (top_socket_cup_len + 4),
            d=top_socket_bore_d
        );

        // v5.9: cup clamp cuts. Cross bolt above the cup OD pulls the split
        // mouth closed onto the carbon tube; the slit runs from the open
        // mouth back past the pipe stop so the clamped section can flex.
        // v5.10: cuts follow clamp_zf so the rear clamp sits on the
        // outside of the bend like the front.
        if (top_cup_clamp) {
            clamp_zf = is_front ? 1 : -1;
            lug_z = top_socket_outer_d/2 - top_cup_lug_bite + top_cup_lug_h/2;
            slit_bottom_z = top_socket_bore_d/2 - 0.6;
            slit_top_z = lug_z + top_cup_lug_h/2 + 0.3;
            slit_s0 = top_pipe_stop_s - top_cup_slit_past_stop;
            slit_s1 = top_socket_cup_len + 1;   // overshoot past the mouth
            translate(p_top) rotate([atan2(u[2], u[1]), 0, 0]) {
                translate([0, top_cup_clamp_s, clamp_zf * top_cup_bolt_z])
                    cyl_x(2 * top_cup_lug_w + top_cup_slit_w + 2, top_cup_bolt_d);
                translate([0, (slit_s0 + slit_s1)/2,
                           clamp_zf * (slit_bottom_z + slit_top_z)/2])
                    cube([top_cup_slit_w, slit_s1 - slit_s0,
                          slit_top_z - slit_bottom_z], center=true);
                // v5.12: hinge relief opposite the slit. Removes the outer
                // part of the wall on the far side over the same s-range,
                // leaving a top_cup_hinge_wall-thick arc next to the bore
                // as a living hinge, so bolt torque closes the mouth
                // instead of fighting the full 3.9 mm wall.
                if (top_cup_hinge_relief) {
                    relief_out_z = top_socket_bore_d/2 + top_cup_hinge_wall;
                    relief_span = top_socket_outer_d/2 - relief_out_z + 1;
                    translate([0, (slit_s0 + slit_s1)/2,
                               -clamp_zf * (relief_out_z + relief_span/2)])
                        cube([top_socket_outer_d + 2, slit_s1 - slit_s0,
                              relief_span], center=true);
                }
            }
        }

        // v5: magnet pocket in the rear shaft tip (diametral 6x2.5,
        // glued, 0.3 proud). Front socket tip stays plain.
        if (!is_front)
            translate([0, shaft_tip_y - mag_pocket_depth, 0])
                cyl_y(2 * mag_pocket_depth, mag_pocket_d, center=false);

        // Encoder-side wire passage through the diagonal tube stop. The
        // carbon tube bore already opens from the mouth to the stop; this
        // axial bore carries the wire past the shoulder and the side hole
        // gives it a short external exit.
        if (!is_front) {
            cylinder_between(
                p_top - u * top_encoder_wire_bore_extra,
                p_top + u * (top_pipe_stop_s + top_encoder_wire_bore_extra),
                d=top_encoder_wire_bore_d
            );

            translate(p_top + u * top_encoder_wire_exit_s + [0, 0, top_encoder_wire_side_hole_lift_z])
                rotate([0, 90, 0])
                    cylinder(
                        h=top_encoder_wire_side_hole_len,
                        d=top_encoder_wire_side_hole_d,
                        center=true
                    );
        }
    }

    // Retainer collar outside the bearing. This slides onto the shaft after
    // insertion and its small nose touches only the bearing inner ring.
    if (include_lock_collar)
        lock_collar_at_y(outside_face_y, dir);
}

module upper_socket_part(side="front") {
    // Standalone upper socket, using the same geometry as the full assembly.
    if (side == "rear")
        translate([0, -rear_pivot_y, 0])
            upper_socket(false, include_lock_collar=false);
    else
        translate([0, -front_pivot_y, 0])
            upper_socket(true, include_lock_collar=false);
}

module lock_collar_part(dir=1) {
    // Standalone lock collar, with the inner-ring contact face at Y=0.
    lock_collar_at_y(0, dir);
}

module encoder_bracket_part() {
    // Standalone rear encoder/bearing bracket. Origin is the rear bearing axis.
    translate([-axis_x, -rear_pivot_y, -axis_z])
        rear_pivot_encoder_mount();
}

module bearing_mount_part(cutaway=false) {
    // Standalone front bearing mount. Origin is the bearing axis.
    top_pivot_bearing_mount(cutaway=cutaway);
}

module lower_corner_socket(p_corner, p_top, p_other, cutaway=show_lower_socket_cutaway) {
    u_diag = unit(p_top - p_corner);
    u_bar  = unit(p_other - p_corner);

    // v5 integrated ankle axle stations along u_bar (from the corner):
    //   0 .. ax_hub0        cone-ish neck (socket body -> hub)
    //   ax_hub0 .. ax_hub   inner-ring hub stop disc (11.4 x 1.2)
    //   ax_hub .. +brg_w    7.8 axle through ONE 608 in the carrier
    //   .. ax_tip           6 mm into the carrier center cavity
    //   tip face            magnet pocket (both sides printed with one;
    //                       only the FRONT side carries the PCB)
    ax_hub  = (lower_w - carrier_len) / 2 - 0.15;  // hub CONTACT face
    ax_hub0 = ax_hub - inner_ring_contact_len;
    // v5.2: axle runs through bearing + land + inner collar clamp zone;
    // tip lands in the OPEN center at carrier-local +/-20 (magnet there).
    ax_tip  = lower_w/2 + akc_tip_y;               // corner->tip distance (57)


    color(c_socket)
    difference() {
        union() {
            // Diagonal carbon tube insertion cup.
            cylinder_between(
                p_corner,
                p_corner + u_diag * lower_socket_insert_len,
                d=lower_socket_outer_d
            );

            // v5: integrated printed axle toward the carrier (bar cup
            // retired). Neck from the corner node down to the hub disc.
            cylinder_between(
                p_corner,
                p_corner + u_bar * ax_hub0,
                d=lower_socket_outer_d - 4
            );
            cylinder_between(                       // hub stop disc
                p_corner + u_bar * ax_hub0,
                p_corner + u_bar * ax_hub,
                d=inner_ring_contact_d
            );
            cylinder_between(                       // the axle itself
                p_corner + u_bar * ax_hub0,
                p_corner + u_bar * ax_tip,
                d=shaft_print_d
            );

            // Slightly fuller corner node where the two cups meet.
            translate(p_corner) sphere(d=lower_socket_outer_d + 2);

            // v5.13: omega clamp lugs on the diagonal cup (pipe engagement
            // zone). Local frame: +Y along u_diag (u_diag is in the Y-Z
            // plane, so one X-rotation aligns it and the bolt stays global
            // X). clamp_zf puts the lugs on the OUTSIDE of the trapezoid
            // for both mirror parts (front: u_diag.y<0 -> local +Z).
            if (low_cup_clamp) {
                clamp_zf = (u_diag[1] < 0) ? 1 : -1;
                lug_x = low_cup_slit_w/2 + low_cup_lug_w/2 - low_cup_lug_inset;
                lug_z = lower_socket_outer_d/2 - low_cup_lug_bite + low_cup_lug_h/2;
                translate(p_corner) rotate([atan2(u_diag[2], u_diag[1]), 0, 0])
                    for (sx = [-1, 1])
                        translate([sx * lug_x, low_cup_clamp_s, clamp_zf * lug_z])
                            cube([low_cup_lug_w, low_cup_lug_t, low_cup_lug_h],
                                 center=true);
            }
        }

        // v5: magnet pocket in the axle tip face.
        cylinder_between(
            p_corner + u_bar * (ax_tip - mag_pocket_depth),
            p_corner + u_bar * (ax_tip + 1),
            d=mag_pocket_d
        );

        // Blind carbon-pipe socket, DIAGONAL side only (v5: no bar cup).
        cylinder_between(
            p_corner + u_diag * lower_pipe_stop_s,
            p_corner + u_diag * (lower_socket_insert_len + 4),
            d=lower_socket_bore_d
        );
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
