cbshbalance/slackline-balacing1/(list of files, cad)

Other CAD files:
cad/exports/bearing_mount_part.gcode.3mf
cad/exports/ankle_carrier_part.gcode.3mf
cad/exports/stl_v5.5_20260823/axle_ankle_socket_v5.5_rear.stl
cad/exports/upper_body_a_part.gcode.3mf
cad/axle_pivot_rear_v5.4.scad
cad/archive/frame_v1.scad
cad/archive/frame_v2.scad
cad/archive/frame_v3.scad
cad/archive/frame_v4.scad
cad/axle_ankle_socket_v5.1.scad
cad/axle_pivot_front_v5.2.scad
cad/axle_pivot_rear_v5.1.scad
cad/axle_pivot_rear_v5.2.scad
cad/axle_pivot_rear_v5.3.scad
cad/deprecated/ankle_pcb_lid_DEPRECATED.scad
cad/deprecated/oldham_coupler_DEPRECATED.scad
cad/deprecated/solid_coupler_DEPRECATED.scad
cad/deprecated/upper_body_door_DEPRECATED.scad
cad/encoder_ankle_bracket_v5.1.scad
cad/frame_master.scad
cad/lower_ankle_carrier_v5.2.scad
