cbshbalance/slackline-balacing1/exp_data/260805WED/ereumi/motor_profile_test/wiring_diagram (2).html

# motor_profile_test.ino 배선도 — 엔코더 2개 + OpenCR + 모터 + 전원

코드 상수와 1:1 대응: PHI_CS=10 → φ CS는 D10, ANK_CS=9 → 발목 CS는 D9, SPI 공유선은 보드 기본 핀(SCLK=D13, MISO=D12, MOSI=D11), 모터는 Serial3+RS-485(ID 1), 전원은 12V 배터리. motor_triangle_test.ino도 배선이 동일하다.

연결 | 어디서 | 어디로 | 비고
φ 엔코더 VCC / 발목 VCC | 모듈 VCC | OpenCR 3.3V | 한 핀을 둘로 나눔 (공유)
φ 엔코더 GND / 발목 GND | 모듈 GND | OpenCR GND | 각자 다른 GND 핀에 직결
φ CSn | 모듈 CSn | D10 | φ 전용, 직결
발목 CSn | 모듈 CSn | D9 | 발목 전용, 직결 — D10과 바뀌면 안 됨!
SCLK (둘 다) | 모듈 SCLK | D13 | 공유
MISO (둘 다) | 모듈 MISO | D12 | 공유
MOSI (둘 다) | 모듈 MOSI | D11 | 공유
모터 XM430-W210-R | 모터 커넥터 | RS-485 4핀 포트 | TTL 3핀 아님!
12V 배터리 | 배터리 커넥터 | OpenCR 전원 입력 | 모터 전원의 유일한 공급원
USB | PC | micro USB | 보드 전원·통신용, 모터엔 전원 안 감

배선 변경은 항상 전원 스위치 OFF + USB·배터리 분리 상태에서. 완료 후 exp_selftest_v19 부팅 메시지로 phi enc: OK / ank enc: OK / DXL 확인.
