cbshbalance/slackline-balacing1/lambda test/0822_lambda_test.raw.txt

# D,t_ms,phi_deg,ank_deg,alpha_deg,del_cmd_deg,del_now_deg
# 형식: 100Hz CSV (로거용)
# 형식: 읽기용 4Hz
# 출력 재개 (s 로 다시 정지)
dcmd=+0  d=-0.18 | phi=-0.09  ank=+0.11  alpha=+0.02
dcmd=+0  d=-0.18 | phi=-0.04  ank=+0.09  alpha=+0.04
dcmd=+0  d=-0.18 | phi=-0.07  ank=+0.02  alpha=-0.04
dcmd=+0  d=-0.18 | phi=-0.07  ank=+0.13  alpha=+0.07
dcmd=+0  d=-0.26 | phi=-0.11  ank=+0.13  alpha=+0.02
dcmd=+0  d=-0.18 | phi=-0.13  ank=+0.18  alpha=+0.04
dcmd=+0  d=-0.18 | phi=-0.07  ank=+0.09  alpha=+0.02
# 출력 정지 — s 로 재개 (명령은 계속 먹음)
E,703531,MOVE,0
# 출력 재개 (s 로 다시 정지)
dcmd=+0  d=-0.18 | phi=-0.07  ank=+0.11  alpha=+0.04
dcmd=+0  d=-0.18 | phi=-0.09  ank=+0.18  alpha=+0.09
dcmd=+0  d=-0.18 | phi=+0.00  ank=+0.09  alpha=+0.09
dcmd=+0  d=-0.18 | phi=-0.11  ank=+0.09  alpha=-0.02
dcmd=+0  d=-0.18 | phi=-0.04  ank=+0.04  alpha=+0.00
dcmd=+0  d=-0.18 | phi=-0.09  ank=+0.11  alpha=+0.02
# 출력 정지 — s 로 재개 (명령은 계속 먹음)
# D,t_ms,phi_deg,ank_deg,alpha_deg,del_cmd_deg,del_now_deg
# 형식: 100Hz CSV (로거용)
# 형식: 읽기용 4Hz
# 출력 재개 (s 로 다시 정지)
dcmd=+0  d=-0.18 | phi=-0.07  ank=+0.11  alpha=+0.04
dcmd=+0  d=-0.18 | phi=-0.13  ank=+0.11  alpha=-0.02
dcmd=+0  d=-0.18 | phi=-0.13  ank=+0.11  alpha=-0.02
dcmd=+0  d=-0.18 | phi=-0.07  ank=+0.11  alpha=+0.04
dcmd=+0  d=-0.18 | phi=-0.11  ank=+0.11  alpha=+0.00
dcmd=+0  d=-0.18 | phi=-0.07  ank=+0.13  alpha=+0.07
dcmd=+0  d=-0.18 | phi=-0.13  ank=+0.09  alpha=-0.04
dcmd=+0  d=-0.18 | phi=-0.04  ank=+0.15  alpha=+0.11
dcmd=+0  d=-0.18 | phi=-0.09  ank=+0.04  alpha=-0.04
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
D,3254153,0.154,-177.561,-177.407,0,-0.439
D,3254163,0.154,-177.583,-177.429,0,-0.439
D,3254173,0.154,-177.605,-177.451,0,-0.439
D,3254183,0.110,-177.605,-177.495,0,-0.439
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
dcmd=+0  d=-0.44 | phi=+0.15  ank=-177.58  alpha=-177.43
# 출력 정지 — s 로 재개 (명령은 계속 먹음)
