cbshbalance/slackline-balacing1/p2r test/0822_p2r_test.raw.txt

# D,t_ms,phi_deg,ank_deg,alpha_deg,del_cmd_deg,del_now_deg
# 형식: 100Hz CSV (로거용)
# 형식: 읽기용 4Hz
# 출력 재개 (s 로 다시 정지)
dcmd=+0  d=-0.18 | phi=-0.18  ank=+0.04  alpha=-0.13
dcmd=+0  d=-0.18 | phi=-0.18  ank=+0.11  alpha=-0.07
dcmd=+0  d=-0.18 | phi=-0.15  ank=+0.09  alpha=-0.07
dcmd=+0  d=-0.18 | phi=-0.20  ank=+0.07  alpha=-0.13
dcmd=+0  d=-0.18 | phi=-0.04  ank=+0.07  alpha=+0.02
dcmd=+0  d=-0.18 | phi=-0.22  ank=+0.13  alpha=-0.09
dcmd=+0  d=-0.18 | phi=-0.24  ank=+0.15  alpha=-0.09
dcmd=+0  d=-0.26 | phi=-0.09  ank=+0.13  alpha=+0.04
dcmd=+0  d=-0.18 | phi=-0.13  ank=+0.09  alpha=-0.04
dcmd=+0  d=-0.18 | phi=-0.09  ank=+0.11  alpha=+0.02
dcmd=+0  d=-0.18 | phi=-0.15  ank=+0.07  alpha=-0.09
dcmd=+0  d=-0.26 | phi=-0.22  ank=+0.11  alpha=-0.11
# 출력 정지 — s 로 재개 (명령은 계속 먹음)
E,302997,MOVE,10
# 출력 재개 (s 로 다시 정지)
dcmd=+10  d=+8.88 | phi=-0.44  ank=-4.66  alpha=-5.10 | alpha/d=-0.574
dcmd=+10  d=+8.88 | phi=+0.11  ank=-3.32  alpha=-3.21 | alpha/d=-0.361
dcmd=+10  d=+8.88 | phi=-0.40  ank=-4.35  alpha=-4.75 | alpha/d=-0.535
dcmd=+10  d=+8.88 | phi=-0.13  ank=-3.63  alpha=-3.76 | alpha/d=-0.423
dcmd=+10  d=+8.88 | phi=-0.20  ank=-3.85  alpha=-4.04 | alpha/d=-0.455
dcmd=+10  d=+8.88 | phi=-0.24  ank=-4.02  alpha=-4.26 | alpha/d=-0.480
dcmd=+10  d=+8.88 | phi=-0.02  ank=-3.71  alpha=-3.74 | alpha/d=-0.421
dcmd=+10  d=+8.88 | phi=-0.29  ank=-4.15  alpha=-4.44 | alpha/d=-0.500
dcmd=+10  d=+8.88 | phi=-0.02  ank=-3.67  alpha=-3.69 | alpha/d=-0.416
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
D,444969,-0.286,-0.417,-0.703,0,-0.176
D,444979,-0.330,-0.417,-0.747,0,-0.176
D,444989,-0.330,-0.527,-0.857,0,-0.176
D,444999,-0.330,-0.483,-0.813,0,-0.176
D,445009,-0.396,-0.593,-0.989,0,-0.264
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
dcmd=+0  d=-0.18 | phi=-0.13  ank=+0.11  alpha=-0.02
# 출력 정지 — s 로 재개 (명령은 계속 먹음)
# 형식: 읽기용 4Hz
