cbshbalance/slackline-balacing1/v20_sim/RESULT_v20.md

# v20 결과 — 실측 모델 비선형 시뮬 (2026-07-31)

공칭: I_δ=0.0323 kg·m² (링크 0.0293 + armature 0.003) / 힙 쿨롱 0.045 N·m / λ_u=6.33 /s

## 전류상한 600u (τ_lim=2.10 N·m)

| I_ARM | I_δ | LQR 1° (마찰O) | LQR 1.5° (마찰X) | Tf* | gc_eff/gc | FWE 1.5° (마찰O) |
|---|---|---|---|---|---|---|
| 0.0 | 0.0293 | FAIL | FAIL | 111 ms | 1.45 | FAIL (접기 7회 후 낙하/잔류) |
| 0.003 | 0.0323 | FAIL | FAIL | 116 ms | 1.44 | PASS (접기 5회, 꼬리|A| 0.36°) |
| 0.01 | 0.0393 | FAIL | FAIL | 127 ms | 1.44 | FAIL (접기 5회 후 낙하/잔류) |

## 전류상한 855u (τ_lim=3.00 N·m)

| I_ARM | I_δ | LQR 1° (마찰O) | LQR 1.5° (마찰X) | Tf* | gc_eff/gc | FWE 1.5° (마찰O) |
|---|---|---|---|---|---|---|
| 0.0 | 0.0293 | FAIL | FAIL | 94 ms | 1.45 | PASS (접기 6회, 꼬리|A| 0.33°) |
| 0.003 | 0.0323 | FAIL | FAIL | 99 ms | 1.45 | FAIL (접기 11회 후 낙하/잔류) |
| 0.01 | 0.0393 | FAIL | FAIL | 108 ms | 1.45 | FAIL (접기 6회 후 낙하/잔류) |

**결론 1 — FWE 로는 설 수 있다 (일부 조건)** — 표 참조.
단, 세 가지 재설계가 전제다: ① T_fold 60 ms → 전류상한 기반 자기일관값(600u에서 ~110 ms), ② 트리거 0.6° → 0.3°(접기각을 줄여 실행 가능하게), ③ 킥 계수 gc 를 브링업에서 시험 접기 1회로 자가 캘리브레이션(서보 지연 탓 이론 대비 ~1.4배 — 이걸 안 하면 deadbeat 이 부호까지 뒤집혀 낙하).
**결론 2 — LQR 단독은 실측 마찰에서 취약**: 힙 쿨롱(0.045 N·m)이 평형 근방 LQR 토크와 같은 자릿수라 스틱슬립으로 낙하(마찰 없으면 ~1.5° 수렴역). 실물에선 마찰보상 설계가 필요하고, 균형 유지의 주력은 FWE 가 되는 것이 자연스럽다.

- 게인·FF 는 공칭(I_ARM=0.003) 고정, 플랜트만 스윕 — 실물과 동일 조건의 강건성 검사
- Tf* 는 γ_cycle(Tf) 자기일관 고정점, δf·속도·가속 한계(마진 0.8) 동시 만족
- FWE 검사는 상태피드백 완전 가정 (관측 강건성은 LQR 검사의 칼만+노이즈가 담당)
- 지그 진동으로 남은 I_δ ±20% 불확실성이 이 스윕의 근거 (프로젝트 문서 23)
