cbshbalance/slackline-balacing1/docs/cowork/66_r_test_실패진단_20260822.md

# 66. 실측 ② (안정선) 시도 — 로그 실패, 원인은 모터 통신 (2026-08-22)

> 원 파일: `0822_r_test.raw.txt` (546줄), `0822_r_test.csv` (183행), `0822_r_test.events.csv` (**비어 있음**).
>
> **결론부터: 이 로그로는 안정선을 구할 수 없다.** 데이터 처리 문제가 아니라
> 로그가 물리적으로 필요한 정보를 담고 있지 않다. 아래는 무엇이 어긋났고
> 다음 회차에 무엇을 고쳐야 하는지다.
>
> **참고 범위:** 문서 46 「실측 세 개」 이후 문서만 근거로 쓴다 (문서 64·65 와 같은 방침).

---

## 1. 한 줄 진단

**모터(Dynamixel)가 응답하지 않았고, 그것 하나가 로그 전체를 무너뜨렸다.**

원인과 결과가 한 줄로 이어진다:

```
모터 무응답  →  deltaNow() 가 매 샘플 타임아웃
             →  제어루프가 300 ms 에 한 번밖에 안 돔 (100 Hz → 3.3 Hz)
             →  게다가 타임아웃이 print 중간에 걸려 D 행이 통째로 잘림
```

로그의 `<< dxl 통신실패 >>` 99 줄, `d=-0.18!` 의 `!` 가 그 표시다.

---

## 2. 어긋난 것 다섯 가지

| # | 무엇 | 증거 | 결과 |
|---|---|---|---|
| **1** | **모터 무응답** | `<< dxl 통신실패 >>` 99 줄 | 아래 넷의 원인.<br>⚠ 무응답 자체보다 **펌웨어가 계속 물어본 것**이 문제다 (§6 보강 1) |
| **2** | **샘플이 3.3 Hz** (설정 100 Hz) | 간격 중앙값·최빈값 **300 ms** | **치명적** — §3 |
| **3** | **모든 D 행이 잘림** | 183 행 전부 `...,0,` 로 끝나고 `del_now` 가 다음 줄로 넘어감.<br>숫자만 있는 꼬리 줄 183 개 | `del_now` 열 **183/183 비어 있음** |
| **4** | **영점을 안 잡았다** | `z` 실행 흔적 **0 건**.<br>홀드 자세가 φ = −124.9°, α = −7.3° | 절대 기준이 없다 — 절편 c₀ 를 못 낸다 |
| **5** | **발목 엔코더가 ±180° 감김 경계** | ank 가 +177.6 ↔ −177.1 을 오감.<br>α = ank + phi 가 **−300°** 로 튄 행 8 개 | β 를 못 만든다 |

`events.csv` 가 빈 것은 문제가 아니다 — 이 시험은 δ 명령을 안 쓰므로 MOVE 이벤트가 없는 게 맞다.

---

## 3. 왜 3.3 Hz 가 치명적인가

문서 65 의 실측값 **λ = 5.44 /s (T₂ = 127 ms)** 를 그대로 대입하면:

| | |
|---|---|
| 샘플 간격 | **300 ms** |
| 그 사이에 지나가는 배가시간 | **2.36 회** |
| 그 사이에 φ 가 자라는 배수 | **5.1 배** |
| 놓기 한 번당 샘플 | 중앙값 **5 점** (상승부는 실질 2~3 점) |

**한 점과 다음 점 사이에 로봇이 이미 다섯 배 넘어져 있다.** 문서 65 가 λ 를 낼 때
회차당 23~38 점을 썼던 것과 비교하면 열 배 이상 성글다. 궤적이라고 부를 수 없다.

---

## 4. 그리고 움직임이 선형 영역 밖이다

| | 값 |
|---|---|
| 홀드 φ (33 회) | −124.9° ± 1.8° |
| 시행별 최대 φ 편위 | 중앙값 **50°**, 최대 **78°** |

문서 65 의 놓기는 편위 **12~15°** 였다. 여기는 그 **4 배**다.
안정선은 A = 0 **근처의 작은 섭동**에서 회복과 낙하가 갈리는 경계인데,
이 로그는 33 회가 전부 크게 넘어간다 — **경계를 그릴 대조군이 없다.**

---

## 5. ★ 실측 ② 가 실제로 요구하는 것

이번 실패에서 얻은 것이 하나 있다 — **무엇을 재야 하는지가 분명해졌다.**

정지 상태(φ̇ = β̇ = 0)에서 놓으면

```
A = −φ/r + β + c₀/r
```

이고 **A 의 부호가 넘어지는 방향을 정한다.** 그러니:

> **여러 (φ, β) 에서 놓고 낙하 방향을 기록하면, 그 경계선이 곧 A = 0 선이다.
> 기울기에서 r 이, 절편에서 c₀ 가 나온다.**

여기에 필요한 조건이 넷:

1. **영점** — c₀ 는 절편이므로 절대 기준 없이는 의미가 없다. 줄 위 균형 자세에서 `z`.
2. **100 Hz 유효 로깅** — 낙하 방향 판정과 놓기 순간 상태를 함께 뽑으려면 필요하다.
3. **작은 섭동** — |φ| 편위 10° 이내. 선형 영역을 벗어나면 A 자체가 정의를 잃는다.
4. **★ 놓기 자세를 벌려야 한다** — 이것이 이번 회차에 빠진 설계다.
   (φ, β) 가 좁은 덩어리에 뭉치면 **기울기가 안 나온다.** 일부러 흩어 놓아야 한다.

### ⚠ 정정 — δ 를 움직일 필요는 없다 (2026-08-22)

이 문서의 첫 판은 4번을 "**β 를 벌리려면 δ 를 여러 값으로 두어야 하므로 모터가 반드시
살아 있어야 한다**" 라고 적었다. **틀렸다.**

**문서 50 §2 가 이미 정리해 둔 그대로다** — "발목 자유회전의 평형 조건은 **'몸 CoM이 발 위'
하나뿐이고 δ 값과 무관**하다." δ 는 평형을 정하지 않는다.

그리고 δ = 0 으로 고정되면 **β = α** 이고, 발목은 무구동 자유관절이므로
**(φ, β) 평면은 손으로 그대로 열려 있다.** δ 는 β 를 옮기는 여러 방법 중 하나일 뿐이다.

**오히려 δ = 0 이 맞는 자리다.** 모델은 δ ≈ 0 에서 선형화돼 있고, 문서 50 §5 는
δ₀ 의존성(킥 커플링 cos δ)을 **δ₀ = 15° 에서 −3 %, 30° 에서 −13 %** 로 잡는다.
δ 를 크게 벌려 재면 그 오염이 r 안으로 들어온다.

### 단, 갈림길이 하나 있다 — "고정"이 무슨 뜻인가

| δ = 0 의 상태 | β 를 만들 수 있나 | 실측 ② |
|---|---|---|
| **기구적 고정**(핀·클램프) 또는 **토크 ON 유지** | β = α + P2R·0 = **α** — 만들 수 있다 | **가능** |
| **토크 OFF (모터가 죽어 자유)** | δ 가 제멋대로 흔들리는데 **읽을 수가 없다** | **불가능** |

이 로그는 후자인지 전자인지 모른다 — 부팅 때 ping 은 성공해 `torqueOn` 이 나갔지만
그 뒤 통신이 끊겼다. 서보가 마지막 목표를 붙들고 있었다면 δ ≈ 0 이겠지만 **확인할 방법이 없다.**
다음 회차에는 **δ 를 기구적으로 고정하거나, 토크가 살아 있음을 확인하고** 시작할 것.

### ★ 절차는 문서 50 이 이미 써 두었다

문서 50 §2 **Z2** — 영점의 "정식절차" 항목이 그대로 실측 ② 다:

> **여러 φ 에서 흔들리는 β 를 찾아 직선 적합 — 이 절편이 A 오프셋의 정본**

"흔들리는 β" = 발산하지 않고 흔들리다 잦아드는 β = **그 φ 에서의 균형 β.**
그 점들이 A = 0 선 위에 있다.

> ⚠ **정정 (문서 67, 2026-08-22): "흔들리는" 을 달성 조건으로 읽지 말 것.**
> 한 주기를 흔들리려면 놓는 순간 \|A\| < 0.012° 여야 하는데 Â 잡음 바닥이 0.106° 다 —
> **불가능하고, 필요도 없다.** 실제로 기록할 것은 **놓은 자리 (φ, β) 와 넘어진 방향**이고,
> **넘어진 시행도 전부 데이터다.** 자세한 계산은 문서 67 §3·§4.

```
β_bal = (1/r)·φ − c₀/r        →  기울기에서 r,  절편에서 c₀
모델 예측: 기울기 −0.608, 절편 0
```

문서 50 §6 도 같은 말을 한다 — **"이 절차 연습 = 실측②(안정모드선) 연습과 같은 동작이다."**
즉 놓기 프로토콜을 연습하는 것이 곧 실측 ② 이고, **모터 없이 하는 동작이다.**

**초기조건 장치는 문서 50 §4 의 실 릴리즈** — 프레임에서 실을 내려 로봇 머리에 걸고
일부러 실 쪽으로 기대게 세운 뒤 가위로 끊는다. 충격 0, 재현성 좋음.
문서 50 이 "실측 ②③의 초기조건 부여 장치로도 그대로 쓸 수 있다"고 적어 둔 그것이다.

### 참고 — 문서 65 로그에 재료가 조금 있다

λ 로그 19 회의 놓기 순간 (φ, α) 가 낙하 방향으로 갈린다
(+ 낙하 φ 1.45±0.34 / α 0.45±0.70, − 낙하 φ 0.74±0.46 / α 1.25±0.56).
**다만 놓기 자세를 일부러 벌리지 않아서 (φ, β) 가 1.5° 폭의 덩어리에 뭉쳐 있다** —
기울기를 내기엔 부족하고, 거칠게 그은 경계의 부호가 모델 예측 −0.608 과 반대로 나온다.
**원인은 δ 를 안 움직인 것이 아니라 자세를 안 흩은 것이다.**

문서 65 가 낸 **φ_eq = 1.40°** 는 그 덩어리 안에서 발산 부호가 뒤집히는 자리이므로,
**A = 0 선 위의 점 하나**에 가깝다. 그때 α ≈ 0.9° 였다. 예측선(c₀ = 0)이라면 그 φ 에서
β_bal = −0.608 × 1.4 = **−0.85°** 여야 하는데 관측은 **+0.9°** — 1.7° 어긋난다.
**c₀ ≠ 0, 즉 A 오프셋이 실재한다는 신호**일 수 있다. 점 하나라 단정할 수 없으니
**다음 측정의 예측 검증 항목으로 걸어 둔다.**

---

## 6. 다음 회차 체크리스트

**모터를 살릴 수 있으면 — 그 편이 낫다**

- [ ] **배터리 연결** — 문서 52 가 굵게 써 둔 그대로. USB 전원만으로는 모터가 안 돈다
- [ ] RS-485 4핀 결선, ID 1, 보레이트 (1 M / 57600)
- [ ] `t` 를 쳐서 **"모터: OK"** 확인. `!` 나 `dxl 통신실패` 가 보이면 거기서 멈춘다

**모터가 계속 죽어 있다면 — 그래도 된다. 대신 이 둘을 반드시**

- [ ] **δ 를 0 에 기구적으로 고정** (핀·클램프·케이블타이 무엇이든). 자유롭게 흔들리면
      β 를 못 만들어 실측 ② 자체가 불가능하다 (§5 갈림길 표)
- [ ] **펌웨어에서 `deltaNow()` 폴링을 끈다** — 아래 보강 1번. 이것 없이는 3.3 Hz 그대로다

**공통 — 시작 전**

- [ ] 줄 위 균형 자세에서 **`z`** — 발목 ±180° 감김도 같이 해소된다 (영점이 현재 자리가 되므로)
- [ ] `m` 으로 CSV 전환 후 **간격이 10 ms 인지** 몇 줄 눈으로 확인
- [ ] D 행 끝에 `del_now` 값이 **같은 줄에** 붙어 나오는지 확인

**측정 — 핵심은 "자세를 흩는 것"**

- [ ] **놓기 자세를 일부러 벌린다.** 몸을 앞으로 기울여도 놓고, 뒤로도 놓고, 줄을 한쪽으로
      비틀어서도 놓는다. 목표는 (φ, β) 가 **좌우로 ±5° 이상 흩어지는 것** —
      문서 65 로그의 1.5° 덩어리로는 기울기가 안 나온다
- [ ] 정밀하게 **조준할 필요는 없다.** 놓기 순간 상태를 **기록**하고 낙하 방향만 남으면 된다.
      경계선은 흩어진 점들로 적합한다
- [ ] 편위는 **10° 이내**로 작게. 문서 66 이 진단한 50~78° 는 선형 영역 밖이다
- [ ] 낙하 방향이 확정될 때까지 충분히 길게 로깅
- [ ] 30~40 회. 문서 50 §4 의 "20회 놓고 릴리즈 순간 Â 분포" 도 **같은 로그에서 공짜로** 나온다
- [ ] 가능하면 **실 릴리즈**(문서 50 §4) — 충격 0, 재현성 좋고, 아는 작은 각에서 시작

**펌웨어 보강**

- [ ] **1. 통신 실패가 N 회 연속되면 `motor_ok = false` 로 내리고 이후 `deltaNow()` 를 건너뛴다.**
      지금은 실패해도 매 샘플 타임아웃을 다시 기다려서 루프가 죽는다.
      이것 하나면 모터가 빠져도 **로그는 100 Hz 로 살아남는다** — 이번 로그가 살 수 있었다
- [ ] 2. D 행은 **한 번에** 만들어 출력 (버퍼에 문자열을 완성한 뒤 `println`) — 줄 중간에서 잘리지 않게
- [ ] 3. `motor_ok = false` 일 때 `del_now` 를 빈칸이 아니라 **`0`** 으로 찍는다 (δ 고정을 전제로)

---

## 7. 조치

| # | 할 일 | 상태 |
|---|---|---|
| 1 | **펌웨어: 통신 실패 시 `deltaNow()` 폴링 중단** + D 행 한 번에 출력 | **선행조건** — 이것 없이는 로그가 안 산다 |
| 2 | 모터 통신 복구 (배터리 → RS-485 → 보레이트) **또는** δ 를 0 에 기구적 고정 | **둘 중 하나** |
| 3 | 실측 ② 재수행 — **놓기 자세를 흩어서** 작은 섭동으로 30~40 회 (§5, §6) | 대기 |
| 4 | 그 결과로 r 과 c₀ 를 실측값으로 교체 (현재 문서 60 펌웨어는 예측 r = −1.6445, c₀ = 0) | 3번 이후 |
| 5 | **예측 검증:** 문서 65 의 (φ, α) = (1.40, ~0.9) 가 적합된 선 위에 오는가 (§5) | 3번 이후 |

**남은 미실측 상수는 여전히 r 과 c₀ 둘이다.** P2R 은 문서 64, λ 는 문서 65,
발목 잡음은 문서 64 §4-4 로 닫혔고, **실측 ② 하나만 남았다.**
