cbshbalance/slackline-balacing1/lambda test/0822_lambda_test.csv

t_ms | phi_deg | ank_deg | alpha_deg | del_cmd_deg | del_now_deg
2908197 | 0.198 | -0.242 | -0.044 | 0 | 0.000
2908207 | 0.242 | -0.286 | -0.044 | 0 | 0.000
2908217 | 0.242 | -0.242 | 0.000 | 0 | 0.088
2908227 | 0.242 | -0.308 | -0.066 | 0 | 0.000
2908237 | 0.264 | -0.374 | -0.110 | 0 | 0.000
2908247 | 0.352 | -0.417 | -0.066 | 0 | 0.088
2908257 | 0.286 | -0.352 | -0.066 | 0 | 0.000
2908267 | 0.286 | -0.396 | -0.110 | 0 | 0.088
2908277 | 0.242 | -0.352 | -0.110 | 0 | 0.088
2908287 | 0.308 | -0.439 | -0.132 | 0 | 0.000
2908297 | 0.286 | -0.439 | -0.154 | 0 | 0.088
2908307 | 0.330 | -0.439 | -0.110 | 0 | 0.000
2908317 | 0.352 | -0.461 | -0.110 | 0 | 0.000
2908327 | 0.330 | -0.439 | -0.110 | 0 | 0.088
2908337 | 0.417 | -0.439 | -0.022 | 0 | 0.000
2908347 | 0.396 | -0.505 | -0.110 | 0 | 0.088
2908357 | 0.330 | -0.571 | -0.242 | 0 | 0.088
2908367 | 0.439 | -0.549 | -0.110 | 0 | 0.088
2908377 | 0.483 | -0.549 | -0.066 | 0 | 0.088
2908387 | 0.439 | -0.549 | -0.110 | 0 | 0.000
2908397 | 0.439 | -0.505 | -0.066 | 0 | 0.088
2908407 | 0.461 | -0.549 | -0.088 | 0 | 0.088
2908417 | 0.549 | -0.593 | -0.044 | 0 | 0.000
2908427 | 0.527 | -0.615 | -0.088 | 0 | 0.088
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
