cbshbalance/slackline-balacing1/lambda test/0822_lambda_test.events.csv

t_ms | event | value
703531 | MOVE | 0
2016642 | MOVE | 0
2017378 | MOVE | 0
2740184 | MOVE | 0
