cbshbalance/slackline-balacing1/p2r test/0822_p2r_test.csv

t_ms | phi_deg | ank_deg | alpha_deg | del_cmd_deg | del_now_deg
313684 | -0.132 | 0.154 | 0.022 | 0 | -0.176
313694 | -0.176 | 0.132 | -0.044 | 0 | -0.176
313704 | -0.198 | 0.088 | -0.110 | 0 | -0.176
313714 | -0.132 | 0.110 | -0.022 | 0 | -0.176
313724 | -0.176 | 0.088 | -0.088 | 0 | -0.176
313734 | -0.220 | 0.132 | -0.088 | 0 | -0.176
313744 | -0.220 | 0.000 | -0.220 | 0 | -0.176
313754 | -0.220 | -0.088 | -0.308 | 0 | -0.176
313764 | -0.198 | -0.066 | -0.264 | 0 | -0.176
313774 | -0.286 | -0.022 | -0.308 | 0 | -0.176
313784 | -0.264 | -0.110 | -0.374 | 0 | -0.176
313794 | -0.330 | -0.088 | -0.417 | 0 | -0.176
313804 | -0.308 | -0.110 | -0.417 | 0 | -0.176
313814 | -0.286 | -0.154 | -0.439 | 0 | -0.176
313824 | -0.242 | -0.110 | -0.352 | 0 | -0.176
313834 | -0.264 | -0.176 | -0.439 | 0 | -0.176
313844 | -0.330 | -0.176 | -0.505 | 0 | -0.176
313854 | -0.374 | -0.154 | -0.527 | 0 | -0.176
313864 | -0.264 | -0.132 | -0.396 | 0 | -0.176
313874 | -0.308 | -0.132 | -0.439 | 0 | -0.176
313884 | -0.242 | -0.088 | -0.330 | 0 | -0.176
313894 | -0.286 | -0.066 | -0.352 | 0 | -0.176
313904 | -0.286 | -0.088 | -0.374 | 0 | -0.176
313914 | -0.198 | -0.044 | -0.242 | 0 | -0.176
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
