cbshbalance/slackline-balacing1/p2r test/0822_p2r_test.events.csv

t_ms | event | value
302997 | MOVE | 10
310471 | MOVE | 0
319648 | MOVE | 10
326725 | MOVE | 20
343062 | MOVE | 30
362219 | MOVE | 40
390678 | MOVE | 30
409652 | MOVE | 20
426480 | MOVE | 10
443332 | MOVE | 0
