cbshbalance/slackline-balacing1/cad/CHANGELOG.md

# CAD 정본 · 명명법 · 변경 로그 (frame generation 5)

> **이 문서는 `cad/` 폴더의 단일 정본(single source of truth)입니다.**
> 팀원과 (다른 대화창의) Claude 모두, 작업 전 여기서 **① 현재 구성 ② 명명법 ③ 이력**을 먼저 확인하세요.
> 핵심 구조: **지오메트리는 전부 `frame_master.scad` 하나에** 있고, 각 파트 파일은 그 마스터를 `include`하고 `part_mode`만 지정하는 **얇은 선택자**입니다. 그래서 "치수를 바꾼다 = `frame_master.scad`를 바꾼다"입니다.

---

## 1. 현재 최종 구성 (frame generation 5)

로봇 본체 '어름이'. **알루미늄 프레임(2020)·기성품(FR12 힙·608 베어링·XM430·AS5047P 42mm 모듈)은 출력물이 아님.**

### 마스터
| 파일 | 역할 |
|---|---|
| `frame_master.scad` | **공용 지오메트리 정본** (구 `frame_v5.scad`, 현재 상태 = 아래 v5.4). 모든 파트가 이 파일을 include. |

### 하체 (lower)
| 파일 | 소분류 | 역할 | 출력수 |
|---|---|---|---|
| `lower_spine_v5.1.scad` | spine | 하체 스파인(힙↔발목 골격), 힙 +9 반영 | 1 |
| `lower_ankle_carrier_v5.3.scad` | ankle | 개방형 발목 캐리어(608 하우징 2 + 상승 브리지 + 엔드월). **v5.3: 브리지 파일럿이 교정된 브래킷 나사열(y −3.2)을 따라감** | 1 |
| `lower_ankle_collar_v5.1.scad` | ankle | 발목 안쪽 락칼라(노즈 연장형), 내경 7.9 | **2** |

### 상체 (upper) — **A/B 구성 (C는 미진행)**
| 파일 | 소분류 | 역할 | 출력수 |
|---|---|---|---|
| `upper_bodyA_v5.1.scad` | bodyA | 상체 A(스플라이스 리시버, 하단 캡→테이퍼) | 1 |
| `upper_bodyB_v5.5.scad` | bodyB | 상체 B(장비 베이). **v5.5: 무게중심 보정 — Y 측벽 전체 복원, X- 면만 전폭 개방(85/93) + 배터리 선반 → 양측 레일 15(중앙 66 개방 = 스위치 베이, 토글 슬롯 은퇴, 스트랩 레일당 1쌍)**. 테이프+안착턱·슬리브·+22mm 유지 | 1 |

### 축 (axle)
| 파일 | 소분류 | 역할 | 출력수 |
|---|---|---|---|
| `axle_ankle_socket_v5.2.scad` | ankle | 발목 하단 소켓(축 일체, 자석 포켓 팁) front/rear. **v5.2: 파이프 컵 클램프 융합(슬릿 2.2 + 리빙힌지)** | 2 |
| `axle_pivot_front_v5.3.scad` | pivot | 상단 피벗 전방 소켓(짧은 축). **v5.3: 클램프 실조임 보강(슬릿 2.2 + 리빙힌지 릴리프)** | 1 |
| `axle_pivot_rear_v5.4.scad` | pivot | 상단 피벗 후방 소켓(짧은 축 + 자석 포켓). **v5.4: 클램프 실조임 보강(전방과 동일)** | 1 |
| `axle_pivot_collar_v5.1.scad` | pivot | 상단 피벗 락칼라, 내경 7.9 | **2** |

### 엔코더 (encoder)
| 파일 | 소분류 | 역할 | 출력수 |
|---|---|---|---|
| `encoder_ankle_bracket_v5.2.scad` | ankle | 발목 엔코더 L-브래킷(42×42 보드, 4×M3, 8mm 스탠드오프). **v5.2: 바 길이·나사열 하드코딩 결함 수정** | 1 |
| `encoder_pivot_box_v5.1.scad` | pivot | 피벗 엔코더 박스(42×42, 4×M3, 8mm 스탠드오프) | 1 |
| `encoder_pivot_bearing_v5.1.scad` | pivot | 피벗 전방 베어링 마운트(구조물) | 1 |

### 유틸 / 폐기 / 기타
| 경로 | 내용 |
|---|---|
| `util_ankle_section_view.scad` | 발목 조립 단면 검사 뷰(**비출력**, 버전 없음) |
| `deprecated/` | **폐기 파트**(출력 금지) — `ankle_pcb_lid`(개방형 브래킷으로 대체), `upper_body_door`(A/B 구성, 도어 없음), `solid_coupler`·`oldham_coupler`(v5 은퇴, 중복) |
| `archive/` | 구세대 마스터 `frame_v1~v4.scad`(동결 보관) |
| `exports/` | 슬라이서 산출물(`.3mf`/`.gcode.3mf`) — 소스 아님 |

---

## 2. 명명법 (naming convention)

**형식:** `<대분류>_<소분류>_v<세대>.<파트리비전>.scad`

- **대분류(5종):** `frame` · `lower`(하체) · `upper`(상체) · `axle`(축) · `encoder`(엔코더 관련)
- **소분류:** 위치+부품(예: `ankle_carrier`, `pivot_rear`, `bodyA`) — 어느 파트인지 즉시 식별.
- **버전 `v<세대>.<리비전>`:**
  - **세대(앞자리)** = 프레임 세대. 현재 전부 **5**. **구조 대개편 때만** 6으로 올리고, 그때 각 파트 리비전은 `.1`로 리셋.
  - **리비전(뒷자리)** = 그 파트 지오메트리가 바뀔 때마다 +1. 이번 명명 정리 시점을 리셋 기준으로 **현행 전 파트를 `v5.1`**로 둠(이전 이력은 아래 3장 LOG).
- **마스터:** `frame_master.scad` (이름에 버전 없음). 실제 상태는 이 CHANGELOG 최신 LOG로 관리 → **항상 현행 마스터 1개**라 최신 혼동 없음.
- **원칙:** **파트당 현행 파일은 정확히 1개.** 그래서 "어느 게 최신"이 항상 자명함.
- **폐기 →** `deprecated/`, 파일명 `_DEPRECATED`, 헤더에 대체 파트 명시. **아카이브 →** `archive/`. **산출물 →** `exports/`.

### ⚙ 다른 Claude 세션 / 팀원 작업 절차 (필독)
1. **치수·형상 변경은 `frame_master.scad`를 편집**(파트 래퍼는 include만 하는 선택자라 보통 안 건드림).
2. 어떤 **파트의 지오메트리가 바뀌면**, 그 파트 파일을 **리비전 +1**로 rename(`_v5.1` → `_v5.2`), 헤더/이 CHANGELOG에 로그 추가.
3. 새 파트는 `<대분류>_<소분류>_v5.1.scad`로 만들고 `include <frame_master.scad>` + `part_mode` 지정.
4. 폐기 시 `deprecated/`로 이동 + `_DEPRECATED` + 대체 파트 명시.
5. 반드시 **브랜치 → PR**로 올리고, OpenSCAD 렌더로 매니폴드/조립 경고 0 확인 후 병합.
6. 커밋/푸시는 HTTPS+토큰(파인그레인드, 이 리포 한정). SSH 원격은 이 환경에서 불가.

---

## 3. 세부 변경 로그 (LOG, 최신 우선)

### v5.14(가) — 2026-08-23 · 축 파트 칼집(슬릿)·깊이 수정 — **STL만 회수, .scad 소스 미회수** ⚠
**계기(사용자):** 피벗축과 발목 소켓축에 칼집을 넣고 깊이를 수정한 리비전. 8/23경 로컬에서 작업됐으나 리포에 푸시되지 않았음.
- **리비전 점프:** `axle_ankle_socket` v5.2 → **v5.5**(front/rear), `axle_pivot_front` v5.3 → **v5.5**, `axle_pivot_rear` v5.4 → **v5.6**. 중간 리비전(소켓 v5.3·v5.4, 피벗 v5.4/v5.5)의 기록도 없음.
- **회수된 것:** 슬라이서용 STL 4개 → `exports/stl_v5.5_20260823/`. 전부 매니폴드(watertight) 확인. bbox: 피벗 front/rear 16×68.7×41.1, 발목 소켓 20×84×47.9. 체적: 피벗 front 10,346 / rear 10,462 mm³, 발목 소켓 15,906 mm³(front·rear 동일=미러).
- **미회수:** 해당 리비전의 `frame_master.scad` 편집분과 파트 파일(`axle_*_v5.5/v5.6.scad`). **리포의 `frame_master.scad`·파트 래퍼는 아직 v5.13 상태**이므로, 이 STL을 SCAD에서 재생성할 수 없다. 8/23에 작업한 PC(OneDrive `slackline_valancing/cad/`)에서 소스를 찾아 커밋할 것.
- **출력 시:** 위 STL을 그대로 사용(정본 SCAD 아님). SCAD 소스가 회수되면 이 항목을 정식 v5.14 로그로 갱신하고 1절 구성표의 리비전을 올릴 것.

### v5.13 — 2026-08-05 · 발목 하단 소켓에도 파이프 클램프 융합: `axle_ankle_socket` v5.1→v5.2
**계기(사용자):** 상단 피벗(v5.12)에 이어, 발목을 고정하는 하단 소켓 2개도 락칼라 기능을 넣어 기본(슬립핏)보다 더 조일 수 있게.
- **v5.12와 동일 레시피**를 하단 대각 컵(OD18, 보어 8.2, 물림 s12~27... 파이프 물림 s17~27)에 적용: 오메가 러그 쌍 + M3 크로스볼트(축=전역 X) + **슬릿 2.2**(s15~마우스) + **리빙힌지 릴리프**(반대편 외벽 제거, 보어 옆 1.7mm 벽 잔존).
- **배치:** 러그 중심 s=22(파이프 물림 중앙), 클램프는 **사다리꼴 바깥쪽**(캐리어 반대편) — `clamp_zf`를 대각선 방향(u_diag.y 부호)에서 유도해 front/rear **미러-예비부품 성질 유지**.
- **불변:** 보어 8.2, 축 일체(허브 스톱·7.8 축·자석 포켓 팁), 배선 통로(엘보 축공 + 측면 구멍 s=12 — 슬릿 s15 시작이라 비간섭), 코너 노드 구.
- **파라미터 신설:** `low_cup_clamp`(=true), `low_cup_slit_w=2.2`, `low_cup_lug_w/t/h=4/6/7.8`, `low_cup_bolt_z=10.8`, `low_cup_clamp_s=22`, `low_cup_hinge_wall=1.7`.
- **검증:** front/rear 파트 렌더 매니폴드 **Simple: yes**·경고 0(양쪽 facet 동일=미러 확인), 전체 조립 렌더 Simple: yes·경고 0. 불리언 교차 8종: 릴리프 제거영역 공집합(front·rear), 힌지 잔여벽 존재, 슬릿 틈 공집합(1.8 폭), 러그 존재, 측면 배선구멍 보존(중심 공집합), 일체 축 보존(재료 존재).
- **★재출력 필요: 두 파트 모두.** 하드웨어 추가: **M3×12 + 너트 ×2**(파트당 1). 조립: 파이프 스톱까지 삽입 → M3 조임. 과조임 주의(카본 압착 느낌에서 정지).

### v5.12 — 2026-08-05 · 상단 피벗 컵 클램프 "실조임" 보강: `axle_pivot_front` v5.2→v5.3, `axle_pivot_rear` v5.3→v5.4
**계기(사용자):** M3 볼트를 끝까지 조여도 카본 파이프가 느슨. 보어 축소가 아니라 **나사로 더 조일 수 있는 형태**로 수정 요청.
- **원인 분석:** v5.9 클램프는 슬릿 1.2mm → 최대 지름 수축이 1.2/π ≈ **0.38mm**뿐인 데다, 슬릿 반대편 벽이 3.9mm 통짜라 굽힘 강성이 너무 커서 볼트 토크가 마우스를 닫지 못함(볼트가 러그만 휘고 파이프는 그대로).
- **조치 ① 슬릿 확대:** `top_cup_slit_w` 1.2 → **2.2** — 닫힘 여유 ~0.7mm 지름(파이프 실측 7.9 vs 보어 8.2 갭의 2배 이상).
- **조치 ② 리빙힌지 릴리프 신설:** 슬릿 반대편(−clamp_zf) **외측 벽을 슬릿과 같은 s구간(스톱−2 ~ 마우스)에서 제거**, 보어 옆 **1.7mm 벽만 리빙힌지로 잔존**(`top_cup_hinge_relief=true`, `top_cup_hinge_wall=1.7`) → 굽힘강성 ≈ (3.9/1.7)³ ≈ 12배 감소, 볼트 힘이 실제 파이프 압착으로 감.
- **불변:** 보어 8.2, 컵 OD 16, 러그 크기·볼트 위치·자석 포켓(rear)·엔코더 배선 축공/측면 출구(s=8 — 릴리프는 s10 시작이라 비간섭). 러그 외면 스팬 7.2→8.2mm, **볼트는 기존 M3×12+너트 그대로 사용 가능**.
- **검증:** front/rear 파트 + 전체 조립 렌더 매니폴드 **Simple: yes**·경고/에러 0. 불리언 교차 검사 6종: 릴리프 제거영역 교차 **공집합**(front·rear), 힌지 잔여벽 **존재**(facet>0), 슬릿 틈 1.8 폭 박스 **공집합**(슬릿 2.2 확인), 러그 **존재**.
- **★재출력 필요: 두 파트 모두.** 조립: 파이프를 스톱까지 삽입 → M3 조임. 이제 마우스가 실제로 닫히므로 **과조임 주의**(카본 파이프가 눌리는 느낌이 오면 정지).

### v5.11 — 2026-07-29 · 발목 L-브래킷 형상 결함 수정: `encoder_ankle_bracket` v5.1→v5.2, `lower_ankle_carrier` v5.2→v5.3
**계기(사용자 지적):** GitHub CAD의 `encoder_ankle_bracket` 형상이 이상함. 렌더·레이 계측으로 **실재 결함 2건 확인**.
- **근본 원인:** `akc_brk_bar_y1 = -4` 와 `akc_brk_screw = [[-8,-8],[8,-8]]` 가 **하드코딩된 절대값**이었고, 이 값들은 플레이트 전면이 y=−16.6이던 시절 기준. **v5.4에서 `as_back_post = 8`(모듈 실물 8mm 기둥) 스탠드오프가 들어가며 플레이트 전면이 −8.6으로 이동**했는데 두 상수가 따라가지 않음.
- **결함 ① 바 붕괴:** 브리지 밑 바가 **12.6 → 4.6mm**로 줄어듦(설계 의도의 36%). x=±8 단면에서는 나사구멍이 나머지를 먹어 잔여 재료 2.3mm.
- **결함 ② 나사구멍 파단:** M3 클리어런스(3.4) 구멍이 y −9.7..−6.3인데 바 후단이 −8.6 → **구멍이 바 뒷면을 뚫고 나가 노치가 됨**(닫힌 구멍 아님). 게다가 플레이트(y −8.6..−5.6)를 관통해 "나사열은 플레이트 뒤 = 드라이버 직선 접근"이라는 설계 의도도 무효화.
- **조치(파라미터 유도화):** 두 값을 **플레이트 전면 평면에서 유도**하도록 변경 — `akc_brk_bar_len = 12.6`(원래 길이 복원) → `akc_brk_bar_y1 = bar_y0 + 12.6` (= +4.0), `akc_brk_screw_y = bar_y0 + akc_brk_t + clr_d/2 + 0.7` (= −3.2). 향후 스탠드오프·보드 두께가 또 바뀌어도 자동 추종.
- **캐리어 동반 수정:** 브리지 셀프탭 파일럿이 같은 `akc_brk_screw` 리스트를 쓰므로 파일럿 y도 −8→−3.2로 이동 → 캐리어 지오메트리 변경 → 리비전 +1(v5.3).
- **검증:** 브래킷·캐리어·전체 조립 렌더 **Simple: yes**·경고/에러 0, STL watertight. 레이 계측(브래킷 로컬): 바 y −8.6..**+4.0**(12.6 복원), x=±8에서 구멍 전후 재료 **3.7 / 5.5mm**로 완전 폐구멍, y=−8.6·−4.9·−1.5·+3.9 단면 전부 재료 연속(파단 없음), 나사 축 수직 레이 관통(드라이버 직선 접근 확보, 플레이트 후면 −5.6 vs 구멍 전단 −4.9 = 0.7 여유), PCB 4점 파일럿 보존. 브래킷∩캐리어 **간섭 부피 0**(z=23 평면에서 면 접촉만). 캐리어 파일럿: 구 위치(8,−8) 재료 연속, 신 위치(8,−3.2) 파일럿 깊이 5.8mm.
- **★재출력 필요:** `encoder_ankle_bracket`(형상 대폭 변경), `lower_ankle_carrier`(파일럿 위치 이동 — 기존 출력물은 구 파일럿이라 재사용 불가).

### v5.10 — 2026-07-29 · 후방 컵 클램프 꺾임 바깥쪽으로 플립: `axle_pivot_rear` v5.2→v5.3
**계기(사용자 검토):** v5.9의 클램프가 항상 컵 로컬 +Z에 놓여 — 전방은 꺾임(브리지-컵 엘보) **바깥**, 후방은 꺾임 **안쪽**(베어링 쪽)으로 나옴. 둘 다 바깥쪽으로 통일.
- **조치:** `upper_socket()`에 `clamp_zf = is_front ? 1 : -1` 도입, 러그·볼트홀·슬릿의 로컬 Z 배치에 곱함 → 후방 클램프가 로컬 −Z(= 전역 −Y·상향 기울기, 베어링 반대쪽)로 미러. 전방(v5.2)은 지오메트리 불변.
- **검증:** rear 파트 렌더 Simple: yes·경고 0, watertight. 레이 계측: 오메가 단면이 −Z 측으로 정확히 미러(러그 상단 −12.8..−11.4 | 볼트홀 | 벽+러그 −8.2..−3.6 | 반대벽 3.6..7.7), 러그 방향 전역 (−0.951, +0.31) = 전방 (+0.951, +0.31)의 Y미러 → 양쪽 모두 꺾임 바깥. 마우스/스톱·배선 축공·측공 보존. front STL 재렌더로 불변 확인. 전체 조립 렌더 Simple: yes·경고 0. 러그 z ≤ −12.2 < 브리지 하면 −8 (자기 브리지와도 무간섭).

### v5.9 — 2026-07-29 · 상단 피벗 소켓에 파이프 락칼라 융합: `axle_pivot_front`/`axle_pivot_rear` v5.1→v5.2
**계기(사용자):** 상단 피벗 전·후방 소켓의 카본 파이프 삽입부가 슬립핏+접착 의존 → 락칼라 기능을 컵에 융합해 **접착제 없이** 본체 거치 시에도 대각 튜브가 단단히 유지되도록.
- **컵 클램프(오메가 러그 + 상부 슬릿 + M3 크로스볼트):** 기존 `lock_collar_at_y_n`과 동일 레시피를 파이프 컵(OD16, 보어 8.2) 자체에 구축. 파이프 물림 구간(s = 12..22, 삽입 10mm) 중앙 s=17에 러그 쌍(폭 4, 두께 6, 높이 7.8, 바이트 3, 인셋 1) 배치, **볼트 축 = 전역 X**(컵 축 u가 Y-Z 평면에 있어 X 1회 회전으로 로컬 프레임 정렬 → 스윙면 측방에서 드라이버 접근). 슬릿(폭 1.2)은 **개방 마우스에서 파이프 스톱 2mm 지나까지**(s 10..23) 관통 — 마우스 구간이 캔틸레버로 휘며 조임.
- **파라미터 신설:** `top_cup_clamp`(=true), `top_cup_slit_w=1.2`, `top_cup_lug_w/t/h=4/6/7.8`, `top_cup_lug_bite=3`, `top_cup_lug_inset=1`, `top_cup_bolt_d=3.2`, `top_cup_bolt_z=9.8`, `top_cup_clamp_s=17`, `top_cup_slit_past_stop=2`. 볼트: **M3 × 약 12mm + 너트**(러그 외면 스팬 7.2 + 너트).
- **불변:** 컵 OD/보어/삽입 깊이·스톱 숄더, 축·자석 포켓(rear), 엔코더 배선 축공·측면 출구(s=8, 슬릿 s10 시작이라 간섭 없음), 베어링 리테이너 락칼라(`axle_pivot_collar` v5.1)는 별도 부품으로 그대로.
- **검증:** front/rear 파트 렌더 매니폴드 **Simple: yes**·경고/에러 0, STL watertight. 레이 계측(양 파트): 마우스 개방·스톱 s=12 정상, 슬릿 갭 1.2(상부 벽 완전 절개, s10..23), 오메가 단면(하벽 −7.7..−3.6 | 상벽+러그 3.6..8.2 | 볼트홀 8.2..11.4 | 러그 상단 11.4..12.8) 정합, rear 배선 측공 보존. 러그 스윕 반경 ≤14mm ≪ 프로파일 상면 거리 25(스윙 무간섭), 러그 Y위치가 베어링 마운트와 비중첩. 전체 조립 렌더 Simple: yes·경고 0.
- **★조립:** 파이프를 스톱까지 삽입 → M3 볼트 조임(클램프) 순. 분해·재조립 가능(접착 불필요). 출력 자세는 기존과 동일하되 러그 하부에 소량 서포트 가능성 — 슬라이서에서 확인.

### v5.8 — 2026-07-25 · 상체 B 무게중심 보정 + 선반 레일화: `upper_bodyB` v5.4→v5.5
**계기(사용자):** ① v5.4의 3면 개방으로 셸 무게중심이 +X(후방)로 과이동 — 계측: 셸 CoM x **v5.2 +5.7 / v5.4 +7.4mm**(균일밀도), 조립 상체 기준 +1.9/+2.3mm. Y 측벽("z축 방향의 면들")을 온전히 복원하고 **X- 면만 개방**해 중심 쪽으로 회복. ② 배터리·보드 사이 벽(선반)의 **중간을 비워 측벽 쪽만 유지** — 그 자리가 전원 스위치 토글 위치.
- **X-만 전폭 개방(측벽 복원):** v5.4의 격벽면 앞 3면 컷 폐기 → v5.3과 동일한 X- 전폭 개구(90존 85, 헤드존 93, 립 없음) 2개 컷으로 복귀. Y벽·X+벽·격벽의 닫힌 박스 단면 복원. **셸 CoM x +7.4→+6.4mm**(조립 상체 +2.3→+2.0mm), 부피 171.5→178.1cm³. 트레이드오프(수용): 보드 Y에지 커넥터는 측방 직선 삽입 대신 넓은 전면 개구로 비스듬히 접근.
- **선반 레일화(중앙 = 스위치 베이):** 전폭 선반 판 → **양측 레일 15mm**(Y벽에 용접, 전연은 개방면 라인) 2개, **중앙 66mm 완전 개방**. 개방 중앙 = 전원 토글 자리(전면에서 조작) + 배터리→보드 상단 배선 직하 통로. 84 팩은 두 레일에 걸침(Y- 끝 벽 버팅, Y+ 끝 리드베이 옆). **전연 토글 슬롯(tsl_*) 은퇴**(파라미터는 참고용 유지), **스트랩 슬롯 중앙쌍 → 레일당 1쌍**(x±13, 슬롯 길이 16→8; 스트랩이 팩 끝+레일 스트립을 감음, 하단 통과는 개방 중앙). T-플러그 패스·충전창 불변.
- **불변:** 높이(robot_l2 372, B 221mm), ocr_center_z/ELL_IMU, 테이프 패드+안착턱, 텔레스코핑 슬리브, 보드 상단 여유 25mm.
- **검증:** 파트·조립 렌더 매니폴드 Simple:yes·경고/에러 0, STL watertight. 점검사(point-in-mesh): 선반 중앙 25점 재료 0(완전 개방), 보드존 Y벽 전면부 복원 확인, 레일·격벽 상단 정상. CoM 계측 상기.

### v5.7 — 2026-07-25 (새벽) · 상체 B 베이 3면 완전 개방: `upper_bodyB` v5.3→v5.4 (같은 요청의 병렬 작업 병합)
**배경:** 아래 v5.6(립 제거)과 이 v5.7은 **같은 사용자 요청("OpenCR 케이블면 최대 개방")을 두 세션이 병렬 작업**한 결과 — v5.6이 먼저 main에 올라가 v5.3을 선점했고, 이 작업은 v5.4로 리비전 +1 하여 병합. v5.3(개구 85/93 전폭 X- 개방)만으로는 Y벽이 보드(75) 측면 에지에서 편측 5mm에 있어, **면 방향(에지) 커넥터 — 파워 케이블, micro-USB, 스위치 — 의 측방(Y±) 직선 플러그 삽입 경로가 여전히 막힘** → 한 단계 더 개방.
- **선반 아래 베이 3면 완전 개방:** 격벽 전면(`bulk_x0`, 테이프 패드면) **앞쪽(x < bulk_x0)의 모든 재료 제거** — X- 벽에 더해 **양쪽 Y벽 전면 스트립까지**, 플레어 용접 상단(z 453)부터 배터리 선반 하면(z 587)까지 전 폭. 보드 구역이 X-·Y-·Y+ 3면 개방되어 모든 에지 커넥터가 **직선 삽입 경로** 확보. 선반 위 배터리 존은 v5.3 전폭 X- 개구(93, 립 없음) 유지.
- **구조 보상:** 격벽(양 Y벽에 용접) + Y벽 후면 스트립(x 1.1~19) + X+ 벽 = 베이 전 높이에 걸친 **닫힌 후방 토션셀** — v5.6의 "주 보강은 전진 격벽" 판단을 형상으로 확정. 안착턱(6×60)은 격벽면 앞으로 돌출하는 유일한 예외로 유지(difference 후 재합집합으로 재구성).
- **불변:** 전체 높이(robot_l2 372, B 파트 ~221mm ≤ X1C 256), `ocr_center_z`/ELL_IMU, 테이프 패드+안착턱 마운트, 닫힌 텔레스코핑 슬리브, 선반 전면 토글 슬롯(*), 보드 상단 케이블 여유 25mm, 배터리 존·충전창.
- **파일:** `upper_bodyB_v5.3.scad` → **`upper_bodyB_v5.4.scad`** rename(+헤더 갱신). 지오메트리는 전부 `frame_master.scad`에서 수정. 어셈블리는 변경 불요(동일 모듈 호출).
- **검증:** 파트 렌더 매니폴드 **Simple: yes**·경고/에러 0(STL watertight), 전체 조립 렌더 Simple: yes·경고 0. 단면 검사: 보드 중앙높이에서 x∈[1.1,19]만 잔존(격벽면 앞 재료 0), 안착턱 돌출(-4.9) 정상, 배터리 존 X- 개구 정상.

### v5.6 — 2026-07-25 · 상체 B X- 서비스면 완전 개방 (v5.2→v5.3)
**계기(사용자):** OpenCR는 보드 법선(X-) 방향뿐 아니라 보드 면방향(가장자리의 전원 리드·USB·핀헤더, ±Y/±Z로 돌출)으로도 케이블이 연결됨 → 전면 개구를 최대로 열어 엣지 케이블이 앞으로 꺾여 나올 공간과 삽입·결선 접근성 확보.
- **리턴 립 제거(lip_ret_y 3→0):** 개구가 내부 전폭으로 확장 — 90존 **79→85**(보드 75 대비 편측 5), 헤드존 **87→93**. 컷 범위 z 453(플레어 상단)~627(캡 하단) 불변.
- **강성 대체 경로(문서화):** 립의 에지 보강 역할은 전진 격벽(양 Y벽을 보드 전 높이로 잇는 웹)·닫힌 X+ 벽·하부 플레어 용접·상부 헤드/캡이 담당(06 로그 "주 보강은 전진시킨 격벽"과 일치). 플레어 구간(445~453) X- 벽은 유지(용접 구조).
- 검증: STL 레이 계측으로 개구 폭(±42/±45 개방, 벽 43/46.5~ 온전)·플레어 폐구간 확인, 파트·전체 조립 렌더 Simple:yes·경고/에러 0. 높이 221 불변.
- ※ 파트 파일은 part_mode 선택자(얇은 래퍼) — 지오메트리는 frame_master.scad에 있음(1장 아키텍처).

### v5.5 — 2026-07-24 (저녁) · 발목 캐리어 간섭 수정 + 상체 B 확정형(A/B, 도어 없음) + 피벗 검증
**① 피벗 축높이 검증(변경 없음):** `encoder_pivot_box`와 반대편 `encoder_pivot_bearing` 모두 **베어링 중심축 = 장착면(프로파일 상면) +25.0mm**로 STL 계측 일치 확인(둘 다 `axis_z`/`mount_rise` 공유 파라미터로 유도 → 구조적으로 동기). 수정 불필요.
**② 피벗 박스 PCB 홀 관통 확인+보강:** 후면 판(5t)의 4×M3(3.4) 홀은 레이/단면 검사상 **이미 완전 관통**이었음(막힌 것처럼 보였다면 프리뷰(F5) 아티팩트 가능성). 컷 실린더를 판 앞뒤 **각 2mm 오버슛**(t+0.4→t+4)으로 키워 향후 판 위치/두께 변경에도 확실히 뚫리도록 보강 — 출력 지오메트리 불변이라 리비전 유지(v5.1).
**③ `lower_ankle_carrier` v5.1→v5.2 (간섭 2건 수정):**
- **랜드 보어 관통:** 구 컷(`2*ring_face−brg_w`)이 |y|29.85에서 멈춰 랜드월(31..33)에 8.4 축공만 남음 → 11.4 노즈가 통과 못 하고 **칼라가 엔드월 면을 눌러 마찰**. 컷을 링 페이스까지 연장, **랜드 보어 d19 완전 관통**(608 내륜 OD 12 < 19 < 외경 22 → 노즈는 내륜만 접촉, 랜드는 외륜만 지지).
- **거싯 클립:** 거싯 헐이 하우징 내측면(|y|=31)을 넘어 |y|=29.6까지 개방 중앙으로 돌출 → 회전 칼라 스윕(최대 반경 12.8, |y|24.4..30.4)과 간섭. 각 거싯을 **|y|=31 평면에서 클립** — 엔드월 면 밖으로 아무것도 돌출하지 않음.
- **검증:** 칼라 회전 스윕 솔리드(몸통 r12.82 + 노즈 r5.7) ∩ 캐리어 = **공집합**(수정 전 176mm³). 노즈-보어 반경 여유 3.8, 칼라 몸통 외측면↔랜드월 내측면 0.6, 러그 상단(12.3~12.8)↔엔드월 하단(z14) ≈1.2~1.7. 매니폴드/경고 0.
**④ `upper_bodyB` v5.1→v5.2 (확정형 A/B, 도어 없음, +22mm):**
- **높이 +22 (`robot_l2` 350→372):** 선반이 보드 상단을 3mm 위에서 덮고 있어 추가 케이블 연결 불가 → 선반/헤드만 +22 상향, **보드 상단 개방 여유 3→25mm**. 보드 자체는 그대로(ocr_center_z 불변 → **ELL_IMU 250.5 유지**). **B 파트 높이 221mm ≤ X1C 256** ✓.
- **오픈 X- 페이스:** 도어(나사 6·보스·리베이트) 전부 삭제, X- 벽 제거 + 리턴 립 3(개구 90존 79 / 헤드존 87). `upper_body_door` part_mode는 폐기 echo만.
- **OpenCR = 테이프 패드 + 하단 안착턱:** 스냅 리벳(튜브·푸시홀·핀홀) 은퇴. 격벽 전면 = 보드 배면(테이핑 패드, bulk_x0=ocr_back_x), 보드 하단은 안착턱(6×60)에 안착.
- **A-B 스플라이스 = 닫힌 텔레스코핑 슬리브**(벽 2.5, 편측 유격 0.3, split 위 8mm 플레어 용접): X-텅 파손 문제 해결. 크로스볼트 2 동일, A는 무변경.
- **전원 토글 = 선반 전면개방 슬롯**(폭 13·깊이 13, y=−20, 전부 (*) 실측 후 조정).
- **여유 변화(에코):** 매달림 바닥 여유 132.2→**110.2mm**(안전). ⚠**강체 스윕 여유 6.5→−15.5mm**: 매달림 강체 난폭 스윙은 이제 **|φ|<18.4°에서만 무충돌**(충돌창 ±[18.4°,19.8°], 에코가 자동 산출). 직립 밸런싱은 무영향. 여유 복원이 필요하면 B 높이 재축소 필요(트레이드오프 결정 사항).
- **어셈블리(master) 상체 갱신:** `robot_assembly`에서 도어 호출 삭제 → 마스터 조립이 현행 A/B 상체를 표시.
- ★후속: 시뮬/FW `L2 0.350→0.372` 갱신 + 질량 재실측(질량비·λ 재확인), 토글/충전창 실측.
- 검증: 전 수정 파트 + 조립 렌더 매니폴드 Simple:yes·경고/에러 0.

### v5.4 — 2026-07-24 · 42mm 모듈 실측 반영 + 명명법 전면 개편
- **엔코더 홀 실측:** 4코너 그리드 **37→34(코너 4mm 안쪽 = ±17)**, **M3 셀프탭(2.7)→M3 관통(3.4)**. 나사가 브래킷을 지나 모듈 뒷면 기둥 끝에 체결되므로 관통이 맞음. (발목·피벗 공통, `as_hole_dx/dy`, `as_hole_d`)
- **뒷면 8mm 기둥 대응(`as_back_post=8`):** PCB 뒷면 r3·8mm 기둥 4개를 고려해 장착판을 8mm 뒤로(발목 브래킷 `plate_y0`/`akc_brk_bar_y0`, 피벗 `enc_plate_in_y`). **칩↔자석 공극 1.5 불변.**
- **락칼라 내경:** `shaft_d+0.25`(8.25) → `shaft_print_d+0.1`(**7.9**). 실제 7.8 축에 헐거움(0.45) 해소 → 스냅핏. (발목·피벗 칼라 공통)
- **상체 확정:** **A/B 구성 유지**(ABC 분할·battery lid `upper_body_c` 미진행, 도어 폐기).
- **명명법 개편:** `frame_v5.scad`→`frame_master.scad`, 전 파트 `<대분류>_<소분류>_v5.1.scad`로 rename, 폐기 4종 `deprecated/`, 구프레임 `archive/`, 산출물 `exports/`. include 전부 `frame_master.scad`로 정리(구 v3/v4 include 버그 동시 해소). 전 파트 렌더 매니폴드·조립 경고 0 검증.
- 검증: 발목·피벗 공극 1.5, 전 현행 파트 단일 매니폴드, assembly 경고 0.

### v5.3 — 2026-07-19 (저녁~) · 42mm 실물 모듈 대응(설계)
- 실물 = 쿠팡 하이제니스 "AS5047P 14bit SPI 42mm"(자석 포함). 42×42 보드 대응으로 대개편.
- **발목:** 보드 상단 z=+21 → **브리지 z14→z23**, **플랜지 z0 22→31(+9)**, 하체 통째 +9(`robot_l1 250→259`). 상승 브리지를 하우징에 잇는 **엔드월** 추가. 브래킷 T→**L(46폭, 4코너 홀)**.
- **피벗:** 42 보드가 기존 창에 안 들어가 프레임 **비대칭화**(하면 프로파일 고정, 상단바 축+35). 보드 커넥터-UP 장착. 구 2×M2+슬롯 → 4코너 그리드.
- (당시 홀 그리드는 37 **추정**, 셀프탭 가정 — v5.4에서 실측 34·관통으로 정정)

### v5.2 — 2026-07-19 (낮) · 개방형 캐리어
- 닫힌 캐리어+바닥 리드 은퇴 → **개방형 캐리어**(베어링 하우징 2 + 상부 브리지). 중앙 개방으로 자석·PCB·칼라를 열린 중앙에서 조립.
- **안쪽 락칼라 2개 부활**(노즈 연장형). PCB는 **T-브래킷**으로 브리지 하부에 장착. `ankle_pcb_lid` 폐기.

### v5 / v5.1 — 2026-07-19 · AS5047P 엔코더 전면 도입
- AN25+커플러 은퇴, **AS5047P 비접촉 엔코더**로 교체(피벗·발목). 후방 축 **48→13** 단축 + 축단 자석 포켓. 발목 하단 소켓 **축 일체 출력**. `solid_coupler`/`oldham_coupler` 은퇴.

### v4 — 2026-07-14 · 상체/힙 확정
- 상체 A/B/door, 머리 98·몸 90·발 80, FR12 힙 브래킷, 배터리 선반. (상세는 archive/06 조립피팅 로그)

### v3 — 2026-07-13 · 로봇 본체 최초
- 프레임+줄만 있던 상태에 로봇 본체 최초 추가(상체40/하체25 초기값). 피벗 마운트 상면 장착.

---
*정본 규칙: 값·구조 판단이 필요할 땐 이 CHANGELOG의 최신 LOG를 우선한다. 파일이 여러 개로 보이면 반드시 `_v5.<최댓값>` 또는 `frame_master.scad`가 현행이다.*
