cbshbalance/slackline-balacing1/v19_bringup/firmware/fwe_async_v19/fwe_async_v19.ino

/*
 * fwe_async_v19.ino — 비동기 FWE 실기 1차 (줄태우기 시험용, 2026-08-05)
 * =====================================================================
 * ★아두이노(OpenCR)에 업로드하는 펌웨어. PC 로깅은 exp_logger.py 그대로.
 *
 * 근거: 프로젝트 문서 28(펴기 생략+증분 접기+저속 복귀 = 시뮬 신챔피언),
 *       30(비동기 FWE: F=사건/W=기본상태/E=배경과정). 규칙은 단 두 개다:
 *   ① 위험도 |A| > 트리거(기본 0.6°) → 기운 쪽으로 허리 "증분" 접기  Δδ = K_FOLD × A
 *   ② 조용하면 → δ를 저속(기본 3°/s, 상한 6°/s — 회복속도 상한 규칙)으로 0에 복귀
 *
 * 위험도 A [β-deg] = W0·φ + W1·β + W2·φ̇ + W3·β̇
 *   ★8/6 실험② 실측 w·λ_u 반영 완료 (λ_u=6.68/s 중앙값 6.43, 문서 38)
 *   β = P1R·α + P2R·θ,  α = ank + φ (★8/5 정합점검 확정: --alpha ank+phi),
 *   θ = α + δ,  MOTOR_DIR=+1 (8/5 확정), δ+ = 앞접기 = 기운 쪽(+)으로 접기.
 *
 * [명령] (115200)
 *   z : 영점 (로봇 직립·정지 잡고) — δ 기준도 현 위치로
 *   g : 무장/해제 — 무장 후 |A|<트리거 0.3s 유지되면 자동 시작(GO). 다시 g = 해제
 *   s : 200Hz 로그 스트리밍 ON/OFF   x : 비상 — 토크 컷 + 제어 OFF
 *   r : δ 목표 즉시 0                 t : 상태 한 줄
 *   + - : K_FOLD ±1   d : 접기방향 토글(FWE/역방향)   [ ] : 트리거 ±0.1°   v : 복귀속도 순환
 * CSV: D,t_ms,phi_deg,ank_deg,del_deg,A_deg,dcmd_deg
 *      E,t_ms,FOLD,<Δδ> | E,t_ms,FALL | E,0,CTRL_ON/OFF | E,0,ZERO
 *
 * 안전: 잡을 사람 상시 배치. |α|>25° → 자동 토크 컷(E,FALL). δ 명령 ±40° 제한,
 *       증분 1회 ±12° 제한, 증분 후 150ms 잠금(≈배가시간).
 */
#include <SPI.h>
#include <Dynamixel2Arduino.h>

// ---------------- 핀·모터 ----------------
#define PHI_CS 10
#define ANK_CS 9
#define DXL_SERIAL  Serial3
#define DXL_DIR_PIN 84
#define DXL_ID      1
const int MOTOR_DIR = +1;          // ★8/5 정합점검 확정 (+δ = 앞접기)
Dynamixel2Arduino dxl(DXL_SERIAL, DXL_DIR_PIN);
using namespace ControlTableItem;

// ---------------- 모델 상수 (실측 질량표 7/30-31 기준) ----------------
// p1 = m1·ell1 + m2·L1 = 0.1094*0.084 + 0.6406*0.259 = 0.17510
// p2 = m2·ell2 = 0.6406*0.1917 = 0.12280   → P1R=p1/(p1+p2), P2R=p2/(p1+p2)
const float P1R = 0.5878f;
const float P2R = 0.4122f;
// ★2026-08-06 실험② 실측 반영 (0806_exp2_tilt_r1.csv, 유효 14시도, 문서 38):
//   λ_u = 6.68 ± 2.90 /s (중앙값 6.43 — 모델 6.4 대비 +0.5%, 게이트 통과)
//   w   = (φ,β,φ̇,β̇; β=1) = (-0.3655, 1, -0.0690, 0.1287)
//   β̇계수 0.129 ≈ 1/λ — 예측점(A=β+β̇/λ) 이론 구조와 정합.
float LAMBDA_U = 6.68f;            // [1/s] 실측 (실험② 8/6)
float W0 = -0.3655f, W1 = 1.0f, W2 = -0.0690f, W3 = 0.1287f;   // 실측 w

// ---------------- 제어 상수 (문서 28 시뮬 확정값 기반) ----------------
float A_TRIG_DEG   = 0.6f;         // 트리거 문턱 [β-deg]
float K_FOLD       = 12.0f;        // 증분 환산비 Δδ=K·A (시뮬 고원 8~15)
int   FOLD_DIR     = +1;           // 8/6 r11: +1=FWE(기운 쪽 접기, 줄이 움직일 때 정답)
                                   //          -1=역방향(CoM 되돌리기 — 줄이 정지마찰로 붙었을 때 가설)
float RET_DPS      = 3.0f;         // 저속 복귀 [°/s] (상한 6 — v<λ·A여유/킥계수)
float DCMD_CAP     = 40.0f;        // δ 명령 상한 [°] = 유일한 캡 (기구한계 55 에서 15° 여유)
                                   //   기구 간섭(케이블·프레임)이 없다고 확인되면 55 까지 올릴 수 있다.
                                   //   시뮬은 55 로 돌고, 실측 파라미터·초기 4° 에서 최대 유지각 38° 였다.
float STEP_CAP     = 40.0f;        // 증분 1회 상한 [°] = DCMD_CAP (관절 한계에 맞춤)
                                   // ★2026-08-14 변경: 22 -> 40. 캡을 '기구 한계' 하나로 통일.
                                   //   근거(v19_sim, 실측 파라미터·γ=10 고정, 30s 상한):
                                   //     초기각 3.0° -> 필요한 첫 증분 28.6°
                                   //     초기각 4.0° -> 필요한 첫 증분 38.0°
                                   //     STEP_CAP 22 로 자르면 초기 4°에서 1.2s 만에 낙하,
                                   //     캡을 풀면 30s 완주. 즉 22 는 '첫 접기'를 잘라버린다.
                                   //   비례식의 논리는 "A 가 크면 그만큼 크게 접는다" 이므로
                                   //   캡에 걸린다 = 필요한 만큼 못 접는다 = 못 잡는다.
                                   //   글리치 방어는 앞단(A 클램프 ±60, 정상범위 게이트,
                                   //   각속도 물리클램프, A 저역필터)이 담당한다.
                                   //   (이력: 8/6 r3 에 12 -> 22. 12 는 추격 실패였다)
uint32_t FOLD_LOCK_MS = 120;       // 증분 후 잠금 (8/6 r3: 큰 증분+짧은 주기 = 유효 접기속도 180°/s+)
float FALL_ALPHA_DEG  = 25.0f;     // |α| 초과 시 낙하 판정 → 토크 컷
// ★★TODO(2026-08-07, 프로젝트 문서 40): 250 → 600 으로 올릴 것. 토크·속도 수지 재계산 결과
//   줄 위 유효관성 0.0059 kg·m²(지그 0.0477의 1/8 — 접기 반작용으로 하체·줄이 따라 움직임)에서
//   acc250이 쓰는 토크는 0.55 N·m = 스톨 3.0의 18%뿐. 즉 우리 설정이 모터보다 먼저 병목이다.
//   acc600 → 필요토크 1.33 N·m(44%), 20° 접기 122→81ms, 회복 천장 β 2.8°→3.6°.
//   ⚠벤치에서 잡을 사람 두고 적용 — 결합부 7Hz 진동을 더 세게 두드린다.
int PROF_ACC_UNIT = 250;           // ≈5360°/s² (★위 TODO 참조: 600 권장, 미적용)
int PROF_VEL_UNIT = 300;           // ≈412°/s (8/6 상향)

// ---------------- 검증판 SPI 엔코더 (tilt_release_test와 동일) ----------------
static SPISettings ENC_SPI(1000000, MSBFIRST, SPI_MODE1);
uint16_t encParity(uint16_t v){ v^=v>>8; v^=v>>4; v^=v>>2; v^=v>>1; return v&1; }
uint16_t encXfer(int cs, uint16_t f){
  SPI.beginTransaction(ENC_SPI); digitalWrite(cs, LOW); delayMicroseconds(1);
  uint16_t r = SPI.transfer16(f);
  digitalWrite(cs, HIGH); SPI.endTransaction(); delayMicroseconds(1); return r;
}
uint16_t encRaw(int cs){
  uint16_t cmd = 0x3FFF | 0x4000; cmd |= encParity(cmd)<<15;
  encXfer(cs, cmd);
  return encXfer(cs, cmd) & 0x3FFF;
}
uint16_t phi_zero=0, ank_zero=0;
float wrapDeg(uint16_t raw, uint16_t zero){
  int16_t d=(int16_t)((raw-zero)&0x3FFF); if(d>8191)d-=16384;
  return d*(360.0f/16384.0f);
}

// ---------------- 상태 ----------------
bool streaming=false, ctrl_on=false, armed=false;
uint32_t quiet_since=0;
int32_t d_zero_raw=0;              // δ=0 기준 서보 raw
float dcmd=0;                      // δ 명령 [°]
uint32_t lock_until=0;
float phi_f=0, ank_f=0, dphi=0, dbeta=0;
float phi_hist[5]={0}, beta_hist[5]={0}; int hist_i=0; int hist_n=0;
float A_f=0, A_avg=0, A_trim=0;
bool est_init=false;
uint32_t drop_cnt=0;

float delDeg(){ return MOTOR_DIR*(dxl.getPresentPosition(DXL_ID)-d_zero_raw)*(360.0f/4096.0f); }
void sendDelta(float d){
  int32_t goal = d_zero_raw + MOTOR_DIR * (int32_t)(d * 4096.0f/360.0f);
  dxl.setGoalPosition(DXL_ID, goal);
}
void ev(const char* name, float val=NAN, uint32_t t=0){
  Serial.print("E,"); Serial.print(t?t:millis()); Serial.print(","); Serial.print(name);
  if(!isnan(val)){ Serial.print(","); Serial.print(val,3); }
  Serial.println();
}

void setup(){
  Serial.begin(115200); delay(500);
  pinMode(PHI_CS,OUTPUT); digitalWrite(PHI_CS,HIGH);
  pinMode(ANK_CS,OUTPUT); digitalWrite(ANK_CS,HIGH);
  SPI.begin();
  Serial.println("=== fwe_async_v19 — 비동기 FWE (증분 접기 + 저속 복귀) ===");
  uint16_t rp=encRaw(PHI_CS), ra=encRaw(ANK_CS);
  Serial.print("phi raw="); Serial.print(rp);
  Serial.print("  ank raw="); Serial.println(ra);
  if(rp==0||ra==0) Serial.println("★경고: raw 0 — 엔코더 배선 확인 (제어 금지!)");
  dxl.begin(57600); dxl.setPortProtocolVersion(2.0);
  if(dxl.ping(DXL_ID)){ dxl.torqueOff(DXL_ID); dxl.writeControlTableItem(BAUD_RATE,DXL_ID,3); delay(50);}
  dxl.begin(1000000);
  Serial.println(dxl.ping(DXL_ID)?"DXL 1Mbps OK":"DXL 응답없음 — 배터리/RS-485 확인");
  dxl.torqueOff(DXL_ID); delay(20);
  dxl.setOperatingMode(DXL_ID, OP_EXTENDED_POSITION); delay(20);
  dxl.writeControlTableItem(PROFILE_ACCELERATION, DXL_ID, PROF_ACC_UNIT);
  dxl.writeControlTableItem(PROFILE_VELOCITY,     DXL_ID, PROF_VEL_UNIT);
  d_zero_raw = dxl.getPresentPosition(DXL_ID);
  Serial.println("절차: 로봇 직립 잡고 z → s(로그) → g(제어 시작) → 손 떼기");
  Serial.println("명령: z g s x r t + - [ ] v");
}

void loop(){
  static uint32_t nx=0;
  uint32_t now_us = micros();
  if((int32_t)(now_us-nx) < 0){ pollSerial(); return; }
  nx = now_us + 5000;              // 200 Hz 고정 루프
  const float dt = 0.005f;

  // ---- 측정 (드롭아웃/글리치 가드: raw=0 또는 90°+ 점프면 이전값 유지) ----
  uint16_t rp=encRaw(PHI_CS), ra=encRaw(ANK_CS);
  float phi = (rp==0)? phi_f : wrapDeg(rp, phi_zero);
  float ank = (ra==0)? ank_f : wrapDeg(ra, ank_zero);
  if(est_init && fabs(phi-phi_f)>90){ phi=phi_f; drop_cnt++; }
  if(est_init && fabs(ank-ank_f)>90){ ank=ank_f; drop_cnt++; }
  float del = delDeg();

  // ---- 추정: α=ank+φ(확정), θ=α+δ, β, 속도(EMA 미분) ----
  float alpha = ank + phi;
  float theta = alpha + del;
  float beta  = P1R*alpha + P2R*theta;
  if(!est_init){
    for(int i=0;i<5;i++){ phi_hist[i]=phi; beta_hist[i]=beta; }
    est_init=true;
  }
  // 미분: 25ms(5샘플) 기저 차분 + EMA — 0.022° 양자화 잡음 억제 (8/6 r4 수정)
  int old_i = hist_i;                       // 5샘플 전 값
  float dphi_raw  = (phi  - phi_hist[old_i])  / (5*dt);
  float dbeta_raw = (beta - beta_hist[old_i]) / (5*dt);
  phi_hist[hist_i]=phi; beta_hist[hist_i]=beta; hist_i=(hist_i+1)%5;
  // 물리 한계 클램프: 실물 각속도는 수백°/s를 넘을 수 없다 — 넘으면 센서 쓰레기
  static uint16_t insane_cnt=0;
  if(fabs(dphi_raw)>500 || fabs(dbeta_raw)>500){
    dphi_raw=constrain(dphi_raw,-500.0f,500.0f);
    dbeta_raw=constrain(dbeta_raw,-500.0f,500.0f);
    if(insane_cnt<60000) insane_cnt++;
  } else if(insane_cnt>0) insane_cnt--;
  static uint32_t last_sensor_warn=0;
  if(insane_cnt>100 && millis()-last_sensor_warn>2000){   // 0.5초 이상 지속되면 경고
    last_sensor_warn=millis(); ev("SENSOR");
    Serial.println("# ★센서 이상(발목/φ 각속도 비물리) — 배선·자석 점검. 제어 신뢰 불가");
  }
  dphi  = 0.85f*dphi  + 0.15f*dphi_raw;
  dbeta = 0.85f*dbeta + 0.15f*dbeta_raw;
  phi_f=phi; ank_f=ank;
  float A = W0*phi + W1*beta + W2*dphi + W3*dbeta;   // [β-deg]
  A = constrain(A, -60.0f, 60.0f);          // 표시·판정 한계 (이 밖은 어차피 낙하)
  A_f = 0.85f*A_f + 0.15f*A;                // 위험도 저역필터 (τ≈30ms ≪ 배가시간 150ms)

  // ---- 무장 상태: 조용해지면(|A|<트리거 0.3초 유지) 자동 시작 ----
  if(armed && !ctrl_on){
    A_avg = 0.98f*A_avg + 0.02f*A_f;        // 잡고 있는 자세의 느린 평균 (τ≈0.25s)
    if(fabs(A_f - A_avg) < 0.7f && fabs(A_avg) < 8.0f){ // 조용함 + 자세 정상범위일 때만
      if(quiet_since==0) quiet_since=millis();
      else if(millis()-quiet_since>250){
        A_trim = constrain(A_avg, -8.0f, 8.0f);   // ★자동 트림: 이 자세가 기준점
        ctrl_on=true; armed=false; lock_until=millis();
        ev("GO", A_trim, 0); Serial.print("# 제어 시작! 손 떼세요 (트림 ");
        Serial.print(A_trim,2); Serial.println("도)");
      }
    } else quiet_since=0;
  }

  // ---- 제어 ----
  if(ctrl_on){
    if(fabs(alpha) > FALL_ALPHA_DEG){
      dxl.torqueOff(DXL_ID); ctrl_on=false; ev("FALL", alpha);
      Serial.println("# 낙하 감지 — 토크 컷. 재개: 로봇 직립으로 세우고 g (필요시 z 먼저)");
    } else if(fabs(A_f - A_trim) > A_TRIG_DEG && millis() > lock_until
              && fabs(dcmd - del) < 4.0f){           // 직전 접기 실행 완료 후에만 재평가
      float step = FOLD_DIR * K_FOLD * (A_f - A_trim);   // d로 방향 토글
      step = constrain(step, -STEP_CAP, STEP_CAP);
      bool was_rail = (fabs(dcmd) >= DCMD_CAP - 0.01f);
      if(was_rail && ((dcmd>0)==(step>0))) return;   // 상한에서 같은 방향 반복 억제
      dcmd = constrain(dcmd + step, -DCMD_CAP, DCMD_CAP);
      sendDelta(dcmd);
      lock_until = millis() + FOLD_LOCK_MS;
      ev("FOLD", step);
      if(!was_rail && fabs(dcmd) >= DCMD_CAP - 0.01f){
        ev("RAIL", dcmd);   // 접기 상한 도달 — 잡혀 있거나 이미 회복 불능 신호
        Serial.println("# δ 상한 도달 — 손으로 잡고 있다면 r(복귀) 또는 x. 줄 위라면 낙하 임박");
      }
    } else if(millis() > lock_until && fabs(dcmd) > 0.01f){
      float dd = RET_DPS * dt;                       // 저속 복귀 (배경과정 E)
      dcmd += (dcmd > 0)? -min(dd, dcmd) : min(dd, -dcmd);
      sendDelta(dcmd);
    }
  }

  // ---- 로그 ----
  if(streaming){
    Serial.print("D,"); Serial.print(millis());
    Serial.print(","); Serial.print(phi,3);
    Serial.print(","); Serial.print(ank,3);
    Serial.print(","); Serial.print(del,3);
    Serial.print(","); Serial.print(A_f,3);
    Serial.print(","); Serial.println(dcmd,3);
  }
  pollSerial();
}

void pollSerial(){
  if(!Serial.available()) return;
  char c=Serial.read();
  if(c=='z'){
    phi_zero=encRaw(PHI_CS); ank_zero=encRaw(ANK_CS);
    d_zero_raw=dxl.getPresentPosition(DXL_ID);
    dcmd=0; est_init=false; ev("ZERO",NAN,0);
  }
  else if(c=='g'){
    if(ctrl_on||armed){ ctrl_on=false; armed=false; ev("CTRL_OFF",NAN,0); }
    else {
      dxl.torqueOff(DXL_ID); delay(10);
      dxl.setOperatingMode(DXL_ID, OP_EXTENDED_POSITION); delay(10);
      dxl.writeControlTableItem(PROFILE_ACCELERATION, DXL_ID, PROF_ACC_UNIT);
      dxl.writeControlTableItem(PROFILE_VELOCITY,     DXL_ID, PROF_VEL_UNIT);
      dxl.torqueOn(DXL_ID);
      dcmd = delDeg();                 // 현 자세에서 무점프 시작
      armed=true; quiet_since=0; A_avg=A_f;
      ev("ARMED",NAN,0);
      Serial.println("# 무장 — 로봇을 직립으로 안정시키면 자동 시작(GO) 후 손 떼기");
    }
  }
  else if(c=='s'){ streaming=!streaming; ev(streaming?"STREAM_ON":"STREAM_OFF",NAN,0); }
  else if(c=='x'){ dxl.torqueOff(DXL_ID); ctrl_on=false; ev("ESTOP",NAN,0);
                   Serial.println("# 비상정지 — 재개: g"); }
  else if(c=='r'){ dcmd=0; sendDelta(0); ev("RET0",NAN,0); }   // 토크 ON이면 즉시 복귀
  else if(c=='d'){ FOLD_DIR=-FOLD_DIR; ev("FDIR",FOLD_DIR,0);
                   Serial.println(FOLD_DIR>0?"# 접기방향: FWE(기운 쪽)":"# 접기방향: 역방향(CoM 되돌리기)"); }
  else if(c=='+'){ K_FOLD+=1; ev("KFOLD",K_FOLD,0); }
  else if(c=='-'){ K_FOLD-=1; if(K_FOLD<1)K_FOLD=1; ev("KFOLD",K_FOLD,0); }
  else if(c=='['){ A_TRIG_DEG=max(0.2f,A_TRIG_DEG-0.1f); ev("TRIG",A_TRIG_DEG,0); }
  else if(c==']'){ A_TRIG_DEG+=0.1f; ev("TRIG",A_TRIG_DEG,0); }
  else if(c=='v'){ RET_DPS = (RET_DPS>=6.0f)?1.5f:(RET_DPS*2.0f); ev("RETDPS",RET_DPS,0); }
  else if(c=='t'){
    Serial.print("# ctrl="); Serial.print(ctrl_on);
    Serial.print(" K="); Serial.print(FOLD_DIR*K_FOLD,1);
    Serial.print(" trig="); Serial.print(A_TRIG_DEG,2);
    Serial.print(" ret="); Serial.print(RET_DPS,1);
    Serial.print(" dcmd="); Serial.print(dcmd,2);
    Serial.print(" A="); Serial.print(A_f,2);
    Serial.print(" trim="); Serial.print(A_trim,2);
    Serial.print(" armed="); Serial.print(armed);
    Serial.print(" drop="); Serial.println(drop_cnt);
  }
}
