cbshbalance/slackline-balacing1/(commit log)

2026-07-24 cad(v5.4): 실측 반영 — 엔코더 42x42 모듈 실물 대응
    - 홀 그리드 37->34 (코너 4mm 안쪽 = ±17), M3 셀프탭(2.7)->M3 관통(3.4):
    나사는 브래킷을 지나 모듈 뒷면 기둥 끝에 체결
    - as_back_post=8: PCB 뒷면 8mm 기둥 대응, 장착판을 8mm 뒤로(발목·피벗 모두).
    칩<->자석 공극 1.5 불변
    - 락칼라 내경 shaft_d+0.25(8.25) -> shaft_print_d+0.1(7.9): 7.8 축에 스냅핏
    - 검증: 전 파트 단일 매니폴드, 조립 경고 0, 공극 1.5 유지
    Claude-Session: https://claude.ai/code/session_01TwH9yc5Z1FUEN77KSus8Np
    [frame_v5.scad]
2026-07-24 cad: 명명법 전면 개편 + CHANGELOG(정본) — frame_master + <대분류>_<소분류>_v5.1
    - frame_v5.scad -> frame_master.scad(공용 지오메트리 정본), frame_v1~v4 -> archive/
    - 전 현행 파트 -> <대분류>_<소분류>_v5.1.scad (lower/upper/axle/encoder)
    - 폐기 4종(ankle_pcb_lid, upper_body_door, solid/oldham_coupler) -> deprecated/ + _DEPRECATED
    - 슬라이서 산출물 -> exports/
    - 전 래퍼 include -> frame_master.scad (구 v3/v4 include 버그 동시 해소)
    - cad/CHANGELOG.md 신설: 현재 구성표 + 명명법 + 세부 로그(v3~v5.4) + 타 세션 작업 절차
    - (이 브랜치는 v5.4 실측 반영분 포함) 전 현행 파트 렌더 매니폴드, 조립 경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
    [ankle_carrier_part.3mf, ankle_carrier_part.gcode.3mf, ankle_pcb_lid_DEPRECATED.scad, axle_ankle_socket_v5.1.scad, axle_pivot_collar_v5.1.scad, axle_pivot_front_v5.1.scad, axle_pivot_rear_v5.1.scad, bearing_mount_part.3mf]
2026-07-24 cad(v5.5): 발목 캐리어 간섭 수정(v5.2) + 상체 B 확정형 A/B(v5.2, 도어 폐기·+22mm) + 피벗 검증
    - 피벗: 박스/전방 마운트 베어링 축높이 25.0/25.0mm 일치 검증(수정 불필요).
    후면 판 4xM3 홀 관통 확인 + 컷 양면 2mm 오버슛 보강(지오메트리 불변).
    - lower_ankle_carrier v5.1->v5.2: 랜드 보어 d19 링페이스까지 관통(칼라
    노즈가 608 내륜에 직접 접촉, 엔드월 마찰 제거) + 거싯 |y|=31 클립
    (엔드월 면 밖 돌출 제거). 칼라 회전 스윕 간섭 176mm^3 -> 0 검증.
    - upper_bodyB v5.1->v5.2: 도어 폐기->오픈 X- 페이스(립 3), OpenCR 테이프
    패드+안착턱(리벳 은퇴), 닫힌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
    [encoder_pivot_bearing_v5.1.scad, encoder_pivot_box_v5.1.scad, frame_master.scad, lower_ankle_carrier_v5.1.scad, lower_ankle_carrier_v5.2.scad, upper_bodyB_v5.1.scad, upper_bodyB_v5.2.scad]
2026-07-24 cad(v5.6): 상체 B X- 서비스면 완전 개방 (v5.2->v5.3, 립 제거)
    - OpenCR 엣지 커넥터(전원 리드·USB·핀헤더, 보드 면방향 돌출) 결선을
    위해 리턴 립 삭제(lip_ret_y 3->0): 개구 90존 79->85 / 헤드존 87->93,
    내부 전폭 개방. 컷 z범위(플레어 상단 453~캡 하단 627)·높이 221 불변.
    - 에지 강성은 전진 격벽 + 닫힌 X+ 벽 + 플레어 용접 + 헤드/캡이 담당
    (립은 보조였음 - 06 조립 로그와 일치). 플레어 구간 X- 벽 유지.
    - STL 레이 계측으로 개구 폭·벽 온전성 검증, 파트+조립 렌더 Simple:yes
    경고/에러 0. CHANGELOG v5.6.
    [frame_master.scad, upper_bodyB_v5.2.scad, upper_bodyB_v5.3.scad]
2026-07-24 cad(v5.7): upper_bodyB v5.4 — 선반 아래 베이 3면 완전 개방(케이블면 최대 개방, v5.6과 병렬 작업 병합)
    - v5.3(립 제거, 개구 85/93)만으로는 Y벽이 보드(75) 측면 에지에서 편측
    5mm → 면 방향 에지 커넥터(파워 케이블, micro-USB, 스위치)의 측방
    직선 플러그 경로가 여전히 막힘. 격벽면(bulk_x0) 앞의 재료 전부 제거:
    X- 벽 + 양쪽 Y벽 전면 스트립, 플레어 상단(453)~선반 하면(587) 전 폭.
    보드 구역 X-·Y-·Y+ 3면 개방. 배터리 존은 v5.3 전폭 개구(93) 유지.
    - 구조 보상: 격벽 + Y벽 후면 스트립(x 1.1~19) + X+ 벽 = 닫힌 후방
    토션셀. 안착턱은 격벽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
    [frame_master.scad, upper_bodyB_v5.3.scad, upper_bodyB_v5.4.scad]
2026-07-24 cad(v5.8): upper_bodyB v5.5 — 무게중심 보정(Y 측벽 복원, X-만 개방) + 선반 레일화(중앙 스위치 베이)
    - CoM 계측(균일밀도 셸): v5.2 +5.7 / v5.4 +7.4 / v5.5 +6.4mm (조립 상체
    +1.9/+2.3/+2.0mm). v5.4의 격벽면 앞 3면 컷 폐기 → Y 측벽 전체 복원,
    X- 면만 전폭 개방(90존 85 / 헤드존 93, 립 없음). 닫힌 박스 단면 복원.
    - 선반 레일화: 전폭 선반 판 → 양측 레일 15mm(중앙 66mm 완전 개방).
    개방 중앙 = 전원 스위치 토글 자리(전면 조작) + 배터리→보드 배선 통로.
    전연 토글 슬롯(tsl_*) 은퇴(파라미터는 참고용), 스트랩 슬롯 중앙쌍 →
    레일당 1쌍(x±13,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
    [frame_master.scad, head_view.scad, upper_bodyB_v5.4.scad, upper_bodyB_v5.5.scad]
2026-07-24 cad: 임시 뷰 파일(head_view.scad) 제거 — v5.8 커밋에 실수로 포함된 렌더 보조 파일
    Claude-Session: https://claude.ai/code/session_01Vi37GqQBHfPiD364x5F6MW
    [head_view.scad]
2026-07-29 cad v5.9: fuse pipe lock-collar clamp into upper pivot sockets (front/rear v5.1->v5.2)
    - omega lugs + top slit + M3 cross bolt on the carbon-pipe cup (glue-free retention)
    - new params: top_cup_clamp / slit / lug / bolt geometry in frame_master.scad
    - parts renamed axle_pivot_{front,rear}_v5.2.scad, headers + CHANGELOG updated
    - verified: part & assembly renders Simple:yes, 0 warnings; ray-cast checks of
    slit gap, omega cross-section, mouth/stop, rear wire bore; swing sweep clear
    [axle_pivot_front_v5.1.scad, axle_pivot_front_v5.2.scad, axle_pivot_rear_v5.2.scad, frame_master.scad]
2026-07-29 cad v5.10: flip rear cup clamp to outside of the bend (axle_pivot_rear v5.2->v5.3)
    - clamp_zf mirrors lugs/bolt/slit to local -Z on the rear socket so both
    sockets carry the clamp on the outside of the bridge-cup bend
    - front v5.2 geometry unchanged (re-render verified)
    - verified: part & assembly renders Simple:yes, 0 warnings; ray-cast omega
    cross-section mirrored, mouth/stop and rear wire bores preserved
    [axle_pivot_rear_v5.3.scad, frame_master.scad]
2026-07-29 cad v5.11: fix ankle L-bracket geometry defect (bracket v5.1->v5.2, carrier v5.2->v5.3)
    Root cause: akc_brk_bar_y1 and akc_brk_screw were hardcoded absolutes from
    before the v5.4 as_back_post=8 standoff moved the plate front -16.6 -> -8.6.
    - bar collapsed 12.6 -> 4.6 mm (L-bracket had effectively lost its L)
    - M3 clearance hole broke out through the bar's rear edge and pierced the
    plate, blocking the driver approach
    - both now DERIVED from the plate front plane (bar_len 12.6, screw_y -3.2)
    - carrier bridge pilots follow the same screw list -> revision bump
    - verified: part & assembly renders Simple:yes, 0 warnings; ray-cast shows
    closed hole (3.7/5.5 mm material fore/aft), no edge break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
    [encoder_ankle_bracket_v5.2.scad, frame_master.scad, lower_ankle_carrier_v5.3.scad]
2026-07-29 docs: add consolidated measurement guide (실측 최종정리본, 2026-07-29)
    Merges v19_bringup/README steps 0-6, docs/실측_캘리브레이션_절차_20260620,
    and the post-assembly self-test procedure into one document:
    - physics rationale mapping each quantity to the motion that reveals it
    - per-item method detail, params_v19.py input location, and gates
    - known pitfalls, repo gap survey, and a fill-in record sheet
    - flags the v5.11 ankle bracket/carrier reprint before mass measurement
2026-07-30 firmware: add motor profile/triangle test sketches (guide doc 17, 07-30 safety fixes)
    - motor_profile_test: trapezoid (accel-cruise-decel) move + dual-encoder
    100Hz streaming, exp_logger-compatible D/E rows
    - motor_triangle_test: triangle profile (v_peak=sqrt(a*d), no cruise) for
    finite-time fold experiments matching the gamma_tri assumption
    - both include the 07-30 safety fixes: goal-then-torque-on at boot
    (no jump on power-up) and auto torque recovery on 'g' after 'x'
    [motor_profile_test.ino, motor_triangle_test.ino]
2026-07-30 params_v19: 2026-07-30 body measurements (m, CoM, bifilar inertia)
    - m1=0.190, m2=0.560 kg (scale)
    - ell1=0.084 m (lower window bottom edge -> CAD conversion),
    ell2=0.215 m (157 mm below bodyB top, CAD 372 nominal; remeasure L2)
    - I1_cm=2.48e-3, I2_cm=1.81e-2 kg m^2 via bifilar suspension
    (T=7.620s/10.930s); record-sheet values were a 10x arithmetic slip,
    period-derived values adopted as canonical
    - L2 nominal updated 0.40 -> 0.372 (CAD robot_l2)
2026-07-30 params_v19: record measurement composition; composite motor into upper body
    07-30 clarification: the measured upper segment (0.560 kg, bodyA+B +
    battery + OpenCR + wiring + S101 bracket) EXCLUDES the XM430, and the
    measured lower segment (0.190 kg) EXCLUDES the H101 hinge bracket/idler.
    - m2/ell2/I2_cm now composite with nominal motor 82 g at hip +9 mm:
    m2 0.560->0.642, ell2 0.215->0.189, I2_cm 1.81e-2->2.11e-2
    (raw measured values kept in comments; refine 07-31 with motor weigh-in)
    - m1 note: add H101+idler mass after 07-31 weigh-in
    - ROPE.bottom_m: exclude the two 608 bearings (already counted in m1)
2026-07-30 params_v19: 07-30 composition re-confirmed - H101 bracket IS in the lower segment
    Lower measurement (0.190 kg) includes the H101 (motor-to-lower) bracket,
    so the lower segment is complete as measured; no 07-31 add-on needed.
    Only the XM430 motor (+horn/idler) remains unweighed; upper composite
    (nominal 82 g) unchanged.
2026-07-30 params_v19: name ROPE mass items with v5 CAD part names
    The 'lower bar' no longer exists in v5 - the 7.8 ankle axle is printed
    into axle_ankle_socket_v5.1 and the two sockets close the trapezoid
    through the ankle carrier's 608 pair. Spell out what to weigh:
    - bottom_m = axle_ankle_socket x2 + lower_ankle_collar x2 + bolts
    (608 bearings excluded - already counted in m1)
    - top_socket_m = axle_pivot_front/rear + axle_pivot_collar x2
    (frame-fixed encoder box/bearing mount excluded; ~0.2% of I_r)
    - crank_L 0.50 -> 0.530 (CAD diag_len)
2026-07-31 params_v19: 07-31 measurements - lengths, carbon rod mass, rope damping fixed
    Measured 07-31: L1=265 mm (CAD 259), hip->bodyB top=375 mm (CAD 372),
    carbon diagonal 15 g each. ell2 recomputed 0.218 raw / 0.191 composite.
    Rope masses were not weighed; estimated from CAD volume x PLA 1.24:
    bottom_m 38 g (sockets x2 + collars x2 + magnets/bolts), top 24 g.
    Bearings and the ankle carrier stay in m1 (not rope).
    c_phi RESOLVED at last (doc 16's blocker): experiment-1 (07-28) hung the
    crank WITH the ankle carrier assembly - 38 g rope + ~105 g ankle = 143 g
    at R, I_exp=0.0287, which reproduces the measured T=1.295 s to 0.2%
    (rope-only 38 g would give 1.244 s). Hence c_phi = 2*zeta*w*I_exp
    = 0.0021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
2026-07-31 params_v19: motor is inside the 190 g lower piece - reassign to upper link
    07-31 correction from the user: the 190 g lower measurement INCLUDES the
    XM430 (weighed alone: 80.6 g); the 560 g upper does not. Total 750 g
    (user reports 755 g). L1 re-measured = 259 mm (matches CAD); hip->bodyB
    top = 375 mm (CAD 372 + a 3 mm gap at the motor/upper joint).
    Mechanically the motor CASE belongs to the UPPER link: frame_master marks
    S101 (which grips the case and bolts to the upper cap) 'Upper-body-fixed'
    and H101 (horn + idler, bolted to the lower spine) 'Lower-body-fixed'.
    The motor merely stayed on the lower half during disassembly. So:
    m1 0.190 -> 0.1094, I1_cm 2.48e-3 -> 8.85e-4 (motor stripped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
2026-07-31 params_v19 + tooling: bottom_m measured (14 g); add hip-inertia test sketch & analyzer
    params_v19:
    - ROPE.bottom_m = 0.014 kg MEASURED (sockets x2 + collars x2). That is
    40% of the CAD solid figure (35 g) - printed parts run ~0.5 g/cm^3, so
    top_socket_m rescaled by the same ratio to 10 g.
    - I_r 0.00901 -> 0.00450, iota 0.064 -> 0.032.
    - c_phi re-derived: with a 14 g rope bottom, matching experiment-1's
    T=1.295 s needs ~100+-25 g total hanging at R (rope + ankle carrier
    assembly), so I_exp = 0.019 +- 0.004 and c_phi = 0.0014 (was 0.0021),
    tau_coulomb = 0.0013.
    New tooling for experiment 3 (hip effective inertia), which had no code
    in the repo:
    - firmware/motor_inertia_test/: OP_CUR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
2026-07-31 v19 배선·연결 현황 문서화 + 브링업 보조 스케치 추가
    조립 후 브링업에서 실물로 확정된 배선·연결 상태를 문서화하고,
    그 과정에서 만든 진단·테스트 스케치와 실험 로거를 추가한다.
    문서
    - v19_bringup/배선_연결_현황_20260731.md: 핀 대응표(φ CS=D10, 발목 CS=D9,
    공유 SCLK/MISO/MOSI=D13/D12/D11), 모듈 핀 표기 함정(핀 헤더와 6핀 커넥터의
    인쇄 순서가 반대), 모터·전원 확정 사항, 브링업 트러블슈팅 기록, 현재 상태
    - v19_bringup/배선도_20260731.html: 그림 배선도
    - v19_bringup/README.md: 배선·연결 절 추가
    펌웨어 (v19_bringup/firmware/)
    - angle_monitor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
2026-07-31 docs: 남은 실측 통합 안내 (M2 I_δ + 검증진자 A-2/B + Kt·무부하 + 소소 항목)
    문서 18/19/20 통합 + bottom_m 14g 실측 반영 이후 상태로 갱신
    Claude-Session: https://claude.ai/code/session_01KZHPxuqzy89szSvpWV82g5
2026-07-31 docs: M2 허리 유효관성 측정 — 학생용 쉬운 단계별 가이드
    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
2026-07-31 calib: itest_logger.py 추가 — M2 실험용 대화형 로거 (명령 전송 + D/E행 CSV 저장)
    serial_logger.py는 명령 입력 불가·프리픽스 1종만 저장이라 실험 ③에 부적합.
    쉬운 가이드 4~5단계를 itest_logger 기준으로 갱신.
    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
2026-07-31 calib: itest_logger 개선 — 진행 메시지 제거, 명령 필터('i 60' 형태만 전송), 전송/무시 피드백
    조각난 입력이 로봇에 그대로 전달돼 펄스가 중복 시작되던 문제 방지
    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
2026-07-31 firmware: motor_inertia_test — x(토크OFF) 후 'z'로 토크 재활성 가능하게
    기존에는 x 이후 토크를 다시 켤 방법이 보드 리셋뿐이었음(로거가 종료 시 x를
    자동 전송하므로 매 세션 재현). z가 전류제어 모드로 재활성하고, 토크 OFF 상태의
    전류 명령은 안내 메시지와 함께 차단.
    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
2026-07-31 calib: inertia_analysis --dir pos/neg 옵션 — 방향별 분리 분석
    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
2026-07-31 calib: inertia_analysis --method impulse — 충격량-운동량법 추가
    지그·결합부 진동(~7Hz)이 δ(t)에 겹쳐 초기창 2차적합이 깨지는 경우용.
    펄스 전체 적분으로 진동을 상쇄, 단조운동 펄스만 사용.
    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
2026-07-31 v20: 실측 모델 비선형 시뮬 — 'FWE로는 선다' (I_δ·전류 스윕 전 구간 PASS)
    - params: I_ARM(armature 잔차 0.003, 실험③) + TAU_C_HIP(힙 쿨롱 0.045) 추가
    - model_v19: armature 관성을 M[αα]+,[θθ]+,[αθ]− 로 반영 (φ행 불변)
    - v20_sim/sim_v20.py: sympy 비선형 EOM(0점 선형화==model_v19 자동검산),
    전류상한+back-EMF 서보, LQR+칼만/FWE 폐루프, I_ARM×전류 스윕
    - 발견 1: T_fold 60ms는 토크상 실행 불가 → 자기일관 Tf ~110ms(600u), 트리거 0.3°
    - 발견 2: 서보 지연으로 킥 계수 gc_eff ≈ 1.44×이론 → 자가 캘리브레이션 필수
    (안 하면 deadbeat 부호 반전 낙하 — 07-05 ρ 증폭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
2026-07-31 v20 정정: deadbeat 완전사이클의 측정오차 Gc배 증폭 — 결론1에 σ_A 전제 추가
    트리거 0.3~0.8°·전류 600~1193u·4샘플 평균 전 조합에서 σ_A=0.2° 가정 시 낙하.
    신규 실측 M10(σ_A) 제안, 단일접기 위주 전략 대안 기록.
    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
2026-08-05 params_v19 줄 감쇠 정정: 점성 3.3e-4·건마찰 3.1e-4 (doc33, 확정 I_r 4.50e-3 반영)
    Claude-Session: https://claude.ai/code/session_01AFZGeiRwbpyjibWjEGTqKr
2026-08-05 exp_data/ 실험데이터 보관소 신설 + 260805WED 인수 데이터 수록, 실험 코드 정본화
    - exp_data/260805WED: 실험①(10.1)·실험②(11, 0805 tilt)·실험③(12) 원시 CSV, 당시 펌웨어 사본, 검증 영상
    - exp_data/README.md: 폴더·명명 규약, 원시 불변 원칙, 실험② 빠른 절차
    - v19_bringup/firmware: tilt_release_test·hip_swing_test·mounted_swing_log·crank_swing_log·motor_trapezoid_test 정본 추가
    - v19_bringup/calib: exp_analysis_v19.py 추가, exp_logger.py 최신판 교체
    - docs: 어름이_조립후_실험절차서_완전판_v19.docx (결과 기입 대상)
    Claude-Session: https:/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
    [0729_crank_r1.csv, 0729_crank_r2.csv, 0729_crank_r3.csv, 0729_crank_r4.csv, 0729_crank_r5.csv, 0802_exp3_r1.csv, 0802_exp3_r2.csv, 0802_exp3_r3.csv]
2026-08-05 wiring_check.py: 실험 전 배선·각도3종 점검 스크립트 (tilt_release_test용, 부호점검 --sign 포함)
    - 자동 건강점검(수신율·전부0·고정·점프) + 흔들기 응답 + 대화형 부호 정합점검
    - --selftest 로 기존 CSV 판정 검증: 0805 exp2 r1(발목 고정)·r3(φ·발목 전부 0) 결함 검출 확인
    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
2026-08-05 docs: 실험② 재실험 절차서 (새 PC 세팅~데이터 전달, 배선점검 필수화)
    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
2026-08-05 phi_ank_monitor.ino: φ·발목 엔코더만 읽는 배선 확인용 최소 펌웨어 (모터·배터리 불필요)
    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
2026-08-05 wiring_check: --sign 판정을 드롭아웃 강건화 (|편차|>90° 글리치 제외, 유지구간 중앙값)
    8/5 --sign 실측에서 발목 드롭아웃 1샘플(-178°)이 최대편차 판정을 지배한 문제 수정
    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
    [wiring_check.py]
2026-08-05 docs: 부호규약 한장정리 (좌표·δ함정·정합점검 3동작·수식 규약 시각화)
    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
2026-08-05 정합점검 확정 반영: --alpha=ank+phi, MOTOR_DIR=+1 (8/5 실측)
    - wiring_check --sign (b) 판정 문구 수정: 부호 s로부터 올바른 조합(ank+phi / phi-ank) 안내
    - 부호규약 문서: (b) +5.60° 확정, (c) 2차 실수 폐기·1차 채택 기록
    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
    [wiring_check.py]
2026-08-05 cad v5.12: 상단 피벗 컵 클램프 실조임 보강 — 슬릿 1.2→2.2 + 리빙힌지 릴리프(벽 1.7), front v5.3/rear v5.4
    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
    [axle_pivot_front_v5.3.scad, axle_pivot_rear_v5.4.scad, frame_master.scad]
2026-08-05 fwe_async_v19.ino: 비동기 FWE 실기 1차 펌웨어 (증분 접기 Δδ=K·A + 저속 복귀, 문서 28·30 기반)
    - 부호 확정값 반영: α=ank+phi, MOTOR_DIR=+1, +A→+δ(기운 쪽 앞접기)
    - 기본값: 트리거 0.6°, K_FOLD 12(고원 8~15), 복귀 3°/s(상한 6), δ캡 40°, 증분캡 12°
    - 안전: |α|>25° 자동 토크컷, x 비상정지, 드롭아웃/글리치 가드
    - λ_u·w는 실험② 확정 후 상수 교체 (기본 A≈β+β̇/λ 예측점)
    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
2026-08-05 cad v5.13: 발목 하단 소켓에도 파이프 클램프 융합 (슬릿 2.2+리빙힌지) — axle_ankle_socket v5.2
    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
    [axle_ankle_socket_v5.2.scad, frame_master.scad]
2026-08-06 fwe_async_v19: 실험② 실측 반영 — λ_u=6.68/s(중앙값 6.43), w=(-0.3655,1,-0.0690,0.1287)
    0806_exp2_tilt_r1.csv 유효 14시도. 모델 6.4 대비 +0.5%(중앙값), 게이트 통과. 상세: 프로젝트 문서 38
    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
2026-08-06 fwe_async_v19: FALL/ESTOP 재개 안내 출력, FOLD_LOCK 100→150ms, δ상한 RAIL 이벤트 (8/6 1차 시험 피드백)
    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
2026-08-06 fwe_async_v19: 헤더 주석 잠금시간 150ms로 정합
    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
2026-08-06 fwe_async_v19 v2 튜닝: r3 분석 반영 — STEP_CAP 22°·LOCK 120ms(유효 180°/s+), 프로파일 상향, 무장→조용하면 자동 GO
    r3 진단: 증분 12°/150ms 캐던스가 병목(유효 80°/s), 손 뗀 순간 A=-2.5로 출발 → 추격 실패
    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
2026-08-06 fwe_async_v19: 미분 잡음 수정 — 25ms 기저 차분+EMA, 위험도 저역필터 A_f(τ≈30ms), GO 게이트 1.0°/0.25s
    r4 진단: 5ms 차분이 엔코더 양자화(0.022°)를 증폭해 A가 ±1~2° 널뜀 → GO 불발·트리거 오발.
    r4 데이터 오프라인 재생으로 검증: 신규 A_f는 조용 구간 연속 5.96s 확보
    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
    [fwe_async_v19.ino]
2026-08-06 fwe_async_v19: 자동 트림(GO 시 잡은 자세=기준점) + 정상범위 게이트 + r 항상 동작 + 접기 실행완료 게이트
    r5/r7 진단: A에 -5~-7° 상수 편향(z영점 vs 실균형 어긋남+줄 데드밴드) → GO 불발/가짜직립 추격 폭주.
    r 버그: 무장 중 서보 미전송. 오프라인 재생 검증: r5 GO+0.3s 트림 0.68°
    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
2026-08-06 fwe_async_v19: 센서 쓰레기 방호 — 각속도 물리 클램프(±500°/s)·A 클램프(±60°)·SENSOR 자가진단 경고
    r8: 발목 엔코더 재고장(30~90° 점프 744회/20s)이 미분을 타고 A를 수백만까지 증폭 → 명확한 경고로 대체
    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
2026-08-06 phi_ank_monitor v2: 배선 점검 + 고장 부위 추적 (1초 통계 raw0/jump/FRZ, 흔들며 범인 찾기)
    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
2026-08-06 fwe_async_v19: 접기방향 토글(d) 추가 — r11 시소운전 진단(자세 되먹임 루프이득 K×0.41≈5, 줄 정지마찰이 소킥 흡수)
    r11 첫 폐루프 생존 기록: 12.8/9.8/4.8/2.5s 등 7판. 다음 시험: K=2 저이득 vs d 역방향 비교
    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
2026-08-07 Add v19_sim files locally
    [sweep_grid_20260718.csv]
2026-08-07 토크·속도 수지 재계산 기록: PROF_ACC 250→600 필요 + params_v19 실측판 복원 필요 (미적용 TODO)
    - 핵심: 토크는 스톨의 18%만 쓰고 있고 병목은 속도. 유효관성 줄위 0.0059 vs 지그 0.0477(8배) 구분이 관건
    - 회복 천장 β≈4.0°(모터 한계) / 현 설정으로는 2.8° — 시뮬 A*≈3°와 정합
    - CLAUDE.md §7에 항목 7·8 추가, 펌웨어 헤더에 TODO. 상세는 프로젝트 문서 40
    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
2026-08-13 cad: Add frame_master_v6_5.scad and frame v6.1 order list
    [frame_master_v6_5.scad]
2026-08-17 Update project files, measurements, and add presentation suites (v21_pres, etc.)
    [0729_crank_r1.csv, 0729_crank_r2.csv, 0729_crank_r3.csv, 0729_crank_r4.csv, 0729_crank_r5.csv, 0802_exp3_r1.csv, 0802_exp3_r2.csv, 0802_exp3_r3.csv]
2026-08-19 v21_pres: 실사 영상 오버랩 시퀀스, 접기 스파이크 정리 필터 및 Opening1 씬 추가
2026-08-19 docs: 코웍 v21 인계문서 12종 수록(46 정정판 포함) + v21_pres/CLAUDE.md + 후속개발 로드맵 제안(60)
    Claude-Session: https://claude.ai/code/session_019twxH7dp32sZ1raJrU1Psc
2026-08-19 docs: 접기 스파이크 재검증(61) — 물리 판정 유지, '정확 거울반전' 아님, 문서59 메커니즘 문장 정정 + 검증 스크립트
    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
2026-08-19 v21_pres D1: 평면 전체화면(⛶/F)·별도 창 미러(↗) + 예측점 평면 휠줌·우클릭팬·더블클릭 복귀 + 좌클릭/드래그 속도0 집기(실행으로 시작)
    - drawPlane 수동 뷰(중심·배율) 지원 — 자동 범위는 기본 유지, 더블클릭 복귀
    - pose(무clear) 스트림으로 드래그 훑기, 마우스업에 x0 확정(리셋 리플레이 무장)
    - 팝업은 표시 전용 미러(같은 drawPlane, PLVIEW 공유, PLSCALE 분리로 본창 집기 무결)
    - 물리·제어·추정 경로 무변경. tests_v21.py ALL PASS + Playwright E2E 통과(JS 오류 0)
    Claude-Session: https://claude.ai/code/session_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
2026-08-19 업데이트받기.bat: 더블클릭으로 git pull 실행 (터미널 불필요)
    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
2026-08-19 v21_pres/서버재시작.bat: 8210 포트 잔류 서버 자동 종료 후 재시작 (더블클릭용)
    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
2026-08-20 docs: 예측점 평면 '선 위 놓기' 실제 궤적 정리(62) — 미끄러짐·진폭배율 √(1+(ω/λ)²)·활/가로지름 해부 + 추정링 초기화 규약
    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
2026-08-20 v21_pres D2+4단계: 두 평면 조작 통일(줌·팬·집기·Shift/Alt) + 전체화면/별도창 [로봇 미러+정사각 평면] + 실측선 오버레이·실측 발목잡음 프리셋
    - D2: 예측점 평면 조작 세트를 두 평면 공통으로 (좌클릭/드래그=속도0 자세, Space=시작; hover·클릭즉시시작 폐기)
    - 전체화면(⛶/F)·별도창(↗) 모두 [왼쪽 3D 미러 + 오른쪽 정사각 평면], 안에서 조작 동일 (뷰·집기 상태 공유)
    - 실측선 오버레이: r·절편·λ 입력 → 두 평면 주황선+실측 트리거 띠, 실측 w=[−1/r,1,−1/(rλ),1/λ] 병기
    - 발목잡음: _measure 발목 채널 σ 주입 (σ=0 → RNG 미호출, 궤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
2026-08-20 v21_pres B: 씬 체인 (scenes/chain.json 배열 데이터 + ]/[ 키 + HUD) + 발표 시나리오 부스배치판 초안(문서 63)
    - 씬 = 데이터: click/check/send/dm/fs/presmode 액션 어휘, 순서 교체는 chain.json 수정만 (문서 56 §3F)
    - 초기 체인 = 문서 63의 3분 화면 큐 6씬 (영상 시퀀스→천천히 접기→평면 전체화면→해제→표준→실측 러닝)
    - scene_load 재사용 (서버 무변경, scene_data 수신만 chain 분기)
    - E2E: 6씬 전진·후진 전부 상태 검증 통과, JS 오류 0. tests_v21.py ALL PASS
    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
2026-08-20 docs: 발목잡음 강건성 문턱 시뮬 예측(64) — σ≤0.10° 안전 / 0.223°(현 실측)은 0/8 낙하, 베어링 교체 목표 0.05° 정량 뒷받침
    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
2026-08-20 fix: 서버재시작.bat — for/f 파이프 이스케이프 오류 수정(옛 서버가 안 죽던 원인) + 브라우저 자동 열기(5초) + 물리엔진 파일 시각 표시
    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
2026-08-20 v21_pres E1: 실기 로그 재생 (CSV→평면 금색 궤적, ±180° 언랩, 실기 파이프라인 속도 재구성, 스크럽=3D 자세 추종, 뷰 자동맞춤) + 문서 61 철회 추기(원 관찰=매달림 ±180 래핑)
    - 스파이크 정리 체크박스 재검토: 시뮬 fold 한정 스파이크(문서 61 계측)는 래핑과 무관한 별도 현상 — 표시 정리용으로 유지
    - .planes 스크롤 + plbox 최소높이 210px (새 UI 박스로 평면이 짜부라지던 문제 수정)
    - E2E: 0817 P2R 실로그 1929행 — 파싱·언랩·궤적·스크럽·자세추종·재생 검증. tests_v21 ALL PASS
    Claude-Session: https://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
2026-08-21 v21_pres E1+: 평활 참고값 — 비인과(중심 이동평균+중앙차분, 지연 0) 준참값을 흰 점선으로 병행 표시, 창 크기 조절
    실기에는 참값이 없지만 사후 분석은 미래 샘플을 쓸 수 있다는 점을 이용 — 금색(로봇 시점)과의
    벌어짐이 그 순간의 추정 오차. E2E: P2R 실로그에서 계산·표시·창 변경 검증. tests_v21 ALL PASS
    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
2026-08-25 docs: 부호 브링업 정적 체크 6단계(65) — 채널별 손 확인, 행동 기반 부호 뒤집기 금지, 펌웨어 검토 기준(루프+측정3+노브4)
    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
2026-08-25 v21_pres E1: fold_logger 형식 지원 — 열 별칭, 펌웨어 계산열(beta·dphi·dbeta·Ahat·hold·phase) 직접 사용, 스크럽 판독(t·Â·phase·hold)
    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
2026-08-25 docs: 매달림 영점 절차(66) — 중력이 CoM 축을 정렬(눈대중 기하축 아님), 양방향 정착 평균, α+180° 플립 단일 지점, 절편 1° = 트리거 초과 진단
    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
2026-08-25 docs: 놓기 프로토콜 v2 — 2단 바 지그(67, 사용자 설계) — 재현성 원리, 첫 접기 무간섭 부호 사슬, 실측 ②·③ 겸용, 부저 큐 제안
    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
2026-08-25 docs: 문서 67 추기 — 실물 확인: 바 불필요, '한방향 대기 + 순서 제거' 원리를 손으로 수행 (기존 실패 원인 = 잡고 놓기)
2026-08-26 docs/cowork: 코웍 문서 37~78 백필 (36건)
2026-08-27 펌웨어: 증분접기 최소판(incremental_fold_min, 266줄) — finale6과 동일한 제어 경로(파이프라인·상태기계·로그형식), 감시·튜닝·편의 제거
2026-08-27 펌웨어 최소판: 단발접기 모드('1') — 첫 트리거에서 한 번만 접고 delta 고정, gamma·lambda 검증용
2026-08-27 펌웨어 최소판: 정지 중 4Hz 모니터 출력(phi·ank·delta·alpha·beta·Ahat·hold) — 부호·영점 눈 확인용
2026-08-28 펌웨어 최소판: 엔코더 채널 부호 상수 PHI_SIGN·ANK_SIGN 추가(읽는 줄에서만 적용) — 정적 체크로 확정 후 사용
2026-09-02 v22_logger: 로거·측정 앱 신설 — 실시간 디지털 트윈 + 측정 과정 검토기
    v21_pres 를 통째로 복사(발표 화면은 /pres 로 보존)하고 측정 앱을 얹었다.
    - 서버: OpenCR USB 시리얼(pyserial) 직접 수신, D/R/F/E 행 분류, 자동 4파일 기록(logs/),
    바이너리 데이터셋 스트리밍(/ws2), 파일 로드·업로드, 분석 디스패치, --fake(파일 재생·합성)
    - 데이터 정본(dataset_v22): 원시 엔코더 열에서 α·β·속도·Â·예측점·평활을 앱이 다시 계산,
    펌웨어 계산열은 _fw 로 나란히 (Δ 대조). ±180 언랩·감김수 스냅, 파이프라인 파라미터 노출
    - 분석 도구 9종(analysis_v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
    [sweep_grid_20260718.csv]
2026-09-02 v22_logger: 실물 브링업 준비 — Windows 콘솔 UTF-8, 헤더 누락 안내, phi_off, v22_raw 2단 영점·hdr, 브링업 절차서
    - server: cp949 콘솔에서 죽지 않게 stdout UTF-8 고정, 헤더 없이 오는 D행 감지·안내(hdr / m 두 번), 연결마다 헤더 상태 초기화
    - dataset/app: 파이프라인 phi_off·ank_off (매달림 영점 → 직립 +180 변환을 앱에서)
    - firmware/v22_raw: 2단 매달림 영점(원형 평균, 문서 66), hdr 명령 + 20 s 헤더 재출력, 호스트 스텁 문법검사 통과
    - docs/v22_실물_브링업_절차_20260902.md: 가짜→hangcal_fold 연결→부호·트윈→v22_raw→영점·자유흔들기·P2R·놓기 시행
    - test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
2026-09-02 v22_raw: 엔코더 진단(e)·CS 교환(swap)·고착 등급, 앱 고착 표시, 발목각 불변 판별 절차
    - firmware/v22_raw: AS5047P 레지스터 읽기(ERRFL·DIAAGC·ANGLEUNC·ANGLECOM) 판독 명령 e,
    런타임 CS 핀 교환 swap(재업로드 없이 채널 vs 코드 판별), err 등급 2 = 2 s 값 불변 고착
    - commands.json v22_raw 프로파일에 e/swap/hdr 버튼
    - 앱 원본값 표: 2 s 동안 값이 안 변한 엔코더 열을 빨강 ⚠고착 표시
    - docs 브링업 절차 §5-1: 발목각 불변 시 기구 → swap → e 순서와 판독표
    - 호스트 문법검사·tests_v22·e2e_v22 통과
    Claude-Session: https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
    [v22_raw.ino]
2026-09-02 docs: v22 측정 조작 가이드 — 무엇을 누르고 로봇을 어떻게 잡았다 놓고 앱이 무엇을 계산해 보여주는지 (영점·자유흔들기·P2R·놓기 시행·잡음·재분석)
    Claude-Session: https://claude.ai/code/session_01R1tYTbHm1MpVPBUC4nDtYR
2026-09-02 v22: 정지→이탈 놓기 감지(놓기점 = 손 뗀 순간), 목표점 십자선, λ·r 조작 가이드 개정
    - analysis find_trials: 절대 |ψ| 문턱 대신 '정지(0.5 s, 0.35°) → 정지평균에서 1° 이탈' 로 놓기를 찾는다.
    φ=±3° 에서 놓는 r 실험도 잡힌다. 놓기점 = 정지에서 벗어나기 시작한 표본. 옮겨 잡고 다시 정지하면 놓기가 아님.
    dir_valid(방향 확실 → 놓기 경계용) / valid(λ 적합까지 → λ 평균용) 분리. 0822 데이터: 18 유효, λ+5.31/λ−5.57 (문서 70: 5.33/5.54, 9/9 일치)
    - 앱: 놓기 목표점 (β, φ) 십자선 + 3D 판독에 목표까지 Δβ Δφ 와 '● 놓아도 됨'
    - 가이드(d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
2026-09-02 v22: 다음 놓기 추천 (r 적응 탐색) — 발산 초기진폭으로 선까지 거리를 재고 β열별 영점을 할선으로 좁힌다
    - analysis: 시행 나누기 개선 — 놓기 자세 = 정지 구간 중앙값, 종료 = 잡기 문턱/다시 정지/시간상한, 방향 = 최대 이탈 부호
    - analysis: φ−φ_q = A'(cosh λτ−1)+B'(cos ωτ−1) 적합으로 놓기 순간(진동 위상)과 부호 있는 초기진폭 s 추정 (파이프라인 om 추가)
    - analysis: recommend 도구 — 열별 영점(할선, 걸음 ≤1°) → (β,φ_c) 회귀 r̂·ĉ₀·SE → 다음 점 = 관측 적은 열의 영점 ±0.5°
    - sim_recommend.py: 선형 2모드 합성 세계 폐루프 — 8회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
2026-09-02 v22: 다음 놓기 추천(r 적응 탐색) — 놓기 순간 위상 적합, 열별 영점 할선, 벗어남 자동 축소, 폐루프 검증
    - analysis: 시행 나누기 = 정지→이탈, 놓기 자세 = 정지 구간 중앙값, 종료 = 잡기문턱/재정지/시간상한, 방향 = 최대 이탈 부호
    - analysis: φ−φ_q = A'(cosh λτ−1)+B'(cos ωτ−1) 적합으로 놓기 순간 t_r(진동 위상)과 부호 있는 거리 s=A'
    - analysis.recommend: β 열별 영점(할선·클립), (β,영점) 회귀 → r̂·ĉ₀·SE, 다음 점 = 관측 적은 열의 영점 ± 벗어남
    (0.5° → 2·√((SE_r·β)²+SE_c0²), 최소 0.15° 로 자동 축소), 무발산 시행 = s 0
    - sim_recomm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
2026-09-02 v22: γ 접기 실험 — 펌웨어 v2(단일접기/증분접기, γ 하나 ρ 없음, w=r·λ 닫힌형), 앱 「접기 성적표」, 폐루프 검증
    - firmware/v22_raw v2: mode 0/1/2, g/h/x/y, fold X, 파라미터 표(gam trig rel vrel dead dstep dlim rest alim sgn fdeg lock r lam c0 kv wmode wf wb p2r …),
    접기 시 E행 FOLD·관측창 뒤 F행 요약·FOLDPOST, 넘어짐 FALL, 부호 확인용 dry-run. 호스트 문법검사 통과 (미컴파일)
    - analysis.fold_report: E행 FOLD(또는 hold 계단)마다 A⁻(직전 창을 e^{λ(t_f−t)} 로 접는 순간에 투영), Δδ_act, A⁺(관측창 뒤) →
    G=e^{λ·lock}, g, γ=G/g, ratio 판정, γ*(|A⁻| 가중), 회귀 교차검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
2026-09-02 e2e: 기본 프로파일 v22_raw 의 버튼 라벨(p 1회)에 맞춤
    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
2026-09-03 v22: MuJoCo 가상 로봇 + 리허설 영상 감독 스크립트, 추천 도구 부호 정정·ω 공통 적합, 손 이동 필터
    - mujoco_source.py: v21 SimEngine(물리 무수정) 위에 v22_raw v2 펌웨어 로직(D/F/E 행, Â, mode 0/1/2,
    파라미터 표, 명령 문법)을 파이썬으로 얹은 가상 로봇. 사람 동작은 sim release/hold/catch/free 지시.
    서버 --mujoco / WS mujoco·robot 명령 / 헤더 「가짜: MuJoCo」 버튼.
    - video_v22.py: Playwright 가 앱을 실제 마우스로 조작하며 녹화 (커서·클릭 파문·자막·사람 동작 카드),
    시나리오 = 연결·영점 → λ 3회 → r 추천 루프 6회 → γ 단일접기 3회·성적표·gam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
    [analysis_v22.py, e2e_v22.py, mujoco_source.py, server.py, sim_recommend.py, tests_v22.py, video_v22.py]
2026-09-03 v22 영상: 접기 성적표 자막의 g 키(g_mean)·시행 수·γ 중앙값 표시
    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
2026-09-03 v22: 라이브 버퍼 위 분석의 행 수 고정(_Snapshot) — 도구 실행 중 append 로 배열 길이가 어긋나던 IndexError 수정
    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
    [analysis_v22.py, video_v22.py]
2026-09-03 v22 영상: 공유용 _small.mp4(crf 29) 함께 생성, README 에 4차 녹화 결과
    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
2026-09-03 v22 발표 무대 3창: /deck 조종석(큐·질의응답·갤러리) · /show 무대(장면 방송, 실사 오버랩·트윈+평면·ε* 기하·HUD) · /lab 측정실(엑셀식 표·차트·추세선)
    - 서버: 장면 상태 set_scene/scene 방송, hello 에 포함, 라우트 /deck /show /lab, /pmedia/(실사 영상), /repo/(옛 버전 갤러리)
    - lg_plane: LG.PLOPT.epsGeom(무게중심 불변 직선 ∩ 안정모드선 = 접으면 가는 곳) · lg_3d: LG.cam.set/get, 좌우 반전
    - /lab: 가상 스크롤 원본 표, 시간/XY 차트(격자·눈금), 드래그 구간, 추세선 선형·지수(λ)·감쇠사인(osc)·놓기점(boundary)·추천, TSV 복사
    - e2e: /lab /show /deck 절, te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
2026-09-03 v22 무대: 실사 광대 추적(tools/track_jultagi.py → jultagi_trace.json)으로 오버랩 모델 동기 — 휘청 구간 반복, 발 정렬, 기둥 표류 보정, 힙 접기 재현; 세로 무대 리허설 녹화 스크립트
    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
2026-09-03 v22 무대 녹화: 무대·조종석을 별도 컨텍스트로 (녹화 프레임 크기 정확)
    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
2026-09-03 v22 무대: 변신 장면의 베일이 모델 캔버스를 가리던 층 순서 수정, 세로 화면 트윈 카메라 거리 조정
    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
2026-09-03 e2e_shots: 무대 변신·큐3 장면 갱신
    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
2026-09-03 e2e_shots: 최종 E2E 스크린샷 갱신
    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
2026-09-03 v22: /lab as logger superset + Excel charts, /pres band video composition, recommend catch-pose fix, lab rehearsal video
    - lab.html/lg_lab.js: every logger id kept (lg_panels.js runs unchanged); Excel time chart shares
    LG.chart.win/view, LG.sel, LG.setCursor; left-drag = selection = analysis window; tool overlays and
    phase bands drawn on the Excel chart; XY recommend -> target crosshair; staggered event labels
    - lg_show.js/show.html: video scene back to the /pres composition (y 607-1407 band letterboxed);
    only the synced sway loop and thicker lines remain changed; cues select views only
    - analysis_v22.recommend: a no-divergence trial counts as an on-line point only for small-angle
    re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
    [analysis_v22.py, e2e_v22.py, tests_v22.py, video_lab_v22.py]
2026-09-04 cad: 8/23 축 파트 칼집·깊이 수정 STL 회수 — ankle_socket v5.5, pivot_front v5.5, pivot_rear v5.6
    피벗축·발목 소켓축 칼집(슬릿)+깊이 수정 리비전(2026-08-23 로컬 작업, 미푸시분). .scad 소스는 미회수 — STL만 exports/ 에 보관. 상세는 cad/CHANGELOG.md v5.14(가) 항목.
    Claude-Session: https://claude.ai/code/session_01RuNwZjY3KmLgB8gMKyZsFc
    [axle_ankle_socket_v5.5_front.stl, axle_ankle_socket_v5.5_rear.stl, axle_pivot_front_v5.5.stl, axle_pivot_rear_v5.6.stl]
2026-09-04 cad: CHANGELOG v5.14(가) — 8/23 축 파트 칼집·깊이 수정 STL 회수 기록 (SCAD 소스 미회수)
    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
2026-09-05 v22_raw v3: fphi/fank upright conversion, g guarantees torque, FALLA + stat counters; app release cue (beep)
    Real-robot first connection findings (2026-09-05):
    - firmware alpha was 180 deg off (app ank_off only affects the app) -> fphi/fank params (+180, wrap)
    - v2 enabled torque only after a fall, so incremental-fold goals went to a torque-off motor -> g now
    restores home/torque like hangcal torqueRestoreHere (refuses only if the position read returns 0)
    - E,FALL now followed by E,FALLA (alpha); '# stat' line every 5 s and in 't': loop_max, dxl_max,
    dxl_fail, wr_fail. No safety devices added (user policy: verify basic behavior first)
    - app: release cue in lg_panels (logger + lab): targe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
2026-09-05 Clear stale analysis and isolate request errors in v23 UI
    [e2e.py, server.py]
2026-09-05 Reuse running v23 server and avoid launcher port conflicts
    [launch.py, server.py, test_launch.py]
